HoneyKung/metorobot/migrations/README

Single-database configuration for Flask.
