HoneyKung/metorobot/HANDOFF-ทำ-METO-ต่อ-2026-11-01.md

# Handoff — แชตช่วยทำ METO ต่อ (ขึ้นโมเดล + แก้โค้ด)

เขียนเมื่อ 1 พ.ย. 2569 จากแชตที่ดูแล METO/RoboBlock (แชตเดิมทำเอกสาร IRB และตรวจข้อความพอร์ตให้)

## คำสั่งเจ้าของ (คำต่อคำ)
> อยากให้เปิดแชต ที่จะช่วยฉันทำ meto ต่อหน่อย ทั้งช่วยขึ้นโฒเดล หรือช่วยแก้โค้ด เขียน handoff ใฟ้ที อย่าลืมให้อ่านเอกสรหลักการทำงาน

## ขั้นแรก: อ่านก่อนตอบเจ้าของครั้งแรก
1. **เอกสารหลักการทำงาน:** `L:\ModSTD\หลักการทำงานทีม-และการเรียกใช้Codex.md` (486 บรรทัด, md5 `be96b19f…` วันที่ 1 พ.ย.)
   - อ่านอย่างน้อยหมวด **ลำดับขั้นทำงาน (โดยเฉพาะขั้น 0)**, **คุยกับเจ้าของ**, **งานที่เสียเงิน**, **งานออกแบบ**
   - สรุปสั้น:
     - ขั้น 0: แตกข้อความเจ้าของเป็นข้อ ๆ หาหลักฐานเองก่อนถาม งานออกแบบ/ตีความได้หลายทางให้สรุปความเข้าใจกลับก่อนลงมือ
     - ใบสั่งงานคัดคำเจ้าของคำต่อคำไว้ต้นใบ
     - งานเสียเงินต้องรอเจ้าของพิมพ์ "ยิง"
     - งานออกแบบเจ้าของตัดสิน: เสนอ 2–3 ทางพร้อมทางที่แนะนำ
     - ตอบคำถามเจ้าของก่อนเสมอ แล้วค่อยให้เหตุผลหรือรายละเอียด
   - ไฟล์นั้นเขียนมาจากโปรเจกต์ ModSTD ส่วนที่พูดถึงเกม/ZIP/NPC ให้อ่านเทียบเคียง ("ลงงาน" ที่นี่ = แฟลชบอร์ดหรือพิมพ์ 3D)
   - เรื่องใครเป็นผู้เขียนโค้ด (Claude เขียนเอง หรือส่ง Codex/Gemini) **ถามเจ้าของก่อน** ว่าโปรเจกต์ METO ใช้แบบไหน อย่าเดา
2. ความจำของโปรเจกต์ (โหลดอัตโนมัติถ้าเปิดแชตในโฟลเดอร์นี้): `C:\Users\Acer\.claude\projects\G--My-Drive-METTO-Code-RoboBlock\memory\MEMORY.md` โดยเฉพาะ
   - `meto-hardware-two-units.md` — **หุ่นมี 2 ตัว ห้ามเล่ารวมกัน**
   - `meto-esp32-pin-budget.md` — ผัง GPIO ที่ตกลงแล้ว และวิธีคอมไพล์ด้วย arduino-cli
3. ฝั่งเว็บ: `claude-RoboWeb.md` ในโฟลเดอร์นี้ ต้องอ่านก่อนแตะโค้ดเว็บ และ `THEME.md`

## วิธีคุยกับเจ้าของ
- เรียกเจ้าของว่า **"คุณ"** (ห้ามเรียก "ฟาม") Claude ใช้ **ผม/ครับ**
- ตอบภาษาไทยเท่านั้น
- ห้ามส่งไฟล์เข้าแชตถ้าไม่ได้ขอ ให้บอกที่อยู่หรือลิงก์แทน
- ตอบทุกคำถามที่เจ้าของถาม และตอบคำถามก่อน อย่าเสนอเปลี่ยนสิ่งที่เจ้าของไม่ได้ขอ
- **ไฟล์ล่าสุดอยู่ใน Google Drive (`G:\My Drive\METTO\`) เท่านั้น** ไฟล์สำเนาในเครื่องที่อื่นอาจเก่า ห้ามใช้เป็นต้นฉบับ
- ห้ามแตะเอกสาร IRB (แชตอื่นดูแลอยู่ และกำลังรออาจารย์)

## หุ่น 2 ตัว (สำคัญที่สุด)
| ตัว | สถานะ |
|---|---|
| โปรโตไทป์ 1 | ทำงานครบ จ่ายไฟผ่าน USB · กล้องจับหน้า (ESP-DL) + หันหัวตาม · จอแสดงอารมณ์ · แขน 2 มือ 2 ล้อ 2 · เซนเซอร์กันตก · สั่งจากเว็บได้ มีคลิปสาธิต |
| ตัวสำเร็จ | กำลังประกอบ · เพิ่มแบตในตัว (18650×2, BMS 2S, ชาร์จ CM620 USB-C), PCA9685, คอก้มเงย, วัดระยะของที่ยก · โครงใน PETG พิมพ์แล้ว · **โครงนอกยังไม่เริ่ม** · 31 ต.ค. เจ้าของบอกว่าต่อฟิวส์และกราวด์ร่วม (ราง WAGO) แล้ว · **ยังไม่รู้ว่าวิ่งด้วยแบตได้ครบระบบหรือยัง** ถามเจ้าของ ห้ามเขียนว่า "ยังเสีย" |

## ที่อยู่ไฟล์ (ใต้ `G:\My Drive\METTO\Code\RoboBlock\`)
**เฟิร์มแวร์**
- `Robo/Robo.ino` — หุ่น: หน้า 9 อารมณ์ (H S A O Z C V B N บรรทัด ~300), รับค่าจากกล้องทาง Serial2 (ตำแหน่ง L/C/R + อารมณ์ H/S/N บรรทัด ~1107)
- `RoboPCA9685/RoboPCA9685.ino` — รุ่นใช้ PCA9685 (ตัวสำเร็จ)
- `FullCam/FullCam.ino` — กล้อง XIAO ESP32S3: แยก ยิ้ม/เศร้า/ปกติ จากจุดบนใบหน้า แล้วส่งตำแหน่งหน้า L/C/R
- โฟลเดอร์ทดสอบ: `CamTest`, `FaceTest307`, `MotorTest_TB6612`, `EncoderMotorTest_TT`, `eye`
- **ยังไม่มีโค้ด VL53L0X**

**เอกสารฮาร์ดแวร์** — `Robo/Part Robot/`
- `ผังจัดชั้นตัวเต็ม_RoboMDT.md` — ผัง 5 ชั้น (ชั้น 4 มี PCA9685 + VL53L0X ระดับแขน)
- `ปัญหาฮาร์ดแวร์_RoboMDT.md` — ข้อ 6.4: ย้าย VL53L0X จากใต้ท้องขึ้นชั้น 4
- `คู่มือต่อสาย_ล้อ_จอ_กล้อง_WAGO221_XT30_RoboMDT.md` (7 ก.ย.) — BMS→ฟิวส์→XT30→สวิตช์→WAGO
- `ตารางการเชื่อมต่อและบัดกรี_RoboMDT.md` ข้อ 0 หัวข้อ 16 = ผังขาที่ตกลงแล้ว ("สเปกวันศุกร์")
- `รายชื่ออุปกรณ์หุ่นยนต์_RoboMDT.md`, `สถานะการสั่งซื้ออุปกรณ์_RoboMDT.md`, `แผนปรับโครงจาก_STL_จริง_RoboMDT.md`

**โมเดล 3D**
- `stl3dprint/` — STL ชุดที่พิมพ์ (ชั้น 1–5, ชั้นคอ, ก้านยึดเซอร์โว, ล้อ, สายพาน, แขนโปรโตไทป์) + `ภาพสำหรับสไลด์/`
- `stl redesigned/` — `RoboMDT_layer_lock_v1.zip`, `v1_long_lock`, `analysis`
- เจ้าของขึ้นโมเดลใน **Tinkercad** (กำลังเรียน SolidWorks) · หลักการแบบ: เล็กที่สุด ไม่ใช้ heat-set insert, ตัว 5 ชั้นซ้อนแบบปิ่นโต, ตัวทรงคางหมูให้แขนหุบหนีบได้, แขนเว้ารีพร้อมปุ่มทรงเพชรกันลื่น
- แผนล้อ: ตีนตะขาบเลี้ยวไม่ดี → รุ่นต่อไปเป็น **ล้อ 2 ข้าง + ลูกล้ออิสระ (ยังไม่ขึ้น CAD)**

**เว็บ METO Robot** — `server.py`, `dashboard.py`, `skills.py`, `models.py`, `static/` (เปิดเดโมด้วย `devserver.py` แล้วเข้า `static/index.html?demo=1`) · เว็บบน Render สั่งหุ่นไม่ได้ ต้องรันเซิร์ฟเวอร์ในเครื่องบนฮอตสปอตเดียวกับหุ่น

## งานค้างที่รู้ตอนนี้ (ยังไม่มีใครสั่ง ให้ถามเจ้าของว่าจะเริ่มอะไร)
- ทดสอบตัวสำเร็จด้วยแบตครบระบบ
- โค้ดอ่าน VL53L0X (เช็กว่าจับของได้จริง) ที่ชั้น 4
- ขึ้น CAD ล้อ 2 ข้าง + ลูกล้อ
- ออกแบบโครงนอก (รอระบบไฟนิ่ง)
- วัดแบตบนจอ: ADC ของ ESP32 ไม่เหลือขา ถ้าจะทำต้องใช้ ADS1115 บน I2C

## สิ่งที่ห้ามทำ
- ห้ามแก้ไฟล์ในโฟลเดอร์สมัครงาน/พอร์ต (`C:\Users\Acer\Downloads\ประวัติผลงาน-สมัครงาน-ฝึกงานญี่ปุ่น-2026-10-19\`) — มีแชตอื่นดูแล
- ห้ามเปลี่ยนผังขาย้อนกลับไปแบบเก่า (เจ้าของตัดสินแล้วว่าโค้ดต้องตามเอกสาร)
- ก่อนแก้เฟิร์มแวร์หรือไฟล์สำคัญ ให้สำรองไฟล์เดิมไว้ข้าง ๆ ก่อน (เช่น `.bak-YYYYMMDD`)
