HoneyKung/metorobot/ข้อมูลส่งแชทเอกสาร_บท4_2026-11-06.md

# ข้อมูลสำหรับแชทเอกสาร — เติมบทที่ 4 (ร่างดีไซน์ 8-8)

> **ถึงแชทเอกสาร:** ไฟล์บทที่ 4 คือ `G:\My Drive\METTO\Research Documents\รายงานวิจัย\ร่างบทที่ 4-5 ดีไซน์ 8-8 (รอเติมผลจริง).docx`
> ข้อมูลข้างล่างมาจากไฟล์งานหุ่นจริง ณ 6 พ.ย. 2569 · ใช้ได้เฉพาะหัวข้อ 4.2 (ผลการพัฒนาหุ่นยนต์ต้นแบบ)
> หัวข้อ 4.3–4.10 ยังไม่มีข้อมูล เพราะยังไม่ได้เก็บข้อมูลกับผู้เข้าร่วม **ห้ามเติมตัวเลขเอง**
> ช่องที่เขียน **[รอของจริง]** ให้คงวงเล็บไว้ · **ห้ามแตะเอกสาร IRB**

---

## 1. สิ่งที่ในร่างเดิมไม่ตรงกับของจริงแล้ว ต้องแก้

| ร่างเดิมเขียน | ของจริงตอนนี้ |
|---|---|
| โครงสร้างแบบโมดูลาร์ **5 ชั้น** · ชั้น 4 = คอและแขน · ชั้น 5 = หัว | **ตัว 4 ชั้น + แผ่นคอ + หัว** · แขนยึดที่ชั้น 4 · คอเป็นแผ่นแยกที่รับหัว · หัวเป็นชุดแยก (หันซ้ายขวา + พยักหน้า) |
| "แต่ละชั้นยึดกันด้วย [วิธียึดชั้นแบบสุดท้าย]" | ชั้นยึดกันด้วย **คลิปล็อกแบบหัวเข็มขัดกระเป๋า** เป็นชิ้นแยก ถอดเปลี่ยนได้ ร่วมกับเสาแท่งเกลียวด้านนอกตัว |
| ล้อ "พร้อม Encoder" | ถูกต้อง · เพิ่ม: **ล้อออกแบบใหม่ ยึดเพลาด้วยสกรูกันหลุดตอนเลี้ยว ยาง TPU** |
| ไม่มีระบบกันชนกลไก | **เพิ่ม:** ระบบล็อกท่าทาง (interlock) สร้างจากผลจำลอง 3 มิติ ฝังในโปรแกรมหุ่น ไม่ให้แขนชนหัว |
| บล็อก 9 หมวด | ยังเป็น 9 หมวดเท่าเดิม (Motion, Arm, Hand, Head, Face, Gripper, Control, Operator, Variables) · **เพิ่มบล็อกใหม่ 20 ตัว** (บล็อกคำสั่งใหม่ 15 + บล็อกพื้นฐานที่ขาด 5) รวมบล็อกเซนเซอร์ |
| หุ่นยนต์จำลองบนหน้าจอ | มี 2 แบบ: ซิม 2 มิติในหน้าเว็บบล็อก และ **Digital Twin 3 มิติ** สร้างจากไฟล์ชิ้นส่วนจริง |

ขนาดกรอบนอก ความสูง น้ำหนัก → **[รอของจริง]** (ชั่ง/วัดหลังประกอบเสร็จ)

---

## 2. ข้อมูลเติมหัวข้อ 4.2.1 โครงสร้างและฮาร์ดแวร์

**กระบวนการออกแบบ (เขียนเป็นย่อหน้าได้)**
- ออกแบบชิ้นส่วนทั้งหมดด้วย OpenSCAD แบบพารามิเตอร์ แล้วพิมพ์ด้วยเครื่องพิมพ์ 3 มิติ วัสดุ PETG (ยางล้อ TPU)
- ก่อนพิมพ์ ตรวจแบบด้วยการจำลอง 3 มิติที่ใช้เมชของชิ้นจริง ตรวจ 3 เรื่อง
  1. ประกอบได้: ชิ้นใส่เข้าตามลำดับประกอบได้จริง
  2. ขยับได้: ทุกข้อต่อขยับครบช่วงโดยไม่ชนชิ้นอื่น
  3. แขนกับหัว: ตรวจไขว้ทุกคู่ท่า (หัน 91 × พยัก 11 × ยก 47 × หนีบ 30 ท่า ≈ 1.41 ล้านท่าต่อข้าง)
- จุดที่ชนได้ ถูกแปลงเป็น **ตาราง interlock** ฝังในเฟิร์มแวร์ หุ่นจะไม่ขยับเข้าท่าที่ชน
- การจำลองพบจุดที่ประกอบไม่ได้ในแบบก่อนพิมพ์ (เช่น ช่องเซอร์โว MG996R, การสอดแขนเข้าตัว U, สกรูชนหัวพินจอ) และแก้จนผ่านก่อนพิมพ์จริง ลดการพิมพ์ทิ้ง

**แผนผังอุปกรณ์ (ใช้แทนตารางเดิม — ตำแหน่งชั้นของบอร์ดไฟให้เช็กกับของจริงอีกรอบ)**
| ส่วน | อุปกรณ์หลัก | หน้าที่ |
|---|---|---|
| ชั้น 1 ฐานขับเคลื่อน | TT Motor + Encoder × 2 พร้อมล้อยาง, ลูกล้อ × 1, รางถ่าน 18650 × 2, เซนเซอร์กันตก TCRT × 2 (ซ้าย/ขวา), ฝาแบตแบบคลิก | เคลื่อนที่ จ่ายพลังงาน กันตก |
| ชั้น 2 ไฟและขับมอเตอร์ | BMS 2S, ฟิวส์, ขั้ว XT30, สวิตช์, WAGO, TB6612FNG, CM620 (ชาร์จ), LM2596, UBEC | ป้องกันแบต ตัดไฟ ขับมอเตอร์ ชาร์จ แปลงแรงดัน |
| ชั้น 3 สมอง | ESP32 DevKit 38 Pin, PCA9685 | ประมวลผล Wi-Fi สั่งเซอร์โวผ่าน I2C |
| ชั้น 4 ไหล่ | MG996R × 2 (ยกแขน) | ยกแขน |
| แขน | MG90S × 2 (หนีบ) + VL53L0X 1 ตัว (ตรวจว่าหยิบของได้ ตำแหน่งดูหมายเหตุ) | หนีบ |
| คอ + หัว | SG90 × 2 (หันซ้ายขวา / พยักหน้า), จอ TFT 2.8" (MSP2806), XIAO ESP32S3 Sense + OV2640 | แสดงอารมณ์ ตรวจจับใบหน้า |

> ตำแหน่ง VL53L0X: [รอของจริง — ยืนยันกับเจ้าของ] · หมายเหตุ MPR121 ยังไม่มีในโค้ด (ตามร่างเดิม)

**ระบบไฟ:** 18650 × 2 อนุกรม (2S) → BMS 2S → ฟิวส์ → สวิตช์ → แยก 3 ราง: LM2596 5V (วงจร), UBEC (เซอร์โว), TB6612 VM (มอเตอร์) · ตรงกับร่างเดิม ยกเว้นพิกัด UBEC ให้ยืนยันกับของจริง **[รอของจริง]**

---

## 3. ข้อมูลเติมหัวข้อ 4.2.2 เว็บแอปพลิเคชัน

- บล็อกใหม่ 20 ตัว เช่น เดิน/เลี้ยวตามเวลา (ms), หยุด, ยกแขนตามองศา, หันหัว/พยักหน้าตามองศา, หนีบแบบตรวจว่าจับได้, บล็อกเซนเซอร์ (เจอขอบ, ระยะ VL53, ถือของอยู่ไหม)
- บล็อกเซนเซอร์ใช้ในเงื่อนไข if ได้จริง: เบราว์เซอร์ส่งคำสั่งที่ค้างให้หุ่นทำเสร็จก่อน แล้วอ่านค่าเซนเซอร์จาก `/state` มาตัดสิน
- ปุ่มหยุดหยุดหุ่นจริงได้ทันที แม้หุ่นกำลังทำคำสั่งชุดยาว
- **Digital Twin 3 มิติ:** หุ่น 42 ชิ้นจากไฟล์ออกแบบจริง ขยับตามข้อต่อจริงและใช้ตารางกันชนเดียวกับเฟิร์มแวร์ ควบคุมด้วยคีย์บอร์ด หรือให้ขยับตามหุ่นจริงได้ (อ่าน `/state`)
- ผลทดสอบ: ผ่านในโหมดเดโมและหุ่นจำลอง · **ทดสอบกับหุ่นจริง [รอของจริง]**

---

## 4. ข้อมูลเติมหัวข้อ 4.2.3 ระบบแสดงอารมณ์

- อารมณ์ 9 แบบตรงกับร่างเดิม · ดวงตาวาดบนจอพื้นขาว ตาดำ (ตกใจมีวงแดง เศร้ามีน้ำตา รักเป็นหัวใจเต้น เขินมีแก้มชมพู)
- กล้องส่งสัญญาณมาที่ ESP32 ทาง UART · โปรโตคอลมีตำแหน่งหน้า (ซ้าย/กลาง/ขวา) และรหัสอารมณ์ · หัวหันตามหน้าผ่านระบบขยับนุ่ม · กล้องหลุดเกิน 5 วินาทีหุ่นรู้และรายงาน
- **ความแม่นการจำแนกอารมณ์ [รอของจริง]** (ร่างเดิมแนะนำทดสอบ 20 ครั้งต่ออารมณ์)
- ⚠️ **โหมดไม่แสดงอารมณ์ (กลุ่มควบคุม) ยังไม่มีในโค้ด** ทั้งเฟิร์มแวร์และเว็บ — ต้องทำก่อนเริ่มเก็บข้อมูล ช่อง [วิธีปิด] ในร่างยังเติมไม่ได้

---

## 5. ตารางผลทดสอบระบบ (ตารางที่ [ ] 13 รายการ) — สถานะตอนนี้

| ที่ | รายการ | สถานะความพร้อม | ผล |
|---|---|---|---|
| 1 | Wi-Fi + เปิดเว็บ | มีระบบแล้ว | [รอของจริง] |
| 2 | Motion | มีบล็อก + เฟิร์มแวร์ | [รอของจริง] |
| 3 | Arm | มีบล็อก + เฟิร์มแวร์ | [รอของจริง] |
| 4 | Hand / Gripper | มีบล็อก + เฟิร์มแวร์ (แขนกำลังปรับรอบ 2) | [รอของจริง] |
| 5 | Head | มีบล็อก + เฟิร์มแวร์ หัน + พยัก | [รอของจริง] |
| 6 | Face 9 อารมณ์ | มีบล็อก + ตาครบ 9 | [รอของจริง] |
| 7 | Control | มีบล็อก | [รอของจริง] |
| 8 | Operator / Variables | มีบล็อก แก้บั๊กตัวแปรแล้ว | [รอของจริง] |
| 9 | กล้อง → อารมณ์ | มีโปรโตคอล | [รอของจริง] |
| 10 | สลับโหมดอารมณ์ | **ยังไม่มี** | — |
| 11 | กันตก / วัดระยะ | มีในเฟิร์มแวร์ | [รอของจริง] |
| 12 | AI ไม่เฉลย | มีระบบเดิม | [รอของจริง] |
| 13 | แบตใช้งานต่อเนื่อง | ยังไม่ได้วัด | [รอของจริง] |

> ตอนนี้ยังเขียนว่า "ผ่าน [ ] จาก 13 รายการ" ไม่ได้ เพราะยังไม่ได้ทดสอบกับหุ่นตัวสำเร็จ

---

## 6. ภาพที่ใช้ได้ในบท 4
- ภาพทวิน 3D: `G:\My Drive\METTO\Code\RoboBlock\Robo\Part Robot\งานโค้ด_2026-11\ภาพ_ทวิน3D\` (01 ท่าปกติ, 04 มองข้างใน, 05 ซ่อนเปลือกมุมบน)
- ภาพบล็อกใหม่: `...\งานโค้ด_2026-11\ภาพ_เว็บบล็อก\`
- ภาพหุ่นจริงประกอบเสร็จ: [รอของจริง]
