HoneyKung/metorobot/สถานะงาน_METO_ตัวสำเร็จ.md

# สถานะงาน METO ตัวสำเร็จ (แชตทำ METO ต่อ)

ต่อท้ายเท่านั้น 1 บรรทัดต่อเหตุการณ์ · โจทย์รวม: `Robo/Part Robot/โจทย์ออกแบบโครงใน_v2_2026-11-02.md` · ใบสั่งงาน: `ใบสั่งงาน/`

ตอนนี้พิมพ์อะไรอยู่: ชิ้นทดสอบชุดเบา `stl redesigned/กรอบทดสอบ_ชุดเบา_2026-11-02/` (ข้าม vl53l0x_holder) — ยังไม่มีผลลองใส่

- 2026-11-01 — อ่าน handoff + หลักการ (บางหมวด) · เจ้าของตัดสิน: Luna งานง่าย Gemini งานยาก; ชั้นตาม STL เดิม; ล้อ 2 ข้าง + ลูกล้ออิสระ; ล้อ Ø41 พิมพ์เอง
- 2026-11-01 — ใบ 01 Luna ค้นขนาดอุปกรณ์/ลูกล้อ → `Robo/Part Robot/ผลค้นขนาดอุปกรณ์และลูกล้อ_Luna_2026-11-01.md` (หัวงานตรวจ: ล้อ Olimex Ø43 ไม่ยืนยันเพลา TT)
- 2026-11-02 — ใบ 02/04/05 ชิ้นทดสอบชุด v1–v3 ส่งเจ้าของ → **เจ้าของทักทั้งชุด: มีชิ้นลอย ป้ายตัวเลข ผนังหนา เปลืองเวลา** → เลิกใช้ v1–v3
- 2026-11-02 — ใบ 06/07 Gemini ทำรางกดสาย + ชุดเบา, หัวงานตรวจด้วย `tools/check_printable.py` → ส่ง `กรอบทดสอบ_ชุดเบา_2026-11-02` (ยังไม่ได้พิมพ์)
- 2026-11-02 — ทำ `tools/meto-api-writer` ตามคำเจ้าของ ("อันนี้คุณเขียนเองก่อนได้เลย") · hook self-test PASS · ยังไม่เคยเรียก API (รอบ "ยิง" ครั้งแรกไม่เรียกจริงเพราะ key ไม่อยู่ใน env ของ process — ไม่เสียเครดิต)
- 2026-11-02 — เจ้าของตัดสินชั้น 1: ล้อขับหลัง; ลูกล้อ 2 ลูกหน้าซ้าย-ขวา; VL53L0X ชั้น 1 ตั้งแนบผนังหน้ามองผ่านรูกลาง; ชั้น 1 มี รางถ่าน BMS ฟิวส์+สายหนา XT30 VL53 TT×2 IR×2 (ห้ามย้ายชั้น); LM2596 ไม่อยู่ชั้น 1; สวิตช์ WAGO TB6612 CM620 ชั้น 2
- 2026-11-02 — หัวงานผิดหลักการ: บันทึกคำแนะนำเป็นคำตัดสิน (ล้อขับหน้า), เติมข้อห้ามจากคำถามเจ้าของ (BMS ทับถ่าน), ย้าย BMS ไปมา → แก้ไฟล์โจทย์แล้ว (สำรอง `.bak-20261102`) และทำเครื่องหมายใบ Opus-01 ว่าห้ามใช้
- 2026-11-02 — อ่านหลักการทำงานครบ 486 บรรทัด (md5 be96b19f…) ตามคำเจ้าของผ่านแชตไฟล์และอัปเดตอื่น ๆ
