HoneyKung/metorobot/ใบสั่งงาน/brief_opus02_exterior_arms.md

# ใบ Opus-02 — ภายนอก + คำนวณแขน + ความสูงแต่ละชั้น (ยังไม่ทำภายใน)

คำเจ้าของ (คำต่อคำ, #151 ใน `ref/บันทึกการคุย_METO.md`): "ก่อนออกแบบภายใน ควรออกแบบภายนอกก่อน เพราะคางหมูทำเผื่อแน ให้ทำคิดคำนวนแขนให้เรียบร้อยก่อนเริ่มดีเลภายใน ก่อนทำดีเทลภายใน กำหนดความสูงแต่ละชั้นก่อน"

**อ่าน `ref/บันทึกการคุย_METO.md` ทั้งไฟล์ก่อน** โดยเฉพาะตาราง "คำตัดสินที่ล็อกแล้ว" และข้อ 17, 26, 30, 33, 35, 38, 52, 106, 124, 130–151 · ห้ามขัดคำตัดสินที่ล็อก · ข้อที่ต้องเดาให้เขียนเป็น "สมมติฐาน" ในรายงาน

## อ้างอิงใน `ref/`
- `layer4.stl` — ชั้นเซอร์โวเดิม: MG996R วางนอน แกนออกข้าง อยู่หน้าสุด ทะลุผนัง (ช่องซ้ายภายใน X −44..−4, Y 14.6..55, พื้น Z −78; รูแกนตัว U ที่ผนังข้าง ศูนย์ Y≈44.3 Z≈−68) · ช่องนี้ใส่ได้พอดี ห้ามเปลี่ยน
- `layer2.stl`, `layer3.stl`, `neck.stl` — รูปทรง/ความสูงเดิม (ชั้น 2 ตัวจบที่ผนังหลัง ~113 ส่วนเลยไปคือฝา/กระเป๋า #146)
- `arm_prototype.stl` — แขนจากโปรโตไทป์ (ยังไม่ใช่โครงจริง) ใช้ดูแนวคิดรูปทรง
- `tt_motor.stl` — มอเตอร์ TT ของจริง (ตัว 22.5 × ~75 × 25, ขาตัว L ข้างหนึ่ง, เพลาฝั่งตรงข้าม ศูนย์สูง ~12)
- `tinkercad_1..6.png` — ภาพแบบ Tinkercad ของเจ้าของ (หัว 107 ตัว 101, แขนยาวยื่นหยิบของหน้า)

## ข้อกำหนด (จากคำตัดสิน)
- ชั้น 1 = ฐานสี่เหลี่ยม ยาวกว่าตัวได้ (ล้อคือฐาน) · ชั้น 2–4 = ตัวทรงคางหมูหน้าแคบ **ห้ามยืด** · หน้าทุกชั้นเสมอกัน · หัวกว้างเท่าตัว
- แขนชิ้นเดียว ยาว หยิบของตรงหน้าได้ · หนีบเข้าหาตัวมุมมากที่สุดโดย **ไม่ชนตัว ไม่ชนหัว (รวมตอนยกแขนขึ้น) คิดรวมความหนาเปลือกนอก** · ไม่ต้องหนีบจนแขนประกบกัน · ต้องสวย
- เสาหลัง 2 ต้น อยู่หลังผนังหลังในความกว้างตัว (ชั้น 2 ขึ้นไป) · หน้าใช้คลิปซ่อน · เปลือกผ่าหน้า/หลัง ปิด 5 ด้าน
- คอหัน 180° · ก้มเงยคำนวณเผื่อ · ไม่ชนตัว/แขน
- ลิมิตเฟิร์มแวร์ปัจจุบัน: แขน CH0 67–121°, CH2 60–118° (แก้ได้)

## ต้องทำ (ภายนอกเท่านั้น)
1. **ตารางความสูงแต่ละชั้น** (ชั้น 1–4, คอ, หัว) พร้อมเหตุผล (ของสูงสุดในชั้น/ข้อจำกัด) — ใช้ข้อมูลที่มี ถ้าขาดให้ระบุ
2. **ทรงภายนอก**: ความกว้างหน้า/หลังของคางหมู มุมเฉียง ความยาวตัว ความหนาเปลือก (เสนอ) · มุมมองบน/ข้าง/หน้า เป็นตัวเลข
3. **คำนวณแขน**: ความยาวแขน รูปทรง (โค้ง/หักมุม) ตำแหน่งแกน MG996R · มุมหนีบเข้าสูงสุดที่ไม่ชน (แขนลง, แขนยกสุด) · ระยะหยิบของตรงหน้า · ช่วงมุมที่ปลอดภัยสำหรับใส่ในเฟิร์มแวร์
4. **เขตห้ามชนต่อชั้น** (ตัวเลข: ผนังข้างห้ามยื่นเกินเส้นไหนในช่วงไหน)
5. **โมเดลประกอบภายนอกแบบกล่อง** `out/exterior_mockup.scad` (กล่องง่ายแทนแต่ละชั้น หัว แขนที่หลายมุม) export `out/exterior_mockup.stl` และ `out/arms_sweep.stl` ให้ดูชนด้วยตา · ไม่ต้องมีรายละเอียดภายใน · ไม่มีตัวอักษร
6. **`out/รายงาน.md`** ภาษาไทย สั้น อ่านง่าย: ตารางความสูง, ขนาดภายนอก, ผลคำนวณแขน, เขตห้ามชน, สมมติฐาน, สิ่งที่ต้องให้เจ้าของตัดสิน (เป็นข้อเลือกพร้อมคำแนะนำ)

ห้ามเขียนนอก `out/` · ห้ามแต่งตัวเลขไม่มีที่มา

## เพิ่มจากเจ้าของ (#153, ก่อนยิง)
> "รูปทรง เฉพาะรูปช่วงต้นแขนที่โดนตัว ช่างครึ่งล่างลงไปที่ฉันออกแบบเว้าไว้แล้วตรงนั้นไม่ได้โดนตัว อย่าลืม รวมชั้นหัว ห้ามชน คือต้องได้สเปกความกว้างหัว อาจจะเท่าตัวก็จะได้ง่าย"
- ออกแบบ/ปรับรูปทรงแขน **เฉพาะช่วงต้นแขนที่ชนตัว** · ครึ่งล่างของแขน (ส่วนเว้าที่เจ้าของออกแบบไว้ใน `arm_prototype.stl`) **ไม่ต้องแก้** ไม่ชนตัวอยู่แล้ว
- **รวมชั้นหัวในการคำนวณห้ามชน** และให้ผลเป็น **สเปกความกว้างหัว** (แนวทาง: กว้างเท่าตัว)
