HoneyKung/metorobot/ใบสั่งงาน/ใบ01_ค้นขนาดอุปกรณ์และลูกล้อ_Luna.md

# ใบ 01 — ค้นขนาดจริงของอุปกรณ์ + เลือกลูกล้ออิสระให้ใต้ท้องต่ำสุด (ผู้เขียน Luna / หัวงาน Claude ตรวจ / 1 พ.ย. 2569)

## คำสั่งเจ้าของ (คำต่อคำ)
> ตามแบบ STL เดิม
> ไปตามหาไฟล์เอกสารของฮาร์ดแวแล้วเอาตัวเลขจริง เขียนโ๕้ด stl ฉํนจะปริ้นมาทดสอบว่าใส่ได้จริง
> เปลี่ยนเป็นล้อ 2 ข้างกับลูกล้ออิสระตามแผน
> อยากรุ้ด้วยว่าต้องใช้ลูกแหล็กขนาดเท่าไร ว่าจะให้ ใต้ท้องต่ำที่สุดเท่าที่ทำได้เพราะ การออกแบบเราเน้นหุ่นยนขนาดเล็ก
> ส่ง luna ไปค้นคว้าตามเนตเลย

ใบนี้คือส่วน "ค้นคว้าตามเน็ต" เท่านั้น ยังไม่ต้องเขียนโค้ด STL (จะเป็นใบถัดไปหลังได้ตัวเลข)

---

คุณคือ Luna ลงมือทำงานโดยตรง ห้ามเรียก codex exec ซ้อน
ไฟล์ที่เขียนได้: `C:\Users\Acer\AppData\Local\Temp\claude\G--My-Drive-METTO-Code-RoboBlock\904dfa07-0ccb-402b-ab7a-728620bc60de\scratchpad\ผลค้นขนาดอุปกรณ์และลูกล้อ_Luna_2026-11-01.md` (ไฟล์ใหม่ไฟล์เดียว · sandbox เขียนลง G:\My Drive ไม่ได้ หัวงานจะคัดลอกเข้า `Robo\Part Robot\` เอง · ห้ามใช้ Google Drive connector)
ห้ามแตะ: ไฟล์อื่นทุกไฟล์ (อ่านได้ แก้ไม่ได้) · โฟลเดอร์ IRB · ไฟล์ STL/โค้ด
อ่านก่อน (บังคับ):
- `G:\My Drive\METTO\Code\RoboBlock\Robo\Part Robot\ขนาดอุปกรณ์รายชั้น_สำหรับกรอบทดสอบ_2026-11-01.md` — ตารางที่หัวงานรวบรวมไว้ บอกว่าตัวไหนยังไม่มีตัวเลข
- `G:\My Drive\METTO\Code\RoboBlock\Robo\Part Robot\รายชื่ออุปกรณ์หุ่นยนต์_RoboMDT.md` และ `สเปกอุปกรณ์จริงและงบกระแสสำหรับรายงาน_RoboMDT.md` — ชื่อรุ่นที่ซื้อจริงและลิงก์ร้าน
- `G:\My Drive\METTO\Code\RoboBlock\Robo\Part Robot\คู่มือต่อสาย_ล้อ_จอ_กล้อง_WAGO221_XT30_RoboMDT.md` — ภาคไฟปัจจุบัน (ฟิวส์ XT30 สวิตช์ WAGO UBEC)
กฎ: เขียนไทย UTF-8 · ทุกตัวเลขต้องมี URL ที่มา · แยกให้ชัดว่าเป็น datasheet ผู้ผลิต / หน้าร้าน / ค่าเฉลี่ยหลายร้าน · ถ้าหาไม่เจอให้เขียน "ไม่พบ" ห้ามเดาเลข · grep ไฟล์ผลต้องไม่พบเครื่องหมายคำถามสี่ตัวติดกัน

## เหตุและหลักฐาน
- ตัวเลขในเอกสารเดิมบางตัวเป็น "ประมาณ" และ 6 ชิ้นไม่มีเลขเลย — ดูหัวข้อ "ของที่ต้องวัดจริง" ในไฟล์ตารางของหัวงาน
- หุ่นตัวสำเร็จจะเปลี่ยนจากตีนตะขาบเป็น **ล้อ 2 ข้าง + ลูกล้ออิสระ (ball caster)** · มอเตอร์ยังเป็น TT Motor Encoder 1:90 (ตัวมอเตอร์ 70 × 22 × 18 mm ตามเอกสาร)
- ปรัชญาแบบ: หุ่นตัวเล็กที่สุด · ไม่ใช้ heat-set insert · ตัว 5 ชั้นซ้อนแบบปิ่นโต (ฐานเดิมกว้าง 96 mm)
- แบตอยู่ชั้น 1 (รางถ่าน BH-18650x2-M 76 × 41 × 20) และมีเซนเซอร์ IR กันตก 2 ตัวหันลงพื้นด้านหน้า

## ต้องทำ
1. **ขนาดอุปกรณ์** — หา L × W × H (mm), ตำแหน่ง/ขนาดรูยึด (ถ้ามี), ตำแหน่งพอร์ตหรือขั้วสาย ของ:
   - XT30 (AMASS XT30U หรือ XT30PW) ตัวผู้+ตัวเมียตอนเสียบกัน
   - ฐานฟิวส์ที่นิยมใช้กับสาย 18AWG: แบบ inline mini blade (ATM) และแบบ 5×20 mm (เลือกมาอย่างละ 1)
   - UBEC 5V 5A รับ 2S ทั่วไป (เช่น Hobbywing UBEC 5A หรือรุ่นที่ขายในไทย)
   - บอร์ดขยาย ESP32 38 ขา แบบสำเร็จรูป (ESP32 expansion board / terminal adapter 38-pin) รวมความสูงตอนเสียบ ESP32
   - WAGO 221-415, 221-413 (จาก datasheet WAGO)
   - CM620 ชาร์จ 2S USB-C (ถ้าเจอรุ่นนี้), BMS 2S 16A, LM2596 module, TB6612FNG module, ADS1115 module, VL53L0X module (GY-530 หรือแบบที่พบบ่อย), HW-201 IR, ESP32 DevKit V1 38 ขา, PCA9685 module, จอ TFT 2.8" ST7789 SPI (ขนาด PCB และขนาดพื้นที่แสดงผล), XIAO ESP32S3 Sense (รวมบอร์ดกล้อง)
   - TT Motor แบบมี encoder: ขนาดตัว + **ระยะจากแกนเพลาถึงผิวล่างและผิวบนของตัวมอเตอร์** + ความยาวเพลา (ต้องใช้คำนวณใต้ท้อง)
2. **ล้อ** — ล้อที่ใส่เพลา TT ได้ตรง ๆ มีขนาดเส้นผ่านศูนย์กลางเท่าไรบ้าง (เช่น 43, 48, 65 mm) พร้อมความกว้างล้อ
3. **ลูกล้ออิสระ** — รวบรวมขนาด ball caster ที่หาซื้อได้ (เช่น Pololu 3/8", 1/2", 3/4", 1" และแบบโลหะทั่วไปในไทย) ระบุ: ขนาดลูกบอล, **ความสูงรวมจากพื้นถึงหน้ายึด**, ขนาดฐาน/รูยึด, ชนิดวัสดุ, และมีแบบพิมพ์ 3D เองใส่ลูกปืน/ลูกแก้วได้ไหม
4. **คำนวณใต้ท้อง** — สำหรับแต่ละขนาดล้อในข้อ 2:
   - ระยะใต้ท้อง (ground clearance) ถ้าติดมอเตอร์ TT ใต้แผ่นฐาน และถ้าติดมอเตอร์ข้างแผ่นฐาน (ฐานยกขึ้นระดับแกน)
   - ลูกล้ออิสระต้องสูงเท่าไรให้ฐานขนาน และรุ่นไหนในข้อ 3 ใกล้ที่สุด (หรือต้องรองแผ่นกี่ mm)
   - เขียนสูตรและตัวเลขทุกขั้นให้หัวงานตรวจได้
   - ข้อจำกัดที่ต้องเช็ก: ใต้ท้องต่ำไปแล้วติดพื้นต่างระดับ/สะดุดสายไฟ, ระยะที่ IR TCRT5000/HW-201 อ่านพื้นได้ดี (จาก datasheet), ลูกล้ออิสระเล็กไปแล้วติดพรม
5. **คำแนะนำ** — เสนอ 2–3 ชุด (ขนาดล้อ + รุ่นลูกล้อ + วิธียึดมอเตอร์) พร้อมทางที่แนะนำ 1 ทาง เน้นใต้ท้องต่ำและตัวเล็กที่สุด แต่ยังวิ่งบนพื้นห้องเรียน/โต๊ะได้

## ห้ามทำ
- ห้ามแก้ไฟล์อื่นนอกจากไฟล์ผลไฟล์เดียว
- ห้ามแต่งตัวเลขที่ไม่มีที่มา
- ห้ามเสนอเปลี่ยนชิ้นส่วนอื่นที่เจ้าของไม่ได้ถาม (เช่น เปลี่ยนมอเตอร์ เปลี่ยนแบต)
- ห้ามทำให้ภาษา/encoding เสีย

## ส่งมอบ
- ไฟล์ผล 1 ไฟล์ตามชื่อข้างบน: ตารางขนาด (มีคอลัมน์ ที่มา URL และ ระดับความเชื่อถือ), ตารางล้อ, ตารางลูกล้อ, การคำนวณใต้ท้อง, คำแนะนำ
- ท้ายไฟล์: รายการตัวที่ "ไม่พบ" และต้องวัดของจริง
- คำตอบสุดท้ายสรุป 5–10 บรรทัด ระบุว่าค้นจากเว็บจริงกี่แหล่ง และตัวไหนยังไม่แน่ใจ
