HoneyKung/metorobot/ใบสั่งงาน/ใบ02_กรอบทดสอบ_PCA9685_VL53L0X_MG996R_Luna.md

# ใบ 02 — โค้ด STL กรอบทดสอบใส่ชิ้นส่วน: PCA9685, VL53L0X, MG996R + ชิ้นทดลองตัวล็อก (ผู้เขียน Luna / หัวงาน Claude ตรวจ / 1 พ.ย. 2569)

## คำสั่งเจ้าของ (คำต่อคำ)
> ไปตามหาไฟล์เอกสารของฮาร์ดแวแล้วเอาตัวเลขจริง เขียนโ๕้ด stl ฉํนจะปริ้นมาทดสอบว่าใส่ได้จริง

> ถ้าไม่ต้องรอ ทำทดสอบชิ้นอื่นก่อนก็ได้นะ ฉํนเน้นวางฮาดแวเข้าไป ไม่แน่นไขฮารดแวติดกับของ
> ประเมินคือถ้ามันพอดีมันใส่ได้พอดี แต่ก้ถ้ามีตัวยึดด้วย ก็ดีระดับนึง ตัวยึกแบบไม่ใช้ สกรูหรือนอต … อย่างถ้าชั้นบนก่อนหัว ชั้นเซอโวมอเตอร์ คือฉํนทำความสูงชั้น พอดีกับขนาดเซอโว 996 เลยนะ ซึ่งมันใส่ได้ลงลอคพอดี แน่นพอดีเลย มันจะทำตัวลอคได้ไหมโดยไม่เพิ่มความสูงของชั้น

> ESP32 วางบนเบรดบอร์ด ที่ฉํนผ่าครึ่ง … ข้าตัวนี้ไปก่อนได้ เอาตัวที่แม่นๆ เเช่น ตัววัดระย กับ pdc
> … ตอนแรกออกแบบช่องใส่พอดีเลย แต่พอตัว tb มีการบัดกรี และใส่ตัวเก็บประจุ ผมคือ ใส่ช่องไม่พอ … tb ก็ๆม่มีรูให้ขันนอตด้วน่ะสิ แต่ vlc ยังมี

> อ่ะ 996 คือให้ตัวแกนหมุนยื่นออกมานอกัวนะเพราะัมนคือจุดขันนอตติดแขน ใช้แบบ แขนจะเสียบเข้าแกนหมุนซี่ของมอเตอร์ได้ แล้วขันนอต ประมารนี้น่ะ ที่ต้องให้ยื่นออกมาคือเพื่อเพิ่มระยะ ก็คือมันวางนอนนะ แกนออกข้าง ตำแหน่งแกนอยู่หน้าสุด ยื่นทะลุกำแพง และตัวหนังฝั่งแกน จะนาบกำแพงพอดีเป๊ะ งานเก่าฉํนทำแบบนี้ใส่ได้พอดีเป๊ะ

**สรุปการวาง MG996R (บังคับ):** วางนอน แกนหมุนชี้ออกด้านข้าง ตำแหน่งแกนอยู่หน้าสุด ยื่นทะลุผนังออกนอกตัว (แขนเสียบเฟืองซี่ของแกนแล้วขันน็อตที่แกน — น็อตที่แกนเป็นของเซอร์โวเอง ไม่ขัดกฎไม่ใช้สกรูยึดอุปกรณ์) · หน้าตัวเซอร์โวฝั่งแกนนาบผนังด้านในพอดี · ชั้น 4 เดิมทำแบบนี้และใส่ได้พอดี → ต้องคัดลอกรูแกนทะลุผนัง ตำแหน่ง และระยะนาบผนังจาก `layer4_original.stl` มาให้ตรง · ขอเกี่ยว/ครีบห้ามทำให้หน้าเซอร์โวฝั่งแกนห่างจากผนัง (ห้ามมีครีบบนผนังฝั่งแกน)

หัวงานตีความ: "ตัววัดระย" = VL53L0X, "pdc" = PCA9685, "vlc" = VL53L0X · ใบนี้ **ไม่ทำ** ESP32 (เจ้าของบอกข้าม), TB6612 (รอวัดชุดที่บัดกรีแล้ว), ชั้น 1 (รอวัดมอเตอร์)

---

คุณคือ Luna ลงมือทำงานโดยตรง ห้ามเรียก codex exec ซ้อน
โฟลเดอร์งาน: โฟลเดอร์ที่ใบนี้อยู่ (`ใบ02`) · sandbox เขียนลง G:\ ไม่ได้ ห้ามใช้ Google Drive connector
ไฟล์ที่เขียนได้: เฉพาะใต้ `ใบ02\ผล\`
ห้ามแตะ: ไฟล์ใน `ใบ02\อ่านก่อน\` (อ่านอย่างเดียว)
อ่านก่อน (บังคับ) ใน `ใบ02\อ่านก่อน\`:
- `ขนาดอุปกรณ์รายชั้น_สำหรับกรอบทดสอบ_2026-11-01.md` — ตารางขนาดและไอเดียการยึดของเจ้าของ
- `ผลค้นขนาดอุปกรณ์และลูกล้อ_Luna_2026-11-01.md` — งานค้นของคุณเองรอบก่อน (หัวข้อหัวงานตรวจท้ายไฟล์)
- `สเปกอุปกรณ์จริงและงบกระแสสำหรับรายงาน_RoboMDT.md` — รุ่นเซอร์โวที่ซื้อจริง
- `layer3_original.stl` (= ชั้น3.stl ที่พิมพ์ใช้จริง, md5 840214ed11694de49a250efc12390e2a) และ `layer4_original.stl` (= ชั้น4.stl, md5 43593659931582625c6215148da61f17) — **ช่อง MG996R ในชั้น 4 เจ้าของยืนยันว่าใส่แล้วแน่นพอดี** ใช้เป็นหลักฐานขนาดช่องที่ถูก
เครื่องมือ: OpenSCAD 2021.01 ที่ `C:\Program Files\OpenSCAD\openscad.com` (export: `openscad.com -o out.stl in.scad`) · Python 3.14 มี numpy, trimesh
กฎ: ไฟล์ .md เขียนไทย UTF-8 · ตัวเลขทุกตัวต้องบอกที่มา (STL เดิม / datasheet+URL / ค่าเผื่อที่ตั้งเอง) · ห้ามแต่งเลข · grep ไฟล์ผลไม่พบเครื่องหมายคำถามสี่ตัวติดกัน · ชื่อไฟล์ .scad/.stl ใช้ภาษาอังกฤษ

## หลักการแบบ (จากเจ้าของและเอกสาร)
- ตัวเล็กที่สุด · ไม่ใช้สกรู/น็อต/heat-set insert กับอุปกรณ์ · วางลงจากด้านบน
- วัสดุ PETG หัว 0.4 ชั้น 0.2 mm (โปรไฟล์ ProRoBo ผนัง 2 เส้น — ขาขอเกี่ยวให้ออกแบบโดยคิดว่าเจ้าของจะตั้งผนัง 4 เส้นตอนพิมพ์ชุดนี้)
- **ครีบบีบกันหลวม (crush rib)** ใส่ทุกช่อง: สันนูนแนวตั้งบนผนังด้านใน ปลายบนลบมุมนำเข้า
- **ขอเกี่ยว snap-fit** ใส่เฉพาะช่อง MG996R: ขาวางแนวนอนในผนัง (งอในระนาบ XY ตามแนวเส้นพิมพ์ ห้ามเป็นขาตั้งแนวดิ่งที่งอออกจนชั้นพิมพ์ฉีก) ปากงุ้ม 0.5–1.0 mm มีมุมนำเข้า โคนขามีมุมโค้ง · **ห้ามเพิ่มความสูงเกินช่องเดิมในชั้น 4**
- กรอบทดสอบให้ประหยัดเส้น: เป็นวงแหวนผนังเตี้ย + พื้นบางหรือพื้นเปิดกลาง สูงพอให้ทดสอบความพอดีและตัวล็อก ไม่ต้องสูงเต็มชั้น ยกเว้นช่อง MG996R ที่ต้องทดสอบตัวล็อกที่ระดับเดิม

## ต้องทำ
1. **วัดช่อง MG996R จาก `layer4_original.stl`** (ตัดหน้าตัดด้วย trimesh หลายระดับ Z) รายงานขนาดช่อง ความลึก ตำแหน่งที่หูยึดเซอร์โววาง และค่าเผื่อที่ช่องเดิมใช้เทียบกับสเปก 40.7 × 19.7 × 42.9 · ทำเช่นเดียวกันกับช่อง PCA9685 ใน `layer3_original.stl` ถ้าหาเจอ (ถ้าไม่เจอให้บอก)
2. **หาข้อมูล PCA9685 และ VL53L0X จากเว็บ** (Adafruit PCA9685 drawing / GY-530): ขนาด PCB, ตำแหน่งและขนาดรูยึด, ตำแหน่ง header ปลายบอร์ดและขั้วสกรู V+, ตำแหน่งชิปเซนเซอร์/หน้าต่างมองของ VL53L0X
3. **เขียน OpenSCAD แบบพารามิเตอร์** ไฟล์เดียว `ผล/meto_fit_tests.scad` (ตัวแปรขนาดอยู่บนสุด อธิบายที่มาเป็น comment) แล้ว export STL แยกชิ้น:
   - `pca9685_rib_020.stl`, `pca9685_rib_035.stl`, `pca9685_rib_050.stl` — กรอบ PCA9685 เหมือนกัน ต่างกันที่ความสูงครีบ 0.20/0.35/0.50 mm · เว้นช่องให้หัวพิน/สาย Dupont ปลายบอร์ดและขั้วสกรูเข้าถึงได้ · พิมพ์ตัวเลขค่าครีบนูนบนชิ้น
   - `vl53l0x_holder.stl` — แผ่นยึด VL53L0X แบบไม่ใช้สกรู: หมุดพิมพ์มีร่องผ่าและปากล็อกเสียบรูยึดของบอร์ด ทำหมุด 2 ขนาด (รู − 0.2 และรู − 0.4 mm) บนชิ้นเดียวหรือ 2 ชิ้นแยกตามที่เหมาะ · มีหน้าต่างเปิดหน้าเซนเซอร์ไม่บัง
   - `mg996r_snap_pocket.stl` — ช่อง MG996R ขนาดตามช่องเดิมในชั้น 4 + ครีบ 0.35 + ขอเกี่ยว 2 ตัว (หนา 1.6) จับขอบบนตัวเซอร์โวหรือหูยึด ตามที่เรขาคณิตช่องเดิมเอื้อ โดยไม่สูงเกินช่องเดิม · ฐานทำเป็นถาดสั้นเฉพาะรอบช่อง ไม่ใช่ทั้งชั้น
   - `snap_hook_coupon.stl` — ชิ้นทดลองขอเกี่ยว 3 ขา หนา 1.2/1.6/2.0 mm พร้อมชิ้นคู่ที่ให้เกี่ยว พิมพ์ตัวเลขความหนาบนชิ้น
   - `rear_rod_hole_test.stl` — บล็อกทดลองรูนำแท่งเกลียวด้านหลัง (สำรอง ไม่ใช่ตัวล็อกหลัก) รู M3 = 3.4/3.6 และ M4 = 4.5/4.7 mm พร้อมพิมพ์ค่า · อ้างแนวคิด M4 long lock เดิม (เสา Ø12 รู 4.70)
4. **ตรวจ STL เอง** ด้วย trimesh: watertight, bounding box, ปริมาตร · รายงานในไฟล์ผล
5. **ไฟล์ผล `ผล/รายงานใบ02.md`**: ตารางพารามิเตอร์ทุกตัวพร้อมที่มา, ผลวัดช่องจาก STL เดิม, ขนาดและ watertight ของ STL ทุกชิ้น, ทิศการวางพิมพ์ที่แนะนำของแต่ละชิ้น (ให้ขาขอเกี่ยวอยู่ระนาบ XY), สิ่งที่เจ้าของต้องสังเกตตอนลองใส่ (แน่นไป/หลวมไป/ขอเกี่ยวหัก แก้ตัวแปรไหน)

## ห้ามทำ
- ห้ามเขียนนอก `ผล\`
- ห้ามสร้างชิ้น ESP32, TB6612, ชั้น 1, ล้อ, หัว
- ห้ามเพิ่มความสูงช่อง MG996R เกินช่องเดิม
- ห้ามใส่สกรูหรือน็อตยึดอุปกรณ์ (รูแท่งเกลียวมีเฉพาะบล็อกทดลองแยก)
- ห้ามแต่งตัวเลขที่ไม่มีที่มา ถ้าหาไม่ได้ให้ตั้งเป็นตัวแปรเด่นชัด ใส่ค่าเผื่อที่ปลอดภัย และระบุใน "ต้องวัด"
- ห้ามทำให้ภาษา/encoding เสีย

## ส่งมอบ
- `ผล/meto_fit_tests.scad`, STL 7 ไฟล์ตามรายการ, `ผล/รายงานใบ02.md`
- คำตอบสุดท้าย 5–10 บรรทัด: export สำเร็จกี่ไฟล์, watertight ครบไหม, ตัวเลขไหนยังไม่แน่ใจ · ระบุชัดว่า "ยังไม่ได้พิมพ์ทดสอบจริง"
