HoneyKung/metorobot/ใบสั่งงาน/ใบ02_รอบแก้3_เติมขอเกี่ยว.md

# ใบ 02 รอบ 3 — เติมขอเกี่ยว t = 1.2 ในช่อง MG996R (หัวงานคำนวณและตัดสินแล้ว)

ชิ้น `mg996r_snap_pocket.stl` รอบแก้ 2 (ตัดจากชั้น 4 เดิมตรง ๆ) ผ่าน · รอบนี้เติมขอเกี่ยวเท่านั้น

## ค่าที่หัวงานเลือก (สูตรคานยื่น Covestro, PETG E 1109.6 MPa, ε ยอมให้ 2.48%, μ 0.5)
| t | L | b | y | ε | ค่าปลอดภัย | แรงดึงถอด 2 ขา |
|---|---|---|---|---|---|---|
| **1.2** | **10** | **4.4** | **0.7** | 1.26% | **1.97** | ~0.90 kg (เซอร์โวหนัก ~55 g) |
ผนังจริง 2.0 mm = ขา 1.2 + ร่องหลบ 0.6 + ผิวนอก 0.2 → ถ้าผิวนอก 0.2 พิมพ์ไม่ได้ (เล็กกว่าเส้น 0.4) ให้ **ตัดผิวนอกออก ปล่อยร่องหลบเปิดออกด้านนอก** (ด้านนอกของผนังนี้คือช่องกลางระหว่างเซอร์โวสองตัว ไม่มีอะไรมาชน)

## ต้องทำ
1. ใน part "mg996r" ใส่ขอเกี่ยว 2 ตัวบนผนังฝั่งตรงข้ามแกน (ผนัง X ด้านใน) ด้วย `difference()` ตัดผนังเดิมตรงตำแหน่งขา แล้ว `union()` ขา · ใช้ตำแหน่ง Y สองสถานีแบบรอบแก้ 1 ถ้าไม่ชนบ่า/ผนังขวาง
2. ขา t=1.2, L=10, สูง 4.4, ร่องหลบ 0.6, ช่องปลาย 0.6, ปากยื่น 0.7 มุมนำเข้าด้านบน 45°, ใต้ปาก = พื้นช่อง + 19.8, ยอดปากไม่เกินขอบบนเดิม, ผิวในขาเสมอผนังเดิม
3. ตัวแปรใหม่ `mg_hook_*` อยู่บนสุดของ `meto_fit_tests.scad` พร้อม comment ค่าที่มา (ตารางข้างบน)
4. export ทับ `ผล/mg996r_snap_pocket.stl` · ตรวจ watertight · เทียบหน้าตัดกับชั้นเดิม 3 ระดับ: ต่างได้เฉพาะบริเวณขอเกี่ยว
5. ต่อท้ายรายงาน หัวข้อ "รอบ 3" สั้น ๆ

ห้ามแตะชิ้นอื่น · คำตอบสุดท้าย 4 บรรทัด · "ยังไม่ได้พิมพ์ทดสอบ"
