HoneyKung/metorobot/ใบสั่งงาน/ใบ04_ชิ้นทดสอบชุด2_Luna.md

# ใบ 04 — ชิ้นทดสอบชุด 2 (ไม่ต้องรอวัดของจริง) (ผู้เขียน Luna / หัวงาน Claude ตรวจ / 2 พ.ย. 2569)

## คำสั่งเจ้าของ (คำต่อคำ)
> วันนี้ต้องได้พิมชิ้นทดสอบครบทกแบบที่เราคิดทั้งตัวยึด ตัวยึดชั้น กรอบของฮาดแว สายไฟ ล้อ ตัวรวมสาย ฟิวส์ แต่ฟิสสายหนามาก กินที่มาก

ใบนี้ทำเฉพาะชิ้นที่ใช้ตัวเลขจาก datasheet/ไฟล์เดิมได้เลย · ชิ้นที่ต้องรอเจ้าของวัด (ฟิวส์, TB6612, ESP32, LM2596, BMS, CM620, XT30, แม่เหล็ก) จะเป็นใบถัดไป

คุณคือ Luna ลงมือทำงานโดยตรง ห้ามเรียก codex exec ซ้อน · เขียนได้เฉพาะ `ผล\` · อ่านก่อน: `อ่านก่อน\โจทย์ออกแบบโครงใน_v2_2026-11-02.md` (โจทย์รวม ข้อ R11, R14, R14b, R23, R24, R5) และ `อ่านก่อน\meto_fit_tests.scad` (สไตล์โค้ดชุด 1 ใช้ต่อ) และ `อ่านก่อน\รายงานใบ03.md` (สูตร snap-fit + ค่า PETG)
เครื่องมือ: OpenSCAD `C:\Program Files\OpenSCAD\openscad.com`, Python + numpy/trimesh · ไฟล์ใหม่ `ผล\meto_fit_tests_set2.scad` (ตัวแปรบนสุด มี comment ที่มา) export STL แยกชิ้น ชื่ออังกฤษ · ทุกชิ้นพิมพ์ PETG 0.4/0.2 **ห้ามต้องใช้ซัพพอร์ต** (มุมยื่น ≤45°) · พิมพ์ค่าทดสอบนูนบนชิ้น · ประหยัดเส้น (ชิ้นเล็กที่สุดที่ยังทดสอบได้)

## ชิ้นที่ต้องทำ
1. **`layer_buckle_test`** — ล็อกชั้นแบบหัวเข็มขัดกระเป๋า เป็นชิ้นแยกเปลี่ยนได้: ท่อนผนังชั้นล่างสั้น (หนา 2.4 กว้าง ~30 สูง ~15) มีตัวเมียติดผนังด้านนอก · ท่อนผนังชั้นบนซ้อนได้ (มีบ่าซ้อนกันแบบปิ่นโต) · **ตัวผู้เป็นชิ้นแยก** สวมกับชั้นบนด้วยร่องหางเหยี่ยวเลื่อนลง แล้วขาสองข้างหนีบเข้าตัวเมีย บีบข้างเพื่อปลด · คำนวณขาตัวผู้ด้วยสูตรใบ 03 ให้ค่าปลอดภัย ≥1.5 (PETG E 1109.6, ε ยอมให้ 2.478%) ใส่ผลคำนวณในรายงาน · ทำขาตัวผู้ 2 ความหนา (ชิ้นตัวผู้ 2 ชิ้น)
2. **`wire_channel_floor`** — รางกดสายลงล็อกบนพื้น ยาว 60 ปากหันขึ้น 2 ราง: สัญญาณ (กว้างใน 6) และไฟ (กว้างใน 8) · ปากรางเป็นลิ้นสลับซ้าย-ขวา (หรือซี่หวี) ให้กดสาย Ø1.3–3.0 ลงแล้วไม่เด้งออก · ขีดบอกระยะทุก 10 mm พร้อมเลข
3. **`wire_channel_wall`** — รางเดียวกันแต่ติดผนังตั้ง พิมพ์ตั้งขึ้นโดยผนังแนบเตียง… ไม่ได้: **ให้วางแบบที่จะพิมพ์จริงในชั้น** คือผนังตั้งฉากเตียง รางวิ่งแนวนอนตามผนัง ปากหันเข้าตัว · ลิ้นปากรางทำมุม 45° ให้พิมพ์ได้ไม่ใช้ซัพพอร์ต
4. **`wago_holder`** — แท่นรับ WAGO 221-415 (29.9 × 18.6 × 8.3) และ 221-413 (18.8 × 18.8 × 8.4) อย่างละช่อง ตามค่าในโจทย์/ผลค้น (ลิงก์ WAGO ในรายงานเดิม) · ยึดด้วยครีบบีบ 0.35 + ปากเกี่ยวเล็ก · **คันโยกต้องเปิดได้สุด** ไม่ชนอะไร (ตั้งตัวแปรระยะเปิดคันโยก ใส่ค่าที่หาได้จากแบบ WAGO หรือเผื่อ ≥15 mm เหนือตัว ระบุว่าเป็นค่าเผื่อ) · ช่องสายเข้าด้านหน้าทุกรู
5. **`wheel41_hub` + `wheel41_tire`** — ล้อ Ø41 รวมยาง กว้าง 12 · ดุม PETG: **คัดลอกรูเพลา TT (รูป D) จาก `wheel_tt_hub_original.stl`** (วัดจาก mesh ให้ตรง md5 b11af894…) · ยาง TPU แยกชิ้น หนา 2.0 สวมรัดดุม มีร่องกันยางเลื่อนบนดุม · ทำดุม 2 แบบค่ารูเพลา (เท่าเดิม และ +0.1)
6. **`ball_caster_test`** — ลูกล้ออิสระพิมพ์เอง: ลูก PETG Ø12 (ชิ้นแยก พิมพ์ได้) + เบ้าที่มีปากล็อกลูกไม่ให้หลุด หมุนได้คล่อง · ระยะหลวม 2 ค่า (0.3 / 0.5) · ความสูงจากพื้นถึงหน้ายึดเป็นตัวแปร (ค่าเริ่ม 10 mm — จะปรับหลังได้ค่า a ของมอเตอร์)
7. **`rod_hole_test_m6m8`** — เสานอกตัว 2 ต้น Ø13 (M6) และ Ø15 (M8) รู M6 = 6.4/6.6 และ M8 = 8.4/8.6 (2 ช่วงสูงในต้นเดียวหรือแยกต้น) + หูยื่นทดลองร้อยเสา (สำหรับเปลือก/บานพับภายหลัง)

## ห้ามทำ
- ห้ามเขียนนอก `ผล\` · ห้ามใช้สกรูยึดอุปกรณ์ · ห้ามแต่งตัวเลขไม่มีที่มา (ค่าเลือกเองให้เขียนว่า "ค่าเลือก") · ห้ามแตะไฟล์ชุด 1

## ส่งมอบ
- `ผล/meto_fit_tests_set2.scad`, STL ทุกชิ้น, `ผล/รายงานใบ04.md` (ตารางชิ้น: ขนาด, watertight, วิธีวาง, สังเกตอะไรตอนลอง, แก้ตัวแปรไหน; ผลคำนวณขาหัวเข็มขัด; ขนาดรูเพลา D ที่วัดได้)
- คำตอบสุดท้าย 6 บรรทัด · "ยังไม่ได้พิมพ์ทดสอบ"
