HoneyKung/metorobot/ใบสั่งงาน/ใบ05_กรอบฮาร์ดแวร์ชุด3_Luna.md

# ใบ 05 — กรอบทดสอบฮาร์ดแวร์ชุด 3 (ใช้ค่าเอกสาร ไม่รอวัด) (ผู้เขียน Luna / หัวงาน Claude ตรวจ / 2 พ.ย. 2569)

## คำสั่งเจ้าของ (คำต่อคำ)
> วันนี้ต้องได้พิมชิ้นทดสอบครบทกแบบที่เราคิดทั้งตัวยึด ตัวยึดชั้น กรอบของฮาดแว สายไฟ ล้อ ตัวรวมสาย ฟิวส์ แต่ฟิสสายหนามาก กินที่มาก
> อ่ะ แล้วตัวทดสอบไม่ทำก่อนหรอ คือมันแก้ค่าได้ง่ายอยุแล้ว

หัวงานตีความ: ไม่ต้องรอเจ้าของวัด — ทำกรอบทดสอบจากค่าในเอกสาร/datasheet ไปก่อน เจ้าของพิมพ์แล้วลองใส่ของจริง แล้วแก้ตัวแปร · ดังนั้น **ทุกขนาดต้องเป็นตัวแปรบนสุดของไฟล์** แก้ค่าเดียวแล้ว export ใหม่ได้

คุณคือ Luna ลงมือทำงานโดยตรง ห้ามเรียก codex exec ซ้อน · เขียนได้เฉพาะ `ผล\` · ไฟล์ใหม่ `ผล\meto_fit_tests_set3.scad` + STL แยกชิ้น ชื่ออังกฤษ + `ผล\รายงานใบ05.md`
อ่านก่อน (`อ่านก่อน\`): `โจทย์ออกแบบโครงใน_v2_2026-11-02.md` (R8 R9 R11 R20 R22 R27), `ขนาดอุปกรณ์รายชั้น_สำหรับกรอบทดสอบ_2026-11-01.md`, `ผลค้นขนาดอุปกรณ์และลูกล้อ_Luna_2026-11-01.md`, `meto_fit_tests.scad` (สไตล์และค่าครีบชุด 1), `layer1_original.stl` (md5 81ae8f80…), `layer2_original.stl` (md5 a4d1561c…)
เครื่องมือ: OpenSCAD `C:\Program Files\OpenSCAD\openscad.com`, Python numpy/trimesh
กฎร่วม: PETG · **ไม่ใช้ซัพพอร์ต** (หลังคาช่องโค้ง/45°) · ยึดด้วยครีบบีบ 0.35 (ตัวแปร) ไม่มีสกรู · กรอบเป็นถาดเตี้ยประหยัดเส้น · พิมพ์ชื่อชิ้น+ค่าหลักนูนบนชิ้น · เผื่อขอบ 2–3 mm ด้านที่มีขั้ว/หัวสาย (เอกสารข้อ 10)

## ชิ้นที่ต้องทำ
1. **`tt_motor_cradle`** — **ตัดจากช่องมอเตอร์ TT ใน `layer1_original.stl` ตรง ๆ** (ช่องเดิมใส่ได้แล้ว) ช่องเดียว + ฐานบาง ให้เจ้าของลองวางมอเตอร์จริงและใช้ชิ้นนี้หาค่า D (แกนเพลาถึงผิวล่าง) ด้วย: ทำขีดสเกลแนวตั้งทุก 1 mm ข้างรูเพลาบนผนัง · รายงานค่าที่อ่านได้จาก mesh: ตำแหน่งรูเพลาเทียบพื้นช่อง (นี่คือค่า D ที่แบบเดิมใช้)
2. **`battery_holder_frame`** — รางถ่าน BH-18650x2-M 76 × 41 × 20 (ใส่ถ่านแล้ว) · ถอดแบตได้โดยไม่ต้องรื้อ (ช่องนิ้วดึง) · ทางสาย B+/B−
3. **`lm2596_frame`** — 43 × 21 × 14 · ช่องสายเข้า-ออกสองปลาย · ไม่ต้องช่องไขควง
4. **`tb6612_frame`** — โมดูล 20 × 20 **+ เผื่อตัวเก็บประจุ 470µF (Ø8 × 12 ถึง Ø10 × 20, ตัวแปร) วางข้างบอร์ด** + หัวพิน/สายบัดกรีที่ยื่น · ช่องสูงพอหัว Dupont · ทำ 2 ขนาดเผื่อ (ปกติ / +3 mm ทุกด้าน)
5. **`bms_cm620_frame`** — BMS 2S ~47 × 23 × 3 และ CM620 ~30 × 17 × 5 ในถาดเดียว · CM620 ชิดผนัง พอร์ต USB-C โผล่ทะลุผนัง (ช่องพอร์ตเป็นตัวแปรตำแหน่ง) · มีแผ่นกั้นฉนวนใต้ BMS
6. **`fuse_xt30_frame`** — ฐานฟิวส์ inline (ค่าเริ่ม 5×20 mm ตัวฐาน ~39 × 8 × 8 + สาย 18AWG ทั้งสองปลาย) + XT30 คู่เสียบ (AMASS XT30U ตามผลค้น) · **รางสายใหญ่** ให้สายฟิวส์ที่หนาวางแนบ ไม่ขดกินที่ · ทำช่องฟิวส์ 2 ขนาด (ฐาน 5×20 / ฐาน mini blade ~35 × 15 × 15 ตามเอกสาร) เลือกใช้
7. **`ir_cliff_mount`** — ที่ยึดเซนเซอร์กันตก HW-201 (PCB ~32 × 14 × 7 ตามเอกสาร) หันลงพื้น · ระยะเซนเซอร์-พื้นปรับได้ 3 ระดับ (ร่อง 2/4/6 mm) · **รูไขควงเข้าถึงตัวปรับความไวจากด้านบน/ข้าง** · ล้ำหน้าแนวล้อ ≥25 mm (R20) — ชิ้นทดสอบทำแค่ตัวยึด ไม่ต้องทั้งฐาน
8. **`pca9685_dupont_strain`** — ต่อจากกรอบ PCA9685 ชุด 1: ราวรับหัว Dupont หลายหัว + จุดรัดเคเบิลไทร์ก่อนถึงหัว (กันแรงดึงลงขาพิน) และที่วางตัวเก็บประจุ 1000µF (Ø10–13 × 20–25) ใกล้ขั้ว V+

## ห้ามทำ
ห้ามเขียนนอก `ผล\` · ห้ามแต่งตัวเลข: ใช้ค่าจากเอกสาร/ผลค้นและบอกที่มา ค่าเผื่อที่ตั้งเองเขียน "ค่าเลือก" · ห้ามแตะไฟล์ชุด 1–2

## ส่งมอบ
STL ทุกชิ้น watertight · `รายงานใบ05.md`: ตารางชิ้น (ขนาดชิ้น, เวลา/ปริมาณโดยประมาณถ้าทำได้, วิธีวาง, ลองแล้วดูอะไร, แก้ตัวแปรไหน) + ค่า D ที่อ่านจากชั้น 1 เดิม · คำตอบสุดท้าย 6 บรรทัด · "ยังไม่ได้พิมพ์ทดสอบ"
