HoneyKung/metorobot/ใบสั่งงาน/ใบ05_หมายเหตุสำหรับ_Gemini.md

# หมายเหตุสำหรับ Gemini (ใช้แทน Luna ในใบ 05) — 2 พ.ย. 2569

เจ้าของสั่ง: "ให้เจมิไนทำเลย" (Luna โควตาหมดถึง 04:10)

- อ่าน `ใบ05_กรอบฮาร์ดแวร์ชุด3_Luna.md` แล้วทำตามทุกข้อ โดยถือว่าคุณ (Gemini) คือผู้เขียนแทน Luna
- **อ่าน/เขียนไฟล์ด้วย file tool เท่านั้น ห้ามใช้ shell** (โหมดนี้ shell จะถูกปฏิเสธ)
- ดังนั้น **ไม่ต้อง export STL และไม่ต้องวัด mesh ด้วย Python** — เขียนแค่ `ผล/meto_fit_tests_set3.scad` ให้ครบทุกชิ้น โดยมีตัวแปร `part = "..."` บนสุดเลือกชิ้นที่จะ render (ชื่อชิ้นตามใบ) และ `ผล/รายงานใบ05.md`
- ชิ้น `tt_motor_cradle`: ใช้ `import("../อ่านก่อน/layer1_original.stl")` + `intersection()` กล่องครอบช่องมอเตอร์ TT ช่องหนึ่ง (เลือกพิกัดกล่องจากรูปทรงชั้น 1: ฐาน 130 × 148 × 29, ช่องมอเตอร์อยู่ซ้าย/ขวาของรางถ่านกลาง) ใส่พิกัดกล่องเป็นตัวแปรให้หัวงานปรับได้ · หัวงานจะวัดค่า D และตรวจกล่องตัดเอง
- หัวงาน (Claude) จะ export STL, ตรวจ watertight และขนาดเองหลังคุณเขียนเสร็จ
- โค้ดต้องเป็น OpenSCAD 2021.01 ได้ (ห้ามใช้ฟีเจอร์รุ่นใหม่กว่า เช่น `object()`/function literal ซับซ้อน)
