HoneyKung/metorobot/ใบสั่งงาน/ใบ06_รางกดสาย_Gemini.md

# ใบ 06 — รางกดสายลงล็อก (ทำใหม่) · ผู้เขียน Gemini · หัวงาน Claude ตรวจ · 2 พ.ย. 2569

คำเจ้าของ (คำต่อคำ): "ทางเดินสายถ้ามีอะไรลอกสายก็ดี เพระาจะได้กะตัดความยาวสายถูกด้วย สามารถทำสายเดินสายแบบกดสายลงไปได้ไหมนะ ไม่จำกัดขนาดสาย + มันต้องปริ้นแยกไหมนะเพราะถ้าติดผนังคือต้องมีซัพพอตรึเปบ่า"

รอบก่อน (Luna) ไม่ผ่าน: (1) mesh ไม่ปิด (ชิ้นแตะกันแค่ผิว/ขอบ) (2) ปากรางเป็นคานยื่นแนวนอนจากผนัง ต้องใช้ซัพพอร์ต (3) ซี่ติดผนังตลอดความยาว งอไม่ได้

อ่าน/เขียนด้วย file tool เท่านั้น ห้ามใช้ shell · เขียนไฟล์เดียว `out/wire_channels.scad` (OpenSCAD 2021.01) ตัวแปรบนสุด + `part = "floor"` หรือ `"wall"` · หัวงานจะ export/ตรวจเอง

## ข้อกำหนด
- PETG หัว 0.4 ชั้น 0.2 · **ห้ามมีส่วนยื่นที่ต้องใช้ซัพพอร์ต**: ทุกผิวที่หันลงต้องเอียง ≥45° จากแนวนอน (หรือเป็นสะพานสั้น ≤5 mm)
- **ทุกส่วนต้องซ้อนทับกันอย่างน้อย 0.05 mm** (ใช้ eps) ห้ามแตะแค่ผิวหรือขอบ → ผลต้องเป็นของแข็งปิดสนิทชิ้นเดียว
- รับสาย Ø1.3–3.0 mm ในรางเดียว กดลงแล้วไม่เด้งออก
- ยาว 60 mm · ขีดบอกระยะทุก 10 mm + ตัวเลข (นูน 0.4) บนสันราง
- 2 ราง: สัญญาณ กว้างใน 6 · ไฟใหญ่ กว้างใน 8 · ฐานราง 1.2

### part "floor" (รางบนพื้น ปากหันขึ้น)
- ผนังรางหนา 1.2 สูง 6 · **ผ่าผนังเป็นท่อน ๆ ด้วยร่องตั้งกว้าง 0.6 ทุก 10 mm** ให้แต่ละท่อนงอออกได้
- ปากล็อก: ที่ยอดผนังแต่ละท่อนมีลิ้นยื่นเข้า 1.0 mm **หน้าตัดสามเหลี่ยม**: ด้านบนเอียง 45° (นำสายลง) ด้านล่างเอียง 45° (พิมพ์ได้ไม่ต้องซัพพอร์ต) · ลิ้นซ้าย-ขวาสลับท่อนกัน (ท่อนคู่ลิ้นซ้าย ท่อนคี่ลิ้นขวา) เพื่อให้ช่องเปิดกว้างพอกดสายใหญ่ได้

### part "wall" (รางติดผนังตั้ง รางวิ่งแนวนอน ปากหันเข้าตัว)
- ชิ้นทดสอบ: แผ่นผนังตั้ง 60 × 30 หนา 2 บนฐานกว้าง 15 หนา 1.2 (ให้ตั้งบนเตียงได้)
- รางยื่นออกจากผนัง: หน้าตัด (ในระนาบ YZ) = หิ้งล่างที่ผิวล่างเอียง 45° + หิ้งบนที่ผิวล่างเอียง 45° ช่องระหว่างหิ้ง = ความกว้างใน · ปากล็อกเป็นลิ้นสามเหลี่ยมแบบเดียวกับ floor ที่ปลายหิ้ง (ผิวล่างลิ้นต้อง ≥45°)
- ผ่าหิ้งเป็นท่อนทุก 10 mm ด้วยร่อง 0.6 ให้งอได้

ส่งมอบ: `out/wire_channels.scad` + `out/รายงาน.md` สั้น ๆ (ตัวแปร, วิธีวางพิมพ์, จุดที่ต้องดูตอนลอง)
