HoneyKung/metorobot/ใบสั่งงาน/ใบสั่ง_Gemini_9พย_4งาน.md

# ใบสั่งงาน Gemini (agy) 9 พ.ย. — 4 งาน

วิธีสั่ง: เปิด Terminal ที่ `G:\My Drive\METTO\Code\RoboBlock` แล้วพิมพ์ `agy` จากนั้นคัดลอกข้อความในกรอบของแต่ละงานไปวาง (ทีละงาน หรือเปิด 4 หน้าต่าง)

กติการ่วมทุกงาน: ตอบภาษาไทย · ห้ามอีโมจิในโค้ด/เว็บ · ห้ามแตะ keyAPI.env และเอกสาร IRB · สำรองไฟล์ก่อนแก้ (ต่อท้าย .bak-20261109) · ห้ามแฟลชบอร์ด

---

## งาน A — ทวิน: เลือกใส่ของสวมหัว

```
โฟลเดอร์ static/twin3d (index.html, twin3d.js, models/) เสิร์ฟด้วย devserver.py พอร์ต 8899
เพิ่มตัวเลือก "ของสวมหัว": ไม่ใส่ / หูแมว / หูหมี / หนวดมด / หมวกฟาง ใส่ได้ทีละแบบ ติดไปกับหัว (หันและพยักตามหัว)
STL: "stl redesigned/00_พิมพ์_ชุดล่าสุด_ใช้โฟลเดอร์นี้/_รอเจ้าของตรวจ_ห้ามพิมพ์/ของสวมหัว_8พย/" 1_หูแมว.stl 2_หูหมี.stl 4_หมวกฟาง.stl และ "9_ของสวมหัว/หนวดมด.stl"
พิกัดใน สเปก.md ของโฟลเดอร์นั้น: จุดกำเนิด = กลางผิวบนหัว, +Y = หน้า, Z ขึ้น · วางให้ตรงผิวบนเปลือกหัว (h_shell) ตามที่ twin3d.js โหลดโมเดลหัว
ตรวจ: เปิด http://localhost:8899/static/twin3d/index.html ต้องไม่มี error ใน console · รายงานไฟล์ที่แก้
```

## งาน B — เฟิร์มแวร์: สวิตช์ไอเดิลออนไลน์ + ทิศแขน + ตรวจครบ

```
ไฟล์ RoboPCA9685/RoboPCA9685.ino (+ meto_emotes.h) แฟลช ~98% เหลือ ~25 KB เพิ่มโค้ดให้น้อยที่สุด
คอมไพล์: "%LOCALAPPDATA%/Programs/Arduino IDE/resources/app/lib/backend/resources/arduino-cli.exe" compile --config-file "%USERPROFILE%/.arduinoIDE/arduino-cli.yaml" -b esp32:esp32:esp32 <สำเนาในโฟลเดอร์ชื่อ RoboPCA9685 ใน %TEMP%>
1) เพิ่มสวิตช์ปิด/เปิดท่าไอเดิล (idleTick) สั่งได้ทั้ง Serial และเว็บ: ใช้ช่องทางคำสั่งเว็บที่มีอยู่ (HTTP endpoint ของ WebServer / คำสั่งบรรทัด "!...") เพิ่ม "!idle 0" / "!idle 1" และให้ /state รายงาน idleOn · ค่าเริ่ม = เปิด · ถ้ามีหน้าเว็บควบคุมหุ่น (server.py / templates / static) เพิ่มปุ่มเปิด/ปิดไอเดิล
2) ตรวจทิศแขน MG996R: cfg.armDir ซ้าย −1 ขวา +1 (~บรรทัด 653) เทียบการติดตั้งจริง (MG996R ซ้ายอยู่ −X ขวาอยู่ +X หุ่นหันหน้า +Y เฟืองชี้ออกข้าง) ให้ "ยก + = ขึ้น" ถ้าถูกแล้วไม่ต้องแก้ ถ้าตัดสินไม่ได้ บอกวิธีเช็กด้วยปุ่ม r/t ใน Serial
3) ตรวจครบ: มือขวาย้ายเป็น CH6 แล้ว (SERVO_HAND_RIGHT_CH=6) ห้ามมีที่อ้างช่อง 3 ตรง ๆ · กล้อง Serial2 RX23 (F/P/O) · กันตก · เบรกนุ่ม · ไอเดิล · ท่าอารมณ์ · คอมไพล์ผ่าน
รายงาน: แก้อะไร คอมไพล์กี่ % คำสั่งที่เว็บต้องส่ง
```

## งาน C — เว็บ: ยืนยันเชื่อมกล้อง + เตรียมขึ้น GitHub

```
เว็บ Flask: server.py, dashboard.py, templates/, static/, Procfile, render.yaml (ยังไม่ใช่ git repo)
1) ตรวจว่าเว็บเชื่อมกล้องได้ไหม: กล้อง XIAO อยู่ที่ http://metocam.local (หรือ IP) มี /capture /status /mode และภาพสด :81/stream · หาในโค้ดว่าหน้าไหนดึงภาพ/สถานะกล้อง และเชื่อมหุ่น ESP32 (/state และคำสั่ง) อย่างไร ระบุไฟล์/บรรทัด · อธิบายเรื่อง https (Render/GitHub Pages) เรียก http ไปหุ่น/กล้องไม่ได้ (mixed content) ต้องรันเซิร์ฟเวอร์ในเครื่องบนฮอตสปอตเดียวกัน
2) เตรียม GitHub: .gitignore กัน keyAPI.env, *.env, instance/, *.db, __pycache__/, tmp/, *.bak*, desktop.ini, โฟลเดอร์ stl*, editthesis, เอกสาร IRB, mockups · git init + commit · เช็ก git status ว่าไม่มีไฟล์ลับ · ห้าม push จนเจ้าของสั่ง เขียนคำสั่ง push (gh repo create ... --private --source . --push) และผล gh auth status ไว้ในรายงาน
```

## งาน D — อัปเดตความคืบหน้า + ภาพโครงใส่เล่ม

```
อ่าน: บันทึกการคุย_METO.md, สถานะงาน_METO_ตัวสำเร็จ.md, สรุปสถานการณ์ทั้งหมด_ไว้ปรึกษา_2026-11-05.md, อัปเดตวันศุกร์_6พย_ให้อาจารย์.md, editthesis/, "stl redesigned/00_พิมพ์_ชุดล่าสุด_ใช้โฟลเดอร์นี้/อ่านก่อน.md", สถานะ IRB (อ่านอย่างเดียว)
1) เขียน อัปเดตความคืบหน้า_METO_9พย.md: หัวข้อ + บุลเล็ต + คำอธิบายสั้น ตั้งแต่ แก้เล่ม → IRB → ส่งงาน → ทำเว็บ → ทำหุ่น (3D/เฟิร์มแวร์/กล้อง/ผังสาย) บอก ทำแล้ว/กำลังทำ/ค้าง ใส่ภาพจาก PNG ที่มีจริง แล้วทำเป็น .html ไฟล์เดียวฝังภาพ อ่านบนมือถือได้
2) ภาพโครงหุ่นทุกชั้น (layer1–4, คอ, หัว, แขน) จาก STL ล่าสุดในโฟลเดอร์ 00_พิมพ์... เรนเดอร์ด้วย OpenSCAD เท่านั้น (openscad.com -o x.png --imgsize=1200,900 --viewall --autocenter --colorscheme=Tomorrow ไฟล์.scad ที่ color() import()) ป้ายไทย PIL Tahoma Bold · เก็บที่ ภาพโครงหุ่น_9พย/ · แล้วทำ **สำเนา** เล่มรายงาน docx ฉบับล่าสุด แทรกภาพพร้อมคำบรรยายในบทออกแบบหุ่น (ห้ามเขียนทับต้นฉบับ)
```
