HoneyKung/metorobot/Robo/Part Robot/ขนาดอุปกรณ์รายชั้น_สำหรับกรอบทดสอบ_2026-11-01.md

# ขนาดอุปกรณ์รายชั้น — สำหรับพิมพ์กรอบทดสอบโครงภายในใหม่ (ตัวสำเร็จ)

รวบรวม 1 พ.ย. 2569 · คำสั่งเจ้าของ:
> ตอนนี้อยากทำโ๕รงภายในใหม่ก่อน อย่างแรกให้รวบรวบ ขนาดของสิ่งที่จะใส่ในแต่ละชั้นจะให้ทำกรอบทดสอบใส่ก่อนน่ะ

สถานะตอนรวบรวม (เจ้าของบอก 1 พ.ย.): วิ่งด้วยแบตไร้สายได้แล้ว · ยังไม่ต่อเซอร์โว · ยังไม่ต่อตัวชาร์จ
เป้าหมาย: ขึ้นตัวใหม่ + ต่อตัวชาร์จ + แสดงสถานะแบตบนจอหน้า

**ที่มาของตัวเลข**
- [ด] = ตารางขนาดใน `แผนผังชั้นอุปกรณ์_RoboMDT.md` / `ผังจัดชั้นตัวเต็ม_RoboMDT.md` (เอกสารบอกว่าเป็นข้อมูลจริง แต่บางตัวเขียน "ประมาณ")
- [ส] = สเปกทั่วไปของรุ่นนั้น ยังไม่ได้วัดของจริง
- **[วัด]** = ไม่มีตัวเลขในเอกสาร ต้องวัดด้วยเวอร์เนียก่อนขึ้นกรอบ

ขนาดเขียนเป็น ยาว × กว้าง × สูง (mm) ของตัวบอร์ดเปล่า ตอนขึ้นกรอบให้เผื่อขอบอย่างน้อย 2–3 mm และเผื่อด้านที่มีขั้วสกรู/หัว Dupont/สายมากกว่านั้น (ข้อ 10 ของ `ผังจัดชั้นตัวเต็ม`)

---

## ขนาดชั้นเดิมจาก STL ที่พิมพ์แล้ว (`stl3dprint/` วัด bounding box 1 พ.ย.)

| ไฟล์ | ขนาดรวม |
|---|---|
| ชั้น1.stl | 130 × 148 × 29 (รวมฐานสายพาน) |
| ชั้น2.stl | 96 × 134.8 × 24 |
| ชั้น3.stl | 96 × 112 × 35 |
| ชั้น4.stl | 96 × 112 × 29.7 (เอกสาร 27 ส.ค. เขียน 39.23 — ไฟล์ 28 ส.ค. ถูกแก้แล้ว) |
| ชั้นคอ.stl | 96 × 91.9 × 15.7 |
| ชั้น5ก้านยึดเซอโว3และยึดจอ.stl | 81.2 × 14.1 × 51.1 |

---

## ชั้น 1 — ฐาน แบต ขับเคลื่อน

| อุปกรณ์ | จำนวน | ขนาด | ที่มา |
|---|:-:|---|:-:|
| รางถ่าน BH-18650x2-M (ใส่ถ่านแล้ว) | 1 | 76 × 41 × 20 | ด |
| TT Motor Encoder 1:90 | 2 | 70 × 22 × 18 + encoder ท้าย ~10 | ด |
| LM2596 | 1 | 43 × 21 × 14 | ด |
| IR HW-201 / TCRT5000 (หันลงพื้น) | 2 | 32 × 14 × 7 | ด |
| BMS 2S 16A (ถ้าย้ายลงมาตามข้อ 6.3 ของ `ปัญหาฮาร์ดแวร์`) | 1 | ~47 × 23 × 3 | ด |
| คาปาซิเตอร์ราง Motor 470µF | 1 | Ø8 × 12 | ด |

## ชั้น 2 — ไฟ ชาร์จ จุดรวมสาย

| อุปกรณ์ | จำนวน | ขนาด | ที่มา |
|---|:-:|---|:-:|
| BMS 2S 16A (ตำแหน่งตาม STL เดิม) | 1 | ~47 × 23 × 3 | ด |
| TB6612FNG | 1 | 20 × 20 × 3 (+ขา header) | ด |
| CM620 ชาร์จ 2S USB-C (พอร์ตต้องโผล่นอกตัว) | 1 | ~30 × 17 × 5 | ด |
| WAGO 221-415 (5 ช่อง) | 4 | ~30 × 20 × 9 ต่อก้อน | ส |
| ฟิวส์ + ฐานฟิวส์ | 1 | เอกสารเผื่อ 35 × 15 × 15 | ด |
| XT30 คู่ (ตัวผู้+ตัวเมียเสียบกัน) | 1 | — | **วัด** |
| สวิตช์ KCD-105 (ฝังผนัง) | 1 | Ø23 × 25 | ด |
| UBEC 5V สำหรับเซอร์โว (มีหรือยัง?) | 1 | — | **วัด** |
| XH-M401 (ตัวชั่วคราว ถ้ายังใช้) | 1 | ~61 × 41 × 27 + เว้นรอบฮีตซิงก์ 8–10 | ด |
| **ADS1115 (ใหม่ — สำหรับวัดแบตขึ้นจอ ยังไม่ได้ซื้อ)** | 1 | ~28 × 17 × 3 | ส |

## ชั้น 3 — สมอง

| อุปกรณ์ | จำนวน | ขนาด | ที่มา |
|---|:-:|---|:-:|
| ESP32 DevKit V1 38 ขา | 1 | 55 × 28 × 12 (ไม่รวมขาพิน) | ด |
| บอร์ดขยาย ESP32 38 ขา (ใต้ ESP32) | 1 | — | **วัด** |
| PCA9685 (ตาม STL เดิม / หรือขึ้นชั้น 4) | 1 | 62.5 × 25.4 × 15 (รวม header) | ด |
| คาปาซิเตอร์ราง Logic 100–470µF | 1 | Ø6–8 × 10–15 | ด |
| ความสูงรวมหัว Dupont + รัศมีดัดสาย | — | เอกสารเผื่อ 28–35 | ด |

## ชั้น 4 — แขน คอ

| อุปกรณ์ | จำนวน | ขนาด | ที่มา |
|---|:-:|---|:-:|
| MG996R ต้นแขน | 2 | 40.7 × 19.7 × 42.9 (ตัวสูงสุด) | ด |
| MG90S ข้อแขน | 2 | 22.8 × 12.2 × 28.5 | ด |
| SG90 หันหน้า | 1 | 22.5 × 12 × 22.7 | ด |
| VL53L0X (หันหน้า ระดับแขน ของต้องห่าง ≥50) | 1 | 13 × 18 × 2 | ด |
| คาปาซิเตอร์ราง Servo 1000–2200µF | 1 | Ø10–13 × 20–25 | ด |
| ระยะกวาดแขน | — | — | **วัดจากกลไกจริง** |

## ชั้น 5 — หัว

| อุปกรณ์ | จำนวน | ขนาด | ที่มา |
|---|:-:|---|:-:|
| จอ TFT 2.8" ST7789 | 1 | 50 × 69 × 3 (PCB) | ด |
| XIAO ESP32S3 Sense + กล้อง | 1 | ~21 × 18 × 15 | ส |
| SG90 ก้มเงย (ฐานหัว) | 1 | 22.5 × 12 × 22.7 | ด |
| MPR121 + แผ่นทองแดง (ถ้ายังทำ) | 1 | 28 × 20 × 3 | ด |

---

## เอกสารเดิมขัดกันเอง

**เจ้าของตัดสิน 1 พ.ย.: "ตามแบบ STL เดิม"** (PCA9685 ชั้น 3, BMS ชั้น 2) · และ "เปลี่ยนเป็นล้อ 2 ข้างกับลูกล้ออิสระตามแผน" — ขนาดชั้น 1 จะเปลี่ยนจาก 130 × 148 (ฐานสายพาน) รอผลค้นลูกล้อจากใบ 01

| เรื่อง | ตามแบบ STL เดิม (`ปัญหาฮาร์ดแวร์` 6.1, `แผนปรับโครง`) | ตาม `ผังจัดชั้นตัวเต็ม` / handoff |
|---|---|---|
| PCA9685 | ชั้น 3 คู่ ESP32 | ชั้น 4 ใกล้เซอร์โว |
| BMS | ชั้น 2 | ชั้น 1 ข้างรางถ่าน (ข้อ 6.3 แนะนำย้าย) |
| ภาคไฟ (WAGO, XT30, ฟิวส์, UBEC) | ไม่มีใน STL เดิม — เพิ่มหลัง 6 ก.ย. | ชั้น 2 |

## ไอเดียการยึดของเจ้าของ (1 พ.ย.)

- ยึดอุปกรณ์ในชั้น: "ฉํนเน้นวางฮาดแวเข้าไป ไม่แน่นไขฮารดแวติดกับของ … ตัวยึกแบบไม่ใช้ สกรูหรือนอต" · ชั้นเซอร์โว "ทำความสูงชั้น พอดีกับขนาดเซอโว 996 … มันจะทำตัวลอคได้ไหมโดยไม่เพิ่มความสูงของชั้น"
  - หัวงานเสนอ: ครีบบีบกันหลวม + ขอเกี่ยว snap-fit ข้างผนัง (ขาวางแนวนอน หนา 1.2–1.6 mm, PETG ผนัง 4 เส้น) — **รอเจ้าของเลือก**
- ล็อกระหว่างชั้นปิ่นโต: "ใช้ชิ้นแบบสายลอคกระเป๋า แยกออกจากชั้นชัดเจนเพื่อเปลี่ยนได้" (แบบหัวเข็มขัดกระเป๋า side-release buckle เป็นชิ้นแยก พังแล้วพิมพ์เปลี่ยนเฉพาะชิ้น) — **ยังไม่ได้ออกแบบ**

## ของที่ต้องวัดจริงก่อนขึ้นกรอบ
1. XT30 คู่ที่เสียบกันแล้ว
2. ฐานฟิวส์ที่ใช้จริง
3. UBEC (ถ้ามี) หรือ XH-M401 ที่ใช้อยู่
4. บอร์ดขยาย ESP32 38 ขา (กว้าง ยาว สูงรวมหัวพิน)
5. WAGO 221-415 ของจริง 1 ก้อน
6. ตำแหน่งพอร์ต USB-C ของ CM620 และ USB ของ ESP32
