HoneyKung/metorobot/Robo/Part Robot/ตารางการเชื่อมต่อและบัดกรี_RoboMDT.md

> **ประกาศฉบับใช้งานวันศุกร์:** เนื้อหาด้านล่างเก็บไว้เป็นประวัติและห้ามใช้ต่อวงจรจริงในรอบนี้
>
> ให้ใช้ [แพลนบัดกรี_Phase1_Motor.md](./แพลนบัดกรี_Phase1_Motor.md) ซึ่งเป็นผัง **แบตเตอรี่ 2S + BMS + เบรดบอร์ดเป็นจุดเสียบถอดสาย** หากมีข้อความขัดกัน ให้ยึดไฟล์ดังกล่าว

# ตารางการเชื่อมต่อและบัดกรี RoboMDT

เอกสารนี้ใช้ประกอบสายภายในหุ่น โดยแยกจุดที่ต้องบัดกรี จุดที่ใช้ขั้วสกรู และจุดที่เสียบสาย Dupont ได้ ระบบสัมผัส เซนเซอร์ระยะ และ Encoder สามารถเว้นไว้แล้วเติมภายหลังได้

> **สถานะสำหรับอัปเดตวันศุกร์ที่ 28 สิงหาคม 2569:** ใช้ XH-M401 แทน UBEC เป็นการชั่วคราวและจ่ายไฟให้ราง Servo เท่านั้น ฟิวส์และ บั๊ก 5A ที่รับอินพุต 6.0–8.4V เป็นงานเพิ่มหลังวันศุกร์ ต้นแบบระยะนี้ต้องทดสอบภายใต้การดูแลและยังไม่ให้เด็กใช้งานเอง

> **ก่อนต่อจริง:** GPIO ในเอกสารนี้เป็นผังจัดขาที่เสนอสำหรับ ESP32 DevKit V1 แบบ 38 ขา ต้องตรวจให้ตรงกับโค้ดจอและโค้ดหุ่นก่อนจ่ายไฟ ขั้ว BMS และ CM620 ต้องยึดตัวอักษรบนบอร์ดจริง ห้ามเดาจากตำแหน่ง

## 1. ผังไฟหลัก

```text
แบตเตอรี่ 18650 สองก้อนแบบ 2S
        │
        ▼
      BMS 2S
        │ P+ / P-
        ▼
   KCD-105 สวิตช์หลัก
        │
        ▼
   จุดกระจายไฟหลังสวิตช์ BUS+/BUS-
        ├── TB6612 ขา VM/GND → มอเตอร์ล้อ (รับไฟ BUS 6.0–8.4V)
        ├── XH-M401 ตั้ง 5.0V
        │      └── PCA9685 ขา V+/GND → เซอร์โวเท่านั้น
        └── LM2596 ตั้ง 5.0V
               ├── ESP32 ขา VIN/5V
               ├── XIAO ESP32S3 Sense ขา 5V
               └── TFT ขา VIN เฉพาะรุ่นที่รองรับ 5V
```

- GND ของทุกบอร์ดต้องเชื่อมร่วมกัน
- ห้ามเชื่อมบวกจาก XH-M401 เข้ากับบวก 5V จาก LM2596
- ห้ามนำไฟมอเตอร์ผ่าน XH-M401 ในต้นแบบวันศุกร์
- ห้ามใช้ Dupont เป็นสายแบตเตอรี่ มอเตอร์ หรือไฟกำลังเซอร์โว

## 2. แบตเตอรี่ 2S และ BMS

ใช้สาย 18–20 AWG และหุ้มท่อหดทุกจุด

| จาก | ไป | วิธีเชื่อม |
|---|---|---|
| ลบก้อนที่ 1 | `B-` ของ BMS | บัดกรี |
| บวกก้อนที่ 1 | ลบก้อนที่ 2 | บัดกรีเป็นจุดอนุกรม |
| จุดอนุกรมกลาง | `B1/BM` ตามชื่อบน BMS | บัดกรี |
| บวกก้อนที่ 2 | `B+` ของ BMS | บัดกรี |
| `P+` ของ BMS | ขาเข้าของ KCD-105 | บัดกรี |
| `P-` ของ BMS | จุดกระจาย GND | บัดกรี |

ลำดับตรวจ:

1. ตรวจชื่อขาบน BMS จริง
2. ต่อ `B-` ต่อขากลาง และต่อ `B+` เป็นลำดับสุดท้าย
3. วัด `B-` ถึง `B+` ควรได้ประมาณ 6–8.4V
4. วัด `P-` ถึง `P+` ก่อนต่อบอร์ดอื่น
5. ห้ามใช้หัวแร้งจี้เซลล์เปล่าโดยตรง ให้ใช้รางแบตเตอรี่หรือเซลล์ที่มีแท็บ

## 3. KCD-105 และจุดกระจายไฟ

### สวิตช์สองขา

| ขา | ต่อไปยัง | วิธีเชื่อม |
|---|---|---|
| ขาเข้า | `P+` จาก BMS | บัดกรี |
| ขาออก | จุดกระจายไฟบวก | บัดกรี |

ถ้าเป็นสวิตช์สามขามีไฟ ให้ตรวจผังบนตัวจริงและใช้ `COM` กับ `NO` ก่อน ไม่เดาขาจากตำแหน่ง

ไฟบวกหลังสวิตช์แยกไป `VM` ของ TB6612, `IN+` ของ XH-M401 และ `IN+` ของ LM2596 ส่วน `P-` แยกไป GND/IN- ของทั้งสามกิ่ง ใช้เทอร์มินัลบล็อกหรือสายตัว Y ที่บัดกรีและหุ้มท่อหด

### งบกระแสรวมที่จุดกระจายไฟ

ตัวเลขชุดนี้เป็นตัวกำหนดขนาดสาย พิกัดสวิตช์ และค่าฟิวส์ อ้างอิงจากรูปแบบสั่งงานจริง คือ **กลุ่ม A (MG996R ×2 + MG90S ×2) ขยับพร้อมกัน ขณะมอเตอร์ล้อสองตัววิ่ง**

| กิ่ง | โหลด | กระแสที่ดึงจาก BUS |
|---|---|---:|
| ราง Servo ผ่าน XH-M401 | MG996R ×2 (1.2–2.0A) + MG90S ×2 (0.3–0.5A) + SG90 ×2 ค้างตำแหน่ง (0.2A) ที่ 5V ≈ 2.5A → แปลงกลับที่ 7.4V ประสิทธิภาพ ~85% | ~2.0A |
| มอเตอร์ล้อผ่าน TB6612 `VM` | มอเตอร์ 2 ตัวมีโหลด | ~1.0–2.0A |
| ราง Logic ผ่าน LM2596 | ESP32 + TFT + XIAO + ราง 3.3V | ~0.4A |
| **รวมต่อเนื่อง** | | **~3.4–4.4A** |

ช่วงกระชากตอนกลุ่ม A ออกตัวพร้อมกันจะสูงกว่านี้อีกชั่วครู่ ซึ่งเป็นหน้าที่ของคาปาซิเตอร์ ไม่ใช่ของบั๊ก

ผลที่ตามมา:

| รายการ | ข้อกำหนด |
|---|---|
| สายแกนหลัก `BMS P+ → สวิตช์ → จุดกระจายไฟ` | ใช้ **18AWG** ไม่ใช่ 20AWG เพราะ 20AWG อยู่ที่ราว 5A พอดีเกินไปสำหรับสายแกนหลัก |
| สายกิ่งแต่ละเส้น | 20AWG พอ เพราะแต่ละกิ่งไม่เกิน ~2A |
| แรงดันยุบใต้โหลด | 18650 มีความต้านทานภายในรวม 2S ราว 0.1–0.2Ω ที่ 4.4A จะยุบ **0.44–0.88V** — แบตเต็ม 8.4V จะเหลือ ~7.5–8.0V ที่ BUS ต้องเผื่อตัวเลขนี้ทุกครั้งที่คิดเรื่องบั๊ก |
| BMS 2S 16A | เหลือเฟือ ไม่ใช่คอขวด |
| KCD-105 | พิกัดบนตัวเป็นเรต AC การสวิตช์ DC ~4.4A ที่ 8.4V ยังอยู่ในวิสัยของสวิตช์โยกขนาดนี้ แต่บวกกับคาปาซิเตอร์รวมเกิน 3000µF จะมีกระแสกระชากตอนเปิด หน้าสัมผัสสึกเร็วกว่าปกติ ถ้าเริ่มเปิดติดๆ ดับๆ ให้เปลี่ยนสวิตช์ |

### สถานะฟิวส์ของต้นแบบวันศุกร์

- ระยะวันศุกร์ยังไม่ติดฟิวส์เพราะเป็นการอัปเดตความคืบหน้า ไม่ใช่ระบบพร้อมส่งให้เด็กใช้งาน
- ใช้งานเฉพาะภายใต้การดูแล ห้ามชาร์จขณะเปิดหุ่น และต้องเข้าถึงสวิตช์/แบตได้ทันที
- หลังวันศุกร์ให้เพิ่มฟิวส์ใกล้ BMS ที่สาย `BMS P+ → ฟิวส์ → สวิตช์`
- **ค่าที่ควรใช้: 7.5A หรือ 10A แบบ slow-blow** มาจากงบกระแสด้านบน (ต่อเนื่อง ~4.4A) คูณหัวเผื่อราว 1.5–2 เท่า ต้องเป็น slow-blow เพราะกระแสกระชากตอนเปิดสวิตช์และตอนกลุ่ม A ออกตัวจะทำให้ฟิวส์ fast-blow ขาดโดยไม่มีอะไรเสีย
- ยังต้องวัดกระแสจริงยืนยันก่อนติดตั้งอยู่ดี ตัวเลขนี้เป็นจุดตั้งต้นไม่ใช่ข้อสรุป

## 4. XH-M401: ราง Servo ชั่วคราว 5.0V

XH-M401 ใช้แทน UBEC ชั่วคราวสำหรับการอัปเดตวันศุกร์เท่านั้น ก่อนต่อโหลดให้ใช้มัลติมิเตอร์ปรับเอาต์พุตเป็น `5.0V`

> ⚠️ **XH-M401 บนแบต 2S อยู่นอกสเปกของชิป ถือเป็นของทดลอง**
>
> ชิป **XL4016** ระบุช่วงอินพุตในดาต้าชีตว่า **8V ถึง 40V** แต่แพ็ก 2S ของเราอยู่ที่ 6.0–8.4V แปลว่าเกือบทั้งช่วงการใช้งานอยู่ต่ำกว่าขั้นต่ำของชิป มีแค่ตอนชาร์จเต็มใหม่ๆ เท่านั้นที่ถึง 8V
>
> ผลจริงคือมักจะทำงานได้ แต่ไม่มีการรับประกันว่าจะรักษา 5V ไว้ได้ โดยเฉพาะจังหวะที่เซอร์โวกินกระแสกระชาก
>
> | BUS | สถานะ |
> |---|---|
> | 8.4V ชาร์จเต็ม | อยู่ในสเปก ใช้ได้ |
> | 8.0V | ขอบล่างของสเปกพอดี |
> | 7.4V | **นอกสเปกแล้ว** มักยังทำงานได้แต่ไม่รับประกัน |
> | ต่ำกว่า 7.0V | หยุดใช้งาน ชาร์จทันที |
>
> **เงื่อนไขใช้งานวันศุกร์:** ชาร์จเต็มใกล้ 8.4V ก่อนสาธิตทุกครั้ง, วัดเอาต์พุต**ขณะเซอร์โวเคลื่อนจริง**ไม่ใช่ตอนอยู่เฉยๆ, เลี่ยงการยกของหนัก (กลุ่ม A ขยับพร้อมกันได้ตามออกแบบ), หยุดทันทีถ้ารางต่ำกว่า 4.8V หรือ ESP32 รีบูต
>
> **นี่คือเหตุผลที่ บั๊ก 5A ที่รับอินพุต 6.0–8.4V เป็นของที่ต้องหามาเปลี่ยนจริง ไม่ใช่แค่ของอัปเกรด** ไม่จำเป็นต้องเป็น UBEC — บั๊กตัวไหนก็ได้ที่รับอินพุตต่ำถึง ~5V และจ่ายได้ ≥3A เช่น XL4005 5A ราคา ~60–90฿ ดูตารางตัวเลือกใน [แพลนบัดกรี_Phase1_Motor.md](./แพลนบัดกรี_Phase1_Motor.md) หัวข้อ 12

| XH-M401 | ปลายทาง | สาย/วิธีเชื่อม |
|---|---|---|
| `IN+` | ไฟบวกหลังสวิตช์ | 18–20 AWG ขันสกรู/บัดกรี |
| `IN-` | GND จาก BMS | 18–20 AWG ขันสกรู/บัดกรี |

| `OUT+` | `V+` ที่ขั้วสกรู PCA9685 | 20 AWG |
| `OUT-` | `GND` ที่ขั้วสกรู PCA9685 | 20 AWG |

ห้ามต่อ TB6612 หรือมอเตอร์กับเอาต์พุต XH-M401 รางนี้สงวนให้ Servo เท่านั้น

คาปาซิเตอร์:

- ใกล้ PCA9685 ใช้ `1000–2200µF 16V`: บวกไป `V+`, ลบไป `GND`
- ใกล้ TB6612 ใช้ `470–1000µF 16V`: บวกไป `VM` จาก BUS, ลบไป `GND`
- ใกล้ ESP32 ที่ราง Logic ใช้ `100–470µF 16V`: บวกไป `5V`, ลบไป `GND`
- ห้ามต่อคาปาซิเตอร์กลับขั้ว

หมายเหตุ: คาปาซิเตอร์หลายตัวอาจทำให้มีกระแสกระชากช่วงสั้นตอนเปิดสวิตช์ แต่ไม่ควรฟันธงว่าต้องเกิดประกายหรือถือว่าประกายไฟเป็นอาการปกติ หากเห็นประกายซ้ำ มีความร้อน กลิ่นไหม้ หรือหน้าสัมผัสผิดปกติ ให้หยุดใช้งานทันที โดยเฉพาะต้นแบบระยะนี้ที่ยังไม่มีฟิวส์

## 5. LM2596: รางควบคุม 5V

ก่อนต่อบอร์ด ให้ปรับเอาต์พุตเป็น `5.00V`

| LM2596 | ปลายทาง | วิธีเชื่อม |
|---|---|---|
| `IN+` | ไฟบวกหลังสวิตช์ | ขันสกรู/บัดกรี |
| `IN-` | GND จาก BMS | ขันสกรู/บัดกรี |
| `OUT+` | ESP32 `VIN/5V` | ฝั่ง LM บัดกรี/ขันสกรู; ฝั่ง ESP32 เสียบพินได้ |
| `OUT-` | ESP32 `GND` | เช่นเดียวกัน |
| `OUT+` | XIAO `5V` | เสียบหัวพินที่ยึดแน่น |
| `OUT-` | XIAO `GND` | เสียบหัวพิน |
| `OUT+` | TFT `VIN/5V` เฉพาะรุ่นที่รองรับ | เสียบหัวพิน |
| `OUT-` | TFT `GND` | เสียบหัวพิน |

ห้ามต่อ 5V เข้าขา `3V3` และห้ามใช้ LM2596 จ่ายไฟมอเตอร์หรือ MG996R

## 6. TB6612 และมอเตอร์ล้อ

### ขากำลัง

| TB6612 | ต่อกับ | วิธีเชื่อม |
|---|---|---|
| `VM` | BUS+ หลังสวิตช์ 6.0–8.4V | 20 AWG บัดกรี/ขั้วสกรู |
| `VCC` | ESP32 `3V3` | Dupont |
| `GND` | GND ร่วม | กำลังใช้ 20 AWG; สัญญาณใช้ Dupont |
| `AO1/AO2` | มอเตอร์ล้อซ้าย | 20–22 AWG บัดกรี |
| `BO1/BO2` | มอเตอร์ล้อขวา | 20–22 AWG บัดกรี |

ใส่คาปาซิเตอร์เซรามิก `0.1µF` คร่อมขั้วมอเตอร์แต่ละตัวได้ หากล้อกลับทิศให้สลับสายมอเตอร์คู่นั้น

### ขาควบคุมที่เสนอ

| TB6612 | ESP32 | วิธีเชื่อม |
|---|---:|---|
| `PWMA` | GPIO25 | Dupont |
| `AIN1` | GPIO26 | Dupont |
| `AIN2` | GPIO27 | Dupont |
| `PWMB` | GPIO32 | Dupont |
| `BIN1` | GPIO33 | Dupont |
| `BIN2` | GPIO14 | Dupont |
| `STBY` | ESP32 `3V3` | ผูก HIGH ถาวร ไม่ใช้ GPIO — ถูกต้องแล้ว |

ต้องตรวจหรือแก้ค่าขาในโค้ดให้ตรงก่อนเปิดมอเตอร์ เริ่ม PWM ต่ำและจำกัดไม่เกินประมาณ 180/255 ตอนแบตเต็มจนกว่าจะทดสอบมอเตอร์จริง

### สถานะมอเตอร์ตอนบูต — ปลอดภัยอยู่แล้ว

TB6612FNG มี **ตัวต้านทาน pull-down ภายในตัวชิป 200kΩ** อยู่แล้วที่ขา `AIN1`, `AIN2`, `BIN1`, `BIN2`, `PWMA`, `PWMB` และ `STBY` ตาม datasheet ของ Toshiba

ดังนั้นช่วงที่ ESP32 กำลังบูตและขา GPIO ยังลอยเป็น input อยู่ ขาอินพุตของ TB6612 จะถูกดึงลง LOW เอง ตาม truth table เมื่อ `IN1 = L` และ `IN2 = L` มอเตอร์หยุด และเมื่อ `PWM = L` ก็หยุดเช่นกัน ตอนบูตทั้งสามเงื่อนไขเป็น LOW พร้อมกัน มอเตอร์จึงนิ่ง

แม้ `GPIO14` จะมีสัญญาณกระตุกตอนรีเซ็ตเพราะเป็นขากลุ่ม JTAG/SD ก็ยังไม่ทำให้มอเตอร์หมุน เพราะ `BIN2` กระตุกขึ้นเดี่ยวๆ ขณะที่ `BIN1` และ `PWMB` ยังเป็น LOW

### ตัวต้านทาน 10kΩ 4 ตัว — ของเสริม ไม่บังคับ

จะใส่ `10kΩ` ลง GND ที่ `AIN1/AIN2/BIN1/BIN2` ก็ได้ ประโยชน์คือแรงดึงลงแรงกว่าเดิม 20 เท่า ทนสัญญาณรบกวนจากมอเตอร์ดีขึ้น แต่ไม่ใช่เงื่อนไขที่ขาดไม่ได้ และถ้า ESP32 ขับขาแบบ push-pull ออกมาจริง 10kΩ ก็หยุดไม่ได้อยู่ดี

**วิธีเช็คว่าต้องใส่ไหม:** ยกล้อพ้นพื้น เปิดสวิตช์ ดูล้อ นิ่งสนิท = ไม่ต้องใส่ กระตุกหรือหมุน = ใส่แล้วทดสอบซ้ำ

## 7. Encoder มอเตอร์ — เติมภายหลังได้

| Encoder | ESP32 |
|---|---:|
| VCC ซ้าย/ขวา | 3V3 |
| GND ซ้าย/ขวา | GND |
| ซ้าย A | GPIO34 |
| ซ้าย B | GPIO35 |
| ขวา A | GPIO36/VP |
| ขวา B | GPIO39/VN |

ทั้งหมดเสียบ Dupont ได้ GPIO34–39 ไม่มี pull-up ภายใน หากโมดูลไม่มี pull-up ให้เพิ่ม `4.7–10kΩ` จากสัญญาณไป 3.3V

## 8. PCA9685 และเซอร์โว

| PCA9685 | ปลายทาง | วิธีเชื่อม |
|---|---|---|
| `VCC` | ESP32 `3V3` | Dupont |
| `GND` ลอจิก | ESP32 GND | Dupont |
| `SDA` | GPIO21 | Dupont |
| `SCL` | GPIO22 | Dupont |
| `V+` ขั้วสกรู | 5.0V จาก XH-M401 ชั่วคราว | 20 AWG |
| `GND` ขั้วสกรู | GND จาก XH-M401 | 20 AWG |
| `OE` | **ต่อลง GND ห้ามปล่อยลอย** | Dupont |

`VCC` คือไฟลอจิก ส่วน `V+` คือไฟเซอร์โว ห้ามสลับกัน

`OE` เป็นขา active-low ถ้าปล่อยลอยแล้วมันลอยขึ้นสูง เอาต์พุตทั้ง 16 ช่องจะถูกปิด = เซอร์โวไม่ขยับเลยทั้งตัว แล้วจะไล่หาสาเหตุยากมากตอนหน้างาน ต่อลง GND ไปเลยชัดเจนกว่า

ตอนเปิดเครื่อง PCA9685 ยังอยู่ในโหมด sleep และเอาต์พุตทุกช่องเป็น LOW อยู่แล้ว จึงไม่มีพัลส์ออกไปหาเซอร์โว **ช่วยลดโอกาสที่เซอร์โวจะกระตุก แต่ไม่ได้การันตี** เพราะตัวเซอร์โวเองก็อาจขยับตอนได้รับไฟครั้งแรกจากวงจรภายในของมันเอง ให้ถือว่าเซอร์โวอาจกระตุกตอนเปิดเสมอ

| ช่อง PCA9685 | เซอร์โว |
|---:|---|
| CH0 | MG996R แขนซ้ายข้อโคน |
| CH1 | MG90S แขนซ้ายข้อไหล่ |
| CH2 | MG996R แขนขวาข้อโคน |
| CH3 | MG90S แขนขวาข้อไหล่ |
| CH4 | SG90 คอหันซ้าย–ขวา |
| CH5 | SG90 ฐานหัวก้ม–เงย |
| CH6–CH15 | สำรอง |

> ⚠️ **ช่องชุดนี้ถูกสลับใหม่ทั้ง 6 ช่อง** จากที่เคยเขียนไว้ในไฟล์เก่า ค่ามุมที่คาลิเบรตไว้ใน `รายชื่ออุปกรณ์หุ่นยนต์_RoboMDT.md` ผูกกับเลขช่องชุดเก่า
>
> **ห้ามคัดลอกค่ามุมตามเลขช่อง** ค่ามุมต้องเดินตามตัวเซอร์โว ไม่งั้นจะกลายเป็นเอาลิมิตของ MG90S ไปใส่ MG996R แล้วแขนจะดันจนกลไกเสียหาย ดูตารางแปลงในไฟล์นั้น

สายเซอร์โวทั่วไป: น้ำตาล/ดำ = GND, แดง = V+, ส้ม/เหลือง/ขาว = Signal แต่ให้ตรวจ `GND/V+/SIG` บน PCA9685 ก่อนเสียบ หากต่อสาย MG996R เพิ่ม ต้องบัดกรีและหุ้มท่อหด ไม่ใช้ Dupont เส้นเล็ก

## 9. TFT 2.8 นิ้วแบบ SPI

| TFT | ESP32 | วิธีเชื่อม |
|---|---:|---|
| `VCC/VIN` | ดูตารางตัดสินข้างล่าง | Dupont |
| `GND` | GND | Dupont |
| `SCK/CLK` | GPIO18 | Dupont |
| `MOSI/SDI` | GPIO23 | Dupont |
| `MISO/SDO` | **ไม่ต่อ** ตั้ง `MISO = -1` ใน TFT_eSPI | — |
| `CS` | GPIO5 | Dupont |
| `DC/RS` | GPIO2 | Dupont |
| `RST` | GPIO4 | Dupont |
| `LED/BL` | 3.3V ถ้าบอร์ดมี R จำกัดกระแสมาแล้ว ถ้าไม่มีให้ใส่ `100Ω` อนุกรม | Dupont |

### ไม่ต้องต่อ SDO/MISO

จอที่ใช้จริงตั้งเป็น **ST7789 240×320** ใน TFT_eSPI และโค้ดใช้ `setRotation(1)` เป็นแนวนอน 320×240 บอร์ดมีขาเรียงว่า `VCC GND CS RESET DC SDI SCK LED SDO | T_CLK T_CS T_DIN T_DO T_IRQ`

ระบบรอบนี้ใช้เฉพาะการแสดงผลแบบเขียนออกและยังไม่ใช้ touch จึงไม่ต้องอ่านข้อมูลกลับทาง `SDO/MISO` ให้ตั้ง `MISO = -1` และไม่ต่อสายนี้ เอกสารไม่อ้างแรงดันหรือพฤติกรรม high-Z ของ SDO จนกว่าจะวัดบอร์ดจริง

ตั้ง `MISO = -1` ใน TFT_eSPI แล้วไม่ต้องเสียบสายเส้นนี้ ได้ GPIO19 คืนเป็นขาสำรองด้วย

### ขา VCC ต้องตัดสินจากบอร์ดจริงก่อนจ่ายไฟ

บอร์ดแดงรุ่นนี้ไม่มี level shifter ขาสัญญาณจึงเป็น 3.3V ตรงกับ ESP32 พอดีอยู่แล้ว เหลือแค่ตัดสินขา `VCC`

**วิธีที่ไม่ต้องเดา:**

1. จ่าย **3.3V** ก่อนเสมอ ถ้าภาพขึ้นปกติ จบ ใช้ 3.3V ไปเลย ความเสี่ยงเป็นศูนย์
2. ถ้าไม่ติดหรือภาพซีด ค่อยมองหาเรกูเลเตอร์ตัวเล็ก 3 ขาแบบ SOT-23 ใกล้ขา VCC มักพิมพ์ว่า `662K` ถ้าเจอแปลว่าบอร์ดรับ 5V ได้ ค่อยเปลี่ยนเป็น 5V

ห้ามเริ่มที่ 5V เพราะถ้าบอร์ดไม่มีเรกูเลเตอร์คือพังทันที

### ขา LED/BL

ถ้าไม่ต่อขานี้ จอจะมืดสนิทจนดูเหมือนจอเสีย ทั้งที่ SPI ทำงานปกติ เป็นอาการที่หลงกันบ่อยมากตอนหน้างาน

### ถ้าแฟลชผ่าน USB ไม่เข้า

`GPIO2` ที่ต่อกับ `DC` เป็นขา strapping ที่ต้องเป็น LOW ตอนเข้าโหมดดาวน์โหลด ถ้าบอร์ดจอมี pull-up บนขา DC จะดันให้ GPIO2 สูงจนแฟลชไม่ได้ ให้ถอดสาย DC ออกก่อนแล้วแฟลชใหม่

### Touch XPT2046

ถ้ามี: `T_CLK=18`, `T_DIN=23`, `T_DO=19`, `T_CS=15`; เว้น `T_IRQ` ไว้ก่อน ช่อง SD ยังไม่ต้องต่อ

หมายเหตุ: `T_DO` คือ MISO ของตัว touch ซึ่งเป็นคนละเส้นกับ MISO ของจอ ตัว XPT2046 ทำงานที่ 3.3V จึงต่อ GPIO19 ได้ปลอดภัย แต่ถ้าจะใช้ touch ต้องไม่ใช้ GPIO19 เป็นขาสำรองที่ได้คืนมาจากการตัด MISO ของจอ และ `T_CS=15` จะทำให้ GPIO15 ไม่ว่างอีกต่อไป วันศุกร์ยังไม่ใช้ touch

## 10. VL53L0X — เติมภายหลังได้

| VL53L0X | ESP32 |
|---|---:|
| `VIN` | 3V3 |
| `GND` | GND |
| `SDA` | GPIO21 |
| `SCL` | GPIO22 |
| `XSHUT/GPIO1` | เว้นไว้ก่อน |

ทั้งหมดเสียบ Dupont ได้ การต่อไฟอย่างเดียวยังไม่ยืนยันการตรวจยก–วาง ต้องทดสอบตำแหน่งและระยะภายหลัง

## 11. MPR121 Touch — เติมภายหลังได้

| MPR121 | ESP32 |
|---|---:|
| `VIN/VCC` | 3V3 |
| `GND` | GND |
| `SDA` | GPIO21 |
| `SCL` | GPIO22 |
| `IRQ` | เว้นไว้ก่อน |
| `ADDR` | ไม่ต่อ เพื่อใช้ `0x5A` |

E0–E11 ต่อไปแผ่นสัมผัส ถ้าตรวจการลูบให้เรียง E0–E3 ตามแนวลูบ จุดต่อแผ่นทองแดงควรบัดกรีหรือใช้เทปทองแดงกาวนำไฟฟ้า

## 12. TCRT5000 สองตัว — เติมภายหลังได้

| TCRT5000 | ESP32 |
|---|---:|
| VCC ทั้งสองตัว | 3V3 |
| GND ทั้งสองตัว | GND |
| DO ซ้าย | GPIO13 |
| DO ขวา | GPIO17 |
| AO | เว้นไว้ |

GPIO13 ว่างหลังผูก TB6612 `STBY` กับ 3.3V และ GPIO17 ว่างหลังลด UART กล้องเหลือการส่งข้อมูลทางเดียว

VCC ต้องเป็น 3.3V ไม่ใช่ 5V เพราะขา DO ส่งระดับแรงดันเท่ากับ VCC ถ้าเลี้ยง 5V ขา DO จะเป็น 5V แล้วเกินพิกัดของ GPIO

> ⚠️ **GPIO17 คือขา TX2 ค่าเริ่มต้นของ ESP32** ถ้าเฟิร์มแวร์เรียก `Serial2.begin(9600)` แบบไม่ระบุขา ESP32 จะยึด GPIO16 กับ GPIO17 เป็น RX2/TX2 ทันที แล้ว GPIO17 จะกลายเป็นขา output ของ UART ไปดันกับขา DO ของ LM393 บนบอร์ด TCRT5000
>
> **ต้องเขียนแบบนี้:** `Serial2.begin(9600, SERIAL_8N1, 16, -1);`
>
> **ทำไม `-1` ถึงได้ผล:** ในไลบรารี arduino-esp32 การเติมขาเริ่มต้นเกิดขึ้นเฉพาะเมื่อ **ทั้ง rxPin และ txPin ติดลบพร้อมกัน** เท่านั้น (`if (rxPin < 0 && txPin < 0)`) พอใส่ `16` ให้ RX เงื่อนไขเป็นเท็จ ไลบรารีไม่เติมค่า TX2 ให้ แล้วส่ง `-1` ต่อไปที่ไดรเวอร์ซึ่งแปลว่า "ไม่ต้องแตะขานี้" สัญญาณ TX ของ UART2 จึงไม่เคยถูกโยงเข้า GPIO17
>
> ⚠️ **เงื่อนไขเดียวที่ยังพลาดได้:** ห้ามมี `Serial2.begin(...)` แบบไม่ระบุขาอยู่ที่ไหนในสเกตช์เลย เพราะถ้าเคยเรียกแบบนั้นมาก่อน GPIO17 จะถูกจองไปแล้ว และการเรียกครั้งหลังด้วย `-1` แปลว่า "ไม่ต้องแตะ" ก็คือปล่อยให้ติดค้างอยู่อย่างนั้น ค้นทั้งโปรเจกต์ว่ามี `Serial2.begin` กี่ที่ ต้องระบุขาทุกที่

## 13. XIAO ESP32S3 Sense

| XIAO | ปลายทาง | วิธีเชื่อม |
|---|---|---|
| `5V` | 5V จาก LM2596 | หัวพินที่ยึดแน่น |
| `GND` | GND ร่วม | Dupont |
| `3V3` | ห้ามต่อกับ 5V | — |

UART สำหรับระบบจริงใช้ทางเดียวตามหน้าที่ของกล้อง:

| จาก | ไป |
|---|---|
| XIAO `TX` = ขา `D6` / `GPIO43` | ESP32 GPIO16 `RX2` |
| XIAO `GND` | ESP32 GND |

ไม่ต้องต่อ ESP32 TX กลับไป XIAO ในระยะนี้ และต้องตั้ง Serial2 ในเฟิร์มแวร์ใหม่เป็น `Serial2.begin(9600, SERIAL_8N1, 16, -1)` โดย `-1` คือการสั่งไม่ให้ใช้ขา TX เพื่อไม่ให้ไปชนกับ TCRT5000 ที่ GPIO17

ฝั่งเฟิร์มแวร์ของ XIAO ต้องพิมพ์ข้อมูลลง `Serial1` ไม่ใช่ `Serial` เพราะ `Serial` ของ XIAO ESP32S3 คือ USB CDC ซึ่งออกทางพอร์ต USB ไม่ได้ออกทางขา D6 ถ้าเขียนผิดตัวนี้ สายต่อถูกทุกเส้นแต่จะไม่มีข้อมูลออกมาเลย

## 14. CM620 และช่องชาร์จ

- ถ้า BMS ใช้พอร์ตเดียว ให้ชาร์จผ่าน `P+` และ `P-`
- ถ้า BMS แยกพอร์ต ให้ใช้ `C-` ตามผังบนบอร์ด
- ห้ามต่อเครื่องชาร์จข้าม BMS ไปหาเซลล์โดยตรง
- เครื่องชาร์จ 2S ต้องมีแรงดันปลายทาง 8.4V
- ห้ามชาร์จผ่านเอาต์พุต LM2596 หรือ XH-M401
- ต้องดูภาพด้านหน้าและด้านหลังของ CM620/BMS ที่เห็นชื่อขาก่อนระบุจุดบัดกรีจริง

## 15. สรุปว่าจุดใดต้องบัดกรี

ต้องบัดกรีหรือใช้ขั้วสกรูที่แน่น:

- แบตเตอรี่, BMS, KCD-105 และจุดกระจายไฟ
- สายเข้า–ออก XH-M401 และ LM2596
- `VM/GND` ของ TB6612 และสายมอเตอร์
- `V+/GND` กำลังของ PCA9685
- คาปาซิเตอร์และช่องชาร์จ
- สายต่อเพิ่มของ MG996R

เสียบ Dupont ได้:

- สายควบคุม ESP32 ↔ TB6612
- `VCC/GND/SDA/SCL` ของ PCA9685
- TFT, VL53L0X, MPR121, TCRT5000 และ Encoder
- UART ระหว่าง ESP32 กับ XIAO
- หัวเซอร์โวเสียบ PCA9685 โดยตรง

## 16. ลำดับเปิดระบบครั้งแรก

### ⛔ ข้อ 0 — ห้ามจ่ายไฟด้วยเฟิร์มแวร์เก่าเด็ดขาด

สายชุดนี้เป็น pin map ใหม่ ถ้าเปิดเครื่องด้วยโค้ดเดิมจาก `Robo/Robo.ino`:

| ขา | โค้ดเก่าใช้เป็น | สายใหม่ต่ออะไร | ผลที่เกิด |
|---|---|---|---|
| GPIO25/26/27/32/33 | สัญญาณ Servo | ขาสั่ง TB6612 | **มอเตอร์วิ่งมั่วทันทีที่เปิด** |
| GPIO13 | `BIN1` เป็น output | ขา DO ของ TCRT5000 | ขา output สองตัวดันกัน |
| GPIO21/22 | `AIN1` และ `PWMA` | I2C ไป PCA9685 | I2C ใช้ไม่ได้ |

ชุดที่ต้องแก้ในเฟิร์มแวร์ก่อนเสียบไฟครั้งแรก:

```
Motor    PWMA=25  AIN1=26  AIN2=27  PWMB=32  BIN1=33  BIN2=14
I2C      Wire.begin(21, 22)              PCA9685 @ 0x40  ใช้ CH0-CH5
TFT      SCLK=18  MOSI=23  MISO=-1  CS=5  DC=2  RST=4
UART     Serial2.begin(9600, SERIAL_8N1, 16, -1)
TCRT     pinMode(13, INPUT);  pinMode(17, INPUT)
Encoder  34 / 35 / 36 / 39 เป็น INPUT   (ไม่มี pull-up ภายใน)
```

### ลำดับปกติ

1. ถอดบอร์ด โหลด มอเตอร์ และเซอร์โวออกก่อน
2. ตรวจ BMS และวัด `P+/P-`
3. ตั้ง LM2596 เป็น 5.00V และ XH-M401 เป็น 5.0V ถ้าบอร์ด XH-M401 มีสองโวลุ่ม ให้อ่านตัวอักษรบนบอร์ดก่อนว่าตัวไหน CV ตัวไหน CC ห้ามเดาและห้ามหมุนสุด เพราะเท่ากับปิดการป้องกันกระแสเกินทิ้ง
4. ปิดไฟ แล้วต่อ ESP32 อย่างเดียว
5. ต่อและทดสอบ TFT
6. ต่อ TB6612 โดยยังไม่ต่อมอเตอร์ ตรวจ `VM = แรงดัน BUS 6.0–8.4V`, `VCC ≈ 3.3V`
7. ต่อมอเตอร์ทีละตัวโดยยกล้อให้ลอยจากพื้น
8. ต่อ PCA9685 โดยยังไม่เสียบเซอร์โว ตรวจ `VCC ≈ 3.3V`, `V+ = 5.0V`
9. สั่งเซอร์โวไปกึ่งกลางก่อนติดกลไก
10. ต่อ SG90/MG90S ทีละตัว
11. ต่อ MG996R ทีละตัว ตรวจทิศและขอบเขตมุมก่อนประกอบแขน
12. **ทดสอบกลุ่ม A พร้อมกัน** — ดูหัวข้อถัดไป ข้อนี้ห้ามข้าม
13. เพิ่ม XIAO และเซนเซอร์หลังระบบหลักผ่านการทดสอบ

ปิดสวิตช์ทุกครั้งก่อนเสียบหรือถอดมอเตอร์และเซอร์โว

### ข้อ 12 — ทดสอบกลุ่ม A ซึ่งเป็นโหลดจริงสูงสุด

ขั้นตอน 1–11 ทดสอบทีละตัวเพื่อยืนยันทิศทางและมุม แต่ **ไม่เคยสร้างโหลดจริง** รูปแบบใช้งานคือหลายตัวพร้อมกัน ถ้าไม่ทดสอบข้อนี้จะไปเจอปัญหาเอาหน้างาน

| กลุ่ม | เซอร์โว | สั่งพร้อมกัน |
|---|---|---|
| **A** | MG996R ×2 (CH0, CH2) + MG90S ×2 (CH1, CH3) | ✅ พร้อมกันได้ และวิ่งพร้อมมอเตอร์ล้อได้ |
| **B** | SG90 คอ/หัว (CH4, CH5) | แยกจังหวะจากกลุ่ม A |

**วิธีทดสอบ:** ยกล้อพ้นพื้น สั่งกลุ่ม A ขยับสุดช่วงกลับไปกลับมา พร้อมสั่งมอเตอร์ล้อหมุนไปด้วย ระหว่างนั้นวัดสองจุดพร้อมกัน

| จุดวัด | เกณฑ์ผ่าน |
|---|---|
| ราง Servo (`V+` ที่ PCA9685) | ไม่ต่ำกว่า **4.8V** |
| `BUS` ที่จุดกระจายไฟ | ไม่ต่ำกว่า **7.0V** |
| ESP32 | ไม่รีบูต (Serial ไม่ขึ้น boot log ใหม่) |

การวัดสองจุดพร้อมกันสำคัญ เพราะบอกได้ว่าตัวไหนเป็นคอขวด ถ้า `BUS` ยังสูงแต่ราง Servo ตก แปลว่าบั๊กเอาไม่อยู่ ถ้า `BUS` ตกตามไปด้วย แปลว่าแบตหรือสายเป็นคอขวด

หยุดทันทีเมื่อ Servo สั่น ครางค้าง สายหรือบอร์ดร้อนผิดปกติ หรือมีกลิ่นไหม้

## 17. ขอบเขตการอัปเดตวันศุกร์

| ส่วน | ต่อในวันศุกร์ | สถานะ |
|---|---|---|
| แบต 2S + BMS + สวิตช์ | ต่อ | ระบบไฟต้นแบบ ยังไม่มีฟิวส์ |
| LM2596 → ESP32/TFT/XIAO | ต่อ | ราง Logic 5V |
| XH-M401 → PCA9685/Servo | ต่อ | ตัวแทน UBEC ชั่วคราว 5.0V |
| BUS → TB6612 → Motor | ต่อ | ทดสอบ PWM ต่ำและยกล้อพ้นพื้นก่อน |
| PCA9685 → Servo 6 ช่อง | ต่อทีละตัวก่อน แล้วทดสอบกลุ่ม A พร้อมกัน | โหลดเบา ไม่ยกขวดเต็ม — กลุ่ม A คือโหลดจริงสูงสุด ต้องวัดแรงดันตอนนั้น |
| TFT | ต่อ | ต้องใช้ pin map/ค่าไลบรารีชุดใหม่ให้ตรงกัน |
| XIAO → ESP32 | ต่อทางเดียว | XIAO TX → ESP32 GPIO16 RX2 |
| TCRT5000 | ต่อได้ | GPIO13 และ GPIO17 |
| Encoder | เติมได้ถ้ามีเวลา | GPIO34/35/36/39 และตรวจ pull-up จากบอร์ดจริง |
| VL53L0X/MPR121 | ยังไม่จำเป็น | เติมภายหลังบน I2C GPIO21/22 |
| ฟิวส์ + บั๊ก 5A ที่รับอินพุต 6.0–8.4V | ยังไม่ติด | งานปรับปรุงหลังอัปเดตวันศุกร์ |

## ผังขาจริง ESP32 DevKit 38-pin ที่ยืนยันแล้ว

> มองด้านอุปกรณ์ของบอร์ดและวางพอร์ต USB ไว้ด้านบน อ่านแต่ละฝั่งจากบนลงล่าง

```text
ฝั่งซ้าย                                  ฝั่งขวา
CLK     ห้ามใช้ — Flash                  V5      รับ Logic 5V จาก LM2596
SD0     ห้ามใช้ — Flash                  CMD     ห้ามใช้ — Flash
SD1     ห้ามใช้ — Flash                  SD3     ห้ามใช้ — Flash
G15     สำรอง/Strapping                  SD2     ห้ามใช้ — Flash
G2      TFT DC                           G13     TCRT5000 ซ้าย
G0      ห้ามใช้ — BOOT                   GND     GND ร่วม
G4      TFT RST                          G12     สำรอง/Strapping
G16     RX2 รับข้อมูลจาก XIAO TX         G14     TB6612 BIN2
G17     TCRT5000 ขวา                     G27     TB6612 AIN2
G5      TFT CS                           G26     TB6612 AIN1
G18     TFT SCK                          G25     TB6612 PWMA
G19     ว่าง (เดิม TFT MISO)             G33     TB6612 BIN1
GND     GND ร่วม                         G32     TB6612 PWMB
G21     I2C SDA                          G35     Encoder ซ้าย B
RXD     สำรอง Serial0/USB                G34     Encoder ซ้าย A
TXD     สำรอง Serial0/USB                SN/VN   GPIO39 Encoder ขวา B
G22     I2C SCL                          SP/VP   GPIO36 Encoder ขวา A
G23     TFT MOSI                         EN      Reset/Enable ไม่ใช่ GPIO
GND     GND ร่วม                         3V3     Logic 3.3V + TB6612 STBY
```

จุดที่ต้องจำ:

- `SP/VP` คือ GPIO36 และ `SN/VN` คือ GPIO39 ทั้งคู่เป็นขารับสัญญาณอย่างเดียว
- `CLK/SD0/SD1/CMD/SD2/SD3` ต่อกับ Flash ภายใน ห้ามนำไปใช้
- `EN` เป็นขา Enable/Reset ไม่ใช่ GPIO
- `RXD/TXD` คือ Serial0 ที่ใช้กับ USB/ข้อความ Debug จึงยังไม่ใช้กับกล้อง
- XIAO ส่งข้อมูลเข้าขา `G16` ไม่ใช่ขาที่พิมพ์ว่า `RXD`
- ขา `G2/G5/G12/G15` เกี่ยวข้องกับการบูต ห้ามให้โมดูลภายนอกบังคับระดับผิดขณะเปิดเครื่อง
- ถ้าแฟลชผ่าน USB ไม่เข้า ให้ถอดสาย TFT `DC` ที่ `G2` ก่อนแล้วแฟลชใหม่
- ขาที่ยังว่างจริงมีแค่ `G12` กับ `G15` และ `G19` ที่ได้คืนมาจากการไม่ต่อ MISO ของจอ

---

## บันทึกการแก้ไข — 27 สิงหาคม 2569

ตรวจผังขาทั้งหมดจากบอร์ดจริงโดยไม่ยึดโค้ดเก่า pin map ไม่มีขาชนกัน แก้ 8 จุด

| # | แก้อะไร | ทำไม |
|:-:|---|---|
| 1 | เพิ่มข้อ 0 ในหัวข้อ 16 ห้ามจ่ายไฟด้วยเฟิร์มแวร์เก่า | โค้ดเดิมใช้ GPIO25/26/27/32/33 เป็นสัญญาณ Servo ซึ่งตอนนี้คือขาสั่ง TB6612 เปิดเครื่องแล้วมอเตอร์จะวิ่งมั่วทันที |
| 2 | หัวข้อ 9 TFT `MISO` เปลี่ยนเป็นไม่ต่อ | บอร์ดจริงใช้ SDO ระดับ 3.3V แต่ไม่ต้องใช้สำหรับแสดงผล และอาจกวน XPT2046 เมื่อใช้ SPI ร่วมกัน จึงเว้นสายนี้ในต้นแบบวันศุกร์ |
| 3 | หัวข้อ 9 แจกแจงวิธีตัดสินขา `VCC` และเพิ่มค่า R ของ `LED/BL` | เดิมเขียนแค่ว่าตามบอร์ดจริงกับตามสเปกโมดูล ซึ่งตัดสินหน้างานไม่ได้ และถ้าเดา VCC ผิดคือจอพังถาวร |
| 4 | หัวข้อ 6 ตรวจ R `10kΩ` ที่ `AIN1/AIN2/BIN1/BIN2` | TB6612FNG มี pull-down ภายใน 200kΩ อยู่แล้ว จึงไม่บังคับเพิ่ม R สี่ตัว ให้ใส่เฉพาะเมื่อทดสอบยกล้อแล้วพบการกระตุกหรือสัญญาณรบกวน |
| 5 | หัวข้อ 8 `OE` เปลี่ยนจากเว้นไว้ได้ เป็นต้องต่อลง GND | `OE` เป็น active-low ถ้าปล่อยลอยแล้วลอยขึ้นสูง เอาต์พุตทั้ง 16 ช่องถูกปิด เซอร์โวไม่ขยับทั้งตัวและไล่หาสาเหตุยาก |
| 6 | หัวข้อ 12 และ 13 เพิ่มคำเตือน `Serial2.begin(9600, SERIAL_8N1, 16, -1)` | GPIO17 เป็นขา TX2 ค่าเริ่มต้น ถ้าไม่สั่งปิดด้วย `-1` UART จะยึดขาไปเป็น output แล้วดันกับ DO ของ TCRT5000 ตำแหน่งขวาใช้ไม่ได้เลย เอกสารเดิมบอกแค่ให้แก้ขา RX |
| 7 | หัวข้อ 13 ระบุขา TX ของ XIAO เป็น `D6/GPIO43` และต้องใช้ `Serial1` | เดิมเขียนแค่ว่า XIAO `TX` ถ้าเฟิร์มแวร์ฝั่ง XIAO พิมพ์ลง `Serial` ข้อมูลจะออกทาง USB ไม่ออกขา D6 สายต่อถูกแต่ไม่มีข้อมูลมา |
| 8 | หัวข้อ 4 เพิ่มคาปาซิเตอร์ `100–470µF` ที่ราง Logic และเปลี่ยนราง Servo เป็น 5.0V | ราง Logic ต้องมีตัวเก็บประจุกันแรงดันตกตอนมอเตอร์ออกตัว และ buck ต้องการ headroom 1.5–2V ที่กระแสสูง ตั้ง 5.0V ซื้อ headroom เพิ่ม |
| 9 | หัวข้อ 8 เพิ่มคำเตือนว่าช่อง PCA9685 ถูกสลับใหม่ทั้ง 6 ช่อง | ตอนไล่ตรวจเจอว่าในโฟลเดอร์มีผังช่องเซอร์โว 4 ชุดที่ไม่ตรงกัน ยึดตาม `สรุปการเชื่อมต่อสำหรับอัปเดตวันศุกร์` เป็นหลัก แต่ `รายชื่ออุปกรณ์หุ่นยนต์` มีค่ามุมคาลิเบรตผูกกับเลขช่องชุดเก่า ต้องให้ค่ามุมเดินตามตัวเซอร์โวไม่ใช่ตามเลขช่อง |

---

## บันทึกการแก้ไขรอบสอง — 27 สิงหาคม 2569 (หลังตรวจทานซ้ำ)

รอบนี้ตรวจข้อโต้แย้งจากการรีวิวอีกชุดโดยเปิดดาต้าชีตและซอร์สโค้ดจริง ผลคือแก้ 4 จุด และยืนยันไม่แก้ 1 จุด

| # | เรื่อง | ผลตรวจ | แก้เป็นอะไร |
|:-:|---|---|---|
| 1 | **Baud rate ของกล้อง** | ผิดจริง | `FullCam.ino` บรรทัด 127 ใช้ `Serial1.begin(9600, ...)` ไม่ใช่ 115200 แก้เป็น **9600** ทุกไฟล์แล้ว ถ้าตั้งผิดข้างเดียวจะได้ตัวอักษรขยะ |
| 2 | **TB6612 ต้องใส่ R pull-down 4 ตัวไหม** | ผมเขียนเกินจริง | datasheet ของ Toshiba ระบุว่าชิปมี **pull-down ภายใน 200kΩ** ที่ขาอินพุตทุกขารวมถึง STBY อยู่แล้ว สถานะตอนบูตจึงนิ่งเองโดยไม่ต้องเพิ่มอะไร ลดสถานะ R 4 ตัวจาก "ต้องใส่" เป็น **ของเสริม** และยืนยันว่า `STBY → 3.3V` ที่บัดกรีไว้แล้วถูกต้อง ไม่ต้องแกะ |
| 3 | **XH-M401 บนแบต 2S** | ผมประเมินหลวมไป | ดาต้าชีต XLSEMI ระบุ XL4016 รับอินพุต **8V–40V** แต่แพ็ก 2S คือ 6.0–8.4V = อยู่นอกสเปกเกือบทั้งช่วง ไม่ใช่แค่ "คาบเส้นที่ 7.0V" อย่างที่เขียนไว้รอบแรก เปลี่ยนเป็นระบุชัดว่าเป็น**ของทดลอง ไม่รับประกัน** ต้องชาร์จเต็มก่อนสาธิตและวัดใต้โหลดจริง |
| 4 | **current limit ของ XH-M401** | คำแนะนำเดิมอันตราย | ตัดคำว่า "หมุนขึ้นสุด" ออก เพราะเท่ากับปิดการป้องกันกระแสเกินทิ้ง และห้ามเดาว่าปุ่มที่สองคือ CC เปลี่ยนเป็นให้อ่านตัวอักษรบนบอร์ดแล้วตั้งจากค่ากระแสที่วัดได้จริง |
| 5 | **`Serial2.begin(9600, SERIAL_8N1, 16, -1)` ใช้ได้ไหม** | **ยืนยันว่าถูกแล้ว ไม่แก้** | มีข้อโต้แย้งว่า `-1` แปลว่า "คงขาเดิม" จึงยังเสี่ยงยึด GPIO17 ตรวจซอร์สของ arduino-esp32 แล้วพบว่าการเติมขาเริ่มต้นเกิดเฉพาะเมื่อ **rxPin และ txPin ติดลบพร้อมกัน** (`if (rxPin < 0 && txPin < 0)`) พอใส่ `16` ให้ RX เงื่อนไขเป็นเท็จ ไลบรารีไม่เติม TX2 ให้ สัญญาณ TX จึงไม่เคยถูกโยงเข้า GPIO17 — แต่เพิ่มคำเตือนไว้แล้วว่าห้ามมี `Serial2.begin` แบบไม่ระบุขาอยู่ที่ไหนในสเกตช์เลย |

ข้อเสนอที่ **ไม่รับ**: การย้าย UART TX ไป `GPIO19` หรือย้าย `STBY` ไป `GPIO19` เพราะ GPIO19 เป็นขาสำรองที่ได้คืนมาจากการไม่ต่อ SDO และยังเป็นขา `T_DO` ของ XPT2046 ถ้าวันหลังต่อ touch จะกลายเป็น output ชนกัน อีกทั้งสองข้อเสนอนี้แย่ง GPIO19 กันเอง

**เรื่องจอ:** ยืนยันจาก TFT_eSPI ที่คอมไพล์ใช้งานจริงว่าเป็น ST7789 240×320 และโค้ดหมุนเป็น 320×240 ข้อสรุปยังเหมือนเดิมคือไม่ต่อ `SDO/MISO` เพราะระบบแสดงผลอย่างเดียวไม่ต้องอ่านกลับและ touch ยังไม่ใช้งาน ส่วนคำอธิบายเดิมที่อ้าง ILI9341, แรงดัน SDO หรือ high-Z ถูกยกเลิกเพราะไม่ตรงกับ driver ปัจจุบัน
