HoneyKung/metorobot/Robo/Part Robot/ตารางการเชื่อมต่อและบัดกรี_RoboMDT_ก่อนใช้เบรดบอร์ด.md

> ⛔ **สแนปช็อตเก่า เก็บเป็นประวัติเท่านั้น ห้ามใช้ต่อวงจร**
>
> ไฟล์นี้หยุดไว้ก่อนเปลี่ยนมาใช้เบรดบอร์ด เนื้อหาข้างในยังมีข้อมูลที่ถูกแก้ไปแล้ว เช่น สเปก "UBEC 2S 10A" ที่ยกเลิกไปแล้ว
>
> ให้ใช้ [แพลนบัดกรี_Phase1_Motor.md](./แพลนบัดกรี_Phase1_Motor.md) เป็นฉบับจริง

# ตารางการเชื่อมต่อและบัดกรี RoboMDT

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

> **สถานะสำหรับอัปเดตวันศุกร์ที่ 28 สิงหาคม 2569:** ใช้ XH-M401 แทน UBEC เป็นการชั่วคราวและจ่ายไฟให้ราง Servo เท่านั้น ฟิวส์และ UBEC 2S 10A เป็นงานเพิ่มหลังวันศุกร์ ต้นแบบระยะนี้ต้องทดสอบภายใต้การดูแลและยังไม่ให้เด็กใช้งานเอง

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

## 1. ผังไฟหลัก

```text
แบตเตอรี่ 18650 สองก้อนแบบ 2S
        │
        ▼
      BMS 2S
        │ P+ / P-
        ▼
   KCD-105 สวิตช์หลัก
        │
        ▼
   จุดกระจายไฟหลังสวิตช์ BUS+/BUS-
        ├── TB6612 ขา VM/GND → มอเตอร์ล้อ (รับไฟ BUS 6.0–8.4V)
        ├── XH-M401 ตั้ง 5.0V
        │      └── PCA9685 ขา V+/GND → เซอร์โวเท่านั้น
        └── LM2596 ตั้ง 5.0V
               ├── ESP32 ขา VIN/5V
               ├── XIAO ESP32S3 Sense ขา 5V
               └── TFT ขา VIN เฉพาะรุ่นที่รองรับ 5V
```

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

## 2. แบตเตอรี่ 2S และ BMS

ใช้สาย 18–20 AWG และหุ้มท่อหดทุกจุด

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

ลำดับตรวจ:

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

## 3. KCD-105 และจุดกระจายไฟ

### สวิตช์สองขา

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

### สถานะฟิวส์ของต้นแบบวันศุกร์

- ระยะวันศุกร์ยังไม่ติดฟิวส์เพราะเป็นการอัปเดตความคืบหน้า ไม่ใช่ระบบพร้อมส่งให้เด็กใช้งาน
- ใช้งานเฉพาะภายใต้การดูแล ห้ามชาร์จขณะเปิดหุ่น และต้องเข้าถึงสวิตช์/แบตได้ทันที
- หลังวันศุกร์ให้เพิ่มฟิวส์ใกล้ BMS ที่สาย `BMS P+ → ฟิวส์ → สวิตช์` โดยเลือกค่าหลังวัดกระแสใช้งานจริง

## 4. XH-M401: ราง Servo ชั่วคราว 5.0V

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

> ⚠️ **XH-M401 บนแบต 2S อยู่นอกสเปกของชิป ถือเป็นของทดลอง**
>
> ชิป **XL4016** ระบุช่วงอินพุตในดาต้าชีตว่า **8V ถึง 40V** แต่แพ็ก 2S ของเราอยู่ที่ 6.0–8.4V แปลว่าเกือบทั้งช่วงการใช้งานอยู่ต่ำกว่าขั้นต่ำของชิป มีแค่ตอนชาร์จเต็มใหม่ๆ เท่านั้นที่ถึง 8V
>
> ผลจริงคือมักจะทำงานได้ แต่ไม่มีการรับประกันว่าจะรักษา 5V ไว้ได้ โดยเฉพาะจังหวะที่เซอร์โวกินกระแสกระชาก
>
> | BUS | สถานะ |
> |---|---|
> | 8.4V ชาร์จเต็ม | อยู่ในสเปก ใช้ได้ |
> | 8.0V | ขอบล่างของสเปกพอดี |
> | 7.4V | **นอกสเปกแล้ว** มักยังทำงานได้แต่ไม่รับประกัน |
> | ต่ำกว่า 7.0V | หยุดใช้งาน ชาร์จทันที |
>
> **เงื่อนไขใช้งานวันศุกร์:** ชาร์จเต็มใกล้ 8.4V ก่อนสาธิตทุกครั้ง, วัดเอาต์พุต**ขณะเซอร์โวเคลื่อนจริง**ไม่ใช่ตอนอยู่เฉยๆ, เลี่ยงการยกของหนักและขยับเซอร์โวหลายตัวพร้อมกัน, หยุดทันทีถ้ารางต่ำกว่า 4.8V หรือ ESP32 รีบูต
>
> **นี่คือเหตุผลที่ UBEC 2S 10A เป็นของที่ต้องหามาเปลี่ยนจริง ไม่ใช่แค่ของอัปเกรด** UBEC ออกแบบมาสำหรับ 2S โดยตรงจึงอยู่ในสเปกตลอดช่วงแบต

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

| `OUT+` | `V+` ที่ขั้วสกรู PCA9685 | 20 AWG |
| `OUT-` | `GND` ที่ขั้วสกรู PCA9685 | 20 AWG |

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

คาปาซิเตอร์:

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

## 5. LM2596: รางควบคุม 5V

ก่อนต่อบอร์ด ให้ปรับเอาต์พุตเป็น `5.00V`

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

ห้ามต่อ 5V เข้าขา `3V3` และห้ามใช้ LM2596 จ่ายไฟมอเตอร์หรือ MG996R

## 6. TB6612 และมอเตอร์ล้อ

### ขากำลัง

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

### ขาควบคุมที่เสนอ

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

### สถานะมอเตอร์ตอนบูต — ปลอดภัยอยู่แล้ว

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

### ตัวต้านทาน 10kΩ 4 ตัว — ของเสริม ไม่บังคับ

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

## 7. Encoder มอเตอร์ — เติมภายหลังได้

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

## 8. PCA9685 และเซอร์โว

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

`VCC` คือไฟลอจิก ส่วน `V+` คือไฟเซอร์โว ห้ามสลับกัน

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

## 9. TFT 2.8 นิ้วแบบ SPI

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

### ไม่ต้องต่อ SDO/MISO

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

### ขา VCC ต้องตัดสินจากบอร์ดจริงก่อนจ่ายไฟ

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

**วิธีที่ไม่ต้องเดา:**

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

ห้ามเริ่มที่ 5V เพราะถ้าบอร์ดไม่มีเรกูเลเตอร์คือพังทันที

### ขา LED/BL

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

### ถ้าแฟลชผ่าน USB ไม่เข้า

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

### Touch XPT2046

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

## 10. VL53L0X — เติมภายหลังได้

| VL53L0X | ESP32 |
|---|---:|
| `VIN` | 3V3 |
| `GND` | GND |
| `SDA` | GPIO21 |
| `SCL` | GPIO22 |
| `XSHUT/GPIO1` | เว้นไว้ก่อน |

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

## 11. MPR121 Touch — เติมภายหลังได้

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

## 12. TCRT5000 สองตัว — เติมภายหลังได้

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

## 13. XIAO ESP32S3 Sense

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

UART สำหรับระบบจริงใช้ทางเดียวตามหน้าที่ของกล้อง:

| จาก | ไป |
|---|---|
| XIAO `TX` = ขา `D6` / `GPIO43` | ESP32 GPIO16 `RX2` |
| XIAO `GND` | ESP32 GND |

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

## 14. CM620 และช่องชาร์จ

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

## 15. สรุปว่าจุดใดต้องบัดกรี

ต้องบัดกรีหรือใช้ขั้วสกรูที่แน่น:

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

เสียบ Dupont ได้:

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

## 16. ลำดับเปิดระบบครั้งแรก

### ⛔ ข้อ 0 — ห้ามจ่ายไฟด้วยเฟิร์มแวร์เก่าเด็ดขาด

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

ชุดที่ต้องแก้ในเฟิร์มแวร์ก่อนเสียบไฟครั้งแรก:

```
Motor    PWMA=25  AIN1=26  AIN2=27  PWMB=32  BIN1=33  BIN2=14
I2C      Wire.begin(21, 22)              PCA9685 @ 0x40  ใช้ CH0-CH5
TFT      SCLK=18  MOSI=23  MISO=-1  CS=5  DC=2  RST=4
UART     Serial2.begin(9600, SERIAL_8N1, 16, -1)
TCRT     pinMode(13, INPUT);  pinMode(17, INPUT)
Encoder  34 / 35 / 36 / 39 เป็น INPUT   (ไม่มี pull-up ภายใน)
```

### ลำดับปกติ

1. ถอดบอร์ด โหลด มอเตอร์ และเซอร์โวออกก่อน
2. ตรวจ BMS และวัด `P+/P-`
3. ตั้ง LM2596 เป็น 5.00V และ XH-M401 เป็น 5.0V ถ้าบอร์ด XH-M401 มีสองโวลุ่ม ให้อ่านตัวอักษรบนบอร์ดก่อนว่าตัวไหน CV ตัวไหน CC ห้ามเดาและห้ามหมุนสุด เพราะเท่ากับปิดการป้องกันกระแสเกินทิ้ง
4. ปิดไฟ แล้วต่อ ESP32 อย่างเดียว
5. ต่อและทดสอบ TFT
6. ต่อ TB6612 โดยยังไม่ต่อมอเตอร์ ตรวจ `VM = แรงดัน BUS 6.0–8.4V`, `VCC ≈ 3.3V`
7. ต่อมอเตอร์ทีละตัวโดยยกล้อให้ลอยจากพื้น
8. ต่อ PCA9685 โดยยังไม่เสียบเซอร์โว ตรวจ `VCC ≈ 3.3V`, `V+ = 5.0V`
9. สั่งเซอร์โวไปกึ่งกลางก่อนติดกลไก
10. ต่อ SG90/MG90S ทีละตัว
11. ต่อ MG996R ทีละตัว ตรวจทิศและขอบเขตมุมก่อนประกอบแขน
12. เพิ่ม XIAO และเซนเซอร์หลังระบบหลักผ่านการทดสอบ

ปิดสวิตช์ทุกครั้งก่อนเสียบหรือถอดมอเตอร์และเซอร์โว

## 17. ขอบเขตการอัปเดตวันศุกร์

| ส่วน | ต่อในวันศุกร์ | สถานะ |
|---|---|---|
| แบต 2S + BMS + สวิตช์ | ต่อ | ระบบไฟต้นแบบ ยังไม่มีฟิวส์ |
| LM2596 → ESP32/TFT/XIAO | ต่อ | ราง Logic 5V |
| XH-M401 → PCA9685/Servo | ต่อ | ตัวแทน UBEC ชั่วคราว 5.0V |
| BUS → TB6612 → Motor | ต่อ | ทดสอบ PWM ต่ำและยกล้อพ้นพื้นก่อน |
| PCA9685 → Servo 6 ช่อง | ต่อทีละตัว | ทดสอบโหลดเบา ไม่ยกขวดเต็ม |
| TFT | ต่อ | ต้องใช้ pin map/ค่าไลบรารีชุดใหม่ให้ตรงกัน |
| XIAO → ESP32 | ต่อทางเดียว | XIAO TX → ESP32 GPIO16 RX2 |
| TCRT5000 | ต่อได้ | GPIO13 และ GPIO17 |
| Encoder | เติมได้ถ้ามีเวลา | GPIO34/35/36/39 และตรวจ pull-up จากบอร์ดจริง |
| VL53L0X/MPR121 | ยังไม่จำเป็น | เติมภายหลังบน I2C GPIO21/22 |
| ฟิวส์ + UBEC 2S 10A | ยังไม่ติด | งานปรับปรุงหลังอัปเดตวันศุกร์ |

## ผังขาจริง ESP32 DevKit 38-pin ที่ยืนยันแล้ว

> มองด้านอุปกรณ์ของบอร์ดและวางพอร์ต USB ไว้ด้านบน อ่านแต่ละฝั่งจากบนลงล่าง

```text
ฝั่งซ้าย                                  ฝั่งขวา
CLK     ห้ามใช้ — Flash                  V5      รับ Logic 5V จาก LM2596
SD0     ห้ามใช้ — Flash                  CMD     ห้ามใช้ — Flash
SD1     ห้ามใช้ — Flash                  SD3     ห้ามใช้ — Flash
G15     สำรอง/Strapping                  SD2     ห้ามใช้ — Flash
G2      TFT DC                           G13     TCRT5000 ซ้าย
G0      ห้ามใช้ — BOOT                   GND     GND ร่วม
G4      TFT RST                          G12     สำรอง/Strapping
G16     RX2 รับข้อมูลจาก XIAO TX         G14     TB6612 BIN2
G17     TCRT5000 ขวา                     G27     TB6612 AIN2
G5      TFT CS                           G26     TB6612 AIN1
G18     TFT SCK                          G25     TB6612 PWMA
G19     ว่าง (เดิม TFT MISO)             G33     TB6612 BIN1
GND     GND ร่วม                         G32     TB6612 PWMB
G21     I2C SDA                          G35     Encoder ซ้าย B
RXD     สำรอง Serial0/USB                G34     Encoder ซ้าย A
TXD     สำรอง Serial0/USB                SN/VN   GPIO39 Encoder ขวา B
G22     I2C SCL                          SP/VP   GPIO36 Encoder ขวา A
G23     TFT MOSI                         EN      Reset/Enable ไม่ใช่ GPIO
GND     GND ร่วม                         3V3     Logic 3.3V + TB6612 STBY
```

จุดที่ต้องจำ:

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

---

## บันทึกการแก้ไข — 27 สิงหาคม 2569

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

---

## บันทึกการแก้ไขรอบสอง — 27 สิงหาคม 2569 (หลังตรวจทานซ้ำ)

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
