HoneyKung/metorobot/Robo/Part Robot/ผลค้นขนาดอุปกรณ์และลูกล้อ_Luna_2026-11-01.md

# ผลค้นขนาดอุปกรณ์และลูกล้อ — Luna — 2026-11-01

## ขอบเขตและวิธีอ่าน

ตรวจรายการเทียบกับสำเนาไฟล์ใน `อ่านก่อน` เท่านั้น ค้นจากหน้า datasheet/ผู้ผลิต/ผู้ขายจริงตาม URL ที่แนบในแถว ไม่มีการอนุมานตัวเลขที่ค้นไม่พบ ตัวเลขซึ่งเอกสารในโฟลเดอร์เดิมระบุไว้แต่ยังหาแหล่งยืนยันอิสระไม่ได้จะทำเครื่องหมายเป็นข้อมูลเดิม/ต้องวัด ไม่ถือเป็น datasheet

ความเชื่อถือ: **สูง** = เอกสารผู้ผลิตหรือแบบวิศวกรรมผู้ผลิต; **กลาง** = หน้าผู้ผลิตที่ระบุสินค้า/หน้าร้านซึ่งให้ขนาด; **ต่ำ** = ขนาดมาตรฐาน/ร้านค้าแบบทั่วไปที่อาจต่างกันตามผู้ผลิต; **ยังไม่ยืนยัน** = ระบุในเอกสารโครงการแต่ไม่พบเอกสารตรงรุ่นหรือรูปแบบสินค้าจริง

## 1. ตารางขนาดอุปกรณ์

ขนาดเรียง ยาว × กว้าง × สูง (mm) เว้นแต่ระบุแกนอื่น ขนาดโมดูลจีน/ร้านทั่วไปมีหลาย revision; ก่อนออกแบบช่องสวมต้องวัดของจริงและเผื่อสาย/ขั้ว

| อุปกรณ์/รุ่นที่ค้น | ขนาดหรือข้อมูลเชิงกลที่พบ | รู/พอร์ต/ข้อควรเผื่อ | ที่มาและชนิดแหล่ง | เชื่อถือ |
|---|---|---|---|---|
| AMASS XT30U-F ตัวเมีย | 12.4 × 5.6 × 10.2 (กรอบตัวเรือนตามภาพแบบ) | สายบัดกรีออกด้านหลัง; แบบ U แนวตรง | [แบบ XT30U ผู้ผลิต AMASS ที่ Akizuki](https://akizukidenshi.com/goodsaffix/XT30U.pdf) — datasheet/แบบผู้ผลิต | สูง |
| AMASS XT30U-M ตัวผู้ | ยาวกรอบ 13.7; หน้าตัด 5.6 × 10.2 | สายบัดกรีออกด้านหลัง; ต้องเว้นพื้นที่โค้งสายและท่อหดเพิ่ม | [แบบ XT30U ผู้ผลิต AMASS ที่ Akizuki](https://akizukidenshi.com/goodsaffix/XT30U.pdf) — datasheet/แบบผู้ผลิต | สูง |
| XT30U คู่เสียบกัน | **ไม่พบ** มิติรวมเมื่อเสียบกันในแบบที่ค้น; ตัวเลขข้างต้นเป็นแยกชิ้น ห้ามบวกความยาวตรง ๆ เพราะส่วนเสียบซ้อนกัน | แนวเสียบและเส้นทางสายขึ้นกับการติดตั้ง ให้ทดลองเสียบวัดจริง | [AMASS XT30U drawing](https://akizukidenshi.com/goodsaffix/XT30U.pdf) | สูงสำหรับแต่ละชิ้น; ต้องวัดคู่ |
| ฐานฟิวส์ inline mini blade ATM, สาย 18AWG | **ไม่พบ** ขนาดตัวฐานที่ยืนยันได้ของรุ่นตรงกับที่มีในโครงการ | ความยาวสายและฝาปิดต่างกันตามร้าน; ตัวอย่าง Littelfuse FHM สาย 18AWG มี datasheet แต่ไม่พบมิติที่ช่วยกำหนดช่องยึด | [Littelfuse MINI FHM datasheet](https://www.littelfuse.com/assetdocs/littelfuse-fuse-holder-mini-fhm-datasheet.pdf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) — ผู้ผลิต | สูงว่าระบุ 18AWG; มิติต้องวัด |
| ฐานฟิวส์ inline 5×20 mm, OptiFuse LPC-08B-18R | ตัวฐานประมาณ 39.1 × 7.9 × 7.9 (แปลงจาก 1.54 × 0.31 × 0.31 in); สาย 18AWG | ฝาเกลียวต้องเผื่อระยะเปิด/ถอด; มิตินี้จากหน้าร้าน RS | [RS OptiFuse LPC-08B-18R](https://us.rs-online.com/product/optifuse/lpc-08b-18r/74255568/) — หน้าร้าน/แค็ตตาล็อก | กลาง |
| UBEC Hobbywing UBEC 5A | 50 × 17 × 10 | สายอินพุต/เอาต์พุตและสวิตช์เลือกแรงดันยื่นออก; รองรับ LiPo 2–8S ซึ่งรวม 2S | [Hobbywing UBEC 5A](https://www.hobbywing.com/en/products/ubec-5a93.html) — ผู้ผลิต | สูง |
| ESP32 expansion board / terminal adapter 38-pin | **ไม่พบ** ขนาดเดียวที่ครอบคลุมสินค้าทั่วไป; มีหลาย PCB layout | ต้องวัดบอร์ดจริง รวม ESP32 ที่เสียบ, terminal, USB และหัวสาย; รูยึดขึ้นกับรุ่น | [ตัวอย่างรายการสินค้า/ชนิดบอร์ด 38-pin](https://www.amazon.com/s?k=ESP32+38+pin+expansion+board) — ร้าน/รุ่นหลากหลาย | ต่ำ/ต้องวัด |
| WAGO 221-413, 3 ช่อง | 18.8 × 18.8 × 8.4 | สายเข้าทั้งสามด้าน; ความยาว strip 11 mm; ไม่มีรูยึดในตัว | [WAGO 221-413 data sheet](https://www.netxl.com/wago/docs/221-413-data-sheet.pdf) — datasheet | สูง |
| WAGO 221-415, 5 ช่อง | 29.9 × 18.6 × 8.3 | สายเข้าทั้งห้าด้าน; ความยาว strip 11 mm; ไม่มีรูยึดในตัว | [WAGO 221 series datasheet](https://www.wiska.co.uk/downloads/WISKA-WAGO--221-Series.pdf) และ [หน้าผลิตภัณฑ์ 221-415](https://www.wago.com/global/installation-terminal-blocks-and-connectors/splicing-connector-with-levers/p/221-415) — datasheet/ผู้ผลิต | สูง |
| CM620 2S USB-C charger | **ไม่พบ** datasheet หรือหน้ารุ่น CM620 ที่ยืนยันขนาดและตำแหน่ง USB-C ได้ | เอกสารโครงการบันทึกประมาณ 30 × 17 × 5 mm แต่ยังไม่มีแหล่งภายนอกยืนยัน; วัดตำแหน่งพอร์ตกับระยะยื่นจริง | ค้นชื่อ CM620 2S USB-C; [รายการค้นเว็บ](https://www.google.com/search?q=CM620+2S+USB-C+charger+module+dimensions) | ยังไม่ยืนยัน |
| BMS 2S 16A ที่มีในโครงการ | **ไม่พบ** รุ่น/ผู้ผลิตตรงกันเพื่อยืนยันขนาด | บอร์ด BMS หน้าตาคล้ายกันอาจสลับตำแหน่งสาย B-/BM/B+/P; อย่าทำกรอบจากขนาดทั่วไป | [ค้น 2S 16A BMS](https://www.google.com/search?q=2S+16A+BMS+board+dimensions) | ยังไม่ยืนยัน |
| LM2596 module แบบโครงการ | ขนาดบอร์ดที่ผู้ขาย KAmod ระบุ 43 × 21 mm; สูงประมาณ 14 mm | มีขั้วสกรู/โพเทนชิออมิเตอร์และฮีตซิงก์ยื่น ต้องตรวจโมดูลจริงว่าเป็นบอร์ดเดียวกัน | [KAmod LM2596](https://wiki.kamamilabs.com/index.php?title=KAmod_LM2596) — ผู้ผลิต/ผู้ขาย | กลาง |
| TB6612FNG module แบบ breakout | แบบโมดูล DFRobot 20 × 19.5 mm; ส่วนสูงจริงขึ้นกับ header | พอร์ต VM/GND/motor และหัวสัญญาณอยู่รอบขอบ; เว้นพื้นที่บัดกรี/ขั้วสาย; บอร์ดโคลนต่างกัน | [DFRobot DRI0044](https://wiki.dfrobot.com/dri0044/) — ผู้ผลิตโมดูล | กลาง-สูง |
| ADS1115 module | **ไม่พบ** รุ่นเฉพาะที่จะยืนยันขนาด | ต้องระบุ PCB/หัว pin ที่ซื้อก่อนทำช่อง | [ค้น ADS1115 module dimensions](https://www.google.com/search?q=ADS1115+module+PCB+dimensions) | ยังไม่ยืนยัน |
| VL53L0X GY-530 module | ร้านค้าที่ระบุ GY-530 ให้ PCB ประมาณ 13.3 × 10.5 mm; ความสูงรวมไม่ได้ระบุ | รูยึด Ø3 mm ตามรายการนั้น; ตำแหน่งหน้าต่างเซนเซอร์ต้องเปิดโล่ง | [GY-530 product listing](https://skule.sormo.no/index.php/component/eshop/download-pdf?product_id=303) — หน้าร้าน | กลาง-ต่ำ |
| HW-201 / TCRT5000 bare sensor | ตัวชิป TCRT5000 10.2 × 5.8 × 7 | ระยะ peak 2.5 mm; ช่วงเอาต์พุตที่ระบุ >20% คือ 0.2–15 mm โดยขึ้นกับผิว/วงจร; โมดูล HW-201 มี PCB และโพเทนชิออมิเตอร์เพิ่ม ไม่ใช่มิติเดียวกับชิป | [Vishay TCRT5000 datasheet](https://www.vishay.com/docs/83760/tcrt5000.pdf) — datasheet ผู้ผลิต | สูงสำหรับชิป; โมดูลต้องวัด |
| ESP32 DevKit V1 38-pin | โดยทั่วไปมีแผงราว 55 × 28 mm; ตัวอย่างโมเดล 38-pin ระบุรวมชิ้นส่วนสูง 13.3 mm | ไม่พบ datasheet ทางการที่ยืนยันโคลนที่ใช้อยู่; ไม่มีรูยึดมาตรฐานในหลาย clone; USB และปุ่ม BOOT/EN อยู่ปลายบอร์ด | [ตัวอย่างโมเดล 38-pin](https://www.innerscene.com/tools/library/3d-parts/esp32-dev-board-38-pins-f5d579c0) — แบบจำลอง/ไม่ใช่ datasheet รุ่นจริง | กลาง-ต่ำ |
| PCA9685 breakout | ไม่พบผู้ผลิต/PCB revision ที่ตรงรุ่นเพื่อยืนยันขนาดรวม header | ขั้วสกรู V+/GND ยื่นขอบ; วัดชิ้นจริงก่อนทำกรอบ | [ค้นบอร์ด PCA9685](https://www.google.com/search?q=PCA9685+module+62.5+25.4+dimensions) | ยังไม่ยืนยัน |
| TFT 2.8 inch ST7789 SPI | แบบโมดูลตัวอย่าง 50 × 69.2 × 2.32 mm; พื้นที่ active 43.2 × 57.6 mm | มีหลายรุ่น/จำนวน pin/PCB backing; พอร์ต/รูยึดต่างกัน ต้องตรวจว่าเป็นรุ่นเดียวกับของจริง | [Haptos 2.8-inch TFT ST7789](https://haptosdisplay.com/2.8-inch-tft/) — ผู้ผลิตจอ | กลาง-สูง |
| Seeed XIAO ESP32S3 Sense รวมกล้อง | บอร์ด XIAO ประมาณ 21 × 17.8 mm ในสเปกโครงการ; ไม่พบความสูงรวมกล้องที่เป็นตัวเลขรับรองรุ่นประกอบ | กล้องติดบนชุด Sense; เว้นแนวเลนส์และสายแพ; บอร์ดกล้องมี revision | [Seeed XIAO ESP32S3 Sense](https://wiki.seeedstudio.com/xiao_esp32s3_getting_started/) — ผู้ผลิต | สูงสำหรับบอร์ด; สูงรวมชุดต้องวัด |
| TT Encoder Motor 1:90 ที่โครงการใช้ | **ไม่พบ datasheet ตรงรุ่น 1:90** ที่ยืนยันขนาด, ระยะเพลาถึงผิวบน/ล่าง หรือ encoder tail | ภาพ/แบบ TT ทั่วไปบอกได้เพียงตัวอย่าง gearbox 37 × 22.5 × 18.5, เพลา Ø5.5 แบบ D; ไม่ใช่หลักฐานของ encoder รุ่นนี้. ระยะเพลาโผล่, ความสูงแกนจากผิวล่าง/บน และรูยึดรุ่นจริง **ต้องวัด** | [ขนาด TT motor ทั่วไป](https://xemstudio.com/objects/tt-gearmotor/) — แบบรวมจากผู้ขาย, ไม่ใช่รุ่น encoder ที่ซื้อ | ต่ำสำหรับตัวอย่าง; ยังไม่ยืนยันรุ่นจริง |

## 2. ล้อที่ใส่เพลา TT โดยตรง

| ล้อ/ขนาด | เส้นผ่านศูนย์กลาง × กว้าง | รูเพลา/ความเข้ากันได้ | ที่มา | เชื่อถือ |
|---|---|---|---|---|
| Olimex MG-WHEEL-43MM | Ø43 × 19 mm | ผู้ขายระบุ press-fit กับเพลา geared motor ตระกูล MG; ต้องเช็กหน้าตัดเพลา TT จริงก่อนสั่ง | [Olimex 43 mm wheel](https://www.olimex.com/Products/Robot-CNC-Parts/Wheels/MG-WHEEL-43MM/) — ผู้ขาย | กลาง |
| ล้อ TT ยางเหลืองทั่วไป | Ø65 × 26.6 mm | สินค้าระบุใช้กับ TT motor; ตรวจรูปทรงรู D และ hub ของคู่จริง | [Addicore TT wheel](https://www.addicore.com/collections/new-products/products/wheel-for-tt-motor) — ผู้ขาย | กลาง |
| ล้อ TT 48 mm | **ไม่พบ** แหล่งเชื่อถือที่ระบุทั้งเส้นผ่านศูนย์กลางและความกว้างพร้อมยืนยันรูเพลา TT ในการค้นรอบนี้ | วัดรายการที่จะซื้อก่อนออกแบบ | [ค้น 48 mm TT wheel](https://www.google.com/search?q=48mm+TT+motor+wheel+width+shaft) | ยังไม่ยืนยัน |

## 3. ลูกล้ออิสระ (ball caster)

ความสูงของ Pololu คือพื้นถึงหน้ารองยึดเมื่อประกอบตามชุด/สเปเซอร์ที่กำหนด ไม่ใช่ขนาดลูกบอล ความสูงแปลงจากนิ้วที่หน้าเปรียบเทียบผู้ผลิตระบุ ค่า hole spacing เป็นระยะศูนย์กลางโดยประมาณตามตารางผู้ผลิต

| รุ่น/ขนาดลูก | ลูกบอล | ความสูงจากพื้นถึงหน้ายึด (mm) | ระยะรูยึด/ฐาน | วัสดุ | หมายเหตุ/ที่มา | เชื่อถือ |
|---|---:|---:|---|---|---|---|
| Pololu 3/8 plastic #950 | 9.525 mm | 10.16 mm no spacer; assembled range 10.16–15.24 | hole spacing 13.46 mm; drawing has screw holes for #2/M2 | ลูกพลาสติก, housing polymer | [Pololu comparison and item](https://www.pololu.com/category/45/pololu-ball-casters) และ [drawing 3/8 metal/plastic family](https://www.pololu.com/product/950) | สูง |
| Pololu 3/8 metal #951 | 9.525 mm | 10.16 mm; range 10.16–15.24 | 13.46 mm | ลูกโลหะ | [Pololu #951](https://www.pololu.com/product/951) | สูง |
| Pololu 1/2 plastic #952 | 12.7 mm | 13.46 mm; range 12.7–20.32 | 14.73 mm | ลูกพลาสติก | [Pololu comparison](https://www.pololu.com/category/45/pololu-ball-casters), [drawing](https://www.pololu.com/file/0J1638/pololu-ball-caster-with-0-500in-ball.pdf) | สูง |
| Pololu 1/2 metal #953 | 12.7 mm | 13.46 mm; range 12.7–20.32 | 14.73 mm | ลูกโลหะ | [Pololu #953](https://www.pololu.com/product/953) | สูง |
| Pololu 3/4 plastic #954 | 19.05 mm | 22.35 mm | 6.10 mm (ตาราง comparison) | ลูกพลาสติก | [Pololu comparison](https://www.pololu.com/category/45/pololu-ball-casters) | สูง |
| Pololu 3/4 metal #955 | 19.05 mm | 20.83 mm | 15.49 mm | ลูกโลหะ | [Pololu comparison](https://www.pololu.com/category/45/pololu-ball-casters) | สูง |
| Pololu 1 inch plastic #957 | 25.4 mm | 27.94 mm | 12.19 mm | ลูกพลาสติก; ball bearings หรือ rollers ตามรุ่นย่อย | [Pololu comparison](https://www.pololu.com/category/45/pololu-ball-casters) | สูง |
| Ball caster โลหะร้านทั่วไปในไทย | **ไม่พบ** รุ่นร้านไทยที่ลงลูกบอล, ความสูงถึงหน้ายึด, ระยะรู และวัสดุครบในแหล่งที่เปิดตรวจได้ | อย่าซื้อโดยอิงเพียงชื่อ “ลูกล้อเหล็ก/ลูกแก้ว”; ขอแบบหรือวัดของจริง | [ค้นลูกล้ออิสระโลหะ](https://www.google.com/search?q=ball+caster+ลูกล้ออิสระ+โลหะ+ขนาด+รูยึด) | ยังไม่ยืนยัน |
| พิมพ์ 3D ใส่ลูกปืน/ลูกแก้ว | ทำได้ในเชิงโครงสร้าง: พิมพ์ housing/retainer และทำเบ้ารับลูกทรงกลม; ตัวเลขขนาดขึ้นกับลูกที่หาได้และวัสดุพิมพ์ จึงไม่กำหนดเลขแทนชิ้นจริง | ต้องออกแบบช่องเปิด/ปากล็อกให้ลูกไม่หลุด, มีระยะหลวมให้กลิ้ง, และทดลองแรงเสียดทาน/การสึก; ยังไม่มีแบบทดสอบที่ตรงกับหุ่นนี้ | [ตัวอย่างแนวคิด 3D printed ball caster](https://www.printables.com/search/models?q=3d%20printed%20ball%20caster) — คลังแบบผู้ใช้ | กลางว่ามีแบบพิมพ์; ต้องทดสอบแบบเฉพาะ |

## 4. คำนวณใต้ท้อง

### นิยามและข้อจำกัด

ให้ `D` = เส้นผ่านศูนย์กลางล้อ, `R = D/2`; `a` = ระยะจากแกนเพลาถึงผิวล่างของตัวมอเตอร์เมื่อติดตามแนวจริง; `h_c` = ความสูง ball caster จากพื้นถึงหน้ารองยึด; `t` = ความหนาแผ่นฐานที่ต่ำกว่าระดับผิวรองยึด (ถ้าแผ่นรองบน/ใต้ caster ระดับไม่เท่ากันต้องรวม offset ด้วย)

- **ติดมอเตอร์ข้างแผ่นฐาน โดยวางแผ่นฐานระดับเดียวกับแกนเพลา:** ใต้ฐานโดยเรขาคณิต `G_side = R` (ไม่หักความหนาแผ่น หากผิวล่างแผ่นตรงระดับแกน); clearance ต่ำสุดจากผิวมอเตอร์ด้านล่าง `G_motor = R - a`.
- **ติดมอเตอร์ใต้แผ่นฐาน:** clearance ใต้ตัวมอเตอร์ `G_under = R - a`; หากแผ่นฐานยังอยู่เหนือผิวบนมอเตอร์ ความสูงฐานจากพื้นคือ `R + (ระยะผิวบนมอเตอร์ถึงแผ่นฐาน)` และตัวถังไม่ขนานพื้นด้วยตัวเลขชุดเดียว. มิติ `a` และระยะยึดจริงของมอเตอร์ encoder โครงการ **ไม่พบ** จึงยังคำนวณ clearance ใต้ตัวมอเตอร์เป็นตัวเลขยืนยันไม่ได้.
- ให้ฐานขนาน พื้นถึงผิวรองยึดลูกล้อควรเท่ากับระยะจากพื้นถึงผิวรองยึดล้อ/แกนที่ออกแบบ. ถ้าฐานอ้างระดับแกน, ความสูงเป้าหมาย caster `h_target = R`. Shim `s = h_target - h_c`; บวก = ต้องรองสูงขึ้น, ลบ = caster สูงเกินและต้องปรับตำแหน่ง/ฝังสูงขึ้น.

| ล้อ | R (ฐานระดับแกน) | G_side ใต้แผ่นฐาน* | caster เป้าหมาย h_target | caster ที่ใกล้สุดจากกลุ่มที่สำรวจ | shim ให้ขนาน (ค่าบวกคือรอง) | G_motor หากมอเตอร์ข้าง | G_under หากมอเตอร์ใต้ |
|---|---:|---:|---|---|---:|---|---|
| Ø43 × 19 | 21.5 mm | 21.5 mm | 21.5 mm | Pololu 3/4 metal, h=20.83 | +0.67 mm | 21.5 − a mm | 21.5 − a mm |
| Ø48 × ไม่พบ | 24 mm | 24 mm | 24 mm | Pololu 1 inch, h=27.94 | −3.94 mm (ฝัง caster 3.94 mm หรือเลือกความสูงชุดปรับได้ 20.32 mm แล้ว shim +3.68 mm) | 24 − a mm | 24 − a mm |
| Ø65 × 26.6 | 32.5 mm | 32.5 mm | 32.5 mm | Pololu 1 inch, h=27.94 | +4.56 mm | 32.5 − a mm | 32.5 − a mm |

`*` G_side เป็น clearance เชิงอุดมคติของแผ่นฐานที่ผิวล่างตรงระดับแกน; ไม่รวมส่วนประกอบ/สกรู/สายที่ยื่นต่ำกว่าแผ่น. สำหรับทุกขนาดล้อ หากยึดมอเตอร์ใต้ฐานหรือวางฐานสูงกว่าระดับแกน ตัวเลขจริงขึ้นกับ offset ของขายึดและระยะ `a`; ยังไม่มีข้อมูลที่ยืนยันค่าดังกล่าว จึงไม่ควรแปลงเป็นตัวเลขประดิษฐ์. ต้องวัดตัว encoder จริงก่อน CAD.

### ความเสี่ยงการใช้งาน

- TCRT5000 ชิปเปล่ามี peak response ที่ 2.5 mm และช่วงที่ datasheet ระบุ relative output มากกว่า 20% กว้าง 0.2–15 mm; ตัวเลขนี้ไม่ยืนยันระยะของบอร์ด HW-201 ซึ่งมีวงจรปรับและตำแหน่งชิปต่างกัน. ถ้าติดลงพื้นสูงกว่าช่วง 15 mm จะอยู่นอกช่วง datasheet ของชิป; ควรตั้งชิปใกล้ 2.5 mm แล้วทดสอบกับพื้น/เทปจริง.
- ระยะใต้ท้อง 21.5–32.5 mm ไม่ได้รับรองว่าจะผ่านสายไฟหรือรอยต่อพื้นทุกชนิด; ทดลองบนพื้นห้องเรียนและโต๊ะ พร้อมตรวจสาย/ขอบพรม. ลูก 3/8 นิ้วเล็กและอาจติดพรม/ร่องมากกว่าลูกใหญ่; ไม่มีข้อมูลแรงต้านพรมที่เทียบตรงรุ่นในแหล่งที่ตรวจ.
- ลูกล้อเล็กกว่าไม่ได้แปลว่าฐานเตี้ยอัตโนมัติ: ความสูง caster วัดจากลูกถึงหน้ายึดและต้องตรงระดับล้อ ไม่ใช่ติดให้ลูกบอล “เกือบชนฐาน”.

## 5. ชุดที่แนะนำ

1. **ชุดกะทัดรัดที่แนะนำให้ทำต้นแบบ:** ล้อ TT Ø43 × 19 mm, ติดมอเตอร์ด้านข้างฐานให้แกนอยู่ระดับผิวฐาน, Pololu 3/4 นิ้ว metal ball caster. ระดับฐานตามแกนให้ ground clearance เชิงอุดมคติ 21.5 mm; caster สูง 20.83 mm ต้องชิมประมาณ 0.67 mm. ได้ลูกโลหะที่ใหญ่กว่า 1/2 นิ้วและฐานค่อนข้างต่ำ แต่ Ø43 ที่อ้างอิงมาจากล้อ MG ซึ่งต้องยืนยันรูเพลาว่าเข้ากับเพลา TT ที่ซื้อจริงก่อน.
2. **ชุดสมดุล/ลดความเสี่ยงจากพรม:** ล้อ TT Ø65 × 26.6 mm กับ Pololu 1 นิ้ว plastic ball #957, มอเตอร์ติดข้างฐานระดับแกน. clearance เชิงอุดมคติ 32.5 mm; caster ต้องรองราว 4.56 mm. ลูกใหญ่ข้ามสิ่งสะดุดได้มากกว่า แต่เพิ่มเส้นผ่านศูนย์กลางล้อและความสูงหุ่น.
3. **ชุดล้อต่ำกว่าแต่ใช้ลูก caster ปรับระดับ:** ล้อ Ø43 × 19 mm กับ Pololu 1/2 นิ้ว plastic #952 ปรับ spacer ให้สูงได้ 12.7–20.32 mm; เลือกช่วง 20.32 mm แล้วเสริมประมาณ 1.18 mm (หรือใช้ความสูงจริงจาก assembled unit) ให้ใกล้แกน 21.5 mm. ต้องทดสอบพรม; ชุดนี้หลีกเลี่ยงฐาน caster สูงตายตัวแต่ยังมีลูกเล็ก.

**ทางเลือกที่แนะนำ:** เริ่มชุดที่ 1 หากยืนยันล้อ Ø43 เสียบเพลาได้ และพิมพ์ขายึดมอเตอร์ข้างฐานเพื่อให้แกนอยู่ระดับผิวฐาน. ก่อนสร้าง STL ให้เวอร์เนียวัด: ระยะเพลาถึงผิวล่าง/บนของ TT encoder, ความยาวและหน้าตัดเพลา, ระยะรูมอเตอร์, ความสูงหน้ายึด caster ของ Pololu เมื่อประกอบจริง, ระยะยื่นเซนเซอร์ HW-201. ค่า clearance ใต้ตัวมอเตอร์จริงจะเท่ากับ `21.5 − a`; นี่เป็นค่าต่ำสุดที่ยังต้องแทนด้วย `a` จากชิ้นจริง.

## 6. รายการไม่พบและต้องวัดของจริง

- มิติรวม XT30U ตัวผู้/เมียเมื่อเสียบกัน; วัดพร้อมสายและท่อหด.
- รุ่นและขนาดฐานฟิวส์ ATM mini blade ที่จะใช้จริง; วัดตัวฐาน/ฝา/สาย.
- รุ่น UBEC ที่ผู้ใช้มี; Hobbywing 5A เป็นตัวอย่างที่มีขนาดเผยแพร่ แต่ห้ามสมมุติว่าเป็นตัวที่มี.
- ขนาดและความสูงรวมของบอร์ดขยาย ESP32 38-pin ที่จะใช้.
- CM620 รุ่นจริงและตำแหน่ง USB-C; BMS 2S 16A รุ่นจริง.
- PCB revision ของ ADS1115, PCA9685 และ HW-201.
- TT encoder 1:90: offset แกนถึงผิวบน/ล่าง, เพลาโผล่, รูยึด และ encoder tail ในชิ้นจริง.
- ขนาดล้อ TT 48 mm ที่ยืนยันความกว้างและรูเพลา; ต้องลองสวมล้อ 43 mm กับเพลาของจริง.
- ball caster โลหะที่ซื้อได้ในไทยซึ่งมีแบบ/มิติครบ; การพิมพ์ caster เองต้องลอง clearance และความฝืดจริง.
- ความสูงหน้ายึดและรูปแบบรูของ caster ที่สั่งจริง, clearance ใต้สิ่งที่ยื่นต่ำกว่าแผ่น, และระยะอ่าน HW-201 ทั้งชุด.

## สรุปสำหรับหัวงาน

ค้นจากเว็บจริง **30 URL ไม่ซ้ำ** ทั้ง datasheet ผู้ผลิต, หน้าเว็บผู้ผลิตและหน้าร้าน/แบบสินค้า; URL ที่ใช้แสดงในไฟล์ผล. ตัวเลขที่เชื่อถือได้ที่สุดคือ WAGO, Hobbywing UBEC, Vishay TCRT5000, Pololu ball caster และจอ ST7789 ตัวอย่าง. จุดที่ยังไม่แน่ใจมากคือมิติของชิ้นจริงที่ไม่มีแบรนด์/PCB revision ระบุ, XT30 เมื่อประกบ, ตัว encoder motor และรูเพลาล้อ 43 mm. สำหรับการทำโครง ควรติด TT motor ข้างฐานโดยให้แกนอยู่ระดับฐาน; คำนวณ ground clearance เชิงทฤษฎีเป็นครึ่งเส้นผ่านศูนย์กลางล้อ. ค่าใต้ตัวมอเตอร์ยังต้องวัด offset `a` แล้วคำนวณ `R − a`. ชุดทดลองขนาดเล็กสุดที่สำรวจได้คือ Ø43 mm กับ Pololu 3/4 นิ้ว metal caster และ shim ประมาณ 0.67 mm. อย่าออกแบบกรอบล็อกชิ้นที่ทำเครื่องหมาย “ไม่พบ” ก่อนวัดตัวจริง.

## หัวงาน (Claude) ตรวจ — 1 พ.ย. 2569

- ✅ ตารางลูกล้อ Pololu ตรงกับหน้าเปรียบเทียบของผู้ผลิต (3/8" 10.2 · 1/2" 13.5 · 3/4" โลหะ 20.8 · 3/4" พลาสติก 22.4 · 1" 27.9 mm)
- ⚠️ ลูกล้อ 1 นิ้วปัจจุบันคือ #2691/#2692 (#956 เป็นรุ่นเก่า) ไม่ใช่ #957 ตามที่ Luna เขียน ส่วนความสูงเท่าเดิม
- ⚠️ ล้อ Olimex Ø43 × 19 ที่ใช้เป็นชุดแนะนำ ผู้ขายระบุว่าใช้กับมอเตอร์ M-6V/MG-12V ของ Olimex เอง ไม่ได้ระบุรูเพลาและไม่ได้บอกว่าใส่กับ TT ได้ → **ชุดที่ 1 ยังใช้ไม่ได้จนกว่าจะหาล้อเล็กที่สวมเพลา TT ได้จริง** · ตอนนี้ล้อที่ยืนยันว่าใช้กับ TT ได้มีแค่ Ø65
- สูตรใต้ท้อง R − a ถูกต้อง แต่ยังต้องใช้ค่า a (ระยะจากแกนเพลาถึงผิวล่างของมอเตอร์) ที่วัดจากของจริง
