HoneyKung/metorobot/Robo/Part Robot/รายชื่ออุปกรณ์หุ่นยนต์_RoboMDT.md

# 📋 รายชื่ออุปกรณ์ทั้งหมดของหุ่นยนต์ RoboMDT

> **อัปเดตล่าสุด:** 9 เมษายน 2569  
> **อ้างอิงจาก:** Robo.ino v3, FullCam.ino v7, server.py, script.js, ข้อมูลจากผู้พัฒนา

---

## 1. 🧠 บอร์ดไมโครคอนโทรลเลอร์ (Microcontroller Boards)

| ลำดับ | อุปกรณ์ | จำนวน | หน้าที่ | หมายเหตุ |
|:---:|---|:---:|---|---|
| 1 | **ESP32 DevKit 38 Pin** (บอร์ดหลัก) | 1 | ประมวลผลกลาง, เชื่อมต่อ Wi-Fi (STA Mode), สั่งเซอร์โว/มอเตอร์, แสดงตาบนจอ TFT, รับคำสั่ง Blockly ผ่าน HTTP, รับข้อมูลอารมณ์จากกล้อง | เชื่อมต่อ WiFi Router ผ่าน mDNS (MDTrobot.local) |
| 2 | **XIAO ESP32S3 Sense** (โมดูลกล้อง) | 1 | จับภาพใบหน้า, รัน ESP-DL (Face Detection + Landmarks), จำแนกอารมณ์, ส่งข้อมูลตำแหน่ง (L/C/R) + อารมณ์ (H/S/N/X) ผ่าน Serial | ใช้ OPI PSRAM, ส่งข้อมูลผ่าน Serial1 (9600 baud) |

---

## 2. 📷 โมดูลกล้อง (Camera Module)

| ลำดับ | อุปกรณ์ | จำนวน | หน้าที่ | หมายเหตุ |
|:---:|---|:---:|---|---|
| 3 | **กล้อง OV2640** (มาพร้อม XIAO ESP32S3 Sense) | 1 | ถ่ายภาพใบหน้าเรียลไทม์ ความละเอียด 240×240 px, RGB565 | อัตราเฟรม ~5-10 FPS |

---

## 3. 🖥️ จอแสดงผล (Display)

| ลำดับ | อุปกรณ์ | จำนวน | หน้าที่ | หมายเหตุ |
|:---:|---|:---:|---|---|
| 4 | **จอ TFT LCD ST7789 ขนาด 2.8 นิ้ว (SPI)** | 1 | แสดงดวงตาและอารมณ์ 11 แบบ (Normal, Happy, Sad, Angry, Shocked, Sleepy, Confused, Love, Shy, LookLeft, LookRight) + Idle Behaviors (กระพริบ, เหลือบมอง) | Native 240×320 px, ใช้ `setRotation(1)` เป็น 320×240 px; ยืนยัน driver จาก TFT_eSPI |

---

## 4. ⚙️ เซอร์โวมอเตอร์ (Servo Motors)

### โครงสร้างแขนและการทำงาน

หุ่นยนต์มี **แขน 2 ข้าง** แต่ละข้างมี **ข้อมือ (Hand)** ที่เป็นตัวหนีบ  
**การจับของ** ทำโดยการหมุนมือ (Hand) ทั้ง 2 ข้างเข้าหากันตรงกลาง (**ไม่ใช่ที่หนีบแยก**)

- **แขน (Arm)** = ยกขึ้น / ลง → ใช้ **MG996R** (แรงบิดสูง, เฟืองทอง)
- **มือหนีบ (Hand)** = หุบเข้า / กางออก → ใช้ **MG90S** (เฟืองโลหะ)
- **หัวหันซ้าย-ขวา (Head)** = หันหัวซ้าย-ขวา → ใช้ **SG90**
- **คอขึ้น-ลง (Neck Tilt)** = ก้ม-เงยหัว → ใช้ **SG90** ⚠️ *ยังไม่ได้ติดตั้ง (วางแผนจะเพิ่ม)*

> ⚠️ **ช่อง PCA9685 ในตารางนี้ถูกสลับใหม่ทั้ง 6 ช่อง เมื่อ 27 สิงหาคม 2569** เพื่อให้ตรงกับ `สรุปการเชื่อมต่อสำหรับอัปเดตวันศุกร์_RoboMDT.md` ซึ่งเป็นผังที่ใช้ต่อสายจริง
>
> **ค่ามุมเดินตามตัวเซอร์โว ไม่ได้เดินตามเลขช่อง** ถ้าเฟิร์มแวร์เดิมเก็บค่ามุมไว้เป็นตาราง index ตามเลขช่อง ต้องย้ายค่าตามตารางแปลงข้างล่างนี้ ห้ามคัดลอกตามเลขช่องเฉยๆ เพราะจะกลายเป็นเอาลิมิตของ MG90S ไปใส่ MG996R แล้วแขนจะดันจนกลไกเสียหาย

| เซอร์โว | ช่องเดิม | **ช่องใหม่** | ช่วงมุมที่ต้องย้ายตามไปด้วย |
|---|:---:|:---:|---|
| MG996R แขนซ้าย | CH2 | **CH0** | 67°-121° (center=91°) |
| MG90S ซ้าย | CH4 | **CH1** | 100°-160° (center=130°) |
| MG996R แขนขวา | CH3 | **CH2** | 60°-118° (center=90°) |
| MG90S ขวา | CH5 | **CH3** | 20°-80° (center=50°) |
| SG90 หัวหันซ้าย-ขวา | CH0 | **CH4** | 50°-130° (center=90°) |
| SG90 คอก้ม-เงย | CH1 | **CH5** | ⚠️ ยังไม่กำหนด |

| ลำดับ | อุปกรณ์ | จำนวน | หน้าที่ | PCA9685 CH | ช่วงมุม |
|:---:|---|:---:|---|:---:|---|
| 5 | **MG90S Servo — ซ้าย (ข้อไหล่ / Hand 1)** 180° เฟืองโลหะ | 1 | หมุนแขนซ้ายเข้าหากันเพื่อหนีบ — หุบเข้า/กลาง/กางออก | **CH1** | 100°-160° (center=130°) |
| 6 | **MG90S Servo — ขวา (ข้อไหล่ / Hand 2)** 180° เฟืองโลหะ | 1 | หมุนแขนขวาเข้าหากันเพื่อหนีบ (กลับทิศ) | **CH3** | 20°-80° (center=50°) |
| 7 | **MG996R Servo — แขนซ้าย (Arm 1)** 180° เฟืองทอง | 1 | ควบคุมแขนซ้าย — ยกขึ้น/กลาง/ลง | **CH0** | 67°-121° (center=91°) |
| 8 | **MG996R Servo — แขนขวา (Arm 2)** 180° เฟืองทอง | 1 | ควบคุมแขนขวา — ยกขึ้น/กลาง/ลง | **CH2** | 60°-118° (center=90°) |
| 9 | **SG90 Servo — หัวหันซ้าย-ขวา (Head)** 180° | 1 | หันหัวซ้าย-ขวา (Servo Lerp ราบรื่น) | **CH4** | 50°-130° (center=90°) |
| 10 | **SG90 Servo — คอขึ้น-ลง (Neck Tilt)** 180° | 1 | ก้ม-เงยหัว | **CH5** | ⚠️ ยังไม่กำหนด |

> **รวมเซอร์โว: 6 ตัว** — ทั้งหมดย้ายไปใช้ **PCA9685** (ไม่ใช้ GPIO ตรงอีกต่อไป)  
> เหลือ **CH6–CH15 ว่าง 10 ช่อง** สำหรับอนาคต

---

## 5. 🏎️ มอเตอร์ขับเคลื่อน (DC Motors & Driver)

| ลำดับ | อุปกรณ์ | จำนวน | หน้าที่ | พิน GPIO | หมายเหตุ |
|:---:|---|:---:|---|:---:|---|
| 11 | **TT Motor + Encoder** (13PPR, อัตราทด 1:90, 6V@175rpm) | 2 | ขับเคลื่อนหุ่นยนต์ เดินหน้า/ถอยหลัง/เลี้ยวซ้าย/เลี้ยวขวา | — | ความเร็ว PWM = 200 |
| 12 | **TB6612FNG Motor Driver** | 1 | ควบคุมทิศทาง + ความเร็วมอเตอร์ DC 2 ตัว | IN1=21, IN2=14, IN3=13, IN4=12, PWMA=22, PWMB=23 | เปลี่ยนจาก L298N มาใช้ TB6612FNG (ประสิทธิภาพสูงกว่า, ขนาดเล็กกว่า) |

---

## 6. 📡 เซนเซอร์ (Sensors)

| ลำดับ | อุปกรณ์ | จำนวน | หน้าที่ | พิน GPIO | หมายเหตุ |
|:---:|---|:---:|---|:---:|---|
| 13 | **HW-201 IR Sensor Module — ซ้าย** | 1 | ตรวจจับเส้น (Line Following) | GPIO 15 | — |
| 14 | **HW-201 IR Sensor Module — ขวา** | 1 | ตรวจจับเส้น (Line Following) | GPIO 34 | — |

---

## 7. 🔋 ระบบจ่ายไฟ (Power System)

| ลำดับ | อุปกรณ์ | จำนวน | หน้าที่ | หมายเหตุ |
|:---:|---|:---:|---|---|
| 15 | **MURATA SONY VTC6A 18650 3000mAh 30A** | 2 | แบตเตอรี่หลักจ่ายไฟทั้งระบบ | High-drain cell, รองรับกระแสสูงจากเซอร์โว/มอเตอร์ |
| 16 | **BH-18650x2-M** (กระบะถ่าน 18650 × 2) | 1 | ใส่แบตเตอรี่ 18650 2 ก้อน | — |
| 17 | **Li-ion 18650 BMS 2S 16A** | 1 | วงจรป้องกันแบตเตอรี่ (Over-charge, Over-discharge, Over-current, Short-circuit) | 2S = 7.4V nominal, 8.4V full |
| 18 | **CM620 2S 2A** | 1 | ชาร์จเจอร์แบตเตอรี่ Li-ion 2S | ชาร์จ Balance 2S |
| 19 | **LM2596 DC-DC Buck Converter Step Down Module** | 1 | แปลงแรงดันจาก 7.4V ลงเป็น 5V สำหรับ ESP32 และเซอร์โว | ปรับแรงดันได้ |
| 20 | **สวิตช์ KCD-105** | 1 | สวิตช์เปิด/ปิดไฟหลัก | — |
| 21 | **สายไฟ 20AWG** | 1 ชุด | สายจ่ายไฟหลัก | รองรับกระแสสูง |

---

## 8. 🔌 ชิ้นส่วนอิเล็กทรอนิกส์อื่นๆ (Electronics & Connectivity)

| ลำดับ | อุปกรณ์ | จำนวน | หน้าที่ | หมายเหตุ |
|:---:|---|:---:|---|---|
| 22 | **PCA9685** (16-Ch PWM Driver, I2C) | 1 | ควบคุม Servo/PWM ทั้งหมด — ปลดปล่อย 5 GPIO จาก ESP32 | I2C Addr: 0x40, ใช้ CH0-CH5 |
| 23 | **สาย Serial (XIAO → ESP32)** | 1 ชุด | เชื่อมต่อกล้องกับบอร์ดหลัก | XIAO D6(TX) → ESP32 D35(RX), GND, 9600 baud |
| 24 | **JST-XH 2.54mm Connector** | 23 ชุด | ขั้วต่อ Plug-and-Play ทุกจุด | Pre-Crimped, Color-Coded 9 สี |
| 25 | **ตัวเก็บประจุ 1000µF 16V** | 1 | กรอง inrush Servo ที่ PCA9685 C2 | บัดกรีล่วงหน้า |
| 26 | **ตัวเก็บประจุ 470µF 16V** | 2 | กรอง back-EMF Motor + LM2596 output | TB6612 VM-GND + LM2596 out |
| 27 | **ตัวเก็บประจุ 100µF 16V** | 2 | กรองไฟ ESP32 VIN + PCA9685 V+ | คร่อม VIN-GND |
| 28 | **ตัวเก็บประจุ 10µF Ceramic** | 1 | กรอง noise logic ESP32 3V3 | คร่อม 3V3-GND |

---

## 9. 🏗️ โครงสร้างทางกล (Mechanical Structure)

| ลำดับ | อุปกรณ์ | จำนวน | หน้าที่ | หมายเหตุ |
|:---:|---|:---:|---|---|
| 26 | **โครงสร้างตัวถัง** (3D Print) | 1 ชุด | ตัวถังหลัก รองรับมอเตอร์ + แบตเตอรี่ + บอร์ด | — |
| 27 | **โครงสร้างแขน** (3D Print) | 1 ชุด | แขนทั้ง 2 ข้าง + ข้อมือ (Hand) | มือออกแบบเป็นแขนโค้งเว้า ทั้ง 2 ข้างหมุนเข้าหากันเพื่อจับของ |
| 28 | **โครงสร้างหัว** (3D Print) | 1 ชุด | หัวหุ่นยนต์ + ยึดจอ TFT | — |

---

## 10. 🔮 อุปกรณ์ที่จะเพิ่มในอนาคต

| ลำดับ | อุปกรณ์ | จำนวน | หน้าที่ | สถานะ |
|:---:|---|:---:|---|---|
| — | **VL53L0X** (Laser ToF, I2C 0x29) | 1 | วัดระยะห่างวัตถุ — ตรวจสอบว่ายกสำเร็จหรือไม่ | ⚠️ วางแผนเพิ่ม |
| — | **MPR121** (Touch 12 ช่อง, I2C 0x5A) | 1 | รับสัมผัส "ลูบหัว" — ตอบสนองด้วยอารมณ์ | ⚠️ วางแผนเพิ่ม |
| — | **แผ่นทองแดง** | 1+ | Touch Pad บริเวณหัวหุ่นยนต์ ใช้กับ MPR121 | ⚠️ วางแผนเพิ่ม |

---

## 11. 💻 ซอฟต์แวร์ที่ใช้ (Software & Libraries)

| ลำดับ | ซอฟต์แวร์ / ไลบรารี | เวอร์ชัน | หน้าที่ |
|:---:|---|---|---|
| 1 | **Arduino IDE** | 2.x | พัฒนาเฟิร์มแวร์ ESP32 และ XIAO ESP32S3 |
| 2 | **ESP-DL Library** (Espressif) | ล่าสุด (2023) | โมเดล Face Detection (MSR01) + Landmarks (MNP01) |
| 3 | **TFT_eSPI Library** | 2.5.43 | ควบคุมจอ TFT ST7789 ผ่าน SPI |
| 4 | **ESP32Servo Library** | — | ควบคุมเซอร์โวมอเตอร์ |
| 5 | **Google Blockly** | 10.x | เฟรมเวิร์กสร้างระบบ Block Coding บนเว็บ |
| 6 | **HTML / CSS / JavaScript** | — | พัฒนาเว็บแอปพลิเคชัน |
| 7 | **Flask + Python** | — | Cloud Server สำหรับ AI ผู้ช่วยสอน |
| 8 | **Gemini API (Google)** | gemini-2.5-pro | LLM สำหรับวิเคราะห์โค้ด + ให้คำแนะนำแบบ Scaffolding |
| 9 | **esp32 Board Package** | v3.0.7 | Board package สำหรับ XIAO ESP32S3 Sense |

---

## 📊 สรุปจำนวนอุปกรณ์ฮาร์ดแวร์

| หมวด | จำนวนรายการ | จำนวนชิ้น |
|---|:---:|:---:|
| บอร์ดไมโครคอนโทรลเลอร์ | 2 | 2 |
| โมดูลกล้อง | 1 | 1 |
| จอแสดงผล | 1 | 1 |
| เซอร์โวมอเตอร์ (รวมคอที่ยังไม่ติด) | 6 | 6 |
| มอเตอร์ DC + Driver | 2 | 3 |
| เซนเซอร์ IR | 2 | 2 |
| ระบบจ่ายไฟ | 7 | ~8 ชิ้น |
| อิเล็กทรอนิกส์อื่นๆ | 4 | 4+ ชิ้น |
| โครงสร้างทางกล | 3 | 3 ชุด |
| **รวม (ปัจจุบัน)** | **28 รายการ** | — |
| อุปกรณ์ที่จะเพิ่ม | 5 | 5+ ชิ้น |

---

## 🔗 การเชื่อมต่อพิน ESP32 38-Pin — ⛔ ผังเก่า ยกเลิกแล้ว

> **ห้ามใช้ผังในบล็อกนี้ต่อสายจริง** ผังที่ใช้ต่อสายวันศุกร์อยู่ใน `สรุปการเชื่อมต่อสำหรับอัปเดตวันศุกร์_RoboMDT.md` และ `ตารางการเชื่อมต่อและบัดกรี_RoboMDT.md`
>
> ผังนี้ขัดกับผังจริงเกือบทุกบรรทัด เช่น I2C ที่นี่เขียน GPIO25/26 แต่ผังจริงคือ GPIO21/22, TFT ที่นี่เขียน CS=GPIO4 แต่ผังจริงคือ CS=GPIO5 และ GPIO4 คือ RST, กล้องที่นี่เขียน RX=GPIO35 แต่ผังจริงคือ GPIO16 ส่วน GPIO35 เป็น Encoder ซ้าย B
>
> เก็บไว้เพื่ออ้างอิงตอนแก้เฟิร์มแวร์ว่าโค้ดเดิมเคยใช้ขาอะไรเท่านั้น

```
ESP32 DevKit 38-Pin — GPIO Pin Assignment (ผังเก่า ยกเลิกแล้ว)
├── I2C Bus (Software I2C) 🆕
│   ├── GPIO 25 → I2C_SDA (PCA9685 → VL53L0X → MPR121)
│   └── GPIO 26 → I2C_SCL
├── Encoder 🆕
│   ├── GPIO 33 → ENC_A_L (Encoder ซ้าย Ch.A)
│   ├── GPIO 32 → ENC_B_L (Encoder ซ้าย Ch.B) — Full Quadrature
│   └── GPIO 27 → ENC_R   (Encoder ขวา Ch.A) — Single Channel
├── มอเตอร์ (TB6612FNG) — ไม่เปลี่ยน
│   ├── GPIO 21 → IN1, GPIO 14 → IN2
│   ├── GPIO 13 → IN3, GPIO 12 → IN4
│   ├── GPIO 22 → PWMA, GPIO 23 → PWMB
├── เซนเซอร์ IR (HW-201) — ไม่เปลี่ยน
│   ├── GPIO 15 → IR ซ้าย
│   └── GPIO 34 → IR ขวา
├── กล้อง Serial (XIAO ESP32S3) — ไม่เปลี่ยน
│   ├── GPIO 35 → RX, GPIO 2 → TX
├── จอ TFT ST7789 (SPI) — ไม่เปลี่ยน
│   ├── GPIO 4 → CS, GPIO 16 → RST, GPIO 17 → DC
│   ├── GPIO 5 → MOSI, GPIO 18 → SCLK, GPIO 19 → BL
├── เซอร์โว → PCA9685 (ไม่ใช้ GPIO ตรงอีก) 🆕
│   ├── CH0 → Head, CH1 → Neck, CH2 → Arm-L      ⛔ ช่องชุดเก่า
│   ├── CH3 → Arm-R, CH4 → Hand-L, CH5 → Hand-R  ⛔ ดูตารางแปลงด้านบน
└── ว่าง (สำรอง): D36, D39, RX, TX
```

### ผังที่ใช้จริง — สรุปย่อ

| กลุ่ม | ขา |
|---|---|
| TB6612 | PWMA=25, AIN1=26, AIN2=27, PWMB=32, BIN1=33, BIN2=14, STBY=3V3 |
| I2C | SDA=21, SCL=22 |
| TFT | SCLK=18, MOSI=23, CS=5, DC=2, RST=4, **MISO ไม่ต่อ** |
| กล้อง XIAO | XIAO D6/GPIO43 → ESP32 GPIO16 (RX2) |
| TCRT5000 | ซ้าย=13, ขวา=17 |
| Encoder | ซ้าย A=34, ซ้าย B=35, ขวา A=36, ขวา B=39 |
| ว่าง | 12, 15 และ 19 ที่ได้คืนจากการไม่ต่อ MISO |

> 📝 **ผังต่อสายฉบับใช้งาน:** `สรุปการเชื่อมต่อสำหรับอัปเดตวันศุกร์_RoboMDT.md`
>
> ⛔ `แผนเสียบสายไฟ_RoboMDT.md` **ยกเลิกแล้วทั้งไฟล์** ทั้งเรื่อง JST-XH (เปลี่ยนเป็นขาพิน + Dupont) และเลขช่อง PCA9685 ที่เป็นชุดเก่า
