HoneyKung/metorobot/Robo/Part Robot/สถานะการสั่งซื้ออุปกรณ์_RoboMDT.md

# 🛒 สถานะการจัดซื้ออุปกรณ์หุ่นยนต์ RoboMDT

> **อัปเดตสถานะล่าสุด:** 30 สิงหาคม 2569  
> **ยืนยันจากผู้ใช้:** PCA9685 มีอยู่แล้วอย่างน้อย 3 เดือน ไม่ต้องซื้อเพิ่ม  
> **ยืนยันจากผู้ใช้เพิ่มเติม:** HW-201 ×2, VL53L0X, MPR121 และแผ่น/เทปทองแดงมีแล้วทั้งหมด  
> **อ้างอิงรายชื่อฉบับเต็ม:** [รายชื่ออุปกรณ์หุ่นยนต์_RoboMDT.md](./รายชื่ออุปกรณ์หุ่นยนต์_RoboMDT.md)

---

## 🛒 รายการที่ **"ต้องสั่งซื้อ"**

ไม่มีรายการอุปกรณ์หลักที่ยืนยันว่าต้องสั่งซื้อเพิ่มในขณะนี้

## รายการที่แก้สถานะแล้ว

| ลำดับเดิม | อุปกรณ์ | สถานะที่ถูกต้อง |
|:---:|---|---|
| 13 | **บอร์ด PCA9685** | มีแล้วอย่างน้อย 3 เดือน ย้ายไปหมวดมีแล้ว |
| 20 | **ขั้วต่อ JST-XH 2.54mm** | ยกเลิกแผนซื้อ รอบปัจจุบันใช้หัว Servo/ขาพินและสายเสียบ |

---

## ✅ รายการที่ **"มีเตรียมไว้เรียบร้อยแล้ว"** (ไม่ต้องซื้อเพิ่ม)

### 🧠 ชุดสมอง หน้าจอ และกล้อง
- [x] **[#1]** ESP32 DevKit V1 (38 Pin)
- [x] **[#2]** XIAO ESP32S3 Sense
- [x] **[#3]** จอ TFT LCD ขนาด 2.8 นิ้ว
- [x] **[#4]** เซนเซอร์ IR HW-201 (×2)
- [x] **[#5]** เซนเซอร์ Laser ToF VL53L0X
- [x] **[#6]** โมดูล Touch Sensor MPR121
- [x] **[#7]** แผ่น/เทปทองแดงสำหรับเซนเซอร์สัมผัส

### 🏎️ ชุดขับเคลื่อนและเซอร์โว
- [x] **[#8]** TT Motor พร้อม Encoder (×2)
- [x] **[#9]** TB6612FNG Motor Driver
- [x] **[#10]** MG996R Servo (×2)
- [x] **[#11]** MG90S Servo (×2)
- [x] **[#12]** SG90 Servo (×2)
- [x] **[#13]** PCA9685 16-Channel PWM Driver (มีแล้วอย่างน้อย 3 เดือน)

### 🔋 ชุดแบตเตอรี่และระบบไฟ
- [x] **[#14]** ถ่าน 18650 VTC6A 3000mAh (×2 ก้อน)
- [x] **[#15]** รังถ่าน 18650 แบบ 2 ก้อน
- [x] **[#16]** บอร์ด BMS 2S 16A
- [x] **[#17]** บอร์ดชาร์จ Li-ion 2S (CM620 2S 2A)
- [x] **[#18]** บอร์ด LM2596 DC-DC Buck Converter
- [x] **[#19]** สวิตช์เปิด-ปิด KCD-105
- [x] **XH-M401** สำหรับทดลองจ่ายไฟ Servo ชั่วคราว (มีแล้ว แต่ไม่เหมาะเป็นตัวถาวรกับแบต 2S)

### 🧰 ชุดสายไฟอเนกประสงค์และอิเล็กทรอนิกส์อื่นๆ (Capacitor)
- [x] **[#21]** สายไฟทนกระแสสูง 20AWG (แดง-ดำ)
- [x] **[#22]** สายแพร/สายไฟเล็กทั่วไป
- [x] **[#23]** ตัวเก็บประจุ 1000µF 16V
- [x] **[#24]** ตัวเก็บประจุ 470µF 16V
- [x] **[#25]** ตัวเก็บประจุ 100µF 16V
- [x] **[#26]** ตัวเก็บประจุ 10µF (แบบเซรามิก)

---

## รายการที่ยังไม่ซื้อ แต่ไม่จำเป็นสำหรับการทดสอบแบบไม่ใช้แบต

| อุปกรณ์ | สถานะ |
|---|---|
| Generic UBEC/BEC 5V 5A ที่รองรับแบต 2S | ยังไม่ซื้อ พิจารณาเมื่อกลับไปใช้แบต ไม่จำเป็นต้องเป็นรุ่น 10A ราคาแพง |
| ฟิวส์และที่ยึดฟิวส์ | ยังไม่ซื้อ ต้องเพิ่มก่อนใช้ระบบแบตเป็นงานถาวร |

---

## 🏗️ โครงสร้างทางกล (สั่งพิมพ์ 3D)
*(ไม่ต้องสั่งซื้ออุปกรณ์สำเร็จ แต่เตรียมไฟล์ไปปริ้นได้เลย)*
- [ ] **[#27]** โครงสร้างตัวถังหุ่นยนต์
- [ ] **[#28]** โครงสร้างแขนและมือจับ
- [ ] **[#29]** โครงหัวหุ่นยนต์ยึดหน้าจอ
