HoneyKung/metorobot/Robo/Part Robot/สถานะการสั่งซื้ออุปกรณ์_RoboMDT_ก่อนแก้PCA.md

# 🛒 สถานะการจัดซื้ออุปกรณ์หุ่นยนต์ RoboMDT

> **อัปเดตสถานะล่าสุด:** ตรวจเช็คตามข้อมูลล่าสุด  
> **อ้างอิงรายชื่อฉบับเต็ม:** [รายชื่ออุปกรณ์หุ่นยนต์_RoboMDT.md](./รายชื่ออุปกรณ์หุ่นยนต์_RoboMDT.md)

---

## 🛒 รายการที่ **"ต้องสั่งซื้อ"** (จัดเตรียมงบกดใส่ตะกร้าได้เลย)

| ลำดับเดิมจากลิสต์เต็ม | อุปกรณ์ | จำนวน | หมายเหตุ | สถานะการซื้อ |
|:---:|---|:---:|---|:---:|
| 4 | **เซนเซอร์ IR HW-201** | 2 ตัว | แจ้งว่ามีแล้วแต่ต้องการซื้อใหม่ | [ ] รอสั่งซื้อ |
| 5 | **เซนเซอร์ Laser ToF VL53L0X** | 1 ตัว | เซนเซอร์ใช้วัดระยะ | [ ] รอสั่งซื้อ |
| 6 | **โมดูล Touch Sensor MPR121** | 1 ตัว | โมดูลเตรียมไว้ทำเซนเซอร์รับสัมผัส | [ ] รอสั่งซื้อ |
| 7 | **แผ่นทองแดง** | 1 แผ่น | เทปทองแดงสำหรับใช้ทำแถบสัมผัสลูบหัว | [ ] รอสั่งซื้อ |
| 13 | **บอร์ด PCA9685** | 1 ตัว | บอร์ดขับ Servo ช่วยประหยัดพิน ESP32 | [ ] รอสั่งซื้อ |
| 20 | **ขั้วต่อสายไฟ JST-XH 2.54mm** | 23 ชุด | แบบย้ำสายมาแล้ว (Pre-Crimped) | [ ] รอสั่งซื้อ |

---

## ✅ รายการที่ **"มีเตรียมไว้เรียบร้อยแล้ว"** (ไม่ต้องซื้อเพิ่ม)

### 🧠 ชุดสมอง หน้าจอ และกล้อง
- [x] **[#1]** ESP32 DevKit V1 (38 Pin)
- [x] **[#2]** XIAO ESP32S3 Sense
- [x] **[#3]** จอ TFT LCD ขนาด 2.8 นิ้ว

### 🏎️ ชุดขับเคลื่อนและเซอร์โว
- [x] **[#8]** TT Motor พร้อม Encoder (×2)
- [x] **[#9]** TB6612FNG Motor Driver
- [x] **[#10]** MG996R Servo (×2)
- [x] **[#11]** MG90S Servo (×2)
- [x] **[#12]** SG90 Servo (×2)

### 🔋 ชุดแบตเตอรี่และระบบไฟ
- [x] **[#14]** ถ่าน 18650 VTC6A 3000mAh (×2 ก้อน)
- [x] **[#15]** รังถ่าน 18650 แบบ 2 ก้อน
- [x] **[#16]** บอร์ด BMS 2S 16A
- [x] **[#17]** บอร์ดชาร์จ Li-ion 2S (CM620 2S 2A)
- [x] **[#18]** บอร์ด LM2596 DC-DC Buck Converter
- [x] **[#19]** สวิตช์เปิด-ปิด KCD-105

### 🧰 ชุดสายไฟอเนกประสงค์และอิเล็กทรอนิกส์อื่นๆ (Capacitor)
- [x] **[#21]** สายไฟทนกระแสสูง 20AWG (แดง-ดำ)
- [x] **[#22]** สายแพร/สายไฟเล็กทั่วไป
- [x] **[#23]** ตัวเก็บประจุ 1000µF 16V
- [x] **[#24]** ตัวเก็บประจุ 470µF 16V
- [x] **[#25]** ตัวเก็บประจุ 100µF 16V
- [x] **[#26]** ตัวเก็บประจุ 10µF (แบบเซรามิก)

---

## 🏗️ โครงสร้างทางกล (สั่งพิมพ์ 3D)
*(ไม่ต้องสั่งซื้ออุปกรณ์สำเร็จ แต่เตรียมไฟล์ไปปริ้นได้เลย)*
- [ ] **[#27]** โครงสร้างตัวถังหุ่นยนต์
- [ ] **[#28]** โครงสร้างแขนและมือจับ
- [ ] **[#29]** โครงหัวหุ่นยนต์ยึดหน้าจอ
