HoneyKung/metorobot/Robo/Part Robot/สเปกจอ_MSP2806_จากแบบโรงงาน.md

# จอ 2.8" SPI ILI9341 + SD — ขนาดจากแบบโรงงาน (LCDWiki MSP2806/MSP2807 LCM OUTLINE V1.0 2024-04-11)

ไฟล์ต้นฉบับ: `แบบโรงงาน/MSP2806_Size.pdf` (ไม่มีทัช) · `แบบโรงงาน/MSP2807_Size.pdf` (มีทัช) · ค่าคลาดเคลื่อน ±0.2

| รายการ | ค่า (mm) |
|---|---|
| PCB | 50.00 × 86.00 · หนา 1.60 |
| กรอบจอ (LCD BL) | 50.00 × 69.20 (±0.2) |
| พื้นที่ภาพ (AA) | 43.20 × 57.60 |
| AA ห่างขอบ PCB ด้านยาว | 3.40 (ข้างหนึ่ง) |
| ขอบบน (ฝั่ง J4 4 ขา SD): PCB→รู 3.00 · →กรอบจอ 9.30 · →AA 6.40+9.30 | ดูภาพแบบ |
| รูยึด 4 รู | Ø3.20 (แผ่นทองแดง Ø4.70) · ระยะศูนย์ 44.00 × 76.08 · รูห่างขอบ PCB 3.00 |
| หัวพินหลัก | 14 ขา 2.54 (13×2.54 = 33.02) ขอบล่างด้านสั้น · ขาแรกห่างขอบ PCB 8.49 · ห่างขอบล่าง 2.00 |
| หัวพิน J4 (SD) | 4 ขา (3×2.54 = 7.62) ขอบบน ห่างขอบขวา 21.19 |
| ความหนารวมไม่รวมหัวพิน | 4.40 ±0.2 (จอ 2.30 + เทป 0.50 + PCB 1.60) · ชิ้นส่วน SMD หลังบอร์ด ≤ 2.20 |
| หัวพิน (ชี้ไปด้านหลัง) | สูง 11.17 · **รวมทั้งหมด 12.78** (เจ้าของบัดกรีหัวพินแล้ว #194) · + หัว Dupont เผื่อเพิ่ม |
| ช่อง SD | ด้านหลัง ห่างขอบบน 39.33 |

## แก้ 5 พ.ย. (#355 #357) — ตรวจหลังบอร์ดใหม่จากเวกเตอร์ใน MSP2806_Size.pdf (สเกล 6.482 pt/mm)
ภาพ Back (มองจากหลัง ตั้งแนวตั้ง ขอบบน = ฝั่ง J4 · ขอบล่าง = หัวพิน 14 ขา) · bx = ระยะจากขอบซ้ายของภาพหลัง · by = ระยะจากขอบบน
| ชิ้น | bx | by | หมายเหตุ |
|---|---|---|---|
| **ช่อง SD (ซ็อกเก็ต)** | 30.1–49.2 (กว้าง 19.1 · ห่างขอบขวา 0.8) | 24.6–54.0 (ยาว 29.4 · ศูนย์ 39.33 ตรงกับเลขในแบบ) | ปากช่องอยู่ขอบยาวฝั่งขวาของภาพหลัง · ความสูงซ็อกเก็ตแบบไม่บอก |
| IC (U) | 11.6–16.6 | 61.0–64.9 | |
| ชิ้นเล็ก R/C/Q | 8.8–30.3 | 37–78 กระจาย | ≤ 2.20 (SMD max) |
| แพด J4 | 20.5–27.0 | 2.2–3.8 | |
| ฐานพลาสติกหัวพิน 14 ขา | — | 82.7–85.3 (แถวพิน 84.0) | อยู่หลังบอร์ด |
**ผิดเดิม:** ร่างก่อนวาง SD ไว้ชิดขอบ J4 (ด้านสั้น) — จริงอยู่ชิดขอบยาว ช่วงกลางบอร์ด
**ในพิกัดหัว (แนวนอน PCB x −44.5..41.5 · z −6.5..43.5 · หัวพินอยู่ +x):** SD x −19.9..9.5 · z −5.7..13.4 · ปากช่องหันลง (z −6.5)
**ข้อกำหนดตัวจับจอ:** หลังบอร์ดแตะชิ้นพิมพ์ได้แค่ผิวบอส 4 จุด · ที่เหลือเว้น ≥ 3.5 จากหลัง PCB (ซ็อกเก็ต SD สูงไม่ระบุ เผื่อแบบ SD เต็ม ~3.0) · บอสฝั่งหัวพิน (x 34.58) ต้องไม่ล้ำ x 37.9 (ฐานหัวพิน/หัว Dupont เริ่ม x 38.23 เผื่อ 0.3)

## ค้นสเปกจอจริง (5 พ.ย. #389)
- หาแบบขนาดของบอร์ดแดง "2.8" TFT 240xRGBx320 V1.1" ตรงรุ่นไม่เจอ · LCDwiki MSP2807 (รุ่นมีทัช) ระบุแค่ PCB 50×86 ไม่มีตำแหน่งรูในหน้าเว็บ · แบบ PDF MSP2807 (V1.2) รูห่าง 76.08×44 ห่างขอบ 3.00 / 6.92 เหมือน MSP2806
- **ตำแหน่ง SD ในแบบ MSP2807 ตรงกับภาพจริง** (ขอบยาว ห่างขอบหัวพิน ~32–61 · ภาพประมาณ 29–64)
- **แต่ระยะรูฝั่งหัวพินไม่ตรง:** แบบโรงงาน 6.92 จากขอบ · ภาพจริงประมาณ 3.5 (รูอยู่ติดแถวหัวพิน) = ที่เจ้าของบอก "รูยอตไม่ตรงกับดาต้าชีท"
- โค้ดใช้ไดรเวอร์ ST7789 และจอติด แต่แบบ MSP2807 เป็น ILI9341 → บอร์ดจริงน่าจะเป็นอีกรุ่นที่หน้าตาคล้ายกัน
- ตัวจับจอรุ่นปากเกี่ยว: ฝั่งหัวพินไม่ใช้รู ฝั่ง J4 ใช้รูห่างขอบ 3.0 (ตรงกันทั้งแบบโรงงานและแผ่นเดิมของเจ้าของ) · ระยะ z ทำเป็นรูรี 43.8–44 → ไม่ต้องใช้ค่าที่ยังไม่แน่
