HoneyKung/metorobot/Robo/Part Robot/สเปกชั้น1_v2_2026-11-02.md

# สเปกชั้น 1 v2 (ฐาน) — 2 พ.ย. 2569 04:13

คำเจ้าของ: "กำหนด สเปค ชั้น 1 มา" · ที่มา: `บันทึกการคุย_METO.md` (ตารางคำตัดสินที่ล็อก), คู่มือต่อสาย 6 ก.ย. (`คู่มือต่อสาย_ล้อ_จอ_กล้อง_WAGO221_XT30_RoboMDT.md`), แบบปัจจุบัน `stl3dprint/ชั้น1.stl`
ป้าย: **[ล็อก]** = เจ้าของตัดสินแล้ว (เลขข้อความในบันทึก) · **[เอกสาร]** = จากคู่มือ/ไฟล์ · **[ข้อเสนอของผม]** = ยังไม่ได้รับ · **[ต้องวัด]**

## 1. ของในชั้น 1 [ล็อก #77 #78 #99]
| ชิ้น | ขนาด (mm) | ที่มาขนาด | ตำแหน่ง |
|---|---|---|---|
| รางถ่าน BH-18650x2-M (ใส่ถ่าน) | 76 × 41 × 20 | [เอกสาร] แผนผังชั้นอุปกรณ์ | กลาง ตามช่องเดิมในชั้น1.stl [ล็อก #2] |
| มอเตอร์ TT encoder 1:90 × 2 | ~70 (+encoder ~10) × 22 × 18 | [เอกสาร] · ค่า D **[ต้องวัด]** | ขนาบรางถ่าน ตามช่องเดิม · เพลาอยู่ด้านหลัง [ล็อก #77 ล้อขับหลัง] |
| BMS 2S 16A | ~47 × 23 × 3 (+สาย) | [เอกสาร] · หนารวมสาย **[ต้องวัด]** | **ยังไม่กำหนด** — ดูข้อ 4 |
| กระบอกฟิวส์ + สายฟิวส์ 18AWG | ฐาน 5×20: ~39 × Ø8 + สายสองปลาย | [เอกสาร] ผลค้น (OptiFuse LPC) · ของจริง **[ต้องวัด]** | **ยังไม่กำหนด** — ใกล้ BMS (สาย P01 สั้น) [เอกสาร คู่มือข้อ 2] |
| XT30 (ฝั่งแบต + ฝั่งหุ่น) | ตัวละ ~13 × 5.6 × 10.2 · คู่เสียบ **[ต้องวัด]** | [เอกสาร] AMASS | **ยังไม่กำหนด** — ต่อจากฟิวส์ ถอดชุดแบตได้ [เอกสาร คู่มือข้อ 2] |
| VL53L0X (GY-530) | ~13.3 × 10.5 + หัวพิน | [เอกสาร] ผลค้น | บอร์ด **ตั้งแนบผนังหน้า** มองผ่าน **รูกลางหน้าสุด** (มีในแบบ METO) [ล็อก #78 #80] · ของต้องห่าง ≥50 [เอกสาร ปัญหาฮาร์ดแวร์ 6.4] |
| IR กันตก HW-201 × 2 | ~32 × 14 × 7 | [เอกสาร] | **บอร์ดนอนราบ หันเซนเซอร์ลงพื้น (ลำแสงแนวตั้ง) ด้านยาวไปตามความยาวตัว** ด้านหน้าซ้าย/ขวา [ล็อก #89 #111 #113 — เดิมหัวงานเขียนผิดว่าตั้งบอร์ด] · รูไขควงปรับความไว [ล็อก #37] · ล้ำหน้าลูกล้อ ≥25 [ข้อเสนอของผม จากคำนวณเบรก] |
| ลูกล้ออิสระ × 2 | ลูก Ø12 พิมพ์เอง (ชิ้นทดสอบ caster_lite) | [ข้อเสนอของผม] | **ข้างตัว ด้านหน้า ซ้าย/ขวา ไม่อยู่ใต้ท้อง** [ล็อก #77 #79 #88] |
| ล้อขับ × 2 | Ø41 × 12 PETG | [ล็อก #7 #64] | **หลัง** นอกตัว [ล็อก #77] |

ไม่อยู่ชั้น 1: LM2596 [ล็อก #89] · สวิตช์ WAGO TB6612 CM620 (ชั้น 2) [ล็อก #94]

## 2. ขนาดและรูปทรง
- กว้างตัว ~96 (มอเตอร์-ถ่าน-มอเตอร์ ชิดกัน) [เอกสาร #35] · ล้ออยู่นอก
- ยาว: เดิม 148 เพราะตีนตะขาบ · ใหม่ใกล้ชั้นบน (~112) **[ข้อเสนอของผม]** · ห้ามให้ฐานยาวกว่าชั้นบนจนกระเป๋าหลังโล่ง [#35]
- สูง: เดิม 29 (พื้นช่องถ่าน 3) · **ห้ามสูงขึ้นถ้าไม่จำเป็น** — ถ้า BMS วางบนถ่าน เหลือระยะ ~0 [คำตอบข้อ #89]
- ใต้ท้อง 5–10 mm [ล็อก #4 #8] · ลูกล้อตั้งสูงกว่าล้อขับ ~0.5 [ข้อเสนอของผม]
- หน้าทรงรับคางหมูชั้นบน [ล็อก #30] · ส่วนยื่นหน้าที่ปิดเซนเซอร์กันตกต้องเช็กระยะเบรก [#35]

## 3. สาย (คู่มือ 6 ก.ย.) [เอกสาร]
| สาย | ปลายอีกด้าน | ทาง |
|---|---|---|
| ถ่าน→BMS, P01 BMS P+→ฟิวส์, P02 ฟิวส์→XT30+, P03 BMS P-→XT30- (18AWG) | ในชั้น 1 | ชุดแบตถอดได้ |
| P04 XT30+ ฝั่งหุ่น→สวิตช์, P06 XT30- →W2 (18AWG) + สายชาร์จ CM620 | ชั้น 2 | **รูสายไฟใหญ่** |
| M09–M12 TB6612→มอเตอร์ (20AWG 4 เส้น) | ชั้น 2 | **รูสายมอเตอร์** |
| encoder 2×(VCC GND A B), IR 2×(VCC GND OUT), VL53 (VCC GND SDA SCL) | ESP32 ชั้น 3 | **รูสายสัญญาณ** แยกฝั่งจากสายมอเตอร์ |
- รางกดสาย (wire_floor/wire_wall ในชุดเบา) · จุดรัด/เก็บสาย · เผื่อตัวเก็บประจุและหัว Dupont [ล็อก #28]
- ตารางความยาวสายจากแบบ 3D [ล็อก #37]

## 4. จุดวาง BMS / ฟิวส์ / XT30 — งานหัวงาน ยังไม่ได้ข้อสรุป
- ข้อจำกัด: อยู่ชั้น 1 [ล็อก #99] · ฟิวส์ใกล้ BMS [เอกสาร] · ไม่ย้ายช่องถ่าน/มอเตอร์เดิม
- ทางที่เป็นไปได้ **[ข้อเสนอของผม — รอเจ้าของเลือก]**: ก) BMS บนรางถ่าน (สูงไม่เพิ่ม ระยะ ~0 ต้องวัด BMS) + ฟิวส์/XT30 โซนหน้ารางถ่าน · ข) BMS ตั้งแนวตั้งในโซนหน้ารางถ่าน + ฟิวส์/XT30 ข้าง ๆ

## 5. โครงสร้าง
- ฐานแบน พิมพ์ไม่ใช้ซัพพอร์ต 1–3 ชม. [ล็อก #56] · ไม่มีตัวอักษร [ล็อก #71]
- ยึดของไม่ใช้สกรู [ล็อก #10] · ครีบบีบ/ขอเกี่ยว [ข้อเสนอของผม]
- ขอบบนรับซ้อนชั้น 2 แบบปิ่นโต + จุดรับหัวเข็มขัดชิ้นแยก [ล็อก #13]
- เสาแท่งเกลียว M6/M8 นอกตัว หลัง 2 หน้า 1–2 [ล็อก #30 #32 #41] · ต้นหน้าเช็กแนวกวาดแขน
- ร่องรับขอบล่างเปลือก (ผ่าหน้า/หลัง) [ล็อก #44 #45]
- ถอดชุดแบตได้โดยไม่รื้อชั้นบน [เอกสาร]

## 6. ต้องวัด
TT ค่า D (+ H รูยึด, G เพลา) · BMS หนารวมสาย · กระบอกฟิวส์จริงรวมสาย · XT30 คู่เสียบ · IR HW-201 จริง
