HoneyKung/metorobot/Robo/Part Robot/สเปกเซอร์โว_Luna_2026-11-02.md

# สเปกเชิงมิติ MG996R / MG90S / SG90

> ขอบเขต: ยึดรุ่น TowerPro เป็นฐานเมื่อมีเอกสารจากผู้ผลิตหรือดาต้าชีตที่ระบุรุ่นชัดเจน ตัวเลขบนเซอร์โวชื่อเดียวกันอาจต่างตามผู้ผลิต/ล็อต โดยเฉพาะรุ่นจีนทั่วไป จึงไม่ถือว่าเลขจาก CAD ชุมชนเป็น tolerance หรือ drawing รับรองการผลิต ทุกค่าที่ไม่มีแหล่งยืนยันระบุว่า “ไม่พบ”

## ตารางเทียบ

หน่วยมิติเป็นมิลลิเมตร (mm) เว้นแต่ระบุเป็นอย่างอื่น; ในช่องตัวเลขแนบ URL ของแหล่งที่ให้ตัวเลขโดยตรง

| รายการ | MG996R | MG90S | SG90 |
|---|---|---|---|
| ขนาดตัว ไม่รวมหู (ยาว × กว้าง × สูง) | ประมาณ 40.7 × 19.7 × 42.9; ดาต้าชีตไม่ได้แยกนิยามขอบเขตตัว/หูในข้อความ [TowerPro MG996R datasheet](https://www.electronicoscaldas.com/datasheet/MG996R_Tower-Pro.pdf) | 22.8 × 12.2 × 28.5 [TowerPro ผู้ผลิต](https://towerpro.com.tw/product/mg90s-3/) | 22.2 × 11.8 × 31 (ประมาณ; เป็นขนาดรวมตามเอกสาร SG90) [SG90 datasheet สำเนาบน mbed](https://os.mbed.com/media/uploads/dfraj/sg90servo.pdf) |
| ระยะหูถึงหู / ความยาวรวมส่วนหู | 48.0 (ค่า lh ในชุดมิติที่เผยแพร่พร้อมอ้าง datasheet; คำอธิบายตัวแปรไม่ชัด) [AranaCorp ตารางมิติ](https://www.aranacorp.com/en/servomotors-list/) | 32.1 (ค่า E ในตารางผู้ผลิต; โดยทั่วไปเป็นมิติรวมตามภาพประกอบ แต่หน้าเว็บไม่ให้ legend อธิบาย) [TowerPro ผู้ผลิต](https://towerpro.com.tw/product/mg90s-3/) | 32.2 (ภาพวาดใน datasheet; ปรากฏเป็นมิติยาวรวม) [SG90 datasheet สำเนาบน mbed](https://os.mbed.com/media/uploads/dfraj/sg90servo.pdf) |
| ความหนาหู | ไม่พบ | ไม่พบ | ไม่พบ |
| ระดับผิวหูจากก้นตัว | ไม่พบ | 18.5 (ค่า F ในตารางมิติผู้ผลิต; legend ของตัวแปรไม่อยู่ในข้อความหน้าเว็บ) [TowerPro ผู้ผลิต](https://towerpro.com.tw/product/mg90s-3/) | 16 (ภาพวาด datasheet แสดงระยะจากก้นถึงแนวใต้หู) [SG90 datasheet สำเนาบน mbed](https://os.mbed.com/media/uploads/dfraj/sg90servo.pdf) |
| ตำแหน่ง/ระยะศูนย์รูหู | 10.15 (ค่า a; แหล่งรองที่ถอดแบบจากภาพ datasheet) [AranaCorp ตารางมิติ](https://www.aranacorp.com/en/servomotors-list/) | ไม่พบ | ไม่พบ |
| ขนาดรูยึดหู | ไม่พบ | ไม่พบ | ไม่พบ |
| ความสูง spline เหนือผิวบนตัว | ไม่พบใน drawing ผู้ผลิตที่ค้นได้ | ไม่พบใน drawing ผู้ผลิตที่ค้นได้ | ไม่พบใน drawing ผู้ผลิตที่ค้นได้ |
| ระยะศูนย์แกนจากขอบตัว | 10.0 (ค่า dh ในชุดมิติที่อ้างอิง datasheet) [AranaCorp ตารางมิติ](https://www.aranacorp.com/en/servomotors-list/) | 0.0 (ค่า dh ในชุดมิติที่อ้างอิงหน้า TowerPro) [AranaCorp ตารางมิติ](https://www.aranacorp.com/en/servomotors-list/) | ไม่พบ |
| จำนวนฟัน spline / ขนาด spline | 25T; เส้นผ่านศูนย์กลาง/รูปฟัน spline ไม่พบใน datasheet [HobbyKing รายการ TowerPro MG996R](https://api.hobbyking.com/en_us/towerpro-mg996r-10kg-servo-10kg-0-20sec-55g.html) | 20T ตามฐานข้อมูลผู้ใช้หนึ่งแห่ง; TowerPro ไม่ระบุจำนวนฟันหรือขนาดในหน้าผู้ผลิต จึงควรนับ/ทดลองกับฮอร์นจริงก่อนทำชิ้นส่วน [ServoDatabase MG90S](https://servodatabase.com/servo/towerpro/mg90s) | 21T สำหรับ SG90 แบบ M5Stack-customized; datasheet TowerPro ที่พบไม่ระบุ จึงไม่รับรองว่า SG90 ทุกรุ่นใช้เหมือนกัน [M5Stack SG90 datasheet](https://m5stack.oss-cn-shenzhen.aliyuncs.com/resource/docs/static/pdf/static/en/accessory/sg90_servo.pdf) |
| ฮอร์นมาตรฐาน / สกรูยึดแกน | มีฮอร์นและอุปกรณ์ในชุด; รูปแบบฮอร์นมาตรฐานและสกรูยึดแกนไม่ระบุใน datasheet ที่พบ แม้มีหลักฐาน 25T ของ spline [MG996R datasheet](https://www.electronicoscaldas.com/datasheet/MG996R_Tower-Pro.pdf) | ผู้ผลิตระบุแถมแขนฮอร์นและสกรู; ขนาด/ชนิดสกรูยึดแกนและแบบฮอร์นมาตรฐานไม่พบ [TowerPro ผู้ผลิต](https://towerpro.com.tw/product/mg90s-3/) | แถมฮอร์น 3 แบบและ hardware; ขนาด/ชนิดสกรูยึดแกนและแบบฮอร์นมาตรฐานไม่พบ [SG90 datasheet](https://os.mbed.com/media/uploads/dfraj/sg90servo.pdf) |
| สายออกทางไหน | ไม่พบคำอธิบายตำแหน่งทางออกในข้อความ datasheet | ไม่พบคำอธิบายตำแหน่งทางออกในหน้า datasheet ผู้ผลิต | ภาพประกอบแสดงสายออกด้านท้ายของตัว แต่ไม่มีมิติ/ข้อความระบุตำแหน่ง [SG90 datasheet](https://os.mbed.com/media/uploads/dfraj/sg90servo.pdf) |
| แบบ CAD / ไฟล์ที่แชร์ | Printables มีโมเดล “Lafvin MG996R” ที่ผู้สร้างระบุว่าเป็น Lafvin จึงเป็นแบบของรุ่นจีน/Lafvin ไม่ใช่ TowerPro และหน้า listing ที่ค้นได้ไม่ยืนยันมิติเทียบชิ้นงาน [Printables](https://www.printables.com/model/840054-lafvin-mg996r) | GrabCAD มี “MG90S micro servo” format STEP; ผู้สร้างกล่าวว่าอิง TowerPro และกล่าวถึงสำเนาจีนที่มิติอาจต่าง [GrabCAD ผ่านดัชนีโมเดล](https://polyzon.org/en/model/grabcad/gc-mg90s-micro-servo-2?r=V3r2HUQDOJ4qBX19) | GrabCAD มี “SG90 - Micro Servo 9g - Tower Pro” ระบุไฟล์ STEP และโมเดลพร้อมฮอร์น [GrabCAD ผ่านดัชนีโมเดล](https://www.stlfinder.com/model/sg90-micro-servo-9g-tower-pro-oshfgK3Y/7938225); มี STL แบบประมาณการใน GitHub [cadmodel-sg90](https://github.com/ledalert/cadmodel-sg90) |
| จีนทั่วไปต่างจาก TowerPro แค่ไหน | ไม่พบการวัดเทียบแบบควบคุมรุ่นต่อล็อต แหล่งผู้ผลิตเตือนว่ามีสินค้าปลอม/คุณภาพต่ำ แต่ไม่ได้ให้ค่าความต่างเชิงมิติ [TowerPro MG90S page กล่าวถึง counterfeit; ไม่มีตัวเลข MG996R](https://towerpro.com.tw/product/mg90s-3/) | ผู้ผลิต TowerPro เตือนว่ามีของปลอมจากผู้ขายจีน; ผู้ใช้รายงานว่าโคลน MG90S บางตัวมีส่วนยื่นทรงกระบอกประมาณ 4 แทน 6 และช่องว่างด้านบนต่างจากตัวอย่างที่วัด—เป็นรายงานชิ้นตัวอย่าง ไม่ใช่ค่าความต่างสากล [TowerPro](https://towerpro.com.tw/product/mg90s-3/) · [รายงานชุมชน Reddit](https://www.reddit.com/r/robotics/comments/8ufl2x/tower_pro_mg90s_micro_servo_dimension_diagram/) | ไม่พบการวัดเทียบจีนทั่วไปกับ TowerPro แบบยืนยันรุ่นและล็อต; ขนาด 22.2 × 11.8 × 31 ในสำเนา datasheet เป็นค่า TowerPro อ้างอิง ไม่ใช่สเปกของ SG90 ทุกยี่ห้อ [SG90 datasheet](https://os.mbed.com/media/uploads/dfraj/sg90servo.pdf) |

## หมายเหตุการใช้ตัวเลข

- สำหรับ MG90S หน้า TowerPro แสดงมิติ A–F แต่ข้อความหน้าเว็บไม่อธิบาย legend ของแต่ละตัวอักษรครบ; ค่าระยะหู/ระดับหูข้างต้นจึงคง label ที่ผู้ผลิตเผยแพร่ และไม่ตีความเป็น drawing manufacturing ที่มี tolerance
- มิติ MG996R 40.7 × 19.7 × 42.9 เป็นขนาดโดยประมาณจาก datasheet; ค่าเสริมจาก AranaCorp เป็นการถอดมิติรองและไม่ควรแทนแบบผู้ผลิต
- รายการ spline ของไมโครเซอร์โวขัดแย้งกันตามผู้ขาย/ผู้ทำฐานข้อมูล: MG90S พบทั้ง 20T และ 21T ตามแหล่งที่ค้น; SG90 แบบ M5Stack ระบุ 21T แต่ไม่เท่ากับการรับรอง TowerPro ทุก revision ให้ตรวจนับฟันของแกนและทดสอบฮอร์นจริงก่อนออกแบบ fit
- ไม่พบแหล่งที่ระบุความสูง spline เหนือฝาบนอย่างชัดเจนสำหรับทั้งสามรุ่น ไม่อนุมานจากความสูงรวมของเซอร์โวหรือไฟล์ CAD ชุมชน
- ตรวจแบบ STEP/STL จากชุมชนกับชิ้นงานจริงก่อนใช้ทำเบ้าฟิตแน่น เพราะผู้สร้างระบุว่าเป็นแบบจำลอง/สำเนาหรือ approximate และไม่ใช่ไฟล์ CAD ควบคุมจากผู้ผลิต
