HoneyKung/metorobot/Robo/Part Robot/แผนจัดซื้อและประเมินกำลังไฟ_RoboMDT.md

# แผนจัดซื้อและประเมินกำลังไฟ RoboMDT

อัปเดต: 30 สิงหาคม 2026  
สถานะ: ใช้เป็นแผนจัดซื้อสำหรับระบบจริงหลังการทดสอบวันศุกร์  
เอกสารฐานหลัก: `ตารางการเชื่อมต่อและบัดกรี_RoboMDT.md` ฉบับล่าสุด ไม่ใช้ไฟล์ต่อแบบเร่งด่วนวันศุกร์เป็นฐานคำนวณ

## 1. ข้อสรุปสั้นที่สุด

อุปกรณ์หลักของหุ่นมีครบแล้ว รวมถึง PCA9685, HW-201 จำนวน 2 ตัว, VL53L0X, MPR121 และแผ่น/เทปทองแดง จึงไม่ควรซื้อซ้ำ

สิ่งที่ควรซื้อสำหรับทำระบบแบตเตอรี่ให้เป็นงานถาวรมีเพียง 2 กลุ่มหลัก:

1. ตัวแปลงไฟ 2S เป็น 5.0V ที่รับอินพุตได้ตลอดช่วงประมาณ 6.0–8.4V และจ่าย 5A ต่อเนื่องได้จริง จำนวน 1 ตัว
2. ชุดฟิวส์รถยนต์แบบใบมีด 7.5A พร้อมฐานฟิวส์ จำนวน 1 ชุด และฟิวส์สำรอง 1–2 ตัว

ถ้าต้องการถอดชั้นแยกโดยไม่ตัดสาย ให้เพิ่มขั้วต่อกำลัง 2 ขา เช่น XT30 จำนวน 2–3 คู่ แต่เป็นรายการเพื่อความสะดวก ไม่ใช่เงื่อนไขที่ทำให้วงจรทำงานได้

งบขั้นต่ำที่สมเหตุผลอยู่ประมาณ **250–550 บาท** ไม่จำเป็นต้องซื้อ UBEC ราคา 750–1,000 บาท และไม่จำเป็นต้องซื้ออุปกรณ์หลักอื่นซ้ำ

## 2. สถานะของที่มีแล้วและไม่ต้องซื้อ

อ้างอิงสถานะจาก `สถานะการสั่งซื้ออุปกรณ์_RoboMDT.md` ฉบับปัจจุบัน

| รายการ | สถานะ | ข้อสรุปจัดซื้อ |
|---|---|---|
| ESP32 และ XIAO ESP32-S3 | มีแล้ว | ไม่ซื้อซ้ำ |
| PCA9685 | มีแล้วนานประมาณ 3 เดือน | ไม่ซื้อซ้ำ |
| MG996R 2 ตัว, MG90S 2 ตัว, SG90 2 ตัว | มีแล้ว | ไม่ซื้อเพิ่มก่อนทดสอบโหลดจริง |
| TB6612FNG | มีแล้ว | ใช้ก่อน แต่ต้องวัดกระแสมอเตอร์จริง |
| มอเตอร์ล้อ 2 ตัว | มีแล้ว | ไม่ซื้อเพิ่ม |
| TFT, กล้อง และเซนเซอร์ | มีแล้ว | ไม่ซื้อเพิ่ม |
| HW-201 จำนวน 2 ตัว | มีแล้ว | ไม่ซื้อใหม่ |
| VL53L0X | มีแล้ว | ไม่ซื้อ |
| MPR121 | มีแล้ว | ไม่ซื้อ |
| แผ่น/เทปทองแดง | มีแล้ว | ไม่ซื้อ |
| VTC6/VTC6A 18650 จำนวน 2 ก้อน, รางถ่าน, BMS 2S 16A | มีแล้ว | ไม่ซื้อเพิ่มจนกว่าจะทดสอบแบตและแรงดันตก |
| CM620, LM2596, XH-M401 และสวิตช์ 2 ขา | มีแล้ว | เก็บไว้ใช้ตามหน้าที่ แต่ไม่ใช่แหล่งจ่าย 5V หลักของเซอร์โวในระบบถาวร |
| สายไฟและคาปาซิเตอร์ | มีแล้ว | ใช้ของเดิมก่อน |

## 3. รูปแบบโหลดที่ใช้คำนวณ

โหลดสูงสุดที่ตั้งใจให้เกิดระหว่างการใช้งานปกติคือ:

- MG996R จำนวน 2 ตัวเคลื่อนพร้อมกัน
- MG90S และ SG90 ไม่จำเป็นต้องเคลื่อนพร้อม MG996R; ให้ขยับทีละกลุ่มตามโค้ด ส่วนตัวที่ไม่ได้ขยับยังคงกินกระแสค้างตำแหน่ง
- มอเตอร์ล้อ 2 ตัวทำงานพร้อมกัน
- ESP32 หลัก, บอร์ดกล้อง, PCA9685, จอ และวงจรลอจิกเปิดอยู่

นี่คือ “โหลดใช้งานสูงตามแผน” ไม่ใช่ “กรณีทุกมอเตอร์ติดขัดพร้อมกัน” เพราะกรณีติดขัดเป็นความผิดปกติและไม่ควรแก้ด้วยการซื้อแหล่งจ่ายที่ใหญ่จนจ่ายกระแสสตอลล์ได้ไม่จำกัด

## 4. ค่ากระแสเซอร์โว

### 4.1 ค่าที่มีข้อมูลรองรับ

ตัวเลือกที่ซื้อจริงระบุเพียง **MG996R 0–180° เฟืองโลหะ จำนวน 2 ตัว** แต่ไม่ได้ยืนยันว่าเป็น TowerPro ของแท้ จึงใช้สเปก TowerPro เป็นค่าอ้างอิง ไม่ใช่ใบรับรองของสินค้าที่ได้รับจริง ผู้ผลิต TowerPro ระบุช่วง 4.8–6.6V, กระแสไม่มีโหลด 170mA และกระแสสตอลล์ 1.4A ต่อหนึ่งตัว ดังนั้นค่าพีกตามสเปกอ้างอิงของสองตัวคือ 2.8A แต่สินค้าทั่วไปที่ใช้ชื่อ MG996R อาจต่างจากนี้ ต้องวัดกับตัวจริงก่อนใส่ค่าผลทดลองในรายงาน

ตัวเลือกที่ซื้อจริงของ MG90S คือ **AEI.th MG90S เฟืองโลหะ** ไม่ใช่สินค้าที่มีหลักฐานว่าเป็น TowerPro จึงเก็บสเปก TowerPro เฉพาะเป็นค่าเทียบ: 4.8V, แรงบิดสตอลล์ 1.8kg·cm, ความเร็ว 0.10s/60° และมิติ 22.8×12.2×28.5mm ห้ามนำค่ากระแสของ TowerPro หรือร้านอื่นมาเขียนเป็นค่ารับรองของ AEI.th

SG90 ที่เลือกเป็นแบบกำหนดตำแหน่ง **180°** ไม่ใช่ continuous rotation 360° แต่หน้าร้านไม่ได้ให้สเปกกระแสที่ตรวจสอบย้อนกลับถึงผู้ผลิตได้ จึงต้องวัดกระแสจริงเช่นเดียวกัน

### 4.2 ประมาณการสำหรับ RoboMDT

| สถานการณ์ | MG996R x2 | MG90S/SG90 ที่ไม่ได้ขยับ | MG90S หรือ SG90 ที่ขยับทีละกลุ่ม | รวมรางเซอร์โว 5V |
|---|---:|---:|---:|---:|
| เปิดค้าง/ขยับเบา | 0.34–0.8A | 0.1–0.4A | 0A | ประมาณ 0.5–1.2A |
| ยกแขนสองข้างพร้อมล้อทำงาน | 1.2–2.0A | 0.1–0.4A | 0A | ประมาณ 1.3–2.4A |
| ยกแขนและขยับไมโครเซอร์โวหนึ่งกลุ่ม | 1.2–2.0A | 0.1–0.3A | เผื่อ 0.3–1.0A จนกว่าจะวัด | ประมาณ 1.6–3.3A |
| กระชากสั้น/ใกล้สตอลล์ | 2.8A ตามสเปกอ้างอิง; ของ generic อาจสูงกว่า | ยังไม่ทราบ | ยังไม่ทราบ | ออกแบบให้แหล่งจ่ายรับช่วงสั้นได้อย่างน้อย 5A |

ดังนั้นใช้ **2.5A ที่ 5V เป็นงบกระแสใช้งานสูงตามแผน** และ **5A เป็นขนาดแหล่งจ่ายต่อเนื่องที่มีเผื่อกระชาก** ได้โดยไม่อ้างว่าตัวเซอร์โวกิน 5A ตลอดเวลา ค่าที่จะลงเป็นผลทดลองต้องมาจากการวัดของจริง

ข้อกำหนดที่เหมาะสมจึงเป็นตัวแปลง **5V 5A ต่อเนื่อง** ไม่ใช่ 3A และไม่จำเป็นต้องขยับไปถึง 8–10A ถ้าโค้ดไม่สั่งเซอร์โวทั้งหกตัวพร้อมกันและกลไกไม่ติดขัด

## 5. กระแสมอเตอร์ล้อและข้อจำกัดของ TB6612FNG

ยืนยันมอเตอร์จริงแล้วว่าเป็น TT Motor Encoder 13PPR รุ่น 1:90, 6V 175RPM จำนวน 2 ตัว ร้านระบุกระแสไม่มีโหลดไม่เกิน 0.2A และกระแสสตอลล์ประมาณ 1.2A ต่อมอเตอร์ ดังนั้นสองตัวมีค่ารวมไม่เกิน 0.4A เมื่อไม่มีโหลด และประมาณ 2.4A เมื่อสตอลล์พร้อมกัน

TB6612FNG ตามข้อมูล Toshiba รองรับกระแสเฉลี่ย 1.2A ต่อช่อง และกระแสพีก 3.2A ต่อช่องในเงื่อนไขช่วงสั้นตามเอกสาร ไม่ได้หมายความว่าสามารถจ่าย 3.2A ต่อเนื่องได้

ผลต่อแผนจัดซื้อ:

- ไม่ต้องซื้อไดรเวอร์มอเตอร์ใหม่ เพราะ TB6612 ตรงกับมอเตอร์ชุดนี้
- ต้องวัดกระแสของมอเตอร์แต่ละตัวเมื่อยกล้อลอย, เมื่อลงพื้น และช่วงเริ่มหมุน เพื่อยืนยันว่ากลไกไม่ฝืด
- ห้ามจับเพลาหรือล็อกล้อค้างนานเพื่อวัดสตอลล์ เพราะมอเตอร์และ TB6612 อาจร้อนหรือเสียหาย
- ถ้ากระแสต่อเนื่องของมอเตอร์ตัวใดเข้าใกล้ 1.2A แสดงว่ามอเตอร์เกือบสตอลล์ ต้องแก้กลไก น้ำหนัก หรือล้อก่อนพิจารณาเปลี่ยนไดรเวอร์

## 6. คำนวณกระแสที่ดึงจากแบตเตอรี่ 2S

ใช้สมมติฐาน:

- แบตเตอรี่ 2S: 8.4V เมื่อเต็ม, ประมาณ 7.2–7.4V ระหว่างใช้งาน, ประมาณ 6.0V ช่วงใกล้หมด
- ตัวแปลง 5V มีประสิทธิภาพประมาณ 85%
- โหลดเซอร์โวปกติสูง 2.5A ที่ 5V
- มอเตอร์ล้อรวมประมาณ 0.6–1.6A จาก BUS ขณะรับน้ำหนัก และประมาณ 2.4A เมื่อสตอลล์พร้อมกัน
- ลอจิกทั้งหมดรวม ESP32 หลัก, บอร์ดกล้อง, TFT, PCA9685 และเซนเซอร์ ใช้งบออกแบบประมาณ 1.0A ที่ 5V; ช่วงคาดการณ์ 0.6–1.2A

สูตรตัวแปลง:

`I_in = (V_out × I_out) / (V_in × efficiency)`

### 6.1 เซอร์โว

ที่ 5V 2.5A กำลังไฟเอาต์พุตเท่ากับ 12.5W

ที่แบต 7.4V และประสิทธิภาพ 85%:

`I_in = 12.5 / (7.4 × 0.85) = 1.99A`

จึงใช้ค่าประมาณ **2.0A จาก BUS** สำหรับรางเซอร์โวในสถานการณ์ใช้งานสูงตามแผนได้

ถ้าเซอร์โวดึงเต็ม 5A ที่ 5V ชั่วคราว:

`I_in = 25 / (7.4 × 0.85) = 3.97A`

### 6.2 ลอจิกและจอ

ที่ 5V 1.0A เท่ากับ 5W เมื่อรวมการสูญเสียจะดึงจาก BUS ที่ 7.4V ประมาณ:

`I_in = 5 / (7.4 × 0.85) = 0.80A`

จึงใช้ **0.8A จาก BUS** เป็นงบลอจิกรวม และใช้ช่วงประมาณ 0.5–1.0A ตามการทำงานของ Wi-Fi, กล้องและความสว่างจอ

### 6.3 มอเตอร์ล้อ

ใช้ค่าประมาณ 0.6–1.6A จาก BUS ระหว่างวิ่งรับน้ำหนัก โดยมีขอบผิดปกติ 2.4A เมื่อมอเตอร์ทั้งสองสตอลล์พร้อมกัน

### 6.4 ผลรวม

| โหลดจาก BUS 2S | ค่าประมาณปกติสูง |
|---|---:|
| เซอร์โวผ่านตัวแปลง 5V | 2.0A |
| มอเตอร์ล้อ 2 ตัว | 0.6–1.6A |
| ลอจิก/กล้อง/จอ | 0.5–1.0A |
| รวม | **3.1–4.6A** |

ค่ารวม 3.4–4.4A ที่ใส่ไว้ในไฟล์หลักจึงอยู่ในช่วงเดียวกับค่าที่แก้ใหม่ **3.1–4.6A** หลังนับกล้องและจอครบ ไม่ถือว่าเกินจริง แต่ทั้งสองช่วงยังไม่ครอบคลุมกรณีล้อติดขัดหรือเซอร์โวสตอลล์หลายตัว

กรณีผิดปกติ กระแสรวมอาจเกิน 7.5A ได้ชั่วคราว และอาจสูงกว่านั้นหากมอเตอร์ทั้งสองติดขัดพร้อมกัน ค่านี้ต้องจัดการด้วยฟิวส์, การหยุดคำสั่งเมื่อกลไกไม่ขยับ และการทดสอบจริง ไม่ใช่คาดเดาจากป้าย BMS เพียงอย่างเดียว

## 7. ประมาณเวลาทำงานของแบตเตอรี่

แบต VTC6 แบบ 2S1P มีความจุประมาณ 3.0Ah ที่แรงดันนอมินัล 7.2V หรือพลังงานประมาณ:

`7.2V × 3.0Ah = 21.6Wh`

ถ้าใช้โหลดสูงต่อเนื่องประมาณ 22–29W เวลาทฤษฎีคือ:

- `21.6 / 29 = 0.74 ชั่วโมง` หรือประมาณ 45 นาที
- `21.6 / 22 = 0.98 ชั่วโมง` หรือประมาณ 59 นาที

เมื่อเผื่อแรงดันตก, การสูญเสียของตัวแปลง, BMS และไม่ใช้ความจุจนหมดจริง เวลาที่ปลอดภัยกว่าสำหรับโหลดสูงต่อเนื่องคือประมาณ **35–50 นาที**

งานสาธิตจริงที่ไม่ได้ยกแขนและเร่งมอเตอร์ตลอดเวลาอาจใช้งานได้นานกว่านี้ แต่ยังไม่ควรรับประกันตัวเลขจนกว่าจะจับเวลาจากแบตเต็มหนึ่งรอบ

## 8. ตรวจค้านข้อสรุปเดิม

### 8.1 “กระแสกระชากเป็นหน้าที่ของคาปาซิเตอร์ ไม่ใช่ตัวแปลง” — ถูกเพียงบางส่วน

คาปาซิเตอร์ช่วยลดสัญญาณรบกวนและพยุงแรงดันช่วงสั้นมาก แต่ไม่สามารถชดเชยตัวแปลงที่เล็กเกินไปได้

สูตรคือ:

`ΔV = I × Δt / C`

ถ้าใช้ 2,200µF และต้องช่วยเพิ่ม 2A เป็นเวลา 1ms:

`ΔV = 2 × 0.001 / 0.0022 = 0.91V`

ถ้านาน 10ms แรงดันที่คำนวณได้จะตกถึง 9.1V ซึ่งเป็นไปไม่ได้ในระบบ 5V แปลว่าคาปาซิเตอร์หมดพลังงานช่วยไปก่อนแล้ว ดังนั้น 1,000–2,200µF เหมาะกับการกดสไปก์และลดการรีเซ็ตช่วงสั้นมาก แต่ตัวแปลงยังต้องรองรับโหลดจริงอย่างน้อย 5A ต่อเนื่อง

### 8.2 “BMS 16A เหลือมาก” — ยังยืนยันไม่ได้ทั้งหมด

เซลล์ VTC6 ของแท้รองรับการคายกระแสสูงกว่างานนี้มาก แต่ข้อจำกัดจริงอาจอยู่ที่:

- รางถ่านและหน้าสัมผัส
- BMS ทั่วไปที่ตัวเลขบนป้ายอาจเป็นค่าสูงสุด ไม่ใช่ค่าต่อเนื่องพร้อมระบายความร้อนจริง
- สายไฟ, จุดบัดกรี, สวิตช์ และขั้วต่อ
- กระแสสตอลล์ของมอเตอร์ล้อที่ยังไม่ทราบ

จึงสรุปได้เพียงว่า BMS 16A “มีแนวโน้มพอสำหรับโหลดใช้งานปกติ” แต่ต้องทดสอบแรงดันตกและอุณหภูมิก่อนรับรอง

### 8.3 ความต้านทานภายใน 0.1–0.2Ω — ใช้ได้ถ้าหมายถึงทั้งระบบ

ไม่ควรเขียนว่าเป็นความต้านทานของเซลล์ VTC6 สองก้อนอย่างเดียว เพราะรางถ่าน, BMS, สาย, สวิตช์ และจุดต่อเพิ่มความต้านทานจำนวนมาก ค่านี้ควรเรียกว่า “สมมติฐานความต้านทานรวมของเส้นทางแบตเตอรี่” จนกว่าจะวัดจริง

### 8.4 XH-M401/XL4016 — ไม่เหมาะกับ 2S

ข้อมูล XL4016 ระบุแรงดันอินพุตใช้งานขั้นต่ำ 8V แต่แบต 2S อยู่ที่ 6.0–8.4V จึงทำงานได้เฉพาะช่วงที่แบตเกือบเต็มและหลุดการควบคุมเมื่อแรงดันลด ไม่ควรใช้เป็นตัวแปลง 5V หลัก แม้หน้าจอบนโมดูลจะติดในบางช่วง

### 8.5 LM2596 — ใช้กับลอจิกได้ แต่ไม่ใช้เลี้ยงเซอร์โวทั้งหมด

โมดูล LM2596 ราคาทั่วไปมักระบายความร้อนไม่พอสำหรับ 5A และตัวไอซีเองก็ไม่ใช่แหล่งจ่าย 5A จึงเก็บไว้เลี้ยงลอจิก/จอหรือใช้ทดสอบโหลดเบา ไม่ควรต่อขนานสองตัวเพื่อหวังรวมกระแส

## 9. รายการจัดซื้อที่แนะนำ

### ระดับ A: ต้องซื้อก่อนทำระบบแบตเตอรี่ถาวร

| ลำดับ | รายการและสเปกขั้นต่ำ | จำนวน | งบประมาณ | เหตุผล |
|---|---|---:|---:|---|
| A1 | BEC/buck 5.0V, อินพุตครอบคลุมอย่างน้อย 6.0–8.4V หรือระบุ 2S, เอาต์พุต 5A ต่อเนื่อง | 1 | 150–250 บาทสำหรับรุ่นทั่วไป | เลี้ยง MG996R x2 + MG90S x2 และ SG90 ที่ค้างตำแหน่ง โดยมีเผื่อกระชาก |
| A2 | ฐานฟิวส์รถยนต์แบบใบมีด รองรับอย่างน้อย 10A พร้อมฟิวส์ 7.5A | 1 ชุด | 50–150 บาท | ป้องกันสาย/สวิตช์/วงจรเมื่อชอร์ต ติดตั้งใกล้ P+ ของ BMS |
| A3 | ฟิวส์ 7.5A สำรอง | 1–2 ตัว | 10–40 บาท | ใช้เปลี่ยนหลังทดสอบหรือเหตุผิดพลาด |

เกณฑ์รับ BEC/buck ก่อนจ่ายเงิน:

- เขียนชัดว่าใช้กับ 2S หรืออินพุตต่ำสุดไม่เกิน 6V
- เอาต์พุตเลือก/ตั้งเป็น 5.0V ได้
- ระบุ 5A “continuous” ไม่ใช่เขียนเพียง peak/max
- มีการป้องกันความร้อน, กระแสเกิน และชอร์ตจะดีกว่า
- สายอินพุตและเอาต์พุตมีขนาดเหมาะกับ 5A

### ระดับ B: ซื้อเพื่อให้ถอดชั้นได้ ถ้ายังไม่มีขั้วต่อที่เหมาะสม

| รายการ | จำนวน | งบประมาณ | เหตุผล |
|---|---:|---:|---|
| XT30 ตัวผู้-เมียพร้อมสาย หรือขั้วต่อ 2 ขาที่รองรับอย่างน้อย 10A | 2–3 คู่ | 50–120 บาท | แยกชั้นแบต, รางเซอร์โว และมอเตอร์โดยไม่ตัดสาย |
| ท่อหดหลายขนาด | 1 ชุดเล็ก | 20–60 บาท | กันขั้วชนและลดสายหักตรงรอยบัดกรี |
| เคเบิลไท/ตัวยึดสาย | 1 ชุดเล็ก | 20–50 บาท | ทำ strain relief ไม่ให้แรงดึงลงที่บอร์ด |

ไม่แนะนำ Dupont 1 ขา, เบรดบอร์ด หรือ JST-XH ขนาดเล็กเป็นทางผ่านกระแสรวม 5–8A ข้ามชั้น ขั้วเหล่านี้ยังใช้กับสัญญาณและโหลดเบาได้

### ระดับ C: ซื้อเมื่อผลทดสอบบอกว่าจำเป็นเท่านั้น

| รายการ | เงื่อนไขที่ค่อยซื้อ | งบประมาณโดยประมาณ |
|---|---|---:|
| สวิตช์ DC 10A ที่ 12V หรือสูงกว่า | สวิตช์เดิมไม่มีพิกัด DC, ร้อน, แรงดันตกมาก หรือหน้าสัมผัสไม่แน่น | 50–150 บาท |
| ไดรเวอร์มอเตอร์กระแสสูงกว่า TB6612 | วัดแล้วมอเตอร์ตัวใดกินต่อเนื่องเกิน 1.2A หรือ TB6612 ตัด/ร้อนขณะรับน้ำหนัก | 100–400 บาทตามรุ่น |
| บอร์ดขยายขา ESP32 38-pin | ต้องการถอดสายสัญญาณสะดวกและบอร์ดตรงกับ ESP32 ที่มีจริง | 80–200 บาท |
| ตัวต้านทาน 10kΩ สำหรับ encoder | ตรวจแล้วโมดูล encoder ไม่มี pull-up และสัญญาณที่ GPIO34/35/36/39 ลอย | ต่ำกว่า 20 บาท |
| แผ่นยาง/ซิลิโคนติดกริปเปอร์ | ขวดลื่นและ MG90S ต้องออกแรงคีบมาก | 20–80 บาท |

## 10. เปรียบเทียบทางเลือกตัวแปลง 5V

| ทางเลือก | ราคาโดยประมาณ | ใช้กับ 2S | กระแส | ข้อสรุป |
|---|---:|---|---|---|
| BEC 5V 5A รุ่นทั่วไปที่ระบุ 2S ชัดเจน | 150–250 บาท | ได้ | ต้องทดสอบว่า 5A ต่อเนื่องจริง | แนะนำตามงบ |
| Hobbywing UBEC 5A | ประมาณ 550 บาท | ได้, ผู้ผลิตระบุ 2–8S | 5A ต่อเนื่อง, 15A ชั่วคราว | เชื่อถือได้กว่า แต่ไม่จำเป็นสำหรับงบ 3,000 บาท |
| Hobbywing UBEC 8A | ประมาณ 750 บาท | ได้ | 8A ต่อเนื่อง | เกินความต้องการปัจจุบัน ไม่แนะนำให้ซื้อก่อนวัด |
| XH-M401/XL4016 ที่มีอยู่ | ซื้อแล้ว | ไม่ครอบคลุมช่วง 2S เพราะ Vin ต่ำสุด 8V | ป้ายกระแสสูงแต่ใช้ช่วงแรงดันผิด | ไม่ใช้เป็น 5V หลัก |
| LM2596 ที่มีอยู่ | ซื้อแล้ว | รับแรงดัน 2S ได้ในหลายโมดูล | ไม่พอสำหรับเซอร์โวทั้งหมด | ใช้ลอจิก/โหลดเบา |
| MP1584 3A | 35–100 บาท | บางรุ่นใช้ได้ | 3A สูงสุดและต้องระบายความร้อน | ไม่แนะนำเป็นรางเซอร์โวหลัก |

หมายเหตุ: ราคาเป็นช่วงจากหน้าร้านออนไลน์ที่พบ ณ วันที่จัดทำ ค่าขนส่งและคุณภาพของรุ่นทั่วไปต่างกันมาก จึงต้องเลือกจากสเปกอินพุตและคำว่า continuous ไม่เลือกจากคำว่า 5A ในชื่อสินค้าอย่างเดียว

## 11. งบจัดซื้อสามระดับ

### แผนประหยัดที่แนะนำ

| รายการ | งบ |
|---|---:|
| BEC 5V 5A รุ่นทั่วไปที่รับ 2S | 150–250 บาท |
| ฐานฟิวส์ + ฟิวส์ 7.5A และสำรอง | 60–150 บาท |
| ขั้วต่อ/ท่อหดเท่าที่ขาด | 40–150 บาท |
| รวม | **250–550 บาท** |

### แผนเน้นยี่ห้อ

| รายการ | งบ |
|---|---:|
| Hobbywing UBEC 5A | ประมาณ 550 บาท |
| ฐานฟิวส์ + ฟิวส์ + ขั้วต่อ | 100–250 บาท |
| รวม | **650–800 บาท** |

### แผนที่ไม่แนะนำตอนนี้

UBEC 8–10A ราคา 750–1,200 บาทบวกอุปกรณ์ประกอบ เพราะยังไม่มีผลวัดที่แสดงว่า 5A ต่อเนื่องไม่พอ และการจ่ายกระแสสตอลล์ได้มากขึ้นไม่ได้แก้ปัญหากลไกติดขัด

## 12. วิธีตัดสินขนาดฟิวส์จากการวัดจริง

เริ่มด้วยฟิวส์ 7.5A เพราะโหลดใช้งานสูงหลังนับ XIAO และจอครบคาดประมาณ 3.1–4.6A โดยค่ากลางสำหรับวางแผนอยู่ราว 3.4–4.4A และยังต้องเผื่อการเริ่มมอเตอร์/กระชากเซอร์โว

ลำดับทดสอบ:

1. ยกล้อลอย ทดสอบลอจิกและมอเตอร์ทีละส่วน
2. ทดสอบ MG996R x2 และ MG90S x2 พร้อมกันโดยไม่มีของหนัก
3. ทดสอบกลุ่มเซอร์โวเดิมพร้อมมอเตอร์ล้อที่ยกลอย
4. วัดแรงดันที่ P+/P−, BUS และราง 5V ขณะโหลดสูง
5. วางล้อลงพื้นและเพิ่มน้ำหนักทีละขั้น
6. จับเวลา 5–10 นาทีและตรวจอุณหภูมิ BEC, BMS, สวิตช์, TB6612, รางถ่าน และขั้วต่อ

เกณฑ์ผ่านเบื้องต้น:

- ราง 5V ไม่ควรลดต่ำกว่า 4.8V ขณะคำสั่งกลุ่ม A
- ESP32 ไม่รีเซ็ตและจอไม่ดับ
- ขั้วต่อ/สาย/สวิตช์ไม่ร้อนขึ้นต่อเนื่อง
- BEC ไม่ตัดและไม่ร้อนจนผิดปกติ
- ฟิวส์ 7.5A ไม่ขาดในการใช้งานปกติ

ถ้าฟิวส์ 7.5A ขาด ให้หาสาเหตุก่อน ไม่ควรเปลี่ยนเป็น 10A ทันที ใช้ 10A ได้เมื่อวัดยืนยันว่ากระแสใช้งานปกติมีพีกเกิน 7.5A, สายและขั้วต่อรองรับอย่างน้อย 10A และไม่มีมอเตอร์/เซอร์โวติดขัด

## 13. จุดที่ต้องบันทึกเพิ่มหลังทดสอบ

ข้อมูลที่ยังขาดและมีผลต่อการซื้อจริง:

- รหัส/สเปกมอเตอร์ล้อและกระแสต่อหนึ่งตัวตอนลงพื้น
- กระแสรวมจาก P+ เมื่อกลุ่ม A ทำงานพร้อมมอเตอร์
- แรงดันตกจาก P+/P− ถึง BUS และจากเอาต์พุต BEC ถึง V+ ของ PCA9685
- อุณหภูมิ BEC, BMS, TB6612 และสวิตช์หลัง 10 นาที
- เวลาทำงานจริงจากแบตเต็มถึง BMS ตัดหรือถึงแรงดันที่กำหนดให้หยุด
- พิกัดที่พิมพ์บนสวิตช์ KCD-105 โดยเฉพาะพิกัด DC

เมื่อมีค่าห้ากลุ่มนี้จึงค่อยตัดสินว่าไดรเวอร์มอเตอร์, สวิตช์ หรือ BEC 8A จำเป็นหรือไม่

## 14. แหล่งข้อมูลอ้างอิง

- [TowerPro MG996R: 4.8–6.6V, no-load 170mA, stall 1.4A](https://towerpro.com.tw/product/mg996R/)
- [ข้อมูล MG90S: stall current 750mA ที่ 4.8V และ 860mA ที่ 6V](https://www.tinytronics.nl/product_files/000263_Data_Sheet_of_MG90S_Analog_Servo_Motor.pdf)
- [Toshiba TB6612FNG: 1.2A average และ 3.2A peak ต่อช่อง](https://toshiba.semicon-storage.com/info/TB6612FNG_datasheet_en_20141001.pdf?did=10660&prodName=TB6612FNG)
- [XLSEMI XL4016: input operating voltage 8–36V](https://www.xlsemi.com/datasheet/XL4016-EN.pdf)
- [Murata US18650VTC6: 3,000mAh minimum, 3.6V nominal และกราฟคายประจุหลายระดับกระแส](https://www.murata.com/-/media/webrenewal/products/batteries/cylindrical/datasheet/us18650vtc6-product-datasheet.ashx)
- [Hobbywing UBEC 5A: 2–8S, 5A continuous และ 15A instantaneous](https://www.hobbywingdirect.com/products/ubec-5a-air)
- [ตัวอย่างฟิวส์รถยนต์แบบ mini blade 7.5A 32VDC](https://www.digikey.co.th/en/products/filter/fuses/139?s=N4IgjCBcoLQdIDGUBmBDANgZwKYBoQB7KAbXAA4QBdAXzqA)

## 15. คำตัดสินสุดท้าย

การประเมินกระแสในไฟล์หลักของ Claude ไม่ได้ผิดทั้งชุด: ค่าเซอร์โว 2.5A ใช้วางแผนได้ และโหลดรวมจาก BUS 3.4–4.4A สอดคล้องกับการคำนวณใหม่หลังนับ XIAO, กล้องและจอครบ ซึ่งได้ช่วงประมาณ 3.1–4.6A ทั้งหมดเป็นงบออกแบบ ไม่ใช่ค่ารับประกันหรือผลวัดจริง

แผนที่คุ้มงบที่สุดคือซื้อ BEC/buck 5V 5A ที่รับ 2S จริงหนึ่งตัวและฟิวส์ 7.5A พร้อมฐาน จากนั้นทดสอบวัดค่าจริงก่อนซื้อสวิตช์, ไดรเวอร์มอเตอร์ หรือ UBEC ราคาแพงกว่า ห้ามซื้อเซนเซอร์, PCA9685 หรืออุปกรณ์ที่ยืนยันแล้วว่ามีอยู่ซ้ำ

## 16. ข้อสรุปตัวแปลงไฟหลังตรวจผังไฟจริง

### ตัวแปลงไฟ

- **เก็บ LM2596 ไว้** ตั้ง 5.0V และใช้เลี้ยงราง Logic เท่านั้น ได้แก่ ESP32 หลัก, บอร์ดกล้อง, TFT, PCA9685 และเซนเซอร์ โดยใช้งบออกแบบ 1.0A และเผื่อช่วงประมาณ 0.6–1.2A
- **ถอด XH-M401 ออกจากราง Servo** เพราะ XL4016 ต้องการอินพุตอย่างน้อย 8V จึงไม่ครอบคลุมแบต 2S
- ใส่ **BEC/buck 5V 5A รุ่นทั่วไปที่รับแบต 2S ได้จริง** ตั้งเอาต์พุต 5.0V แทน XH-M401 แล้วต่อเอาต์พุตไปที่ V+ และ GND ฝั่งกำลังของ PCA9685 เกณฑ์สำคัญคืออินพุตต้องครอบคลุมประมาณ 6.0–8.4V และจ่าย 5A ต่อเนื่องได้ ไม่จำเป็นต้องเป็น Hobbywing
- ห้ามต่อบวก 5V จาก LM2596 รวมกับบวก 5V จาก UBEC แต่ GND ของทั้งสองรางต้องร่วมกัน

งบสำหรับ BEC/buck รุ่นทั่วไปอยู่ประมาณ 150–250 บาท ให้เลือกรุ่นที่ระบุช่วงอินพุตและกระแสต่อเนื่องชัดเจน แล้วทดสอบแรงดันตกและอุณหภูมิกับโหลดจริงก่อนติดตั้งถาวร Hobbywing UBEC 5A ราคาโดยประมาณ 550 บาทเก็บไว้เป็นเพียงตัวเลือกเทียบด้านสเปก ไม่ใช่ของที่ต้องซื้อ และรุ่น 8–10A ยังไม่จำเป็น

### ไดรเวอร์มอเตอร์ — ยืนยันจากมอเตอร์จริงแล้ว

มอเตอร์ที่ซื้อจริงคือ **TT Motor Encoder 13PPR รุ่น 1:90, 6V 175RPM จำนวน 2 ตัว** ร้านระบุแรงดันแนะนำ 6V, กระแสไม่มีโหลดไม่เกิน 0.2A และกระแสสตอลล์ประมาณ 1.2A ต่อมอเตอร์

ดังนั้น **ใช้ TB6612FNG ตัวเดิมต่อได้และไม่ต้องซื้อ MDD3A ตอนนี้** เพราะ TB6612 รองรับ 1.2A เฉลี่ยและ 3.2A พีกต่อช่อง ขณะที่ 1.2A ของมอเตอร์เป็นกระแสตอนเพลาหยุด ไม่ใช่กระแสที่ควรเกิดต่อเนื่อง การเลือก MDD3A ล่วงหน้าจึงเกินจำเป็นเมื่อรู้รุ่นมอเตอร์แล้ว

งบกระแสมอเตอร์ที่แก้ใหม่:

| สถานการณ์ | ต่อมอเตอร์ | สองมอเตอร์รวม |
|---|---:|---:|
| ไม่มีโหลด | ≤0.2A | ≤0.4A |
| วิ่งรับน้ำหนักโดยประมาณ | 0.3–0.8A | 0.6–1.6A |
| ล็อกเพลา/สตอลล์ | ~1.2A | ~2.4A |

ห้ามปล่อยให้ล้อติดขัดค้าง แม้กระแสจะไม่เกินตัวเลขพีกของ TB6612 เพราะทั้งมอเตอร์และไดรเวอร์จะสะสมความร้อน การจำกัด PWM สูงสุดประมาณ 75–80% เมื่อแบตเต็มช่วยไม่ให้มอเตอร์ 6V รับค่าเฉลี่ยใกล้ 8.4V ตรงๆ จากแพ็ก 2S แล้วค่อยปรับจากการทดสอบความเร็วและแรงบิดจริง

MDD3A ให้เก็บเป็นตัวเลือกเฉพาะกรณีเปลี่ยนมอเตอร์ในอนาคต หรือทดสอบแล้วพบว่า TB6612 ร้อน/ตัดผิดปกติ:

- มอเตอร์ DC สองช่อง
- อินพุตมอเตอร์ 4–16V ครอบคลุมแบต 2S
- 3A ต่อเนื่องและ 5A พีกต่อช่อง
- รับลอจิก 3.3V จาก ESP32
- ราคา Cytron Thailand ที่ตรวจพบประมาณ 280 บาท

เอาต์พุต 5V บน MDD3A จ่ายได้เพียง 200mA จึงห้ามนำไปเลี้ยง ESP32, จอ หรือ Servo ให้ใช้เฉพาะภาคขับมอเตอร์

ถ้า TB6612 ตัดหรือร้อนทั้งที่ล้อหมุนอิสระและกระแสต่ำกว่า 1.2A ต่อช่อง ให้ตรวจสาย, การบัดกรี, PWM และการระบายความร้อนก่อนซื้อใหม่ ถ้ากระแสต่อเนื่องเกิน 1.2A จริงจึงค่อยเปลี่ยนเป็น MDD3A ไม่ควรเปลี่ยนไป L298N, L9110S หรือ Maker Drive 1A เพราะไม่ได้เพิ่มกำลังอย่างมีนัยสำคัญ

การเปลี่ยนเป็น MDD3A ต้องแก้โค้ดจาก IN1 + IN2 + PWM ต่อมอเตอร์ เป็น PWM + PWM ต่อมอเตอร์ ตัวอย่างขาที่ลดการรื้อสาย:

| MDD3A | ESP32 |
|---|---|
| M1A | GPIO25 |
| M1B | GPIO26 |
| M2A | GPIO32 |
| M2B | GPIO33 |

GPIO27 และ GPIO14 เดิมจะว่าง ต้องแก้ฟังก์ชันเดินหน้า/ถอยหลังในโค้ดก่อนเปิดมอเตอร์ ตารางนี้เป็นข้อมูลเผื่ออัปเกรดเท่านั้น ไม่ใช่ผังที่ต้องแก้ตอนนี้

Encoder ของมอเตอร์รับไฟ 3.3–5V ให้เลี้ยงจาก 3.3V เพื่อให้สัญญาณ A/B ปลอดภัยกับ ESP32 ส่วน GPIO34/35/36/39 ไม่มี internal pull-up หากสัญญาณลอยหรืออ่านไม่นิ่งจึงค่อยใส่ตัวต้านทาน 10kΩ ดึงขึ้น 3.3V หลังตรวจชนิดเอาต์พุตของ encoder จริง

## 17. ตรวจอุปกรณ์ที่ซื้อจริง: CM620, BMS, สวิตช์ และ TB6612

### CM620 2S 2A

รุ่นที่ซื้อถูกชนิดสำหรับแพ็ก Li-ion 2S ตัวบอร์ดรับ 5V จาก USB-C หรือขา VIN/GND แล้วสร้างแรงดันชาร์จ 8.4V ที่ BAT/GND ตัวเลข 2A ในชื่อมักเป็นกระแสอินพุต รุ่นนี้จ่ายเข้าฝั่งแบตจริงประมาณ 1.1A จึงไม่ควรถือว่าเป็นเครื่องชาร์จแบต 2A เต็ม

การต่อเข้าระบบ:

| CM620 | BMS |
|---|---|
| BAT | P+ |
| GND ฝั่ง BAT | P- |
| USB-C หรือ VIN/GND | แหล่งจ่าย 5V อย่างน้อย 2A |

ห้ามต่อ BAT/GND ของ CM620 ข้าม BMS ไปที่ B+/B- โดยตรง และห้ามชาร์จขณะเปิดใช้งานหุ่น

### BMS รุ่นยาว 2S 16A

รุ่น HX-2S-A10 ที่ตรงกับขนาดและลักษณะของรุ่นยาวมีค่าที่ใช้วางแผนจริงประมาณ 8A ต่อเนื่องและ 16A ชั่วขณะ ไม่ใช่ 16A ต่อเนื่อง และไม่มีวงจร Balance

อาการ B- ถึง B+ ประมาณ 7.4V แต่ P- ถึง P+ เป็น 0V มักเกิดจาก BMS อยู่ใน protection/sleep หลังประกอบหรือหลังตรวจพบชอร์ต จึงยังไม่สรุปว่าบอร์ดเสีย

วิธีปลุกที่ปลอดภัย:

1. ถอดโหลดทั้งหมดออกจาก P+/P- และปิดสวิตช์
2. ยืนยัน B- ถึง BM ประมาณ 3.6–3.7V, BM ถึง B+ ประมาณ 3.6–3.7V และ B- ถึง B+ ประมาณ 7.2–7.4V
3. ต่อ CM620 BAT ไป P+ และ CM620 GND ไป P-
4. เสียบ USB-C 5V อย่างน้อย 2A เป็นเวลา 5–10 วินาที
5. ถอด USB-C แล้ววัด P- ถึง P+ ใหม่ ถ้าขึ้นใกล้แรงดันแพ็ก แปลว่า BMS ถูกปลุกแล้ว
6. ถ้ายัง 0V ให้ถอดเซลล์ออกจากราง รอ 30 วินาที ใส่เซลล์ฝั่ง B-/BM ก่อน แล้วจึงใส่เซลล์ฝั่ง BM/B+ จากนั้นปลุกด้วย CM620 ซ้ำ

ห้ามลัด B- เข้ากับ P-, ห้ามข้าม BMS ไปจ่ายโหลดจาก B+/B- และห้ามใช้โหมดวัดกระแสของมัลติมิเตอร์แตะเพื่อปลุก

ถ้าทำครบแล้วยัง 0V ให้เปลี่ยน BMS เป็น **BMS 2S 8A พร้อม Balance รุ่น HX-2S-JH10 หรือ HX-2S-D01** ซึ่งเพียงพอกับโหลดใช้งานสูงประมาณ 3.1–4.6A ของระบบ ราคาที่ตรวจพบในไทยประมาณ 45–55 บาท

ระหว่างใช้ BMS ตัวเดิมที่ไม่มี Balance ต้องวัดแรงดันทีละเซลล์เป็นระยะ ถ้าต่างกันเกิน 0.10V หรือเซลล์ใดเกิน 4.25V ระหว่างชาร์จให้หยุดทันที

### สวิตช์ KCD1-105 สีดำ 2 ขา

สวิตช์ที่ซื้อเป็น SPST ON/OFF ถูกชนิดและสองขาไม่มีขั้ว จะเลือกขาใดเป็นไฟเข้า/ไฟออกก็ได้ ใช้ตัดสายบวกระหว่างฟิวส์กับ BUS+ ได้

อย่างไรก็ตาม KCD1-105 ทั่วไปมักพิมพ์พิกัด AC เช่น 6A 250VAC หรือ 10A 125VAC และไม่มีพิกัด DC ที่ยืนยันสำหรับสินค้าทุกโรงงาน จึงให้ใช้ของเดิมได้ในต้นแบบที่โหลดใช้งานสูงประมาณ 3.1–4.6A แต่ต้องมีฟิวส์ 7.5A อยู่ก่อนสวิตช์และตรวจความร้อน/แรงดันตก

ถ้าสวิตช์อุ่น, เปิดติดๆ ดับๆ หรือแรงดันคร่อมสวิตช์เกิน 0.1V ขณะโหลด ให้เปลี่ยนเป็นสวิตช์ที่ระบุบนตัวชัดเจนว่าอย่างน้อย 10A 12VDC

### TB6612FNG รุ่น FNGTB6612 Driver

ตัวเลือกที่ซื้อเป็น TB6612FNG ถูกชนิดและใช้กับมอเตอร์ 1:90 สองตัวได้ แต่บอร์ดจิ๋วรุ่นนี้เป็นรูพิน 2.54mm ไม่ใช่รูสำหรับขัน terminal block โดยตรง

- ถ้าพินเฮดเดอร์ถูกบัดกรีมากับบอร์ดแล้ว ใช้สาย Dupont ตัวเมียกับขาสัญญาณได้
- ขา VM, GND, AO1/AO2 และ BO1/BO2 เป็นสายกำลัง ไม่ควรอาศัย Dupont หลวมๆ ในงานถาวร
- terminal block ระยะ 5.08mm ทั่วไปเสียบลงบอร์ดนี้โดยตรงไม่ได้
- การเพิ่มหัวขันนอตยังต้องบัดกรีพินหรือบัดกรีบอร์ดลงแผ่น adapter อย่างน้อยหนึ่งครั้ง ไม่มีวิธีเสียบกดเฉยๆ ที่เชื่อถือได้

ทางเลือกที่ประหยัดที่สุดคือให้ร้านอิเล็กทรอนิกส์บัดกรีพินและทำ adapter terminal ให้ครั้งเดียว แล้วหลังจากนั้นถอดชั้นด้วยการขันนอต/ถอดปลั๊กได้ หากยืนยันว่าจะไม่บัดกรีเลยจึงค่อยใช้ Cytron MDD3A ซึ่งมีขั้วสกรูกำลังสำเร็จรูป แต่เป็นการจ่ายเงินเพื่อความสะดวก ไม่ใช่เพราะ TB6612 จ่ายกระแสไม่พอ

แหล่งอ้างอิงเพิ่มเติม:

- [CM620/โมดูล Type-C 2S: VIN/GND เป็นอินพุตและ BAT/GND เป็นฝั่งแบต](https://envistiamall.com/es/blogs/learn/type-c-2s-3s-4s-boost-li-ion-battery-charger-module-wiring-setup-user-guide)
- [BMS รุ่นยาว HX-2S-A10: 8A ต่อเนื่อง, 16A ชั่วขณะ และวิธีปลุกด้วยเครื่องชาร์จ](https://www.mechatronicstore.cl/bms-2s-16a-para-baterias-18650/)
- [BMS 2S 8A พร้อม Balance ราคาไทย](https://www.igetsolarcell.com/product/121/bms-2s-8a-7-4v-balance-18650-li-ion-lithium-battery-bms-charger-protection-%E0%B8%A7%E0%B8%87%E0%B8%88%E0%B8%A3%E0%B8%9B%E0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)
- [KCD1-105 datasheet: พิกัดมาตรฐาน 6(4)A 250VAC / 10A 125VAC และไม่มี DC rating ระบุ](https://datasheet.lcsc.com/lcsc/2305061707_SHOU-HAN-KCD1-105_C5884406.pdf)

## 18. ลิงก์สินค้าที่ผู้ใช้ส่งมา

ใช้ลิงก์ต่อไปนี้เป็นหลักฐานหน้าร้าน รุ่นที่เลือก และแหล่งจัดซื้อ ไม่ใช้แทน datasheet ของผู้ผลิต เนื่องจากข้อมูลหน้าร้านอาจถูกแก้ภายหลัง เข้าถึงล่าสุดวันที่ 30 สิงหาคม 2026

| อุปกรณ์ | ตัวเลือก/รายการที่ยืนยัน | ลิงก์สินค้าและ Item ID |
|---|---|---|
| มอเตอร์ล้อ TT Encoder | 1:90, 6V, 175RPM จำนวน 2 ตัว | [Shopee Item 12299508759](https://shopee.co.th/product/5641091/12299508759) |
| โมดูลชาร์จ CM620 | CM620 2S 2A จำนวน 1 ตัว | [Shopee Item 23890193345](https://shopee.co.th/product/944231623/23890193345) |
| BMS ที่ซื้อ | รุ่นยาว BMS 2S 16A จำนวน 1 ตัว | [Shopee Item 15945683097](https://shopee.co.th/product/117988183/15945683097) |
| สวิตช์ | KCD1-105 สีดำ 2 ขา | [Shopee Item 15416126651](https://shopee.co.th/product/117988183/15416126651) |
| ไดรเวอร์มอเตอร์ | FNGTB6612 / TB6612FNG | [Shopee Item 24513725792](https://shopee.co.th/product/117988183/24513725792) |

ลิงก์ MG996R, MG90S, SG90, TFT 2.8 นิ้ว และ XIAO ESP32-S3 Sense เก็บไว้ใน `สเปกอุปกรณ์จริงและงบกระแสสำหรับรายงาน_RoboMDT.md` เพื่อไม่ให้ตารางสเปกสำหรับเล่มรายงานปนกับตารางระบบแบตเตอรี่
