HoneyKung/metorobot/Robo/Part Robot/แผนต่อระบบแบตเตอรี่แบบโมดูลาร์_RoboMDT.md

# แผนต่อระบบแบตเตอรี่แบบโมดูลาร์ — RoboMDT

> เป้าหมาย: ใช้ของที่มีอยู่ให้หุ่นเดิน เลี้ยว หันหน้า แสดงสีหน้า และทดลองยกของได้ก่อน
> โดยเตรียมจุดต่อไว้ให้เพิ่ม UBEC, ฟิวส์, PCA9685, VL53L0X และ MPR121 ภายหลังได้โดยไม่ต้องรื้อระบบแบตเตอรี่

## 1. ขอบเขตของวงจรฉบับนี้

- ใช้แบตเตอรี่ 18650 จำนวน 2 ก้อนแบบอนุกรม (2S)
- ใช้ BMS 2S 16A, CM620, KCD-105, LM2596 และ TB6612FNG ที่มีอยู่
- ต้นแบบวันศุกร์ใช้ LM2596 เลี้ยง ESP32/จอ/กล้อง และใช้ XH-M401 เลี้ยง Servo แยกกัน
- ระบบสัมผัส MPR121 และ VL53L0X ยังไม่ต้องติดตั้ง
- สายสัญญาณใช้ขาพินและสาย Dupont
- สายกำลังใช้สาย 20AWG บัดกรีหรือขันเข้าขั้วสกรู ห้ามใช้ Dupont
- ทุกวงจรใช้ GND ร่วมกัน

## 2. แผนระบบไฟแบบเพิ่มของภายหลังได้

```text
18650 ก้อนที่ 1 + ก้อนที่ 2 (2S)
             │ B+ / BM / B-
             ▼
         BMS 2S 16A
          P+      P-
           │      │
           ├── CM620 Charger (ตามขั้วของโมดูลจริง)
           │
           └── สวิตช์ KCD-105
                    │
                    ▼
          จุดแยกไฟหลังสวิตช์ BUS+ / BUS-
             ├── TB6612 VM/GND → มอเตอร์
             ├── LM2596 IN+/IN-
             │       └── 5.0V → ESP32 + TFT + XIAO
             ├── XH-M401 IN+/IN-
             │       └── 5.0V → Servo rail ชั่วคราว
             └── สายสำรอง UBEC+/UBEC- (หุ้มปลายไว้ก่อน)
                         └── เพิ่ม บั๊ก 5A ที่รับอินพุต 6.0–8.4V ภายหลัง
                                  └── เปลี่ยนแทน XH-M401
```

จุดสำคัญคือเตรียมสายสำรอง `UBEC+` และ `UBEC-` จาก BUS ไว้ตั้งแต่ตอนบัดกรี เมื่อเพิ่ม UBEC ภายหลังจะไม่ต้องแกะ BMS สวิตช์ หรือสายแบต เพียงย้ายไฟเซอร์โวออกจาก XH-M401 ไปที่ UBEC

## 3. ชื่อจุดต่อมาตรฐาน

| ชื่อ | ความหมาย | แรงดันโดยประมาณ |
|---|---|---:|
| `BAT+` | ขั้วบวกสุดของแบตเตอรี่ 2S | 6.0–8.4V |
| `BAT-MID` | จุดกลางระหว่างเซลล์ก้อนที่ 1 และ 2 | 3.0–4.2V |
| `BAT-` | ขั้วลบสุดของแบตเตอรี่ | 0V |
| `BUS+` | ไฟบวกหลัง BMS และสวิตช์ | 6.0–8.4V |
| `BUS-` | ไฟลบหลัง BMS / GND หลัก | 0V |
| `LOGIC-5V` | เอาต์พุต LM2596 ที่ปรับไว้ 5.0V | 5.0V |
| `SERVO-V+` | ไฟเซอร์โววันศุกร์มาจาก XH-M401; ภายหลังเปลี่ยนเป็น UBEC | 5.0–6.0V |
| `3V3` | ไฟ logic จาก ESP32 | 3.3V |

## 4. ตารางการบัดกรีระบบแบตเตอรี่

> ต้องถอดแบตเตอรี่ออกจากรางระหว่างบัดกรี ห้ามบัดกรีลงบนตัวเซลล์ 18650 โดยตรง

| ลำดับ | จาก | ไป | สาย | วิธีต่อ | ตรวจสอบก่อนขั้นถัดไป |
|:--:|---|---|---|---|---|
| 1 | ขั้วลบก้อนที่ 1 | ขั้วบวกก้อนที่ 2 | 20AWG | บัดกรีที่แท็บรางถ่านให้เป็นอนุกรม | ไม่มีตะกั่วลัดไปแท็บอื่น |
| 2 | ขั้วบวกสุดของราง `BAT+` | BMS `B+` | 20AWG แดง | บัดกรี | ตรวจขั้วจากสกรีนบน BMS |
| 3 | จุดกลางราง `BAT-MID` | BMS `BM/B1` | 20AWG สีขาว | บัดกรี | ห้ามสลับกับ B+ หรือ B- |
| 4 | ขั้วลบสุดของราง `BAT-` | BMS `B-` | 20AWG ดำ | บัดกรี | ตรวจขั้วจากสกรีนบน BMS |
| 5 | BMS `P+` | ขาเข้าของสวิตช์ KCD-105 | 20AWG แดง | บัดกรี | สวิตช์ต้องอยู่สถานะ OFF |
| 6 | ขาออกสวิตช์ | จุดแยก `BUS+` | 20AWG แดง | บัดกรี/ขั้วสกรู | หุ้มจุดโลหะเปลือย |
| 7 | BMS `P-` | จุดแยก `BUS-` | 20AWG ดำ | บัดกรี/ขั้วสกรู | BUS- คือ GND ร่วมทั้งหมด |
| 8 | `BUS+` | LM2596 `IN+` | 20AWG แดง | ขั้วสกรูหรือบัดกรี | ยังไม่ต่อเอาต์พุตเข้าบอร์ดอื่น |
| 9 | `BUS-` | LM2596 `IN-` | 20AWG ดำ | ขั้วสกรูหรือบัดกรี | ตรวจว่าไม่สลับกับ IN+ |
| 10 | `BUS+` | XH-M401 `IN+` | 20AWG แดง | ขั้วสกรู | ใช้เลี้ยง Servo ชั่วคราวเท่านั้น |
| 11 | `BUS-` | XH-M401 `IN-` | 20AWG ดำ | ขั้วสกรู | GND ร่วม |
| 12 | `BUS+` | TB6612 `VM` | 20AWG แดง | บัดกรี/ขั้วสกรู | เป็นไฟมอเตอร์ 6.0–8.4V |
| 13 | `BUS-` | TB6612 `PGND/GND` | 20AWG ดำ | บัดกรี/ขั้วสกรู | ต้องร่วมกับ ESP32 GND |
| 14 | `BUS+` | สายสำรอง `UBEC+` | 20AWG แดง | บัดกรีจากจุดแยก | หุ้มปลายสายแยก ไม่ให้แตะอะไร |
| 15 | `BUS-` | สายสำรอง `UBEC-` | 20AWG ดำ | บัดกรีจากจุดแยก | หุ้มปลายสายแยก ไม่ให้แตะอะไร |

### การต่อ CM620

BMS แต่ละรุ่นอาจใช้ขาร่วม `P-` หรือมีขาชาร์จแยก `C-` จึงต้องยึดตามสกรีนบนบอร์ดจริง:

| CM620 | ต่อไปยัง |
|---|---|
| ขั้วบวกเอาต์พุตชาร์จ | BMS `P+` หรือขาชาร์จบวกตามสกรีน |
| ขั้วลบเอาต์พุตชาร์จ | BMS `P-` หรือ `C-` ถ้าบอร์ดมีขาชาร์จแยก |

ห้ามเดาขาจากตำแหน่งบนบอร์ด และห้ามต่อ CM620 ตรงเข้ากับ B+/B- โดยข้าม BMS

## 5. ตั้ง LM2596 และ XH-M401 ก่อนต่อโหลด

1. ถอด ESP32, TFT, XIAO, PCA9685 และเซอร์โวออกทั้งหมด
2. ใส่แบต เปิดสวิตช์
3. ใช้มัลติมิเตอร์วัด `OUT+` กับ `OUT-` ของ LM2596
4. หมุนตัวปรับ LM2596 จนได้ `5.0V`
5. วัด XH-M401 แยกต่างหากและตั้งเป็น `5.0V`
6. ปิดสวิตช์ แล้วจึงต่อโหลด

ห้ามตั้งแรงดันโดยใช้จอบนโมดูลอย่างเดียวถ้ายังไม่ได้ยืนยันด้วยมัลติมิเตอร์

## 6. ตารางจ่ายไฟช่วงแรก — ใช้ของที่มี

| จาก | ไป | ขา | สาย/วิธีต่อ | หมายเหตุ |
|---|---|---|---|---|
| LM2596 `OUT+` | ESP32 | `VIN/5V` | สายกำลัง/ขั้วพินที่แน่น | 5.0V เท่านั้น |
| LM2596 `OUT-` | ESP32 | `GND` | สายดำ | GND ร่วม |
| LM2596 `OUT+` | TFT | `VCC` | Dupont ได้ | ตรวจว่าจอโมดูลรับ 5V ตามของจริง |
| LM2596 `OUT-` | TFT | `GND` | Dupont | |
| LM2596 `OUT+` | XIAO ESP32S3 | `5V` | Dupont | ห้ามเข้าขา 3V3 |
| LM2596 `OUT-` | XIAO ESP32S3 | `GND` | Dupont | |
| XH-M401 `OUT+` | PCA9685 | `V+` | **20AWG/ขั้วสกรู** | ไฟเซอร์โวชั่วคราว 5.0V |
| XH-M401 `OUT-` | PCA9685 | `GND` ฝั่งไฟเซอร์โว | **20AWG/ขั้วสกรู** | GND ร่วม |
| ESP32 | PCA9685 | `3V3 → VCC` | Dupont | เป็นไฟ logic ไม่ใช่ไฟ servo |
| ESP32 | PCA9685 | `GND → GND` | Dupont | ต้องร่วมกับไฟ servo |

ข้อจำกัดช่วงแรก:

- ขยับตามกลุ่มที่ออกแบบไว้: กลุ่ม A = MG996R×2 + MG90S×2 พร้อมกันได้ (พร้อมมอเตอร์ล้อด้วย) ส่วน SG90 คอ/หัว แยกจังหวะ
- เริ่มจากขวดเปล่า
- ถ้า ESP32 รีบูต จอกะพริบ เซอร์โวสั่น หรือ LM2596 ร้อนจัด ให้หยุด
- อย่าให้ MG996R หรือ MG90S ชนปลายระยะและครางค้าง

## 7. ตารางสัญญาณตามโค้ดเดิม — ยกเลิกแล้ว เก็บเป็นประวัติ

> ⛔ **ห้ามใช้ตารางในหัวข้อนี้ต่อระบบฉบับวันศุกร์** ตารางนี้ยึดพินจาก `Robo/Robo.ino` เดิม ซึ่ง**ขัดกับสายชุดใหม่แบบอันตราย** ไม่ใช่แค่ไม่ตรง
>
> | ขา | ตารางนี้ใช้เป็น | สายชุดใหม่ต่ออะไร | ถ้าเปิดด้วยโค้ดเก่า |
> |---|---|---|---|
> | GPIO25/26/27/32/33 | สัญญาณ Servo | ขาสั่ง TB6612 | **มอเตอร์วิ่งมั่วทันทีที่เปิด** |
> | GPIO13 | `BIN1` เป็น output | ขา DO ของ TCRT5000 | ขา output สองตัวดันกัน |
> | GPIO21/22 | `AIN1` และ `PWMA` | I2C ไป PCA9685 | I2C ใช้ไม่ได้ |
> | GPIO23 | `PWMB` | TFT MOSI | จอไม่ขึ้นภาพ |
> | GPIO35 | RX รับจากกล้อง | Encoder ซ้าย B | กล้องไม่เข้า และเป็นขา input-only |
>
> **ผังที่ต้องใช้จริงอยู่ใน `สรุปการเชื่อมต่อสำหรับอัปเดตวันศุกร์_RoboMDT.md` และ `ตารางการเชื่อมต่อและบัดกรี_RoboMDT.md`** เฟิร์มแวร์ต้องแก้ให้ตรงผังใหม่ก่อนจ่ายไฟครั้งแรก ดูข้อ 0 ในหัวข้อ 7 ของไฟล์สรุปวันศุกร์
>
> เก็บตารางนี้ไว้เพื่ออ้างอิงว่าโค้ดเดิมเคยใช้ขาอะไร ตอนแก้เฟิร์มแวร์จะได้รู้ว่าต้องเปลี่ยนตรงไหนบ้าง

### เซอร์โวแบบเดิม

| อุปกรณ์ | Signal ไป ESP32 | ไฟเลี้ยง | GND |
|---|---:|---|---|
| MG90S มือซ้าย | GPIO32 | PCA9685/servo rail 5V ชั่วคราว | GND ร่วม |
| MG90S มือขวา | GPIO33 | servo rail 5V | GND ร่วม |
| MG996R แขนซ้าย | GPIO25 | servo rail 5V | GND ร่วม |
| MG996R แขนขวา | GPIO26 | servo rail 5V | GND ร่วม |
| SG90 หันหน้า | GPIO27 | servo rail 5V | GND ร่วม |
| SG90 ก้มเงย | ยังไม่ต่อในเดโมแรก | servo rail 5V | GND ร่วม |

หมายเหตุ: ในช่วงใช้โค้ดเดิม สัญญาณเซอร์โวยังออกจาก ESP32 โดยตรง ส่วน PCA9685 อาจใช้เป็นจุดกระจายไฟ servo ได้เฉพาะเมื่อจัดแถวขาให้ถูก แต่ยังไม่ใช้ PWM จาก PCA9685 จนกว่าจะเปลี่ยนเฟิร์มแวร์

### TB6612 ตามโค้ดเดิม

| TB6612 | ESP32/แหล่งจ่าย | หมายเหตุ |
|---|---|---|
| `AIN1/IN1` | GPIO21 | ทิศมอเตอร์ A |
| `AIN2/IN2` | GPIO14 | ทิศมอเตอร์ A |
| `BIN1/IN3` | GPIO13 | ทิศมอเตอร์ B |
| `BIN2/IN4` | GPIO12 | ทิศมอเตอร์ B |
| `PWMA` | GPIO22 | PWM มอเตอร์ A |
| `PWMB` | GPIO23 | PWM มอเตอร์ B |
| `STBY` | 3.3V ชั่วคราว | ผูก HIGH สำหรับใช้กับโค้ดเดิม |
| `VCC` | ESP32 3.3V | ไฟ logic |
| `GND` | GND ร่วม | |
| `VM` | BUS+ 6.0–8.4V | ไฟมอเตอร์ |
| `A01/A02` | มอเตอร์ซ้าย | สลับสองเส้นถ้าทิศกลับ |
| `B01/B02` | มอเตอร์ขวา | สลับสองเส้นถ้าทิศกลับ |

เริ่มทดสอบ PWM ที่ 100–120 และไม่เกินประมาณ 180 ตอนแบตเต็ม 8.4V เพราะมอเตอร์เป็นรุ่น 6V

### กล้อง XIAO

| XIAO | ESP32 | หมายเหตุ |
|---|---|---|
| TX GPIO43 / D6 | GPIO35 RX | ส่งข้อมูลทางเดียวตาม `FullCam.ino` |
| GND | GND | ต้องร่วมกัน |
| 5V | LOGIC-5V | ไฟเลี้ยงที่เคยขาดจากแผนเดิม |

### จอ TFT

ให้ใช้พินและไฟล์ตั้งค่า TFT_eSPI ชุดเดิมที่เคยทำงาน ห้ามเปลี่ยนไดรเวอร์หรือพินก่อนส่งงาน แต่ต้องตรวจว่ามี `VCC` และ `GND` ครบ ไม่ใช่เฉพาะสาย SPI

## 8. การเพิ่ม UBEC ภายหลังโดยไม่รื้อระบบหลัก

เมื่อมี บั๊ก 5A ที่รับอินพุต 6.0–8.4V:

1. ปิดสวิตช์และถอดแบต
2. นำสายสำรอง `UBEC+` ต่อเข้า `UBEC IN+`
3. นำสายสำรอง `UBEC-` ต่อเข้า `UBEC IN-`
4. วัดเอาต์พุต UBEC ให้ได้ 5–6V ตามพิกัดเซอร์โว
5. ถอดสาย `XH-M401 OUT+ → PCA9685 V+`
6. ต่อ `UBEC OUT+ → PCA9685 V+`
7. ต่อ `UBEC OUT- → PCA9685 GND` ฝั่ง servo
8. คง `ESP32 3V3 → PCA9685 VCC` ไว้เหมือนเดิม
9. คง GND ทุกระบบร่วมกัน

```text
ก่อนเพิ่ม UBEC:
LM2596  ───── ESP32/TFT/XIAO
XH-M401 ───── Servo V+ ชั่วคราว

หลังเพิ่ม UBEC:
LM2596 ───── ESP32/TFT/XIAO
UBEC   ───── Servo V+
```

ห้ามต่อเอาต์พุต LM2596 และ UBEC เข้าหากันหรือขนานกัน

## 9. การเพิ่มฟิวส์ภายหลัง

เตรียมสายช่วง `BMS P+ → สวิตช์` ให้มีหัวต่อถอดได้หรือมีระยะสายเผื่อ เมื่อได้ฟิวส์ให้แทรกดังนี้:

```text
เดิม:     BMS P+ ─────────────→ สวิตช์
เพิ่มแล้ว: BMS P+ → ฟิวส์ค่าที่เลือกหลังวัดกระแส → สวิตช์
```

ฟิวส์ควรอยู่ใกล้ BMS/แบตมากที่สุด ไม่ต้องเปลี่ยนสายส่วนอื่น

## 10. การเพิ่ม PCA9685 เป็นตัวขับสัญญาณภายหลัง

PCA9685 เป็นตัวเพิ่มช่อง PWM สำหรับเซอร์โว แต่ไม่ได้เพิ่ม GPIO ทั่วไปทั้งหมด เมื่อเปลี่ยนเฟิร์มแวร์แล้ว:

| PCA9685 | การใช้งาน |
|---|---|
| CH0 | MG996R แขนซ้ายข้อโคน |
| CH1 | MG90S แขนซ้ายข้อไหล่ |
| CH2 | MG996R แขนขวาข้อโคน |
| CH3 | MG90S แขนขวาข้อไหล่ |
| CH4 | SG90 คอหันซ้าย–ขวา |
| CH5 | SG90 ฐานหัวก้ม–เงย |

> ⚠️ **ช่องชุดนี้ถูกสลับใหม่ทั้ง 6 ช่อง** จากที่เคยเขียนไว้ในไฟล์นี้และในไฟล์เก่า ค่ามุมที่คาลิเบรตไว้ใน `รายชื่ออุปกรณ์หุ่นยนต์_RoboMDT.md` ผูกกับ **เลขช่องชุดเก่า** ห้ามคัดลอกค่ามุมตามเลขช่องเด็ดขาด ต้องให้ค่ามุมเดินตามตัวเซอร์โว ดูตารางแปลงในไฟล์รายชื่ออุปกรณ์
| SDA | ESP32 GPIO21 ใน pin map ใหม่ |
| SCL | ESP32 GPIO22 ใน pin map ใหม่ |
| VCC | ESP32 3.3V |
| V+ | UBEC 5–6V |
| GND | GND ร่วม |

การย้ายนี้ต้องทำพร้อมกับเปลี่ยน pin map มอเตอร์ในเฟิร์มแวร์ เพราะโค้ดเดิมใช้ GPIO21/22 สำหรับมอเตอร์อยู่ ห้ามย้ายเฉพาะสาย I2C โดยไม่แก้โค้ด

## 11. การเพิ่ม VL53L0X และ MPR121 ภายหลัง

ทั้งสองตัวเพิ่มบน I2C เดียวกับ PCA9685 หลังจากเฟิร์มแวร์ใหม่พร้อมแล้ว:

| อุปกรณ์ | Address | ต่อ SDA | ต่อ SCL | ไฟ logic |
|---|---:|---|---|---|
| PCA9685 | 0x40 | GPIO21 | GPIO22 | 3.3V |
| VL53L0X | 0x29 | GPIO21 | GPIO22 | ตรวจจากโมดูลจริงว่าใช้ 3.3V หรือ VIN |
| MPR121 | 0x5A | GPIO21 | GPIO22 | ตรวจจากโมดูลจริงว่าใช้ 3.3V หรือ VIN |

MPR121 ไม่ได้ทับซ้อนจนต้องตัดออก: ESP32 มี touch ในตัว แต่ pin touch ถูกใช้กับมอเตอร์/TFT เกือบหมด และการตรวจท่าลูบหลายตำแหน่งเหมาะกับ MPR121 มากกว่า

## 12. ลำดับเปิดระบบครั้งแรก

> ⛔ **ข้อ 0 ก่อนทุกข้อ: แฟลชเฟิร์มแวร์ที่ตรง pin map ชุดใหม่ก่อน** อย่าใช้ผังในหัวข้อ 7 ซึ่งยกเลิกแล้ว ดูชุดค่าที่ต้องแก้ในข้อ 0 หัวข้อ 7 ของ `สรุปการเชื่อมต่อสำหรับอัปเดตวันศุกร์_RoboMDT.md`

1. ถอด ESP32, จอ, XIAO, servo และมอเตอร์ออก
2. ตรวจรอยบัดกรีทุกจุด ไม่มีทองแดงเปลือยแตะกัน
3. ใส่แบตและเปิดสวิตช์ช่วงสั้น
4. วัด BMS output ตั้ง LM2596 เป็น 5.0V และตั้ง XH-M401 เป็น 5.0V ถ้าบอร์ด XH-M401 มีสองโวลุ่ม ให้อ่านตัวอักษรบนบอร์ดก่อนว่าตัวไหน CV ตัวไหน CC ห้ามเดาและห้ามหมุนสุด ถ้ามี CC ให้ตั้งจากค่ากระแสที่วัดได้จริงตอนเซอร์โวทำงานแล้วเผื่อขึ้นไปพอประมาณ
5. ปิดสวิตช์
6. ต่อ ESP32 อย่างเดียว แล้วเปิดทดสอบ
7. ต่อ TFT และ XIAO ทีละตัว
8. ต่อ servo ทีละตัว โดยยังไม่ใส่ horn/แขนกล
9. ยกล้อพ้นพื้น แล้วต่อ TB6612 และมอเตอร์
10. ทดสอบ PWM ต่ำก่อน
11. ติด horn และแขนในตำแหน่งกึ่งกลางหลังตรวจมุม servo แล้ว
12. ทดลองยกขวดเปล่าก่อนเพิ่มน้ำหนัก

## 13. อาการผิดปกติที่ต้องหยุดทันที

- สายหรือสวิตช์ร้อน
- BMS, LM2596 หรือแบตเตอรี่ร้อนเร็วผิดปกติ
- มีกลิ่นไหม้ ควัน หรือเสียงแตกจาก capacitor
- ESP32 รีบูตเมื่อ servo ขยับ
- จอกะพริบหรือ XIAO หลุดการเชื่อมต่อ
- MG996R ครางค้างแต่แขนไม่ขยับ
- มอเตอร์หมุนเองทันทีตอนเปิดระบบ

ถ้าเกิดอาการเหล่านี้ให้ปิดสวิตช์ ถอดแบต และตรวจวงจรแยกเป็นส่วน ห้ามเปิดซ้ำต่อเนื่อง

## 14. ของที่ยังไม่จำเป็นต่อการเปิดระบบครั้งแรก

- MPR121 และแผ่นสัมผัส
- VL53L0X
- Encoder และ PID
- SG90 ก้มเงยตัวที่สอง
- การย้าย servo signal ไป PCA9685
- ฟิวส์และ UBECไม่ทำให้วงจร “เปิดไม่ติด” แต่ควรเพิ่มก่อนใช้งานจริงต่อเนื่องหรือให้เด็กใช้งาน

## 15. จุดที่ต้องยืนยันจากของจริง

- ขา BMS ว่าเป็น `P+/P-` ร่วม หรือมี `C-` แยก
- ขาเข้า/ออกของ CM620
- จอ TFT รับ VCC 3.3V หรือ 5V ตามโมดูลจริง ดูว่ามีเรกูเลเตอร์ 3 ขาบนบอร์ดไหม ถ้าไม่มีคือ 3.3V เท่านั้น จ่าย 5V แล้วพังถาวร
- โมดูล VL53L0X/MPR121 รับไฟที่ขาใด
- ขั้วบวก/ลบของ capacitor electrolytic ทุกตัว
- สวิตช์ KCD-105 ไม่ร้อนเมื่อระบบทำงาน
- บอร์ด XH-M401 มีโวลุ่มกี่ตัว และตัวอักษรบนบอร์ดเขียนว่าตัวไหน CV ตัวไหน CC ห้ามเดาจากตำแหน่ง

## 16. ช่วงแรงดันใช้งานจริงของแพ็ก 2S

### ⚠️ XH-M401 บนแบต 2S อยู่นอกสเปกของชิป

ชิป **XL4016** ที่อยู่ใน XH-M401 ระบุช่วงอินพุตในดาต้าชีตว่า **8V ถึง 40V** แต่แพ็ก 2S ของเราอยู่ที่ 6.0–8.4V แปลว่า**เกือบทั้งช่วงการใช้งานอยู่ต่ำกว่าขั้นต่ำของชิป** มีแค่ตอนชาร์จเต็มใหม่ๆ เท่านั้นที่ถึง 8V

ผลจริงคือมันมักจะทำงานได้ แต่ไม่มีการรับประกันว่าจะรักษา 5V ไว้ได้ โดยเฉพาะจังหวะที่เซอร์โวกินกระแสกระชาก

| BUS | สถานะ |
|---|---|
| 8.4V ชาร์จเต็ม | อยู่ในสเปก ใช้ได้ |
| 8.0V | ขอบล่างของสเปกพอดี |
| 7.4V | **นอกสเปกแล้ว** มักยังทำงานได้แต่ไม่รับประกัน |
| ต่ำกว่า 7.0V | หยุดใช้งาน ชาร์จทันที |

อย่ารอให้ BMS ตัด เพราะ BMS ตัดที่ประมาณ 5.0–5.6V ซึ่งราง 5V พังไปนานแล้ว เลข `6.0V` ที่เป็นขอบล่างของ `BUS+` เป็นขอบเชิงไฟฟ้าของแพ็ก ไม่ใช่ขอบที่ระบบยังทำงานได้

**นี่คือเหตุผลที่ บั๊ก 5A ที่รับอินพุต 6.0–8.4V เป็นของที่ต้องหามาเปลี่ยนจริงๆ ไม่ใช่แค่ของอัปเกรด** ดูตัวเลือกและราคาในหัวข้อ "บั๊กที่ใช้เปลี่ยน XH-M401" ท้ายไฟล์ ส่วน XH-M401 เป็นการยืมของที่มีอยู่มาใช้ชั่วคราวให้ทันวันศุกร์เท่านั้น หัวข้อ 8 มีขั้นตอนเปลี่ยนไว้แล้ว

ส่วน LM2596 ที่เลี้ยงราง Logic ไม่มีปัญหานี้ เพราะรุ่นนั้นรับอินพุตได้ตั้งแต่ 4.5V ขอแค่มี headroom เหนือ 5V ประมาณ 1.5V ก็พอ

**ยังไม่มีขาสำหรับให้เฟิร์มแวร์วัดแรงดันแบตเอง** เพราะ ADC1 ทั้ง 6 ขา (32, 33, 34, 35, 36, 39) ถูกใช้กับมอเตอร์และ Encoder หมดแล้ว ส่วน ADC2 ใช้พร้อม WiFi ไม่ได้ วันศุกร์ให้ใช้มัลติมิเตอร์วัดเอา แต่ควรตัดสินใจตั้งแต่ตอนนี้เพราะแก้ยากหลังบัดกรี ทางที่สะอาดที่สุดคือ **ADS1115 บน I2C เส้นเดิม** ซึ่งไม่กิน GPIO เพิ่มเลย

---

## บันทึกการแก้ไข — 27 สิงหาคม 2569

| # | แก้อะไร | ทำไม |
|:-:|---|---|
| 1 | หัวข้อ 7 เปลี่ยนสถานะจาก "ตารางสำหรับเดโมตามโค้ดเดิม" เป็น **ยกเลิกแล้ว เก็บเป็นประวัติ** พร้อมตารางเทียบว่าขาไหนขัดกันบ้าง | เดิมมีหมายเหตุกำกับแค่ว่า "ยังไม่ใช่ pin map ใหม่" ซึ่งอ่านแล้วเหมือนเป็นทางเลือกที่ใช้ได้ แต่จริงๆ ถ้าหยิบไปใช้คู่กับสายชุดใหม่ GPIO25/26/27/32/33 จะสั่งมอเตอร์แทนที่จะสั่ง Servo = มอเตอร์วิ่งมั่วทันทีที่เปิด |
| 2 | หัวข้อ 12 เพิ่มข้อ 0 ต้องแฟลชเฟิร์มแวร์ที่ตรง pin map ก่อน | ลำดับเดิมเริ่มที่ต่อไฟเลย |
| 3 | หัวข้อ 12 ข้อ 4 เพิ่มเรื่อง current limit ของ XH-M401 | บอร์ด XL4016 บางรุ่นมีสองโวลุ่ม ถ้าตัวที่สองถูกหมุนลงไว้ รางจะพับตัวตอนเซอร์โวกินกระแส แล้วจะหลงคิดว่าบอร์ดเสีย เอกสารเดิมพูดถึงแต่การตั้งแรงดัน |
| 4 | เพิ่มหัวข้อ 16 ช่วงแรงดันใช้งานจริง และเส้นหยุดที่ 7.0V | ตาราง `BUS+` เขียน `6.0–8.4V` ซึ่งเป็นขอบเชิงไฟฟ้าของแพ็ก แต่ buck ต้องการ headroom 1.5–2V ระบบจะเริ่มพังตั้งแต่ 7.0V ก่อน BMS ตัดที่ 5.0–5.6V มาก |
| 5 | เพิ่มบันทึกว่ายังไม่มีขาวัดแรงดันแบต | ADC1 ถูกใช้หมด 6 ขา ADC2 ใช้กับ WiFi ไม่ได้ เป็นเรื่อง pin map ที่ต้องตัดสินก่อนบัดกรีเสร็จ เสนอ ADS1115 บน I2C เส้นเดิม |
| 6 | หัวข้อ 15 ขยายข้อจอ TFT ให้ตัดสินได้จริง | เดิมเขียนแค่ "ตามโมดูลจริง" ซึ่งตัดสินหน้างานไม่ได้ และถ้าเดาผิดคือจอพังถาวร |
| 7 | เปลี่ยนราง Servo จาก 5.0-5.2V เป็น 5.0V ทั้งไฟล์ | ซื้อ headroom ให้ buck เพิ่ม 0.2V ที่ปลายแบตต่ำ |

## บันทึกการแก้ไขรอบสอง — 27 สิงหาคม 2569

| # | แก้อะไร | ทำไม |
|:-:|---|---|
| 1 | หัวข้อ 16 เขียนใหม่: XH-M401 อยู่**นอกสเปก**ของชิป ไม่ใช่แค่คาบเส้นที่ 7.0V | ดาต้าชีต XLSEMI ระบุ XL4016 รับอินพุต **8V–40V** แต่แพ็ก 2S คือ 6.0–8.4V แปลว่ามีแค่ตอนชาร์จเต็มใหม่ๆ ที่อยู่ในสเปก รอบแรกผมประเมินหลวมไปโดยคิดแค่เรื่อง headroom ของ buck ทั่วไป |
| 2 | หัวข้อ 12 ข้อ 4 และหัวข้อ 15 ตัดคำว่า current limit "หมุนขึ้นสุด" ออก | การหมุน CC ขึ้นสุดเท่ากับปิดการป้องกันกระแสเกินทิ้ง และห้ามเดาว่าปุ่มที่สองคือ CC เปลี่ยนเป็นให้อ่านตัวอักษรบนบอร์ดก่อน |
| 3 | เปลี่ยน baud ของ Serial2 เป็น 9600 | `FullCam.ino` บรรทัด 127 ใช้ `Serial1.begin(9600, ...)` ไม่ใช่ 115200 |
| 4 | เพิ่มเหตุผลว่าทำไม UBEC ถึงเป็นของจำเป็น ไม่ใช่ของอัปเกรด | UBEC ออกแบบมาสำหรับ 2S โดยตรงจึงอยู่ในสเปกตลอดช่วงแบต ต่างจาก XL4016 ที่เป็นการยืมของมาใช้ให้ทันวันศุกร์ ขั้นตอนเปลี่ยนอยู่ในหัวข้อ 8 แล้ว |

## บั๊กที่ใช้เปลี่ยน XH-M401 — ไม่ต้องเป็น UBEC

ปัญหาของ XH-M401 มีข้อเดียวคือชิป **XL4016 มีพื้นอินพุตขั้นต่ำ 8V** ซึ่งสูงกว่าแบต 2S ของเรา บั๊กราคาถูกเกือบทุกตัวไม่มีปัญหานี้ จึงไม่จำเป็นต้องเป็น UBEC

| โมดูล | ช่วงอินพุต | ครอบคลุม 2S (6.0–8.4V)? |
|---|---|---|
| XL4016 (XH-M401) | **8–40V** | ❌ ตัวปัญหา |
| LM2596 | 4.5–40V | ✅ |
| XL4005 | 5–32V | ✅ |
| MP1584 | 4.5–28V | ✅ |

**สเปกที่ต้องการจริง:** อินพุตครอบคลุม 6.0–8.4V · เอาต์พุตปรับได้ถึง 5.0V · จ่ายได้ **≥3A ต่อเนื่อง**

ที่มาของ 3A คือกลุ่ม A ขยับพร้อมกัน (MG996R ×2 ≈ 1.2–2.0A + MG90S ×2 ≈ 0.3–0.5A + SG90 ×2 ค้างตำแหน่ง ≈ 0.2A = **~1.7–2.7A**)

| ตัวเลือก | กระแส | ราคาโดยประมาณ | ความเห็น |
|---|---:|---:|---|
| **XL4005 5A** | 5A | ~60–90฿ | **แนะนำ** หัวเหลือจริงสำหรับกลุ่ม A + มอเตอร์ |
| LM2596 ตัวที่สอง | ~2A จริง | ~30–45฿ | ถูกสุด แต่ตึงสำหรับกลุ่ม A ระวังความร้อน |
| UBEC 3A | 3A | ~150–250฿ | ทนโหลดกระชากดีกว่า ถ้าอยากได้ความชัวร์ |
| ~~UBEC 10A~~ | 10A | ~1,000฿+ | **ไม่ต้องซื้อ เกินความจำเป็นเท่าตัว** |

ไม่ว่าเลือกตัวไหน คาปาซิเตอร์ `1000–2200µF` ที่ `V+` ของ PCA9685 ยังต้องใส่ เพราะตัวรับกระแสกระชากจริงคือคาปาซิเตอร์ ไม่ใช่บั๊ก

### รูปแบบการสั่งงานจริง

| กลุ่ม | เซอร์โว | สั่งพร้อมกัน |
|---|---|---|
| **A** | MG996R ×2 (CH0, CH2) + MG90S ×2 (CH1, CH3) | ✅ พร้อมกันได้ และวิ่งพร้อมมอเตอร์ล้อได้ |
| **B** | SG90 คอ/หัว (CH4, CH5) | แยกจังหวะจากกลุ่ม A |

ตอนวัดแรงดันใต้โหลด ต้องวัดขณะ **กลุ่ม A ขยับพร้อมล้อหมุน** ไม่ใช่ตอนอยู่เฉยๆ

## บันทึกการแก้ไขรอบสาม — 28 สิงหาคม 2569

| # | แก้อะไร | ทำไม |
|:-:|---|---|
| 1 | ตัดสเปก "UBEC 2S 10A" ออกทุกไฟล์ เปลี่ยนเป็น "บั๊ก 5A ที่รับอินพุต 6.0–8.4V" | 10A เป็นตัวเลขที่ผมใส่โดยไม่ได้คำนวณโหลดจริง ทำให้ดูเหมือนต้องซื้อของหลักพัน ทั้งที่ความต้องการจริงคือ ~3A และ XL4005 ราคา ~60–90฿ ก็พอ |
| 2 | ระบุว่าประเด็นคือ "อินพุตต้องครอบคลุม 6.0–8.4V" ไม่ใช่ "ต้องเป็น UBEC" | UBEC แค่บังเอิญเข้าเกณฑ์เพราะออกแบบมาสำหรับ 2S–6S บั๊กถูกๆ ที่รับอินพุตต่ำก็ใช้ได้เหมือนกัน |
| 3 | เปลี่ยนข้อจำกัดจาก "ไม่ขยับหลายตัวพร้อมกัน" เป็นกลุ่ม A / กลุ่ม B | รูปแบบใช้งานจริงคือ MG996R ×2 และ MG90S ×2 สั่งพร้อมกัน ร่วมกับมอเตอร์ล้อ ข้อจำกัดเดิมขัดกับการออกแบบ |
| 4 | **ห้ามให้ไฟกำลังผ่านหน้าสัมผัสเบรดบอร์ด** — ย้าย `VM`, `XH-M401 IN+`, `LM2596 IN+` ไปรับจากจุดพักไฟโดยตรง | เจอตอนคำนวณกลุ่ม A + มอเตอร์: กระแสรวมผ่าน `RAW+` คือ ~3.4–4.4A แต่หน้าสัมผัสเบรดบอร์ดรับได้ ~1–2A จะร้อน แรงดันตก และหลุดเป็นจังหวะจน ESP32 รีบูตกลางเดโม |
| 5 | ย้ำว่าคาปาซิเตอร์เป็นของบังคับ ไม่ใช่ของเสริม | เมื่อกลุ่ม A ขยับพร้อมมอเตอร์ ตัวที่รับกระแสกระชากคือคาปาซิเตอร์ ไม่ใช่บั๊ก |
