HoneyKung/metorobot/Robo/Part Robot/แผนปรับโครงจาก_STL_จริง_RoboMDT.md

# แผนปรับโครงจาก STL จริง — RoboMDT

> สถานะ: เอกสารอ้างอิงหลักสำหรับการแก้โครงก่อนพิมพ์
>
> หลักการ: **ไม่รื้อชั้น 1–4 ที่ออกแบบช่องอุปกรณ์และตรวจความสูงไว้แล้ว** เพิ่มเฉพาะภาคจ่ายไฟเซอร์โวในกระเป๋าหลัง พร้อมทางเดินสายและช่องระบายอากาศ
>
> **ข้อกำหนดล่าสุดสำหรับวันศุกร์:** ใช้ STL ชั้น 1–4 เดิม ห้ามเพิ่มเสายึดด้านหน้าหรือส่วนยึดใด ๆ ในแนวกวาดแขน เพราะชนแขน เวอร์ชันที่มีเสาเพิ่มยังไม่ใช้จนกว่าจะตรวจ clearance จากการประกอบจริง

---

## 1. สรุปก่อน: แบบเดิมพังหรือไม่

**ไม่พังทั้งแบบ** โครงสร้างหลัก กลไกแขน ฐานสายพาน ช่องอุปกรณ์ และการแบ่ง 5 ชั้นยังใช้ต่อได้

สิ่งที่ขาดจากการออกแบบวงจรเดิมคือการเผื่อกำลังไฟสำหรับ MG996R ×2 และเซอร์โวตัวอื่นขณะรับโหลดพร้อมกัน เดิมใช้ LM2596 ตัวเดียวเลี้ยงทั้ง logic และ servo ซึ่งเปิดติดและใช้โหลดเบาได้ แต่มีโอกาสแรงดันตกและทำให้ ESP32 รีบูตเมื่อแขนยกของจริง

การแก้ไขจึงไม่ใช่การรื้อโครงทั้งหมด แต่เป็น:

1. เพิ่ม XH-M401 สำหรับไฟ servo โดยเฉพาะ
2. เก็บ LM2596 เดิมไว้เลี้ยง ESP32, TFT และ XIAO
3. ใช้กระเป๋าหลังเป็นช่องภาคจ่ายไฟ XH-M401
4. เพิ่มช่องลม ช่องสาย และจุดยึดในกระเป๋า
5. คงช่องอุปกรณ์ภายในชั้น 1–4 เดิมไว้

---

## 2. ขนาดจาก STL จริง

| ไฟล์ | ขนาดรวม X × Y × Z | สถานะ mesh |
|---|---:|---|
| `ชั้น1.stl` | **130 × 148 × 29 mm** | ปิดสนิท |
| `ชั้น2.stl` | **96 × 134.8 × 24 mm** | มีผิว/ขอบไม่ปิดบางตำแหน่ง ควรตรวจใน slicer |
| `ชั้น3.stl` | **96 × 112 × 35 mm** | ปิดสนิท |
| `ชั้น4.stl` | **96 × 112 × 39.23 mm** | ปิดสนิท |
| `ล้อ1.stl` | 24.93 × 40.94 × 40.93 mm | มีผิว/ขอบไม่ปิดบางตำแหน่ง |
| `ล้อ2.stl` | 29 × 40.94 × 40.93 mm | ปิดสนิท |
| `สายพาน1ชิ้น.stl` | 21.04 × 22.79 × 7 mm | ปิดสนิท; วัสดุ TPU |

ข้อสรุปจาก STL:

- เป็นโครงแบ่งชั้นจริง ไม่ใช่กล่องโล่ง
- ช่องและระดับความสูงถูกทำไว้ใน geometry แล้ว
- ห้ามแก้ความสูงชั้นโดยอ้างจากตาราง Markdown เก่าเพียงอย่างเดียว
- ชั้น 5/หัว ยังไม่ได้ส่งเป็น STL และยังอยู่ระหว่างออกแบบ

---

## 3. ผังอุปกรณ์ฉบับแก้ไข — กระทบน้อยที่สุด

```text
ชั้น 5 — หัว (ยังออกแบบไม่เสร็จ)
  TFT 2.8"
  XIAO ESP32S3 Sense + OV2640
  MPR121 + แผ่นทองแดง
  SG90 ก้มเงยที่ฐานหัว

ชั้น 4 — แขนและคอ (คงโครงเดิม)
  MG996R ×2 ต้นแขน
  MG90S ×2 ที่ข้อต่อแขนตามแบบจริง
  SG90 หันหน้า ยึดกับตัวใกล้ฐานหัว
  อุปกรณ์/ช่องที่ออกแบบไว้เดิม

ชั้น 3 — สมอง (คงช่องเดิม)
  ESP32 DevKit V1 38-pin
  PCA9685 ตามช่องเดิม
  ขาพินและสาย Dupont สำหรับสัญญาณ

ชั้น 2 — อิเล็กทรอนิกส์ (คงช่องเดิม)
  BMS / TB6612 / CM620 ตามช่องที่ทำไว้ใน STL
  ไม่บังคับย้ายอุปกรณ์หากช่องเดิมพอดีแล้ว

ชั้น 1 — ฐาน (คงช่องเดิม)
  แบตเตอรี่ 18650 ×2
  LM2596 ตามช่องเดิม
  TT Motor Encoder ×2
  TCRT5000 ×2
  สายพาน TPU / ล้อ / เฟือง

กระเป๋าหลัง — เพิ่มภาคจ่ายไฟ servo
  XH-M401 / XL4016
  ช่องลม
  ช่องเข้าถึงตัวปรับแรงดัน
  สายกำลังเข้า–ออก
  CM620/ช่องชาร์จยังคงตำแหน่งตามแบบเดิม
```

**ห้ามย้าย BMS, TB6612, PCA9685 หรือ LM2596 เพียงเพราะเอกสารเก่าเสนอให้ย้าย** หากช่องใน STL ทำไว้พอดีและสายต่อได้จริง ให้คงตำแหน่งเดิมเพื่อลดความเสี่ยงก่อนส่งงาน

---

## 4. การแก้กระเป๋าหลังสำหรับ XH-M401

### 4.1 ขนาดอ้างอิง

XH-M401 ที่ใช้ชิป XL4016 มีขนาดโดยประมาณ:

```text
61 × 41 × 27 mm
```

ขนาดจริงของบอร์ดจากร้านอาจต่างกัน ต้องวัดบอร์ดจริงก่อนล็อกแบบสุดท้าย

### 4.2 พื้นที่ภายในขั้นต่ำ

| รายการ | ระยะขั้นต่ำแนะนำ |
|---|---:|
| ความกว้างภายใน | 66–70 mm |
| ความสูงภายใน | 46–50 mm |
| ความลึกภายใน | 32–35 mm |
| ช่องว่างรอบฮีตซิงก์ | อย่างน้อย 5 mm; ด้านช่องลมควรมากกว่า |

ค่าเหล่านี้รวมพื้นที่เสารองและสายบางส่วนแล้ว แต่ยังต้องเทียบกับตำแหน่งขั้วสกรูของบอร์ดจริง

### 4.3 ทิศทางวาง

```text
มองจากด้านหลัง

┌────────────────────────────┐
│   XH-M401                  │
│   61 mm แนวนอน             │
│   41 mm แนวตั้ง             │
│   ฮีตซิงก์หันหาฝาหลัง        │
└────────────────────────────┘
```

- ให้ PCB แนบผนังด้านในด้วยเสารอง 3–5mm
- ให้ฮีตซิงก์หันออกฝาหลัง ไม่หันเข้าหาบอร์ด logic
- หากลึกไม่พอ ให้ทำนูนเฉพาะบริเวณฮีตซิงก์ ไม่ต้องขยายลำตัวทั้งชิ้น
- ฝาหลังต้องถอดได้ด้วยน็อตหรือสลัก

### 4.4 ช่องที่ต้องเพิ่ม

- ช่องลมเข้าด้านล่างของกระเป๋า
- ช่องลมออกตรง/เหนือฮีตซิงก์
- ช่องไขควงเข้าถึงตัวปรับแรงดัน
- รูยึดบอร์ดหรือรางเลื่อนบอร์ด
- ร่องเคเบิลไทร์สำหรับ strain relief
- ช่องสาย `BUS+ / BUS-` เข้ากระเป๋า
- ช่องสาย `SERVO-V+ / SERVO-GND` ออกจากกระเป๋าไป PCA9685
- คงช่องเสียบชาร์จ CM620 ให้เข้าถึงได้

---

## 5. ผังไฟหลังเพิ่ม XH-M401

```text
18650 2S
   ↓
BMS 2S
   ↓
สวิตช์
   ├── TB6612 → Motor
   ├── LM2596 5.0V → ESP32 + TFT + XIAO
   └── XH-M401 5.0V → PCA9685 V+ → Servo ทั้งหมด

GND ของ BMS / LM2596 / XH-M401 / TB6612 / ESP32 / PCA9685
ต้องต่อร่วมกันทั้งหมด
```

### สายผ่านกระเป๋า

| สาย | ขนาด | จาก → ไป | หมายเหตุ |
|---|---|---|---|
| `XH-IN+` | 18–20AWG | ไฟหลังสวิตช์ → XH-M401 IN+ | สายกำลัง |
| `XH-IN-` | 18–20AWG | BUS-/GND → XH-M401 IN- | เดินคู่กับ IN+ |
| `SERVO-V+` | 18–20AWG | XH-M401 OUT+ → PCA9685 V+ | ห้ามใช้ Dupont |
| `SERVO-GND` | 18–20AWG | XH-M401 OUT- → PCA9685 GND | เดินคู่กับ V+ |

ห้ามต่อเอาต์พุตบวกของ XH-M401 เข้ากับเอาต์พุตบวกของ LM2596 แต่ GND ต้องร่วมกันที่จุดเดียวคือ `BMS P-` แบบ star ground

### สายที่ต้องเผื่อช่องผ่านกระเป๋าเพิ่ม

| สาย | ขนาด | จาก → ไป | ทำไมต้องเผื่อตั้งแต่ตอนนี้ |
|---|---|---|---|
| `UBEC+` | 20AWG | BUS+ → หุ้มปลายเก็บไว้ | สายสำรองสำหรับเปลี่ยนเป็น UBEC 2S 10A ภายหลัง ถ้าไม่เผื่อช่องไว้ ตอนเปลี่ยนต้องรื้อกระเป๋าใหม่ |
| `UBEC-` | 20AWG | BUS- → หุ้มปลายเก็บไว้ | เดินคู่กับ `UBEC+` |

กระเป๋าต้องมีที่ว่างพอเก็บปลายสายสองเส้นนี้แบบหุ้มฉนวนไว้ ไม่ให้แตะอะไร

### คาปาซิเตอร์ที่ต้องเผื่อพื้นที่

ตัวเก็บประจุบัลก์ต้องอยู่ใกล้บอร์ดที่มันเลี้ยงมากที่สุด ถ้าไม่เผื่อพื้นที่ไว้ตั้งแต่ตอนออกแบบจะหาที่วางไม่ได้ตอนประกอบจริง

| ตัว | ค่า | ต้องอยู่ใกล้ | ขนาดโดยประมาณ |
|---|---|---|---|
| ราง Servo | `1000–2200µF 16V` | PCA9685 | Ø10–13mm สูง 20–25mm |
| ราง Motor | `470–1000µF 16V` | TB6612 | Ø8–10mm สูง 15–20mm |
| ราง Logic | `100–470µF 16V` | ESP32 | Ø6–8mm สูง 12–15mm |

ถ้าไม่ใส่ ESP32 จะรีบูตทันทีที่เซอร์โวหลายตัวขยับพร้อมกัน

---

## 6. สิ่งที่ไม่ต้องแก้ใน STL ตอนนี้

- ขนาดรวมชั้น 1–4
- ช่อง MG996R และ MG90S
- กลไกแขนที่ยื่นออกด้านหน้า
- ตำแหน่ง SG90 หันหน้าที่ติดกับตัวและอยู่ใกล้ฐานหัว
- ช่องแบตเตอรี่เดิม
- ฐานสายพานและล้อ
- สายพาน TPU
- ช่องบอร์ดที่ทำพอดีกับอุปกรณ์เดิม

หากไม่มีการชนจากสายหรือหัวปลั๊กจริง ไม่ควรขยายชั้นเหล่านี้ก่อนพิมพ์

---

## 7. สิ่งที่ต้องตรวจเพิ่มก่อนสั่งพิมพ์

### ต้องตรวจจากบอร์ด XH-M401 จริง

- ขนาด PCB จริง
- ความสูงฮีตซิงก์จริง
- ตำแหน่งขั้ว `IN+/IN-/OUT+/OUT-`
- ทิศทางไขควงปรับแรงดัน
- ตำแหน่งรูยึด
- รัศมีดัดสาย 18–20AWG

### ต้องตรวจใน slicer

- `ชั้น2.stl`: ตรวจผนัง/รูที่ slicer ซ่อม เนื่องจาก mesh ไม่ปิดสนิทบางตำแหน่ง
- `ล้อ1.stl`: ตรวจซี่ล้อและรูเพลา เนื่องจาก mesh ไม่ปิดสนิทบางตำแหน่ง
- ตรวจ Preview ทุกเลเยอร์ก่อนเริ่มพิมพ์ยาว

---

## 8. ถ้า XH-M401 มาไม่ทันก่อนพิมพ์

สร้างกล่องทดสอบใน Tinkercad ขนาด `61 × 41 × 27 mm` แล้วเพิ่มเผื่อรอบด้านตามหัวข้อ 4 หรือพิมพ์กระเป๋าแยกจากลำตัวเพื่อแก้/พิมพ์ใหม่เฉพาะกระเป๋าได้

แนวทางปลอดภัยต่อเวลา:

1. พิมพ์ชั้น 1–4 ตาม STL เดิม
2. แยกกระเป๋าและฝากระเป๋าเป็นชิ้นพิมพ์ต่างหาก
3. รอวัด XH-M401 จริงก่อนพิมพ์กระเป๋าฉบับสุดท้าย
4. หากต้องส่งก่อน ให้ใช้ฝากระเป๋าชั่วคราวหรือแสดงระบบด้วย LM2596/USB แยก

---

## 9. สถานะการออกแบบ

| ส่วน | สถานะ |
|---|---|
| ชั้น 1 | ใช้แบบเดิม ตรวจ slicer แล้วพิมพ์ได้ |
| ชั้น 2 | ใช้แบบเดิม แต่ตรวจ mesh ใน slicer |
| ชั้น 3 | ใช้แบบเดิม |
| ชั้น 4 | ใช้แบบเดิม |
| ชั้น 5/หัว | ยังต้องออกแบบ/ส่ง STL |
| กระเป๋าหลัง | แก้เฉพาะพื้นที่ XH-M401 ช่องลมและทางเดินสาย |
| ระบบไฟ servo | เพิ่ม XH-M401 |
| ระบบ logic | คง LM2596 เดิม |

**ข้อสรุป:** แบบเดิมไม่ได้พัง ต้องแก้เฉพาะกระเป๋าหลังและเส้นทางไฟ servo ไม่ต้องออกแบบชั้น 1–4 ใหม่ทั้งหมด

---

## บันทึกการแก้ไข — 27 สิงหาคม 2569

| # | แก้อะไร | ทำไม |
|:-:|---|---|
| 1 | หัวข้อ 5 เพิ่มสายสำรอง `UBEC+/UBEC-` เข้าตารางสายที่ผ่านกระเป๋า | เป็นหัวใจของแผนโมดูลาร์ที่เขียนไว้ในไฟล์แผนแบตเตอรี่ แต่ตกหล่นจากไฟล์นี้ ถ้าไม่เผื่อช่องผ่านกระเป๋าไว้ตั้งแต่ตอนออกแบบ ตอนเปลี่ยนเป็น UBEC ต้องรื้อกระเป๋าพิมพ์ใหม่ |
| 2 | หัวข้อ 5 เพิ่มตารางขนาดคาปาซิเตอร์ 3 ตัว | ตัวเก็บประจุบัลก์ต้องอยู่ใกล้บอร์ดที่มันเลี้ยง เป็นข้อจำกัดเชิงพื้นที่ที่ต้องรู้ก่อนพิมพ์ ไม่ใช่เรื่องที่หาที่วางเอาตอนประกอบได้ ตัวใหญ่สุดสูงถึง 25mm |
| 3 | หัวข้อ 5 ระบุจุด star ground ที่ `BMS P-` | เดิมเขียนแค่ว่า GND ต้องต่อร่วมกัน ซึ่งตีความได้หลายแบบ ถ้าปล่อยให้กระแส Servo หลายแอมป์ไหลย้อนผ่านสาย Dupont ของ ESP32 สายจะร้อนและ ESP32 จะรีบูต |
| 4 | เปลี่ยนราง Servo จาก 5.0-5.2V เป็น 5.0V | buck ต้องการ headroom 1.5–2V ที่กระแสสูง ตั้ง 5.0V ซื้อ headroom เพิ่มที่ปลายแบตต่ำ |
