HoneyKung/metorobot/Robo/Part Robot/แผนผังชั้นอุปกรณ์_RoboMDT.md

# 🏗️ แผนผังการจัดวางชั้นอุปกรณ์หุ่นยนต์ RoboMDT (ฉบับใหม่)

> **อัปเดตล่าสุด:** 26 เมษายน 2569  
> **เป้าหมาย:** ตัวเล็กที่สุด + ฟังก์ชันสูงสุด + การจัดการสายไฟเรียบร้อย

---

## 📐 ข้อจำกัดกรอบนอก

| พารามิเตอร์ | ค่า |
|---|-----|
| **กรอบนอก** | 10 × 10 cm (100 × 100 mm) |
| **พื้นที่ใส่ของจริง** | 9 × 9 cm (90 × 90 mm) |
| **ความยาวสายพาน (ล้อรถถัง)** | 13 cm (130 mm) — ยาวกว่าลำตัว |
| **เป้าหมายความสูงรวม** | ≤ 20 cm (ลดจากเดิม 25 cm) |

---

## 📏 ขนาดอุปกรณ์ทั้งหมด (ข้อมูลจริง)

| อุปกรณ์ | ขนาด (L × W × H mm) | หมายเหตุ |
|---|:---:|---|
| TT Motor Encoder (1:90) | 70 × 22 × 18 (ตัว motor) | +encoder ด้านหลัง ~10mm |
| MG996R Servo | 40.7 × 19.7 × 42.9 | **ตัวใหญ่สุด** — กำหนดความสูงชั้นแขน |
| MG90S Servo | 22.8 × 12.2 × 28.5 | ติดปลายแขน (ข้อมือ) |
| SG90 Servo | 22.5 × 12 × 22.7 | หัว + คอ |
| ESP32 38-Pin | 55 × 28 × 12 | ไม่รวมขาพิน |
| TB6612FNG Module | 20 × 20 × 3 | **เล็กมาก** |
| PCA9685 Module | 62.5 × 25.4 × 15 | รวม header |
| LM2596 Buck Conv. | 43 × 21 × 14 | |
| BMS 2S 16A | ~47 × 23 × 3 | บางมาก |
| CM620 Charger 2S | ~30 × 17 × 5 | (ประมาณ) |
| 18650 Cell × 2 (BH-18650x2-M) | 76 × 41 × 20 | กระบะถ่าน |
| จอ TFT 2.8" ST7789 | 50 × 69 × 3 | PCB module |
| HW-201 IR Sensor | 32 × 14 × 7 | × 2 ตัว |
| VL53L0X | 13 × 18 × 2 | Laser ToF |
| MPR121 | 28 × 20 × 3 | (จะเพิ่ม) |
| สวิตช์ KCD-105 | Ø23 × 25 | ฝังข้างตัว |
| 470µF Cap | Ø8 × 12 | |
| 100µF Cap | Ø6 × 10 | |

---

## 🔵 แผนผังชั้นอุปกรณ์ (ใหม่ — 5 ชั้น)

### ภาพรวม (มุมข้าง)

```
                ┌─────┐
                │  😊 │ ← จอ TFT 2.8" + กล้อง + MPR121
                │ HEAD │    ชั้น 5: หัว
                └──┬──┘
                   │        SG90 × 2 (หัน + ก้มเงย)
                ┌──┴──┐
           ╔═══╡     ╞═══╗    ชั้น 4: คอ + แขน
      ┌────╢   │  ●  │   ╟────┐
      │ARM1╚═══╡     ╞═══╝ARM2│  MG996R × 2 (ยกแขน)
      │    │   └─────┘   │    │  + MG90S × 2 (มือหนีบ)
      └────┘             └────┘
             ┌─────────┐
             │ ESP32   │    ชั้น 3: สมอง
             │ PCA9685 │    ESP32 + PCA9685 + Perfboard
             │[USB▼]   │    USB เจาะรูผนังล่าง
             └─────────┘
             ┌─────────┐
             │ BMS     │    ชั้น 2: อิเล็กทรอนิกส์
             │ TB6612  │    BMS + TB6612 + CM620
             │ CM620   │
             └─────────┘
     ┌───────────────────────┐
     │ ╔═══╗  ═══  ╔═══╗    │  ชั้น 1: ฐาน + พลังงาน + ขับเคลื่อน
     │ ║MOT║ IR×2  ║MOT║    │  Motor×2 + IR + VL53L0X
     │ ╚═══╝VL53L0X╚═══╝    │  + LM2596 + รางถ่าน 18650×2
     │  🔋🔋   LM2596       │  สายพานรถถัง 13cm
     └───────────────────────┘
         █████████████████       ← สายพาน (ยาว 13cm)
```

---

## 🔷 ชั้นที่ 1 — ฐาน + พลังงาน + ขับเคลื่อน (Ground Floor)

### ความสูงชั้น: ~40 mm

```
ภาพบน (Top View) — 96 × 135 mm (พื้นที่ใช้ได้)
สายพานยื่นออกด้านข้างซ้าย-ขวา

                  ◄── 96 mm ──►
   ┌─────────────────────────────────────┐
   │  [IR-L]     [VL53L0X]     [IR-R]   │ ← ด้านหน้า
   │  (HW-201)   (Laser)     (HW-201)  │
ล  │         ┌──────────────┐           │  ล
อ  │         │   LM2596     │           │  อ
ส  │         │   43×21 mm   │           │  ส
า  │         └──────────────┘           │  า
ย  │                                     │  ย
พ  │     (นอต)            (นอต)         │  พ
า  │                                     │  า
น  │  ╔══════╗  ┌──────────┐  ╔══════╗  │  น
   │  ║MOTOR ║  │ รางถ่าน  │  ║MOTOR ║  │
   │  ║  L   ║  │ 18650×2  │  ║  R   ║  │ 135
   │  ║ 22mm ║  │ 76×41mm  │  ║ 22mm ║  │ mm
   │  ╚══════╝  └──────────┘  ╚══════╝  │
   │                                     │
   │     (นอต)            (นอต)         │
   └─────────────────────────────────────┘
```

| ตำแหน่ง | อุปกรณ์ | ขนาด | วิธีติดตั้ง |
|---|---|---|---|
| ซ้าย-ขวา | TT Motor Encoder × 2 | 70×22×18 mm | ติดผนังด้านใน 2 ข้าง, เพลาทะลุออกสู่ล้อสายพาน |
| กลาง-หน้า | VL53L0X | 13×18×2 mm | ติดหันหน้าไปข้างหน้า สำหรับวัดระยะ |
| หน้า-ซ้าย/ขวา | HW-201 IR × 2 | 32×14×7 mm | ติดมุมหน้า 2 ข้าง |
| กลาง-หน้า (ใต้ Laser) | LM2596 Buck Converter | 43×21×14 mm | ย้ายมาจากชั้น 2 เดิม |
| กลาง-ล่าง | BH-18650x2-M (รางถ่าน) | 76×41×20 mm | วางตรงกลาง ระหว่าง Motor 2 ตัว |

#### 📌 จุดสำคัญ:
- **รางถ่าน + มอเตอร์** อยู่ชั้นเดียวกัน → จุดศูนย์ถ่วงต่ำสุด ✅
- **LM2596** ย้ายมาชั้น 1 วางหน้ารางถ่าน ใกล้แหล่งจ่ายไฟ
- IR sensor ติดมุมหน้า 2 ข้าง (ตามภาพจริง)
- นอตยึด 4 จุด สำหรับแผ่นกั้นชั้น
- สายพานยาว 130mm ยื่นออกด้านข้างซ้าย-ขวา

---

## 🟢 ชั้นที่ 2 — อิเล็กทรอนิกส์ (Electronics Floor)

### ความสูงชั้น: ~24 mm

```
ภาพบน (Top View) — 96 × 112 mm

┌──────────────────────────────────────┐
│     (นอต)    ช่องลอดสายไฟ   (นอต)   │ ← ด้านหน้า
│              ┌──┬──┬──┬──┐          │
ส              └──┴──┴──┴──┘          ส
า│                                    │า
ย│  ┌────────────────┐  ┌──────┐      │ย
ไ│  │                │  │TB6612│      │ไ
ฟ│  │     BMS        │  │20×20 │      │ฟ
 │  │    47×23 mm    │  └──────┘      │
 │  │                │                │
 │  └────────────────┘  ┌──────┐      │
 │                      │CM620 │      │
 │  (นอต)               │30×17 │(นอต) │
 │                      └──┬───┘      │
 │                         │USB       │
 │  ═══════════════════════╪══════    │
 │                    [เจาะรูชาร์จ]   │
 │                                    │
 │       ═══ ห้ามวางอะไร ═══         │ ← ด้านล่าง
 └────────────────────────────────────┘
```

| ตำแหน่ง | อุปกรณ์ | ขนาด | วิธีติดตั้ง |
|---|---|---|---|
| ซ้าย-กลาง | BMS 2S 16A | 47×23×3 mm | วางแนวนอน (ย้ายมาจากใต้แบตเดิม) |
| ขวา-บน | TB6612FNG Motor Driver | 20×20×3 mm | ย้ายมาจากชั้น 3 เดิม |
| ขวา-ล่าง | CM620 Charger 2S | 30×17×5 mm | USB หันลง เจาะรูผนังด้านล่าง |
| หน้า-กลาง | ช่องลอดสายไฟ | — | รูเจาะในแผ่นกั้น สำหรับสายจากชั้น 1↔2 |
| ซ้าย-ขวา | ช่องเดินสายไฟ | — | สายไฟเดินตามผนังด้านข้าง |
| ด้านล่าง | ห้ามวางอะไร | — | เว้นที่สำหรับหลบสายพาน/โครงสร้าง |

#### 📌 จุดสำคัญ:
- **TB6612 ย้ายมาจากชั้น 3** → ชั้น 3 เหลือแค่ ESP32 + PCA9685
- **CM620 USB เจาะรูผนังด้านล่าง** → ชาร์จแบตได้โดยไม่ต้องถอด
- **ช่องลอดสายไฟ** ด้านหน้า สำหรับสายจากชั้น 1 (มอเตอร์/เซนเซอร์)
- BMS บาง 3mm → ประหยัดความสูง
- **ห้ามวางอะไรด้านล่าง** ตามภาพจริง

---

## 🔵 ชั้นที่ 3 — สมอง (Brain Floor)

### ความสูงชั้น: ~25 mm

> ⚠️ ชั้นนี้เหลือแค่ **2 ฮาร์ดแวร์หลัก** (ESP32 + PCA9685) หลังจากย้าย TB6612 ไปชั้น 2

```
ภาพบน (Top View) — 90 × 90 mm

                       ช่องเดินสายขึ้นชั้น 4
                       ┌──┬──┬──┬──┐
┌──────────────────────┴──┴──┴──┴──┴───────────┐
│                                              │ ← ด้านหน้า
│  ┌────────────────────────────────┐          │
│  │   PCA9685 (62.5 × 25.4 mm)    │          │
│  │   ↑↑↑ ขาชี้ขึ้น (male header) │          │
│  │   สาย Servo เสียบตรง CH0-CH5  │          │
│  │   (ใช้สาย Servo/Dupont ไม่ใช่ JST) │     │
│  │   [1000µF + 100µF Cap]        │          │
│  └────────────────────────────────┘          │
│                                              │
สายไฟ ┌────── Perfboard ──────────────┐  สายไฟ
ผนัง  │  ┌─────────────────────────┐  │  ผนัง
ซ้าย  │  │    ESP32 38-Pin         │  │  ขวา
 │    │  │    28 × 55 mm (กว้าง×ยาว)│  │   │
 │    │  │  ↓↓↓ ขาชี้ลง            │  │   │
 │    │  │  (เสียบ Female Header   │  │   │
 │    │  │   บน Perfboard)         │  │   │
 │    │  └─────────────────────────┘  │
 │    │                               │
 │    │  [100µF] [10µF]  JST Headers  │   │
 │    └──────────────┬────────────────┘   │
│                    │USB                  │
│  ══════════════════╪═══════════════════  │
│               [เจาะรู USB]              │ ← ผนังด้านล่าง
└──────────────────────────────────────────┘

ภาพข้าง (Side View) — แสดงความสูง 25mm:

     ┌─ แผ่นกั้นชั้น 3↔4 ─────────────────────┐
     │                                          │
  5mm│  PCA9685 ขาชี้ขึ้น                        │
     │  + สาย Servo/Dupont เสียบตรง CH0-CH5     │
     │                                          │
     ├── ─ ─ ─ ─ ─ ─ ─ ─ ─ ─ ─ ─ ─ ─ ─ ─ ─ ─┤
     │                                          │
 12mm│  ESP32 ขาชี้ลง (เสียบ Female Header)      │
     │  + Perfboard (บอร์ดไข่ปลา)               │
     │  + Capacitor บัดกรีบน Perfboard          │
     │                                          │
     ├── ─ ─ ─ ─ ─ ─ ─ ─ ─ ─ ─ ─ ─ ─ ─ ─ ─ ─┤
     │                                          │
  8mm│  ช่องเดินสายลงชั้น 2 + ขึ้นชั้น 4        │
     │  + JST Header บน Perfboard               │
     │                                          │
     └─ แผ่นกั้นชั้น 2↔3 ─[USB เจาะรู]────────┘
```

### 🔧 วิธีติดตั้ง ESP32 + PCA9685 บน Perfboard

```
ESP32 (ขาตัวผู้บัดกรีมาแล้ว ชี้ลง):

    ESP32 Board
    │ │ │ │ │ │ │ │ │ │ │   ← ขาตัวผู้ (male) ชี้ลง
    ▼ ▼ ▼ ▼ ▼ ▼ ▼ ▼ ▼ ▼ ▼
   ╔═══════════════════════╗
   ║  Female Header 1×19   ║   ← บัดกรีลง Perfboard
   ╠═══════════════════════╣      ESP32 เสียบลงมา → ถอดได้
   ║     Perfboard         ║
   ║  (บอร์ดไข่ปลา)        ║   ← เดินลายบัดกรีเชื่อมไปยัง
   ║                       ║      JST Header แต่ละกลุ่ม
   ║  [JST🔵] [JST🟢] ... ║   ← JST-XH Header บัดกรีบน Perfboard
   ╚═══════════════════════╝

PCA9685 (ขาตัวผู้บัดกรีมาแล้ว ชี้ขึ้น):

   ↑ ↑ ↑ ↑ ↑ ↑ ↑ ↑ ↑ ↑ ↑   ← ขาตัวผู้ (male) ชี้ขึ้น
   ╔═══════════════════════╗
   ║  PCA9685 Board        ║
   ║  Servo Header 3-pin   ║   → สาย Servo มาตรฐาน (Dupont 3-pin)
   ╚═══════════════════════╝      เสียบตรง CH0-CH5 ได้เลย
     ยึดด้วยสกรู/กาว บน Perfboard หรือแผ่นกั้นชั้น

   ⚠️ JST-XH housing หนาเกินไป เสียบ servo header ชนกัน!
      → ใช้สาย Servo/Dupont มาตรฐานเสียบตรงแทน
      → I2C input ใช้สาย Dupont 4-pin หรือบัดกรีตรง
```

| ตำแหน่ง | อุปกรณ์ | ขนาด | วิธีติดตั้ง |
|---|---|---|---|
| ด้านล่าง (USB หันลง) | ESP32 38-Pin | 28×55×12 mm (กว้าง×ยาว) | เสียบ Female Header บน Perfboard, USB เจาะรูผนังล่าง |
| ด้านบน | PCA9685 | 62.5×25.4×15 mm | ขาชี้ขึ้น, สาย Servo/Dupont เสียบตรง (ไม่ใช่ JST เพราะ housing หนาชนกัน) |
| บน Perfboard | Female Header 1×19 × 2 | 2.54mm pitch | บัดกรีลง Perfboard สำหรับเสียบ ESP32 |
| บน Perfboard | JST-XH Header หลายตัว | 2.54mm pitch | บัดกรีลง Perfboard แยกกลุ่มตามสี |
| บน Perfboard/ESP32 | Cap 100µF + 10µF | — | 100µF คร่อม VIN-GND / 10µF คร่อม 3V3-GND |
| บน PCA9685 | Cap 1000µF + 100µF | — | 1000µF ที่ C2 / 100µF ข้าง V+-GND |

#### 📌 จุดสำคัญ:
- **เหลือ 2 ฮาร์ดแวร์** (ESP32 + PCA9685) + Perfboard เป็นฐาน
- **ESP32 USB หันลง** → เจาะรูผนังด้านล่าง (เหมือน CM620 ที่ชั้น 2)
- **PCA9685 ขาชี้ขึ้น** → สาย Servo/Dupont เสียบตรง CH0-CH5 (ไม่ใช้ JST เพราะ housing หนาชนกัน)
- **Perfboard** เป็นตัวกลาง: รับ Female Header ของ ESP32 + บัดกรี JST Header ทุกกลุ่ม
- ใช้ **JST-XH 2.54mm** ทุกจุดเชื่อมต่อ → ถอดใส่ง่าย ป้องกันเสียบผิด
- PCA9685 รับ Servo ทั้ง 6 ตัว → **ลด GPIO จาก ESP32 ลง 5 pin**
- **ดูรายละเอียดการเสียบสายทั้งหมดที่:** แผนเสียบสายไฟ_RoboMDT.md

---

## 🟠 ชั้นที่ 4 — คอ + แขน (Neck + Arms Floor)

### ความสูงชั้น: ~45 mm (กำหนดโดย MG996R สูง 42.9mm)

```
ภาพหน้า (Front View) — ชั้นนี้กว้างที่สุด

          MG90S         MG90S
          (มือL)        (มือR)
           ┌─┐           ┌─┐
           │▧│           │▧│
      ┌────┤ ├───┐  ┌───┤ ├────┐
      │    └─┘   │  │   └─┘    │
      │  MG996R  │  │  MG996R  │
      │  (แขนL)  │  │  (แขนR)  │
      │  40.7×   │  │  40.7×   │
      │  19.7×   ├──┤  19.7×   │
      │  42.9mm  │  │  42.9mm  │
      └──────────┘  └──────────┘
            ▲              ▲
            │   ┌──────┐   │
            └───┤ ตัว  ├───┘
                │ ถัง  │
                └──────┘

ภาพบน (Top View) — 90 × 90 mm ตัวถัง

┌──────────────────────────────────────┐
│            ┌──────────┐              │
│            │ข้อต่อคอ  │              │
│            │ (SG90×2) │              │
│            └──────────┘              │
│                                      │
│  ╔═══════╗              ╔═══════╗    │
│  ║MG996R ║   ช่องเดิน  ║MG996R ║    │
│  ║ ARM-L ║    สาย      ║ ARM-R ║    │
│  ║40.7×  ║   กลาง     ║40.7×  ║    │
│  ║19.7   ║              ║19.7   ║    │
│  ╚═══════╝              ╚═══════╝    │
│      │                      │        │
│   [MG90S]                [MG90S]     │
│   มือ-L                  มือ-R      │
│                                      │
└──────────────────────────────────────┘
```

| ตำแหน่ง | อุปกรณ์ | ขนาด | วิธีติดตั้ง |
|---|---|---|---|
| ซ้าย-ข้าง | MG996R (แขนซ้าย) | 40.7×19.7×42.9 mm | ติดผนังด้านใน, เพลาชี้ออกด้านข้าง → ยกแขนขึ้น/ลง |
| ขวา-ข้าง | MG996R (แขนขวา) | 40.7×19.7×42.9 mm | กลับทิศกับข้างซ้าย |
| ปลายแขนซ้าย | MG90S (มือซ้าย) | 22.8×12.2×28.5 mm | ติดปลายแขน → หุบ/ออก |
| ปลายแขนขวา | MG90S (มือขวา) | 22.8×12.2×28.5 mm | ติดปลายแขน → หุบ/ออก |
| กลาง-บน | SG90 × 2 (หันหัว + ก้มเงย) | 22.5×12×22.7 mm | ข้อต่อคอ → ยึดชั้นหัว |

#### 📌 การจับของ:
```
ท่าเปิด (Normal):          ท่าจับ (Grip):
                            
   ╱──╲          ╱──╲         ╱──╲  ╱──╲
  │มือ│        │มือ│        │มือ││มือ│
  │ L │        │ R │        │ L ││ R │
   ╲──╱          ╲──╱         ╲──╱  ╲──╱
  ← ออก →      ← ออก →      → หุบเข้า ←
  
  MG90S ทั้ง 2 ตัวหมุนเข้าหากันตรงกลาง
```

#### 📌 จุดสำคัญ:
- MG996R กว้าง 19.7mm × 2 = 39.4mm → ใส่ 2 ข้างพอดีใน 90mm (เหลือ 50.6mm ตรงกลาง)
- MG90S ติดปลายแขน **นอกลำตัว** → ไม่กินพื้นที่ภายใน
- คอใช้ SG90 × 2 ซ้อนกัน: ตัวล่างหันซ้าย-ขวา, ตัวบนก้ม-เงย
- ช่องเดินสายเซอร์โว: สาย 4 เส้น (MG996R×2 + SG90×2) ลงไปชั้น 3 → PCA9685

---

## 🔴 ชั้นที่ 5 — หัว (Head)

### ความสูงชั้น: ~75 mm (จอ 69mm + ขอบ)

```
ภาพหน้า (Front View)

         ┌─────────────┐
         │  ┌───────┐  │
         │  │       │  │
         │  │  จอ   │  │
         │  │ TFT   │  │
         │  │ 2.8"  │  │
         │  │ 😊    │  │
         │  │       │  │
         │  └───────┘  │
         │  ○ กล้อง    │ ← XIAO ESP32S3 + OV2640
         │             │
         │ [MPR121+Cu] │ ← Touch Pad ด้านบนหัว
         └─────────────┘

ภาพบน (Top View)

┌───────────────────┐
│  ████████████████  │ ← แผ่นทองแดง + MPR121 (ลูบหัว)
│  ┌──────────────┐  │
│  │   XIAO       │  │ ← กล้องด้านหน้า
│  │   ESP32S3    │  │
│  │   Sense      │  │
│  └──────────────┘  │
│                    │
│  ┌──────────────┐  │
│  │  TFT 2.8"   │  │ ← จอแสดงตา
│  │  50 × 69 mm  │  │
│  └──────────────┘  │
└───────────────────┘
```

| ตำแหน่ง | อุปกรณ์ | ขนาด | วิธีติดตั้ง |
|---|---|---|---|
| หน้า | TFT 2.8" ST7789 | 50×69×3 mm | ติดหน้าหัว; native 240×320 px |
| หน้า-บน | XIAO ESP32S3 Sense + OV2640 | 21×17.5×15 mm | ติดเหนือจอ กล้องหันหน้า |
| บน-ศีรษะ | MPR121 + แผ่นทองแดง | 28×20 + แผ่นทองแดง | ติดด้านบนหัว → Touch Pad ลูบหัว |

---

## 📊 สรุปความสูงรวม

| ชั้น | เนื้อหา | ความสูง | ความสูงสะสม |
|:---:|---|:---:|:---:|
| 1 | ฐาน + Motor×2 + รางถ่าน 18650 + LM2596 + IR + VL53L0X (96×135mm) | **40 mm** | **40 mm** |
| — | แผ่นกั้นชั้น 1↔2 (MDF/3D Print 2mm) | 2 mm | 42 mm |
| 2 | BMS + TB6612 + CM620 (96×112mm) | **24 mm** | **66 mm** |
| — | แผ่นกั้นชั้น 2↔3 | 2 mm | 68 mm |
| 3 | ESP32 + PCA9685 + Perfboard + Cap | **25 mm** | **93 mm** |
| — | แผ่นกั้นชั้น 3↔4 | 2 mm | 95 mm |
| 4 | คอ (SG90×2) + MG996R จุดยึดแขน | 45 mm | 140 mm |
| — | คอ (ข้อต่อ) | 5 mm | 145 mm |
| 5 | หัว (จอ + กล้อง + MPR121) | 75 mm | 220 mm |
| **รวม** | | | **~22 cm** |

> 🎯 ชั้น 1 สูงขึ้นเป็น 40mm (รองรับมอเตอร์+รางถ่าน+LM2596) / ชั้น 2 สูง 24mm

---

## 🔌 แผนการจัดการสายไฟ (Cable Management)

### หลักการ: **แยกสาย 3 กลุ่ม + เดินตามผนัง**

```
ภาพตัด (Cross Section) — แสดงช่องเดินสาย

┌──────────────────────────────┐
│                              │
│  ▓▓ อุปกรณ์    ║ สายไฟ ║    │
│                ║  POWER║    │ ← ผนังด้านซ้าย: สาย Power (20AWG)
│                ║       ║    │
│  ▓▓ อุปกรณ์   ║       ║    │
│                ╚═══════╝    │
│                              │
│  ╔═══════╗                   │
│  ║ SIGNAL║    ▓▓ อุปกรณ์    │ ← ผนังด้านขวา: สาย Signal (Servo/I2C)
│  ║  DATA ║                   │
│  ╚═══════╝                   │
│                              │
└──────────────────────────────┘
         ↑
  ผนังด้านหลัง: สาย Serial กล้อง
```

### กลุ่มสายไฟ 3 กลุ่ม

#### 🔴 กลุ่ม 1: สายจ่ายไฟ (Power — 20AWG แดง/ดำ)
| จุดเริ่ม | จุดจบ | เส้นทาง |
|---|---|---|
| แบต 18650 | BMS 2S | ชั้น 2 → ภายในชั้น |
| BMS | LM2596 | ชั้น 2 → ภายในชั้น |
| LM2596 (5V out) | ESP32 VIN | ชั้น 2 → **ผนังซ้าย** → ชั้น 3 |
| LM2596 (5V out) | PCA9685 V+ | ชั้น 2 → **ผนังซ้าย** → ชั้น 3 |
| แบต (7.4V direct) | TB6612 VM | ชั้น 2 → **ผนังซ้าย** → ชั้น 3 |

> **เทคนิค:** ใช้ **Bus Bar** หรือ **Terminal Block** ขนาดเล็กที่ชั้น 2 เป็นจุดกระจายไฟ → ลดสายไฟจากชั้น 2 ออกเหลือ 3 คู่เท่านั้น

#### 🔵 กลุ่ม 2: สาย Signal (Servo/Motor/Sensor)
| สาย | จุดเริ่ม | จุดจบ | เส้นทาง |
|-----|---|---|---|
| Servo × 6 | PCA9685 (ชั้น 3) | เซอร์โว (ชั้น 4+5) | **ผนังขวา** ขึ้นชั้น 4 |
| Motor × 2 | TB6612 (ชั้น 3) | TT Motor (ชั้น 1) | **ผนังขวา** ลงชั้น 1 |
| IR × 2 | ESP32 (ชั้น 3) | HW-201 (ชั้น 1) | **ผนังขวา** ลงชั้น 1 |
| I2C (SDA/SCL) | ESP32 (ชั้น 3) | VL53L0X (ชั้น 1) | **ผนังขวา** ลงชั้น 1 |
| I2C (SDA/SCL) | ESP32 (ชั้น 3) | MPR121 (ชั้น 5) | ต่อ daisy-chain |

> **เทคนิค I2C:** PCA9685, VL53L0X, MPR121 ใช้ I2C Bus เดียวกัน → **Daisy-chain ได้** → สาย SDA/SCL แค่ 2 เส้น + GND จาก ESP32 → ต่อไปเรื่อยๆ

#### 🟢 กลุ่ม 3: สาย Data (Serial/SPI)
| สาย | จุดเริ่ม | จุดจบ | เส้นทาง |
|-----|---|---|---|
| Serial (TX/RX) | XIAO ESP32S3 (ชั้น 5) | ESP32 GPIO35/2 (ชั้น 3) | **ผนังหลัง** |
| SPI (TFT) | ESP32 (ชั้น 3) | TFT Display (ชั้น 5) | **ผนังหลัง** |

---

### 🛠️ เทคนิคเก็บสายไฟให้เรียบร้อย

| เทคนิค | วิธีทำ | ข้อดี |
|---|---|---|
| **1. ช่องเดินสายในผนัง** | เซาะร่องด้านในผนัง 3D Print กว้าง 5mm | สายไม่โผล่นอก, เรียบร้อย |
| **2. Cable Clip แบบ snap-in** | พิมพ์ 3D เป็นตัวล็อกสาย ติดทุก 2cm | ยึดสายไม่ให้หลุด |
| **3. Flat Ribbon Cable** | ใช้สาย ribbon cable แทน jumper wire หลายเส้น | ลดความรก ประหยัดที่ |
| **4. แผ่นกั้นชั้นเจาะรู** | เจาะรู Ø5mm มุมหลัง+ขวา สำหรับสายผ่าน | สายผ่านชั้นได้แต่ไม่รก |
| **5. ขั้ว JST/Dupont** | ใช้ขั้วต่อ JST 2.54mm ทุกจุด | ถอดประกอบง่าย, ซ่อมสะดวก |
| **6. สายความยาวพอดี** | วัดตัดสายให้พอดี (เผื่อ +2cm) | ไม่มีสายเกิน |
| **7. Terminal Block ชั้น 2** | ขั้วกระจายไฟ 1 จุด | ลดการบัดกรีซ้ำซ้อน |

---

### 🔍 รูเดินสายบนแผ่นกั้นชั้น

```
แผ่นกั้นชั้น (กั้นระหว่าง 2 ชั้น) — มุมมองบน

┌──────────────────────────────┐
│                              │
│                         ○    │ ← รูมุมขวาบน (Signal สาย servo/sensor)
│                              │
│     พื้นที่วางของ            │
│                              │
│                              │
│ ○                       ○    │ ← รูมุมซ้ายล่าง (Power) + ขวาล่าง (Motor)
│                              │
└──────────────────────────────┘
      ↑
  แต่ละรู Ø 5-8mm พอให้สายผ่าน
  ขอบรูเรียบ (ไม่บาดสาย)
```

---

## 🆚 เปรียบเทียบเก่า vs ใหม่

| | เดิม | ใหม่ |
|--|:---:|:---:|
| **ความสูง** | ~25 cm | **~21 cm** ⬇️ |
| **จำนวนชั้น** | ~6 ชั้น (ไม่ชัดเจน) | **5 ชั้น** (ชัดเจน) |
| **การจัดการสาย** | ไม่มีแผน | **JST-XH Color-Coded 9 สี + ช่องเดินสาย** |
| **ระบบไฟ** | Power Bank ก้อนเดียว | **18650 2S custom** (เล็กกว่า) |
| **Servo PWM** | ต่อ GPIO ตรง (ใช้ 5 pin) | **PCA9685** (ใช้ I2C แค่ 2 pin) |
| **Sensor Bus** | แยกต่อ | **I2C Daisy-chain** |
| **Encoder** | ไม่มี | **D33/D32 (ซ้าย Quad) + D27 (ขวา Single)** |
| **ขั้วต่อ** | Jumper wire | **JST-XH 2.54mm ทุกจุด (ถอดใส่ง่าย)** |
| **Capacitor** | ไม่มี | **6 ตัวครบทุกจุดสำคัญ** |
| **ถอดประกอบ** | ยาก | **ง่าย** (แผ่นชั้น + JST) |

---

## ⚠️ ข้อควรระวัง

1. **MG996R กินกระแสสูง** (stall ~2.5A ต่อตัว) → LM2596 ต้องรับได้ 3A+ → ตรวจสอบ output current
2. **ความร้อน LM2596** → เว้นช่องระบายอากาศที่ผนังชั้น 2
3. **สายพาน 130mm ยาวกว่าตัว** → ต้องออกแบบจุดยึดสายพานที่แข็งแรง
4. **น้ำหนัก** → ชั้นล่าง (แบต + มอเตอร์) หนัก = จุดศูนย์ถ่วงต่ำ ✅ ดี
5. **จอ TFT 69mm สูง** → หัวจะค่อนข้างใหญ่ พิจารณาจอเล็กกว่า (1.8") ถ้าต้องการลดขนาดอีก
6. **คอ SG90 × 2** → รับน้ำหนักหัว (จอ+กล้อง+MPR121) ได้ แต่ไม่ควรเกิน 100g

---

> 📝 **สรุป:** โครงสร้างใหม่ 5 ชั้นช่วยลดความสูงจาก 25cm → ~20cm โดยยัดอุปกรณ์ทุกอย่างอย่างเต็มที่ การแยกสายไฟ 3 กลุ่ม + ช่องเดินสายในผนัง + I2C Daisy-chain ช่วยลดความรกของสายได้มาก PCA9685 เป็น key component ที่ช่วยลด GPIO ที่ต้องใช้จาก ESP32
