HoneyKung/metorobot/Robo/Part Robot/แผนเสียบสายไฟ_RoboMDT.md

# 🔌 คู่มือต่อวงจร & เสียบสายไฟ — หุ่นยนต์ RoboMDT

> # ⛔ ไฟล์นี้ยกเลิกแล้วทั้งไฟล์ ห้ามใช้ต่อสายจริง
>
> ยกเลิกตามข้อตกลงข้อ 2 ใน `ปัญหาฮาร์ดแวร์_RoboMDT.md` เก็บไว้เป็นประวัติเท่านั้น
>
> **สิ่งที่ผิดถ้าเอามาใช้:**
>
> | เรื่อง | ไฟล์นี้เขียนว่า | ที่ถูกคือ |
> |---|---|---|
> | หัวต่อ | JST-XH ทั้งระบบ | ยกเลิก เปลี่ยนเป็นขาพิน + สาย Dupont |
> | ผัง ASCII ของ ESP32 | วาดเป็นบอร์ด 30-pin ซ้าย/ขวาสลับกับของจริง | ใช้ผัง 38-pin ใน `สรุปการเชื่อมต่อสำหรับอัปเดตวันศุกร์` |
> | ช่อง PCA9685 | CH0=Head, CH2=Arm-L, CH4=Hand-L | CH0=MG996R ซ้าย, CH1=MG90S ซ้าย, CH2=MG996R ขวา, CH3=MG90S ขวา, CH4=SG90 คอ, CH5=SG90 ก้มเงย |
> | pin map มอเตอร์/จอ/กล้อง | ชุดเก่า | ดูผังจริงในสองไฟล์ข้างล่าง |
>
> **ไฟล์ที่ใช้จริง:** `สรุปการเชื่อมต่อสำหรับอัปเดตวันศุกร์_RoboMDT.md` และ `ตารางการเชื่อมต่อและบัดกรี_RoboMDT.md`

> **อัปเดตล่าสุด:** 9 เมษายน 2569  
> **ออกแบบสำหรับ:** เด็ก ม.ต้น เสียบได้เหมือนต่อเลโก้  
> **หลักการ:** ป้องกันเสียบผิด + ถอดใส่ง่าย + Capacitor ครบทุกจุด

---

## 📐 ภาพรวมระบบ

```
                          ┌──────────────────────────────┐
                          │         ชั้น 5 — หัว         │
                          │  ┌──────┐  ┌──────┐  ┌────┐ │
                          │  │ TFT  │  │ XIAO │  │MPR │ │
                          │  │ 2.8" │  │ESP32 │  │121 │ │
                          │  └──┬───┘  └──┬───┘  └─┬──┘ │
                          │     │🟡       │⚪      │🔵  │
                          └─────┼─────────┼────────┼────┘
                                │         │        │
                          ┌─────┼─────────┼────────┼────┐
                          │     │ ชั้น 4 — แขน+คอ   │    │
                          │  SG90×2 (คอ+หัว)        │    │
                          │  MG996R×2 (แขน)         │    │
                          │  MG90S×2 (มือ)          │    │
                          │     │                   │    │
                          │  Servo 6 ตัว            │    │
                          │  เสียบตรง PCA9685       │    │
                          └─────┼───────────────────┼────┘
                                │                   │
                          ┌─────┼───────────────────┼────┐
                          │     │   ชั้น 3 — สมอง        │
                          │     ▼                   ▼    │
                          │ ┌────────────────────────┐   │
                          │ │      ESP32 38-Pin      │   │
                          │ │  🔵I2C  🟡TFT  ⚪CAM  │   │
                          │ │  🟢Motor  🟤IR  🟣Enc │   │
                          │ │  [100µF + 10µF Cap]    │   │
                          │ └──┬──┬─────────┬────────┘   │
                          │    │  │         │            │
                          │ ┌──▼──▼──────┐ ┌▼──────┐    │
                          │ │  PCA9685   │ │TB6612 │    │
                          │ │🔵I2C  CH0-5│ │🟢Ctrl │    │
                          │ │[1000µF]    │ │🟠Pwr  │    │
                          │ └────────────┘ │[470µF]│    │
                          │                └──┬────┘    │
                          └───────────────────┼─────────┘
                                              │⚫+🟣
                          ┌───────────────────┼─────────┐
                          │   ชั้น 2 — พลังงาน          │
                          │  🔋18650×2 + BMS + LM2596   │
                          │  🔴5V out  🟠7.4V out       │
                          │  [470µF Cap]                │
                          └───────────────────┼─────────┘
                                              │
                          ┌───────────────────┼─────────┐
                          │   ชั้น 1 — ฐาน              │
                          │  [VL53L0X] 🔵               │
                          │  [IR×2] 🟤                  │
                          │  ┌──────┐  ┌───────┐        │
                          │  │MOT L │  │MOT R  │        │
                          │  │⚫6สาย│  │⚫5สาย │        │
                          │  └──────┘  └───────┘        │
                          └─────────────────────────────┘
```

---

## 🧠 แผนผัง ESP32 Pin Assignment

### สถานะปัจจุบัน (เก่า — ก่อน PCA9685)

```
╔════════════════════════════════════════════════════════════════╗
║  ESP32 DevKit V1 — 38 Pin — ก่อนเปลี่ยน                       ║
║                                                                ║
║   [■] = ใช้แล้ว (20 ขา)    [ ] = ว่าง                         ║
║   ⚠️ = Strapping pin        🔒 = Input Only                    ║
║                                                                ║
║   ┌────────────────────────────────────────────────────────┐   ║
║   │                                                        │   ║
║   │   3V3  [ ]                                  [ ] VIN    │   ║
║   │   GND  [ ]                                  [ ] GND    │   ║
║   │   D15  [■] SENSOR_LEFT (IR)     MOT_IN3 [■] D13       │   ║
║   │    D2  [■] CAM_TX              MOT_IN4 [■] D12  ⚠️    │   ║
║   │    D4  [■] TFT_CS              MOT_IN2 [■] D14        │   ║
║   │   D16  [■] TFT_RST             SV_HEAD [■] D27        │   ║
║   │   D17  [■] TFT_DC              SV_ARM2 [■] D26        │   ║
║   │    D5  [■] TFT_MOSI            SV_ARM1 [■] D25        │   ║
║   │   D18  [■] TFT_SCLK           SV_HAND2 [■] D33        │   ║
║   │   D19  [■] TFT_BL             SV_HAND1 [■] D32        │   ║
║   │   D21  [■] MOT_IN1             CAM_RX  [■] D35        │   ║
║   │    RX  [ ] (Serial0)        SENSOR_RT   [■] D34        │   ║
║   │    TX  [ ] (Serial0)                    [ ] D39  🔒    │   ║
║   │   D22  [■] MOT_ENA                      [ ] D36  🔒    │   ║
║   │   D23  [■] MOT_EMB              EN      [ ] EN        │   ║
║   │   GND  [ ]                               [ ] GND       │   ║
║   │   VIN  [ ]                               [ ] 3V3       │   ║
║   │                  ┌────[USB]────┐                       │   ║
║   └──────────────────┴─────────────┴───────────────────────┘   ║
║                                                                ║
║   ❌ Servo กิน 5 pin    ❌ ไม่มี I2C    ❌ ไม่มี Encoder       ║
╚════════════════════════════════════════════════════════════════╝
```

### เวอร์ชันใหม่ (หลังย้าย Servo → PCA9685)

```
╔════════════════════════════════════════════════════════════════╗
║  ESP32 DevKit V1 — 38 Pin — เวอร์ชัน v3 (Motor+Enc ฝั่งขวา)   ║
║                                                                ║
║   [■] = ใช้ (21 ขา)     🆕 = เปลี่ยนจาก v2                    ║
║   [ ] = ว่าง (สำรอง)    🔒 = Input Only                        ║
║                                                                ║
║   ┌────────────────────────────────────────────────────────┐   ║
║   │                                                        │   ║
║   │   3V3  [ ] ← จ่าย Encoder VCC              [ ] VIN    │   ║
║   │   GND  [ ]                                  [ ] GND    │   ║
║   │   D15  [■] SENSOR_LEFT (IR)     MOT_IN1 [■] D13       │   ║
║   │    D2  [■] CAM_TX              MOT_IN2 [■] D12  ⚠️    │   ║
║   │    D4  [■] TFT_CS              MOT_IN3 [■] D14        │   ║
║   │   D16  [■] TFT_RST            MOT_IN4 [■] D27        │   ║
║   │   D17  [■] TFT_DC           🆕 ENC_B_L [■] D26       │   ║
║   │    D5  [■] TFT_MOSI        🆕 ENC_A_L [■] D25        │   ║
║   │   D18  [■] TFT_SCLK          MOT_PWMA [■] D33        │   ║
║   │   D19  [■] TFT_BL            MOT_PWMB [■] D32        │   ║
║   │   D21  [■] 🆕 I2C_SDA          CAM_RX [■] D35  🔒    │   ║
║   │    RX  [ ] (Serial0)        SENSOR_RT  [■] D34  🔒    │   ║
║   │    TX  [ ] (Serial0)       🆕 ENC_R   [■] D39  🔒    │   ║
║   │   D22  [■] 🆕 I2C_SCL                  [ ] D36  🔒    │   ║
║   │   D23  [ ] (ว่าง — สำรอง)        EN    [ ] EN         │   ║
║   │   GND  [ ]                              [ ] GND        │   ║
║   │   VIN  [ ]                              [ ] 3V3        │   ║
║   │                  ┌────[USB]────┐                       │   ║
║   └──────────────────┴─────────────┴───────────────────────┘   ║
║                                                                ║
║   ✅ Motor 6 pin + Encoder 3 pin = ฝั่งขวาทั้งหมด              ║
║   ✅ I2C ย้ายมาฝั่งซ้าย D21/D22                                ║
║   ✅ ว่าง: D23, D36, RX, TX (สำรองอนาคต)                       ║
╚════════════════════════════════════════════════════════════════╝
```

### ตารางเปลี่ยน Pin (v3 — จัดกลุ่มใหม่)

| GPIO | v1 (เดิม) | v2 (PCA9685) | **v3 (ปัจจุบัน)** | เปลี่ยน? |
|:---:|:---:|:---:|:---:|:---:|
| D21 | MOT_IN1 | MOT_IN1 | **I2C_SDA** | 🆕 |
| D22 | MOT_ENA | MOT_ENA | **I2C_SCL** | 🆕 |
| D23 | MOT_EMB | MOT_EMB | **(ว่าง)** | 🆕 |
| D25 | SV_ARM1 | I2C_SDA | **ENC_A_L** | 🆕 |
| D26 | SV_ARM2 | I2C_SCL | **ENC_B_L** | 🆕 |
| D27 | SV_HEAD | ENC_R | **MOT_IN4** | 🆕 |
| D32 | SV_HAND1 | ENC_B_L | **MOT_PWMB** | 🆕 |
| D33 | SV_HAND2 | ENC_A_L | **MOT_PWMA** | 🆕 |
| D13 | MOT_IN3 | MOT_IN3 | **MOT_IN1** | 🆕 |
| D14 | MOT_IN2 | MOT_IN2 | **MOT_IN3** | 🆕 |
| D39 | (ว่าง) | (ว่าง) | **ENC_R** | 🆕 |
| D12 | MOT_IN4 | MOT_IN4 | **MOT_IN2** | เดิม |

> **หลักการ v3:** Motor+Encoder ฝั่งขวา / I2C ฝั่งซ้าย / สายไม่ข้ามฝั่ง

---

## 🔧 ระบบขั้วต่อ JST-XH 2.54mm

### ทำไมเลือก JST-XH?

| คุณสมบัติ | ข้อดี |
|---|---|
| Pitch 2.54mm | ตรงกับ Pin Header ของ ESP32/PCA9685 |
| มี Key (ร่อง) | **กลับด้านไม่ได้** → เสียบผิดไม่พัง |
| มี Latch (ล็อก) | ไม่หลุดเองเวลาหุ่นเคลื่อนที่ |
| ราคาถูก | หาง่ายในไทย < 5 บาท/เส้น |
| Pre-Crimped | ซื้อสำเร็จรูป ไม่ต้องย้ำเอง |

### ระบบ Color-Code

| สี | ความหมาย | จำนวน Pin | ใช้ตรงไหน |
|:---:|---|:---:|---|
| 🔴 **แดง** | ไฟ 5V (Power) | 2-pin | LM2596 → ESP32, LM2596 → PCA9685 |
| 🟠 **ส้ม** | ไฟ 7.4V (Battery) | 2-pin | BMS → TB6612 VM |
| 🔵 **น้ำเงิน** | I2C Bus (Data) | 4-pin | ESP32 ↔ PCA9685 ↔ VL53L0X ↔ MPR121 |
| 🟢 **เขียว** | Motor Control | 3+4 pin | ESP32 → TB6612 |
| 🟡 **เหลือง** | TFT Display (SPI) | 7-pin | ESP32 → TFT 2.8" |
| ⚪ **ขาว** | Camera Serial | 3-pin | XIAO → ESP32 |
| 🟤 **น้ำตาล** | IR Sensor | 3-pin ×2 | ESP32 ← IR-L, IR-R |
| ⚫ **ดำ** | Motor + Encoder | 6+5 pin | TB6612 → TT Motor |
| 🟣 **ม่วง** | Encoder Signal | 4+3 pin | Motor Encoder → ESP32 |

> **กฎสำหรับเด็ก:** สีเดียวกัน = เสียบด้วยกัน / ขนาด JST ต่างกัน = เสียบผิดตำแหน่งไม่ได้

---

## 🔌 การต่อวงจรแต่ละบอร์ด

### 1. ESP32 DevKit V1 — 38 Pin

#### ฝั่งซ้าย (v3: ย้าย I2C มา + ลบ Motor ออก)

```
    ┌─── 🟤 IR-L [JST 3-pin] ──────────────────────────────────┐
    │ D15: Signal (IR ซ้าย)                                     │
    │ 3V3: VCC                                                  │
    │ GND: GND                                                  │
    └───────────────────────────────────────────────────────────┘

    ┌─── ⚪ CAM [JST 3-pin] ────────────────────────────────────┐
    │ D2:  TX (ESP32 → กล้อง XIAO)                              │
    │ D35: RX (กล้อง XIAO → ESP32)  ← Input Only               │
    │ GND: GND                                                  │
    └───────────────────────────────────────────────────────────┘

    ┌─── 🟡 TFT [JST 7-pin] ──────────────────────────────────┐
    │ D4:  CS   — Chip Select                                  │
    │ D16: RST  — Reset                                        │
    │ D17: DC   — Data/Command                                 │
    │ D5:  MOSI — SPI Data (VSPI)                              │
    │ D18: SCLK — SPI Clock (VSPI)                             │
    │ D19: BL   — Backlight                                    │
    │ GND: GND                                                 │
    └──────────────────────────────────────────────────────────┘

    ┌─── 🔵 I2C [JST 4-pin] ─────────────── 🆕 v3 ────────────┐
    │ D21: SDA   — I2C Data                                    │
    │ D22: SCL   — I2C Clock                                   │
    │ 3V3: VCC   — 3.3V Logic                                  │
    │ GND: GND                                                  │
    │                                                           │
    │ ↳ ต่อไป: PCA9685 (0x40) → VL53L0X (0x29) → MPR121 (0x5A)│
    └───────────────────────────────────────────────────────────┘

    ┌─── 🔴 PWR [Screw Terminal 2-pin] ────────────────────────┐
    │ VIN: 5V (จาก LM2596)                                     │
    │ GND: GND                                                  │
    │ ★ [100µF 16V] บัดกรีคร่อม VIN–GND                         │
    │ ★ [10µF Ceramic] บัดกรีคร่อม 3V3–GND                      │
    └───────────────────────────────────────────────────────────┘
```

#### ฝั่งขวา (v3: Motor+Encoder ทั้งหมดอยู่ฝั่งนี้)

```
    ┌─── 🟢 MOT-CTRL [JST 6-pin] ──── 🆕 v3 ─────────────────┐
    │ D13: IN1  — Motor A Direction 1                          │
    │ D12: IN2  — Motor A Direction 2  ⚠️ Strapping            │
    │ D14: IN3  — Motor B Direction 1                          │
    │ D27: IN4  — Motor B Direction 2                          │
    │ D33: PWMA — Motor A Speed (PWM)                          │
    │ D32: PWMB — Motor B Speed (PWM)                          │
    └──────────────────────────────────────────────────────────┘

    ┌─── 🟣 ENC-L [JST 4-pin] ──────── 🆕 v3 ────────────────┐
    │ D25: ENC_A_L — Encoder ซ้าย Channel A                    │
    │ D26: ENC_B_L — Encoder ซ้าย Channel B                    │
    │ 3V3: VCC     — จ่ายไฟให้ Encoder                          │
    │ GND: GND                                                  │
    └───────────────────────────────────────────────────────────┘

    ┌─── 🟣 ENC-R [JST 3-pin] ──────── 🆕 v3 ────────────────┐
    │ D39: ENC_R — Encoder ขวา (Single Ch.) 🔒 Input Only OK  │
    │ 3V3: VCC   — จ่ายไฟให้ Encoder                            │
    │ GND: GND                                                  │
    └───────────────────────────────────────────────────────────┘

    ┌─── 🟤 IR-R [JST 3-pin] ─────────────────────────────────┐
    │ D34: Signal (IR ขวา)  ← Input Only                       │
    │ 3V3: VCC                                                  │
    │ GND: GND                                                  │
    └───────────────────────────────────────────────────────────┘
```

---

### 2. PCA9685 — 16-Channel PWM Servo Driver

```
╔════════════════════════════════════════════════════════════════╗
║  PCA9685 — ตัวขยายขา Servo (I2C Address: 0x40)                ║
╠════════════════════════════════════════════════════════════════╣
║                                                                ║
║  ── I2C Input (จาก ESP32) ──────────────────────────────────  ║
║  🔵 JST 4-pin "I2C"                                           ║
║  │ SDA ← D21 (ESP32 ฝั่งซ้าย)  🆕 v3                          ║
║  │ SCL ← D22 (ESP32 ฝั่งซ้าย)  🆕 v3                          ║
║  │ VCC ← 3.3V                                                 ║
║  │ GND ← GND                                                  ║
║                                                                ║
║  ── Servo Power (แยกจาก Logic!) ────────────────────────────  ║
║  🔴 Screw Terminal "SRV-PWR"                                   ║
║  │ V+  ← 5V จาก LM2596                                        ║
║  │ GND ← Common GND                                           ║
║                                                                ║
║  ── Capacitor (บัดกรีล่วงหน้า) ─────────────────────────────  ║
║  │ [1000µF 16V] ← ตำแหน่ง C2 (มีรูเจาะบนบอร์ด)               ║
║  │ [100µF 16V]  ← ข้าง Screw Terminal                         ║
║                                                                ║
║  ── Servo Output (เสียบสายเซอร์โวตรงๆ) ─────────────────────  ║
║                                                                ║
║  CH0  ──→  SG90     หัวซ้าย-ขวา     "SV-HEAD"                 ║
║  CH1  ──→  SG90     คอขึ้น-ลง       "SV-NECK"                 ║
║  CH2  ──→  MG996R   แขนซ้าย         "SV-ARM-L"                ║
║  CH3  ──→  MG996R   แขนขวา          "SV-ARM-R"                ║
║  CH4  ──→  MG90S    มือซ้าย         "SV-HAND-L"               ║
║  CH5  ──→  MG90S    มือขวา          "SV-HAND-R"               ║
║  CH6  ──→  [ว่าง]                                              ║
║  ...                                                           ║
║  CH15 ──→  [ว่าง]                   ═══ เหลือ 10 ช่อง! ═══    ║
║                                                                ║
║  ── วิธีเสียบเซอร์โว ───────────────────────────────────────  ║
║                                                                ║
║     PCA9685 Header:        สาย Servo มาตรฐาน:                 ║
║     ┌───┬───┬───┐          ┌──────────────────┐                ║
║     │GND│VCC│SIG│   ←──→   │ ดำ │ แดง │ ส้ม  │                ║
║     └───┴───┴───┘          └──────────────────┘                ║
║           ↑                                                    ║
║     เสียบตรง! ไม่ต้องตัดสาย ไม่ต้องบัดกรี                     ║
║                                                                ║
╚════════════════════════════════════════════════════════════════╝
```

---

### 3. TB6612FNG Motor Driver

```
╔════════════════════════════════════════════════════════════════╗
║  TB6612FNG Motor Driver                                        ║
╠════════════════════════════════════════════════════════════════╣
║                                                                ║
║  ── Signal Input (จาก ESP32 ฝั่งขวาทั้งหมด) ── 🆕 v3 ───────  ║
║                                                                ║
║  🟢 JST 6-pin "MOT-CTRL" (ฝั่งขวา ESP32 ทั้งหมด)              ║
║  │ IN1  ← D13                                                 ║
║  │ IN2  ← D12  ⚠️ Strapping                                   ║
║  │ IN3  ← D14                                                 ║
║  │ IN4  ← D27                                                 ║
║  │ PWMA ← D33                                                 ║
║  │ PWMB ← D32                                                 ║
║                                                                ║
║  ── Power Input ────────────────────────────────────────────  ║
║                                                                ║
║  🟠 JST 2-pin "MOT-VCC"                                       ║
║  │ VM  ← 7.4V (จาก BMS โดยตรง — ไม่ผ่าน Buck!)               ║
║  │ GND ← GND                                                  ║
║                                                                ║
║  🔴 JST 2-pin "LOGIC-3V3"                                     ║
║  │ VCC ← 3.3V (จาก ESP32 3V3)                                 ║
║  │ GND ← GND                                                  ║
║                                                                ║
║  STBY → **ต่อเข้า VCC ตรงๆ** (Always ON)                      ║
║                                                                ║
║  ── Capacitor ──────────────────────────────────────────────  ║
║  │ [470µF 16V] คร่อม VM–GND (กรอง back-EMF จากมอเตอร์)        ║
║                                                                ║
║  ── Motor Output (ไปมอเตอร์ ชั้น 3→1) ──────────────────────  ║
║                                                                ║
║  ⚫ JST 6-pin "MOT-L" (มอเตอร์ซ้าย)                           ║
║  │ A01    → Motor L (+)               ← สาย TB6612            ║
║  │ A02    → Motor L (−)               ← สาย TB6612            ║
║  │ Enc A  → D25 (ESP32 ENC_A_L) 🆕v3  ← สาย Encoder           ║
║  │ Enc B  → D26 (ESP32 ENC_B_L) 🆕v3  ← สาย Encoder           ║
║  │ Enc VCC → 3V3                       ← จ่ายไฟ Encoder        ║
║  │ Enc GND → GND                       ← จ่ายไฟ Encoder        ║
║                                                                ║
║  ⚫ JST 5-pin "MOT-R" (มอเตอร์ขวา — single ch. encoder)      ║
║  │ B01    → Motor R (+)               ← สาย TB6612            ║
║  │ B02    → Motor R (−)               ← สาย TB6612            ║
║  │ Enc A  → D39 (ESP32 ENC_R) 🆕v3    ← สาย Encoder           ║
║  │ Enc VCC → 3V3                       ← จ่ายไฟ Encoder        ║
║  │ Enc GND → GND                       ← จ่ายไฟ Encoder        ║
║                                                                ║
╚════════════════════════════════════════════════════════════════╝
```

### หมายเหตุ: TT Motor + Encoder (6 สายต่อตัว!)

```
TT Motor + Hall Effect Encoder (13PPR, 1:90)
═════════════════════════════════════════════

   Motor Body           Encoder Board
  ┌────────┐          ┌──────────────┐
  │        ├──────────┤ Hall Sensor  │
  │   DC   │          │  A     B     │
  │  Motor │          │ VCC   GND    │
  └──┬──┬──┘          └──┬──┬──┬──┬──┘
     │  │                │  │  │  │
     ▼  ▼                ▼  ▼  ▼  ▼
   M+  M−            Enc_A Enc_B VCC GND
     │  │                │    │    │   │
     │  │                │    │    │   │
  ───┼──┼────────────────┼────┼────┼───┼───
  TB6612 (A01/A02)    ESP32 GPIO   3V3  GND
```

**Encoder ซ้าย = Full Quadrature** (2 ช่อง A+B) → D25 + D26 (ฝั่งขวา 🆕v3)  
**Encoder ขวา = Single Channel** (1 ช่อง A) → D39 (ฝั่งขวา, input-only OK 🆕v3)  

> ทำไม single channel พอ?
> - ทิศทางรู้จาก motor command (IN3/IN4) อยู่แล้ว
> - 13PPR × 90 gear = 1,170 pulse/รอบ — ละเอียดเกินพอ
> - PID speed control ใช้ 1 ช่องก็โอเค
> - ประหยัด pin = ไม่ต้องใช้ D39 (Input Only, ไม่มี pull-up)

---

### 4. ระบบจ่ายไฟ (ชั้น 2)

```
╔════════════════════════════════════════════════════════════════╗
║  ระบบจ่ายไฟ — จุดกระจายจากชั้น 2                               ║
╠════════════════════════════════════════════════════════════════╣
║                                                                ║
║   18650 × 2 (VTC6A 3000mAh)                                   ║
║       │                                                        ║
║       ▼                                                        ║
║   ┌───────────┐                                                ║
║   │  BMS 2S   │  7.4V nominal / 8.4V full                     ║
║   │   16A     │                                                ║
║   └───┬───┬───┘                                                ║
║       │   │                                                    ║
║       │   └──→ 🟠 [7.4V ตรง] ──→ TB6612 VM (มอเตอร์)         ║
║       │                                                        ║
║       ▼                                                        ║
║   ┌───────────┐                                                ║
║   │  LM2596   │  7.4V → 5V                                    ║
║   │  Buck     │                                                ║
║   └───┬───────┘                                                ║
║       │ [470µF 16V] ← Output Cap                               ║
║       │                                                        ║
║       ├──→ 🔴 [5V] ──→ ESP32 VIN                               ║
║       │                                                        ║
║       └──→ 🔴 [5V] ──→ PCA9685 V+ (ไฟเซอร์โว)                ║
║                                                                ║
║   สวิตช์ KCD-105 ← อยู่ระหว่าง BMS กับวงจรทั้งหมด             ║
║                                                                ║
╚════════════════════════════════════════════════════════════════╝
```

---

### 5. I2C Daisy-Chain

```
╔════════════════════════════════════════════════════════════════╗
║  I2C Bus — Daisy-Chain (สาย SDA/SCL 2 เส้น ต่อไปเรื่อยๆ)      ║
╠════════════════════════════════════════════════════════════════╣
║                                                                ║
║  ESP32                PCA9685              VL53L0X    MPR121   ║
║  (Master)            (Servo PWM)          (ระยะ)     (สัมผัส) ║
║     │                    │                   │          │      ║
║   D25(SDA)──🔵──→ SDA ──🔵──→ SDA ──🔵──→ SDA ──🔵──→ SDA   ║
║   D26(SCL)──🔵──→ SCL ──🔵──→ SCL ──🔵──→ SCL ──🔵──→ SCL   ║
║   3V3 ──────🔵──→ VCC ──🔵──→ VCC ──🔵──→ VCC ──🔵──→ VCC   ║
║   GND ──────🔵──→ GND ──🔵──→ GND ──🔵──→ GND ──🔵──→ GND   ║
║     │                    │                   │          │      ║
║  ชั้น 3              ชั้น 3              ชั้น 1      ชั้น 5   ║
║                                                                ║
║  I2C Address:                                                  ║
║  ├── PCA9685:  0x40  (Default)                                 ║
║  ├── VL53L0X:  0x29  (Default)                                 ║
║  └── MPR121:   0x5A  (Default)                                 ║
║  → ไม่ชนกัน! ✅                                                ║
║                                                                ║
║  สาย 🔵 JST 4-pin "I2C" ทุกเส้น:                               ║
║  ├── I2C-BUS:  ESP32 → PCA9685      (6cm,  ชั้น 3)            ║
║  ├── I2C-EXT1: PCA9685 → VL53L0X    (15cm, ชั้น 3→1)          ║
║  └── I2C-EXT2: VL53L0X → MPR121     (25cm, ชั้น 1→5)          ║
║                                                                ║
╚════════════════════════════════════════════════════════════════╝
```

---

### 6. กล้อง XIAO ESP32S3 Sense (Serial)

```
╔════════════════════════════════════════════════════════════════╗
║  Camera Serial — XIAO ESP32S3 Sense ↔ ESP32 Main              ║
╠════════════════════════════════════════════════════════════════╣
║                                                                ║
║  XIAO ESP32S3           ⚪ JST 3-pin "CAM"          ESP32     ║
║  ┌──────────┐          ┌──────────────────┐       ┌────────┐  ║
║  │ D6(TX)   ├─── ⚪ ──→│ Wire 1 (Signal)  │──→ ──┤ D35(RX)│  ║
║  │          │          │ Wire 2 (unused)  │     ──┤ D2(TX) │  ║
║  │ GND      ├─── ⚪ ──→│ Wire 3 (GND)     │──→ ──┤ GND    │  ║
║  └──────────┘          └──────────────────┘       └────────┘  ║
║                                                                ║
║  Baud Rate: 9600                                               ║
║  ข้อมูลที่ส่ง: L/C/R (ตำแหน่งใบหน้า) + H/S/N/X (อารมณ์)       ║
║                                                                ║
╚════════════════════════════════════════════════════════════════╝
```

---

## ⚡ ตำแหน่ง Capacitor ทั้งหมด

| # | ตำแหน่ง | ค่า | เหตุผล | วิธีติด |
|:---:|---|:---:|---|---|
| 1 | **ESP32 VIN–GND** | 100µF 16V | กัน Brown-out จาก WiFi burst + Motor noise | บัดกรีคร่อม VIN/GND |
| 2 | **ESP32 3V3–GND** | 10µF Ceramic | กรอง noise ที่ logic level | บัดกรีใกล้ 3V3 |
| 3 | **PCA9685 C2** | 1000µF 16V | กรอง inrush current จาก Servo 6 ตัว | บัดกรีที่ C2 (มีรูบนบอร์ด) |
| 4 | **PCA9685 V+–GND** | 100µF 16V | เสริม C2 ใกล้ Screw Terminal | บัดกรีคร่อม V+/GND |
| 5 | **TB6612 VM–GND** | 470µF 16V | กรอง back-EMF จาก TT Motor × 2 | บัดกรีคร่อม VM/GND |
| 6 | **LM2596 Output** | 470µF 16V | กรอง output ripple + stabilize load | บัดกรีที่ Output pad |

> ⚠️ **Capacitor ทั้งหมดบัดกรีล่วงหน้าโดยครู** — เด็กทำแค่เสียบ JST!

---

## 📐 รายการ Wire Harness ทั้งหมด (23 สาย)

| # | ชื่อ | ขั้ว | ยาว | สี | จุดเริ่ม → จุดจบ |
|:---:|---|:---:|:---:|:---:|---|
| 1 | `PWR-ESP` | Screw 2-pin | 8cm | 🔴 | LM2596 out → ESP32 VIN |
| 2 | `PWR-PCA` | Screw 2-pin | 5cm | 🔴 | LM2596 out → PCA9685 V+ |
| 3 | `PWR-MOT` | JST 2-pin | 10cm | 🟠 | BMS 7.4V → TB6612 VM |
| 4 | `LOGIC-3V3` | JST 2-pin | 4cm | 🔴 | ESP32 3V3 → TB6612 VCC |
| 5 | `I2C-BUS` | JST 4-pin | 6cm | 🔵 | ESP32 (D25/D26) → PCA9685 |
| 6 | `I2C-EXT1` | JST 4-pin | 15cm | 🔵 | PCA9685 → VL53L0X (ชั้น3→1) |
| 7 | `I2C-EXT2` | JST 4-pin | 25cm | 🔵 | VL53L0X → MPR121 (ชั้น1→5) |
| 8 | `MOT-PWM` | JST 3-pin | 5cm | 🟢 | ESP32 (D21/D22/D23) → TB6612 |
| 9 | `MOT-DIR` | JST 4-pin | 5cm | 🟢 | ESP32 (D14/D13/D12/GND) → TB6612 |
| 10 | `MOT-L` | JST 6-pin | 15cm | ⚫ | TB6612 A + Encoder L (ชั้น3→1) |
| 11 | `MOT-R` | JST 5-pin | 15cm | ⚫ | TB6612 B + Encoder R (ชั้น3→1) |
| 12 | `ENC-L` | JST 4-pin | 15cm | 🟣 | Encoder L A+B → ESP32 (D33/D32/3V3/GND) |
| 13 | `ENC-R` | JST 3-pin | 15cm | 🟣 | Encoder R A → ESP32 (D27/3V3/GND) |
| 14 | `TFT` | JST 7-pin | 18cm | 🟡 | ESP32 → TFT (CS/RST/DC/MOSI/SCLK/BL/GND) |
| 15 | `CAM-SER` | JST 3-pin | 20cm | ⚪ | XIAO TX → ESP32 D35/GND |
| 16 | `IR-L` | JST 3-pin | 12cm | 🟤 | ESP32 D15 → IR Left (SIG/VCC/GND) |
| 17 | `IR-R` | JST 3-pin | 12cm | 🟤 | ESP32 D34 → IR Right (SIG/VCC/GND) |
| 18 | `SV-HEAD` | Servo 3-pin | เดิม | — | SG90 → PCA9685 CH0 |
| 19 | `SV-NECK` | Servo 3-pin | เดิม | — | SG90 → PCA9685 CH1 |
| 20 | `SV-ARM-L` | Servo 3-pin | เดิม | — | MG996R → PCA9685 CH2 |
| 21 | `SV-ARM-R` | Servo 3-pin | เดิม | — | MG996R → PCA9685 CH3 |
| 22 | `SV-HAND-L` | Servo 3-pin | เดิม | — | MG90S → PCA9685 CH4 |
| 23 | `SV-HAND-R` | Servo 3-pin | เดิม | — | MG90S → PCA9685 CH5 |

---

## 📖 คู่มือเสียบสาย Step-by-Step (สำหรับเด็ก)

### เรียงจากชั้นล่างขึ้นบน — 6 ขั้นตอน

```
════════════════════════════════════════════════════════════════
  ขั้นที่ 1: ⚡ ต่อไฟ (ชั้น 2 → ชั้น 3)
════════════════════════════════════════════════════════════════

  ❶ 🔴 PWR-ESP:     LM2596 → ESP32 VIN         (Screw Terminal)
  ❷ 🔴 PWR-PCA:     LM2596 → PCA9685 V+        (Screw Terminal)
  ❸ 🟠 PWR-MOT:     BMS 7.4V → TB6612 VM       (JST 2-pin)
  ❹ 🔴 LOGIC-3V3:   ESP32 3V3 → TB6612 VCC     (JST 2-pin)

════════════════════════════════════════════════════════════════
  ขั้นที่ 2: 🧠 ต่อ Data Bus (ชั้น 3 — ภายในชั้นเดียวกัน)
════════════════════════════════════════════════════════════════

  ❺ 🔵 I2C-BUS:     ESP32 (D25/D26) → PCA9685  (JST 4-pin)
  ❻ 🟢 MOT-PWM:     ESP32 (D21/D22/D23) → TB6612 (JST 3-pin)
  ❼ 🟢 MOT-DIR:     ESP32 (D14/D13/D12) → TB6612 (JST 4-pin)

════════════════════════════════════════════════════════════════
  ขั้นที่ 3: 🏎️ ต่อมอเตอร์+Encoder (ชั้น 3 → ชั้น 1)
════════════════════════════════════════════════════════════════

  ❽ ⚫ MOT-L:       TB6612 A → Motor L          (JST 6-pin / 6สาย)
  ❾ ⚫ MOT-R:       TB6612 B → Motor R          (JST 5-pin / 5สาย)
  ❿ 🟣 ENC-L:       Encoder L → ESP32 D33/D32   (JST 4-pin)
  ⓫ 🟣 ENC-R:       Encoder R → ESP32 D27       (JST 3-pin)

════════════════════════════════════════════════════════════════
  ขั้นที่ 4: 📡 ต่อเซนเซอร์ (ชั้น 3 → ชั้น 1)
════════════════════════════════════════════════════════════════

  ⓬ 🟤 IR-L:        ESP32 D15 → IR Left         (JST 3-pin)
  ⓭ 🟤 IR-R:        ESP32 D34 → IR Right        (JST 3-pin)
  ⓮ 🔵 I2C-EXT1:    PCA9685 → VL53L0X           (JST 4-pin)

════════════════════════════════════════════════════════════════
  ขั้นที่ 5: 🦾 ต่อเซอร์โว (ชั้น 4 → PCA9685 ชั้น 3)
════════════════════════════════════════════════════════════════

  ⓯ SV-HEAD      → PCA9685 CH0    (สาย Servo 3-pin)
  ⓰ SV-NECK      → PCA9685 CH1    (สาย Servo 3-pin)
  ⓱ SV-ARM-L     → PCA9685 CH2    (สาย Servo 3-pin)
  ⓲ SV-ARM-R     → PCA9685 CH3    (สาย Servo 3-pin)
  ⓳ SV-HAND-L    → PCA9685 CH4    (สาย Servo 3-pin)
  ⓴ SV-HAND-R    → PCA9685 CH5    (สาย Servo 3-pin)

════════════════════════════════════════════════════════════════
  ขั้นที่ 6: 🖥️ ต่อจอ + กล้อง + Touch (ชั้น 3 → ชั้น 5)
════════════════════════════════════════════════════════════════

  ㉑ 🟡 TFT:        ESP32 → TFT Display         (JST 7-pin)
  ㉒ ⚪ CAM-SER:     XIAO TX → ESP32 D35/GND     (JST 3-pin)
  ㉓ 🔵 I2C-EXT2:    VL53L0X → MPR121            (JST 4-pin)

  ════════════════════════════════════════════════════
  ✅ เสร็จ! เปิดสวิตช์ KCD-105 ได้เลย!
  ════════════════════════════════════════════════════
```

---

## ⚠️ ข้อควรระวัง

1. **อย่าเสียบสายตอนเปิดสวิตช์** — ปิดสวิตช์ก่อนเสียบ/ถอดทุกครั้ง
2. **JST มีทิศทาง** — ถ้าเสียบไม่เข้า **อย่าดัน** แสดงว่ากลับด้าน
3. **Servo กินไฟมาก** — MG996R stall ~2.5A → ต้องมี Cap 1000µF ที่ PCA9685
4. **LM2596 ร้อน** — เว้นช่องระบายอากาศที่ผนังชั้น 2
5. **Encoder VCC ใช้ 3.3V** — ห้ามต่อ 5V เข้า Encoder (จะเผา Hall sensor)
6. **D12 เป็น Strapping Pin** — ใช้ได้ แต่ตอน boot ห้ามมีแรงดัน pull-up/down ที่ pin นี้

---

## 🆚 เปรียบเทียบระบบเก่า vs ใหม่

| | เก่า | ใหม่ |
|---|:---:|:---:|
| **Servo ต่อ** | GPIO ตรง (กิน 5 pin) | **PCA9685** (กิน 2 pin I2C) ⬇️ |
| **I2C** | ไม่มี | **D25/D26** ✅ |
| **Encoder** | ไม่มี | **D33/D32 (ซ้าย) + D27 (ขวา)** ✅ |
| **Pin ใช้** | 20 pin | **21 pin** (เพิ่ม 1 แต่ได้มากกว่า) |
| **Pin ว่าง** | 6 pin (รวม D39/D36 ห่วย) | **4 pin (D36/D39/RX/TX สำรอง)** |
| **สาย Servo** | ต่อ GPIO ตรง (ยุ่ง) | **เสียบ PCA9685 Header ตรง** ✅ |
| **ขั้วต่อ** | Jumper wire ทั่วไป | **JST-XH Color-Coded** ✅ |
| **Cap กันไฟกระชาก** | ไม่มี | **6 ตัวทุกจุดสำคัญ** ✅ |
| **เด็กประกอบเอง** | ยาก | **ง่ายเหมือนเลโก้** ✅ |

---

> 📝 **สรุป:** ระบบใหม่ใช้ JST-XH 2.54mm ทั้งหมด 23 สาย แยกสี 9 สี กลุ่ม pin ที่เปลี่ยนอยู่ฝั่งขวาติดกัน 5 ตัว (D25-D27, D32-D33) ไม่ใช้ D39/D36 เลย Servo เสียบ PCA9685 ตรง Capacitor 6 ตัวบัดกรีล่วงหน้าโดยครู เด็กทำแค่เสียบ JST ตามสี
