HoneyKung/metorobot/Robo/Part Robot/โจทย์ออกแบบโครงใน_v2_2026-11-02.md

# โจทย์ออกแบบโครงใน v2 (ตัวสำเร็จ) — รวบรวม 2 พ.ย. 2569

ไฟล์นี้รวมคำของเจ้าของแบบคำต่อคำ แล้วแตกเป็นข้อกำหนดที่ตรวจได้ ใช้แนบทุกใบสั่งงานออกแบบโครงใน/แขน/หัว

## คำของเจ้าของ (คำต่อคำ ตามลำดับเวลา)
1. > ตอนนี้อยากทำโ๕รงภายในใหม่ก่อน อย่างแรกให้รวบรวบ ขนาดของสิ่งที่จะใส่ในแต่ละชั้นจะให้ทำกรอบทดสอบใส่ก่อนน่ะ
2. > ตามแบบ STL เดิม · เปลี่ยนเป็นล้อ 2 ข้างกับลูกล้ออิสระตามแผน · อยากรุ้ด้วยว่าต้องใช้ลูกแหล็กขนาดเท่าไร ว่าจะให้ ใต้ท้องต่ำที่สุดเท่าที่ทำได้เพราะ การออกแบบเราเน้นหุ่นยนขนาดเล็ก · คือปัจจุบันใต้ท้องมันแค่ 5-10 มม เองนะ (ปัจจับนที่ใต้ตรนตะขาบ) · พิมพ์ล้อเอง Ø41
3. > ฉํนเน้นวางฮาดแวเข้าไป ไม่แน่นไขฮารดแวติดกับของ … ตัวยึกแบบไม่ใช้ สกรูหรือนอต … ชั้นเซอโวมอเตอร์ คือฉํนทำความสูงชั้น พอดีกับขนาดเซอโว 996 เลยนะ … มันจะทำตัวลอคได้ไหมโดยไม่เพิ่มความสูงของชั้น
4. > 996 คือให้ตัวแกนหมุนยื่นออกมานอกัวนะเพราะัมนคือจุดขันนอตติดแขน … มันวางนอนนะ แกนออกข้าง ตำแหน่งแกนอยู่หน้าสุด ยื่นทะลุกำแพง และตัวหนังฝั่งแกน จะนาบกำแพงพอดีเป๊ะ
5. > ออชั้นปิ่นโตยังมีไอเดียใหม่คือใช้ชิ้นแบบสายลอคกระเป๋า แยกออกจากชั้นชัดเจนเพื่อเปลี่ยนได้ · แต่ชั้นปิ้นโ๖ควรมี ช่องใส่สกรูเผื่อใช่ไหม
6. > ESP32 วางบนเบรดบอร์ด ที่ฉํนผ่าครึ่ง … ตอนแรกออกแบบช่องใส่พอดีเลย แต่พอตัว tb มีการบัดกรี และใส่ตัวเก็บประจุ ผมคือ ใส่ช่องไม่พอ … tb ก็ๆม่มีรูให้ขันนอตด้วน่ะสิ แต่ vlc ยังมี
7. > วันศุกต้องได้ เดิน ยกของ ขยับแขน หันหน้า 2 จ้อย ยกของได้รู้ว่ายกหรือปล่อยยัง กันตก ยังไม่ต้องมีโ๕รงนอกส่วนส่วนงามก้ได้ถ้าไม่ทัน ยเว้นหัวและแขนที่แขนคือชิ้นเดียวต้องทั้งสวยและใส่ได้ หัวต้องปิดไม่งั้นจะกลายเป็นหัวโครงเปล่าๆ แต่ต้องมีโ๕รงในพร้อมสำหรับของพวกนี้
8. > ตัวลูบหัวยังไม่ใส่ใยธีลิสชะ จะได้เว้นไว้ก่อนติดตั้งแต่จะออกแบบพร้อมติดตั้งไว้อยุ
9. > แต่ตอนนี้ฉันแค่อยากให้มันดีขึ้น มีจุดเดินสาย มีจุดเก็บสาย สายไม่มั่ว รองรับทัง้ตอนเสริมตัวเก็บประชุ การใช้จุดรวมสาย การใช้พินที่มีหัวดำๆเสียบ
10. > ไม่ๆ มันก็เหมือนออกแบบใหม่ด้วยเพระาฉันไม่รู้เรื่องจัดวางความแน่น ใส่ได้พอดีไหม + อากทำปิ่นโตแบบลอคที่ว่า เสริมสกรู
11. > ที่ให้ดูตัวออกแบบเก่าคือให้ดูรูปทรงด้วยว่าเป็นแบบไง ฉันต้องทำแบบ คางหมุด้านหน้า เพราะแขนจะหนีบเข้าตัว ฉํนต้องออกแบบตัวและแขนให้แขนสามารถหนีบเข้าตัวด้วยองศาสูงสุดที่คาดว่าทำได้โดยไม่ยนตัว ยกของได้จริง ไม่หนีบจนแขนประกบกันด็ได้เพราะมันจะทำให้แขนและตัวแปลก ต้องความสวยงามด้วย
12. > ด้านหลังตัวมันจะมี 2 รูคือ รูส่งข้อมูลให้ esp32 กับรูชาจแบต อยากจัดวางให้มันตรงกัน เพราะของเดิมรู32จะอยุ่ตรงกลางชั้นของมันแต่รูชาจแบตดันอยู่ริมสุดของชั้นของมัน
13. > รูกรูยึกทั้งชั้นไม่รวมหัว ฉันคิดไว้ในว่าจะไว้หลังสุด 2 ต้น กับหน้าสุด 2 หรือ 1 ต้น เพราะหลังสุดจะมีทำกระเป๋าปิดส่องเสียบสายเสมือนว่าเราเปิดกระเป๋าเพื่อเปิดช่องเสียบสายไรงี้

14. > เสามันเล้กๆ แค่สำหรับนอต m 6 หรือ 8 นี่แหละ  → เจ้าของยืนยัน: "เกลรรยวโต" = **เกลียว M6 หรือ M8** · หัวงานแนะนำ M6 (เสา ~Ø13 เทียบ M8 ~Ø15, เบากว่า) · บล็อกทดลองรูเดิมมีแค่ M3/M4 ต้องเพิ่ม M6/M8
15. > เราต้องออกแบบทรงว่าจะเฉียงเข้าไปอีก หรือคางหมู่สูงแค่ไนห หรือแขนจะต้องออกแบบยังไงให้ไม่นตัว หัว คำนวนเพื่อตอนใส่โ๕รงตัวด้วยนะ ส่วนหัวคือเวลายกแขนแล้วแขนต้องหนีบเข้า ห้ามชนหัวด้วย น่ะ และเราเน้นออกแบบหัวตัวใกล้ๆกันไม่เอาหัวเล็กกว่าตัว จะตามภาพในรายงานจะมีภาพ meto อยู่

16. (ส่งภาพ Tinkercad 6 ภาพ: หัวกว้าง 107 ตัว 101) > แต่ภาพมันจะหัวใหย่กว่าจะมาก ถ้าจะให่จอสวยต้องลดขนาดตัวชะ ตอนนี้ที่ฉันทำก็คิดว่าตัวเล็กพอสมควรเลยนะ ฉันเลยว่าด้านลดความอ้วนได้อีกก็คงดีแต่ว่าฐานล่างสุด มันมีมอเตอกับถ่ายวางแบบ มอเตอ ถ่าน มอเตอร ชิดแน่นพอดีแบบขิงฉํน ตัวยังกว้างเท่านี้เลย ถ้ายึดไปด้านหลังก็จะดูยาวเกินไป ของมันใหญ่จริงไม่รู้จะทำให้ตัวเล้กกว่านี้แต่ยังประกอบง่าย ได้อีกไหม · เนื่องจากตัวไม่สูง แขนทำยาวได้เลยจะได้หยิบของตรงหน้าได้ เพระาเราไม่ได้ทำแขนแนบตัวแบบ 90 อยุแล้ว ถ้าฮษร์โแวจำกัดจริง เราแก้โค้ดได้ · ที่เห็นคือจะมีโซนกระเป๋าหลังที่ใหญ่มากเพระาฐานล่างยาวหว่าฐานบน แถมกระเป๋าหลังให่แต่โล่งไม่มีอะไร · ด้านหน้ามีส่วนที่ยื่นปิดออกมาเพราะมีเซนเซอกันตก ตัวนี้ต้องเช็คอีกเพราะน้ำหลักตัวอาจเบรกไม่ทันก่อนเซนเซอรก็ได้ ระยะของตัวนี้ที่ห่างจากล้อต้องเช็คอีกที

## ข้อกำหนด (แตกจากคำข้างบน)
### รูปทรงและแขน
- R1 ตัวทรง **คางหมู แคบด้านหน้า** ตามแบบเดิม (ดู `stl3dprint/` และ `ภาพสำหรับสไลด์/`) เพื่อให้แขนหนีบเข้าหาตัวได้
- R2 ทีมต้อง**คำนวณมุมหนีบเข้าสูงสุด**ที่แขนไม่ชนตัว และยังยกของได้จริง · แขนไม่ต้องหนีบจนประกบกัน (ดูแปลก)
- R2b ทีมคำนวณ: เฉียงเข้ามากขึ้นได้แค่ไหน, คางหมูสูงแค่ไหน, รูปแขน — **รวมความหนาโครงนอก**ในการคำนวณระยะชน · ตอนยกแขนขึ้นแล้วหนีบเข้า **ห้ามชนหัว**
- R2c **หัวกว้างเท่าตัว** (ตัดสิน 2 พ.ย.: "อยากได้หัวใหญ่กว่านะ แต่ตอนนี้จอก็แบบเล้กเกินแล้ว เลว่าหัวเท่าตัวก้ได้") · อ้างอิง Tinkercad เดิม หัว 107 ตัว 101
- R3 แขนเป็นชิ้นเดียว สวย ใส่ได้ · เสียบเฟืองซี่ของ MG996R แล้วขันน็อตที่แกน · MG996R วางนอน แกนออกข้าง อยู่หน้าสุด ทะลุผนัง หน้าเซอร์โวนาบผนังพอดี
- R4 ชั้นเซอร์โวสูงพอดี MG996R ห้ามเพิ่มความสูง

### ระบบล้อ
- R5 ล้อ 2 ข้าง Ø41 พิมพ์เอง (ดุม PETG + ยาง TPU) + ลูกล้ออิสระ · ใต้ท้องเป้าหมาย 5–10 mm (เท่าเดิม) · ต้องวัดค่า a ของมอเตอร์ TT

### การวางของและสาย
- R6 ทีมจัดวางและคำนวณความพอดีเอง (เจ้าของไม่ถนัดเรื่องนี้)
- R7 ทางเดินสายระหว่างชั้น แยกสายไฟใหญ่/สายสัญญาณ · จุดรัด/เก็บสาย · สายไม่มั่ว
- R8 เผื่อที่ตัวเก็บประจุ (1000µF ใกล้ PCA9685, 470µF ใกล้ TB6612/LM2596, 100µF ใกล้ ESP32) · ที่ยึด WAGO 221 · ที่ว่างหัว Dupont + กันแรงดึงลงขาพิน
- R9 ช่อง TB6612 ต้องวัดจากชุดที่บัดกรี+ใส่ตัวเก็บประจุแล้ว (ไม่มีรูน็อต) · VL53L0X มีรู ใช้หมุดเสียบ
- R10 ESP32 วางบนเบรดบอร์ดครึ่งท่อน (ต้องวัด)
- R11 ยึดของไม่ใช้สกรู (คำเจ้าของ) · ครีบบีบ + ขอเกี่ยวเฉพาะจุด = **ข้อเสนอหัวงาน ยังไม่ใช่คำตัดสิน**

### ด้านหลังและการล็อกชั้น
- R12 ด้านหลังมี 2 ช่อง: USB ข้อมูล ESP32 และช่องชาร์จแบต (CM620 USB-C) **จัดให้อยู่แนวเดียวกัน** (ของเดิม ESP32 อยู่กลางชั้น แต่ช่องชาร์จอยู่ริมชั้น)
- R13 ด้านหลังมี **กระเป๋า/ฝาปิด** เปิดแล้วเจอช่องเสียบสาย
- R14b เสาแท่งเกลียว **อยู่นอกตัว** (เจ้าของ: "เสาว่าจะใช้นอกตัวอ่ะ เผื่อเสาได้จะเป็นส่วนเสียบชิ้นกระเป๋าติดกับตัวด้วยเลย") → เสาหลังใช้เป็นที่ยึดกระเป๋าหลังด้วย · **เจ้าของเลือกแบบที่ 1: กระเป๋าเปิดแบบประตู** (เสาหลังต้นหนึ่งเป็นบานพับ อีกต้นเป็นที่ล็อกปิด หมุนเปิดแล้วเจอช่อง USB ESP32 + ช่องชาร์จ) · **กระเป๋าไม่ต้องทันวันศุกร์** (เจ้าของ: "แต่กระเป๋ายังไม่จำเป็นต้องทำให้ทันวันศุกได้") แต่เสาหลังต้องเผื่อจุดยึดบานพับไว้ · เสาหน้าต้องเช็กแนวกวาดแขนและส่วนยื่นเซนเซอร์กันตก
- R14 ล็อกชั้นปิ่นโต: หัวเข็มขัดแบบชิ้นแยกเปลี่ยนได้ (หลัก) + แท่งเกลียวทะลุทุกชั้นยกเว้นหัว (สำรอง): **หลังสุด 2 ต้น + หน้าสุด 1–2 ต้น** · ต้นหน้าต้องไม่อยู่ในแนวกวาดแขน (ทีมเช็ก) · ไม่ใช้ heat-set insert

### โครงนอก (เปลือกตัว)
> อ่ะ อย่าลืมเผื่อว่าเราจะติด โครงปิดโครงวิศวะ ยังไง คือตอนคิคิกว่าปิดแค่5 ด้านไม่ปิดด้านล่าง ตแ่ก็ต้องยึกไว้ักบตัวหุ่นอย่างไร ด้วยโครงชั้นคอชั้นบนสุดรึเปล่า มันจะมีพื้นที่รอบไคอ อาจะแยกปริ้น ผ่าครึ่งแล้วประกอบเข้าด้วยกัน แต่เข้าด้วยกันยังไง ด้านบนนึกออกว่าใช้นอคหรือแสนปยึดได้แน่น แต่ตอนเอาความผ่ามาให้จรงกันคือยังไง
- R25 เปลือกตัวปิด 5 ด้าน (ไม่ปิดล่าง) · โครงในต้องเผื่อจุดยึดเปลือกตั้งแต่รอบนี้ แม้เปลือกจะไม่ทันวันศุกร์
- R26 **เจ้าของยืนยัน: "หน้าหลังนี่แหละ ซ้านขวามันใส่ยาก"** ผ่าเปลือกเป็น **หน้า/หลัง** แนวผ่าผ่านกลางรูแกนแขน → ใส่/ถอดเปลือกได้โดยไม่ต้องถอดแขน · จัดแนวรอยผ่าด้วย **ลิ้น-ร่อง** ตลอดขอบ + หมุดพิมพ์ 2 จุด · ยึด 3 จุด: ขอบบนวางบนบ่าชั้นคอ, ขอบล่างลงร่องรอบชั้น 1, และ **หูเปลือกร้อยแท่งเกลียวเสานอกตัว** (น็อตเสาหนีบทุกอย่าง ไม่ต้องสกรูเพิ่ม)

### หัว
- R15b ของสวมหัวด้วยแม่เหล็ก (เจ้าของ 2 พ.ย.: "ตอนนั้นมีแนวคิดว่าจะทำพาท หู หมวด ติดบนหัวได้ด้วยแม่เหล็ก แล้วอยากให้มันรับรุ้ว่ามีอะไรสวมหัว เช่น หูอาจมีตำแหน่งวางได้ตรงกลางชิดซ้ายขวา ส่วนหมวกจับทั้งตรงกลางชิ้ดซ้ายขวาและหน้าหลัง") · **เจ้าของตัดสิน: "ไม่ต้องฮอลหรอก ถ้ารับรู้ไม่ได้ไม่เป็นไร แค่ใส่ได้ก็พอแล้ว"** (หูฝังแม่เหล็ก) → ฝั่งหัวใช้ **แม่เหล็ก** (เจ้าของ: "แผ่นเหล็ก มันไม่ค่อยแน่นน่ะสิ หาซื้อยาก แม่เหล็กมันดูดดีกว่า") · ต้องกำหนดขั้วทุกจุดให้ตรงกัน (หน้าบนหันขั้วเดียวกันทุกหลุม + ทำเครื่องหมายบนชิ้น) · เผื่อหลุมแม่เหล็กใต้ผิวบนหัว 5 จุด (กลาง ซ้าย ขวา หน้า หลัง) ให้หูและหมวกดูดติด · ไม่มีเซนเซอร์ตรวจจับ · วางไม่ทับแผ่นทองแดง MPR121
- R15c กล้อง (เจ้าของ 2 พ.ย.: "กล้องขอให้ใหล้จอมากที่สุด กล้องสายแพรสั้นกล่องเลยขนาดอยู่ในตัวบอร์ดพอดีเลย เพราะอยากได้หัวเตี้ยที่สัุดเท่าที่ทำได้") → กล้องติดชิดจอที่สุด · หัวเตี้ยที่สุด · จอวางแนวนอน (เฟิร์มแวร์ใช้ 320×240) สูง ~50 กว้าง ~69 · ทางเลือกรอเจ้าของ: ก) กล้องข้างจอ (หัวเตี้ยสุด กล้องเยื้องกลาง ชดเชยในโค้ด) ข) กล้องกลางเหนือจอ (หัวสูงขึ้น ~20 mm) · ต้องวัดความหนา XIAO+กล้องที่ประกอบแล้ว · **ไม่ต้องติดกล้องเอียงเงย** (เจ้าของ: "เอากล้องไม่ต้องเสยก็ได้เพระาหุ่นเงยคอได้อยุแล้ว เผื่อใช้มองวัตถุตรงหน้าด้วย") · วิธียึด: ช่องรับทั้งชุดบอร์ด (ไม่มีรูน็อต) แนวบอร์ดขนานหน้า + ครีบบีบขอบ + ฝาหลังหัวกดทับ + รูเลนส์มีบ่าบังคับศูนย์ · เข้าถึง USB-C ของ XIAO ได้เมื่อเปิดฝาหลังหัว
- R15d คอ (เจ้าของ: "อย่าลืมออกแบบคอหันแค่ 180 ส่วนเงยต้องคำนวนเผื่อด้วย") → หันซ้าย-ขวาได้ 180° (ช่วง SG90) โดยหัว/สายไม่ชนหรือตึง · ทีมคำนวณมุมก้ม-เงยสูงสุดที่หัวไม่ชนตัว/เปลือก/แขน รวมสายวนที่คอ แล้วอัปเดตลิมิตในเฟิร์มแวร์ (ตอนนี้ `RoboPCA9685.ino` ตั้ง HEAD_Y 50–130, HEAD_T 60–120)
- R15 หัวต้องปิด สวย · โครงในรับจอ TFT 2.8", XIAO+กล้อง, SG90 ก้มเงย · เผื่อที่ MPR121 + แผ่นทองแดง (ยังไม่ติดตั้ง)

### กำหนดส่ง
- R16 วันศุกร์ 6 พ.ย. 2569: เดิน ยกของ ขยับแขน หันหน้า 2 แกน รู้ว่ายก/ปล่อย กันตก · โครงนอกส่วนอื่นข้ามได้ ยกเว้นแขนและหัว

### เพิ่มจากข้อ 16 (หัวงานวิเคราะห์ 2 พ.ย.)
- R17 ความกว้างตัว ~96 ถูกล็อกด้วย 2 จุด: ชั้น 1 (มอเตอร์ 22.5 + รางถ่าน 41 + มอเตอร์ 22.5) และชั้นเซอร์โว (MG996R 40 ×2 + ช่องกลาง) → ลดความกว้างได้น้อย ลดได้ที่ความหนาโครงนอก/ความเฉียงชั้นบน
- R18 (ข้อเสนอหัวงาน ยังไม่ใช่คำตัดสิน) ความยาว: ฐานเดิมยาว 148 เพราะตีนตะขาบ 3 ล้อ → เปลี่ยนเป็นล้อ 2 + ลูกล้อ ทำให้ฐานสั้นลงใกล้ชั้นบน (~112) ได้ → กระเป๋าหลังที่ใหญ่และโล่งหายไป เหลือกระเป๋าหลังขนาดพอดีช่อง USB ESP32 + ช่องชาร์จ (R12–R13)
- R19 แขนยาวได้ เพื่อหยิบของตรงหน้า (ไม่ต้องแนบตัว 90°) · มุมเกินจำกัดในโค้ดได้ (เฟิร์มแวร์มี min/max ต่อเซอร์โวอยู่แล้ว)
- R20 ~~ล้อขับหน้า~~ **ยกเลิกส่วนตำแหน่งล้อ** (หัวงานเคยบันทึกคำแนะนำของตัวเองเป็นคำตัดสิน ผิดหลักการ — เจ้าของเลือกล้อขับหลัง ดู R28) · ส่วนตัวเลขระยะเบรกยังใช้ได้ · กันตก: ระยะเซนเซอร์ล้ำหน้าจุดที่จะตกก่อน (ล้อหน้า/ขอบฐาน) ประมาณการ ≥ 25 mm — ความเร็ว ~0.26 m/s (TT 1:90 ~120 rpm, ล้อ Ø41), ระยะเบรก v²/(2μg) ≈ 7 mm (μ 0.5) + หน่วงลูป ~20 ms ≈ 5 mm + เผื่อ ×2 · ต้องยืนยันความเร็วจริงด้วย encoder · วางล้อขับไว้หน้า ลูกล้อไว้หลัง (น้ำหนักของที่ยกอยู่หน้า)

### ลำดับความสำคัญ (เจ้าของ 2 พ.ย.)
> อ่ะแต่ลดต้องคำนึกตนแระกอบด้วยนะว่าประกอบยากไหม เพราะแค่อันนี้ ตอนเดินสายไฟก็ยากพอสมควรเลย ย่ิงเล็กยิ่งประกอบยากแหละ แต่ก็เน้นแบบ ให้เรียบร้อยดีกว่า
- R21 **เรียบร้อย + ประกอบง่าย สำคัญกว่าตัวเล็กที่สุด** · ห้ามลดขนาดจนเดินสาย/เสียบสาย/ถอดซ่อมยาก · ต้องเผื่อนิ้วมือ ระยะโค้งสาย และหัวเสียบในทุกจุด

### การเดินสาย (เจ้าของ 2 พ.ย.)
> ไขควงปรับ LM2596 กับตัว ir ได้ · ทางเดินสายถ้ามีอะไรลอกสายก็ดี เพระาจะได้กะตัดความยาวสายถูกด้วย สามารถทำสายเดินสายแบบกดสายลงไปได้ไหมนะ ไม่จำกัดขนาดสาย + มันต้องปริ้นแยกไหมนะเพราะถ้าติดผนังคือต้องมีซัพพอตรึเปบ่า หรือต้องปริ้นแยกมาติดด้วยดาวร้อน จุกกดสายอ่า
- R22 ช่องไขควงเข้าถึงตัวปรับความไวเซนเซอร์ IR โดยไม่ต้องรื้อ · **LM2596 ไม่ต้องมีช่องไขควง** (เจ้าของแก้: "LM2596 ไม่ต้องๆ ลืม ตอนทำวงจรไฟมันควรโดนปรับมาอยุแล้ว")
- R23 รางสายแบบ**กดสายลงล็อก** (ปากรางแคบกว่าสาย/ซี่หวีงอได้) รองรับสายหลายขนาด (สัญญาณ ~1.3 mm ถึงสายไฟ 18AWG ~2.3–3 mm) · พิมพ์ติดกับชั้น **ไม่ต้องใช้ซัพพอร์ต** (ปากรางมุม ≤45°) · ชิ้นแยกใช้เฉพาะจุดที่จำเป็น ให้เสียบล็อกกับหมุด/ร่อง (ข้อเสนอหัวงาน — เจ้าของถามเรื่องกาวร้อน ไม่ได้สั่งห้าม)
- R24 ~~ขีดบอกระยะตามราง~~ (ยกเลิก: เจ้าของบอกหัว 0.4 พิมพ์ตัวอักษร/ขีดเล็กไม่ติด) · **ตารางความยาวสายแต่ละเส้น** จากแบบ 3D ให้ตัดสายได้ถูกความยาว

### แก้คำตัดสินชั้น 1 (เจ้าของ 2 พ.ย. ช่วงดึก)
- R28 **ล้อขับอยู่ด้านหลัง** (แก้ R20 ที่หัวงานตั้งเอง): "ไม่ ที่ไว้หลังเพราะด้านหน้ามีข้อจำกัดไม่ใช่หรือ เพราะด้านหลังหนังที่ฐาน 2 ก้อนด้วย มันไม่คว่ำเพราตัวมันก้หนังโลสองโล" → เซนเซอร์กันตกต้องล้ำหน้าลูกล้อหน้า ≥25 mm
- R29 **(ล็อกแล้ว ห้ามเปลี่ยน) ชั้น 1 มี: รางถ่าน, BMS, กระบอกฟิวส์ + สายฟิวส์เส้นหนา, XT30, VL53L0X, มอเตอร์ TT 2 ตัว, IR 2 ตัว** · เจ้าของ: "กูเคยบอกแล้วไม่ใช่หรอว่าฟิส อยู่ไหน … ชั้น1 ฟิว bms … มึงเปลีั่ยนไปเปลี่ยนมาไม่จดแม่งห่าอะไรที่กูบอกเลย" · งานหัวงาน = **หาจุดวางในชั้น 1** ให้ทุกชิ้น ห้ามย้ายไปชั้นอื่น · "bms จะวางบนถ่าน งั้นชั้นก็ต้องสูงขึ้นน่ะสิ" เป็น **คำถาม ไม่ใช่ข้อห้าม** (เจ้าของ: "กูถาม กูไม่ได้บอกให้มึย้าย") — คำตอบหัวงาน: พื้นช่องถ่านชั้น 1 เดิมหนา 3 → ที่ว่างถึงขอบบน 26 · รางถ่าน 20 → เหลือ 6 · BMS 3 + ชิ้นส่วน/รอยบัดกรี/สาย ~3 → พอดีแบบไม่เหลือระยะ ต้องวัด BMS จริงรวมสาย · (หัวงานเคยตีความผิดว่าให้ BMS อยู่ชั้น 2 — ผิด) · คำถามเดิมของเจ้าของ: "ได้คิดถึงจุดวาง ฟิว์จัวใส่ไฟล์ สายไฟฟิวเส้นหนา bms vlc tt2ตัว รางถ่ายรึยัง"
- R30 **VL53L0X อยู่ชั้น 1** (แก้ข้อ 6.4 เดิม): "ต้องอยู่ชั้น 1 เพราะ มันต้องเห้นของตอนหายไปเพราะโดนยก" → **บอร์ดตั้งแนบผนังหน้าในระนาบเดียวกับผนัง** (ชิปอยู่บนบอร์ด) มองผ่าน **รูกลางหน้าสุด** ที่แบบ METO เดิมเจาะไว้ (เห็นในภาพ Tinkercad) · ลูกล้ออยู่ที่พื้น ไม่บัง VL (เจ้าของทัก: "ชิ้นนี้ต้องวางตั้งระนาบเดียวกับกำแพงเพระา มันเซนเซอร์อยู่บนบอร์ด ลูกล้ออยุ่ที่พื้นไม่ได้ชน vl เลย … ในแบบ meto ก็มีรูที่เจาะตรงกลางหน้าสุดเพื่อให้ vl มองผ่าน") · หันหน้าระดับต่ำ มองของที่วางบนพื้นตรงหน้า ยกแล้วระยะเปลี่ยน = รู้ว่ายก · ของต้องห่างเซนเซอร์ ≥50 mm (อ่านต่ำกว่า ~40 ไม่แม่น) · ต้องไม่ถูกลูกล้อหน้า/เซนเซอร์กันตก/โครงบัง
- R31 ลูกล้ออิสระ: "ลูกล้อไม่ได้ตั้งใจไว้ใต้ตัว แต่คิดไว้ว่าไว้ข้างตัวมากกว่า" + "หมายถึงลูกล้ออิสระ" → **เจ้าของเลือก 2 ลูก หน้าซ้าย-ขวา** ("เรื่องล้อเอา 2") อยู่มุมหน้าในแนวกว้างล้อขับ ตั้งสูงกว่าล้อขับ ~0.5 mm · เซนเซอร์กันตกหน้าลูกล้อแต่ละข้าง ≥25 mm · ชิ้นทดสอบ vl53l0x_holder **ข้าม** (ทำไว้แบบวางนอน ใช้ไม่ได้กับการติดจริง)

- R32 (เจ้าของทักผังชั้น 1 ร่างแรก): "LM2596 ไม่ได้อยู่ชั้นนี้อยู่แล้ว" → **LM2596 ไม่อยู่ชั้น 1** (เอกสาร `ปัญหาฮาร์ดแวร์` 6.1 / `แผนปรับโครง` ที่เขียนว่าอยู่ชั้น 1 เป็นของเก่า) · "ir ทำไมวางเอียง เรากันตกไม่ใช่ต้องวางแน้วตั้งหรอ" → **IR กันตกติดแนวตั้ง** · "bms จะวางบนถ่าน งั้นชั้นก็ต้องสูงขึ้นน่ะสิ" · "ไหนตำแหน่งวางฟิวส์อีก กระบอกฟิวส์" → ฟิวส์เป็นแบบกระบอก ต้องมีตำแหน่งในผัง

- R33 เจ้าของยืนยัน: สวิตช์ + WAGO + TB6612 อยู่ชั้น 2 · CM620 "มันก็อยู่ชั้นของมัน" (ชั้น 2 ตาม STL) · เจ้าของไม่พอใจที่ถามเรื่องที่มีในเอกสารแล้ว → อ่านไฟล์นี้ + คู่มือต่อสาย 6 ก.ย. ก่อนถามเสมอ
- แผนสายชั้น 1 (จากคู่มือ 6 ก.ย.): ในชุดแบต ถ่าน→BMS→P01 ฟิวส์→P02 XT30+, P03 BMS P-→XT30- (18AWG) · ขึ้นชั้น 2: P04 XT30+→สวิตช์, P06 XT30-→W2 (18AWG) + สายชาร์จ CM620 · M09–M12 TB6612→มอเตอร์ 4 เส้น 20AWG · สัญญาณขึ้นชั้น 3: encoder 8, IR 6, VL53 4 (I2C 21/22) · สายมอเตอร์กับสัญญาณเดินคนละช่อง

### การพิมพ์ (เจ้าของ 2 พ.ย.)
> วันจันนี้จริงๆเริ่มพิมชั้นว่างได้ลยนะ มีเครื่องพิม 1 เครื่อง ปกติพิมช้ามากเพระา ซัพพอตเยอะเพราะใช้สแนปฟิตแลลในกำแงที่ ชิ้นส่วนไม่ใช่ฐานแบนมีส่วนนูนออกมาตามขอบเลยพมช้าเพราะต้องพมซักพอตทั้งแผง แต่อันนี้เรามีแค่ชิ้นแล้วเพราะเราหันมาใช้ตัวลอคแบบสองด้านแบบสายกระเป๋าแทน น่าจะใช้เวลา 1-3 ต่อช้น เฉ,ี่ยน 2 คาดว่า แต่ก่อน 4 ตรงซัพพอต
- R27 **ทุกชั้นต้องฐานเรียบแบน พิมพ์ได้โดยไม่ใช้ซัพพอร์ต** · ไม่มีส่วนนูนรอบขอบใต้ชั้น (ตัวล็อกชั้นเป็นชิ้นแยก) · เป้า 1–3 ชม./ชั้น · เครื่องพิมพ์ 1 เครื่อง (Creality Hi, PETG)
  - ผล slice ชั้นเดิมที่เจ้าของส่ง: 3 ชม. 49 นาที (ซัพพอร์ต 63 นาที 27%, ironing 35 นาที, travel 38 นาที, พื้นตัน 27 นาที) และ 2 ชม. 38 นาที (ซัพพอร์ต 45 นาที 28%, ironing 25 นาที)
  - กฎแบบ: รู/ช่องบนผนังตั้งห้ามหลังคาแบนกว้าง → ทำหลังคาโค้ง/หยดน้ำ/มุม 45° · พื้นชั้นบางพอ (~1.6–2.0) ลดพื้นตัน · ลดเกาะชิ้นเล็กกระจาย (ลด travel)
  - แนะนำปิด ironing สำหรับโครงใน (ผิวบนไม่ต้องเนียน)
- แผนพิมพ์: จันทร์ ชิ้นทดสอบ + ชั้นล่างสุด (ถ้าออกแบบทัน) → อังคาร ตัวทั้งหมด → พุธ แขน หัว กลไกคอ

## ยังขาด (ต้องวัดของจริง)
ESP32 บนเบรดบอร์ดครึ่งท่อน · TB6612 ชุดบัดกรีแล้ว · ค่า a มอเตอร์ TT · LM2596, BMS, CM620, XT30 คู่ · UBEC/XH-M401, ฐานฟิวส์ · ระยะรู VL53L0X
