HoneyKung/metorobot/Robo/Part Robot/งานโค้ด_2026-11/ผลสำรวจโค้ด_2026-11-05.md

# ผลสำรวจโค้ด METO (5 พ.ย. 2569 · อ่านอย่างเดียว)
ทุก path อยู่ใต้ `G:\My Drive\METTO\Code\RoboBlock\`

## เฟิร์มแวร์
- **ตัวล่าสุดของตัวสำเร็จ:** `RoboPCA9685/RoboPCA9685.ino` (2349 บรรทัด, แก้ 7 ก.ย.) บอร์ด ESP32 DevKit 38 ขา core 3.0.7 · ไลบรารี Adafruit PWM Servo Driver + TFT_eSPI (`User_Setup.h` จริงอยู่ที่ `Documents\Arduino\libraries\TFT_eSPI\`)
- **โปรโตไทป์ 1:** `Robo/Robo.ino` (ESP32Servo, L298N) **ห้ามแฟลชลงตัวสำเร็จ**
- **ของเก่าที่ควรดึงมาใช้:**
  - `OldRoboCodeBeforlerp.ino`: ตาแบบพารามิเตอร์ (EyeParams, lerpEyeParams, drawParametricEyes, updateEmotionFSM, updateNoise) ใช้แทนการ `fillScreen` ทั้งจอ ซึ่งสงสัยว่าเป็นต้นเหตุจอขาว
  - `Robo.ino`: มือ (moveHand1/2, gripSync, gripRelease, smartGrip, safeGrip, gripAndVerify) และ detach หัวหลังหยุด 2 วิ
- **ผังขาในโค้ด (ของจริง):** TB6612 PWMA26 AIN1 27 AIN2 14 / PWMB25 BIN1 32 BIN2 33 · TFT ST7789 SCLK18 MOSI5 CS4 DC17 RST16 · CAM Serial2 RX=23 9600 · I2C 21/22 PCA 0x40 · Encoder 34/35/36/39 · TCRT สำรอง 13 + 2 (GPIO2 เป็นขา strapping)
- **เอกสารชุด "สเปกวันศุกร์" ยังเป็นผังเก่า** (MOSI23 RX16 …) · ไทม์ไลน์ .bak: ย้ายขาจอวันที่ 7 ก.ย. 14:44 แล้ว CAM ย้ายไป 23
- **ช่อง PCA:** CH0 ARM_L MG996R · CH2 ARM_R · CH4 HEAD_YAW · CH5 HEAD_TILT · เอกสาร: CH1/CH3 = MG90S L/R (ในโค้ดยังเป็น SPARE และ `USE_HAND 0`)
- **ลิมิตปิดอยู่:** `CALIB_FREE_RANGE 1` (:84) สั่งได้ 0–180 ทุกตัว
- **ไม่มีโค้ด VL53L0X / TCRT เลย** และในเครื่องไม่มีไลบรารี VL53L0X
- **หัว:** `moveHead` กระโดดตรง + delay 300 · lerp แบบเอกซ์โปเนนเชียลยังสะบัด · คำสั่ง 7/8/9 จากเว็บไม่อัปเดต target ทำให้หัวดีดกลับ · ก้มเงยไม่มี lerp · gesture บล็อก
- **โปรโตคอล:** HTTP `GET /run?cmd=a;b;` (บล็อกจนจบ, 409 BUSY) + `GET /state` JSON · mDNS `MDTrobot.local` · SSID ฝังในโค้ด · Serial 115200 = เมนู
- **คำสั่ง:** w s a d x z · 1-3 hand2 · 4-6 hand1 · 7-9 head · r f v arm1 · t g b arm2 · T1-T3 tilt · หน้า y u i o h j k n c l e · G P Q grip:N
- ใบงานค้าง: `Robo/Part Robot/คำสั่งสำหรับ_Codex_รวมโค้ด_ล้อ_จอ_กล้อง_แบต.md` (มอเตอร์ไม่บล็อก, รู้ว่ากล้องหลุด, /state เพิ่ม cam mot)

## เว็บบล็อก
- Flask `server.py` + `static/` · Blockly 13.1.1 ในเครื่อง · บล็อก `static/script.js:2-363` · ตัวแปลง `:366-571` · toolbox `static/index.html:250-342`
- เบราว์เซอร์ยิง `http://MDTrobot.local/run` เอง (ไม่ผ่านเซิร์ฟเวอร์) · repeat/if/while คลี่ในเบราว์เซอร์ จึงทำเงื่อนไขจากเซนเซอร์ระหว่างรันไม่ได้ ต้องออกแบบโปรโตคอลใหม่
- digital twin `static/robot-sim.js` poll `/state` 300 ms
- **ยังไม่มีบล็อก:** ก้มเงย, หยุด, เซนเซอร์ (VL53, IR, กล้อง/อารมณ์)
- ชื่อบล็อก Hand (Down/Center/Up) ไม่ตรงกับมือหนีบ
- **เพิ่มบล็อกต้องแก้พร้อมกัน:** script.js (นิยาม+ตัวแปลง+BLOCK_LABELS), index.html, robot-sim.js, skills.py COMMAND_BLOCKS, dashboard.py GOAL_BLOCK_CHOICES, demo.js, server.py SYSTEM_PROMPT, mockup_ส่งอาจารย์/, สีหมวดตาม claude-RoboWeb.md §3.2
- Render (https) ยิงหุ่นไม่ได้ (mixed content) → รันในเครื่อง `python server.py` พอร์ต 5000 บนฮอตสปอตเดียวกัน

## กล้อง
- **ตัวล่าสุด:** `FullCam/FullCam.ino` v7 บน XIAO ESP32S3 · ESP-DL MSR01+MNP01 (5 จุด) · RGB565 240×240 · ~16 FPS
- อารมณ์: อัตราส่วนจาก 5 จุด → ได้แค่ H/S/N **ไม่มีโกรธ** (ไม่มีจุดคิ้ว)
- ส่ง UART 9600 ตัวอักษร L C R H S N X (Serial1 TX=43 → ESP32 RX23) · ESP32 แปลงเป็น 3 มุม 130/90/50 ไม่หันตามสัดส่วน ไม่ก้มเงยตาม
- สตรีมภาพมีแค่ใน `CamTest/CamTest.ino` (softAP + /stream MJPEG) ยังไม่รวมกับ FullCam
- **ในเครื่องมีโมเดลจำหน้าของ ESP-DL แล้ว** (face_recognition_112_v1_s8/s16, face_recognizer, color_detector) แต่ยังไม่มีโค้ดใช้ · ไม่มีโมเดลตรวจวัตถุทั่วไป

## คำถามที่ต้องถามเจ้าของ
1. ผังขาบนบอร์ดตัวสำเร็จตอนนี้ = ชุดในโค้ด ใช่ไหม
2. TCRT ตัวขวาใช้ GPIO2 จริงไหม
3. MG90S อยู่ CH1/CH3 และบล็อก Hand = มือหนีบ ใช่ไหม
(ลิมิตมุม: ทีมคำนวณเองจากผลจำลอง)
