HoneyKung/metorobot/Robo/Part Robot/งานโค้ด_2026-11/สเปกเฟิร์มแวร์_วันศุกร์_ล็อก.md

# สเปกเฟิร์มแวร์ตัวสำเร็จ — รอบวันศุกร์ 6 พ.ย. (ล็อก 5 พ.ย. 2569)

## คำเจ้าของ (คำต่อคำ)
- 2 พ.ย.: "วันศุกต้องได้ เดิน ยกของ ขยับแขน หันหน้า 2 จ้อย ยกของได้รู้ว่ายกหรือปล่อยยัง กันตก …" · "วันศุกเอากล้องด้วย ลืมบอก"
- หัว: "ขอแบบไม่ต้องเร็วสบัดหน้า … 0 ไป 180 มันเร้วจนสะบัด"
- 5 พ.ย. #378: "-เริ่มแก้โ๕้ดเขียนโ๕้ดเลยนะ … -โค้ดหุ่น อัปเดตใหม่ และเอของเก่ามารวมกับของใหม่"
- #385: "1. ใช้ตามโค้ดใหม่ที่เดินได้อ่า ที่ต่อเอนโคเดอร์แล้ว … 2. ย้ายขาได้ แต่อยากให้ ขามันเรียงกัน … 3. … ลองจัดชุดต่อใหม่แบบ ดีก็ได้นะ"

## ฐานโค้ด
- แก้ต่อจาก `RoboPCA9685/RoboPCA9685.ino` (ตัวที่เดินได้และต่อเอนโคเดอร์แล้ว) · สำรองไฟล์เป็น `.bak-20261105-ก่อนรอบศุกร์` ก่อนแก้
- ผังขา = ตามโค้ดเดิม **ห้ามเปลี่ยน** ได้แก่ TB6612 26/27/14 · 25/32/33 · TFT 18/5/17/16/4 · CAM RX23 · I2C 21/22 · Encoder 34/35/36/39
- ห้ามแฟลช เจ้าของแฟลชเอง · ต้องคอมไพล์ผ่านด้วย arduino-cli ที่มากับ Arduino IDE (`esp32:esp32:esp32`, core 3.0.7)

## ข้อกำหนด
| # | เรื่อง | ข้อกำหนด |
|---|---|---|
| 1 | ช่อง PCA | CH0 แขนซ้าย MG996R · CH1 มือซ้าย MG90S · CH2 แขนขวา MG996R · CH3 มือขวา MG90S · CH4 หัวหัน SG90 · CH5 หัวก้มเงย SG90 |
| 2 | มือหนีบ | เปิด `USE_HAND` · ดึงฟังก์ชันมือจาก `Robo/Robo.ino` (moveHand, gripSync, gripRelease, smartGrip, safeGrip, gripAndVerify) มาใช้กับ CH1/CH3 · ช่วงหมุน ≥ 55° (กาง 30 + หนีบ 28) · ค่า เปิด/กลาง/หนีบ และทิศกลับด้านของแต่ละข้าง ปรับได้ผ่านเมนู Serial และบันทึกลง NVS |
| 3 | ลิมิตมุม | ปิด `CALIB_FREE_RANGE` · ใช้ตารางลิมิตกลางตารางเดียว · แขนยก −43…+48 จากแนวนอน (ต้องมีค่ามุมเซอร์โวที่ตรงกับแนวนอนให้สอบเทียบได้) · หัวหัน ±90 · ก้มเงย ±10 · มีฟังก์ชัน interlock แขน/หัว ที่ใส่ตารางทีหลังได้ (ผลจำลองยังไม่เสร็จ) ใส่ค่าที่รู้แล้วไปก่อน: หัวหัน 0 ก้มได้ ≤ 5° · หัน ±45 เงยได้ ≤ 6° · หนีบ +28 พร้อมยก ≥ 42° ห้าม · ลิมิตต้องไม่แคบกว่าโค้ดเดิม (#248 ข้อ 6) ยกเว้นจุดที่ชนจริง |
| 4 | หัวนุ่ม | หันและก้มเงยแบบไม่บล็อก ใช้ ease-in/out ความเร็วสูงสุดราว 90°/วิ ปรับค่าได้ · คำสั่ง 7/8/9/T1–T3 จากเว็บและกล้องต้องตั้งเป้าเดียวกัน (แก้บั๊กหัวดีดกลับ) · หยุดนิ่งแล้ว 2 วิ ปลดแรงหัวได้ (ตั้งค่าได้) |
| 5 | VL53L0X | อยู่ชั้น 1 มองของบนพื้นตรงหน้า บัส I2C 21/22 ร่วมกับ PCA (0x29) · ติดตั้งไลบรารี Pololu VL53L0X · ตรรกะ: เจอของ → ยก → ระยะกระโดดไกล/หาย = ยกแล้ว · วางลงแล้วเจอของอีก = ปล่อยแล้ว · ถ้าเซนเซอร์ไม่ต่อ บูตต่อได้ไม่ค้าง (ตอนนี้เซนเซอร์หาย กำลังซื้อใหม่) |
| 6 | กันตก TCRT | ซ้าย **GPIO13** ขวา **GPIO19** (สองขาอยู่ติด GND · ไม่ใช้ GPIO2) · ระดับสัญญาณที่แปลว่าเจอขอบ ตั้งค่าได้ · ตอนเดินหน้าเจอขอบ → หยุดทันทีแล้วถอยเล็กน้อย · มอเตอร์ต้องเลิกบล็อก (`motorRunFor` ห้าม delay 1 วิ) ตามใบงานค้าง `คำสั่งสำหรับ_Codex_รวมโค้ด_ล้อ_จอ_กล้อง_แบต.md` |
| 7 | กล้อง | โปรโตคอลเดิม (UART 9600 RX23, ตัวอักษร L C R H S N X) · หันหัวตามด้วยระบบหัวนุ่มข้อ 4 · รู้ว่ากล้องหลุดเกิน 5 วิ |
| 8 | /state | เพิ่ม `hand1 hand2 tilt vl_mm holding cliffL cliffR cam mot` และเก็บฟิลด์เดิมไว้ครบ |
| 9 | คำสั่งเว็บ | คำสั่งเดิมต้องทำงานเหมือนเดิมทุกตัว · เพิ่ม `x` หยุด และ `T1–T3` ให้ทำงานจริง · เพิ่มคำสั่งใหม่ได้แต่ต้องเขียนตารางคำสั่งไว้ในรายงาน เพื่อใช้ทำบล็อกเว็บต่อ |
| 10 | ของเก่า (รอบหลัง) | ตาแบบพารามิเตอร์ + FSM อารมณ์จาก `OldRoboCodeBeforlerp` **ไม่อยู่ในรอบนี้** ยกเว้นถ้าจำเป็นต้องแก้จอขาว |

## ที่ผมสมมติเอง (ยังไม่ได้ถามเจ้าของ)
- ขา TCRT 13/19 · ช่อง MG90S CH1/CH3 (เจ้าของบอก "จัดชุดต่อใหม่แบบดีก็ได้")
- ความเร็วหัว 90°/วิ · เวลาปลดแรงหัว 2 วิ
- ลิมิตแขน −43…+48 อ้างจาก สเปกแขน_ล็อก.md แต่มุมเซอร์โวที่ตรงกับแนวนอนต้องสอบเทียบกับตัวจริง

## เกณฑ์ผ่าน
- คอมไพล์ผ่าน (แปะผล arduino-cli) · ไม่มี `delay()` ยาวกว่า 50 ms ใน loop หลัก ยกเว้นตอนบูต
- ตารางคำสั่งเก่ากับใหม่ทำงานครบ (ไล่เช็กในโค้ดทีละคำสั่ง)
- รายงานบอกวิธีทดสอบบนตัวจริงทีละข้อ (เมนู Serial)
