HoneyKung/metorobot/THEME.md

# THEME.md — ธีมและแนวทางการออกแบบเว็บ METO

> ไฟล์นี้คือ **"แหล่งความจริง" เรื่องหน้าตา** · บันทึกการแก้อยู่ที่ `CHANGELOG.md`

## ⚠️ อ่านก่อน — เว็บนี้มี 2 ธีม ไม่ใช่ธีมเดียว

เดิมไฟล์นี้บังคับให้ทั้งเว็บใช้ธีมเดียวกันหมดโดยยึดหน้า Workspace เป็นต้นแบบ
**เลิกใช้กติกานั้นแล้วตั้งแต่ 6 สิงหาคม 2026** เพราะพบว่ามันเป็นต้นเหตุที่ทำให้หน้านักเรียน
ออกมาเหมือนแอดมินแพเนล — Workspace คือ **เครื่องมือ (IDE)** เอากฎของ IDE ไปสร้างหน้าเด็ก
ผลลัพธ์จะเป็น IDE เสมอ ไม่ว่าจัดวางใหม่กี่รอบ

| | **ธีม A — เครื่องมือ** | **ธีม B — เกม** |
|---|---|---|
| ใช้ที่ไหน | แดชบอร์ดครู · หน้าเลือกแดชบอร์ด (ทุกหน้าที่มีคลาส `on-dashboard` และไม่ใช่ `mode-player`) | **หน้านักเรียน** (`body.mode-player`) · **เปลือกของหน้า Workspace** (`body:not(.on-dashboard)`) |
| ต้นแบบ | หน้า Workspace | เกม 2D พิกเซล (อ้างอิง Stardew Valley) |
| พื้น | สว่าง `#f8f9fc` การ์ดขาว | **เข้ม** ฉากมีความลึก |
| ผู้ใช้ | ครู · กรรมการ · คนที่ต้องพิมพ์ลงเล่ม | **เด็กมัธยม ที่ต้องรู้สึกว่ากำลังเล่นเกม** |
| อ่านที่ | **ส่วนที่ 1** (ข้อ 1-7) | **ส่วนที่ 2** (ข้อ 8-14) |

**สิ่งเดียวที่สองธีมใช้ร่วมกันคือแบรนด์** — `#3A53A4` · `#BED73B` · สีหมวดบล็อก 8 สี · ฟอนต์ไทย
ที่เหลือแยกกันโดยสิ้นเชิงและ **ตั้งใจให้ต่างกัน**

**ห้ามให้ธีม B ไปเปลี่ยนเนื้อหาของแดชบอร์ดครู** — ฝั่งครูต้องอ่านง่ายและพิมพ์ลงกระดาษได้

### ⚠️ กฎ "ของใช้ร่วม" — ชิ้นที่โผล่ทุกหน้าต้องหน้าตาเดียวกันเสมอ

ของบางชิ้นเป็น **chrome ที่ใช้ร่วมทั้งเว็บ** ไม่ได้เป็นของธีมใดธีมหนึ่ง
**ห้ามสโคปมันด้วย `body.mode-player` หรือ `body:not(.on-dashboard)` เด็ดขาด**
ถ้าทำให้มันเปลี่ยนหน้าตาตอนสลับหน้า จะรู้สึกแปลกกว่าเลือกสไตล์ใดสไตล์หนึ่งไปเลย

| ของใช้ร่วม | สไตล์ที่ใช้ |
|---|---|
| `#header-container` + ปุ่มบน header ทุกตัว | ธีม B (เงาแข็ง มุมบาก) — ทุกหน้า |
| `.loading-spinner` · `.dashboard-loading` | สไตล์เดียว ทุกหน้า |
| `.meto-snackbar` | สไตล์เดียว ทุกหน้า |
| modal (`.modal-content`) | สไตล์เดียว ทุกหน้า |

ที่**ต่างกันได้** คือ *เนื้อหาในหน้า* เท่านั้น — แดชบอร์ดครูเป็นการ์ดขาวธีม A · หน้านักเรียนเป็นฉากเกมธีม B

**ปุ่มบน header ต้องสูงเท่ากันและเงาลึกเท่ากันทุกตัว** (36px · `0 3px 0`)
ไม่งั้นขอบล่างที่ตาเห็นจะไม่ตรงแนว — เคยพลาดมาแล้วตอนให้ Run สูง 38px เงา 4px

---
---

# ส่วนที่ 1 — ธีม A: เครื่องมือ (Workspace + ฝั่งครู)

> ต้นแบบคือหน้า Workspace · จะเพิ่ม/แก้ UI ฝั่งเครื่องมือให้ย้อนมาดูว่า Workspace ทำแบบไหน
> พาเลตสีอ้างจาก `claude-RoboWeb.md` ข้อ 3

## 1. Design DNA — 5 ข้อที่ถอดมาจากหน้า Workspace

หน้า Workspace มีบุคลิกชัดเจน 5 อย่าง **ทุกหน้าต้องมีบุคลิกเดียวกันนี้**

| # | หลัก | ของจริงในหน้า Workspace |
|---|---|---|
| 1 | **แถบน้ำเงินเข้ม + ตัวหนังสือเขียวมะนาว = แบรนด์** ใช้เฉพาะแถบหลักบนสุด | `#header-container` พื้น `#3A53A4` สูง 60px, โลโก้ "METO Robot" สี `#BED73B` 24px |
| 2 | **การ์ดขาวลอยบนพื้นทำงาน** มุมโค้ง เงานุ่ม — **ห้ามมีแถบหัวสีเข้มบนการ์ด** (แถบเข้มเป็นของ header เท่านั้น) | เวทีจำลอง = การ์ดขาว ขอบเขียว 4px มุม 10px · แถบเครื่องมือ = การ์ดขาวมุม 20px |
| 3 | **สีสดใช้เป็น "จุดเน้นเล็กๆ" ไม่ใช่พื้นทั้งใบ** — วงกลมสี / เส้นขอบ / ขีดซ้าย | toolbox: วงกลมสีหมวด 30px + ชื่อสีเทาเข้มบนพื้นขาว-เทา ไม่ใช่การ์ดสีทั้งใบ |
| 4 | **ปุ่มทรงแคปซูล** (มุมโค้งเยอะ) เป็นมิตรกับเด็ก | ปุ่ม Run มุม 20px · แถบพิมพ์แชทมุม 25px · FAB วงกลม |
| 5 | **ตัวหนังสือเข้มบนพื้นขาว** ไม่มีตัวหนังสือสีจัดบนพื้นสีจัด | `#333` หลัก, `#666` รอง, `#999` จาง |

**สิ่งที่ผิดธีมทันทีถ้าเห็น** (เจอที่ไหนให้แก้):
- ไล่เฉดสีนอกพาเลต (ม่วง `#667eea`/`#764ba2`, ชมพู `#f093fb`, ฟ้านีออน `#00f2fe`, มินต์ `#38f9d7`)
- การ์ดพื้นสีสดทั้งใบพร้อมตัวหนังสือขาว (แย่งความสนใจจากเนื้อหา)
- แถบหัวสีเข้มครอบการ์ดลอย (ทำให้ดูเหมือนมี header 2 ชั้น)
- เงาหนา/ฟุ้งเกิน เช่น `0 8px 32px`, `0 12px 36px`
- อีโมจิใช้เป็นไอคอน UI (ต้องเป็น inline SVG ใน `MetoIcons`)
- ฟอนต์ที่ไม่ใช่ `Prompt` กับข้อความไทย

---

## 2. Color tokens

### 2.1 สีแบรนด์
| Token | ค่า | ใช้กับ |
|---|---|---|
| `primary` | `#3A53A4` | header, ปุ่มหลัก, ลิงก์, หัวข้อ, ขีดซ้ายหัวข้อ, focus ring |
| `primary-strong` | `#4a6ad4` | ปลายไล่เฉดของ primary เท่านั้น (ไล่ได้แค่คู่นี้คู่เดียว) |
| `accent` | `#BED73B` | โลโก้, ขอบจอจำลอง, ไฮไลต์ "ของฉัน/เจ้าของ", จุดเน้นบนพื้นน้ำเงิน |
| `accent-dark` | `#a8c22e` | hover ของ accent |
| `accent-text` | `#7d9414` | ตัวเลข/ตัวหนังสือสี accent บนพื้นขาว (สีเขียวมะนาวสดอ่านไม่ออก) |

### 2.2 สีบอกสถานะ
| Token | ค่า | ใช้กับ |
|---|---|---|
| `success` | `#4CAF50` · อ่อน `#80C781` | ปุ่ม Run, สำเร็จ, ผ่าน |
| `success-bg / text` | `#e8f5e9` / `#2e7d32` | ป้ายสำเร็จ, ป้าย "ต่อหุ่นจริง" |
| `warn-bg / text` | `#fff8e1` / `#f57f17` | กล่องคำใบ้ AI, คำเตือนแบบไม่ดุ |
| `danger` | `#d32f2f` (พื้น `#fdecea`) | ใช้เท่าที่จำเป็น — **ห้ามใช้ลงโทษความผิดพลาดของเด็ก** |
| `online / offline` | `#00ff00` / `#ff4444` | จุดสถานะการเชื่อมต่อหุ่นบน header |

### 2.3 สีหมวดบล็อก (ใช้เป็น "สีจุดเน้น" ได้ทั้งเว็บ)
`Motion #4C97FF` · `Arm #9966FF` · `Hand #CF63CF` · `Head #FFBF00` · `Face #FF6680` · `Gripper #00B4AB` · `Operator #59C059` · `Variables #FF8C1A`
→ ใช้กับวงกลมไอคอน/ป้ายที่สื่อถึงหมวดนั้น (เช่น เหรียญ achievement, ทักษะ) **ห้ามเปลี่ยนค่า** เพราะผูกกับตารางในรายงาน 3.3.4

### 2.4 พื้นและตัวหนังสือ
| Token | ค่า | ใช้กับ |
|---|---|---|
| `bg-page` | `#f8f9fc` | พื้นหลังหน้า (dashboard) |
| `bg-tint` | `#f0f4ff` | พื้นอ่อน primary: แถบป้ายชื่อ, แถวที่ hover, กล่องย่อย |
| `bg-soft` | `#f9f9f9` / `#f5f5f5` | พื้น toolbox, พื้นปุ่มโปร่ง |
| `border` | `#e8ecf4` (บนพื้นน้ำเงินอ่อน `#dde3f0`) | เส้นขอบการ์ด/ตาราง |
| `text` | `#333` / `#666` / `#999` | หลัก / รอง / จาง |

---

## 3. Shape tokens

### 3.1 มุมโค้ง (radius)
| Token | ค่า | ใช้กับ |
|---|---|---|
| `r-pill` | **20px** | ปุ่มทุกชนิด, ป้าย/ชิป, แถบเครื่องมือลอย |
| `r-card` | **12px** | การ์ด, section, modal, กล่องฟอร์ม |
| `r-screen` | **10px** | จอจำลองทั้งสองจอ (ให้ดูเป็นอุปกรณ์) |
| `r-input` | **8px** | ช่องกรอก, select, ป้ายเล็ก |
| วงกลม | `50%` | avatar, FAB, วงกลมไอคอน, จุดสถานะ |

### 3.2 เงา (shadow) — นุ่ม ตื้น ไม่ฟุ้ง
| Token | ค่า | ใช้กับ |
|---|---|---|
| `sh-bar` | `0 2px 5px rgba(0,0,0,0.2)` | header, ปุ่มบน header |
| `sh-card` | `0 2px 8px rgba(58,83,164,0.07)` | การ์ด/section ปกติ |
| `sh-float` | `0 4px 10px rgba(0,0,0,0.1)` | ของที่ลอยบนพื้นทำงาน (จอจำลอง, แถบเครื่องมือ) |
| `sh-hover` | `0 4px 14px rgba(58,83,164,0.12)` | ตอน hover การ์ด (ยกขึ้นได้ไม่เกิน 2px) |
| `sh-modal` | `0 10px 40px rgba(0,0,0,0.2)` | modal เท่านั้น |

**เพดาน:** เงาปกติห้ามเกิน blur 14px ยกเว้น modal · ห้ามใช้เงาสีจัด (เช่น เงาเหลือง/ชมพู)

### 3.3 ระยะและขนาด
- ช่องไฟการ์ด: `padding: 20–24px` · ระยะระหว่างการ์ด `gap: 16–20px`
- ความกว้างเนื้อหาสูงสุด: dashboard `1400px` (ดู `claude-RoboWeb.md`)
- header สูง 60px คงที่ → พื้นที่หน้า = `calc(100vh - 60px)`

---

## 4. Typography

- ฟอนต์: **`'Prompt', 'Segoe UI', 'Roboto', sans-serif`** (ฝังในเครื่องที่ `vendor/prompt.css`)
- น้ำหนัก: 300 (จาง) · 400 (ปกติ) · 500 (เน้น/ปุ่ม/ป้าย) · 600–700 (หัวข้อ/ตัวเลขใหญ่)
- ขนาด: โลโก้ 24 · h1 dashboard 26–28 · หัวข้อ section 18 · เนื้อหา 14–15 · ป้าย/คำอธิบาย 11–13
- ตัวเลขสถิติใหญ่ 30–32px หนา 700
- **ข้อความ UI เป็นภาษาไทยเป็นกันเอง** (ยกเว้นศัพท์เทคนิค/ชื่อบล็อก: Run, Dashboard, Workspace)

---

## 5. Component patterns (คัดลอกไปใช้ได้เลย)

### 5.1 การ์ดลอยบนพื้นทำงาน (จอจำลอง, แถบเครื่องมือ)
```css
background: #fff;
border: 4px solid #BED73B;       /* จอจำลองใช้ขอบ accent */
border-radius: 10px;             /* r-screen */
box-shadow: 0 4px 10px rgba(0,0,0,0.1);
```
**ห้ามใส่แถบหัว/ป้ายชื่อครอบการ์ด** (ทั้งแบบสีเข้มและแบบพื้นอ่อน) — พื้นทำงานต้องโปร่ง
อยากบอกข้อมูลเพิ่ม ใช้ 2 ทางนี้:
1. **วาดตัวหนังสือเล็กในมุม canvas เอง** (เช่น "หันขึ้น ↑" สีเทา `#8a93ad` 10px) — เป็นวิธีเดิมของเวที
2. **ชิปเล็กลอยมุมจอ** (`position:absolute; top:5px; right:5px`) สำหรับสถานะที่ต้องอัปเดต

### 5.1.1 มีหลายจอ → **จอเดียว + จอเล็กซ้อนมุม (PiP) ห้ามวางการ์ดเรียงกันหลายใบ**
พื้นทำงานมีที่จำกัด การ์ดลอยหลายใบเรียงกัน = รก
```css
.twin-view.twin-big { top:0; left:0; width:100%; height:100%; }        /* จอหลัก */
.twin-view.twin-pip { right:8px; bottom:8px; width:104px; height:78px; /* จอซ้อน */
    border:2px solid #3A53A4; border-radius:6px;
    box-shadow:0 2px 6px rgba(0,0,0,0.18); cursor:pointer; }
```
คลิกจอเล็กเพื่อสลับกับจอใหญ่ (ทั้งสองจอเป็น 4:3 สลับแล้วไม่บิด) · คลิกจอใหญ่ไม่ทำอะไร (กันกดพลาด)

### 5.2 การ์ดเนื้อหา (section ใน dashboard)
```css
background: #fff;
border-radius: 12px;
box-shadow: 0 2px 8px rgba(58,83,164,0.07);
padding: 22px 24px;
```
หัวข้อ: `border-left: 4px solid #3A53A4; padding-left: 14px; font-size:18px; font-weight:600;`

### 5.3 การ์ดตัวเลขสถิติ — **ลาย "วงกลมสี" จาก toolbox**
การ์ด**ขาว** + วงกลมสี 42px (ไอคอน SVG ขาวข้างใน) + ตัวเลขสีเดียวกับวงกลม + ป้ายชื่อเทา
สีวงกลม 4 ใบใช้: `#3A53A4` → `#BED73B` → `#4CAF50` → `#FFBF00`
(ตัวเลขบนพื้นขาวใช้เวอร์ชันเข้ม: `#3A53A4` / `#7d9414` / `#3d8b40` / `#b8860b`)

### 5.4 ปุ่ม
```css
/* หลัก */   background:#3A53A4; color:#fff; border-radius:20px; padding:8px 20px; font-weight:500;
/* สำเร็จ */ background:#4CAF50;  (ปุ่ม Run ใช้ #80C781)
/* รอง */    background:#f0f4ff; color:#3A53A4; border:1px solid #dde3f0;
/* อันตราย */background:#fff; color:#d32f2f; border:1px solid #f0c4c4;
```
hover = `filter: brightness(0.95)` หรือยกขึ้น `translateY(-1px)` **ห้ามเปลี่ยนสีข้ามพาเลต** · **ห้ามใช้ไล่เฉด**

### 5.5 ป้าย/ชิป (badge)
```css
border-radius: 20px; padding: 2px 10px; font-size: 11–12px; font-weight: 500;
```
สำเร็จ `#e8f5e9/#2e7d32` · กำลังทำ `#fff8e1/#f57f17` · เฉยๆ `#f0f0f0/#888` · ข้อมูล `#f0f4ff/#3A53A4`
มีจุดสถานะได้: `::before` วงกลม 6px สีเดียวกับตัวหนังสือ (ลายเดียวกับ `#status-dot` บน header)

### 5.6 ช่องกรอก
```css
border: 1px solid #dde3f0; border-radius: 8px; padding: 8px 12px; font-family: inherit;
:focus { border-color:#3A53A4; box-shadow: 0 0 0 3px rgba(58,83,164,0.1); outline:none; }
```

### 5.7 แถบข้อมูล/กราฟ
แท่งกราฟ/หลอดความคืบหน้า: ไล่เฉดได้แค่ในตระกูลเดียว — `#3A53A4 → #4a6ad4` (ข้อมูลทั่วไป) หรือ `#4CAF50 → #80C781` (ความคืบหน้า/ทักษะ)

### 5.8 แจ้งผล
ใช้ `.meto-snackbar` ลอยกลางบนเท่านั้น (มองเห็นได้ทุกหน้า) — **ห้าม** ใช้ chat bubble แจ้งผลนอกหน้า Workspace

---

### 5.9 ความคืบหน้าทักษะฝั่งครู `.mastery-meter`
ครู**ไม่เห็นดาว** (ดาวเป็นของธีม B) — เห็นแถบ + `2/3` เพราะต้องอ่านค่าไปกรอกเล่มและตัดสินใจสอนซ่อม
ทักษะที่ระบบตรวจเองไม่ได้ขึ้นป้าย "ครูประเมินเอง" แทนตัวนับที่ไม่มีความหมาย

**กติกาข้ามธีม (สำคัญที่สุดในไฟล์นี้):**
ดาวฝั่งเด็กกับ `2/3` ฝั่งครูต้องมาจาก `clean_run_count` / `mastery_threshold` ชุดเดียวกันเสมอ
ถ้าวันหนึ่งสองฝั่งไม่ตรงกัน แปลว่ามีฝั่งใดฝั่งหนึ่งคิดเลขเอง = ผิด **ห้ามให้ธีมทำให้ข้อมูลเพี้ยน**

### 5.10 หน้าเลือกแดชบอร์ด `.hub-card`
การ์ดขาว + **ขีดซ้าย 4px บอกบทบาท** — `#3A53A4` โปรไฟล์ · `#FFBF00` ห้องที่สอน · `#4CAF50` ห้องที่เรียน
ป้ายบทบาทใช้โทนสถานะจากข้อ 2.2 (`warn` = ครู · `success` = นักเรียน) ไม่ใช่สีใหม่
วางเป็นกริด `repeat(auto-fill, minmax(320px, 1fr))` — **ช่องเรียงกัน ไม่ใช่กล่องลอย**

### 5.11 ⚠️ กับดักที่กินเวลาไปแล้วครั้งหนึ่ง: กฎ global `button`
`style.css` มีกฎตั้งแต่ต้นไฟล์ (บรรทัด ~59) ที่เป็นของปุ่มลอยหน้า Workspace
```css
button { position: absolute; top: 20px; right: 20px; z-index: 100; }
```
**`<button>` ทุกตัวในเว็บโดนกฎนี้** ถ้าไม่ override จะถูกดันไปกองซ้อนกันที่มุมขวาบนทับ header
ทำให้ดูเหมือนกล่องแจ้งเตือนเด้งขึ้นมา แทนที่จะอยู่ในตำแหน่งที่ควรอยู่

**ทำ UI ใหม่ที่ใช้ `<button>` เมื่อไหร่ ต้องใส่ `position: static` เสมอ** — ใช้กับทั้งสองธีม
(`.project-btn` · `.btn-add` · `.hub-card` · `.hub-back` ทำแบบนี้กันหมด) · ดู `CHANGELOG.md` [2.5]

---

## 6. หลัก UX ที่ผูกกับหน้าตา (ย่อจาก `claude-RoboWeb.md` ข้อ 4)

1. เห็นผลทันที — ทุก action ต้องมี feedback ที่มองเห็น
2. ไม่ลงโทษความผิดพลาด — ใช้โทนเหลือง warning + คำแนะนำเชิงบวก ไม่ใช้แดงดุ
3. ภาษาเด็กเข้าใจ ไม่มีศัพท์เทคนิคดิบ
4. มุมโค้งเยอะ เงานุ่ม เป็นมิตร
5. รองรับแท็บเล็ตขึ้นไป (≥1024px) — จอแคบให้ยุบเป็นคอลัมน์เดียว ไม่ต้องรีด mobile

---

## 7. Checklist ธีม A (ฝั่งเครื่องมือ/ครู)

- [ ] เทียบกับหน้า Workspace แล้ว — หน้าตาอยู่ตระกูลเดียวกัน
- [ ] สีทุกสีอยู่ในข้อ 2 (ไม่มีไล่เฉดนอกพาเลต)
- [ ] มุมโค้งใช้ token ข้อ 3.1 (20 / 12 / 10 / 8)
- [ ] เงาใช้ token ข้อ 3.2 (blur ไม่เกิน 14px ยกเว้น modal)
- [ ] ข้อความไทยใช้ฟอนต์ Prompt และเป็นภาษาเป็นกันเอง
- [ ] ไอคอนเป็น inline SVG ใน `MetoIcons` (ไม่ใช่อีโมจิ)
- [ ] `<button>` ใหม่ทุกตัวใส่ `position: static` (ข้อ 5.11)
- [ ] **ไม่มีสไตล์ของธีม B รั่วเข้ามา** — ฝั่งครูต้องพิมพ์ลงกระดาษได้
- [ ] ทดสอบครบ 4 สถานะบทบาท: นักเรียนล้วน / ครู / เป็นทั้งสองอย่าง / ยังไม่มีห้องเลย

---
---

# ส่วนที่ 2 — ธีม B: เกม (`body.mode-player`)

> **ที่มา:** อาจารย์คอมเมนต์ว่าอยากให้ฝั่งนักเรียนเป็น UI เกมที่ดึงดูดและน่าเล่น
> รอบแรกทำโดยยึดธีม A แล้วแปะดาวเพิ่ม ผลคือ **"ดูเหมือนเกม 2/10 · น่าเบื่อ 8/10"**
> จึงตัดสินใจ **แยกเป็นธีมของตัวเองเต็มตัว** ไม่ใช่ข้อยกเว้นของธีม A
>
> **อ้างอิงหลัก: Stardew Valley** — สิ่งที่ลอกคือ *กลไกทางสายตา* ไม่ใช่ธีมฟาร์ม
> พื้นเข้มให้ของสว่างเปล่งได้ · ทุกกรอบเป็น 9-slice หนา · UI ทำจากวัสดุในโลกของเกม · ฟอนต์พิกเซล

## 8. Design DNA ของธีมเกม — 6 ข้อ

> ⚠️ **แก้ 6 ส.ค. 2026 (รอบสอง):** ข้อ 1 เคยเขียนว่า "พื้นต้องเข้ม" ซึ่ง**ผิด**
> Stardew ไม่ได้มืด มันสว่างและอบอุ่น (หญ้าเขียว ฟ้าสด แดดอุ่น) — ที่มืดคือ Hollow Knight / Balatro
> การเอาสูตร "เกม = พื้นเข้ม" มาใช้ทั้งที่เรฟเป็น Stardew คือการอ่านเรฟผิด

| # | หลัก | ทำไม |
|---|---|---|
| 1 | **พื้นสว่างอบอุ่น มีฟ้ามีพื้นดิน** | ต้องเป็น *ฉากกลางแจ้ง* ไม่ใช่ *หน้ากระดาษ* — ความต่างอยู่ที่มี "พื้นดิน" กับ "เส้นขอบฟ้า" ไม่ใช่ที่ความมืด · ธีม A ล้มเหลวเพราะเป็นขาวสามเฉดที่แบนราบ ไม่ใช่เพราะมันสว่าง |
| 2 | **ไม่มีมุมโค้ง** | พิกเซลอาร์ตมุมเหลี่ยม · `border-radius` คือลายเซ็นของเว็บ ไม่ใช่เกม · ความนุ่มมาจาก 9-slice ไม่ใช่จาก radius |
| 3 | **เงาแข็ง ไม่ฟุ้ง** | `box-shadow: 0 4px 0` = เกม · `0 2px 8px rgba()` = Material Design **ต่างกันแค่ property เดียวแต่พลิกการอ่านทั้งหน้า** |
| 4 | **ต้องมีของขยับตอนอยู่เฉย** | นี่คือคำตอบของ "ทำไมไม่มีชีวิต" · อนิเมชันขาเข้ากับตอนได้รางวัลไม่พอ พอหน้านิ่งแล้วมันคือภาพนิ่ง |
| 5 | **ทุกอย่างเป็นวัตถุในโลก ไม่ใช่การ์ดในกริด** | กริดสม่ำเสมอ = สเปรดชีต · เกมใช้ความไม่สมมาตรและตำแหน่งที่มีความหมาย |
| 6 | **ตัวหนังสือน้อยที่สุด** | ตาอ่านรูปทรงก่อนอ่านคำ · สถานะต้องอ่านออกจากสี/รูปทรง/แสง ไม่ใช่จากป้ายกำกับ |

**สิ่งที่ผิดธีม B ทันที** (เจอที่ไหนให้แก้)
- `border-radius` มากกว่า 0 (ยกเว้นวงกลมเต็มใบ `50%`)
- เงาฟุ้ง `blur > 0` ที่ไม่ใช่ glow
- การ์ดพื้นขาว
- `grid-template-columns: repeat(auto-fill, ...)` สำหรับเนื้อหาหลัก
- ของที่นิ่งสนิทตอนไม่มีใครแตะ
- ไอคอนเส้นบาง (stroke) — ธีม B ใช้**ซิลูเอตทึบ**

## 9. Color tokens ธีมเกม

**ทิศทาง: Stardew ผสม METO** — โลกสว่างอบอุ่นแบบ Stardew แต่กรอบและจุดเน้นใช้สีแบรนด์

```css
body.mode-player {
    --g-sky:      #bfe4f7;   /* ฟ้า */
    --g-sky-far:  #e6f3fb;   /* ขอบฟ้า / พื้นหน้า */
    --g-grass:    #8ec95a;   /* หญ้า — ญาติของ accent */
    --g-grass-d:  #6ba33e;   /* หญ้าเงา */

    --g-panel:    #f7ecd2;   /* ไม้ครีม — แผงหลัก */
    --g-panel-hi: #fdf8ea;   /* ครีมสว่าง — ยกนูน/hover */
    --g-panel-d:  #e0cca4;   /* ครีมเงา — ช่องจม */

    --g-frame:    #3A53A4;   /* กรอบ = น้ำเงินแบรนด์ */
    --g-frame-d:  #26356b;   /* เงาแข็งของกรอบ */

    --g-text:     #3d3226;   /* น้ำตาลเข้ม อ่านชัดบนครีม */
    --g-text-dim: #7d6b52;

    --g-accent:   #BED73B;   /* แบรนด์ — ความคืบหน้า */
    --g-accent-d: #7d9414;
    --g-gold:     #FFBF00;   /* ดาว */
    --g-gold-d:   #b8860b;
}
```

**3 จุดที่ "ผสม METO" เข้าไปในโลก Stardew** (ตอบได้ว่าทำไมยังเป็นเว็บเดียวกัน)
1. **กรอบแผงเป็นน้ำเงิน `#3A53A4`** แทนขอบไม้น้ำตาลแบบ Stardew — เป็นตัวผูกแบรนด์ที่ชัดที่สุด
2. **ดาวใช้ `#FFBF00`** ซึ่งอยู่ในพาเลตหมวดบล็อก (Head) อยู่แล้ว — ได้ทองอุ่นโดยไม่ออกนอกแบรนด์
3. **หญ้า `#8ec95a` เป็นญาติของ `#BED73B`** — โลกกับ accent อยู่ตระกูลสีเดียวกัน

**ฉากต้องมีเส้นขอบฟ้าแบบ hard stop** (ฟ้า → หญ้า ตัดกันคมๆ ไม่ไล่เฉด)
ไล่เฉดนุ่มๆ อ่านว่า gradient ของเว็บ · ตัดคมอ่านว่าพื้นดิน

**สีหมวดบล็อก 8 สี (ข้อ 2.3) ใช้ต่อโดยไม่เปลี่ยนค่า** — ผูกกับตารางรายงาน 3.3.4
เปลี่ยนแค่ว่าเอาไปทาตรงไหน: ธีม A ใช้เป็นวงกลมเล็ก · ธีม B ใช้เป็นสีเต็มโหนดและเป็น glow

**ห้ามใช้สีแดงลงโทษความผิดพลาดของเด็ก** — กฎนี้ข้ามมาจากธีม A และเป็นกฎการสอน ไม่ใช่กฎสไตล์

## 10. Shape & material

### 10.1 ตะแกรงพิกเซล
ทุกขนาด/ระยะเป็น **ผลคูณของ 4px** · พิกัดใน SVG เป็นจำนวนเต็มเสมอ
`image-rendering: pixelated` กับทุกภาพ raster · `shape-rendering: crispEdges` กับ SVG ที่ต้องการขอบคม

### 10.2 กรอบ 9-slice (แทนการ์ด)
```css
.g-panel {
    border-style: solid;
    border-width: 16px;                       /* = ขนาด slice */
    border-image: url('/static/game-assets/kenney-pixel-ui/9-Slice/Ancient/brown.png') 16 fill repeat;
    image-rendering: pixelated;
    border-radius: 0;
}
```
**ต้องมีคีย์เวิร์ด `fill`** ไม่งั้นตรงกลางโปร่ง — เป็นบั๊กคลาสสิกของ `border-image`
ไฟล์ต้นทาง 48×48 → slice = 16 (48÷3) · ชุด `Ancient` (น้ำตาล/เทา/แทน) ให้ฟีล Stardew ที่สุด

### 10.3 เงาแข็ง = ภาษาของปุ่มเกม
```css
box-shadow: 0 4px 0 var(--g-drop),            /* เงาแข็ง ไม่ฟุ้ง */
            inset 0 2px 0 rgba(255,255,255,.18);  /* ขอบบนสว่าง = นูน */
```
กดแล้ว `transform: translateY(4px)` + ลบเงา = ยุบลงจริง **ต้องรู้สึกว่ากดติด**

### 10.4 Glow = "อันนี้เล่นได้ตอนนี้"
```css
filter: drop-shadow(0 0 6px var(--g-accent)) drop-shadow(0 0 14px rgba(190,215,59,.45));
```
**เรืองได้ทีละ 1-2 ชิ้นบนจอเท่านั้น** — เรืองหมดทุกชิ้น = ไม่เรืองเลย

### 10.5 พื้นผิว (ห้ามให้ผิวเรียบเปล่า)
```css
background-image: repeating-linear-gradient(45deg,
    rgba(255,255,255,.03) 0 2px, transparent 2px 4px);   /* ลายขีด ไม่ใช้ไฟล์ */
```
หรือ noise ด้วย SVG `feTurbulence` เป็น data-URI ที่ opacity 4%
**พื้นผิวคือตัวแยก "เกม" กับ "เว็บ" ที่ถูกที่สุด** ผิวเรียบ = ค่าสีใน CSS · มีผิว = วัสดุ

## 11. Typography ธีมเกม

```css
font-family: 'Silver', 'Prompt', sans-serif;
```

| ฟอนต์ | ใช้กับ | license |
|---|---|---|
| **Silver** (Poppy Works) | ทุกอย่างในธีม B — **มีอักษรไทยครบ** อัปเดตไทยเมษา 2023 | CC BY 4.0 ต้องใส่เครดิต · ฟรีถ้างบ < $100,000 |
| **Prompt** | fallback ตอน Silver ยังไม่ถูกวาง / ข้อความยาวที่ต้องอ่านง่าย | OFL |

- ขนาดตัวอักษรเป็นผลคูณของ 4 และ **ห้ามต่ำกว่า 16px** (ฟอนต์พิกเซลเล็กกว่านี้อ่านไม่ออก)
- `-webkit-font-smoothing: none` เพื่อไม่ให้ anti-alias ทำลายความคม
- **ห้ามพิมพ์ชื่อฟิลด์ในฐานข้อมูลลงจอ** — เช่น `Sequencing` ตัวเล็กใต้ชื่อไทย นั่นคือหน้าตา CRUD admin ไม่ใช่เกม

## 12. Motion — หัวใจของธีม B

### 12.1 Idle loop (บังคับ)
ทุกชิ้นที่ควร "มีชีวิต" ต้องมีลูปช้า 2-4 วินาที ขยับ 2-4px
**และต้องใส่ `animation-delay` ต่างกันทุกชิ้น** — ขยับพร้อมกัน = เครื่องจักร · เหลื่อมกัน = สิ่งมีชีวิต

### 12.2 Juice ตอนได้รางวัล
`scale(1.06)` สุภาพเกินไป ของจริงคือ **overshoot 1.25 → ยุบ 0.95 → นิ่ง** ด้วย back-ease
พร้อมอนุภาค 6-10 ชิ้นกระเด็นสุ่มทิศ 500ms + จอสั่น 2px 120ms
**จุดที่ควรถลุงงบ motion คือจังหวะรางวัล** ไม่ใช่ตอนโหลดหน้า

### 12.3 บังคับ
ทุกอนิเมชันต้องเคารพ `@media (prefers-reduced-motion: reduce)` — ปิด idle loop และ shake ให้หมด

## 13. เสียง

**ห้ามใช้ไฟล์เสียง** — สังเคราะห์สดด้วย Web Audio API (`sfx.js`)
เหตุผล: ไม่มีปัญหา license · ไม่ต้องโหลด · ปรับได้จากโค้ด · ได้ฟีล 8-bit ตรงธีมพอดี

- ต้องมี **ปุ่มปิดเสียง** และจำค่าไว้ใน `localStorage`
- เสียงแรกต้องรอ user gesture (นโยบาย autoplay ของเบราว์เซอร์) — ห้ามพยายามเล่นตอนโหลดหน้า
- เสียงสั้น < 300ms ทุกตัว ยกเว้นเสียงเลเวลอัพ

## 14. Asset inventory + license (ต้องอ้างในเล่มวิจัย)

### ⛔ ห้ามเอาสไปรต์หุ่นใน `static/sprites/` มาใช้ในหน้านักเรียน
ชุดนั้นเป็น **digital twin ของหุ่นจริง** มีไว้ให้เวทีจำลองแสดงสถานะหุ่นตามที่เด็กสั่ง
เอามาเป็นมาสคอต/อวตาร/ของประดับ = **ใช้ผิดวัตถุประสงค์**
เคยพลาดทำไปแล้วใน [2.6] และถอดออกใน [2.7] — **อย่าเอากลับมา**
ถ้าจะมีตัวละครในหน้านี้ ต้องเป็นอาร์ตที่วาดขึ้นมาเพื่อการนี้โดยเฉพาะ
ระหว่างที่ยังไม่มี ใช้หมุดธง SVG (`Dashboard._marker`) แทน

| ของ | ที่มา | License | เงื่อนไข |
|---|---|---|---|
| กรอบ 9-slice, ปุ่ม, บาร์, ลูกศร | [Kenney Pixel UI Pack](https://kenney.nl/assets/pixel-ui-pack) | **CC0** | ไม่ต้องเครดิต ใช้เชิงพาณิชย์ได้ · เก็บที่ `static/game-assets/kenney-pixel-ui/` |
| ฟอนต์ Silver | [Poppy Works](https://poppyworks.itch.io/silver) | **CC BY 4.0** | **ต้องใส่เครดิตในเว็บและในเล่ม** |
| ไอคอนซิลูเอต | [game-icons.net](https://game-icons.net) | CC BY 3.0 | ต้องใส่เครดิต (ถ้าใช้) |
| หุ่น METO | วาดเองในโปรเจกต์ `static/sprites/front/` | ของโปรเจกต์ | 62 PNG — 10 สีหน้าอยู่ที่ `front/Face/` |

**ห้ามใช้ asset ที่ generate ด้วย AI** — ที่มาและสิทธิ์ยังถกเถียงได้ และในงานวิชาการโดนถามได้ง่าย
**ตั้งใจไว้ว่าจะวาดทับเองภายหลัง** — โครงทั้งหมดจึงต้องสลับไฟล์ได้โดยไม่แก้โค้ด

## 15. Checklist ธีม B

- [ ] ไม่มี `border-radius` (ยกเว้นวงกลมเต็มใบ)
- [ ] ไม่มีเงาฟุ้งที่ไม่ใช่ glow · เงาปุ่มเป็น `0 4px 0` และกดแล้วยุบจริง
- [ ] พื้นเข้ม และมีชั้นพื้นผิวอย่างน้อย 1 ชั้น
- [ ] **มีของขยับอย่างน้อย 1 ชิ้นตอนหน้านิ่ง** และ delay เหลื่อมกัน
- [ ] ขนาด/ระยะเป็นผลคูณของ 4 · ตัวหนังสือ ≥ 16px
- [ ] ไอคอนเป็นซิลูเอตทึบ ไม่ใช่เส้นบาง
- [ ] ไม่มีชื่อฟิลด์ฐานข้อมูลโผล่บนจอ
- [ ] มีปุ่มปิดเสียง และเสียงไม่เล่นก่อน user gesture
- [ ] `prefers-reduced-motion` ปิด idle + shake ได้จริง
- [ ] **ตัวเลขดาวตรงกับ `2/3` ฝั่งครู** (ข้อ 5.9)
- [ ] เครดิต Silver + asset ปรากฏในเว็บ
- [ ] ไม่มีสไตล์ธีม B รั่วออกนอก `body.mode-player`

---

*อัปเดตล่าสุด: 6 สิงหาคม 2026 — แยกเป็น 2 ธีม · แก้ธีมเมื่อไหร่ ต้องอัปเดตไฟล์นี้ + จดใน `CHANGELOG.md`*
