HoneyKung/metorobot/ฐานข้อมูลของเรา_เก็บอะไรเก็บยังไง.md

# ฐานข้อมูลของเรา — เก็บอะไร และเก็บเป็นอะไร

> ทุกตัวอย่างในเอกสารนี้คือ **ข้อมูลจริง** ที่ดึงออกมาจากไฟล์ `instance/robomdt.db` ไม่ใช่ตัวอย่างสมมติ

---

## ตอบคำถามแรกก่อน — ฐานข้อมูลเราเป็นแบบไหน

**ไม่ใช่ JSON และไม่ใช่ HTML**

ฐานข้อมูลของเราเป็นแบบที่เรียกว่า **relational database** ซึ่งเก็บข้อมูลเป็น **ตาราง** เหมือน Excel เป๊ะๆ คือมีหัวคอลัมน์ แล้วมีข้อมูลเรียงลงมาเป็นแถว

ชื่อระบบที่ใช้:

| ตอนไหน | ใช้อะไร | หน้าตา |
|---|---|---|
| ตอนพัฒนาในเครื่อง | **SQLite** | ไฟล์เดียวชื่อ `robomdt.db` ขนาด 90 KB |
| ตอนขึ้นออนไลน์ | **PostgreSQL** | เซิร์ฟเวอร์แยกที่ Render จัดการให้ |

ทั้งสองตัวเก็บข้อมูลเป็นตารางเหมือนกัน ต่างกันแค่ตัวจัดการ

**เปรียบเทียบให้เห็นภาพ**

```
ฐานข้อมูลแบบตาราง (ของเรา)          ฐานข้อมูลแบบ JSON (ไม่ใช่ของเรา)
┌────┬──────────┬─────────┐          {
│ id │ username │ role    │            "id": 1,
├────┼──────────┼─────────┤            "username": "testuser",
│ 1  │ testuser │ USER    │            "role": "USER"
│ 2  │ student1 │ USER    │          }
└────┴──────────┴─────────┘
```

ของเราคือฝั่งซ้าย ต้องกำหนดคอลัมน์ไว้ล่วงหน้าว่ามีช่องอะไรบ้าง ใส่ข้อมูลนอกช่องที่กำหนดไม่ได้

---

## แล้ว HTML กับ JSON อยู่ตรงไหน

นี่คือจุดที่คนสับสนมากที่สุด คำตอบคือ **มันอยู่คนละชั้นกัน** ไม่ได้อยู่ในฐานข้อมูล

```
   ชั้นที่ 1  หน้าจอที่เด็กเห็น          →  HTML + CSS + JavaScript
                    ↕  ส่งข้อมูลไปมาด้วย  →  JSON
   ชั้นที่ 2  หลังบ้าน (Python)          →  โค้ดประมวลผล
                    ↕  อ่าน/เขียนด้วย     →  ภาษา SQL
   ชั้นที่ 3  ฐานข้อมูล                  →  ตาราง 13 ตาราง
```

**อธิบายทีละอัน**

| รูปแบบ | อยู่ที่ไหน | ทำหน้าที่อะไร | อยู่ในฐานข้อมูลไหม |
|---|---|---|---|
| **HTML** | ไฟล์ `index.html` | โครงหน้าเว็บที่เด็กเห็น | **ไม่อยู่เลย** |
| **CSS** | ไฟล์ `style.css` | ความสวยงาม สี ขนาด | **ไม่อยู่เลย** |
| **JavaScript** | ไฟล์ `script.js` และอื่นๆ | ทำให้หน้าเว็บกดได้ ลากบล็อกได้ | **ไม่อยู่เลย** |
| **JSON** | วิ่งไปมาระหว่างชั้น 1 กับ 2 | รูปแบบการส่งข้อมูล เหมือนซองจดหมาย | **ผ่านเข้าออก** เก็บจริงแค่ช่องเดียว |
| **XML** | ในฐานข้อมูล | เก็บบล็อกที่เด็กต่อ | **อยู่จริง** 1 ช่อง |

**เปรียบเทียบ** — HTML คือจานอาหารที่เสิร์ฟบนโต๊ะ JSON คือถาดที่บ๋อยใช้ยกจากครัวมาโต๊ะ ส่วนฐานข้อมูลคือตู้เย็นในครัว วัตถุดิบอยู่ในตู้เย็น ไม่ได้อยู่บนจาน

---

## ในตารางเก็บข้อมูลชนิดอะไรบ้าง

แต่ละช่องในตารางต้องประกาศไว้ก่อนว่าจะเก็บอะไร ระบบเราใช้อยู่ 6 ชนิด

| ชนิด | เก็บอะไร | ตัวอย่างจริงจากไฟล์ |
|---|---|---|
| `INTEGER` | จำนวนเต็ม | `id = 1`, `user_id = 6` |
| `VARCHAR(n)` | ข้อความสั้น จำกัดความยาว | `username = 'testuser'` (จำกัด 80 ตัว) |
| `TEXT` | ข้อความยาว ไม่จำกัด | ช่องเก็บบล็อกของเด็ก |
| `FLOAT` | ตัวเลขทศนิยม | `score`, `max_score` |
| `BOOLEAN` | จริงหรือเท็จ | `is_completed = 0` (0 คือเท็จ 1 คือจริง) |
| `DATETIME` | วันเวลา | `created_at = '2026-07-16 13:00:45.162636'` |

**ตัวอย่างจริง — ตาราง `projects` ประกาศไว้แบบนี้**

```
id                 INTEGER        ห้ามว่าง
user_id            INTEGER        ห้ามว่าง
title              VARCHAR(200)   ห้ามว่าง
blockly_xml        TEXT           ว่างได้
generated_code     TEXT           ว่างได้
created_at         DATETIME       ว่างได้
updated_at         DATETIME       ว่างได้
```

---

## 4 รูปแบบพิเศษที่ซ่อนอยู่ในช่องข้อความ

ตรงนี้คือหัวใจของคำถาม บางช่องประกาศว่าเป็น "ข้อความ" แต่ข้างในจริงๆ เป็นข้อมูลที่มีโครงสร้าง

### 1. XML — บล็อกที่เด็กต่อ

อยู่ในช่อง `projects.blockly_xml` นี่คือ **ข้อมูลจริงทั้งช่อง** ของโปรเจกต์แรกในระบบ

```xml
<xml xmlns="https://developers.google.com/blockly/xml"><block type="move_backward" id="BK%z_KJjI`XtLH0@g6[~" x="388" y="213"></block></xml>
```

อ่านว่า มีบล็อก 1 ชิ้น ชนิด `move_backward` (ถอยหลัง) วางอยู่ที่พิกัด x 388 y 213 บนกระดาน

**ทำไมถึงเป็น XML** — เพราะเครื่องมือ Blockly ที่เราใช้ทำระบบลากบล็อก มีคำสั่งแปลงบล็อกทั้งกระดานออกมาเป็นข้อความ XML ได้ในตัว และแปลงกลับได้ด้วย เราเลยไม่ต้องคิดวิธีเก็บเอง

**เก็บ ↔ อ่านกลับ**

```
เด็กลากบล็อก  →  Blockly แปลงเป็น XML  →  เก็บลงช่อง blockly_xml
เปิดงานเก่า   →  อ่าน XML จากช่อง      →  Blockly แปลงกลับเป็นบล็อกบนจอ
```

### 2. JSON — รายละเอียดของบันทึกการใช้งาน

อยู่ในช่อง `activity_logs.metadata_json` **ข้อมูลจริงจากไฟล์**

```json
{"command_length":32,"block_count":9}
{"count":9}
{"command_length":4,"block_count":4}
```

อ่านว่า ครั้งนั้นเด็กใช้บล็อก 9 ชิ้น และคำสั่งที่ได้ยาว 32 ตัวอักษร

**ทำไมถึงใช้ JSON ตรงนี้** — เพราะแต่ละกิจกรรมมีรายละเอียดไม่เหมือนกัน กดรันมี 2 ค่า นับบล็อกมี 1 ค่า ถ้าทำเป็นคอลัมน์แยกจะต้องเพิ่มคอลัมน์เรื่อยๆ เลยยัดรวมไว้ในช่องเดียวแบบ JSON

⚠️ **ข้อควรรู้** — ช่องนี้ประกาศเป็น `TEXT` ไม่ใช่ชนิด JSON แท้ ฐานข้อมูลจึงมองว่าเป็นข้อความก้อนเดียว ค้นหาหรือบวกค่าข้างในโดยตรงไม่ได้ ต้องดึงออกมาให้ Python แกะเอง

### 3. Hash — รหัสผ่าน

อยู่ในช่อง `users.password_hash` **ข้อมูลจริง**

```
scrypt:32768:8:1$p3DMust3yXj...
```

**นี่ไม่ใช่รหัสผ่าน** แต่เป็นผลลัพธ์ที่ผ่านการเข้ารหัสทางเดียวแล้ว แปลงกลับเป็นรหัสเดิมไม่ได้ ตอนล็อกอินระบบจะเอาสิ่งที่เด็กพิมพ์มาเข้ารหัสด้วยวิธีเดียวกัน แล้วเทียบว่าตรงกันไหม

ส่วนประกอบ: `scrypt` คือชื่อวิธีเข้ารหัส · `32768:8:1` คือค่าความยากที่ตั้งไว้ · หลัง `$` คือค่าที่ได้

### 4. รหัสคำ — ค่าที่ต้องเป็นคำใดคำหนึ่งเท่านั้น

บางช่องเก็บข้อความ แต่รับได้แค่ไม่กี่ค่า

| ช่อง | ค่าที่รับได้ | ข้อมูลจริง |
|---|---|---|
| `student_objective_progress.status` | `NOT_STARTED` `IN_PROGRESS` `COMPLETED` | `'IN_PROGRESS'` |
| `assignments.level` | `Sequential` `If/Else` `Loop` | `'Sequential'` |
| `activity_logs.action_type` | `REGISTER` `LOGIN` `RUN_CODE` `BLOCK_COUNT` `SKILL:ชื่อทักษะ` | `'RUN_CODE'` |
| `learning_objectives.category` | `FUNDAMENTALS` `PROBLEM_SOLVING` `ROBOTICS` | `'FUNDAMENTALS'` |

⚠️ ฐานข้อมูลไม่ได้บังคับว่าต้องเป็นค่าเหล่านี้ ใส่คำอื่นก็ได้ การควบคุมอยู่ที่โค้ดอย่างเดียว

---

## 13 ตารางเก็บอะไรบ้าง — พร้อมข้อมูลจริง

### กลุ่ม 1 · คนและห้องเรียน

#### `users` — บัญชีผู้ใช้ (8 แถว)

```
id            = 2
username      = 'student1'
password_hash = 'scrypt:32768:8:1$rTWWE5CtZtR...'
display_name  = 'Somchai'
role          = 'USER'
avatar_url    = None                              ← ยังไม่มีรูป
created_at    = '2026-07-16 13:08:40.527226'
last_login_at = None                              ← ยังไม่เคยล็อกอิน
```

`None` แปลว่าช่องนั้นว่าง ไม่ใช่เลข 0 และไม่ใช่ข้อความว่าง

#### `classrooms` — ห้องเรียน (2 แถว)

```
id          = 1
name        = 'CS101 Programming'
teacher_id  = 3                    ← ผู้ใช้เบอร์ 3 คือครูของห้องนี้
invite_code = 'RJP63U'             ← รหัส 6 หลักที่แจกให้เด็กเข้าห้อง
created_at  = '2026-07-16 13:08:59.319810'
```

#### `class_memberships` — ใครอยู่ห้องไหน (1 แถว)

```
id           = 1
classroom_id = 2      ← ห้องเบอร์ 2
student_id   = 7      ← ผู้ใช้เบอร์ 7
joined_at    = '2026-07-16 20:07:49.415844'
```

ตารางนี้ไม่มีเนื้อหาของตัวเองเลย มีแต่ตัวเลขชี้ไปตารางอื่น หน้าที่เดียวคือ **จับคู่**

---

### กลุ่ม 2 · ผลงานและโจทย์

#### `projects` — ผลงานของเด็ก (2 แถว)

```
id             = 1
user_id        = 6                        ← ผลงานของผู้ใช้เบอร์ 6
title          = 'โปรเจกต์ของฉัน'
blockly_xml    = '<xml xmlns="..."><block type="move_backward" .../></xml>'
generated_code = ''                       ← ว่างเปล่า ดูหมายเหตุ
created_at     = '2026-07-16 19:29:29.968535'
updated_at     = '2026-07-16 19:29:29.968544'
```

⚠️ **หมายเหตุ** — ช่อง `generated_code` ที่ควรเก็บคำสั่งที่แปลงจากบล็อกแล้ว **ว่างเปล่าทั้ง 2 แถว** เพราะหน้าเว็บส่งค่าว่างมาเสมอ

#### `assignments` — โจทย์ที่ครูสั่ง (1 แถว)

```
id           = 1
classroom_id = 2
task_key     = 'seq_l_walk'
title        = '1.1 เดินเป็นตัว L'
description  = 'ให้หุ่นยนต์เดินเป็นรูปตัว L (แนวทาง: forward → forward → right → forward)'
level        = 'Sequential'
created_at   = '2026-07-16 20:09:03.478274'
```

#### `assignment_submissions` — งานที่เด็กส่ง (1 แถว)

```
id            = 1
assignment_id = 1      ← ตอบโจทย์ข้อ 1
student_id    = 7      ← ผู้ใช้เบอร์ 7 เป็นคนส่ง
project_id    = 2      ← ส่งผลงานชิ้นที่ 2
submitted_at  = '2026-07-16 20:44:18.616956'
```

ตารางกลางอีกตัว แต่ชี้ไป 3 ที่พร้อมกัน

---

### กลุ่ม 3 · ความก้าวหน้า

#### `activity_logs` — บันทึกทุกการกระทำ (98 แถว มากที่สุดในระบบ)

```
id            = 1
user_id       = 1
action_type   = 'REGISTER'
metadata_json = None                          ← กิจกรรมนี้ไม่มีรายละเอียด
created_at    = '2026-07-16 13:00:45.171762'
```

อีกแถวหนึ่งที่มีรายละเอียด

```
action_type   = 'RUN_CODE'
metadata_json = '{"command_length":32,"block_count":9}'
```

**กิจกรรมที่มีในระบบตอนนี้**

| ชื่อกิจกรรม | จำนวนแถว | มีรายละเอียดไหม |
|---|---|---|
| `RUN_CODE` | 26 | มี |
| `BLOCK_COUNT` | 26 | มี |
| `SKILL:*` รวม 6 ชนิด | 32 | ไม่มี |
| `REGISTER` | 8 | ไม่มี |
| `LOGIN` | 6 | ไม่มี |

รวม 46 จาก 98 แถว (47%) ไม่มีรายละเอียดเลย

#### `tutorial_progress` — ความคืบหน้า tutorial (8 แถว)

```
id             = 1
user_id        = 1
is_completed   = 0      ← 0 คือยังไม่จบ
skipped        = 0      ← 0 คือยังไม่กดข้าม
last_step_seen = 0
completed_at   = None
```

⚠️ ช่อง `last_step_seen` เป็น 0 ทุกแถว เพราะโค้ดไม่เคยบันทึกรายขั้น

#### `learning_objectives` — รายการทักษะ 10 ด้าน (10 แถว)

```
id          = 1
name        = 'Sequencing'
description = 'Understand that programs execute instructions in order'
category    = 'FUNDAMENTALS'
```

ตารางนี้ **ไม่ใช่ข้อมูลผู้ใช้** แต่เป็นรายการตัวเลือกที่ระบบเติมให้เองตอนเปิดเซิร์ฟเวอร์ เหมือนหน้าเมนูในร้านอาหาร

#### `student_objective_progress` — ทักษะของเด็กแต่ละคน (10 แถว)

```
id                    = 2
student_id            = 7               ← ผู้ใช้เบอร์ 7
objective_id          = 1               ← ทักษะ Sequencing
status                = 'IN_PROGRESS'   ← กำลังเรียนรู้
evidence_project_id   = None
updated_by_teacher_id = None            ← ระบบตั้งให้เอง ครูไม่ได้แก้
```

อีกแถวที่ครูแก้เอง

```
student_id            = 7
objective_id          = 10
status                = 'NOT_STARTED'
updated_by_teacher_id = 6               ← ครูเบอร์ 6 เป็นคนตั้งค่านี้
```

⚠️ ตารางนี้ **ไม่มีช่องเวลาเลย** เลยบอกไม่ได้ว่าเด็กผ่านทักษะเมื่อไหร่

---

### กลุ่ม 4 · รางวัลและคะแนน

#### `achievement_definitions` — รายการเหรียญ 8 อัน (8 แถว)

```
id              = 2
name            = 'Hello Robot'
description     = 'Run your first program'
icon            = '🤖'
condition_type  = 'PROGRAMS_RUN'
condition_value = 1                    ← กดรัน 1 ครั้งก็ได้เหรียญนี้
```

ตารางแม่แบบอีกตัว ระบบเติมให้เองเหมือน `learning_objectives`

**เงื่อนไขเหรียญทั้ง 8 อัน**

| ชื่อ | เงื่อนไข | ต้องกี่ครั้ง |
|---|---|---|
| First Steps | จบ tutorial | 1 |
| Hello Robot | กดรัน | 1 |
| Block Builder | สร้างโปรเจกต์ | 5 |
| Loop Master | ใช้บล็อก loop | 3 |
| Bug Squasher | แก้ error | 10 |
| Persistent Coder | ล็อกอินติดกัน | 7 วัน |
| AI Whisperer | ถาม AI | 20 |
| Perfect Score | ได้คะแนนเต็ม | 1 |

#### `user_achievements` — ใครได้เหรียญอะไร (8 แถว)

```
id             = 2
user_id        = 6      ← ผู้ใช้เบอร์ 6
achievement_id = 1      ← ได้เหรียญ First Steps
unlocked_at    = '2026-07-16 19:29:18.630910'
```

ตารางกลางอีกตัว

#### `grades` — คะแนนที่ครูให้ (0 แถว)

ยังไม่มีข้อมูล เพราะยังไม่มีครูให้คะแนนใครในระบบทดสอบ ช่องที่มี: `teacher_id`, `student_id`, `project_id`, `score`, `max_score`, `comment`, `created_at`

---

## สรุป — อยากรู้ว่าอะไรเก็บที่ไหน

| อยากรู้เรื่อง | ดูที่ตาราง | ช่องสำคัญ |
|---|---|---|
| เด็กคนนี้ชื่ออะไร | `users` | `display_name` |
| เด็กต่อบล็อกอะไรไว้ | `projects` | `blockly_xml` (เป็น XML) |
| เด็กกดรันไปกี่ครั้ง | `activity_logs` | นับแถวที่ `action_type='RUN_CODE'` |
| เด็กใช้บล็อกกี่ชิ้น | `activity_logs` | ต้องแกะ `metadata_json` |
| เด็กอยู่ห้องไหน | `class_memberships` | `classroom_id` |
| ใครเป็นครูของห้องนี้ | `classrooms` | `teacher_id` |
| เด็กเก่งทักษะไหนแล้ว | `student_objective_progress` | `status` |
| เด็กได้เหรียญอะไรบ้าง | `user_achievements` | `achievement_id` |
| ครูสั่งโจทย์อะไร | `assignments` | `title`, `level` |
| เด็กส่งงานหรือยัง | `assignment_submissions` | มีแถวคือส่งแล้ว |
| ครูให้คะแนนเท่าไหร่ | `grades` | `score` / `max_score` |
| รหัสผ่านของเด็ก | **ดูไม่ได้** | เก็บเป็น hash แปลงกลับไม่ได้ |
| เด็กคุยอะไรกับ AI | **ไม่ได้เก็บ** | อยู่ในหน่วยความจำ หายเมื่อรีสตาร์ต |

---

## 3 ช่องที่มีอยู่แต่ไม่เคยมีข้อมูล

ถ้าเปิดฐานข้อมูลดูแล้วเห็นช่องพวกนี้ว่างเปล่า ไม่ใช่ความผิดพลาดในการอ่าน มันว่างจริง

| ช่อง | สภาพ | สาเหตุ |
|---|---|---|
| `projects.generated_code` | ว่างทั้ง 2 แถว | หน้าเว็บส่งค่าว่างมาเสมอ |
| `tutorial_progress.last_step_seen` | เป็น 0 ทุกแถว | โค้ดไม่บันทึกรายขั้น |
| `student_objective_progress.evidence_project_id` | `None` ทุกแถว | ไม่มีโค้ดตรงไหนเขียนค่านี้เลย |
