HoneyKung/metorobot/บทพูดคุยอาจารย์_ฐานข้อมูล.md

# บทพูดอัปเดตอาจารย์ — เรื่องฐานข้อมูล

> สำหรับพูดปากเปล่า ไม่ใช่เอกสารนำเสนอ
> อาจารย์มาจากสายเว็บ ดังนั้นไม่ต้องอธิบายพื้นฐาน แต่ต้องตอบให้ตรงและไม่โม้

---

## ท่าทีที่ควรใช้

อาจารย์ให้ไปดูว่าฐานข้อมูลที่ได้จากการ vibe code มันเป็นยังไง — **คุณไปดูมาจริงแล้ว** นั่นคือคำตอบที่ดีที่สุด

ไม่ต้องปกป้อง ไม่ต้องแก้ตัวว่า AI เขียนให้ พูดตรงๆ ว่าตรวจมาแล้วเจออะไรบ้าง คนสายเว็บจะให้เครดิตคนที่รู้จุดอ่อนของงานตัวเองมากกว่าคนที่บอกว่าเสร็จแล้วเรียบร้อยดี

**ประโยคเปิดที่ใช้ได้**

> "ผมไปไล่ดูฐานข้อมูลมาแล้วครับ ทั้งโครงสร้างและข้อมูลจริงในไฟล์ สรุปสั้นๆ คือ **โครงสร้างความสัมพันธ์ออกแบบมาใช้ได้ แต่ชั้นที่ฐานข้อมูลควรบังคับความถูกต้องเองแทบไม่มีเลย** เลยไปฝากไว้กับโค้ดฝั่งแอปหมด"

ประโยคนี้เดียวจะทำให้อาจารย์รู้ทันทีว่าคุณเข้าใจสิ่งที่กำลังพูด

---

## สาระที่ต้องพูด เรียงตามลำดับ

### 1. ของที่ใช้

- Flask + SQLAlchemy เป็น ORM
- ตอน dev เป็น SQLite ไฟล์เดียว `instance/robomdt.db`
- ตอน deploy บน Render เปลี่ยนเป็น PostgreSQL สลับด้วย environment variable ตัวเดียว โค้ดไม่ต้องแก้
- Auth ใช้ JWT อายุ 7 วัน รหัสผ่าน hash ด้วย scrypt

### 2. ขนาดและขอบเขต

- 13 ตาราง
- ข้อมูลจริงตอนนี้ยังน้อยมาก ผู้ใช้ 8 บัญชี บันทึกกิจกรรม 98 แถว
- แบ่งเป็น 4 กลุ่ม: คนกับห้องเรียน / ผลงานกับโจทย์ / ความก้าวหน้า / รางวัลกับคะแนน
- ทุกตารางชี้กลับมาที่ `users`

### 3. จุดที่ออกแบบมาดี — พูดก่อน ไม่ใช่เพราะจะอวด แต่เพราะมันจริง

| เรื่อง | พูดว่า |
|---|---|
| Universal user | บทบาทครู/นักเรียนไม่ได้เก็บเป็น field แต่เกิดจากความสัมพันธ์ — อยู่ที่ `classrooms.teacher_id` คือครู อยู่ที่ `class_memberships` คือนักเรียน คนเดียวเป็นทั้งสองอย่างในคนละห้องได้ |
| การตรวจสิทธิ์ | เช็คจาก ownership จริงทุก endpoint ที่ข้ามผู้ใช้ ไม่ได้เช็คจาก field role — ไล่ดูแล้วไม่เจอ IDOR |
| Junction table | ความสัมพันธ์ many-to-many แตกออกมาครบ ไม่มีที่ไหนยัดหลายค่าลงคอลัมน์เดียว |
| กันครูถูกทับ | มี `updated_by_teacher_id` ล็อกไม่ให้ระบบ auto ทับสิ่งที่ครูตัดสินเอง |

### 4. จุดที่อ่อน — พูดเอง อย่ารอให้แกจับได้

เรียงตามที่อาจารย์สายเว็บจะสังเกตเห็นก่อน

**ไม่มี migration เลย** — ใช้ `db.create_all()` เฉยๆ ไม่มี Alembic ผลคือแก้ model แล้วตารางเดิมไม่เปลี่ยนตาม เจอหลักฐานจริงคือคอลัมน์ `icon` ในโค้ดเป็น `String(30)` แต่ในไฟล์ยังเป็น `VARCHAR(10)` และค่า `role` เก่ายังค้าง 5 แถวทั้งที่โค้ดตรึงเป็น `USER` ไปแล้ว

**ไม่มี constraint ระดับ DB เลย** — ไม่มี unique บน junction table สักตัว ไม่มี check สำหรับ enum ที่เก็บเป็น string ผลคือมีข้อมูลซ้ำเกิดขึ้นจริงแล้ว เจอเหรียญซ้ำ 2 คู่ ห่างกัน 2 มิลลิวินาที เกิดจาก race condition เพราะ frontend ยิง log สองตัวพร้อมกันแล้วแต่ละตัวไป read-then-insert

**ไม่มี index บน FK เลยสักตัว** — ทั้ง DB มี index 4 ตัว เป็น autoindex จาก unique 3 ตัว รัน `EXPLAIN QUERY PLAN` แล้ว 7 จาก 7 query เป็น full scan และมี N+1 ในหน้ารายชื่อนักเรียน ประมาณ 6 query ต่อคน

**FK ไม่ถูกบังคับ** — `PRAGMA foreign_keys = 0` และไม่มี `ON DELETE` สักเส้น ตอนนี้ยังไม่มี orphan เพราะยังไม่มีใครลบโปรเจกต์ แต่พอขึ้น Postgres จริงแล้วลบ จะ 500 ทันทีเพราะ `grades.project_id` เป็น `nullable=False`

**ปัญหาความปลอดภัย 2 ข้อที่เป็นเรื่องใหญ่**
- `static_folder='.'` ทำให้ Flask สร้าง route `/<path:filename>` ชี้เข้า root ทั้งโปรเจกต์ ผลคือ `/instance/robomdt.db` กับ `/keyAPI.env` โหลดได้จากเน็ต
- `JWT_SECRET_KEY` ไม่ได้ประกาศใน `render.yaml` เลยตกไปใช้ default ที่เขียนไว้ในโค้ด

> ⚠️ ถ้าเว็บยังออนไลน์อยู่ตอนคุย ต้องบอกอาจารย์ตรงๆ ว่ารู้แล้วและกำลังปิดอยู่ อย่าปล่อยผ่าน

### 5. สิ่งที่ทำอยู่ตอนนี้

บอกว่ากำลังแก้อยู่ 4 เรื่อง แล้วบอกว่าที่เหลือมีแผนจัดลำดับไว้แล้ว 22 ข้อ แบ่ง 4 ช่วง

**เรียงลำดับยังไง** — ช่วงแรกคือความปลอดภัยเพราะไม่ต้องแตะ DB ทำได้เลย ช่วงสองคือโครงสร้าง DB โดยต้องใส่ Alembic ก่อนเป็นอันดับแรกเพราะไม่งั้นเพิ่ม constraint หรือ index ไปก็ไม่มีผลกับตารางเดิม

---

## ถ้าอาจารย์ถามลึก

อาจารย์สายเว็บมีโอกาสถามพวกนี้สูง

**"ทำไมถึงเชื่อว่าไม่มี IDOR"**
ไล่ดูทุก endpoint ที่เข้าถึงข้อมูลข้ามผู้ใช้แล้ว มีฟังก์ชัน `_user_teaches_student` กับ `_owned_classroom_ids` เรียกครบทุกจุด แต่ยอมรับว่าถ้า JWT secret เป็น default ก็ไม่มีความหมาย เพราะปลอม token ได้ตั้งแต่ต้น

**"metadata_json ทำไมเป็น Text"**
เป็น `db.Text` ไม่ใช่ JSON type เลย query เข้าไปข้างในไม่ได้ ผลข้างเคียงคือช่อง "จำนวนบล็อก" บนหน้า dashboard ไปนับจำนวนแถว log แทนที่จะ SUM ค่าจริง ตรวจแล้วผู้ใช้คนหนึ่งหน้าเว็บโชว์ 17 แต่ค่าจริงคือ 68

**"เกณฑ์วัดทักษะคืออะไร"**
รันไม่มี error ครบ 3 ครั้ง — ยอมรับตรงๆ ว่าตัวเลข 3 hardcode อยู่ในโค้ด ไม่มีที่มาจากทฤษฎี และ "ไม่มี error" ไม่เท่ากับ "ทำโจทย์สำเร็จ" กำลังจะย้ายเป็นค่าที่ config ได้

**"ข้อมูลพอทำวิจัยไหม"**
ยังไม่พอ ไม่มีตาราง pre-test/post-test ไม่มีตัวแปรควบคุม และบทสนทนากับ AI ไม่ได้ลง DB เลย อยู่ใน dict ใน RAM หายทุกครั้งที่ restart — ข้อนี้กระทบตัวชี้วัดเรื่อง scaffolding ที่เขียนไว้ในบทที่ 3 โดยตรง

**"ข้อมูลที่มีอยู่เชื่อถือได้ไหม"**
ตรวจแล้ว `PRAGMA foreign_key_check` ว่าง ไม่มีข้อมูลขัดแย้งกันเอง ไม่มีเวลาผิดลำดับ metadata parse ผ่านหมด — **ข้อมูลสะอาดกว่าโครงสร้าง** เลยไม่ต้องล้างฐานเริ่มใหม่ แก้เฉพาะจุดได้

**"vibe code แล้วมันใช้ได้จริงเหรอ"**
คำตอบซื่อสัตย์: happy path ใช้ได้หมด แต่พังตรง edge case ที่เกิดจากไม่มี constraint — เช่น ให้คะแนนแล้วเด็กส่งงานใหม่ คะแนนจะหายจากหน้าจอ เพราะ `Grade` ผูกกับ `project_id` ไม่ได้ผูกกับ submission

---

## คำที่ต้องใช้ให้ถูก

เพื่อไม่ให้พูดผิดต่อหน้าคนที่รู้จริง

| อย่าพูดว่า | พูดว่า |
|---|---|
| "ไม่มี index" เฉยๆ | "ไม่มี index บน foreign key — มีแค่ autoindex จาก unique constraint" |
| "ข้อมูลพัง" | "มี duplicate row จาก race condition" |
| "ฐานข้อมูลไม่ปลอดภัย" | "static folder ชี้เข้า project root ทำให้ไฟล์ DB โหลดได้ผ่าน HTTP" |
| "AI เขียนให้" | "ได้มาจากการ generate แล้วผมมาไล่ตรวจเอง" |
| "จะแก้ทีหลัง" | "จัดลำดับไว้แล้ว ช่วงแรกทำได้เลยเพราะไม่แตะ schema" |

---

## สิ่งที่ไม่ควรพูด

- อย่าบอกว่าระบบพร้อมใช้งานจริง — ยังไม่พร้อม ยังไม่มี backup plan และ Render free plan ใช้ ephemeral disk
- อย่าบอกตัวเลขที่ยังไม่ได้ตรวจเอง ถ้าไม่แน่ใจให้บอกว่ายังไม่ได้ดูจุดนั้น
- อย่ารับปากว่าจะแก้ทั้งหมดภายในสัปดาห์นี้

---

## ถ้าอาจารย์ขอดูของ

มีเอกสาร 2 ไฟล์ให้ส่งต่อได้

- `แผนแก้ไขฐานข้อมูล.md` — 22 ข้อ แบ่ง 4 ช่วง ทุกข้อมี file:line กับผลตรวจจริง
- ไฟล์นี้ — บทพูด ไม่ต้องส่ง

ถ้าแกอยากเห็น ERD หรือ Data Dictionary บอกได้ ทำเพิ่มได้
