HoneyKung/metorobot/บทพูดนำเสนอ_METO_20นาที.md

# บทพูดนำเสนอความก้าวหน้าโครงงาน METO

กำหนดเวลา: นำเสนอ 20 นาที + ถาม–ตอบ 20 นาที  
ฉบับนี้วางบทหลักไว้ประมาณ **19 นาที 30 วินาที** และเหลือกันชนประมาณ 30 วินาที  
เลขหน้าด้านล่างอ้างอิง **ลำดับหน้าใน Canva ปัจจุบัน** ไม่ใช่เลขในป้ายสีม่วงบนสไลด์

## วิธีซ้อม

- อย่าอ่านทุกข้อความบนสไลด์ ให้ใช้ภาพเป็นหลักและพูดตามบทนี้
- จุดที่เขียนว่า **ถ้าเวลาเริ่มช้าให้ข้าม** สามารถตัดได้โดยเรื่องยังต่อกัน
- ควรซ้อมพร้อมกดเปลี่ยนหน้าจริงอย่างน้อย 2 รอบ เป้าหมายรอบซ้อมคือจบระหว่าง 19:00–19:30 นาที
- หน้าที่ 24–40 เป็นสไลด์สำรอง ไม่อยู่ในเวลา 20 นาที

## สรุปเวลา

| ช่วง | หน้า | เวลา |
|---|---:|---:|
| ที่มาและภาพรวมโครงงาน | 1–5 | 4:00 |
| เว็บแอปและ AI | 6–13 | 6:10 |
| หุ่นยนต์และฮาร์ดแวร์ | 14–17 | 3:50 |
| ปัญหา แผน และงานที่เหลือ | 18–20 | 3:20 |
| ทีม จริยธรรม และสรุป | 21–23 | 2:10 |
| **รวม** | **1–23** | **19:30** |

---

# บทพูดหน้าหลัก

## หน้า 1 — ปก METO

**เวลา: 0:00–0:35 (35 วินาที)**

สวัสดีครับ วันนี้กลุ่มของพวกเราจะมารายงานความก้าวหน้าโครงงาน METO หรือแพลตฟอร์มหุ่นยนต์เพื่อการศึกษาสำหรับการเขียนโค้ดแบบบล็อกครับ โครงงานนี้พัฒนาโดยฐิตารีย์ ณัฏฐณิชา และภาณุมาส ภายใต้การดูแลของอาจารย์ที่ปรึกษา ผศ. ดร. เก็จแก้ว ธเนศวร สิ่งที่เราพัฒนามีสามส่วนที่ทำงานร่วมกัน คือเว็บแอป ระบบ AI ผู้ช่วยสอน และหุ่นยนต์จริงครับ

**เชื่อมหน้า:** ก่อนดูสิ่งที่ทำเสร็จแล้ว ขอเริ่มจากวัตถุประสงค์ของโครงงานก่อนครับ

## หน้า 2 — วัตถุประสงค์ของงานวิจัย

**เวลา: 0:35–1:25 (50 วินาที)**

โครงงานมีวัตถุประสงค์หลักสี่ข้อครับ ข้อแรกคือพัฒนาหุ่นยนต์แบบโมดูลาร์ที่ควบคุมผ่าน Block Coding เพื่อให้ผู้เรียนเริ่มเขียนโปรแกรมได้โดยไม่ติดปัญหาเรื่อง syntax ข้อที่สองคือประเมิน AI ผู้ช่วยสอนที่ให้คำใบ้โดยไม่เฉลย ข้อที่สามคือศึกษาทักษะการแก้ปัญหาจากบล็อกที่ผู้เรียนต่อจริง และข้อสุดท้ายคือลดต้นทุนด้วยอุปกรณ์ทั่วไปและโครงสร้างที่พิมพ์ 3D เอง วัตถุประสงค์ทั้งสี่ข้อจึงถูกแปลงเป็นฟีเจอร์และชิ้นงานที่ตรวจสอบได้ ไม่ได้หยุดอยู่เพียงแนวคิดครับ

**เชื่อมหน้า:** เหตุผลที่เราเลือกแก้ปัญหานี้ มาจากทั้งข้อมูลระดับประเทศและปัญหาที่พบจากผู้เรียนครับ

## หน้า 3 — ปัญหาที่ต้องการแก้ไข

**เวลา: 1:25–2:25 (60 วินาที)**

ข้อมูลที่ใช้ตั้งต้นสะท้อนว่าทักษะดิจิทัลของผู้เรียนไทยยังเป็นช่องว่างสำคัญครับ แต่ในระดับการใช้งานจริง เราพบอุปสรรคสามชั้นจากการสัมภาษณ์ผู้เรียน 15 คน ได้แก่ ติด syntax แล้วไม่รู้จะแก้อย่างไร เปิดระบบมาแล้วไม่รู้จะเริ่มตรงไหน และเรียนอยู่บนจอเพียงอย่างเดียวจนขาดแรงจูงใจ ขณะเดียวกัน หุ่นยนต์เพื่อการศึกษาที่มีอยู่จำนวนมากยังมีราคาสูง เป็นกล่องปิด และมักไม่มี AI คอยช่วยเมื่อผู้เรียนติด ดังนั้นโจทย์ของ METO จึงไม่ใช่แค่สร้างหุ่น แต่คือทำให้การเริ่มเขียนโปรแกรมง่ายขึ้น มีสิ่งที่จับต้องได้ และมีผู้ช่วยที่ตอบได้ทันทีครับ

**ถ้าเวลาเริ่มช้าให้ข้าม:** ไม่ต้องอ่านตัวเลขทั้งสามค่า ให้ชี้ภาพรวมเพียงครั้งเดียว

## หน้า 4 — ผลที่คาดว่าจะได้รับ

**เวลา: 2:25–3:10 (45 วินาที)**

ผลลัพธ์ของโครงงานแบ่งเป็นสามส่วนครับ ส่วนแรกคือเว็บ Block Coding ที่มีบล็อกเฉพาะของหุ่น ระบบห้องเรียน ภารกิจ และการติดตามทักษะ ส่วนที่สองคือ AI ผู้ช่วยสอนที่อ่านงานปัจจุบันของผู้เรียน ให้คำใบ้ และเก็บบทสนทนาเพื่อใช้วิเคราะห์ ส่วนที่สามคือหุ่นยนต์โมดูลาร์ห้าชั้นที่ขับเคลื่อน ขยับแขนและหัว และแสดงอารมณ์ได้ ภาพที่เราอยากให้เกิดคือ ผู้เรียนลากบล็อกครั้งเดียว แล้วเห็นผลทั้งบนหุ่นจำลองและหุ่นจริง พร้อมถาม AI ได้จากหน้าจอเดียวครับ

## หน้า 5 — ภาพรวมของระบบ

**เวลา: 3:10–4:00 (50 วินาที)**

ระบบทำงานร่วมกันสามฝั่งครับ ฝั่งแรกคือเบราว์เซอร์ของผู้เรียน ใช้ต่อบล็อก ดูหุ่นจำลอง และถาม AI ฝั่งที่สองคือเซิร์ฟเวอร์ ทำหน้าที่จัดการบัญชี ห้องเรียน ภารกิจ ตรวจทักษะ และเก็บข้อมูลทั้งหมด ฝั่งสุดท้ายคือหุ่นยนต์ที่รับคำสั่งผ่านเครือข่าย Wi-Fi โดยใช้ ESP32 เป็นสมองกลาง กล่าวสั้น ๆ คือ ผู้เรียนสร้างคำสั่งบนเว็บ เซิร์ฟเวอร์จัดการและบันทึกข้อมูล แล้วส่งคำสั่งไปยังหุ่นจริง โดยไม่ต้องติดตั้งโปรแกรมเพิ่มครับ

**เชื่อมหน้า:** ต่อไปจะเป็นสิ่งที่พัฒนาเสร็จแล้วในฝั่งเว็บ โดยเริ่มจากแผนที่รวมของฟีเจอร์ทั้งหมดครับ

## หน้า 6 — Feature Map

**เวลา: 4:00–4:40 (40 วินาที)**

หน้านี้เป็นภาพรวมของฟีเจอร์เว็บที่ใช้งานได้แล้วครับ ครอบคลุมการเขียนโปรแกรม หุ่นจำลอง AI ผู้ช่วยสอน ทัวร์เริ่มต้น บัญชี ห้องเรียน ภารกิจ ทักษะ และแดชบอร์ด จุดสำคัญคือฟีเจอร์เหล่านี้ไม่ได้แยกกันทำงาน เช่น เมื่อผู้เรียนรันบล็อก ระบบจะสั่งหุ่น ตรวจทักษะ เก็บความคืบหน้า และส่งบริบทให้ AI ได้จากข้อมูลชุดเดียวกัน รายละเอียดถัดไปจะเลือกเฉพาะฟีเจอร์หลักมาแสดง เพื่อไม่เล่าซ้ำทุกหัวข้อครับ

**ถ้าเวลาเริ่มช้าให้ข้าม:** ไม่ต้องไล่อ่านชื่อทุกการ์ด

## หน้า 7 — หน้าทำงานหลัก

**เวลา: 4:40–5:25 (45 วินาที)**

นี่คือหน้าที่ผู้เรียนใช้มากที่สุดครับ ด้านซ้ายเป็นบล็อกเก้าหมวด ตรงกลางเป็นพื้นที่ต่อโปรแกรม มุมขวาบนเป็นหุ่นจำลอง และแถบบนใช้บันทึก เชื่อมต่อ และรันงาน ส่วนปุ่มมุมขวาล่างใช้เปิด AI ผู้ช่วยสอน การรวมทุกอย่างไว้ในหน้าเดียวช่วยให้ผู้เรียนไม่ต้องสลับหลายหน้าระหว่างเขียน ทดสอบ และขอความช่วยเหลือ ภาพตัวอย่างนี้ใช้คำสั่งจากหกหมวดพร้อมกัน แสดงว่าหน้าจอรองรับงานที่ซับซ้อนขึ้นได้จริงครับ

## หน้า 8 — ชุดบล็อกคำสั่ง

**เวลา: 5:25–6:10 (45 วินาที)**

ระบบมีบล็อกเฉพาะของหุ่น 37 บล็อกใน 9 หมวดครับ เช่น การเคลื่อนที่ แขน มือ หัว สีหน้า และการหนีบของ รวมกับบล็อกมาตรฐานอย่างลูป เงื่อนไข และตัวแปร ทุกบล็อกเฉพาะมีคำสั่งในหุ่นรองรับจริง จึงไม่มีกรณีที่ลากบล็อกแล้วไม่เกิดผล เหตุผลที่เลือก Block Coding คือช่วยตัดอุปสรรคเรื่องไวยากรณ์ เพราะบล็อกที่รูปแบบไม่เข้ากันจะต่อกันไม่ได้ตั้งแต่แรก ผู้เรียนจึงใช้สมาธิกับลำดับความคิดมากกว่าการแก้ syntax ครับ

## หน้า 9 — AI ผู้ช่วยสอน

**เวลา: 6:10–7:10 (60 วินาที)**

เมื่อผู้เรียนถาม AI ระบบไม่ได้ส่งเฉพาะข้อความคำถามครับ แต่จะอ่านผังบล็อกที่อยู่บนกระดาน แยกกลุ่มบล็อก ตรวจโครงสร้างที่ซ้อนกัน รวมภารกิจที่กำลังฝึก และดึงประวัติสนทนาล่าสุด แล้วจึงส่งบริบททั้งหมดไปยัง Gemini 2.5 Pro คำตอบที่ได้จะแสดงเป็นคำใบ้และถูกบันทึกกลับฐานข้อมูลพร้อมสภาพของบล็อกตอนที่ถาม จุดนี้สำคัญกับงานวิจัย เพราะเราสามารถย้อนดูได้ว่า ผู้เรียนติดตรงไหน ถามอะไร และหลังได้รับคำใบ้แล้วแก้งานอย่างไร ไม่ได้มีเพียงข้อความแชตที่ขาดบริบทครับ

**เชื่อมหน้า:** นอกจากช่วยตอนเขียนโปรแกรมแล้ว ระบบยังเปลี่ยนข้อมูลความคืบหน้าให้เป็นประสบการณ์แบบเกมครับ

## หน้า 10 — Player Mode

**เวลา: 7:10–7:50 (40 วินาที)**

ฝั่งผู้เรียนแสดงความคืบหน้าเป็นแผนที่เก้าด่านแทนตารางครับ ด่านที่เปิดคือทักษะที่ห้องกำลังฝึก และดาวแสดงความก้าวหน้าของผู้เรียน ในหน้าเดียวกันยังมีภารกิจ กำหนดส่ง และคะแนนที่ได้รับ เราเคยออกแบบเป็นตารางการ์ด แต่พบว่าให้ความรู้สึกเหมือนสเปรดชีตมากกว่าเกม จึงเปลี่ยนเป็นแผนที่ โดยข้อมูลเบื้องหลังยังเป็นชุดเดียวกับที่ผู้ดูแลเห็น ไม่กระทบข้อมูลที่ใช้วิจัยครับ

## หน้า 11 — มุมมองผู้ดูแลห้อง

**เวลา: 7:50–8:35 (45 วินาที)**

สำหรับผู้ดูแลห้อง หน้านี้รวมรหัสเชิญ สถิติ ภารกิจ และรายชื่อสมาชิกไว้ด้วยกันครับ ผู้ดูแลกำหนดวันหมดอายุของรหัสเชิญ ปิดรับสมาชิก ดูความคืบหน้ารายคน และจัดห้องตามเทอมกับปีการศึกษาได้ การเก็บห้องเดิมไว้ถาวรทำให้ข้อมูลแต่ละรุ่นไม่ปะปนกัน และสมาชิกที่ออกจากห้องก็ไม่ถูกลบจนทำให้งานเก่าสูญหายครับ

## หน้า 12 — ภารกิจ การส่งงาน และการตรวจ

**เวลา: 8:35–9:20 (45 วินาที)**

ระบบภารกิจครอบคลุมทั้งสองฝั่งครับ ผู้ดูแลสร้างโจทย์ กำหนดส่ง ตั้งเป้าบล็อก ให้คะแนน และกำหนดทักษะที่ต้องการให้ AI ช่วยเน้นได้ ส่วนผู้เรียนเห็นงานค้างและส่งโปรเจกต์ปัจจุบันได้ทันที ระบบเก็บทุกครั้งที่ส่งและทุกเวอร์ชันที่บันทึก จึงดูพัฒนาการย้อนหลังหรือกู้เวอร์ชันเดิมได้ จุดนี้ทำให้ฟีเจอร์ภารกิจไม่ได้เป็นเพียงรายการงาน แต่เป็นหลักฐานการเรียนรู้ที่นำไปวิเคราะห์ต่อได้ครับ

## หน้า 13 — ทักษะ ดาว และโปรไฟล์

**เวลา: 9:20–10:10 (50 วินาที)**

ระบบติดตามทักษะทั้งหมดสิบด้านครับ ตั้งแต่การเรียงคำสั่ง ลูป เงื่อนไข ตัวแปร การควบคุมหุ่น ไปจนถึงการแก้บั๊ก เก้าด้านแรกตรวจจากผังบล็อกจริงที่เซิร์ฟเวอร์ ส่วนการย่อยงานใหญ่เป็นงานเล็กให้ผู้ดูแลประเมิน เพราะยังไม่มีบล็อกที่ใช้เป็นหลักฐานโดยตรง การตรวจฝั่งเซิร์ฟเวอร์ช่วยลดการแจ้งผลเท็จจากหน้าเว็บ และทำให้ข้อมูลน่าเชื่อถือขึ้น ดาว เหรียญ และหน้าหุ่นที่ปลดล็อกได้จึงทำหน้าที่ทั้งสร้างแรงจูงใจและบันทึกความก้าวหน้าครับ

**เชื่อมหน้า:** จากฝั่งเว็บ ต่อไปเป็นความก้าวหน้าของตัวหุ่นยนต์จริงครับ

## หน้า 14 — ตัวต้นแบบที่ 1 และโปรแกรมในตัวหุ่น

**เวลา: 10:10–11:20 (70 วินาที)**

ตัวต้นแบบที่หนึ่งสร้างเสร็จและใช้พิสูจน์เส้นทางจากเว็บไปยังหุ่นจริงแล้วครับ สามารถเดินหน้า ถอยหลัง เลี้ยว ขยับแขนและมือ หันคอ แสดงสีหน้า รับภาพจากกล้อง และใช้เซนเซอร์หยุดก่อนตกโต๊ะได้ โปรแกรมในตัวหุ่นมี 74 ฟังก์ชัน และรับคำสั่งตรงจากบล็อกบนเว็บ ส่วนที่ยังเหลือคือเซนเซอร์สัมผัสหัว คอก้ม–เงย และเซนเซอร์เลเซอร์วัดระยะ

อย่างไรก็ตาม ตัวนี้ยังไม่ตอบวัตถุประสงค์เรื่องโมดูลาร์ เพราะถอดเป็นชั้นไม่ได้ สายไฟยังเดินลอย ไม่มีแบตในตัว และยังเป็นล้อธรรมดา เราจึงใช้ต้นแบบนี้ยืนยันว่าระบบควบคุมทำงานได้ แล้วนำข้อจำกัดไปออกแบบหุ่นตัวสมบูรณ์ครับ

## หน้า 15 — ดีไซน์หน้าหุ่น 11 แบบ

**เวลา: 11:20–12:00 (40 วินาที)**

หน้าหุ่นทั้งหมด 11 แบบออกแบบเสร็จแล้วครับ ครอบคลุมสีหน้าปกติ ยิ้ม เศร้า โมโห ตกใจ ง่วง งง รัก เขิน และการเหลือบมองสองทิศ จุดสำคัญคือไม่ได้ใช้ภาพสำเร็จรูป แต่ใช้โค้ดวาดรูปทรงบนจอ ทำให้หุ่นจำลองบนเว็บและจอบนหุ่นจริงแสดงผลจากแบบเดียวกัน เมื่อผู้เรียนเลือกบล็อกสีหน้า สิ่งที่เห็นบนเว็บจึงตรงกับสิ่งที่หุ่นจริงแสดงครับ

## หน้า 16 — การออกแบบชิ้นส่วน 3D

**เวลา: 12:00–12:40 (40 วินาที)**

หุ่นตัวสมบูรณ์ออกแบบใน Tinkercad ครบ 14 ชิ้นแล้วครับ โครงสร้างแบ่งเป็นห้าชั้นเพื่อให้เห็นอุปกรณ์ภายใน ถอดซ่อมและประกอบได้ และจัดของหนักไว้ด้านล่าง ภาพนี้แสดงทั้งโครงที่ประกอบรวม มุมมองแยกชั้น และชิ้นงานที่พิมพ์จริง ขณะนี้อยู่ระหว่างทยอยพิมพ์และประกอบ โดยจะทดสอบขนาดและระบบไฟทีละชั้นก่อนปิดโครงครับ

## หน้า 17 — แผนภาพการเชื่อมต่อและโครง 5 ชั้น

**เวลา: 12:40–14:00 (80 วินาที)**

ระบบไฟเริ่มจากแบตเตอรี่ 18650 สองก้อนต่อแบบ 2S ผ่าน BMS สวิตช์ และฟิวส์ ก่อนเข้ารางไฟหลักครับ จากรางหลักแยกเป็นสามทาง ทางแรกเข้าบอร์ดขับมอเตอร์ TB6612 ทางที่สองผ่าน LM2596 เพื่อจ่ายไฟให้วงจรควบคุม และทางที่สามผ่าน UBEC 2S 10 แอมป์เข้าบอร์ด PCA9685 เพื่อเลี้ยงเซอร์โวหกตัว เราแยกไฟเซอร์โวออกจากบอร์ดหลักเพราะเซอร์โวดึงกระแสสูง และรวมกราวด์ที่ขั้ว P ลบของ BMS เพียงจุดเดียวเพื่อลดปัญหาสัญญาณรบกวน

ด้านขวาคือการแบ่งอุปกรณ์ตามโครงห้าชั้น ชั้นล่างเป็นแบต มอเตอร์ และ BMS ชั้นสองเป็นระบบแปลงไฟ ชั้นสามเป็น ESP32 และจุดรวมสาย ชั้นสี่เป็นแขน คอ และบอร์ดคุมเซอร์โว ส่วนชั้นบนสุดเป็นจอ กล้อง และเซนเซอร์สัมผัสหัวครับ

## หน้า 18 — ปัญหาที่พบและวิธีรับมือ

**เวลา: 14:00–15:00 (60 วินาที)**

ปัญหาที่พบแบ่งเป็นระบบไฟ การต่อสาย และการพิมพ์ 3D ครับ จากทั้งหมดเก้าประเด็น แก้จบแล้วสามข้อ รู้แนวทางแก้แล้วสองข้อ กำลังลงมือสามข้อ และเฝ้าระวังหนึ่งข้อ ปัญหาหลักที่ยังบล็อกงานคือไฟจากแบตยังไม่เข้าบอร์ด และกระแสไม่พอเมื่อยกแขน แนวทางที่กำลังทำคือแยกไฟสองราง ใช้ UBEC ที่จ่ายได้ 10 แอมป์ เพิ่มฟิวส์ และเปลี่ยนจุดต่อสายกำลังเป็นขั้วแบบขันน็อต เมื่อระบบไฟผ่าน การประกอบและทดสอบส่วนอื่นจะเดินต่อได้ทันทีครับ

**ถ้าเวลาเริ่มช้าให้ข้าม:** ไม่ต้องอ่านปัญหาย่อยครบทุกข้อ ให้พูดเฉพาะตัวบล็อกงานและแนวทางแก้

## หน้า 19 — แผนการดำเนินงานและความคืบหน้า

**เวลา: 15:00–16:10 (70 วินาที)**

ตามแผน งานออกแบบฮาร์ดแวร์ เว็บแอป AI และระบบห้องเรียนเสร็จแล้วครับ งานที่กำลังทำคือโปรแกรมส่วนเซนเซอร์ การพิมพ์โครง และการประกอบหุ่น ส่วนการทดลองกับผู้ใช้และการวิเคราะห์บทที่ 4–5 จะเริ่มหลังหุ่นตัวจริงพร้อม

ณ วันที่ในรายงาน ฝั่งเว็บรวม AI อยู่ประมาณ 95 เปอร์เซ็นต์ ฝั่งหุ่นประมาณ 60 เปอร์เซ็นต์ และภาพรวมทั้งโครงงานประมาณ 80 เปอร์เซ็นต์ จึงผ่านหมุด 60 เปอร์เซ็นต์ที่วางไว้แล้ว เหตุผลที่ประเมินว่ายังเสร็จทันคือ งานค้างหลักกระจุกอยู่ที่ระบบไฟ ไม่ใช่การออกแบบระบบใหม่ อุปกรณ์มีครบ และเส้นทางเว็บถึงหุ่นผ่านการทดสอบกับต้นแบบแล้วครับ

## หน้า 20 — งานที่กำลังทำและงานที่เหลือ

**เวลา: 16:10–17:20 (70 วินาที)**

ลำดับงานต่อจากนี้เริ่มจากแก้ระบบไฟ เพราะเป็นตัวปลดล็อกทุกขั้นครับ จากนั้นพิมพ์ชิ้นส่วนที่เหลือ ประกอบโครงทีละชั้น ต่อเซนเซอร์และคอก้ม–เงย ประกอบสายพาน แล้วทดสอบเว็บกับหุ่นจริงแบบครบวงจร เมื่อระบบนิ่งจึงจะเริ่มทดลองกับผู้ใช้จริง 15 คน และนำข้อมูลไปวิเคราะห์บทที่ 4–5

ความเสี่ยงหลักมีทั้งการหาตัวแปลงไฟไม่ทัน ชิ้นพิมพ์คลาดเคลื่อน และสายพานหลุด ซึ่งเตรียมทางสำรองไว้แล้ว เช่น ใช้แหล่งจ่ายไฟภายนอกชั่วคราว ทดสอบค่าเผื่อจากชิ้นเล็ก และพิมพ์ข้อสายพานสำรอง สิ่งที่ทำให้มั่นใจคืออุปกรณ์ครบ โปรแกรมเกือบครบ และงานก้อนใหญ่ฝั่งเว็บเสร็จแล้วครับ

## หน้า 21 — การบริหารจัดการทีม

**เวลา: 17:20–18:10 (50 วินาที)**

ทีมแบ่งงานตามความถนัดครับ ณัฏฐณิชาดูแลเว็บ โปรแกรมในหุ่น และวงจร ฐิตารีย์ดูแลโครงสร้าง 3D เอกสารวิจัย และสนับสนุนระบบกล้อง อารมณ์ และ AI ส่วนภาณุมาสดูแลเครื่องมือวิจัย การทดสอบ วิเคราะห์ผล และรายงาน ทีมใช้ไฟล์กลาง ผังวงจรฉบับเดียว และบันทึกการเปลี่ยนแปลง เพื่อป้องกันแต่ละคนทำงานจากข้อมูลคนละเวอร์ชัน พร้อมนัดรวมสถานะทุกสัปดาห์เพื่อตรวจจุดเชื่อมระหว่างงานครับ

**ถ้าเวลาเริ่มช้าให้ข้าม:** รายชื่อเครื่องมือทั้งหมดบนสไลด์

## หน้า 22 — จริยธรรมการวิจัยในมนุษย์

**เวลา: 18:10–19:10 (60 วินาที)**

ก่อนเริ่มเก็บข้อมูลจริง ผู้จัดทำทั้งสามคนผ่านการอบรมจริยธรรมการวิจัยในมนุษย์ของ มจธ. แล้วครับ ส่วนแบบยื่นโครงการอยู่ระหว่างจัดทำและจะต้องได้รับการดำเนินการให้เรียบร้อยก่อนทดลองกับผู้ใช้จริง

แผนการทดลองตามบทที่ 4 หัวข้อ 4.6 แบ่งเป็นสองกลุ่ม กลุ่มควบคุมใช้หุ่นจริงที่ไม่แสดงอารมณ์ และกลุ่มทดลองใช้หุ่นจริงที่แสดงอารมณ์ ทั้งสองกลุ่มใช้เว็บ Block Coding และ AI ชุดเดียวกัน ต่างกันเฉพาะการแสดงอารมณ์ ข้อมูลที่จะเปรียบเทียบมีสามส่วน คือข้อมูลทั่วไป คะแนนความเข้าใจก่อนและหลังเรียน และผลด้านทัศนคติ ความมั่นใจ และการรับรู้ปฏิสัมพันธ์กับหุ่นยนต์ ปัจจุบันยังไม่ได้เก็บข้อมูลกับผู้ใช้จริง การทดสอบที่ผ่านมาเป็นการทดสอบโดยผู้จัดทำเท่านั้นครับ

## หน้า 23 — สรุปและ Q&A

**เวลา: 19:10–19:30 (20 วินาที)**

สรุปความก้าวหน้าปัจจุบัน เว็บแอปรวม AI อยู่ประมาณ 95 เปอร์เซ็นต์ หุ่นยนต์ประมาณ 60 เปอร์เซ็นต์ และภาพรวมประมาณ 80 เปอร์เซ็นต์ครับ งานหลักที่กำลังเร่งคือระบบไฟและการประกอบหุ่นตัวสมบูรณ์ ขอบคุณครับ ต่อไปยินดีรับคำถามครับ

---

# หน้าสำรองสำหรับช่วงถาม–ตอบ

หน้าต่อไปนี้ **ไม่ต้องพูดต่อจากหน้าจบ** ให้เปิดเฉพาะเมื่อคำถามตรงกับหัวข้อนั้น

## หน้า 24 — Backup Index

**ใช้เมื่อ:** ต้องการเลือกสไลด์ตอบคำถาม

บทพูด: หน้านี้เป็นสารบัญสไลด์สำรองครับ หากต้องการรายละเอียดด้านเว็บ AI โครงสร้าง หรือฮาร์ดแวร์ ผมจะเปิดหน้าที่เกี่ยวข้องโดยตรง

## หน้า 25 — หน้าเลือกแดชบอร์ด 3 มุมมอง

**คำตอบสั้น:** ระบบไม่มีปุ่มสลับบทบาทแบบรวมทั้งเว็บครับ หน้าที่เห็นขึ้นกับความสัมพันธ์กับห้อง หากเป็นสมาชิกจะเห็นโหมดผู้เรียน หากเป็นเจ้าของจะเห็นมุมมองผู้ดูแล และทุกคนมีหน้าโปรไฟล์ของตัวเองเสมอ

## หน้า 26 — โครงสร้างห้าชั้น

**คำตอบสั้น:** หลักการแบ่งชั้นคือของหนักอยู่ล่าง ระบบไฟแยกจากวงจรควบคุม และส่วนที่ต้องปรับบ่อยต้องเปิดซ่อมได้ครับ จึงวางแบตกับมอเตอร์ชั้นล่าง ระบบแปลงไฟชั้นสอง สมองชั้นสาม แขนและคอชั้นสี่ และจอ กล้อง กับเซนเซอร์ไว้ชั้นบนสุด

## หน้า 27 — งานที่ทำเสร็จแล้ว

**คำตอบสั้น:** งานที่ใช้งานได้จริงแล้วครอบคลุมเว็บ Block Coding ระบบห้องเรียนและทักษะ AI ผู้ช่วยสอน ต้นแบบหุ่น โปรแกรม 74 ฟังก์ชัน และแบบโครง 3D ครบครับ ส่วนที่ยังไม่เสร็จคือการประกอบหุ่นตัวสมบูรณ์และการทดลองกับผู้ใช้จริง

## หน้า 28 — โปรแกรมในตัวหุ่น

**คำตอบสั้น:** โปรแกรมรองรับการเคลื่อนที่ เซอร์โวหกช่อง การหนีบ สัญลักษณ์สีหน้า 11 แบบ การเคลื่อนไหวแบบนุ่มนวล รับคำสั่งจากเว็บ และเครื่องมือตรวจวงจรครับ เหลือเซนเซอร์สัมผัสหัว คอก้ม–เงย และเซนเซอร์เลเซอร์ ซึ่งรอระบบไฟพร้อมเพื่อปรับค่ากับของจริง

## หน้า 29 — ชิ้นส่วน 14 ชิ้น

**คำตอบสั้น:** ชิ้นส่วนภายในออกแบบครบ 14 ชิ้นใน Tinkercad และมีไฟล์พร้อมพิมพ์ครับ ตอนนี้ทยอยพิมพ์และประกอบตามลำดับชั้น โดยชิ้นแขนในภาพหนึ่งชิ้นยังเป็นแบบจากต้นแบบและจะปรับให้เข้ากับโครงตัวสมบูรณ์

## หน้า 30 — หุ่นจำลองสองจอ

**คำตอบสั้น:** จอแรกแสดงตำแหน่ง ทิศทาง และรอยทางเดินจากมุมบน ส่วนจอที่สองจำลองหน้าจอของหุ่นจริงครับ เมื่อพบหุ่นในเครือข่าย ระบบจะเชื่อมต่อหุ่นจริง แต่ถ้าไม่พบก็จำลองต่อได้โดยผู้เรียนไม่ต้องตั้งค่าใหม่

## หน้า 31 — ทัวร์สอนใช้งานครั้งแรก

**คำตอบสั้น:** ทัวร์มีห้าขั้น โดยสองขั้นบังคับให้ผู้เรียนกดและลากบล็อกจริงครับ เพราะแบบเดิมที่ให้อ่านอย่างเดียวทำให้ผู้เรียนกดผ่านโดยยังใช้งานไม่เป็น ระบบจึงตรวจการลงมือทำก่อนเปิดปุ่มถัดไป

## หน้า 32 — ขอบเขตงานสี่ส่วน

**คำตอบสั้น:** ขอบเขตมีหน้าจอผู้เรียน หลังบ้าน AI และตัวหุ่นครับ สามส่วนแรกเสร็จแล้ว ส่วนหุ่นอยู่ระหว่างแก้ระบบไฟ พิมพ์ และประกอบ จึงเป็นเหตุผลที่ความก้าวหน้าฝั่งเว็บสูงกว่าฝั่งฮาร์ดแวร์

## หน้า 33 — กฎการตอบของ AI

**คำตอบสั้น:** AI ถูกกำหนดให้ตอบสั้น ให้คำใบ้ ไม่เฉลย เรียกชื่อบล็อกตามหน้าเว็บ และตรวจข้อผิดพลาดแปดแบบก่อนตอบครับ ถ้ายังมีบล็อกลอยหรือโครงสร้างไม่ครบ ระบบจะชี้จุดนั้นก่อน ไม่ชมทั้งที่โปรแกรมยังทำงานไม่ได้

## หน้า 34 — Account Model

**คำตอบสั้น:** ทุกคนใช้บัญชีประเภทเดียวกันครับ บทบาทเกิดจากความสัมพันธ์กับแต่ละห้อง คนเดียวจึงเป็นเจ้าของห้องหนึ่งและเป็นสมาชิกอีกห้องได้พร้อมกัน แบบนี้ยืดหยุ่นกว่าการล็อกบัญชีเป็นครูหรือนักเรียนตั้งแต่สมัคร

## หน้า 35 — หลังบ้านเก็บข้อมูลอะไร

**คำตอบสั้น:** หลังบ้านเก็บบัญชี ห้องเรียน โปรเจกต์และเวอร์ชัน ภารกิจ ดาวและเหรียญ บทสนทนากับ AI พร้อมผังบล็อก และร่องรอยการใช้งานครับ ทำให้กลับมาทำงานต่อได้ ผู้ดูแลเห็นความคืบหน้า และทีมส่งออกข้อมูลไปวิเคราะห์ได้

## หน้า 36 — ชั้น 1–2

**คำตอบสั้น:** ชั้นหนึ่งรับน้ำหนักและรวมแบต มอเตอร์ กับชุดขับเคลื่อน ส่วนชั้นสองเป็นระบบแปลงไฟ สวิตช์ และฟิวส์ครับ การวางของหนักไว้ต่ำช่วยให้หุ่นไม่ล้ม และการแยกตัวแปลงไฟช่วยจัดการความร้อนและซ่อมได้ง่าย

## หน้า 37 — ชั้น 3–4

**คำตอบสั้น:** ชั้นสามเป็น ESP32 บอร์ดขยาย และทางเดินสายสัญญาณ ส่วนชั้นสี่เป็นเซอร์โวแขน คอ และบอร์ด PCA9685 ครับ เราแยกสายมอเตอร์ออกจากสายจอและสัญญาณ และวางบอร์ดคุมเซอร์โวใกล้เซอร์โวเพื่อลดความยาวสาย

## หน้า 38 — ชั้น 5

**คำตอบสั้น:** ชั้นบนสุดมีจอ กล้อง เซนเซอร์สัมผัส และเซอร์โวก้ม–เงยครับ ชั้นนี้ต้องเบาและคอสั้นเพื่อลดภาระเซอร์โว พร้อมเผื่อสายให้หัวหมุนได้โดยไม่ถูกดึงหรือหนีบ

## หน้า 39 — ระบบขับเคลื่อน

**คำตอบสั้น:** ระบบใช้ล้อขับที่ต่อกับมอเตอร์ ล้อตามที่ช่วยรับน้ำหนัก และข้อสายพานที่พิมพ์ต่อกันครับ มีจุดปรับความตึง เพราะสายพานที่ตึงเกินไปจะฝืด ส่วนที่หย่อนเกินไปจะหลุด

## หน้า 40 — ภาพฟีเจอร์เว็บอื่น ๆ

**คำตอบสั้น:** หน้านี้รวมหลักฐานของฟีเจอร์ที่ไม่ได้ใส่ในเส้นทางหลัก เช่น ตัวสร้างภารกิจ การสร้างห้อง รายชื่อสมาชิก ตารางทักษะ การเลือกภารกิจ และหน้าโปรไฟล์ครับ ฟีเจอร์เหล่านี้มีในระบบจริง แต่ย้ายออกจากบทหลักเพื่อควบคุมเวลา 20 นาที

---

# จุดตรวจเวลาก่อนขึ้นจริง

- เปลี่ยนไปหน้า 6 ควรอยู่ที่ประมาณ **4:00 นาที**
- เปลี่ยนไปหน้า 14 ควรอยู่ที่ประมาณ **10:10 นาที**
- เปลี่ยนไปหน้า 18 ควรอยู่ที่ประมาณ **14:00 นาที**
- เปลี่ยนไปหน้า 21 ควรอยู่ที่ประมาณ **17:20 นาที**
- ถึงหน้า Q&A ควรอยู่ที่ประมาณ **19:30 นาที**

ถ้าช้ากว่าเป้าหมายเกิน 45 วินาที ให้ย่อหน้า 18 เหลือเฉพาะปัญหาระบบไฟ ย่อหน้า 20 เหลือเฉพาะลำดับ 1–3 และไม่อ่านรายชื่อเครื่องมือในหน้า 21
