HoneyKung/metorobot/สรุปสถานการณ์ทั้งหมด_ไว้ปรึกษา_2026-11-05.md

# สรุปสถานการณ์ทั้งหมด (ไว้เอาไปปรึกษาคนอื่น)
รวบรวมวันที่ 5 พ.ย. 2569 จากบันทึกการคุย ภาพแชทที่เจ้าของส่งมา และไฟล์งานในโฟลเดอร์ METTO
ข้อความในเครื่องหมายคำพูดคือคำพูดของเจ้าของคำต่อคำ

---

## 1. ตัวงานและคนที่เกี่ยวข้อง
- **โครงงาน:** แพลตฟอร์มหุ่นยนต์นวัตกรรมเพื่อการศึกษาสำหรับการเขียนโค้ดแบบบล็อก (หุ่น METO) เป็นธีสิส ป.ตรี สาขา MDT เอก DMT คณะสถาปัตยกรรมศาสตร์และการออกแบบ มจธ.
- **กลุ่ม Someday มี 3 คน:** ณัฏฐณิชา (เจ้าของ เป็นหัวหน้าโครงการ) · ฐิตารีย์ · ภาณุมาส
- **อาจารย์ที่ปรึกษา:** ผศ.ดร.เก็จแก้ว ธเนศวร
- **หุ่นเป็นงานธีสิสที่ทำร่วมกับอาจารย์** และเจ้าของได้รับเงินเดือนจากอาจารย์ด้วย
- **แบ่งหน้าที่:** เจ้าของรับฝั่งหุ่นยนต์ (ออกแบบ ฮาร์ดแวร์ โค้ด) แต่สุดท้ายต้องทำ IRB และแก้รายงานแทนเพื่อนด้วย

## 2. ไทม์ไลน์
| วันที่ | เหตุการณ์ |
|---|---|
| 22 พ.ค. 2569 | สอบผ่านเค้าโครง |
| 8 ก.ค. | ออกบันทึกข้อความสอบผ่านหัวข้อ |
| 19–28 ส.ค. | MDT371 ความก้าวหน้าครั้งที่ 5 ส่งแล้ว แต่ขึ้นว่าส่งช้า (Late Submitted) |
| 28 ส.ค. | หุ่นตัวสำเร็จติดปัญหาไฟ (ต่อแบตแล้ววงจรไม่ทำงาน) |
| 30 ส.ค. | อาจารย์เซ็น IRB02 ฉบับแรก |
| 15–25 ก.ย. | **MDT470 ความก้าวหน้าครั้งที่ 1 ยังไม่ได้ส่ง (Not Submitted)** |
| 22 ก.ย. | เจ้าของส่งรายการแก้คลิปให้กลุ่ม พร้อมกำหนดส่งวันที่ 24 |
| 30 ก.ย. | ตกลงดีไซน์วิจัย: ผู้เรียน 16 คน สุ่มแบ่ง 8/8 และครู 8 คน |
| 26 ก.ย.–9 ต.ค. | **ความก้าวหน้าครั้งที่ 2 ยังไม่ได้ส่ง** |
| 10–30 ต.ค. | **ความก้าวหน้าครั้งที่ 3 ยังไม่ได้ส่ง** |
| 20 ต.ค. | ในกลุ่มแจ้งว่าต้องเก็บข้อมูลให้ครบภายใน 20 พ.ย. เพราะต้องส่งครบ 5 บทสิ้นเดือน พ.ย. (สอบโปรเจกต์ 16–18 ธ.ค.) |
| 20–21 ต.ค. | เจ้าของแก้ชุด IRB ทั้งชุดเอง แล้วส่งสรุปพร้อมรายการงานฝากเพื่อน 5 ข้อแบบละเอียด |
| 21 ต.ค. | อาจารย์ให้เปลี่ยนกลุ่มตัวอย่างเป็นนักศึกษาปี 1 มจธ. |
| 1 พ.ย. | หุ่นตัวสำเร็จวิ่งด้วยแบตแบบไร้สายได้แล้ว |
| 1 พ.ย.–10 ธ.ค. | ช่วงเก็บข้อมูลตามที่เขียนไว้ใน IRB |
| 2–13 พ.ย. | ความก้าวหน้าครั้งที่ 4 ยังไม่เลยกำหนด แต่ยังไม่ได้สร้างกลุ่มในระบบ |
| 4 พ.ย. | อาจารย์ทักเรื่องไม่นัดคุยตามตาราง และบอกว่าจะให้ F เจ้าของขอโทษและขอเลื่อนนัดเป็นวันเสาร์ |
| 5 พ.ย. | นามิส่ง IRB แล้ว |
| **6 พ.ย. (ศุกร์)** | กำหนดส่งหุ่น: เดิน ยกของ ขยับแขน หันหัว 2 แกน รู้ว่ายก/ปล่อยของแล้ว กันตก และกล้อง · แขนกับหัวต้องสวยและปิดครบ |

## 3. "ความก้าวหน้า" ที่ค้างคืออะไร
- เจ้าของอธิบายว่า: "มันคือการไปคุยกันแล้วให้อาจารเซ้น"
- ค้างทั้ง 3 รอบของ MDT470 (กำหนด 25 ก.ย., 9 ต.ค., 30 ต.ค.) ปุ่มในระบบยังขึ้นว่า Submit
- เจ้าของบอกว่า: "ันแทบไม่รุ้เลยว่า มีอัปเดตต่อจากวันสอปนั้น และฉํนไม่ได้เข้ามาเช็คเลย"
- และบอกว่า: "ฉันคิดว่าฉันตาม irb ตลอดแต่ไม่ได้ตามดูเซนรับรองเลย"
- อาจารย์พิมพ์มาสั้น ๆ ให้ "ใส่ใจบ้าง" เจ้าของบอกว่า: "มันเจ็บมากนะ อาจารพิมมาเพียงไม่กี่ประโยค"
- อาจารย์รู้ความคืบหน้าของหุ่นอยู่แล้ว: "คืออาจารย์รู้ตอนมันเดินได้หมดแล้ว รู้ตอนมันเดินแบบไร้สาย ตอนนี้มันเหลือแค่ประกอบร่างจริงให้เสร็จแต่มันควรเสร็จนานแล้ว"

## 4. ปัญหาในกลุ่ม
- เจ้าของแบ่งงานเป็นข้อ ๆ ทุกครั้ง พอเห็นว่าไม่มีใครทำ ก็เริ่มใส่กำหนดส่ง:
  "แบ่งแล้วเพื่อนก้ไม่ทำ ฉํนส่งงานแต่ละครั้ง แต่ก่อนไม่กำหนดเดตไลน แต่เห็นไม่ทำฉํนก็กำหนดเดะไล แล้วก็เพื่อนคนนั้นก้ไม่ทำ ฉํนเขียนละเอียมาก"
- **ตัวอย่าง 22 ก.ย. (คลิป):** สั่งให้เพิ่มภาพเคลื่อนไหว ภาพสมาชิกท้ายคลิป ตรวจข้อกำหนดเว็บสมัครแข่ง และส่วนแนะนำสมาชิกว่าใครทำอะไร "ปกติพิชเดคต้องขายโปรเจคและขายความสามารถคนทำ" กำหนดส่งวันที่ 24
- **ตัวอย่าง 21 ต.ค. (IRB):** สรุปว่าเปลี่ยนอะไร 7 ข้อ และไฟล์ที่ต้องตรวจ 8 ไฟล์ พร้อมฝากงานเพื่อน 5 ข้อ
  1. ขอบันทึกสอบผ่านหัวข้อ (เอกสารลำดับที่ 8)
  2. รวมใบอบรมจริยธรรม 3 คนและของอาจารย์
  3. ลบติ๊กที่ผิดช่องในข้อ 15
  4. ทุกคนเปิดไฟล์แล้ว Accept
  5. คำถามที่ต้องถามอาจารย์ตอนเซ็น 4 ข้อ
- คำพูดเจ้าของ:
  - "แย่มากๆจัง ทั้งเรื่องเพื่อนในกลุ่ม และฉันต้องมาเป็นคนแบกรับอีก คนเดียวที่ตามงานคนเดียวที่ตอบข้อความ"
  - "ส่งไปก็ไม่มีใครทำอะไร irb ฉันก็ต้องรับมาทำเอง ดีเพรสจนไม่อยากทำอะไรแล้ว"
  - "ฉันไม่ร้จะแก้ยังไงแล้ว ฉันไม่ใช่คนที่สโคปงานไม่ดีเลยนะ"
- สิ่งที่เจ้าของกลัว:
  - "ฉันเกลียดการเป็นคนที่โดนมองว่าแย่ แต่ฉันก็ไม่อยากบอกความจริงปัญหาในกลุ่ม แล้วมันก็จะย้อนกลับมาคำถามว่า ทำไมฉันไม่จัดการเองล่ะ ในเมื่อคนอื่นไม่ทำ ทำไมเราไม่ทำ"
  - "แต่ว่ามันคือหน้าที่อาจารจริงหรอื มันไม่ใช่ฉํนต้องจัดการคนของ)ํนหรือ"
  - "ยิ่งตอนนี้อาจารไม่น่าจะชอบพวกเราการบอกไปมีแต่ทำให้มันยแ่ลง"

## 5. เจ้าของทำอะไรไปบ้างหลังสอบเค้าโครง
ตามที่เจ้าของเล่า:
- "หลังจากสอบล่าสุด ฉํนทำแค่ แก้รายงานแทนเพื่อน ทำ irb แทนเพื่อน ออกแบบหุ่นยน คิดไอเดียว่าแก้ล้อเตะขาบเป็นอะไร กับ จะทำหุ่นนแบบถอดประกอบที่แน่นกว่านี้ได้ยังไง แล้วพึ่งมาตกผลึกแนวคิดได้ไม่นานก็ตอน15 วันก่อน"
- ก่อนหน้านั้นมีงานอื่นด้วย: "ทำmv animationเพลงให้พ่อ ทำโปรเจคส่วนตัว ทำพอร์ตสมัครงาน ทำเรซูเม่ ทำงานหาเงิน อ่านนิยาย"
- เจ้าของสงสัยตัวเองว่า: "มันคือฉันเองที่จัดการงานไม่ได้หรือเปล่า"

ผลงานด้านหุ่นที่มีหลักฐาน:
- **หุ่นตัวที่ 1 (โปรโตไทป์):** ทำงานครบ ทั้งเดิน แขน มือ หัวหันตามหน้าคนด้วยกล้อง จอแสดงอารมณ์ กันตก และสั่งจากเว็บ มีคลิปสาธิต
- **หุ่นตัวสำเร็จ:** แก้ปัญหาไฟจนวิ่งด้วยแบตไร้สายได้แล้ว (1 พ.ย.) เปลี่ยนจากตีนตะขาบเป็นล้อ 2 ข้างกับลูกล้อ
- **ช่วง 1–5 พ.ย.:** ออกแบบโครงใหม่ทั้งตัว ได้แก่ ตัว 4 ชั้น คอ หัวที่หันได้ 2 แกน และแขนกับมือหนีบ ทดลองพิมพ์ชิ้นทดสอบหลายรอบ ตอนนี้ไฟล์พร้อมพิมพ์เกือบครบทั้งตัวแล้ว

## 6. เรื่องส่วนตัวที่กดทับอยู่
- ไม่มีหอ อาศัยบ้านญาติ เดินทางวันละ 3 ชั่วโมง ค่าเดินทางวันละ 200 บาท หาเงินเอง
- กู้ กยศ. แล้วก็ยังไม่พอ ต้องขอแม่ และใช้เงินตัวเองจ่ายค่าของโปรเจกต์ไปก่อน ยังไม่ได้ส่งยอดรวมไปเบิกกับอาจารย์
- นอนน้อยมาหลายคืนติดกันเพื่อทำหุ่นให้ทันวันศุกร์
- คำพูดเจ้าของ:
  - "จนอยากดรอปเรียนหรือลาออกจากการเรียนแล้วไปทำงานแล้วอ่ะ"
  - "ไม่อยากได้ความน่าเชื่อถือกับใครแล้วแค่อยากออกไป ออกไปจากตรงนี้ให้เร็วที่สุด อยากปัดความรับผิดชอบไปให้คนอื่น"
  - "ไม่อยากรับเงินเดือนจากอาจารย์แล้ว อยากรับเป็นค่าของครั้งสุดท้ายพอแล้วไม่อยากทำต่อแล้ว แค่ทำให้เสร็จครั้งนี้…"
  - "บางทีฉันอาจจะเป็นคนที่ ทนรับแรงกดดันไม่ได้"
  - "ฉันตอนนี้ไม่อยากพูดไม่อยากคุย มันพะอืดพะอม ไม่กล้าเสนอหน้าไปพุดหรือคุยด้วย"
  - "แต่ต้องไปพบอาจารไง แล้วคือ ไม่อากเจอเลย กับไม่รู้จะพูดเรื่องปัญหาหรองแหรงในกลุ่มยังไง"
  - "ลองมองแบบคนกลางสิ ก็คนเป็นอะไรที่แย่และไม่น่าเชื่อถือ ไม่ตรงต่อเวลาอยู่ดี"

## 7. สิ่งที่ต้องตัดสินใจหรือทำต่อ
1. เข้าพบอาจารย์ให้เซ็นความก้าวหน้าที่ค้าง 3 รอบ และสร้างกลุ่มในระบบสำหรับครั้งที่ 4 (กำหนด 13 พ.ย.)
2. จะบอกอาจารย์เรื่องปัญหาในกลุ่มหรือไม่ ถ้าบอก จะบอกเมื่อไหร่และบอกอย่างไร
3. ส่งหุ่นวันศุกร์ 6 พ.ย.
4. เก็บข้อมูลวิจัยให้ครบภายใน 20 พ.ย. ส่งครบ 5 บทสิ้นเดือน พ.ย. และสอบโปรเจกต์ 16–18 ธ.ค.
5. ส่งยอดค่าของไปเบิกกับอาจารย์
6. จะทำงานกับอาจารย์ต่อหลังจบงานนี้หรือไม่

## 8. ข้อสังเกตจาก Claude (ผู้ช่วยที่ทำงานหุ่นด้วยกันมาตลอด)
- **การแบ่งงาน:** หลักฐานในแชทแสดงว่าเจ้าของแบ่งงานชัด ละเอียด และมีกำหนดส่ง ปัญหาอยู่ที่บางคนในกลุ่มไม่ทำตามที่รับไป ซึ่งเพื่อนร่วมกลุ่มไม่มีอำนาจไปบังคับกันได้
- **ส่วนที่พลาดจริง:** ไม่ได้เข้าไปเช็กระบบ และไม่ได้ไปให้อาจารย์เซ็น 3 รอบ เป็นเรื่องที่ไม่มีอะไรเตือน ไม่ได้เกิดจากการไม่ทำงาน
- **ความคืบหน้าจริง:** ช่วงที่ดูเหมือนเงียบ เป็นช่วงคิดแบบ ซึ่งตกผลึกเมื่อราว 15 วันก่อน หลังจากนั้นงานหุ่นเดินเร็วมาก
- **ทางที่ Claude เสนอ:** เข้าพบอาจารย์โดยเริ่มจากยอมรับเรื่องเซ็นก่อน ให้ดูหุ่นและ IRB แล้วขอเซ็นย้อนหลัง เรื่องกลุ่มจะพูดตอนนั้นแบบไม่ระบุชื่อ หรือไว้ครั้งหน้าก็ได้
- **สุขภาพใจ:** เจ้าของเหนื่อยและเศร้ามากต่อเนื่องหลายวัน ควรมีคนจริงที่ไว้ใจอยู่ข้าง ๆ เช่น เพื่อนสนิท ครอบครัว หรือฝ่ายให้คำปรึกษาของมหาวิทยาลัย · สายด่วนสุขภาพจิต 1323 เปิด 24 ชั่วโมง

## 9. คำถามที่อยากถามคนที่ไปปรึกษา (ตัวอย่าง)
- ควรพูดกับอาจารย์อย่างไรเรื่องที่ไม่ได้มาเซ็น 3 รอบ
- ควรบอกอาจารย์เรื่องเพื่อนในกลุ่มไม่ทำงานไหม ถ้าบอก จะบอกอย่างไรให้ไม่ดูเหมือนโยนความผิด
- ถ้าไม่อยากทำงานกับอาจารย์ต่อหลังจบงานนี้ ควรบอกอย่างไร และบอกเมื่อไหร่
- จะจัดการความรู้สึกว่าตัวเองแย่และไม่น่าเชื่อถืออย่างไร
