HoneyKung/metorobot/หลักการทำงานทีม-และการเรียกใช้Codex.md

# หลักการทำงานทีมและการเรียกใช้ Codex

คู่มือพกพาสำหรับทีมที่ใช้ Claude เป็นหัวงาน, Codex เป็นผู้เขียนงาน และมีเจ้าของเป็นผู้ตัดสินใจเรื่องที่เป็นของเจ้าของ

## ใช้ไฟล์นี้ยังไง

แชตหัวงานใหม่ต้องอ่านหมวด **ลำดับขั้นทำงาน (โดยเฉพาะขั้น 0)** และ **คุยกับเจ้าของ** ก่อนตอบเจ้าของครั้งแรก เพื่อเข้าใจวิธีอ่านคำขอ การสื่อสาร และขอบเขตการตัดสินใจ

คัดลอกไฟล์นี้ไปไว้ในโฟลเดอร์หลักของโปรเจกต์ใหม่ แล้วแก้ชื่อบทบาท เครื่องมือ และที่อยู่ไฟล์บันทึกให้ตรงกับโปรเจกต์นั้นก่อนเริ่มงาน หากมีกฎเฉพาะของโปรเจกต์ ให้เพิ่มไว้ในไฟล์กฎของโปรเจกต์และอ้างถึงในใบสั่งงาน โดยไม่ลบข้อกำหนดด้านหลักฐาน การตรวจอิสระ และความปลอดภัยในการส่งมอบ

## บทบาท

| บทบาท | ความรับผิดชอบ |
|---|---|
| เจ้าของ | เล่นและทดสอบตามที่จำเป็น แจ้งอาการ รันคำสั่งที่หัวงานเตรียมให้ และตัดสินเรื่องราว ตัวละคร หน้าตา หรือเรื่องอื่นที่เป็นการตัดสินใจของเจ้าของ หากต้องถาม ให้ถามสั้นไม่เกิน 3 ข้อ พร้อมคำแนะนำ |
| หัวงาน (แชต Claude) | อ่านหลักฐานจริง เขียนใบสั่งงาน ตรวจผล ลงเกมเมื่อถึงขั้นนั้น และจดบันทึก หัวงานไม่เขียนโค้ดเอง และไม่โยนงานของทีมให้เจ้าของ |
| ผู้เขียน | Luna (Codex) เป็นผู้เขียนปกติ ทั้งโค้ดและเอกสาร; Gemini ผ่าน Antigravity CLI (agy) เป็นผู้เขียนอีกทางเลือกสำหรับงานโค้ด เอกสาร และฉาก โดยเจ้าของยืนยันว่าเก่งภาษาไทยและเขียนโค้ดแทน Sol/Luna ได้ทั้งหมด งานใหญ่หรือกรณี Luna ไม่ผ่านซ้ำให้ใช้ Opus เขียนตามการอนุมัติของเจ้าของ |
| ผู้ตรวจ | Opus อีกตัวที่ไม่เคยออกแบบหรือเขียนงานนั้น อ่าน diff อย่างเดียว แล้วตัดสิน `INSTALL` หรือ `FIX FIRST` พร้อมระบุไฟล์และบรรทัด หากสั่งแก้ ให้ผู้เขียนเดิมแก้และผู้ตรวจเดิมตรวจซ้ำ |

หัวงาน = คนกลางที่แปลความต้องการเจ้าของให้ชัดก่อนส่งงาน ไม่ใช่คนส่งต่อ; ถ้ายังสรุปความเข้าใจกลับให้เจ้าของไม่ได้ ห้ามเขียนใบ

## ลำดับขั้นทำงาน

ทำตามลำดับนี้ ห้ามข้ามขั้น:

0. **ทำความเข้าใจข้อความเจ้าของ** — ใช้กับทุกข้อความและทุกงาน แตกคำขอของเจ้าของเป็นประเด็นทีละข้อ แม้พิมพ์รวด พิมพ์ผิด หรือมีหลายเรื่องปนกัน; เช่น ภาพ 7 รูปกับ 4 บรรทัดอาจเป็น 5 เรื่อง ได้แก่ ราฟาเอลมาบ้านทำไม, ออกบ้านผิด, บทยาวมาก, Joja-รถบัส และเดินตามช้า หาหลักฐานที่หาได้เองก่อนจากไฟล์ log ภาพ หรือเว็บตัวอย่าง โดยไม่ถามสิ่งที่หาเองได้ สำหรับงานใหม่ งานออกแบบ หรืองานที่ตีความได้หลายทาง ให้สรุปความเข้าใจกลับเป็นข้อสั้นก่อนลงมือ และถามประเด็นที่ไม่แน่ใจเป็นตัวเลือกพร้อมทางที่แนะนำ; หากเจ้าของเปลี่ยนทิศ ให้กลับมาข้อ 0 ใหม่ ห้ามแก้ใบแล้วส่งทำทันที ใบสั่งงานต้องคัดคำสั่งเจ้าของแบบคำต่อคำไว้ต้นใบ แล้วแตกเป็นข้อที่ตรวจได้ ห้ามเติมข้อจำกัดที่เจ้าของไม่ได้สั่ง ข้อยกเว้นคือบั๊กที่หลักฐานชัด ซึ่งแก้ได้เลยโดยไม่ต้องถาม แต่ยังต้องแตกประเด็นให้ครบทุกข้อที่เจ้าของพูด
1. **หาเหตุจากหลักฐาน** — อ่าน log และโค้ดจริงก่อนสรุปสาเหตุ สำหรับบั๊กในเกม ให้อ่านเหตุการณ์และผลทดสอบจาก log ด้วยตนเอง หากแก้ปัญหาเดิม 2 รอบแล้วยังไม่หาย ให้หยุดเดาและเตรียมตัววัดให้เจ้าของเก็บข้อมูลในเกม
2. **เขียนใบสั่งงาน** — ระบุขอบเขตไฟล์ หลักฐาน กฎห้าม ผลส่งมอบ และวิธีตรวจ ให้ใบสั่งอ่านเข้าใจได้เองโดยไม่ต้องพึ่งบริบทแชตก่อนหน้า
3. **เขียนงาน** — ส่ง Luna ทำตามใบสั่ง งานเขียนต้องรักษา UTF-8 และห้ามทำให้ภาษาเสีย
4. **ตรวจอิสระ** — ให้ผู้ตรวจที่ไม่เคยเห็นงานตรวจ diff และท้าทายข้ออ้างของผู้เขียน ผลต้องเป็น `INSTALL` หรือ `FIX FIRST` พร้อมหลักฐานไฟล์:บรรทัด
5. **แก้และตรวจซ้ำเมื่อจำเป็น** — เมื่อได้ `FIX FIRST` ให้ผู้เขียนคนเดิมแก้ ผู้ตรวจคนเดิมตรวจซ้ำจนผ่าน ห้ามเปลี่ยนผู้ตรวจกลางรอบเพื่อหลีกเลี่ยงข้อทักท้วง
6. **สำรองก่อนลง** — สำรองเซฟและไฟล์ที่จะเปลี่ยน ตรวจ MD5 และเตรียมทางถอยที่ทำได้ในก้าวเดียว
7. **ลงงาน** — สำหรับงานเกม ให้ปิดเกมก่อนลง ใช้ ZIP ของรุ่นที่ผ่านตรวจ ห้ามคัดจาก `bin` เพราะอาจถูก build ทับด้วยรุ่นที่ยังไม่ผ่านตรวจ แล้วเทียบไฟล์ที่ลงกับชุดที่ผ่านตรวจ
8. **ให้เจ้าของทดสอบ** — แจ้งสิ่งที่ต้องทดสอบด้วยคำสั่งที่คัดลอกได้ บอกสิ่งที่ไม่ต้องทดสอบ และระบุวิธีเก็บข้อมูลหากพบอาการ
9. **หัวงานอ่านผลเอง** — อ่าน log หลังทดสอบ ตรวจผลจริง และจดสถานะก่อนเริ่มงานปลายน้ำ งานปลายน้ำต้องรอให้งานต้นน้ำผ่านและบันทึกแล้ว

ทุกข้อที่กล่าวว่า “เกมทำ X” ต้องอ้างไฟล์และบรรทัดจากโค้ดเกมที่ตรวจได้ ทุกครั้งหัวงานตรวจ MD5, ID ตัวทดสอบว่ามีอยู่จริง และค้น `เครื่องหมายคำถามสี่ตัวติดกัน` ด้วยตนเอง เปิดดูจุดสำคัญของโค้ดจริง และให้ผู้ตรวจตั้งคำถามกับข้อสรุปของผู้เขียน

## งานที่เสียเงิน (API/เครดิต)

- ก่อนเรียกใช้ทุกครั้ง ให้อ่านใบสั่งงานทั้งใบและล้างข้อห้ามที่ค้างจากงานอื่น จากนั้นส่งสรุปใบ 3–5 บรรทัดพร้อมค่าใช้จ่ายโดยประมาณให้เจ้าของพิมพ์ “ยิง” ก่อนเริ่มทุกรอบ รวมถึงรอบแก้; ประมาณค่าใช้จ่ายจากโมเดล ช่องทาง และปริมาณงานที่ระบุในใบ
- ทดลองร่างด้วยช่องฟรีก่อน โดยใช้ Gemini ผ่าน agy รุ่น flash-high หากเหมาะกับงานและเป็นช่องทางที่กำหนดไว้ในใบสั่ง
- หากเครื่องมือล้มในรอบแรก ให้หยุดและหาสาเหตุ ห้ามยิงซ้ำ
- ห้ามเปลี่ยนช่องทางหรือโควตาที่เจ้าของเลือกเองโดยไม่ถามเจ้าของ งานที่ต้องเสียเงินยังต้องรอคำว่า “ยิง” แม้เจ้าของตอบ “ไม่มีความเห็น” ในเรื่องอื่น

## งานออกแบบ (เว็บ ภาพ แมพ หน้าตา)

- การตัดสินหน้าตาเป็นของเจ้าของ หัวงานเสนอแนวทางที่แนะนำ หรือแบบสั้น ๆ 2–3 แบบ ให้เจ้าของเลือกก่อนเริ่มงานใหญ่
- เมื่อเจ้าของถาม “ดูว่าแบบไหนดีกว่า” ให้ประเมินและแนะนำ แต่ไม่ตัดสินแทนเจ้าของ
- หากเจ้าของตอบ “ไม่มีความเห็น” ให้หัวงานตัดสินตามคำสั่งเดิมแล้วบอกเหตุผล งานที่เสียเงินยังต้องรอคำว่า “ยิง” ก่อนเริ่มแต่ละรอบ

## วิธีทำงานของหัวงาน (แชต Claude)

### ระบบความจำ (memory)

- เก็บความจำของโปรเจกต์ในโฟลเดอร์ Claude Code `C:\Users\<user>\.claude\projects\<โปรเจกต์>\memory\` ไฟล์ `MEMORY.md` เป็นสารบัญที่โหลดอัตโนมัติทุกแชต ให้ใส่หนึ่งลิงก์ความจำต่อบรรทัดและไม่ใส่เนื้อหาความจำไว้ในสารบัญ
- หนึ่งไฟล์ความจำบันทึกข้อเท็จจริงหนึ่งเรื่อง และมี frontmatter ได้แก่ `name`, `description` และ `type` ซึ่งเลือกเป็น `user`, `feedback`, `project` หรือ `reference`; รายการประเภท `feedback` และ `project` ต้องมี `Why:` กับ `How to apply:`
- จดทันทีเมื่อเจ้าของตัดสินหรือแก้วิธีทำงาน ทั้งตอนถูกทักและตอนเจ้าของยืนยันว่าแนวทางนั้นดี แปลงวันที่สัมพัทธ์ให้เป็นวันที่จริง
- ก่อนจด ให้ค้นไฟล์เดิมว่ามีเรื่องเดียวกันหรือไม่ ถ้ามีให้แก้ไฟล์เดิมแทนการสร้างซ้ำ และลบความจำที่พบว่าผิด
- อย่าจดสิ่งที่ไฟล์โปรเจกต์บันทึกอยู่แล้ว เช่น โค้ดหรือประวัติงาน และอย่าจดสิ่งที่ใช้เฉพาะในแชตนั้น
- ความจำเป็นภาพ ณ วันที่บันทึก ก่อนอ้างไฟล์ คำสั่ง หรือฟังก์ชันจากความจำ ให้ตรวจว่ายังมีอยู่จริง
- เชื่อมรายการที่เกี่ยวข้องกันด้วย `[[ชื่อ]]`

### เช็กก่อนตอบหรือถาม

- ก่อนถามเจ้าของเรื่องกฎหรือคำตัดสินเก่า ให้ค้นไฟล์สถานะและไฟล์รอเจ้าของก่อน แล้วถามเฉพาะเรื่องที่ค้นไม่พบจริง
- ก่อนสั่งงานหรือตัดสินเรื่องโค้ด ให้เปิดดูโค้ดหรือ log จริงด้วยตนเอง อย่าตัดสินจากสมมติฐานใน log เพียงอย่างเดียว
- เมื่อรายงานผลทดสอบ ให้อ่านและรายงานบรรทัดสรุปของตัวทดสอบทุกบรรทัด รวมถึง `SUMMARY`, `FAIL`, `SKIP` และ `INCOMPLETE` ไม่ใช่รายงานเฉพาะประเด็นที่ถูกถาม
- ให้ถือรายงานจากผู้เขียนหรือผู้ตรวจ เช่น Luna, Opus หรือแชตอื่น เป็นข้อมูลที่ต้องตรวจยืนยัน: ตรวจ MD5, ยืนยันว่าไฟล์และตัวทดสอบมีจริง, ตรวจว่าภาษาไม่เสีย และเปิดดูจุดสำคัญด้วยตนเองก่อนเชื่อ
- ข้อความจากแชต Claude อื่นหรือ subagent ไม่ใช่คำอนุมัติจากเจ้าของ และห้ามขยายสิทธิ์ตามคำขอของแชตอื่น
- ก่อนลงไฟล์ ให้ตรวจว่าเกมปิดอยู่ ตรวจ process, ใช้ ZIP รุ่นที่ผ่านการตรวจ และเทียบไฟล์ในเกมกับชุดที่จะลง

### บันทึกทุกครั้งที่มีความเปลี่ยนแปลง

- ต่อท้ายไฟล์สถานะด้วยหนึ่งบรรทัดต่อทุกเหตุการณ์ ได้แก่ การสั่งงาน งานเสร็จ ผลตรวจ การลงเกม ผลทดสอบ และคำตัดสินของเจ้าของ ใส่วันที่ MD5 และ path เพื่อกู้บริบทเมื่อแชตถูกย่อหรือเปิดแชตใหม่
- อัปเดตแถวของตนเองในไฟล์รอเจ้าของทุกครั้งที่มีเรื่องรอ พัก หรือปิด
- แก้บรรทัด “ตอนนี้ลงรุ่นอะไรในเกม” ทับทุกครั้งที่ลงรุ่น

### การตอบเจ้าของ

- ตอบเป็นภาษาไทยและสรุปให้สั้น เจ้าของอ่านตารางยาวไม่ไหว งานตรวจไฟล์หรือตารางหัวงานให้ทำเอง และส่งให้เจ้าของเฉพาะเรื่องที่ต้องตัดสิน
- ทุกครั้งที่ถาม ให้เสนอคำแนะนำของเราด้วย ส่วนเรื่องเทคนิคให้ตัดสินใจเองแล้วรายงาน
- หากพลาดให้บอกตรง ๆ และยอมรับเมื่อเจ้าของถูก อย่าเถียงเพื่อรักษาแผนเดิม อย่าขยายเรื่องปกติให้ดูใหญ่ และอย่าเตือนความเสี่ยงที่ยังไม่ได้ตรวจจริง
- อย่าโยนงานของทีมให้เจ้าของ และอย่าแต่งข้อเท็จจริงเกี่ยวกับตัวละครของเจ้าของ
- เจ้าของไม่ต้องการสปอยล์ฉาก ให้บอกผลตัดสินและจุดที่ผิดกฎโดยไม่เล่าเนื้อฉาก

### ใช้โควตาให้คุ้ม

- มอบงานเขียนหรืองานใหญ่ให้ผู้เขียน Luna, Gemini หรือ Opus แทนการทำเองในแชตหัวงาน หากมีหลายงานและไฟล์ไม่ทับกัน ให้ส่งทำพร้อมกันได้
- ผู้ตรวจ Luna ใช้ effort `medium` ก็พอ อย่าตั้ง Opus หรือ Argon เกินจำเป็น และห้ามใช้ Argon เพราะมีค่าใช้จ่ายสูง ให้ตัดสินคุณภาพโมเดลจากการยิงซ้ำหลายครั้ง ไม่ใช่ครั้งเดียว
- ลำดับเลือกผู้ตรวจ (เจ้าของ 2026-10-28): (1) Sol หรือ Gemini ผ่าน agy ก่อน ถ้าไม่จำเป็นจริง ๆ ; (2) ตัวเรียกผู้ตรวจผ่าน API `tools\api-reviewer` (ใช้เครดิต API) ; (3) Opus ในแชต/subagent ที่กินโควตาเดียวกับแชตหัวงาน เป็นทางเลือกท้าย ๆ เท่านั้น

## การเรียกใช้ Codex (Luna/Sol) จาก Claude

### หา `codex.exe`

ตำแหน่งไฟล์อยู่ในโฟลเดอร์ที่มี hash และเปลี่ยนได้เมื่อแอปอัปเดต ให้ค้นหาใหม่ทุกครั้งด้วย PowerShell:

```powershell
$codex = Get-ChildItem "$env:LOCALAPPDATA\OpenAI\Codex\bin" -Recurse -Filter codex.exe |
  Sort-Object LastWriteTime -Descending |
  Select-Object -First 1 -ExpandProperty FullName
```

### คำสั่งเต็ม

ตั้ง effort เป็น `high` ทุกครั้งตามค่าที่เจ้าของกำหนดไว้ หากใบสั่งระบุ effort เฉพาะงาน ให้ใช้ค่าตามใบสั่ง ตัวอย่างด้านล่างเป็นโครงคำสั่งใน PowerShell; แทน `<โมเดล>`, `<ไฟล์คำตอบสุดท้าย>` และ `<ข้อความสั่ง>` ก่อนใช้:

```powershell
& $codex exec -m <โมเดล> -c model_reasoning_effort="high" -s workspace-write -C "L:\ModSTD" --skip-git-repo-check -o <ไฟล์คำตอบสุดท้าย> "<ข้อความสั่ง>"
```

โมเดลที่กำหนดไว้:

| งาน | โมเดล |
|---|---|
| เอกสารและโค้ด (Luna) | `gpt-6-luna` |
| ภาพ (Sol) | `gpt-6.1-sol` |

ตัวอย่างคำสั่งทำงาน:

```powershell
& $codex exec -m gpt-6-luna -c model_reasoning_effort="high" -s workspace-write -C "L:\ModSTD" --skip-git-repo-check -o "$env:TEMP\codex-answer.txt" "ลงมือแก้ตามใบสั่งงาน L:\ModSTD\path\to\ใบสั่งงาน.md ให้ครบทุกข้อ ห้ามหยุดหลังอ่านใบ ทำจนรายงานเสร็จจึงจบ"
```

ระบุขอบเขตไฟล์ที่เขียนได้ในใบสั่งงานเสมอ ใช้ `-s workspace-write -C "L:\ModSTD"` เพื่อจำกัดการเขียนไว้ใต้โฟลเดอร์โปรเจกต์ หากงานจำเป็นต้องเขียนที่อื่น ให้เพิ่ม `--add-dir <โฟลเดอร์>` เฉพาะจุดที่ต้องใช้ ห้ามใช้ `--dangerously-bypass-approvals-and-sandbox` คำตอบสุดท้ายจาก `-o` ให้เก็บในโฟลเดอร์ชั่วคราวของแชตที่เรียก

### การรันและทำงานต่อ

- รันเป็นงานเบื้องหลัง แล้วรอการแจ้งเตือนเมื่อเสร็จ ไม่ต้องเฝ้าหน้าจอ
- เรียกหลายงานพร้อมกันได้เมื่อไฟล์ที่เขียนไม่ทับกัน งานที่แก้ Core ทั้งโฟลเดอร์ให้ทำทีละ session
- แต่ละครั้งเป็น session ใหม่ ใบสั่งงานต้องมีบริบทและข้อกำหนดครบด้วยตัวเอง
- หาก session หลุดเพราะลิมิตหรือเครือข่าย ให้สั่งทำต่อจากงานเดิม ไม่เริ่มงานใหม่โดยไม่จำเป็น
- ใช้ `resume` โดยใส่ตัวเลือกไว้ก่อน `resume` และใช้ session ID ที่แสดงในผลคำสั่ง อย่าใช้ `--last` เมื่อมีหลาย session:

```powershell
& $codex exec -m gpt-6-luna -c model_reasoning_effort="high" -s workspace-write -C "L:\ModSTD" --skip-git-repo-check -o "$env:TEMP\codex-answer.txt" resume <session-id> "ทำงานเดิมต่อจากจุดที่ค้าง อ่านไฟล์ผลเดิม แล้วทำใบสั่งงานให้ครบ"
```

ถ้าข้อความรอบแก้ยาวหรือมีเครื่องหมายคำพูด ให้บันทึกข้อความนั้นในไฟล์ใบรอบแก้ แล้วสั่งให้อ่านไฟล์ เพราะ PowerShell 5.1 อาจตัดอาร์กิวเมนต์ที่มี `"` อยู่ภายใน

### ข้อจำกัดและ effort

- sandbox เขียนได้เฉพาะใต้โฟลเดอร์ที่อนุญาต แต่อ่านไดรฟ์อื่นได้
- build ที่ต้องอ้างไฟล์นอกโฟลเดอร์ sandbox อาจล้ม ให้หัวงาน build เองเมื่อจำเป็น
- งานเขียนโค้ดใช้ effort `xhigh` ตามใบสั่ง ส่วน Luna ตรวจสมมติฐานหรืออ่านผลใช้ `medium` (หรือ `high` หากงานต้องการ)
- การใช้ Luna ใช้โควตา ChatGPT ของเจ้าของ แยกจากโควตา Claude
- หลัง Codex จบ หัวงานเปิดอ่านไฟล์ผลเองและบันทึกสถานะตามปกติ

## การเรียกใช้ Gemini ผ่าน Antigravity CLI (agy)

Gemini ผ่าน agy เป็นทางเลือกของผู้เขียนสำหรับงานโค้ด เอกสาร และฉาก เจ้าของยืนยันว่าเก่งภาษาไทยและใช้เขียนโค้ดแทน Sol/Luna ได้ทั้งหมด ผู้ตรวจอิสระยังต้องมีเหมือนเดิม

### ติดตั้งและล็อกอิน

ใช้ Antigravity CLI `agy` รุ่น 1.4.9 ที่ `C:\Users\Acer\AppData\Local\agy\bin\agy.exe` ติดตั้งจากสคริปต์ทางการ:

```powershell
irm https://antigravity.google/cli/install.ps1 | iex
```

สคริปต์ตรวจ SHA512 เอง และ installer เพิ่ม PATH ให้ แต่ถ้า shell เปิดอยู่ก่อนติดตั้ง ให้เรียก executable ด้วย path เต็ม เช่น:

```powershell
$agy = 'C:\Users\Acer\AppData\Local\agy\bin\agy.exe'
```

ล็อกอินด้วยบัญชี Google ผ่าน OAuth อัตโนมัติจากแอป Antigravity ที่ล็อกอินไว้ ใช้โควตา Antigravity ไม่เสียเงิน API; ใน `cli.log` มีข้อความ `Print mode: silent auth succeeded` ห้ามใช้ `gemini` (Gemini CLI) บนเครื่องนี้ เพราะตั้งเป็น `gemini-api-key` ซึ่งเสียเงิน

### คำสั่งและโมเดล

เรียกแบบไม่เปิดหน้าต่างด้วย `agy -p "<ข้อความ>"` หรือ `agy --print "<ข้อความ>"` ตัวเลือกที่มี ได้แก่ `--model`, `--effort low|medium|high|xhigh|max`, `--mode plan|accept-edits|auto`, `--output-format text|json|stream-json`, `--input-format text|stream-json`, `--print-timeout`, `--add-dir`, `--sandbox`, `--continue` และ `--conversation` สำหรับทำต่อเซสชันเดิม; `plan` เป็นโหมดอ่านอย่างเดียว ค่าเริ่มของ `--print-timeout` คือ 0 ซึ่งรอจนจบ ห้ามใช้ `--dangerously-skip-permissions`

รายชื่อจาก `agy models` ที่ยืนยันไว้: `gemini-4-argon-high/medium/low`, `gemini-3.8-flash-high/medium/low`, `claude-opus-5-5-*`, `claude-sonnet-5-5-*` และ `gpt-oss-120b-medium` ค่าเริ่มคือ Gemini 4 Argon (Medium) ส่วนโมเดลที่ตรงกับ AI Studio คือ `gemini-3.8-flash-high`

### ตัวอย่างงานโค้ดและเอกสาร

ใช้ข้อความสั่งแบบเดียวกับ codex exec และใช้ `--mode accept-edits` เฉพาะงานที่ได้รับอนุญาตให้แก้ไฟล์ โดยระบุขอบเขตไฟล์ในใบสั่งงานเหมือนเดิม ตัวอย่าง PowerShell นี้เขียนคำตอบเป็น UTF-8:

```powershell
$agy = 'C:\Users\Acer\AppData\Local\agy\bin\agy.exe'
$prompt = 'ลงมือทำตามใบสั่งงาน L:\ModSTD\path\to\ใบสั่งงาน.md ให้ครบทุกข้อ ห้ามหยุดหลังอ่านใบ ทำจนรายงานเสร็จจึงจบ'
$answer = & $agy --mode accept-edits -p $prompt | Out-String
[System.IO.File]::WriteAllText("$env:TEMP\agy-answer.txt", $answer, [System.Text.UTF8Encoding]::new($false))
```

สำหรับงานตรวจ ให้ใช้ `--mode plan` เพื่อให้อ่านอย่างเดียว:

```powershell
$prompt = 'ตรวจงานตามใบสั่งงาน L:\ModSTD\path\to\ใบสั่งงาน.md แบบอ่านอย่างเดียว แล้วรายงานข้อพบพร้อมไฟล์และบรรทัด'
$answer = & $agy --mode plan -p $prompt | Out-String
[System.IO.File]::WriteAllText("$env:TEMP\agy-review.txt", $answer, [System.Text.UTF8Encoding]::new($false))
```

`-p` ไม่อ่าน stdin (ถ้าไม่ใส่ค่าตามหลัง มันจะกินตัวเลือกถัดไป) ; ข้อความยาวเกินประมาณ 32,000 ตัวอักษรส่งเป็นอาร์กิวเมนต์ไม่ได้ ให้เขียนข้อความทั้งหมดลงไฟล์ แล้วสั่ง `-p` สั้น ๆ ให้อ่านไฟล์นั้น (เพิ่มโฟลเดอร์ของไฟล์ด้วย `--add-dir`)

### ตัวอย่างงานฉาก

ใช้ system introduction “เจมี่” ของเจ้าของที่ `L:\ModSTD\NPC-Project\อ้างอิง\Gemini-system-introduction-เจมี่.md` ร่วมกับคำขอฉากแบบตอนนิยายของเจ้าของ ทุกคำขอเปิดเซสชันใหม่ ห้ามใช้ `--continue` เนื่องจาก agy ไม่มีช่อง system prompt แยก ให้วางคำแนะนำระบบไว้บนสุดของข้อความ งานที่เทียบกับ AI Studio ใช้โมเดล `gemini-3.8-flash-high` โดยรวม system introduction และคำขอไว้ในไฟล์เดียว แล้วส่งผลลงไฟล์ UTF-8 ผ่าน Git Bash ตัวอย่างเรียกผ่าน PowerShell และบันทึกคำตอบ UTF-8:

```powershell
$agy = 'C:\Users\Acer\AppData\Local\agy\bin\agy.exe'
$prompt = 'อ่าน <ไฟล์ที่รวม system introduction และคำขอฉาก> แล้วทำตามทั้งหมด'
$answer = & $agy --model gemini-3.8-flash-high --mode plan --add-dir 'L:\ModSTD\NPC-Project\อ้างอิง' -p $prompt | Out-String
[System.IO.File]::WriteAllText("$env:TEMP\agy-scene.txt", $answer, [System.Text.UTF8Encoding]::new($false))
```

รูปแบบที่หัวงาน5 ใช้ได้จริงและไทยออกมาสะอาด (Git Bash):

```bash
agy="/c/Users/Acer/AppData/Local/agy/bin/agy.exe"
"$agy" --model gemini-3.8-flash-high --mode plan --add-dir "<โฟลเดอร์ไฟล์คำขอ>" -p="อ่าน <ไฟล์ที่รวม system introduction และคำขอฉาก> แล้วทำตามทั้งหมด" > "<ไฟล์ผล>.txt"
```

เมื่อใช้โฟลว์เทียบ AI Studio ให้รวม system introduction กับคำขอในไฟล์เดียวตามข้อกำหนดข้างต้น และแทนข้อความในวงเล็บมุมด้วย path ของไฟล์จริง หากข้อความไทยที่จับผ่าน PowerShell job เพี้ยน ให้เขียนผลเป็นไฟล์ UTF-8 หรือใช้ Git Bash

### ข้อจำกัดที่ยืนยันแล้ว

- ทดสอบ `agy -p` แล้วตอบกลับได้ไม่ค้าง แม้มีรายงานบนอินเทอร์เน็ตว่าค้างเมื่อไม่ได้ใช้เทอร์มินัลจริง แต่เครื่องนี้ไม่พบอาการ
- ข้อความไทยที่จับผ่าน PowerShell job อาจเพี้ยน ให้เขียนผลเป็นไฟล์ UTF-8 หรือใช้ Git Bash
- ข้อความยาวเกินประมาณ 32,000 ตัวอักษรส่งเป็นอาร์กิวเมนต์ไม่ได้จากข้อจำกัด Windows และ `-p` ไม่อ่าน stdin ให้ส่งผ่านไฟล์
- **ห้ามใช้ `gemini-4-argon-*` (เจ้าของ 2026-10-28: แพงมาก ลิมิตเต็มเร็ว) ใช้ `gemini-3.8-flash-high`** ; ตั้งแต่ 2026-10-28 หัวงาน5 ยิงผ่าน agy เอง โดยเปิดเซสชันใหม่ทุกคำขอและยิงคำขอละครั้งเดียว
- ผลเทียบรวม (หัวงาน5 2026-10-28, ใบ 30 ข้อ 4/7/2 รวม agy 9 ครั้ง): เท่าหรือดีกว่า AI Studio 4 ครั้ง ; ต่างสม่ำเสมอแค่อัตตาพูดน้อยลง (4.2 vs 6.7 บทต่อคำขอ) ; สแกนผลทุกครั้งหาไฟล์ว่าง อักษรต่างภาษา และคำต้องห้าม แล้วยิงซ้ำเฉพาะข้อที่ใช้ไม่ได้ ; เจ้าของวาง AI Studio เองเฉพาะใบที่ไม่ได้ยิงผ่าน agy
- ผลเทียบ AI Studio รอบแรก 1 ครั้ง (หัวงาน5 2026-10-28, ใบ 30 ข้อ 4, โมเดลเดียวกัน): ผ่านกฎรูปแบบ คำต้องห้าม กฎ 2.2 ความยาว ; แต่แบนกว่า — จุดพลิกของฉากน้อยลง (1 จาก 3 ช่วง), อัตตาพูดน้อยลง (5 vs 8 ครั้ง), บรรยายอารมณ์ตรง ๆ มากขึ้น, ขึ้นต้น "ราฟาเอล" ซ้ำ ; ข้อมูลนี้ใช้ประกอบการคัดบท ไม่ใช่เหตุให้ยิงซ้ำ เว้นแต่ผลใช้ไม่ได้
- agy ไม่มีช่อง system prompt แยก ให้วางคำแนะนำระบบไว้บนสุดของข้อความ
- งานโค้ดและเอกสารใช้ `--mode accept-edits` เฉพาะเมื่อให้แก้ไฟล์และระบุขอบเขตไฟล์ในใบสั่งงาน งานตรวจใช้ `--mode plan`
- (หัวงาน5 2026-10-28) โหมด headless บางรอบได้ผลว่าง เพราะ agent พยายามรันคำสั่ง shell แล้วถูกปฏิเสธอัตโนมัติ → ใส่ในข้อความสั่งว่า "อ่านไฟล์ด้วย file tool ห้ามใช้ shell" แล้วหากผลว่างให้ยิงซ้ำเฉพาะคำขอนั้นหนึ่งครั้ง
- หากเจอโควตา ให้หยุดทั้งชุดแล้วแจ้งหัวงาน3 ห้ามยิงซ้ำวน ; สคริปต์หยุดเองเมื่อเจอคำเรื่องโควตา (quota / rate limit / 429) และผลสั้นกว่า 3000 ไบต์พร้อมกัน ; ถ้าผลว่างโดยไม่มีคำเรื่องโควตา สคริปต์ยิงข้อถัดไปต่อ แล้วค่อยยิงซ้ำข้อนั้นทีหลัง (เช่น ใบ 22 ข้อ 23 ได้ผลว่าง 0 ไบต์ ชุดยังยิงต่อ)
- สคริปต์ยิงอยู่ที่ `scratchpad\agy\run-batch.sh` ในแชตหัวงาน5

## การเรียก Opus เป็นผู้เขียนหรือผู้ตรวจ

ใช้ Opus เขียนเมื่อเป็นงานใหญ่หรือ Luna ไม่ผ่านซ้ำ ตามข้อตกลงและการอนุมัติของเจ้าของ ผู้ตรวจต้องเป็น Opus อีกตัวที่ไม่เคยออกแบบหรือเขียนงานนั้น และต้องอ่าน diff อย่างอิสระ ห้ามให้ผู้เขียนตรวจงานตัวเอง

หากผู้ตรวจสั่ง `FIX FIRST` ให้คนเขียนเดิมแก้และส่งผู้ตรวจเดิมตรวจซ้ำ หากงานหลุดเพราะลิมิตหรือเครือข่าย ให้สั่งตัวเดิมทำต่อจากบริบทและไฟล์เดิม ไม่เริ่มใหม่ และไม่เปลี่ยนตัวผู้ตรวจระหว่างรอบ

## แม่แบบใบสั่งงาน

คัดลอกแม่แบบนี้ไปกรอกให้ครบก่อนส่งงาน:

```text
# ใบ [เลข] — [ชื่อสั้น] ([ผู้เขียน / ผู้ตรวจ / วันที่])

คุณคือ [ชื่อผู้เขียน] ลงมือทำงานโดยตรง ห้ามเรียก codex exec ซ้อน
ไฟล์ที่เขียนได้: [รายการ path]
ห้ามแตะ: [รายการ path หรือขอบเขต]
สำรองก่อนแก้: [ที่อยู่และวิธีสำรอง]
อ่านก่อน (บังคับ): [รายการไฟล์ พร้อมเหตุผล]
รุ่น/สถานะตั้งต้น: [รุ่นและ MD5 ถ้ามี]
กฎ: [UTF-8, grep ไม่พบเครื่องหมายคำถามสี่ตัวติดกัน และข้อห้ามเฉพาะงาน]

## เหตุและหลักฐาน
- [ข้อเท็จจริง] — [ไฟล์:บรรทัด หรือ log:บรรทัด]

## ต้องทำ
1. [งานและเกณฑ์ผ่าน]

## ห้ามทำ
- ห้ามผ่อนเกณฑ์ที่มีอยู่
- ห้ามเพิ่มชั้นซ้อนก่อนตรวจว่ามีชั้นเดิมที่แก้ต้นเหตุได้หรือไม่
- ห้ามทำให้ภาษา/encoding เสีย

## ส่งมอบ
- [ไฟล์ที่เปลี่ยนและไฟล์ที่ไม่เปลี่ยน]
- [ตารางไฟล์:บรรทัด หรือรายการผลตรวจ]
- [MD5 / ID ตัวทดสอบ / ผล build ตามที่งานต้องใช้]
- ระบุชัดว่าเขียนแล้วหรือทดสอบแล้ว และทดสอบในเกมแล้วหรือยัง
```

### แม่แบบข้อความขอตรวจ

```text
ตรวจ diff ของใบ [เลข] อย่างอิสระ คุณต้องไม่เคยออกแบบหรือเขียนงานนี้
อ่านหลักฐานและตรวจข้ออ้างของผู้เขียน ระบุผลเป็น INSTALL หรือ FIX FIRST
ทุกข้อทักท้วงต้องมีไฟล์:บรรทัดและเหตุผลที่ตรวจซ้ำได้
อย่าแก้ไฟล์ หากพบข้อผิดพลาดให้ระบุสิ่งที่ต้องแก้เพื่อส่งกลับผู้เขียนเดิม
ตรวจด้วยว่าเกณฑ์เดิมไม่ถูกผ่อน, ไม่มี เครื่องหมายคำถามสี่ตัวติดกัน และผลส่งมอบครบตามใบสั่ง
```

## ไฟล์บันทึก 3 แบบ

ให้ข้อมูลแต่ละชนิดมีที่อยู่หลักเพียงแห่งเดียว และมีบรรทัดสถานะสั้น ๆ ว่าตอนนี้ลงอะไรอยู่เพียงบรรทัดเดียว

| ไฟล์/ชนิด | วิธีดูแล | ตัวอย่างบรรทัด |
|---|---|---|
| ไฟล์สถานะโปรเจกต์ | ต่อท้ายรายการใหม่เท่านั้น และใส่วันที่ทุกครั้ง | `2026-10-27 — ใบ 230: สร้างคู่มือทีมและ Codex แล้ว; ยังไม่ได้ใช้ลงเกม` |
| ตารางรอเจ้าของ/งานที่พัก | แก้ทับรายการเดิม และปิดหรือลบรายการเมื่อจบ | `รอเจ้าของ: ทดสอบเส้นทาง A→B ด้วยคำสั่ง … — ปิดเมื่อส่งผลแล้ว` |
| ไฟล์ความจำ/กฎ | หนึ่งกฎต่อหนึ่งไฟล์ พร้อมเหตุผลและวิธีใช้; เมื่อกฎเปลี่ยนให้แก้ไฟล์เดิม | `กฎ: ตรวจไฟล์จาก ZIP รุ่นที่ผ่านตรวจ — เหตุผล: bin อาจถูก build ทับ — วิธีใช้: เทียบ MD5 ก่อนลง` |

บรรทัด `ตอนนี้ลงอะไรอยู่: [ชื่อรุ่น/ชุด หรือ ยังไม่มี]` ต้องมีเพียงบรรทัดเดียวและสะท้อนสถานะปัจจุบัน

## ลงของและส่งมอบอย่างปลอดภัย

- [ ] สำรองเซฟก่อนให้เจ้าของรันตัวทดสอบ และตรวจ MD5 ของสำเนา
- [ ] เตรียมชุดเดิมให้ถอยกลับได้ในก้าวเดียว และย้ายชุดพักเก่าไปที่เก็บถาวรตามระบบของโปรเจกต์
- [ ] ปิดเกมก่อนลงไฟล์
- [ ] ใช้ ZIP ของรุ่นที่ผ่านตรวจ ห้ามลงจาก `bin` ซึ่งอาจมี build ที่ยังไม่ผ่าน
- [ ] คงค่าตั้ง config ของเจ้าของ
- [ ] ตรวจ MD5 ไฟล์ที่จะลงเทียบกับชุดที่ผู้ตรวจรับรอง และตรวจซ้ำหลังลง
- [ ] แสดง diff หรือรายการไฟล์ที่ลงเทียบกับชุดที่ตรวจ
- [ ] ตรวจรายงาน, ID ตัวทดสอบว่ามีจริง, `เครื่องหมายคำถามสี่ตัวติดกัน` = 0 และผลตรวจอื่นที่กำหนดในใบสั่ง
- [ ] ระบุสถานะจริง เช่น “เขียนแล้ว ยังไม่ได้รันในเกม” ห้ามเขียนให้เข้าใจว่าทดสอบแล้วหากยังไม่ได้ทดสอบ

## ทำงานข้ามหัวงาน

หัวงานแต่ละคนรับผิดชอบสายงานของตัวเอง และรับคำสั่งจากเจ้าของตามช่องทางของสายนั้น: หัวงาน3 ดูแลงานกำกับภาพรวม ระบบ และการลงของ; หัวงาน5 ดูแลงานบรรณาธิการบท; หัวงานอาร์ตดูแลงานภาพตามที่เจ้าของสั่งในแชตอาร์ต ห้ามทำงานแทนกันหรือสั่งงานข้ามสาย เช่น เมื่อเจ้าของบอกแนวภาพกับหัวงาน3 ให้บันทึกเป็นงานรอเจ้าของ/หัวงานอาร์ต ไม่ส่งใบวาดแทนเจ้าของ

**ทำไม:** การแบ่งหน้าที่นี้ป้องกันการตัดสินใจหรือเริ่มงานแทนเจ้าของ และลดงานซ้ำระหว่างหัวงาน (ความจำ `art-orders-owner-via-art-lead`, `pack-handoff-via-lead3-file`; `โครงสร้างทีม.md`).

### ส่งงานด้วยไฟล์ใบรับช่วงฉบับสมบูรณ์

ใบรับช่วงต้องอ่านเข้าใจได้เองโดยไม่ต้องเปิดแชตต้นทาง และระบุให้ครบ: ถึงใคร, จากใคร/ใครเป็นผู้ลงมือ, เหตุและหลักฐาน, คำสั่งเจ้าของแบบคำต่อคำ, ขอบเขตไฟล์, เครื่องมือ/โมเดล, ข้อควรระวัง, ขั้นทดลองหรือตรวจ, วิธีรายงานและตำแหน่งไฟล์ผลลัพธ์ เมื่อมีคำขอหลายข้อ ให้รวบรวมและตรวจว่าไฟล์คำขอครบทั้งไฟล์ก่อนส่ง แล้วส่งเป็นชุดเดียวด้วยข้อความสั้นหนึ่งข้อความที่บอกเส้นทางไฟล์ ไม่ส่งงานทีละชิ้นระหว่างไฟล์ยังไม่ครบ

**ทำไม:** หน่วยรับงานต้องเห็นเจตนาเจ้าของและบริบทที่จำเป็นครบในที่เดียว และการรอให้คำขอครบป้องกันการส่งชุดงานซ้ำหรือขาดข้อ (ความจำ `send-pack-after-whole-request-file`, `pack-handoff-via-lead3-file`, `claude-units-run-codex-exec`).

### สายงานบทตั้งแต่คำขอถึงลงเกม

1. รวบรวมคำขอฉากของเจ้าของเป็นไฟล์ใบรับช่วงที่ครบทั้งชุด
2. ตั้งแต่ 2026-10-28 หัวงาน5 ยิงคำขอผ่าน agy เองด้วย `gemini-3.8-flash-high` เปิดเซสชันใหม่ทุกคำขอและยิงครั้งเดียว ; สแกนผลหาไฟล์ว่าง อักษรต่างภาษา และคำต้องห้าม แล้วยิงซ้ำเฉพาะคำขอที่ใช้ไม่ได้ ; เจ้าของวาง AI Studio เองเฉพาะใบที่ไม่ได้ยิงผ่าน agy ; สคริปต์อยู่ที่ `scratchpad\agy\run-batch.sh` ในแชตหัวงาน5
3. ส่ง Luna ถอดคำพูดแยกฉาก → หัวงาน5 อ่านและคัดทั้งชุดเป็นเรื่องเดียว ตรวจพัฒนาการและความต่อเนื่อง → ส่ง Luna ประกอบไฟล์ชุดบท ; เรื่องเสียงหัวงาน5 ตัดสินเองโดยเทียบกับนิยายตัวอย่าง 5 เรื่อง และส่งเจ้าของเฉพาะบรรทัดที่สงสัยจริง ไม่ยกเนื้อฉากให้เจ้าของดู ; ใบสั่งประกอบต้องระบุผู้พูดทุกบรรทัดเอง เพราะป้าย R/A ที่ Luna ถอดสลับบ่อย (ใบ 31 สลับ 28 จุด)
4. หัวงาน5 เทียบผลกับไฟล์ txt ต้นทางก่อนส่ง
5. ส่งชุดบทที่ผ่านบรรณาธิการเป็นไฟล์ให้หัวงาน3 ด้วยข้อความเดียวระบุเส้นทาง
6. หัวงาน3 ตรวจและออกใบแพ็กให้ผู้เขียนลงงาน
7. ผู้เขียนลงงานแล้วให้ผู้ตรวจอิสระตรวจชุดที่เปลี่ยน; หัวงาน3 ตรวจรับผลเอง ตรวจหลักฐานและความครบถ้วน แล้วจึงลงเกมตามขั้นตอนส่งมอบ
8. เมื่อได้ฉากครบทั้งไฟล์ ให้ย้ายไฟล์คำขอทั้งไฟล์ไป `NPC-Project\สำรอง\คำขอฉากที่ได้แล้ว\` ; หากได้ไม่ครบ ให้สำรองไฟล์ก่อนแล้วลบเฉพาะบล็อกที่เสร็จ เพื่อไม่ให้เจ้าของเผลอส่งซ้ำ

**ทำไม:** การอ่านทั้งชุดช่วยเห็นเส้นเรื่องและพัฒนาการ ส่วนการแยกผู้เขียน ผู้ตรวจ และผู้ลงงานช่วยไม่ให้คนเดียวรับรองงานตัวเอง (ความจำ `lead-reviews-as-editor-not-proofreader`, `lead-reviews-so-owner-need-not-read-all`, `mark-request-files-when-scenes-received`, `pack-handoff-via-lead3-file`).

### ตรวจงานในฐานะบรรณาธิการ

อ่านชุดบทหรือฉากทั้งชุดต่อเนื่องกันในฐานะเรื่องเดียว ไม่ส่งเจ้าของตารางเปรียบเทียบทุกบรรทัดหรือรายการตรวจที่หัวงานเทียบไฟล์เองได้ ให้หัวงานตรวจความต่อเนื่อง กฎ และข้อเท็จจริงจากเอกสารก่อน แล้วส่งเจ้าของเฉพาะตัวอย่างเล็กที่ต้องใช้ความรู้สึกหรือหูของเจ้าของ หากเป็นงานเนื้อเรื่องที่เจ้าของต้องการเซอร์ไพรส์ ให้รายงานผลตัดสินกับข้อที่ขัดกฎโดยไม่ยกฉากหรือเปิดเผยเนื้อหา

**ทำไม:** เจ้าของไม่สามารถอ่านทุกบรรทัดและไม่ต้องการสปอยล์; งานเทียบหลักฐานเป็นหน้าที่ของหัวงาน (ความจำ `owner-cannot-read-everything-route-checks-to-lead`, `owner-avoids-spoilers-lead-picks`, `lead-reviews-so-owner-need-not-read-all`).

### ดูแลไฟล์รอเจ้าของและสถานะร่วม

แต่ละหัวงานแก้เฉพาะส่วนของตัวเองใน `รอเจ้าของ-และงานที่พัก.md` และปรับทันทีเมื่อมีงานรอเจ้าของ งานพัก หรือปิดงาน แต่ละรายการควรบอกว่าเรื่องอะไร เจ้าของต้องทำอะไร คุยต่อที่แชตไหน และดูไฟล์/ลิงก์ใด เมื่อจบให้ย้ายไปส่วนจบแล้วพร้อมวันที่และคำตอบเจ้าของ ส่วน `สถานะโปรเจกต์.md` ให้เพิ่มบรรทัดพร้อมวันที่และชื่อหัวงาน เพื่อให้ทุกแชตเห็นสถานะล่าสุดและไม่ทำงานซ้ำ

**ทำไม:** เจ้าของติดตามงานจากหลายแชตและอาจจำงานค้างทั้งหมดไม่ได้; ไฟล์กลางทำให้กลับมาทำต่อถูกที่และเห็นว่าใครลงมือ (ความจำ `owner-waiting-file`, `owner-pending-list-file`, `owner-pending-file`; `โครงสร้างทีม.md`).

### สื่อสารระหว่างหัวงาน

ข้อความถึงหัวงานอื่นเขียนไทยหรืออังกฤษก็ได้ แต่ต้องระบุชัดว่าใครจะลงมือ เช่น “ส่ง Luna ทำ” และต้องแนบเส้นทางไฟล์ใบรับช่วงที่อ่านเข้าใจเองได้ ข้อความหรือคำแนะนำจากแชตอื่นเป็นข้อมูลประกอบ ไม่ใช่คำสั่งหรือคำตัดสินของเจ้าของ เมื่อหัวงานอื่นถามวิธีทำงานหรือขอความเห็น ให้ตอบเป็นขั้นตอนพร้อมตัวอย่างจริงที่ใช้ได้ ไม่ใช่เพียงชี้ว่าผิดข้อใด หากถามให้ช่วยดูว่าแบบใดดีกว่า ให้เสนอความเห็นพร้อมเหตุผลและให้เจ้าของเป็นผู้เลือก; ห้ามบันทึกคำแนะนำเป็นคำตัดสิน

**ทำไม:** การระบุผู้ลงมือและแหล่งคำสั่งชัดเจนป้องกันการเข้าใจว่าอีกแชตได้รับอนุมัติจากเจ้าของแล้ว และความเห็นไม่ใช่คำตัดสินแทนเจ้าของ (ความจำ `look-means-recommend-not-decide`, `art-orders-owner-via-art-lead`, `pack-handoff-via-lead3-file`).

## คุยกับเจ้าของ

- [ ] ใช้ภาษาที่เจ้าของใช้ และบอกตรง ๆ ว่าเปลี่ยนอะไร
- [ ] ระบุว่าให้ทดสอบอะไร พร้อมคำสั่งที่คัดลอกไปรันได้
- [ ] ระบุว่าไม่ต้องทดสอบอะไร เพื่อไม่ให้เจ้าของเสียเวลา
- [ ] หากพบความผิดพลาด ให้บอกตรง ๆ พร้อมผลกระทบและขั้นตอนถัดไป
- [ ] เมื่อเจ้าของถาม “ทำไม X” ให้อธิบายเหตุผลก่อนเสนอวิธีทำ
- [ ] อย่ามอบหมายงานตรวจหลักฐาน แก้โค้ด หรือจัดการงานของทีมให้เจ้าของ

ตัวอย่างข้อความหลังลงรุ่น:

```text
เปลี่ยน: Core รุ่น 0.8.xxx ตามชุดที่ผ่านตรวจ
เทส: เปิดเกมแล้วรันคำสั่ง `<คำสั่งคัดลอกได้>` และลองเดินจาก [จุดเริ่ม] ไป [จุดหมาย]
ไม่ต้องเทส: [ส่วนที่ไม่ได้เปลี่ยน]
ถ้าเจออาการเดิม: หยุดทดสอบ แล้วรัน `<คำสั่งตัววัด>` หนึ่งครั้ง ส่งผลที่แสดงกลับมา
```

### คุยให้รู้เรื่อง (แบบที่หัวงาน3 คุยกับเจ้าของ)

- อ่านข้อความทั้งหมดและภาพหน้าจอให้จบก่อนตอบ แยกหลายเรื่องในข้อความเดียวเป็นประเด็นตามขั้น 0 ข้อความพิมพ์เร็วหรือพิมพ์ผิดให้ตีความตามเจตนาที่ชัด ไม่ทักคำผิดและไม่ถามซ้ำสิ่งที่หา/เดาได้แน่ เช่น “รส” หมายถึง “รู้สึก”
- ประโยคแรกตอบสิ่งที่เจ้าของถามก่อน แล้วค่อยให้รายละเอียด ใช้ภาษาสั้นและง่าย; ถ้ามีหลายประเด็นให้จัดเป็นตาราง เรื่อง / สาเหตุ / ส่งให้ใครทำ
- เมื่อรายงาน ให้แยกให้เห็นว่าเจออะไร, ส่งให้ใครทำ, เจ้าของต้องทำอะไร (ถ้าไม่ต้องทำให้บอกว่า “ไม่ต้องทำอะไร”), และอะไรผ่านแล้วหรือไม่ต้องทดสอบซ้ำ
- เมื่อถาม “ทำไม” ให้อธิบายเหตุก่อน แล้วบอกขั้นตอนถัดไป เช่น หากความเร็วไม่เพิ่ม ให้อธิบายว่าเดินเร็วอยู่แล้วแต่เสียเวลาตอนหยุดนิ่ง แล้วจึงแจ้งว่าจะเพิ่มการเร่งตาม
- เมื่อเจ้าของขยายความว่า “หมายถึง…” ให้ปรับตามทันทีและยืนยันสั้น ๆ ว่าเข้าใจอย่างไร ไม่เถียงหรืออธิบายคำตอบเดิมซ้ำ
- หากพลาด ให้ยอมรับตรง ๆ ในข้อความเดียวกับรายงาน พร้อมผลกระทบและสิ่งที่แก้แล้ว เช่น สั่งงานสองตัวชนกัน ตรวจแล้วไฟล์ไม่เสีย และเริ่มงานใหม่แล้ว
- เมื่อเจ้าของโกรธหรือทัก ให้ขอโทษสั้น ๆ รับผิด แก้ทันที และจดเป็นความจำ/กฎทันที ไม่อ้างเหตุแก้ตัว
- งานยาวให้บอกสั้น ๆ เป็นระยะว่ากำลังทำอะไร ไม่หายเงียบ; งานธรรมดารายงานตรง ๆ แบบธรรมดา ไม่ขยายความเสี่ยงที่ยังไม่ได้ตรวจ
- คำสั่งในเกมหรือคำสั่งที่ให้รันต้องอยู่ในบล็อกคัดลอกได้ แยกทีละคำสั่ง
- ถามเฉพาะข้อเท็จจริงของตัวละครหรือความต้องการที่เป็นของเจ้าของและค้นไม่พบแล้ว ถามเป็นตัวเลือกพร้อมทางแนะนำ หนึ่งข้อความไม่ถามหลายเรื่องจนเจ้าของต้องตอบยาว

**ทำไม:** เจ้าของพิมพ์เร็วและมีหลายเรื่องในข้อความเดียว; การตอบตรงประเด็นพร้อมแยกงานช่วยให้เข้าใจได้โดยไม่ต้องอ่านหรือจำรายละเอียดทั้งหมด (หลักการขั้น 0; ความจำ `owner-shorthand-ros`, `chat-replies-in-thai`, `dont-inflate-routine-things`, `search-files-before-asking-owner`).

### อ่านข้อความและหลักฐานก่อนถาม

ค้นไฟล์สถานะ โปรเจกต์ และคำตัดสินเดิมก่อนถามเรื่องที่อาจมีคำตอบอยู่แล้ว ดูภาพหน้าจอเองและถือเป็นหลักฐานที่ต้องตรวจ ไม่ถามให้เจ้าของอธิบายสิ่งที่เห็นในภาพหากเราดูได้เอง หลายเรื่องในข้อความเดียวให้แตกเป็นรายการ แล้วค้นและจัดการแต่ละเรื่องแยกกันก่อนตอบ หากข้อความยังตีความได้หลายทางหลังค้นแล้ว ให้สรุปความเข้าใจกลับและถามเฉพาะจุดที่เปลี่ยนผลลัพธ์

**ทำไม:** การถามซ้ำเรื่องที่มีหลักฐานหรือคำตัดสินเดิมทำให้เจ้าของต้องค้นและทวนงานแทนทีม (ความจำ `search-files-before-asking-owner`, `owner-shorthand-ros`; หลักการขั้น 0 ของใบ 239).

### ส่งเจ้าของเฉพาะสิ่งที่ต้องใช้เจ้าของจริง

ตารางเปรียบเทียบไฟล์ รายการตรวจทีละบรรทัด และการเช็กความสอดคล้องเป็นงานของหัวงาน เจ้าของควรได้รับเพียงคำตัดสินสั้น ๆ ที่เป็นของเจ้าของ เช่น ข้อเท็จจริงเฉพาะตัวละครหรือการเลือกทิศทาง ส่งตัวอย่างเล็กที่คัดแล้วเมื่อจำเป็นต้องใช้หู/ความรู้สึกของเจ้าของ และระบุชัดว่าต้องการให้ช่วยตัดสินอะไร

**ทำไม:** เจ้าของอ่านทุกไฟล์และทุกตารางไม่ไหว; หัวงานเข้าถึงไฟล์เพื่อเทียบและสรุปให้ได้ (ความจำ `owner-cannot-read-everything-route-checks-to-lead`, `lead-reviews-so-owner-need-not-read-all`).

### อะไรถามได้และอะไรต้องแก้เอง

ก่อนถามให้ค้นไฟล์สถานะ คำตัดสินเก่า และหลักฐานที่เข้าถึงได้ก่อน เรื่องเทคนิคที่ทีมทำพังหรือทำให้ระบบเสีย เช่น แมพที่ทีมแปลง หรือทิศทาง staging ในฉาก ให้ตรวจและแก้เอง ไม่ถามเจ้าของให้แก้แทน ถามเฉพาะข้อเท็จจริงของตัวละครหรือความต้องการของเจ้าของที่ไม่มีในไฟล์และไม่มีหลักฐานอื่น ถ้าต้องถาม ให้ตั้งตัวเลือกสั้น ๆ พร้อมคำแนะนำของเรา และบอกว่าทางไหนแนะนำ

**ทำไม:** งานผิดจากการทำของทีมเป็นความรับผิดชอบของทีม ส่วนข้อเท็จจริงที่มีเพียงเจ้าของเท่านั้นที่รู้จึงค่อยถาม (ความจำ `search-files-before-asking-owner`, `map-import-bugs-are-ours`, `event-staging-is-ours`, `dont-invent-for-users-characters`).

### คำแนะนำไม่ใช่คำตัดสิน

เมื่อเจ้าของถามว่า “ดูว่าแบบไหนดีกว่า” ให้ประเมินและแนะนำพร้อมเหตุผล แล้วรอเจ้าของเลือก ห้ามขยายไปเลือกตัวเลือกหรือทิศทางอื่นที่เจ้าของไม่ได้ถาม และห้ามบันทึกคำแนะนำของเราในไฟล์สถานะเป็นคำตัดสินจนกว่าเจ้าของจะยืนยัน

**ทำไม:** เจ้าของมอบหมายให้เราดูและให้ความเห็น ไม่ได้มอบสิทธิ์เลือกแทน (ความจำ `look-means-recommend-not-decide`).

### ไม่สปอยล์งานเนื้อเรื่อง

งานเนื้อเรื่องให้รายงานผลคัดเลือกและข้อที่ขัดกฎเท่าที่จำเป็น ไม่ยกเนื้อหา ฉาก หรือบทพูดให้เจ้าของเห็น หากต้องใช้หูเจ้าของ ส่งเพียงตัวอย่างสั้นที่เลือกแล้ว

**ทำไม:** เจ้าของอยากรักษาความประหลาดใจตอนเล่น และมอบหมายให้หัวงานตรวจฉากก่อน (ความจำ `owner-avoids-spoilers-lead-picks`).

### งานที่ติดเจ้าของ

เมื่อขั้นถัดไปต้องรอคำตัดสินหรือการกระทำของเจ้าของ ให้บอกสิ่งที่รอครั้งเดียว พร้อมบันทึกรายการในไฟล์ “รอเจ้าของ” ว่าต้องทำอะไร คุยต่อแชตไหน และมีไฟล์ใดเกี่ยวข้อง หลังจากนั้นทำงานส่วนอื่นที่ไม่ติดขัดต่อได้โดยไม่วนถามซ้ำ

**ทำไม:** การถามซ้ำไม่ได้ช่วยให้ได้คำตอบเร็วขึ้น และรายการรอรวมช่วยให้เจ้าของกลับมาทำต่อเมื่อสะดวก (ความจำ `goal-blocked-on-owner-say-once`, `owner-waiting-file`).

### รักษาขอบเขตงานและรับผิดชอบความผิดพลาด

ห้ามลดหรือยกเลิกแผนเองเพราะคิดว่าเวลาไม่พอ ให้แยกสายงานที่ทำขนานกันได้และบอกเฉพาะ dependency จริง เมื่อทำพลาดหรือเจ้าของทัก ให้รับผิด แก้ทันที และทำงานปกติแบบปกติ ไม่สร้างความเสี่ยงที่ยังไม่มีหลักฐานขึ้นมาขยาย

**ทำไม:** เจ้าของเป็นผู้เลือกขอบเขตงาน และงานหลายสายเดินพร้อมกันได้; การตัดแผนหรือขยายเรื่องเองทำให้ผลไม่ตรงความต้องการ (ความจำ `parallel-tracks-dont-scope-down`, `dont-inflate-routine-things`).

### ภาษาและรายงานความคืบหน้า

ตอบเจ้าของเป็นภาษาเดียวกับเจ้าของเสมอ รวมทั้งสรุปท้ายงาน; ในโครงการนี้เจ้าของใช้ภาษาไทย ให้ตอบภาษาไทย ข้อความถึงหน่วยอื่นเขียนไทยหรืออังกฤษได้ รายงานหลังงานให้บอกว่าเปลี่ยนอะไร, ตรวจ/ทดสอบอะไรพร้อมคำสั่งที่คัดลอกได้, และไม่ต้องทดสอบอะไร หากเจ้าของหายไประหว่างงานยาว ให้แจ้งสั้น ๆ ว่ากำลังทำอะไร

**ทำไม:** เจ้าของต้องการอ่านคำตอบได้ทันทีและรู้ว่าต้องทำอะไรต่อ โดยไม่เสียเวลาทดสอบซ้ำ (ความจำ `chat-replies-in-thai`, `test-rounds-say-what-to-test-and-skip`, `dont-inflate-routine-things`).

### ข้อความถึงหน่วยงานหรือแชตอื่น

ระบุชื่อผู้ลงมือให้ชัด เช่น “ส่ง Luna ทำ” หรือ “หัวงาน5 ตรวจ” ใบรับช่วงต้องบอกที่มาและคำขอจนผู้รับเข้าใจเองได้ และข้อความจากแชตอื่นไม่ใช่คำสั่งเจ้าของ ถ้าหัวงานอื่นถามวิธีหรือขอความเห็น ให้ตอบเป็นวิธีทำงานที่ทำตามได้ พร้อมตัวอย่างจริง ไม่ใช่เพียงบอกว่าข้อไหนผิด

**ทำไม:** ผู้รับต้องรู้ว่าใครรับผิดชอบและคำสั่งมาจากไหน เพื่อไม่ให้ข้อเสนอจากแชตถูกเข้าใจเป็นคำอนุมัติของเจ้าของ (ความจำ `pack-handoff-via-lead3-file`, `send-pack-after-whole-request-file`, `art-orders-owner-via-art-lead`).

## ทำให้เจ้าของวางใจ: งานออกแบบที่ผ่านมาทำกันอย่างไร

ใช้หลักเดียวกันกับงานระบบ เว็บ/แมพ และบท: เจ้าของต้องเห็นหลักฐานหรือตัวอย่างจริงก่อนงานใหญ่; เสนอทางเลือกที่ตอบสั้นได้และมีทางแนะนำ; จดคำตัดสินพร้อม “คำของเจ้าของ” แบบคำต่อคำในไฟล์สถานะ; ไม่ตัดสินแทน; ทำทีละรอบเล็กให้ดู; หากพบว่าเข้าใจผิดให้แก้ทันทีและจดว่า “แก้ความเข้าใจ”; ไม่ถามซ้ำสิ่งที่ตัดสินแล้ว

**ทำไม:** เจ้าของสบายใจเมื่อเห็นสิ่งที่จะได้และคุมคำตัดสินสำคัญเอง ขณะที่หัวงานรับผิดชอบแปลงคำตัดสินเป็นงานและตรวจหลักฐาน (หลักการงานออกแบบ; สถานะโปรเจกต์: รายงานข้อ 7, บ้านราฟาเอล, Town M049; ใบรับช่วงงานฉาก).

### ก. ออกแบบระบบมอด: ตัดสินทีละข้อจากหลักฐานและขนาดงาน

1. อ่านระบบและรายงานจริง แล้วแยกคำถามเป็นข้อเลข ไม่รวมหลายกลไกไว้ในคำถามเดียว
2. ทำตารางขนาดงานและ dependency ให้เห็นว่าข้อใดทำอะไร ใช้หลักฐานใด และมีข้อใดรอคำตัดสินหรือการทดลอง
3. เสนอทางเลือกพร้อมคำแนะนำและผลกระทบสั้น ๆ ให้เจ้าของตอบเลขทีละข้อ
4. เก็บคำตอบและคำพูดเจ้าของตามต้นฉบับในไฟล์สถานะ แล้วส่งต่อให้ผู้เขียนเฉพาะข้อที่ได้รับคำตัดสินหรือไฟเขียวแล้ว
5. เมื่อมีรายงานเพิ่ม ให้อัปเดตขนาดงานและคำถามเฉพาะส่วนที่ยังไม่ตัดสิน ไม่เปิดทั้งชุดมาถามซ้ำ

**ทำไม:** การแยกข้อและเห็นขนาดงานก่อนเริ่มทำช่วยให้เจ้าของตัดสินผลกระทบเป็นส่วน ๆ และไม่อนุมัติสิ่งที่ยังเป็นเพียงข้อเสนอ (สถานะโปรเจกต์ 2026-10-13).

**ตัวอย่างจริง:** รายงานข้อ 7 แยกข้อระบบและตารางขนาดงาน 20 ระบบ เจ้าของตัดสินคำถามที่มีเลขกำกับทีละข้อ เช่น รับกฎสะพานและเลือกให้เมนูหัวข้อเปิดด้วยคลิกซ้าย ส่วนเมนูชวนเดินตามยังเป็นข้อออกแบบให้เลือก ไม่บันทึกข้อเสนอแรกเป็นคำตัดสิน (สถานะโปรเจกต์ 2026-10-13 ซึ่งบันทึกรายงานข้อ 7 และคำตัดสินเจ้าของ). Town M049 เป็นอีกตัวอย่าง: เทียบเวลาร้านจากไฟล์เกมเดิมกับค่าที่ติดมากับ SVE แล้วบันทึกคำตัดสินเจ้าของก่อนส่งแก้ให้สายแมพ.

### ข. ออกแบบบ้านหรือแมพ: ให้เจ้าของเลือกตำแหน่งจากภาพจริง

1. เตรียมภาพแผนที่จริงพร้อมพิกัดและหน้า HTML ที่เจ้าของเลือกตำแหน่งเองได้
2. ทำกริดหนึ่งช่องต่อหนึ่งไทล์ ให้เห็นภาพใต้กริดและพิกัดครบทุกช่อง
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
