HoneyKung/metorobot/Project/images/body_face_coordination.png

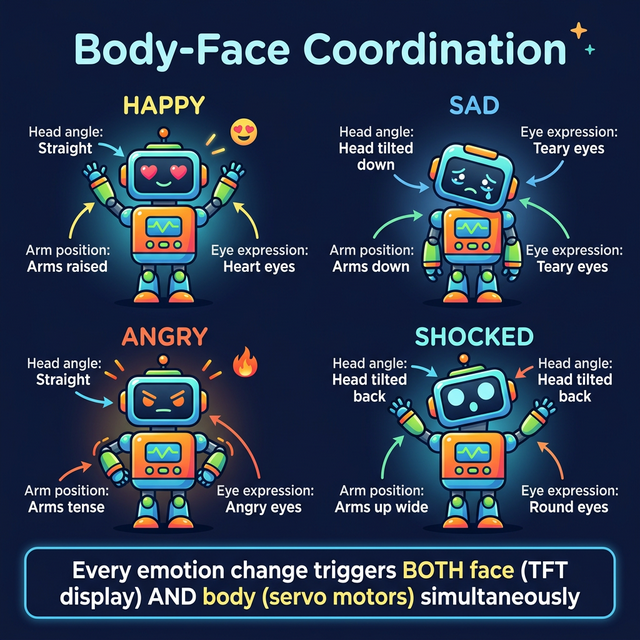
Project/images/body_face_coordination.png
