HoneyKung/metorobot/Project/images/ema_smoothing.png

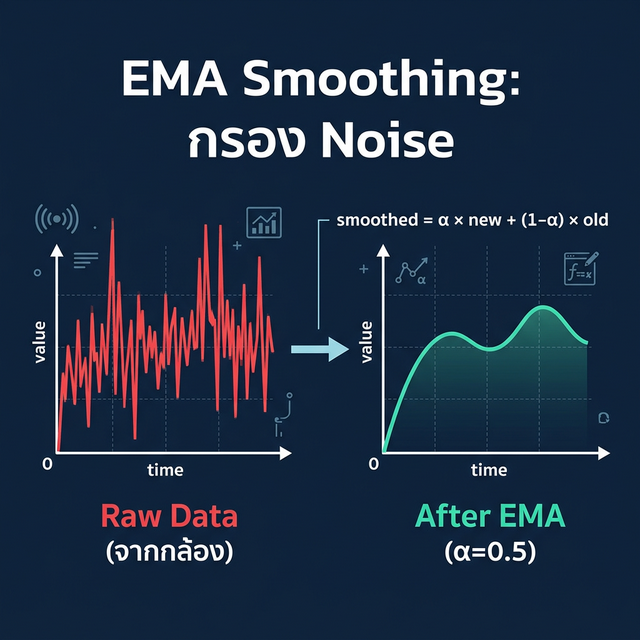
Project/images/ema_smoothing.png
