HoneyKung/metorobot/Project/images/emotion_state_machine.png

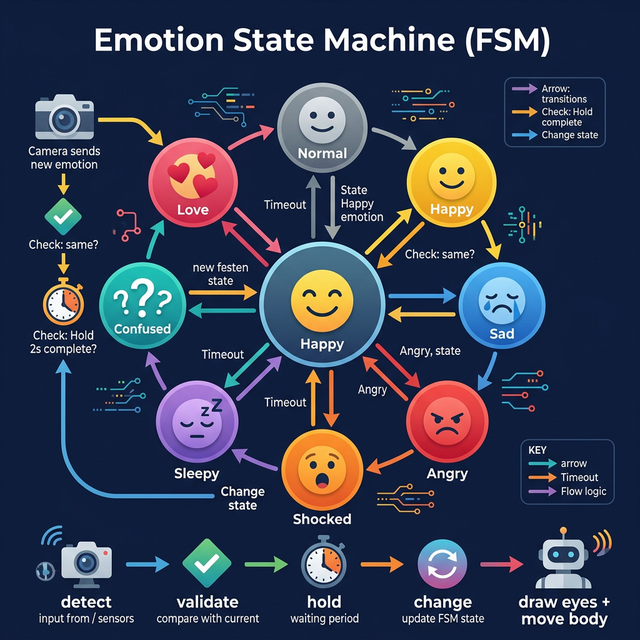
Project/images/emotion_state_machine.png
