HoneyKung/metorobot/Project/images/esp_dl_pipeline.png

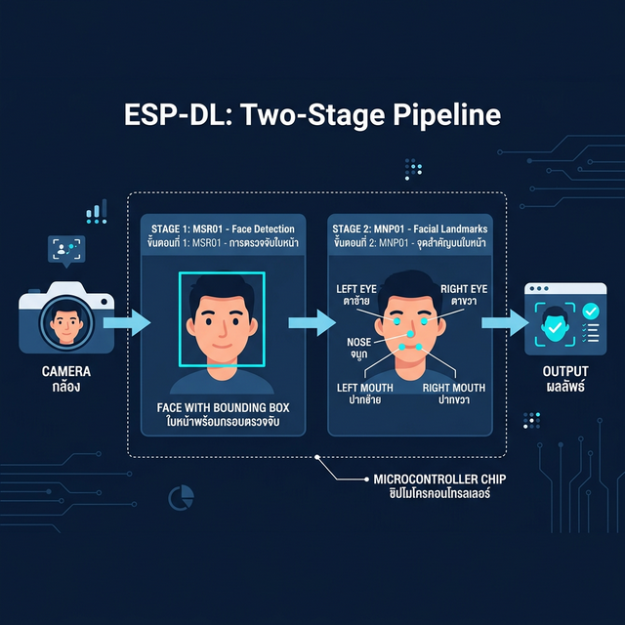
Project/images/esp_dl_pipeline.png
