HoneyKung/metorobot/Project/images/hysteresis_diagram.png

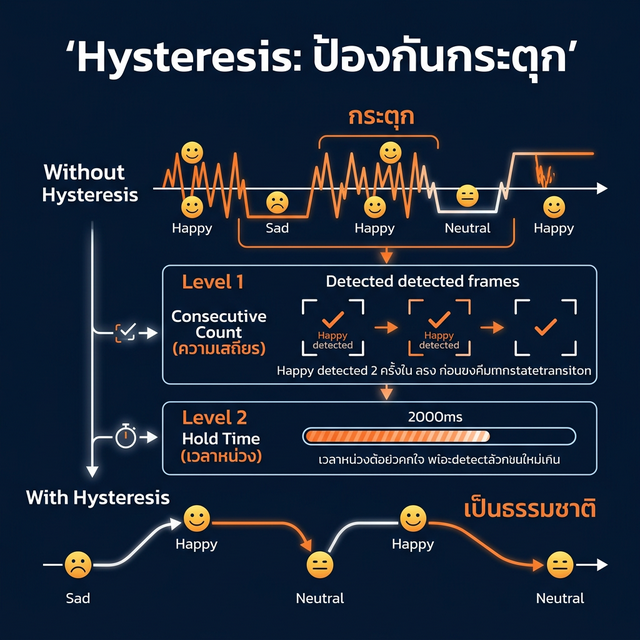
Project/images/hysteresis_diagram.png
