HoneyKung/metorobot/Project/images/system_architecture.png

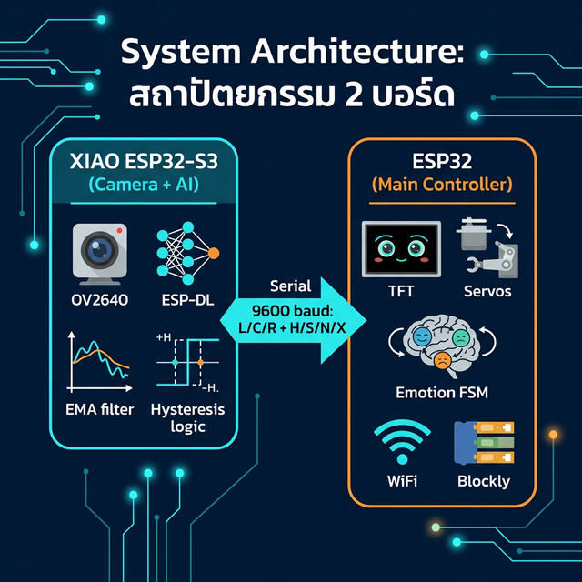
Project/images/system_architecture.png
