HoneyKung/metorobot/Robo/Part Robot/งานโค้ด_2026-11/ภาพ_ทวิน3D/03_หัวหันพยัก.png

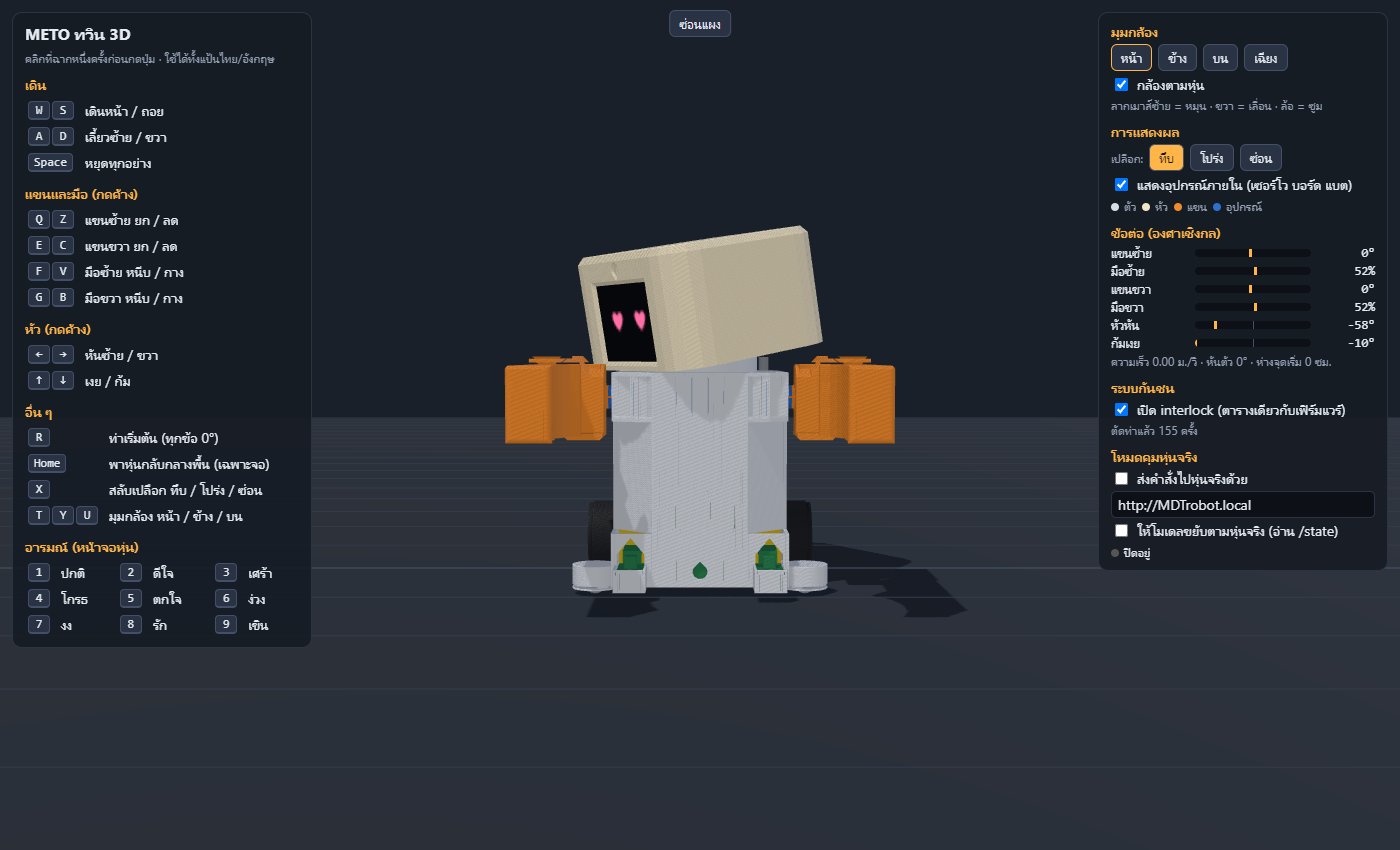
Robo/Part Robot/งานโค้ด_2026-11/ภาพ_ทวิน3D/03_หัวหันพยัก.png
