HoneyKung/metorobot/Robo/Part Robot/งานโค้ด_2026-11/ภาพ_ทวิน3D/05_ซ่อนเปลือก_มุมบน.png

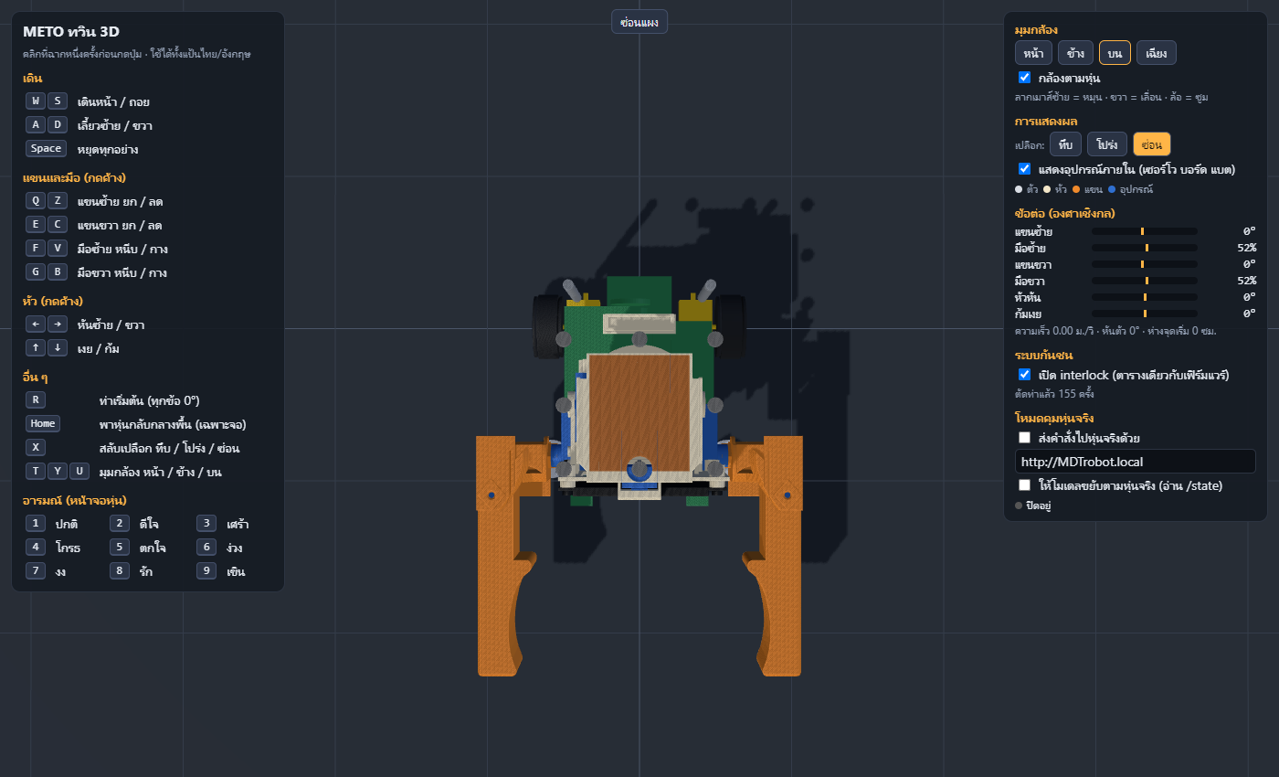
Robo/Part Robot/งานโค้ด_2026-11/ภาพ_ทวิน3D/05_ซ่อนเปลือก_มุมบน.png
