HoneyKung/metorobot/Robo/Part Robot/งานโค้ด_2026-11/ภาพ_เว็บบล็อก/08_Operator.png

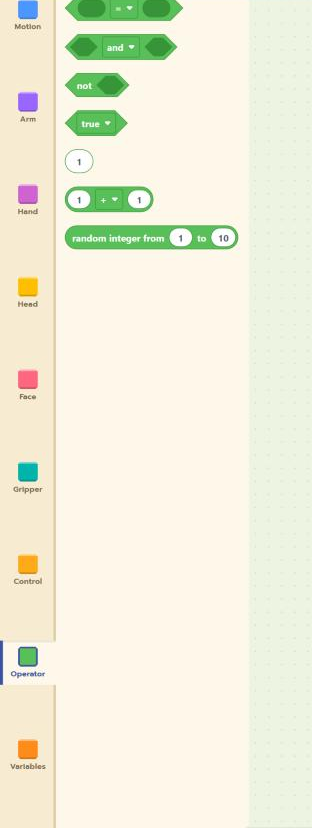
Robo/Part Robot/งานโค้ด_2026-11/ภาพ_เว็บบล็อก/08_Operator.png
