HoneyKung/metorobot/Robo/Part Robot/งานโค้ด_2026-11/ภาพ_เว็บบล็อก/09_Variables.png

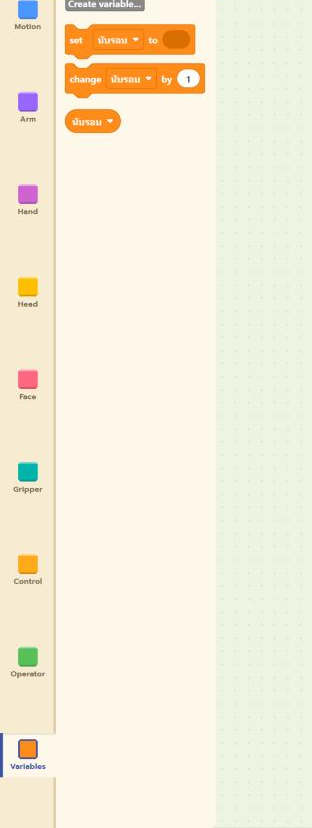
Robo/Part Robot/งานโค้ด_2026-11/ภาพ_เว็บบล็อก/09_Variables.png
