HoneyKung/metorobot/Robo/Part Robot/งานโค้ด_2026-11/ภาพ_เว็บบล็อก/10_DigitalTwin_ก้มเงย_แขน_มือ.png

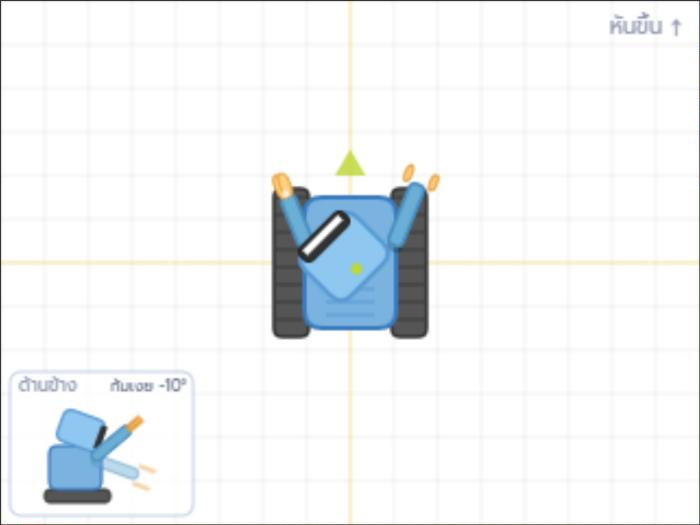
Robo/Part Robot/งานโค้ด_2026-11/ภาพ_เว็บบล็อก/10_DigitalTwin_ก้มเงย_แขน_มือ.png
