HoneyKung/metorobot/Robo/Part Robot/งานโค้ด_2026-11/ภาพ_เว็บบล็อก/11_รันโปรแกรมบล็อกใหม่.jpg

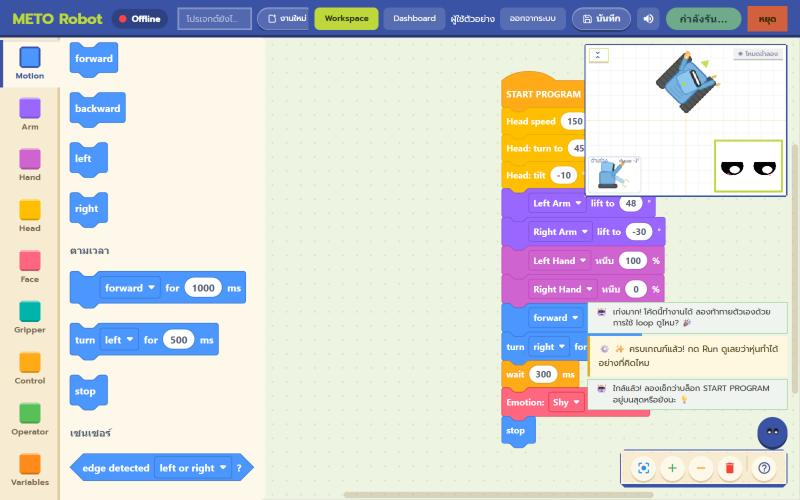
Robo/Part Robot/งานโค้ด_2026-11/ภาพ_เว็บบล็อก/11_รันโปรแกรมบล็อกใหม่.jpg
