HoneyKung/metorobot/Robo/Part Robot/ภาพเจ้าของ/51_จอจริง_หลัง_แดงV1.1.jpg

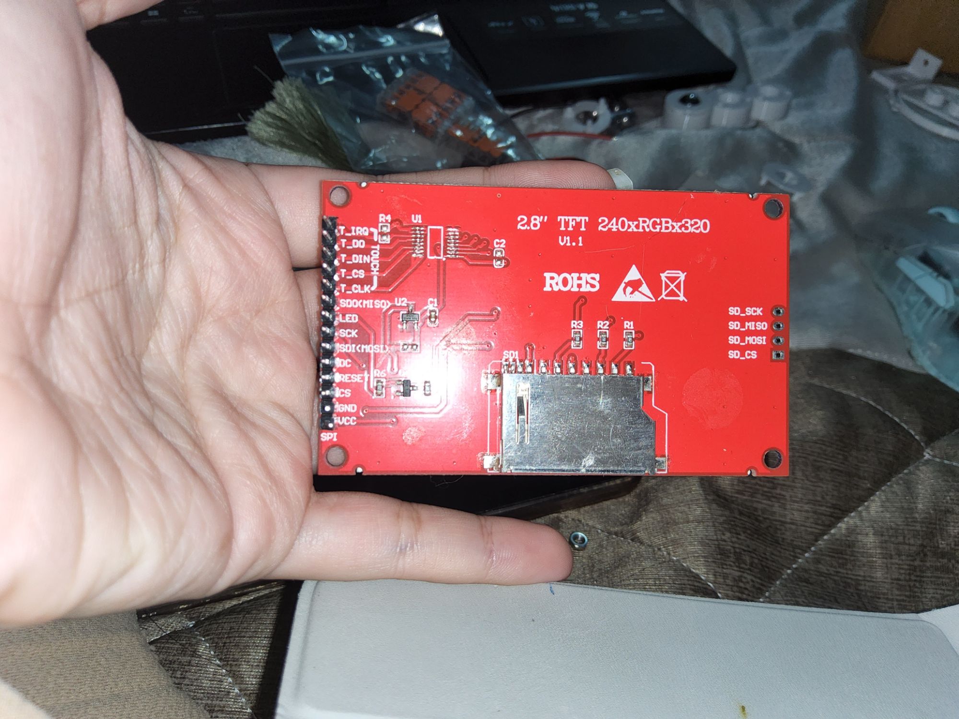
Robo/Part Robot/ภาพเจ้าของ/51_จอจริง_หลัง_แดงV1.1.jpg
