HoneyKung/metorobot/Robo/Part Robot/ภาพเจ้าของ/52_XIAO_กล้องจริง_1.jpg

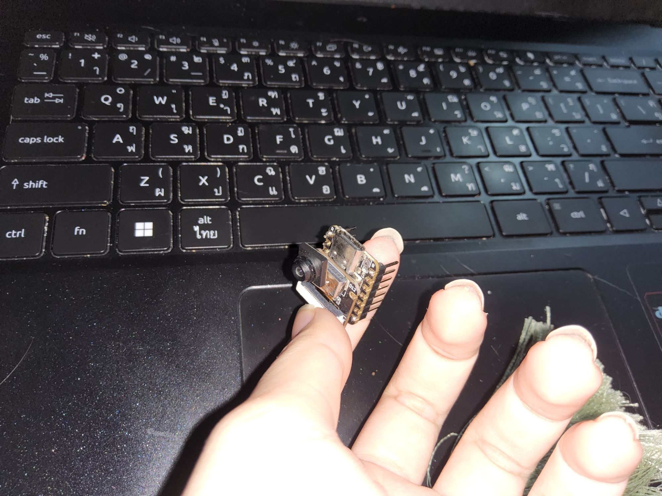
Robo/Part Robot/ภาพเจ้าของ/52_XIAO_กล้องจริง_1.jpg
