HoneyKung/metorobot/Robo/Part Robot/ภาพเจ้าของ/53_XIAO_กล้องจริง_2.jpg

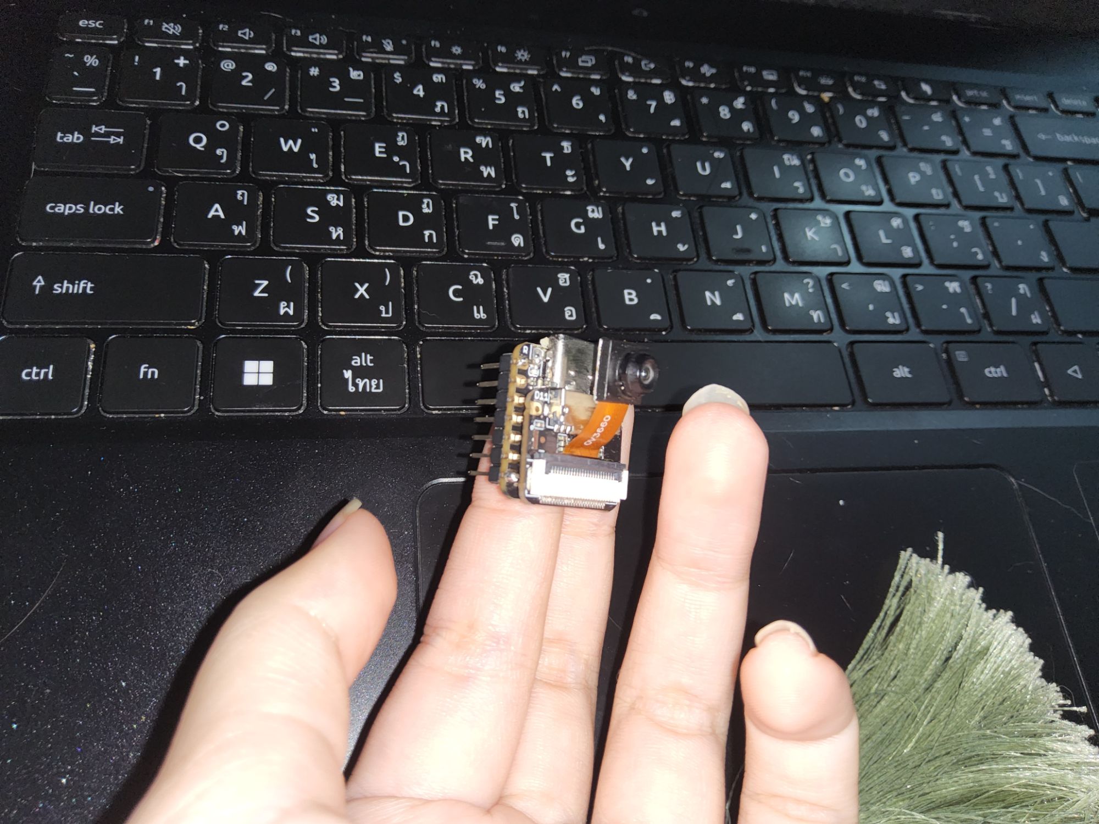
Robo/Part Robot/ภาพเจ้าของ/53_XIAO_กล้องจริง_2.jpg
