HoneyKung/metorobot/Robo/Part Robot/ภาพเจ้าของ/54_XIAO_กล้องจริง_3.jpg

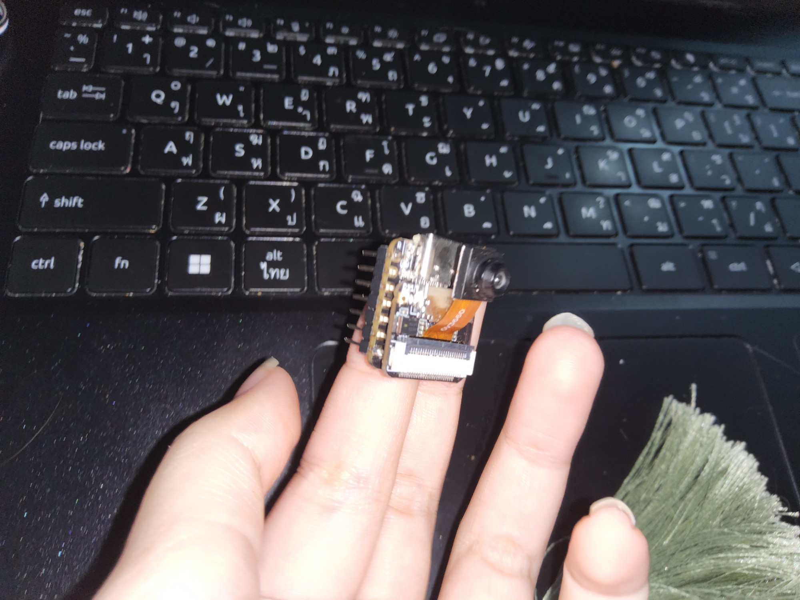
Robo/Part Robot/ภาพเจ้าของ/54_XIAO_กล้องจริง_3.jpg
