HoneyKung/metorobot/Robo/Part Robot/ภาพเจ้าของ/60_xiao_dock_สไลเซอร์.png

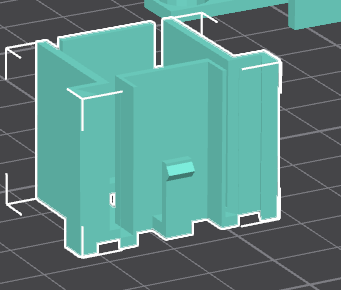
Robo/Part Robot/ภาพเจ้าของ/60_xiao_dock_สไลเซอร์.png
