HoneyKung/metorobot/Robo/Part Robot/ภาพเจ้าของ/61_ตัวจับจอ_ช่องกล้อง.png

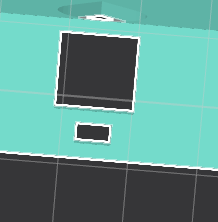
Robo/Part Robot/ภาพเจ้าของ/61_ตัวจับจอ_ช่องกล้อง.png
