HoneyKung/metorobot/Robo/Part Robot/ภาพเจ้าของ/62_ชั้น2_สไลเซอร์.png

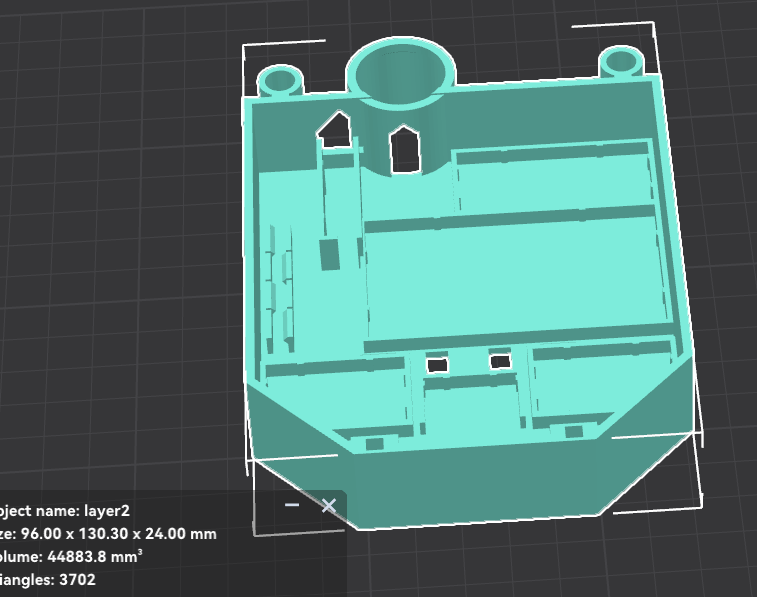
Robo/Part Robot/ภาพเจ้าของ/62_ชั้น2_สไลเซอร์.png
