HoneyKung/metorobot/Robo/Part Robot/ภาพเจ้าของ/63_XIAO_แนบหลังจอ_1.jpg

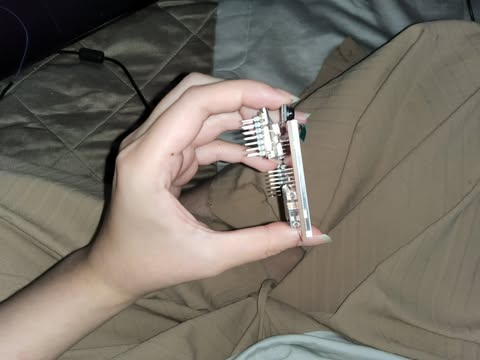
Robo/Part Robot/ภาพเจ้าของ/63_XIAO_แนบหลังจอ_1.jpg
