HoneyKung/metorobot/Robo/Part Robot/ภาพเจ้าของ/64_XIAO_แนบหลังจอ_2.jpg

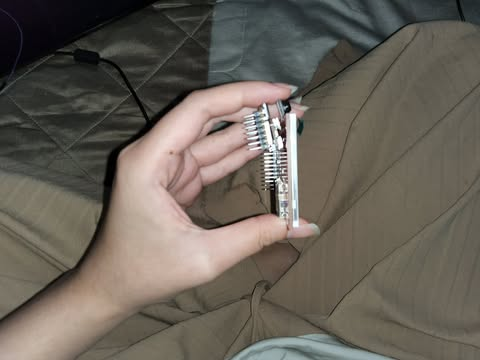
Robo/Part Robot/ภาพเจ้าของ/64_XIAO_แนบหลังจอ_2.jpg
