HoneyKung/metorobot/Robo/Part Robot/ภาพเจ้าของ/65_ชิ้นที่พิมพ์มา_รูกล้อง+หมุด.jpg

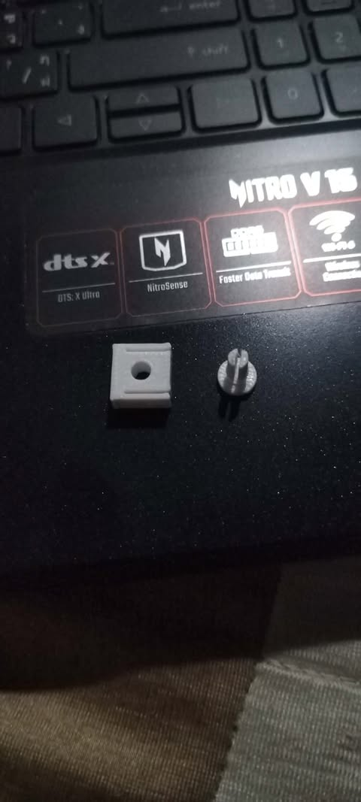
Robo/Part Robot/ภาพเจ้าของ/65_ชิ้นที่พิมพ์มา_รูกล้อง+หมุด.jpg
