HoneyKung/metorobot/Robo/Part Robot/ภาพเจ้าของ/68_ชั้น4_พื้นรอง996นูน.png

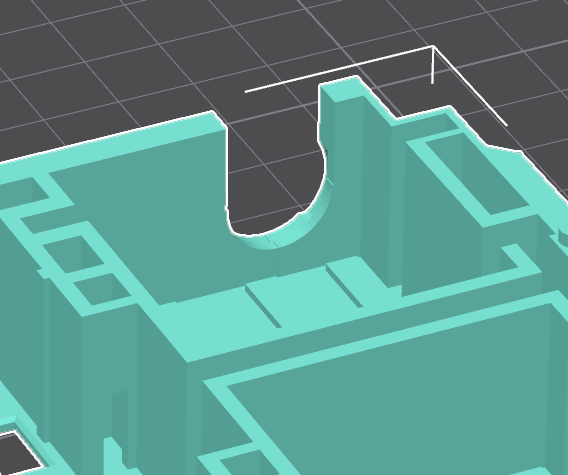
Robo/Part Robot/ภาพเจ้าของ/68_ชั้น4_พื้นรอง996นูน.png
