HoneyKung/metorobot/Robo/Part Robot/ภาพเจ้าของ/69_ชั้น2_รูสวิตช์ไม่มีท่อ.png

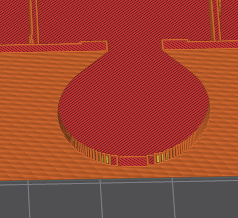
Robo/Part Robot/ภาพเจ้าของ/69_ชั้น2_รูสวิตช์ไม่มีท่อ.png
