HoneyKung/metorobot/Robo/Part Robot/ภาพเจ้าของ/77_เส้นตกใจการ์ตูน_ตัวอย่าง.png

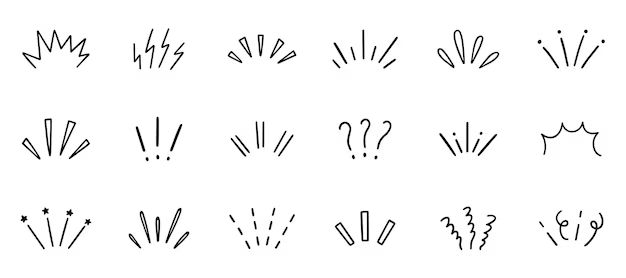
Robo/Part Robot/ภาพเจ้าของ/77_เส้นตกใจการ์ตูน_ตัวอย่าง.png
