HoneyKung/metorobot/Robo/Part Robot/ภาพเจ้าของ/79_หน้าตกใจ_เจ้าของวาด.png

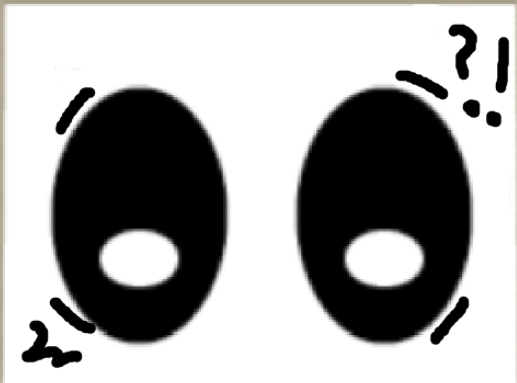
Robo/Part Robot/ภาพเจ้าของ/79_หน้าตกใจ_เจ้าของวาด.png
