HoneyKung/metorobot/Robo/Part Robot/ภาพเจ้าของ/83_ตำแหน่งลูกล้อที่ต้องการ.png

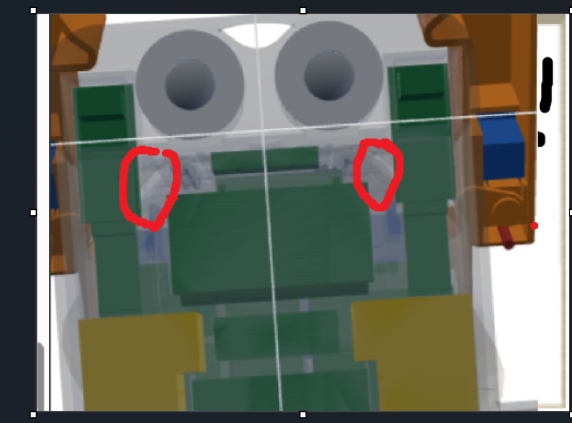
Robo/Part Robot/ภาพเจ้าของ/83_ตำแหน่งลูกล้อที่ต้องการ.png
