HoneyKung/metorobot/Robo/Part Robot/ภาพเจ้าของ/MPR121_V12_ขนาด.png

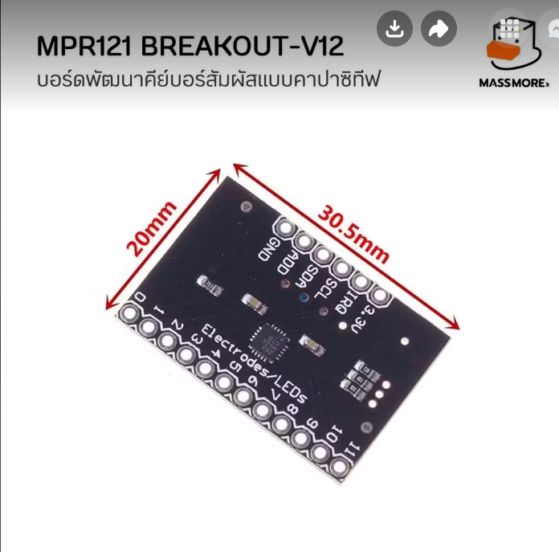
Robo/Part Robot/ภาพเจ้าของ/MPR121_V12_ขนาด.png
