HoneyKung/metorobot/Robo/Part Robot/ภาพเจ้าของ/XIAO_ESP32S3_Sense_ตัวจริง.png

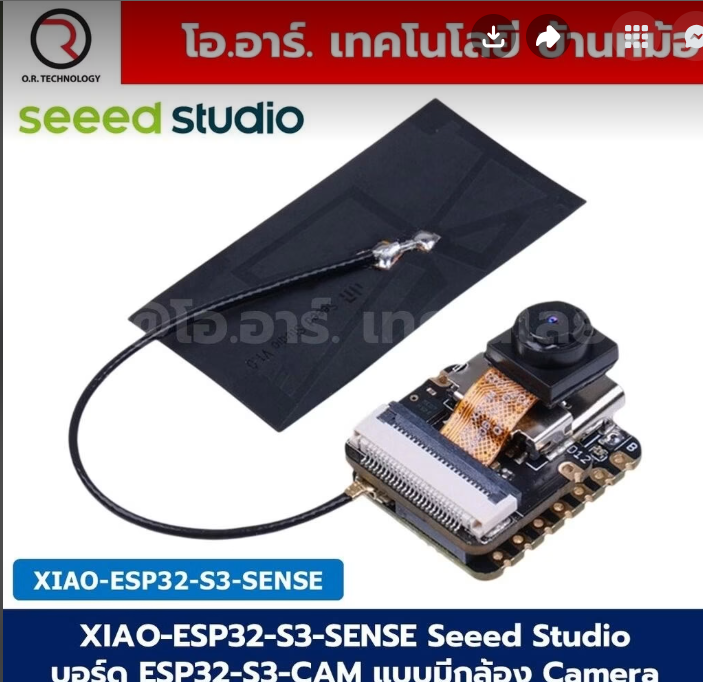
Robo/Part Robot/ภาพเจ้าของ/XIAO_ESP32S3_Sense_ตัวจริง.png
