HoneyKung/metorobot/Robo/Part Robot/ภาพเจ้าของ/ภาพที่14_ออกแบบดวงตา9แบบ_จากรายงาน.png

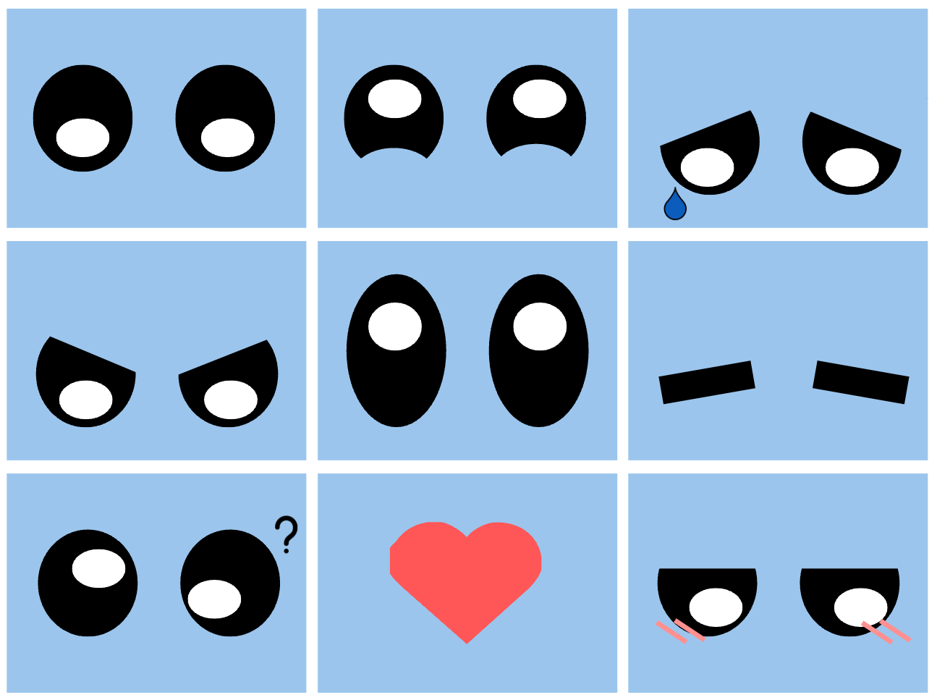
Robo/Part Robot/ภาพเจ้าของ/ภาพที่14_ออกแบบดวงตา9แบบ_จากรายงาน.png
