HoneyKung/metorobot/Robo/Part Robot/ภาพเจ้าของ/หัว_คอ_tinkercad_2026-11-03.png

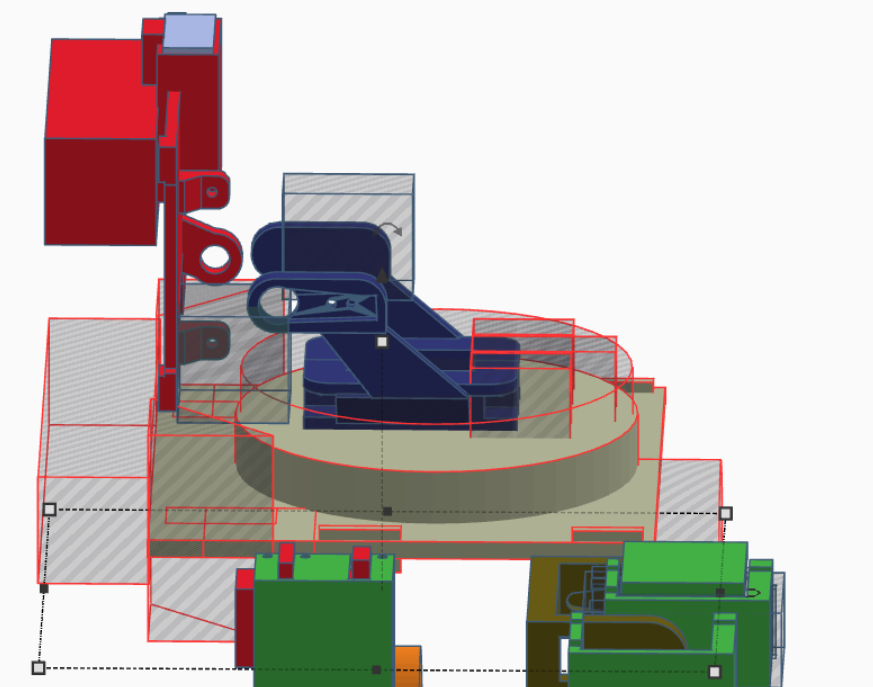
Robo/Part Robot/ภาพเจ้าของ/หัว_คอ_tinkercad_2026-11-03.png
