HoneyKung/metorobot/Robo/Part Robot/ภาพเจ้าของ/อุปกรณ์จริง_2026-11-04_43.jpg

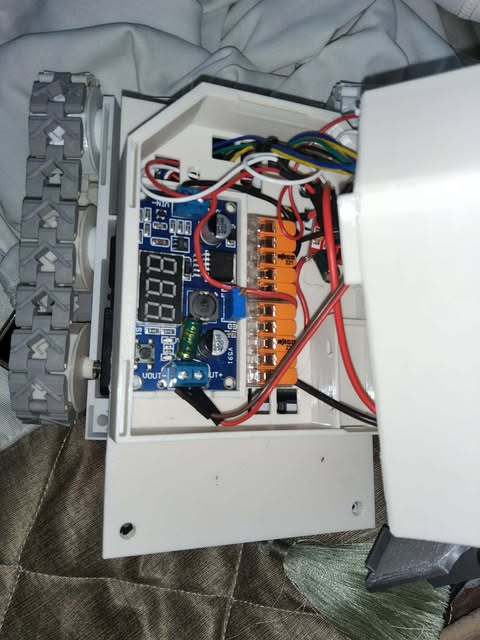
Robo/Part Robot/ภาพเจ้าของ/อุปกรณ์จริง_2026-11-04_43.jpg
