HoneyKung/metorobot/slide-shots/01-workspace-program.png

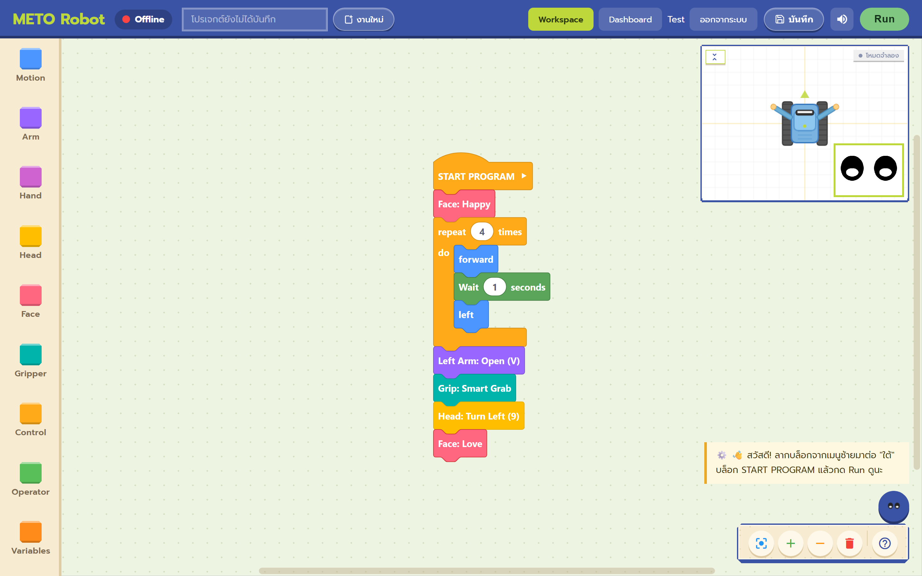
slide-shots/01-workspace-program.png
