HoneyKung/metorobot/slide-shots/02-palette-face.png

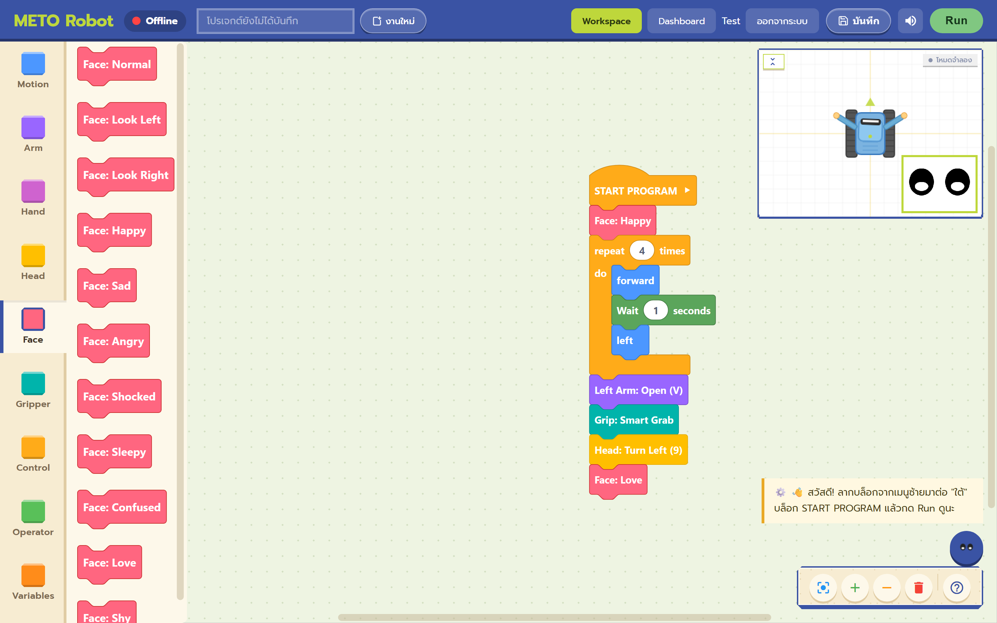
slide-shots/02-palette-face.png
