HoneyKung/metorobot/slide-shots/03-sim-stage.png

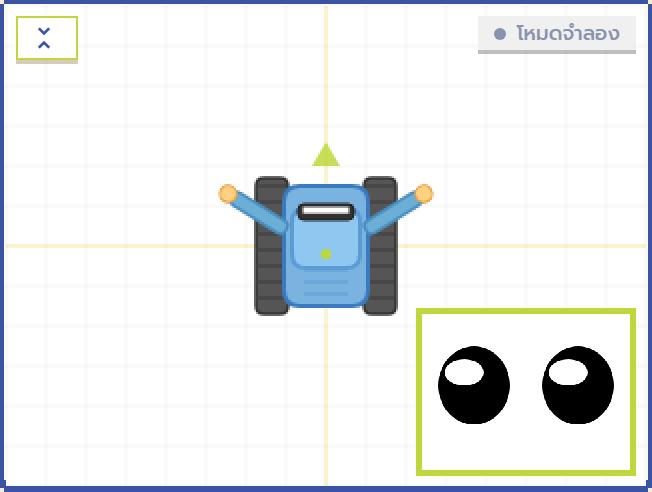
slide-shots/03-sim-stage.png
