HoneyKung/metorobot/slide-shots/04-sim-face.png

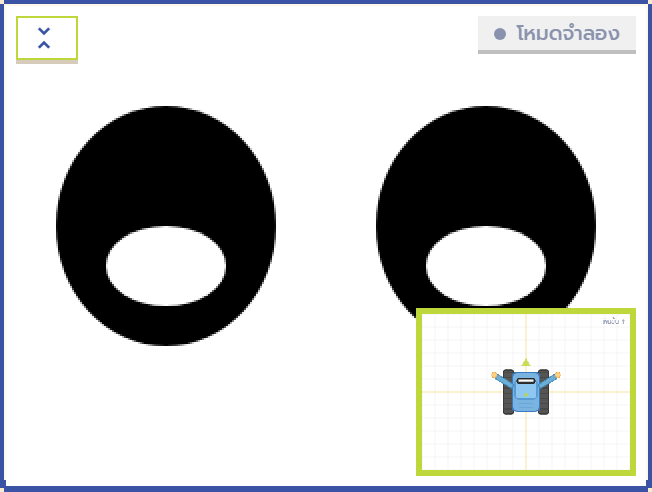
slide-shots/04-sim-face.png
