HoneyKung/metorobot/slide-shots/07-login-modal.png

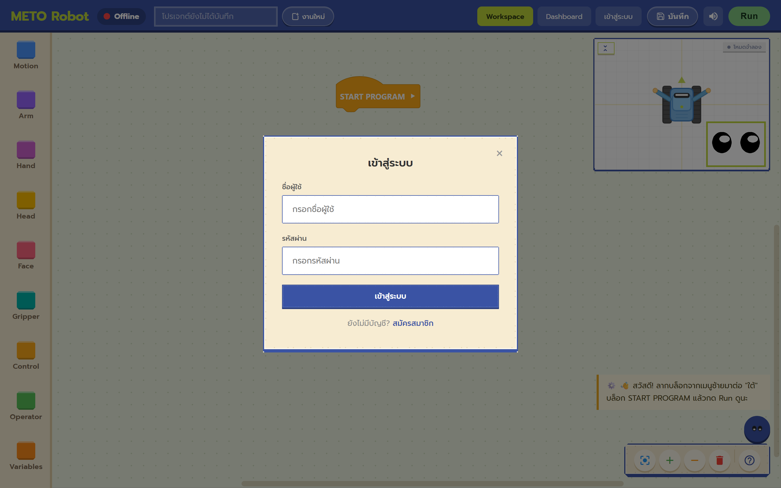
slide-shots/07-login-modal.png
