HoneyKung/metorobot/slide-shots/07b-register-modal.png

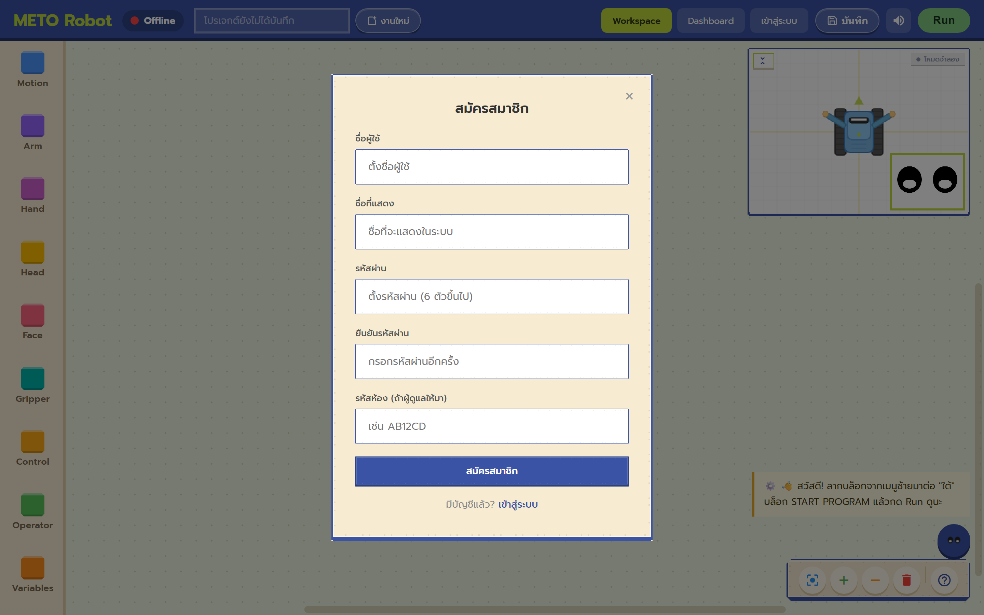
slide-shots/07b-register-modal.png
