HoneyKung/metorobot/slide-shots/09-dashboard-hub.png

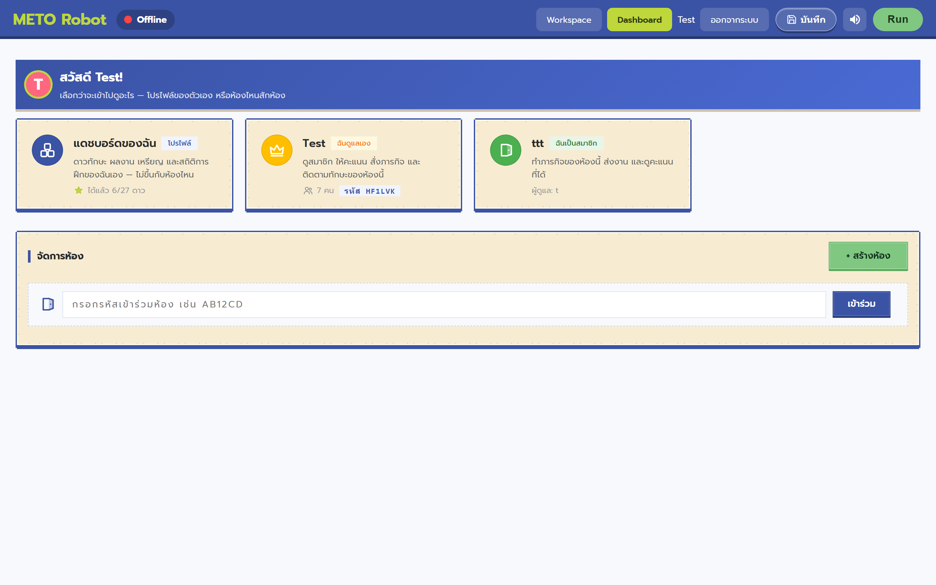
slide-shots/09-dashboard-hub.png
