HoneyKung/metorobot/slide-shots/10-player-map.png

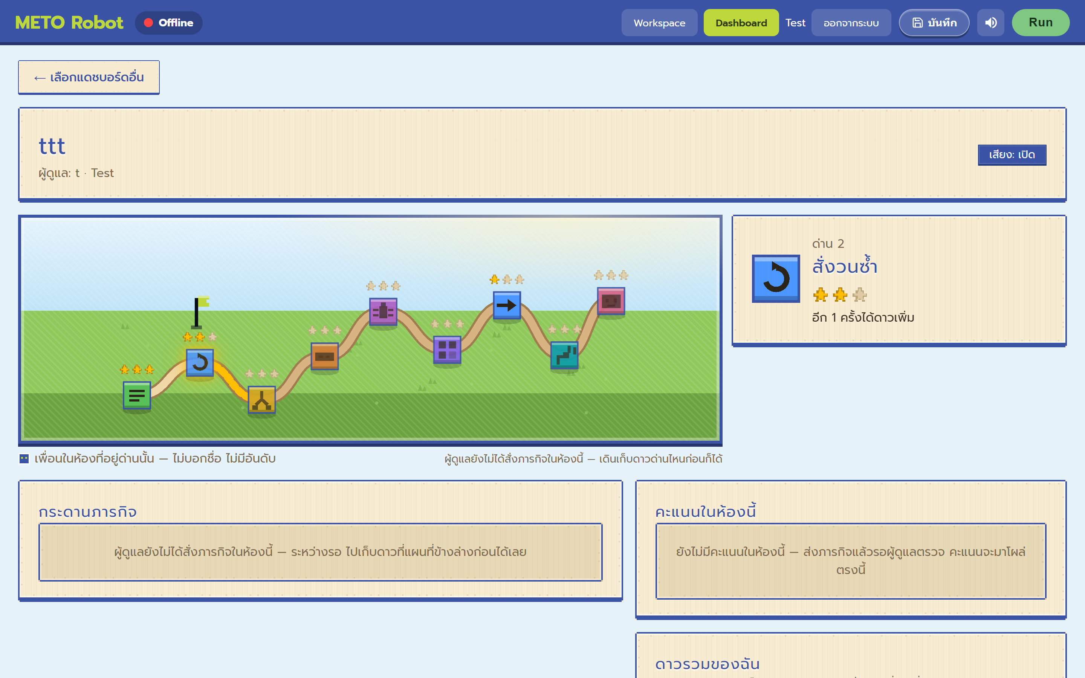
slide-shots/10-player-map.png
