HoneyKung/metorobot/slide-shots/11-player-stars.png

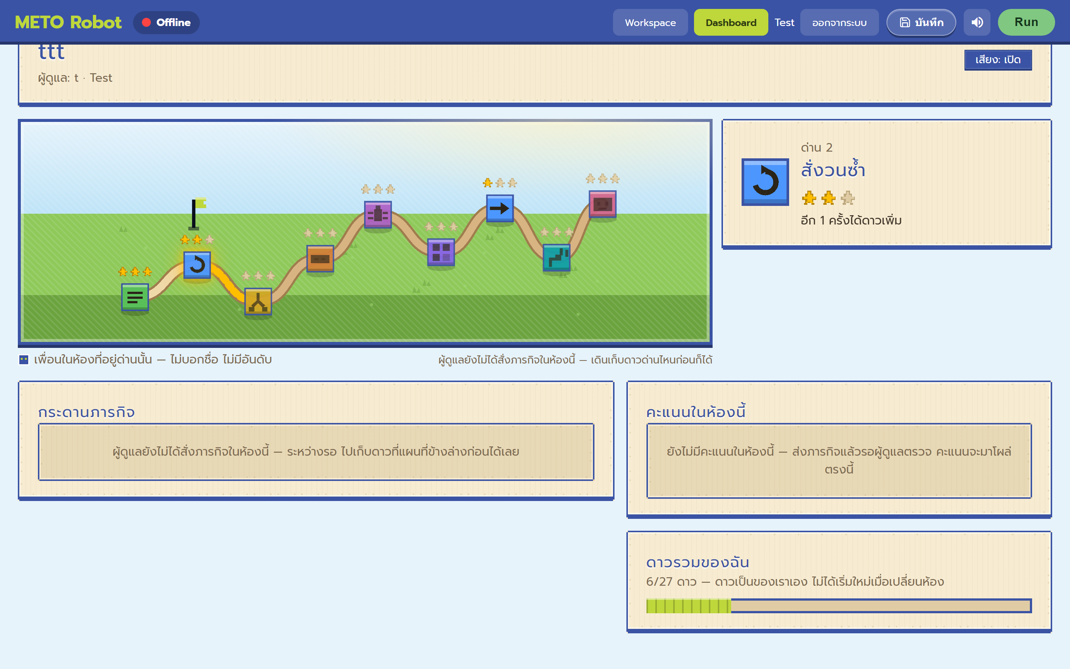
slide-shots/11-player-stars.png
