HoneyKung/metorobot/slide-shots/12-face-picker.png

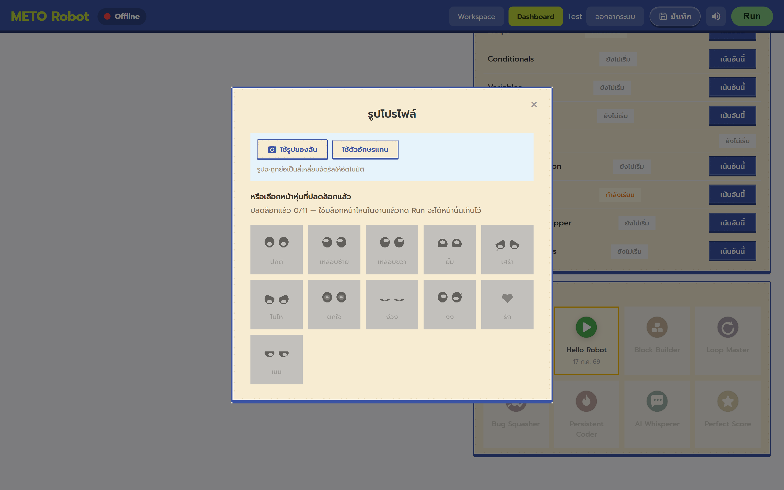
slide-shots/12-face-picker.png
