HoneyKung/metorobot/slide-shots/13-teacher-room-top.png

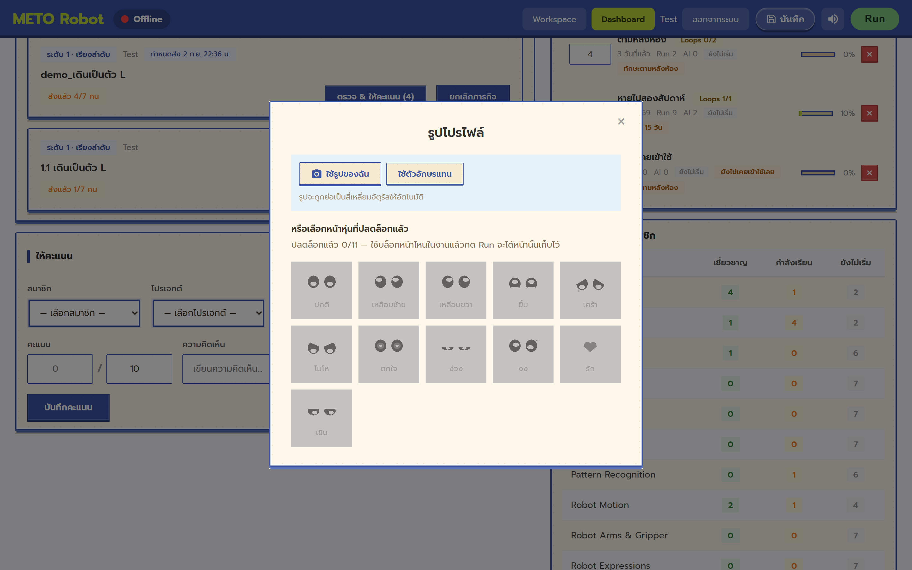
slide-shots/13-teacher-room-top.png
