HoneyKung/metorobot/slide-shots/14-teacher-roster.png

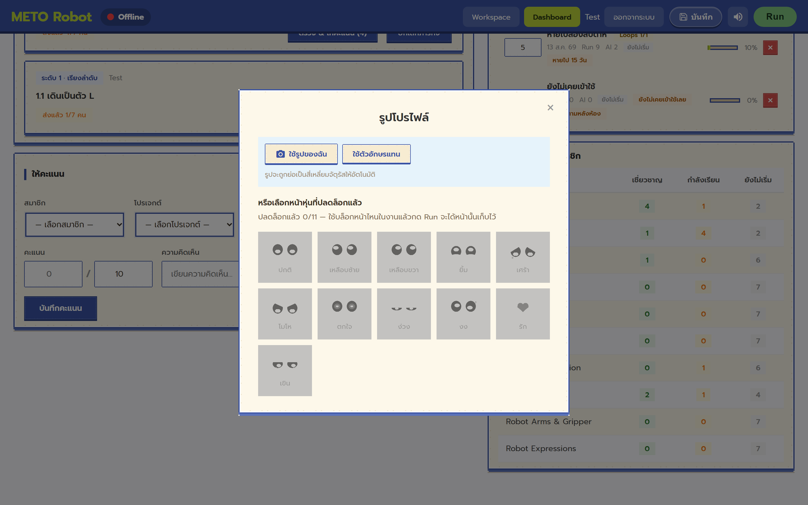
slide-shots/14-teacher-roster.png
