HoneyKung/metorobot/slide-shots/15-teacher-assign-form.png

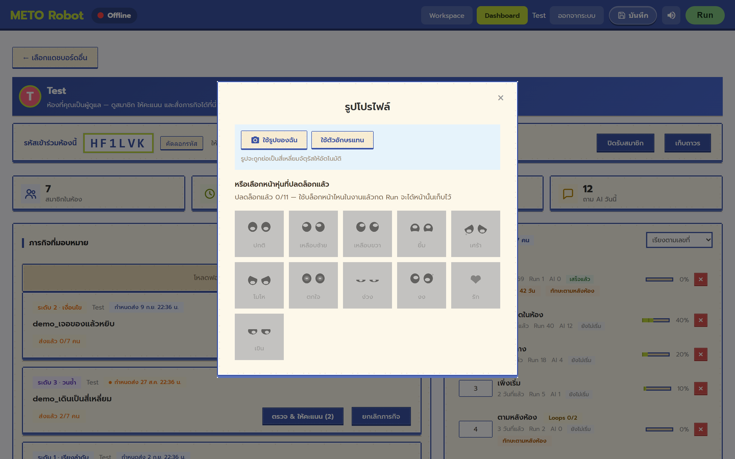
slide-shots/15-teacher-assign-form.png
