HoneyKung/metorobot/slide-shots/17-student-detail.png

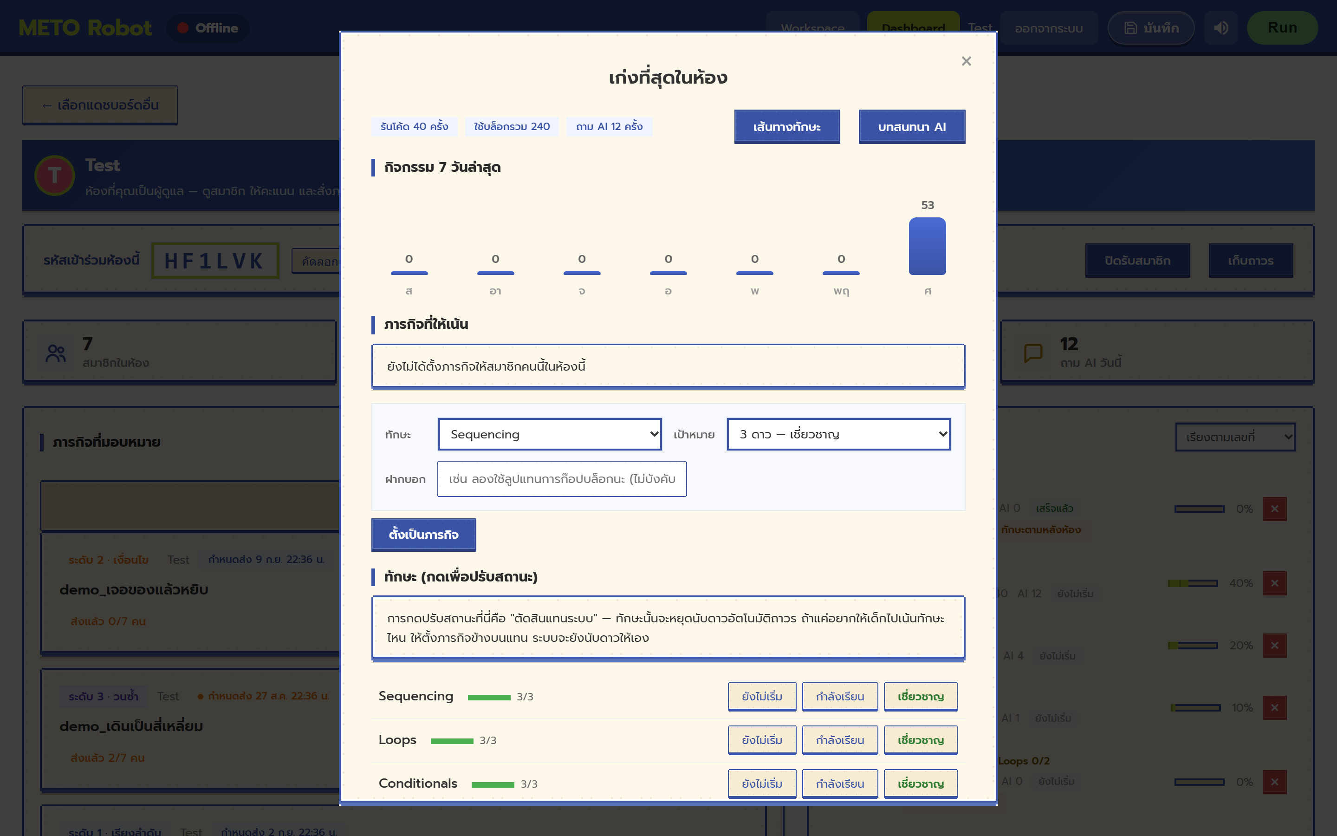
slide-shots/17-student-detail.png
