HoneyKung/metorobot/slide-shots/18-my-dashboard-top.png

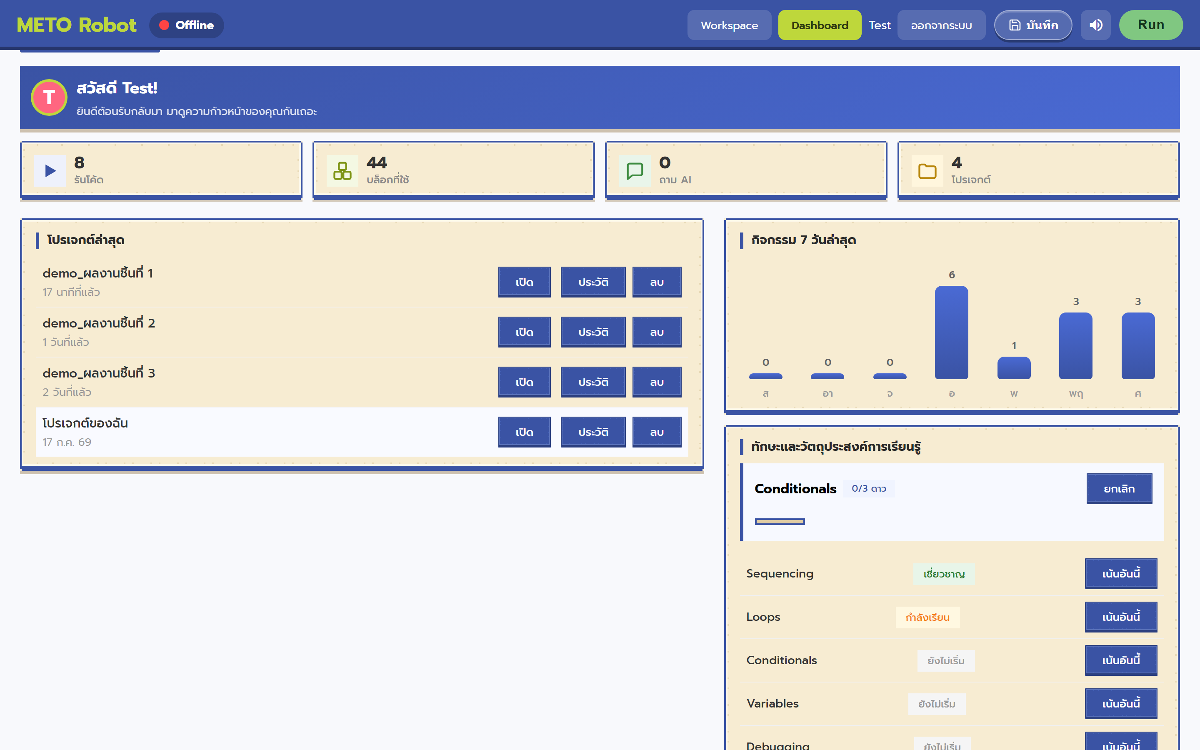
slide-shots/18-my-dashboard-top.png
