HoneyKung/metorobot/slide-shots/19-my-dashboard-more.png

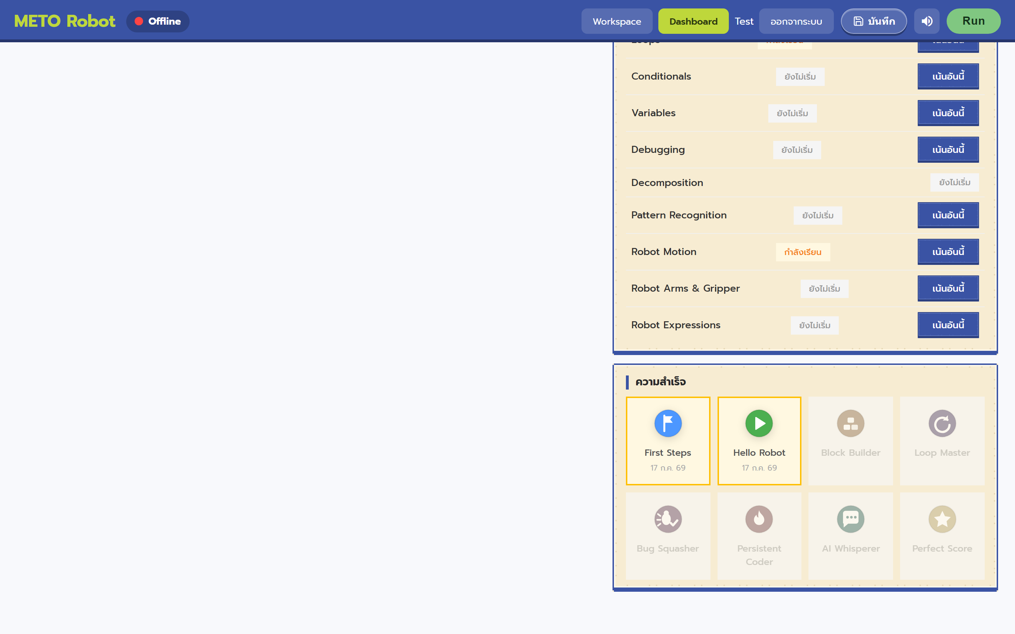
slide-shots/19-my-dashboard-more.png
