HoneyKung/metorobot/slide-shots/20-create-classroom.png

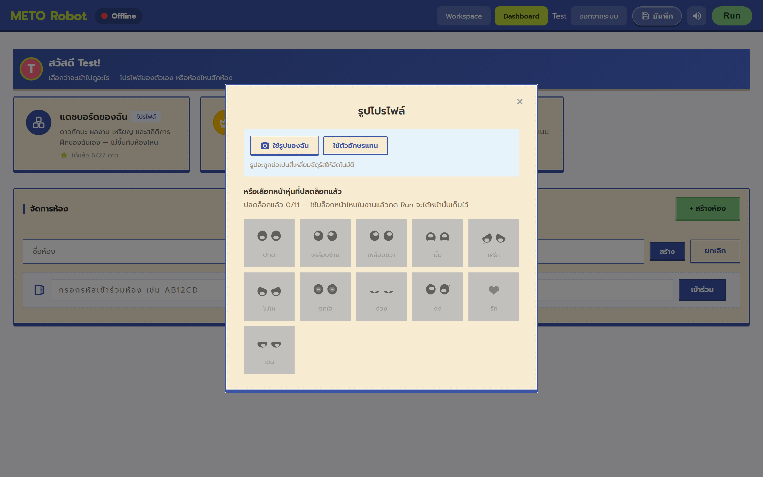
slide-shots/20-create-classroom.png
