HoneyKung/metorobot/static/sprites/back/ArmLeft/back_ArmLeft_Close_Center.png

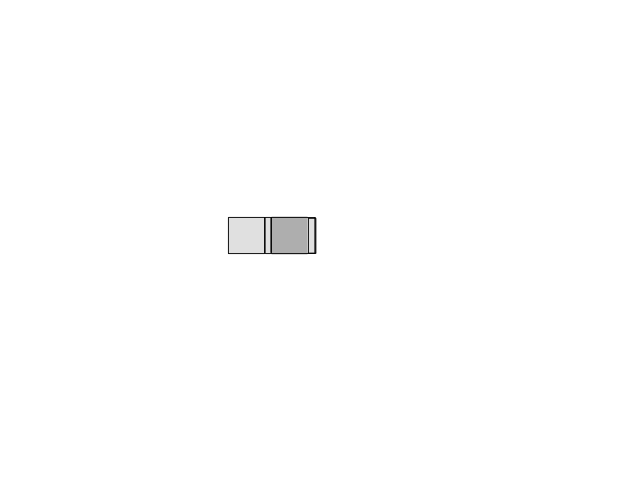
static/sprites/back/ArmLeft/back_ArmLeft_Close_Center.png
