HoneyKung/metorobot/static/sprites/back/ArmLeft/back_ArmLeft_Open_Down.png

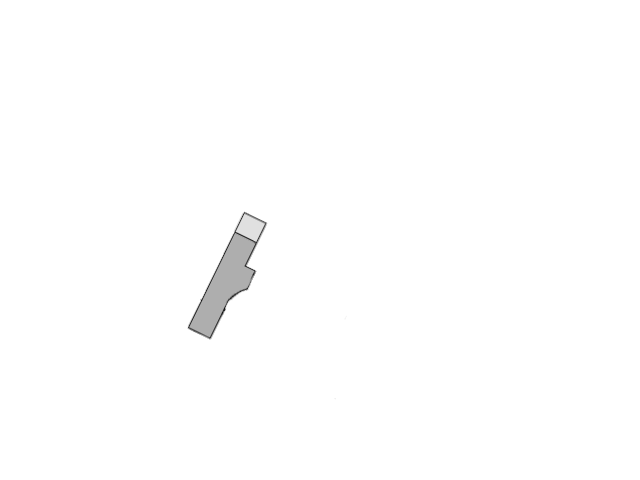
static/sprites/back/ArmLeft/back_ArmLeft_Open_Down.png
