HoneyKung/metorobot/static/sprites/back/ArmLeft/back_ArmLeft_Open_Up.png

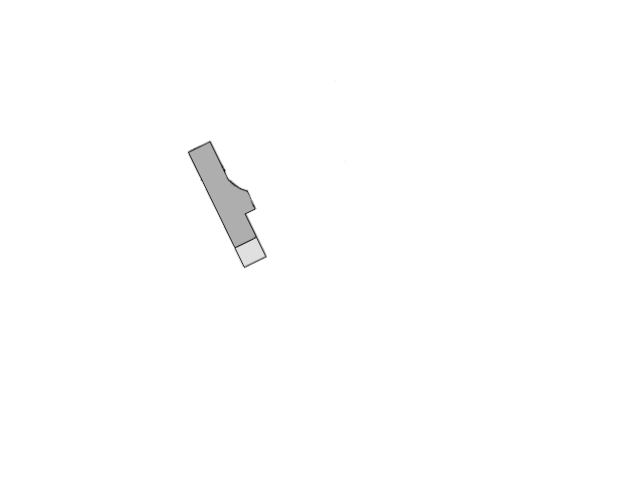
static/sprites/back/ArmLeft/back_ArmLeft_Open_Up.png
