HoneyKung/metorobot/static/sprites/back/ArmRight/back_ArmRight_Close_Center.png

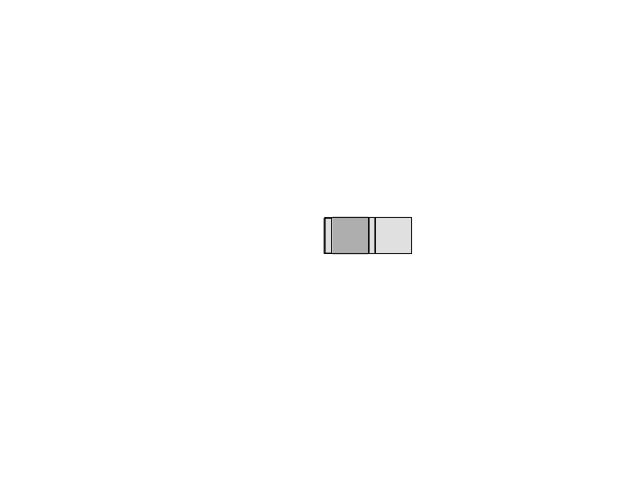
static/sprites/back/ArmRight/back_ArmRight_Close_Center.png
