HoneyKung/metorobot/static/sprites/back/Base/back_Base.png

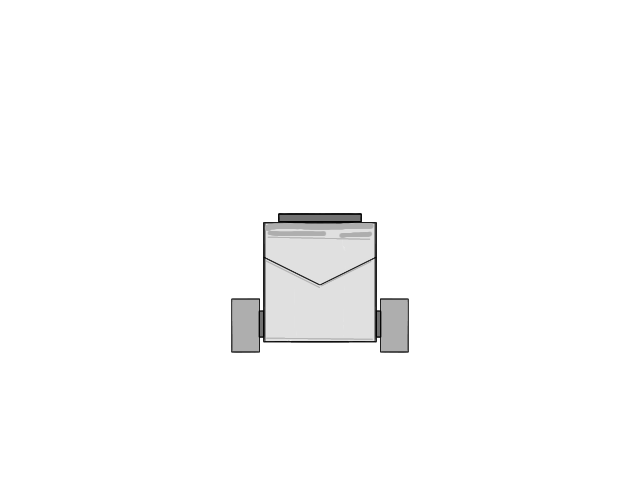
static/sprites/back/Base/back_Base.png
