HoneyKung/metorobot/static/sprites/back/Head/back_Head.png

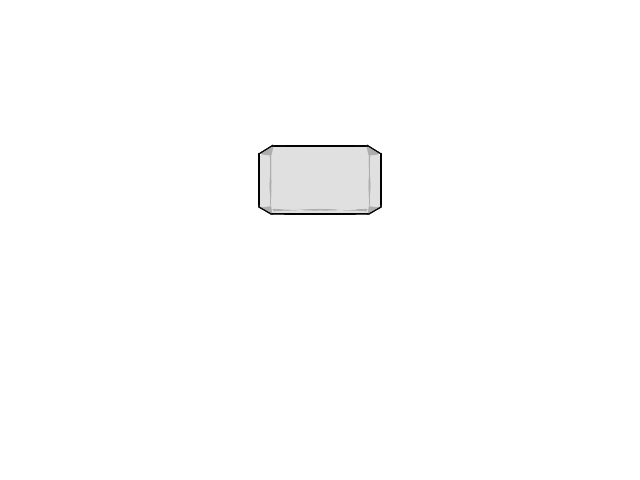
static/sprites/back/Head/back_Head.png
