HoneyKung/metorobot/tools/meto-api-writer/usage-log.csv

date | brief | model | cost_usd | input_tokens | output_tokens
2026-11-02T07:30:27+07:00 | C:\Users\Acer\AppData\Local\Temp\claude\G--My-Drive-METTO-Code-RoboBlock\904dfa07-0ccb-402b-ab7a-728620bc60de\scratchpad\opus_asm\brief_opus03_assembly.md | claude-opus-5-5 | 7.20042160 | 50 | 136308
2026-11-02T20:24:46+07:00 | C:\Users\Acer\AppData\Local\Temp\claude\G--My-Drive-METTO-Code-RoboBlock\e69ff40e-5853-49cd-b79a-5fb19b92285d\scratchpad\opus_asm2\brief_opus04_draft2.md | claude-opus-5-5 | 4.03171680 | 4 | 2855
2026-11-02T20:40:49+07:00 | C:\Users\Acer\AppData\Local\Temp\claude\G--My-Drive-METTO-Code-RoboBlock\e69ff40e-5853-49cd-b79a-5fb19b92285d\scratchpad\opus_arm\brief_opus05_arm.md | claude-opus-5-5 | 4.82259420 | 54 | 118324
2026-11-02T21:36:01+07:00 | C:\Users\Acer\AppData\Local\Temp\claude\G--My-Drive-METTO-Code-RoboBlock\e69ff40e-5853-49cd-b79a-5fb19b92285d\scratchpad\opus_arm\brief_opus06_arm_thin.md | claude-opus-5-5 | 2.35625600 | 48 | 48677
2026-11-02T22:02:08+07:00 | C:\Users\Acer\AppData\Local\Temp\claude\G--My-Drive-METTO-Code-RoboBlock\e69ff40e-5853-49cd-b79a-5fb19b92285d\scratchpad\opus_arm\brief_opus07_arm_paddle.md | claude-opus-5-5 | 2.77670900 | 48 | 76148
2026-11-02T22:09:00+07:00 | C:\Users\Acer\AppData\Local\Temp\claude\G--My-Drive-METTO-Code-RoboBlock\e69ff40e-5853-49cd-b79a-5fb19b92285d\scratchpad\opus_arm\brief_opus08_fix.md | claude-opus-5-5 | 0.77386520 | 20 | 25304
2026-11-02T23:44:35+07:00 | C:\Users\Acer\AppData\Local\Temp\claude\G--My-Drive-METTO-Code-RoboBlock\e69ff40e-5853-49cd-b79a-5fb19b92285d\scratchpad\opus_arm\brief_opus10_fix.md | claude-opus-5-5 | 1.21591160 | 58 | 32014
2026-11-03T02:40:58+07:00 | C:\Users\Acer\AppData\Local\Temp\claude\G--My-Drive-METTO-Code-RoboBlock\e69ff40e-5853-49cd-b79a-5fb19b92285d\scratchpad\opus_arm\brief_opus12.md | claude-opus-5-5 | 4.79460040 | 48 | 136354
2026-11-03T03:51:01+07:00 | C:\Users\Acer\AppData\Local\Temp\claude\G--My-Drive-METTO-Code-RoboBlock\e69ff40e-5853-49cd-b79a-5fb19b92285d\scratchpad\opus_arm\brief_opus13.md | claude-opus-5-5 | 5.38766400 | 56 | 147145
2026-11-03T05:05:37+07:00 | C:\Users\Acer\AppData\Local\Temp\claude\G--My-Drive-METTO-Code-RoboBlock\e69ff40e-5853-49cd-b79a-5fb19b92285d\scratchpad\opus_arm\brief_opus14.md | claude-opus-5-5 | 4.39310680 | 52 | 97762
2026-11-03T05:12:41+07:00 | C:\Users\Acer\AppData\Local\Temp\claude\G--My-Drive-METTO-Code-RoboBlock\e69ff40e-5853-49cd-b79a-5fb19b92285d\scratchpad\opus_neck\brief_opus15_neck.md | claude-opus-5-5 | 3.86844380 | 44 | 101204
