HoneyKung/metorobot/static/twin3d/models/layer3.stl

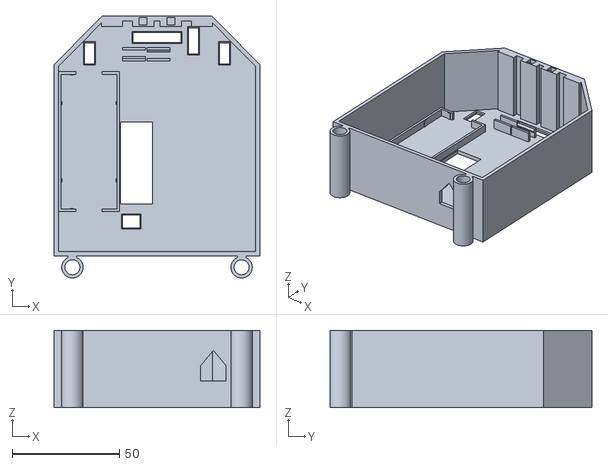
[picture p79: CAD file, 2026-11-09]
static/twin3d/models/layer3.stl
96.0 x 122.3 x 36.0
