HoneyKung/metorobot/static/twin3d/models/devices.stl

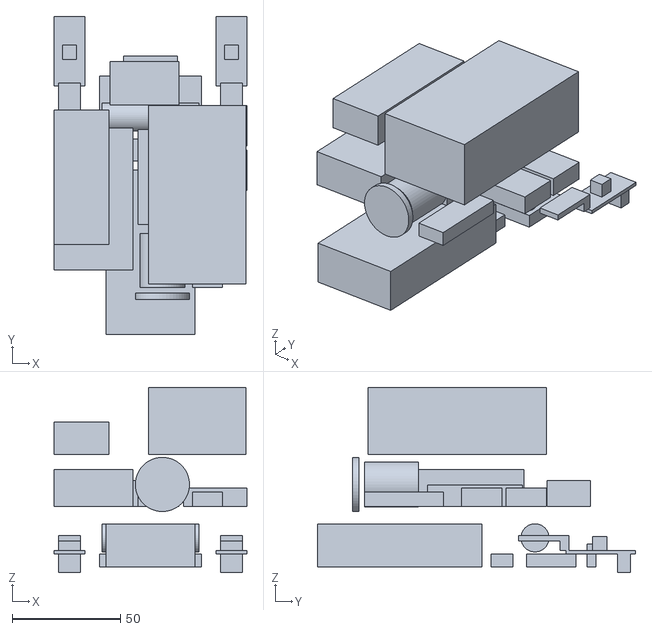
[picture p80: CAD file, 2026-11-09]
static/twin3d/models/devices.stl
88.9 x 146.8 x 85.6
