HoneyKung/metorobot/static/twin3d/models/hat_straw.stl

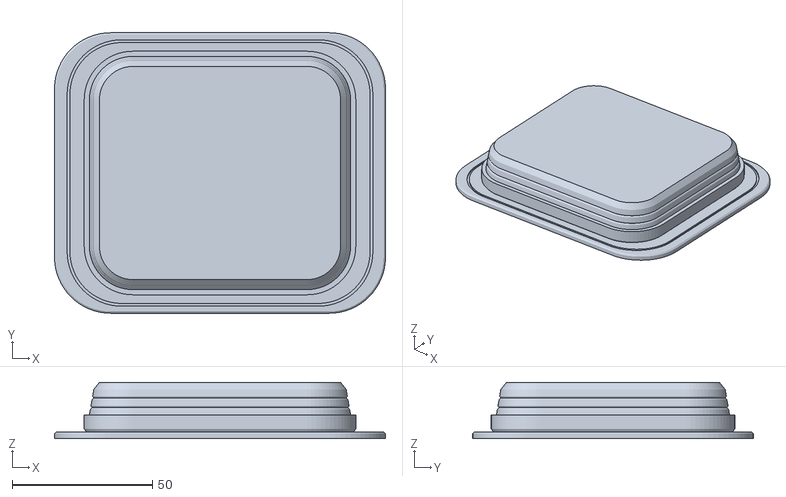
[picture p81: CAD file, 2026-11-09]
static/twin3d/models/hat_straw.stl
118.0 x 100.0 x 20.0
