HoneyKung/metorobot/static/twin3d/models/wheel_R.stl

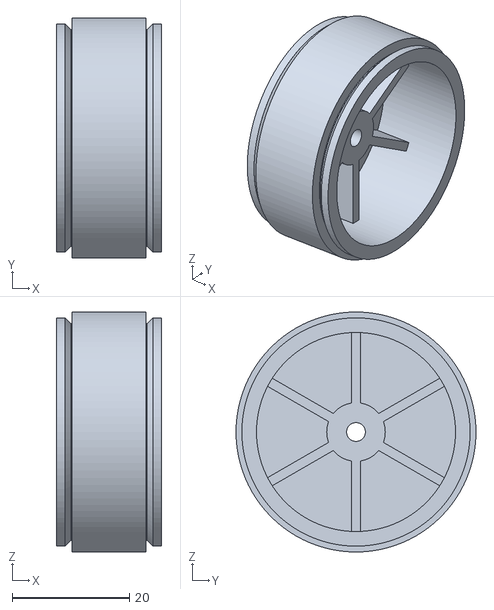
[picture p82: CAD file, 2026-11-09]
static/twin3d/models/wheel_R.stl
18.0 x 41.0 x 41.0
