HoneyKung/metorobot/static/twin3d/models/v9_front_lo.stl

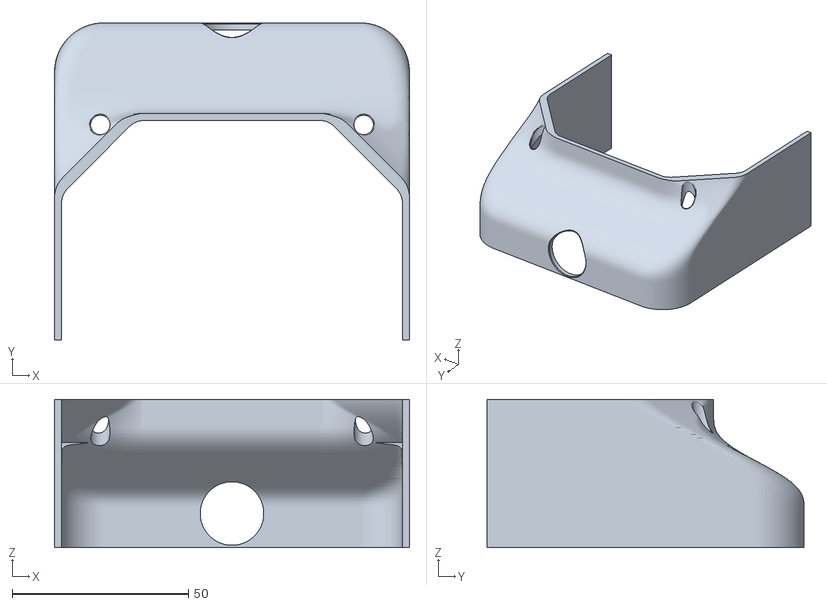
[picture p83: CAD file, 2026-11-09]
static/twin3d/models/v9_front_lo.stl
100.7 x 90.0 x 42.0
