HoneyKung/metorobot/static/twin3d/models/arm_cable.stl

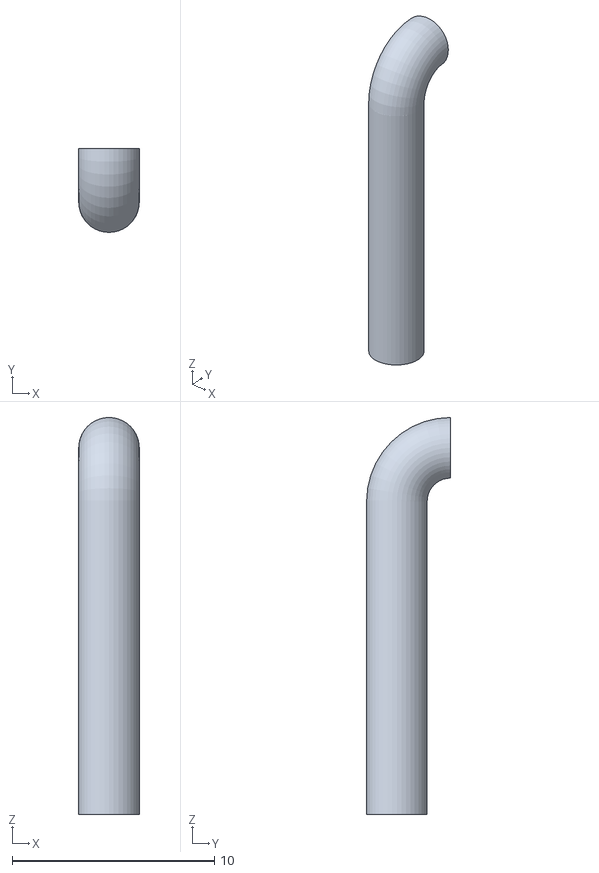
[picture p84: CAD file, 2026-11-09]
static/twin3d/models/arm_cable.stl
3.00 x 4.15 x 19.7
