HoneyKung/metorobot/static/twin3d/models/h_shell.stl

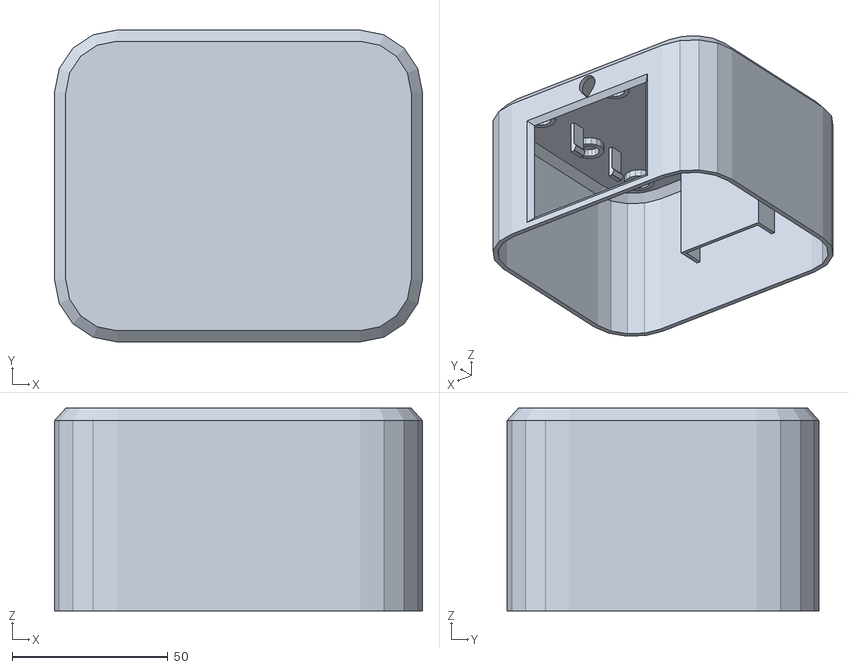
[picture p85: CAD file, 2026-11-09]
static/twin3d/models/h_shell.stl
118.0 x 100.0 x 65.0
