HoneyKung/metorobot/static/twin3d/models/arm_pin.stl

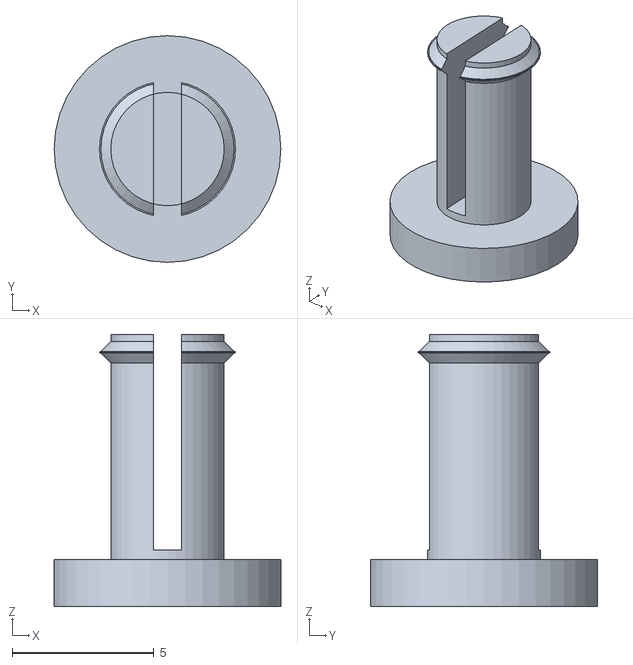
[picture p86: CAD file, 2026-11-09]
static/twin3d/models/arm_pin.stl
8.00 x 8.00 x 9.60
