HoneyKung/metorobot/static/twin3d/models/b_rings.stl

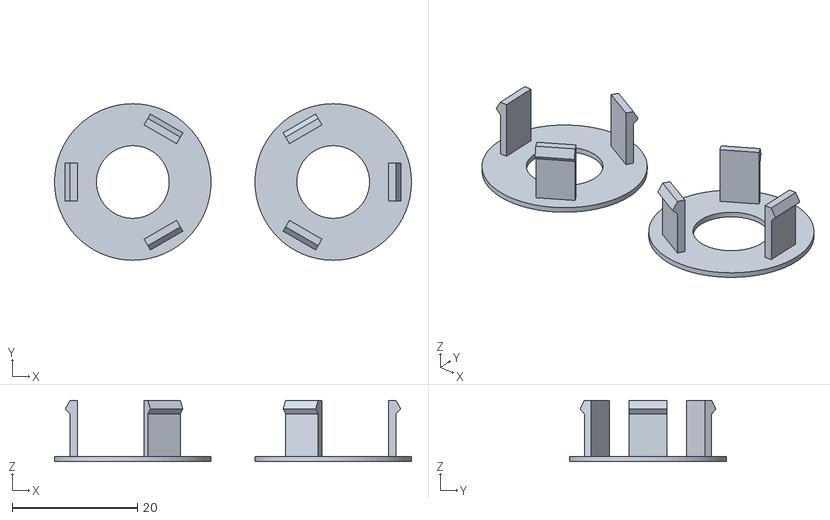
[picture p87: CAD file, 2026-11-09]
static/twin3d/models/b_rings.stl
57.0 x 25.0 x 9.80
