HoneyKung/metorobot/static/twin3d/models/v9_post_cap_L.stl

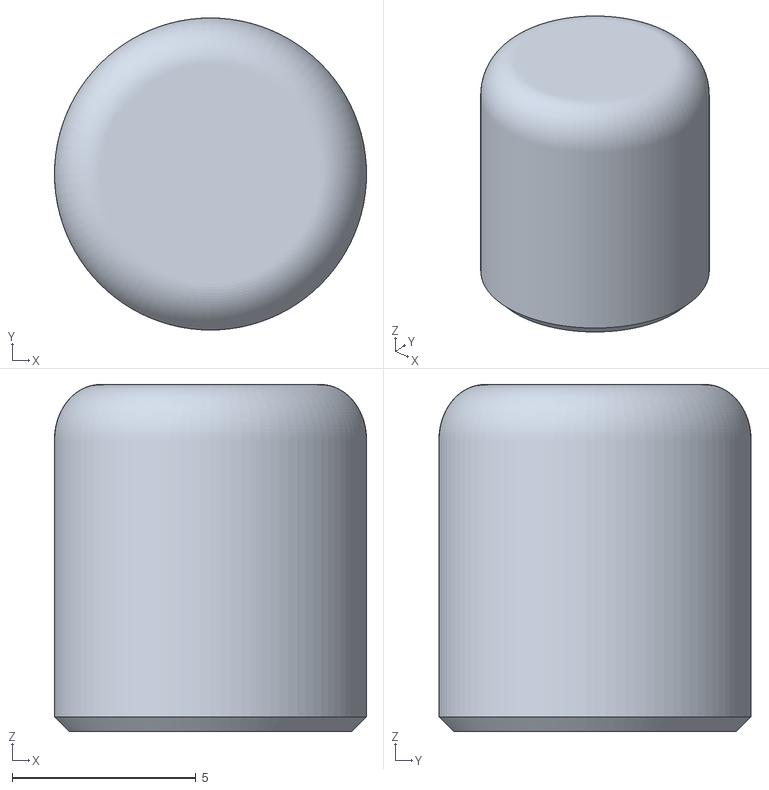
[picture p88: CAD file, 2026-11-09]
static/twin3d/models/v9_post_cap_L.stl
8.50 x 8.50 x 9.45
