HoneyKung/metorobot/static/twin3d/models/h_mpr.stl

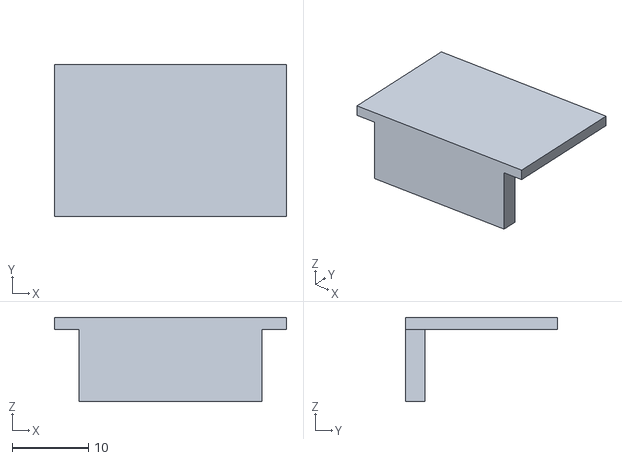
[picture p89: CAD file, 2026-11-09]
static/twin3d/models/h_mpr.stl
30.5 x 20.0 x 11.1
