HoneyKung/metorobot/static/twin3d/models/h_base.stl

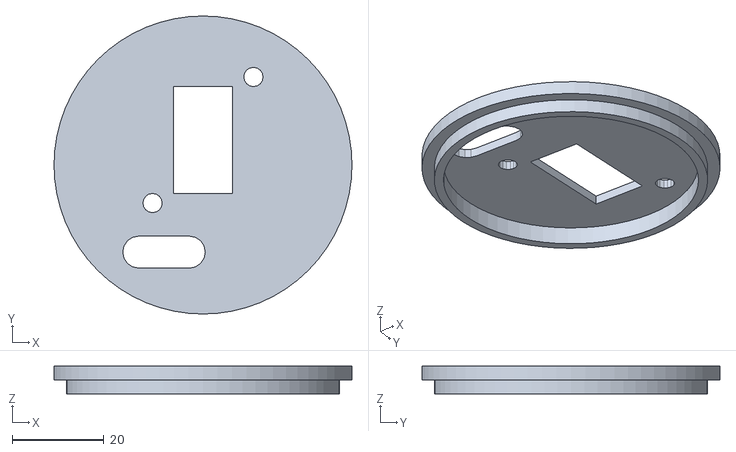
[picture p90: CAD file, 2026-11-09]
static/twin3d/models/h_base.stl
65.0 x 65.0 x 6.00
