HoneyKung/metorobot/static/twin3d/models/h_xiao_dock.stl

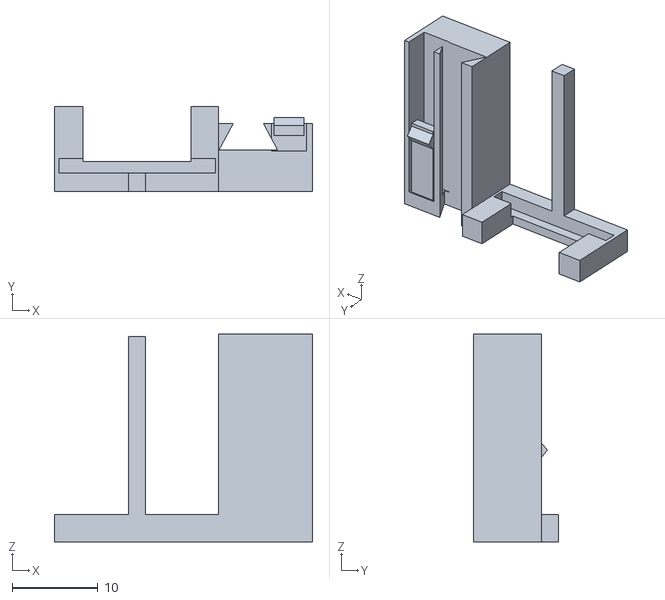
[picture p91: CAD file, 2026-11-09]
static/twin3d/models/h_xiao_dock.stl
30.1 x 9.95 x 24.2
