HoneyKung/metorobot/static/twin3d/models/b_clips.stl

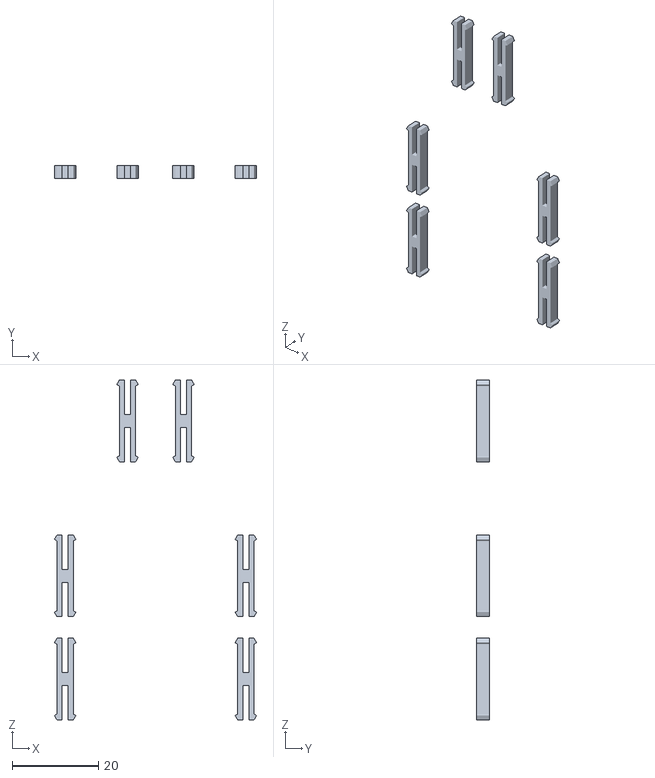
[picture p92: CAD file, 2026-11-09]
static/twin3d/models/b_clips.stl
47.0 x 3.00 x 79.0
