HoneyKung/metorobot/static/twin3d/models/v9_door_R.stl

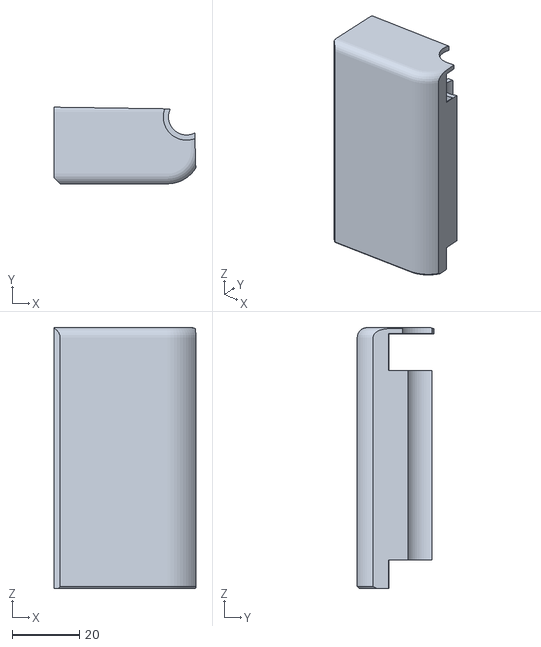
[picture p93: CAD file, 2026-11-09]
static/twin3d/models/v9_door_R.stl
42.0 x 22.7 x 77.4
