HoneyKung/metorobot/static/twin3d/models/neck.stl

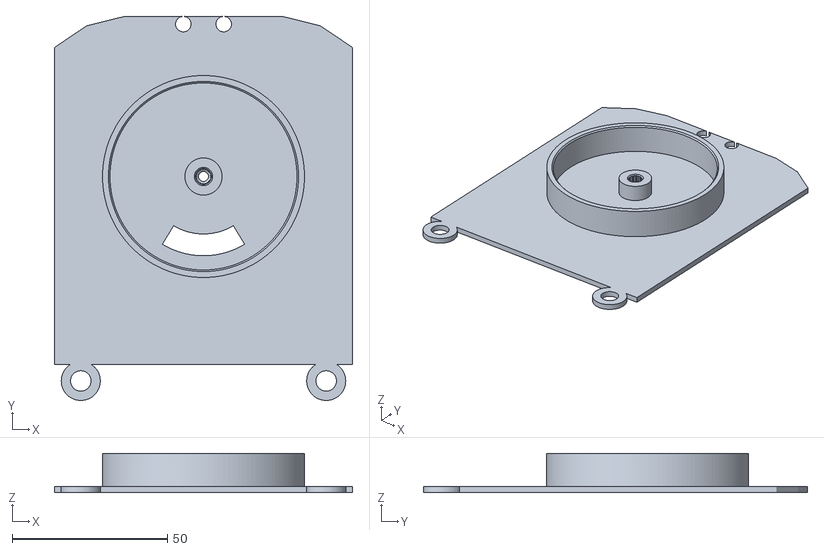
[picture p94: CAD file, 2026-11-09]
static/twin3d/models/neck.stl
96.0 x 123.6 x 12.7
