HoneyKung/metorobot/static/twin3d/models/layer4.stl

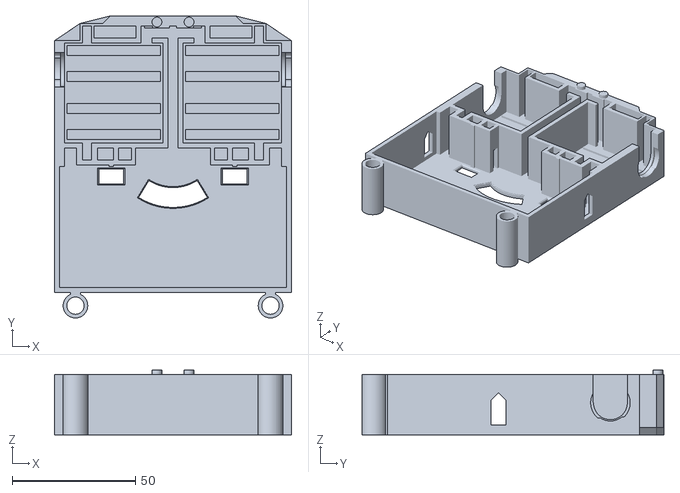
[picture p95: CAD file, 2026-11-09]
static/twin3d/models/layer4.stl
96.0 x 122.3 x 26.2
