HoneyKung/metorobot/static/twin3d/models/h_display_spacers.stl

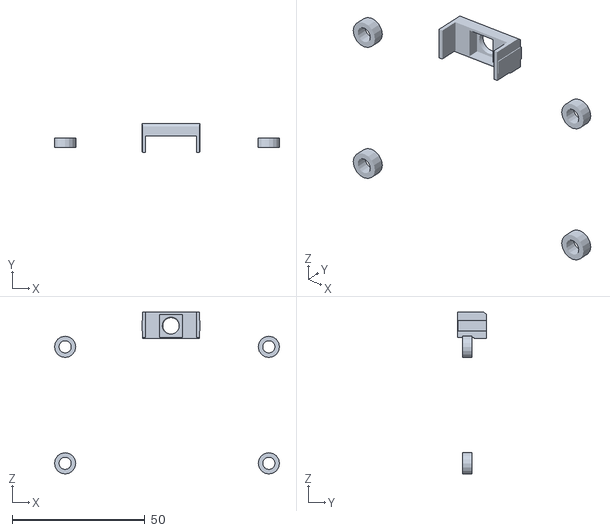
[picture p96: CAD file, 2026-11-09]
static/twin3d/models/h_display_spacers.stl
84.6 x 11.0 x 60.9
