HoneyKung/metorobot/static/twin3d/models/h_tilt_leg_p.stl

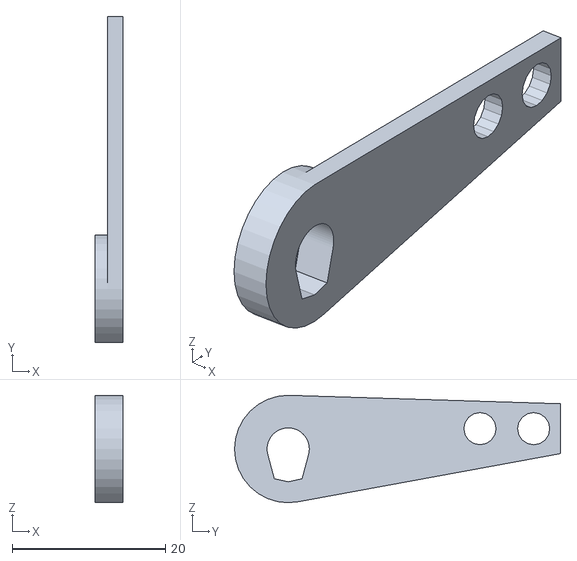
[picture p97: CAD file, 2026-11-09]
static/twin3d/models/h_tilt_leg_p.stl
3.60 x 42.5 x 14.0
