HoneyKung/metorobot/static/twin3d/models/b_tt.stl

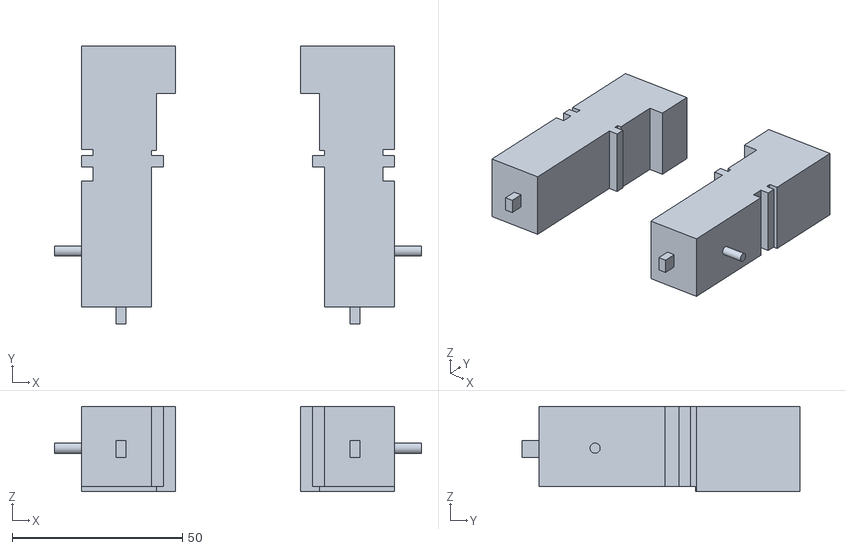
[picture p98: CAD file, 2026-11-09]
static/twin3d/models/b_tt.stl
107.8 x 81.7 x 25.0
