HoneyKung/metorobot/static/twin3d/models/v9_front_hi.stl

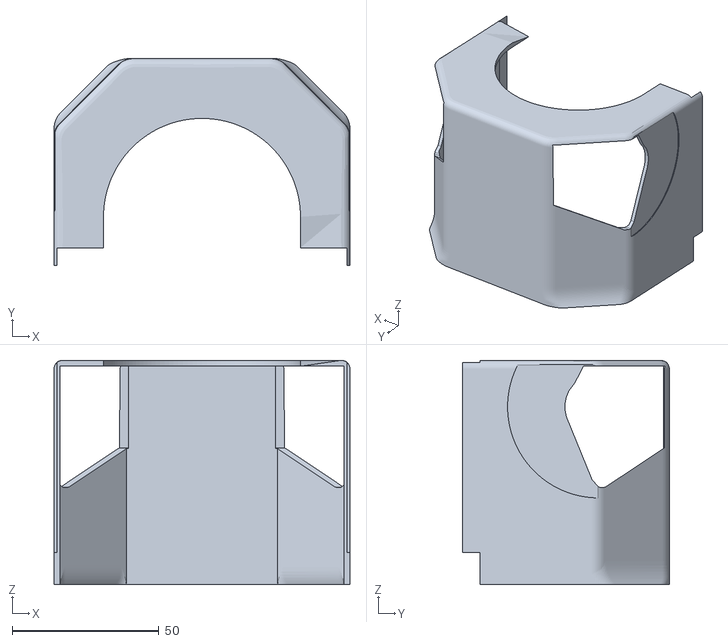
[picture p99: CAD file, 2026-11-09]
static/twin3d/models/v9_front_hi.stl
100.7 x 70.3 x 76.3
