HoneyKung/metorobot/static/twin3d/models/h_weight_cap.stl

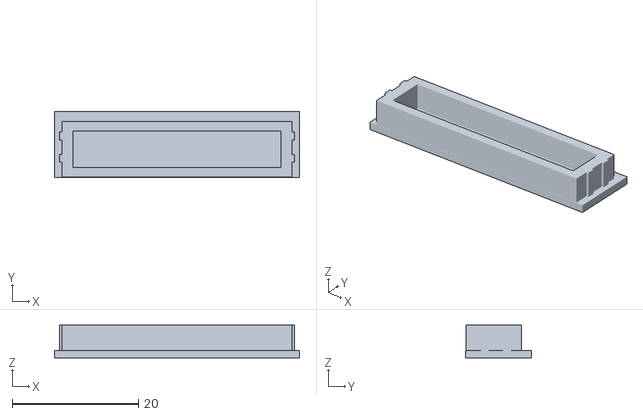
[picture p100: CAD file, 2026-11-09]
static/twin3d/models/h_weight_cap.stl
38.8 x 10.4 x 5.20
