HoneyKung/metorobot/static/twin3d/models/h_copper.stl

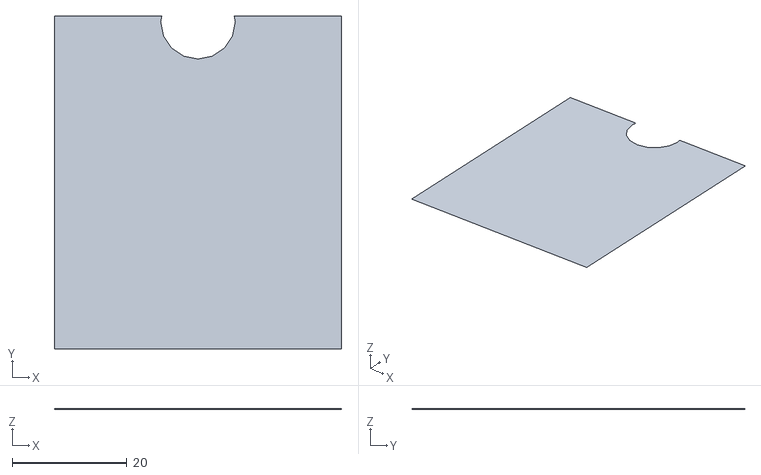
[picture p101: CAD file, 2026-11-09]
static/twin3d/models/h_copper.stl
50.0 x 58.0 x 0.1
