HoneyKung/metorobot/static/twin3d/models/h_display_holder.stl

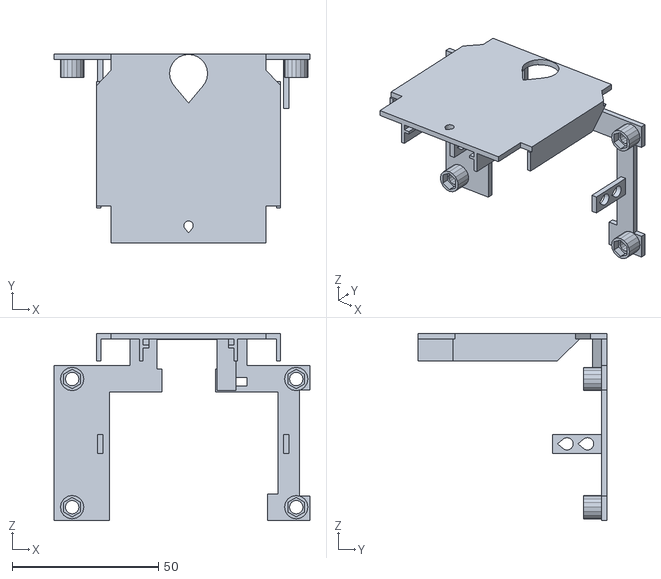
[picture p102: CAD file, 2026-11-09]
static/twin3d/models/h_display_holder.stl
87.5 x 64.7 x 64.0
