HoneyKung/metorobot/static/twin3d/models/b_cover.stl

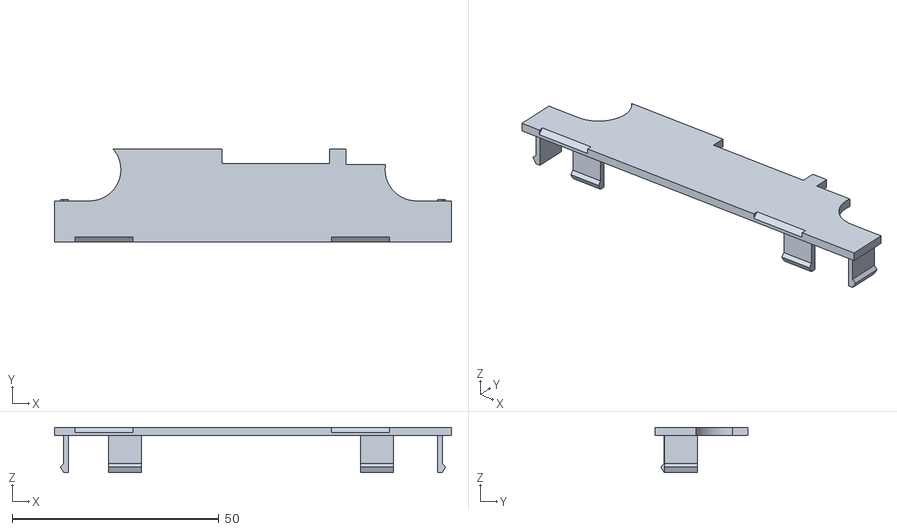
[picture p103: CAD file, 2026-11-09]
static/twin3d/models/b_cover.stl
96.0 x 22.5 x 10.9
