HoneyKung/metorobot/static/twin3d/models/v9_back_hi.stl

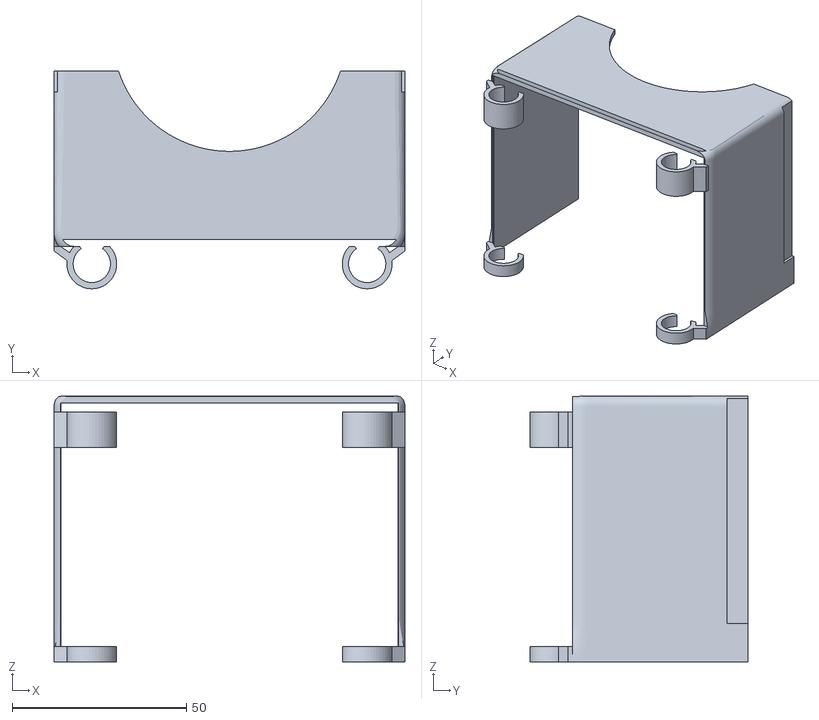
[picture p104: CAD file, 2026-11-09]
static/twin3d/models/v9_back_hi.stl
100.7 x 62.4 x 76.3
