HoneyKung/metorobot/static/twin3d/models/h_scr_leg.stl

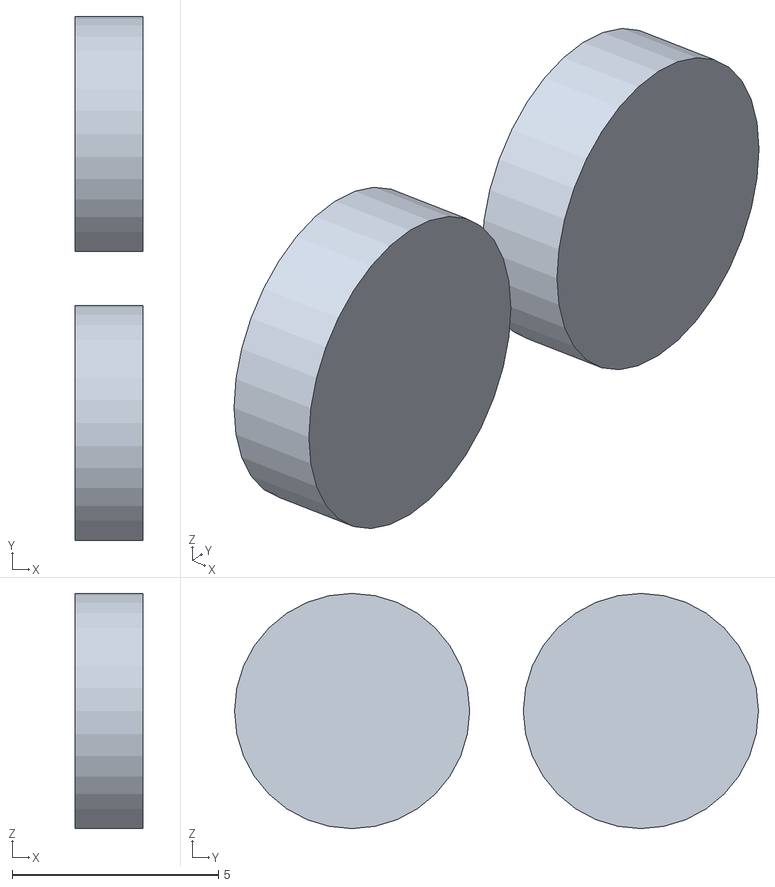
[picture p105: CAD file, 2026-11-09]
static/twin3d/models/h_scr_leg.stl
1.65 x 12.7 x 5.70
