HoneyKung/metorobot/static/twin3d/models/mg996.stl

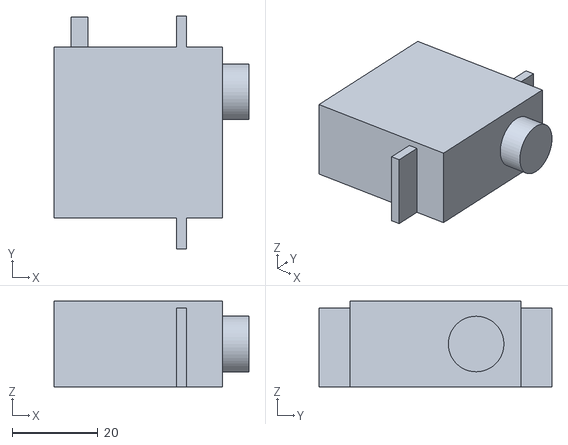
[picture p106: CAD file, 2026-11-09]
static/twin3d/models/mg996.stl
45.6 x 54.4 x 20.0
