HoneyKung/metorobot/static/twin3d/models/h_yaw_servo.stl

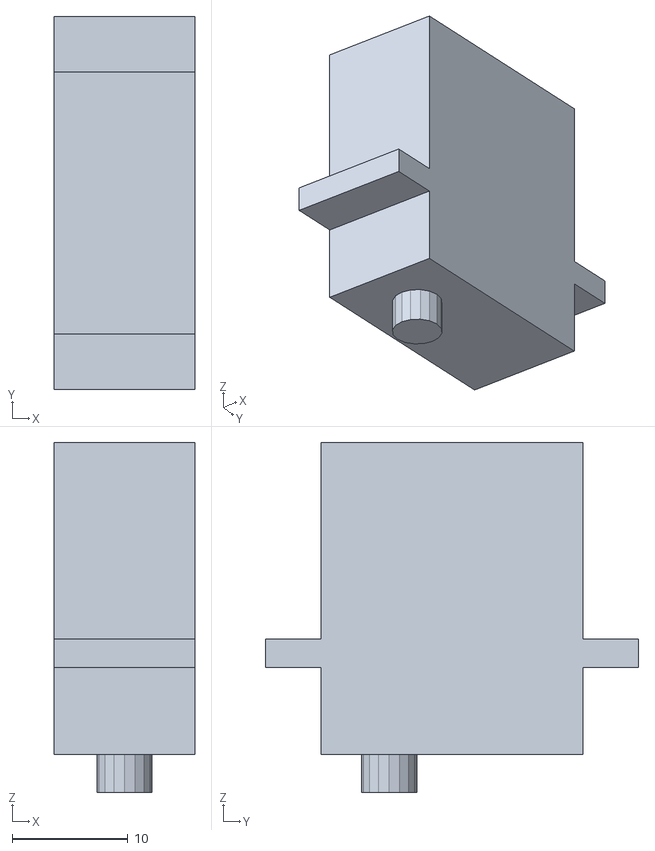
[picture p107: CAD file, 2026-11-09]
static/twin3d/models/h_yaw_servo.stl
12.2 x 32.3 x 30.3
