HoneyKung/metorobot/static/twin3d/models/layer1.stl

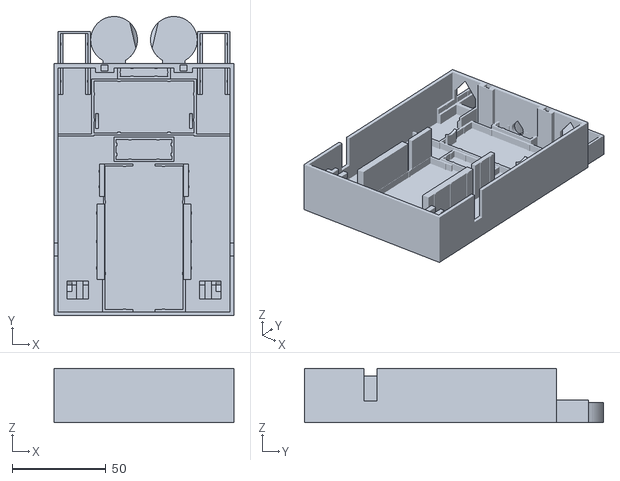
[picture p108: CAD file, 2026-11-09]
static/twin3d/models/layer1.stl
96.0 x 159.8 x 29.0
