HoneyKung/metorobot/static/twin3d/models/hat_ant.stl

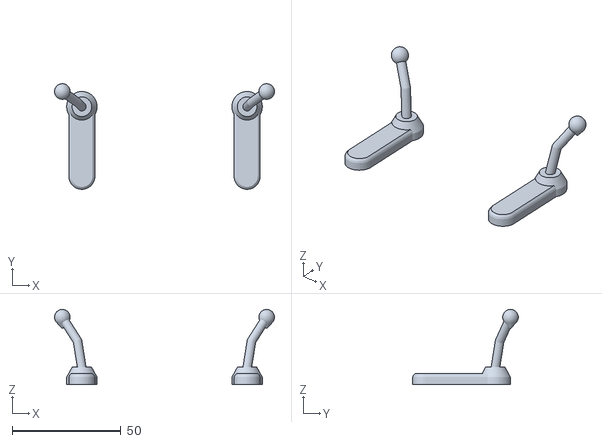
[picture p109: CAD file, 2026-11-09]
static/twin3d/models/hat_ant.stl
101.2 x 48.6 x 34.6
