HoneyKung/metorobot/static/twin3d/models/h_camera.stl

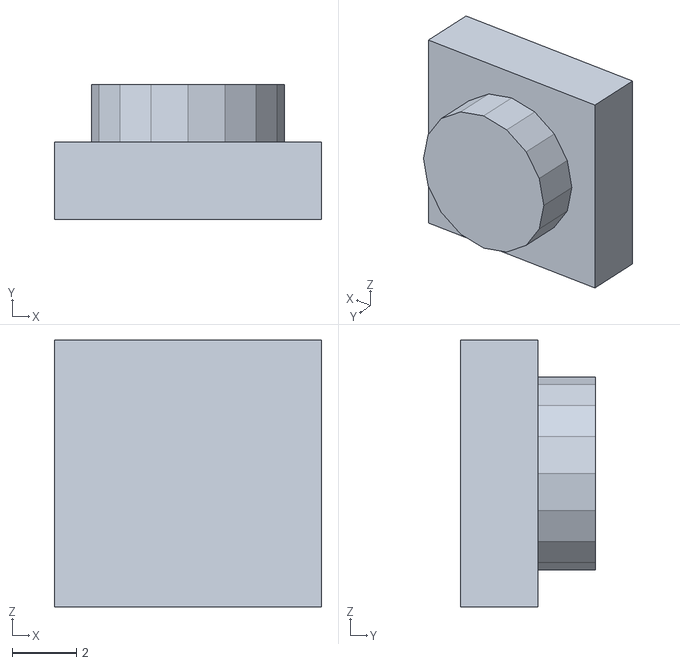
[picture p110: CAD file, 2026-11-09]
static/twin3d/models/h_camera.stl
8.30 x 4.19 x 8.30
