HoneyKung/metorobot/static/twin3d/models/arm_ubracket.stl

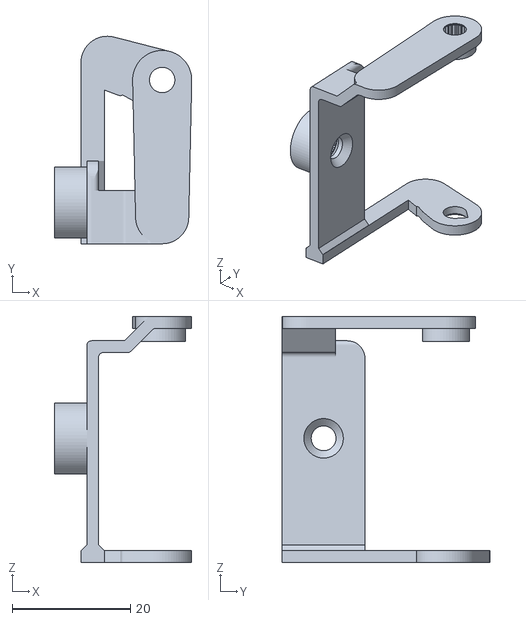
[picture p111: CAD file, 2026-11-09]
static/twin3d/models/arm_ubracket.stl
23.2 x 35.1 x 41.6
