HoneyKung/metorobot/static/twin3d/models/hat_cat.stl

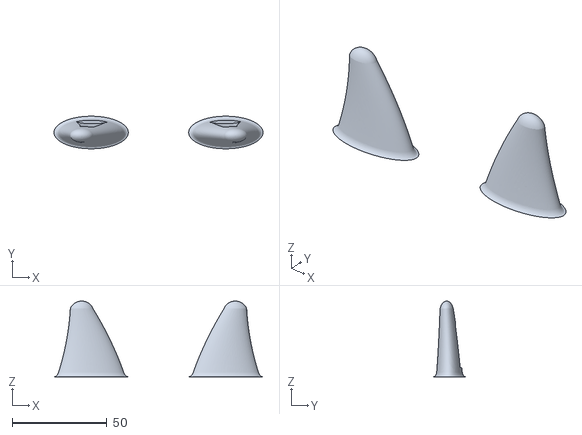
[picture p112: CAD file, 2026-11-09]
static/twin3d/models/hat_cat.stl
110.2 x 17.2 x 40.0
