HoneyKung/metorobot/static/twin3d/models/b_balls.stl

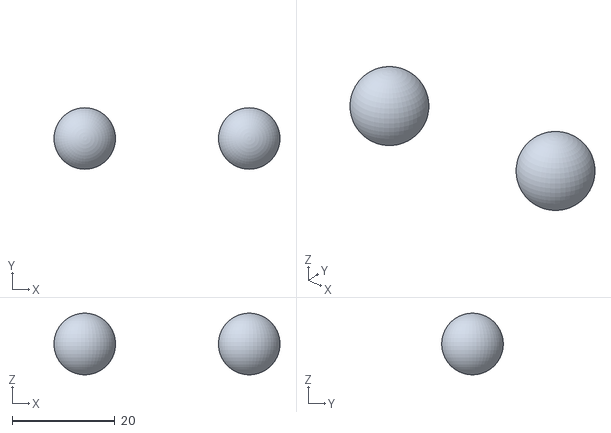
[picture p113: CAD file, 2026-11-09]
static/twin3d/models/b_balls.stl
44.0 x 12.0 x 12.0
