HoneyKung/metorobot/static/twin3d/models/hat_bear.stl

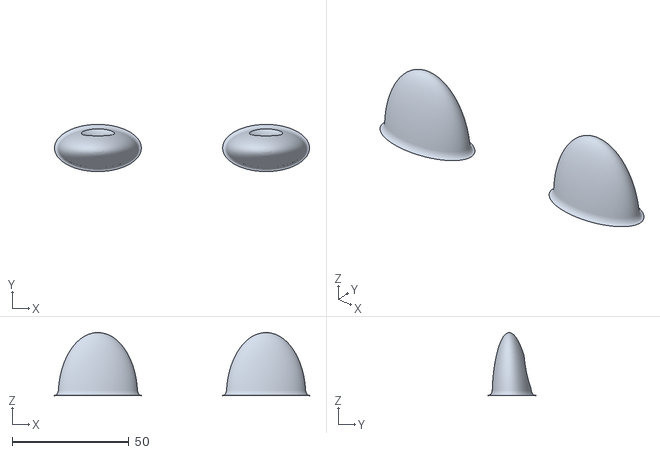
[picture p114: CAD file, 2026-11-09]
static/twin3d/models/hat_bear.stl
109.2 x 20.2 x 27.0
