HoneyKung/metorobot/static/twin3d/models/v9_door_L.stl

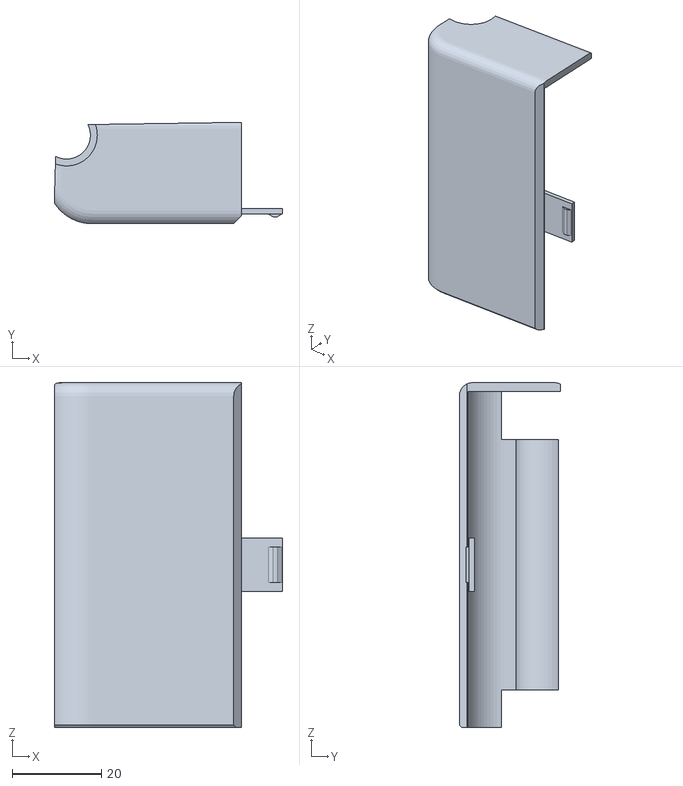
[picture p115: CAD file, 2026-11-09]
static/twin3d/models/v9_door_L.stl
51.3 x 22.7 x 77.4
