HoneyKung/metorobot/static/twin3d/models/h_display.stl

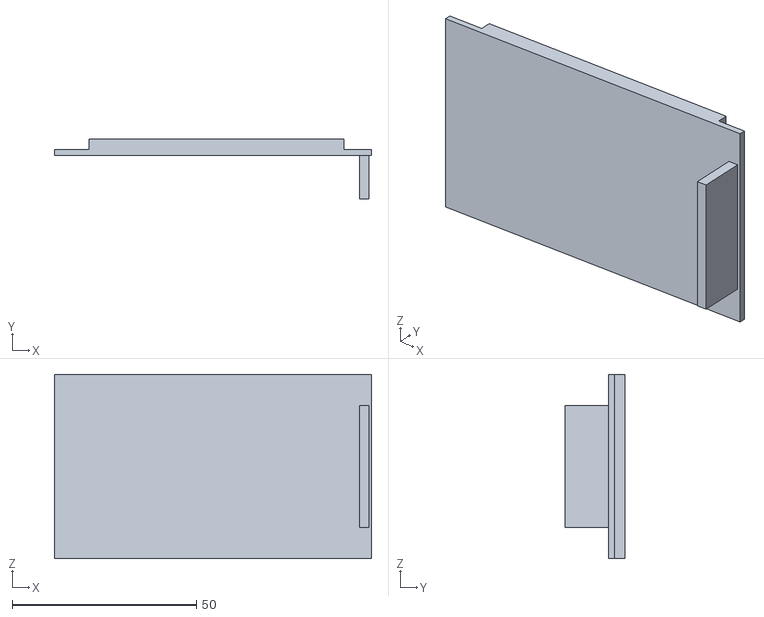
[picture p116: CAD file, 2026-11-09]
static/twin3d/models/h_display.stl
86.0 x 16.3 x 50.0
