HoneyKung/metorobot/static/twin3d/models/h_scr_disp.stl

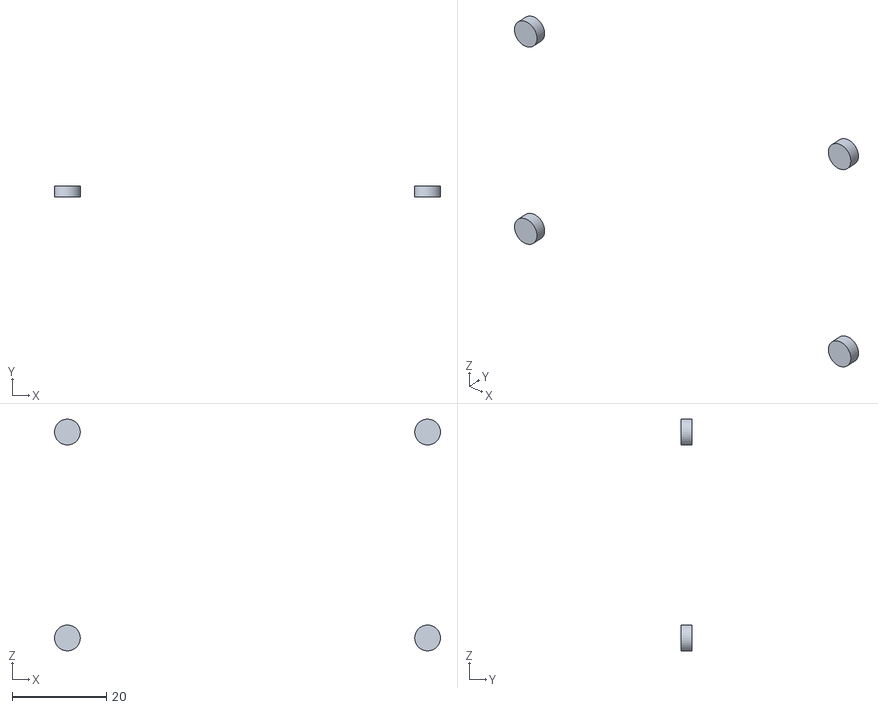
[picture p117: CAD file, 2026-11-09]
static/twin3d/models/h_scr_disp.stl
82.1 x 2.40 x 49.3
