HoneyKung/metorobot/static/twin3d/models/v9_back_lo.stl

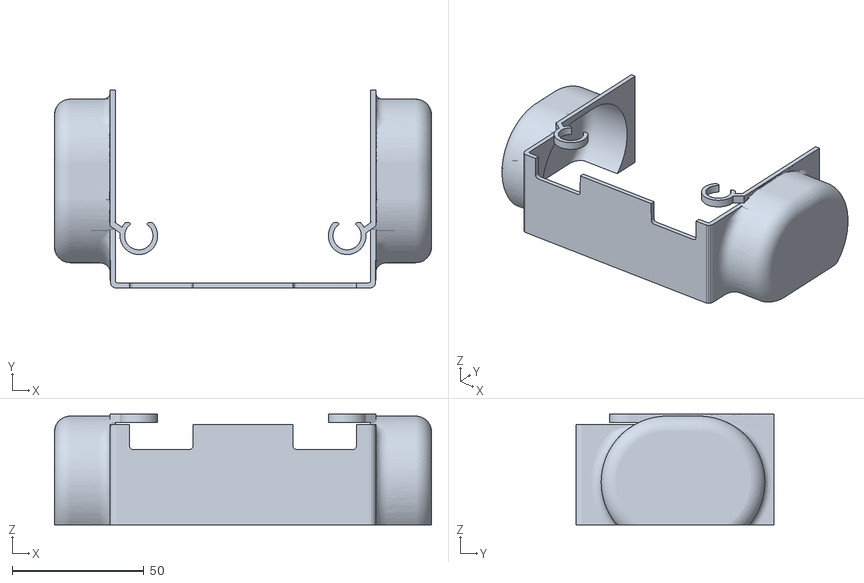
[picture p118: CAD file, 2026-11-09]
static/twin3d/models/v9_back_lo.stl
143.0 x 75.1 x 42.0
