HoneyKung/metorobot/static/twin3d/models/arm_mg90.stl

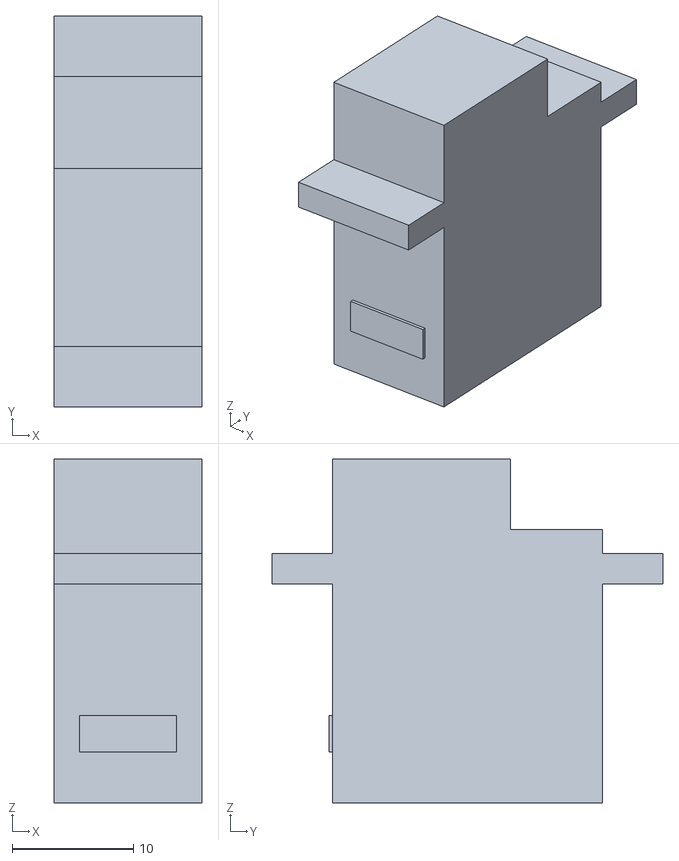
[picture p119: CAD file, 2026-11-09]
static/twin3d/models/arm_mg90.stl
12.2 x 32.3 x 28.4
