HoneyKung/metorobot/static/twin3d/models/arm_arm.stl

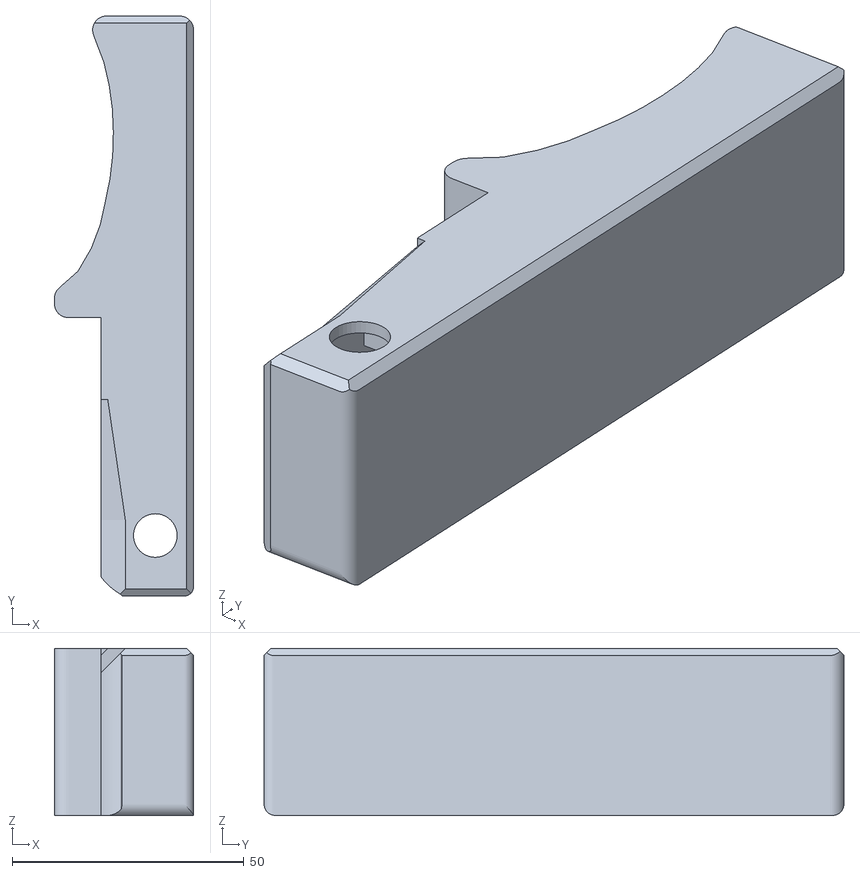
[picture p120: CAD file, 2026-11-09]
static/twin3d/models/arm_arm.stl
30.0 x 125.0 x 36.0
