HoneyKung/metorobot/static/twin3d/models/layer2.stl

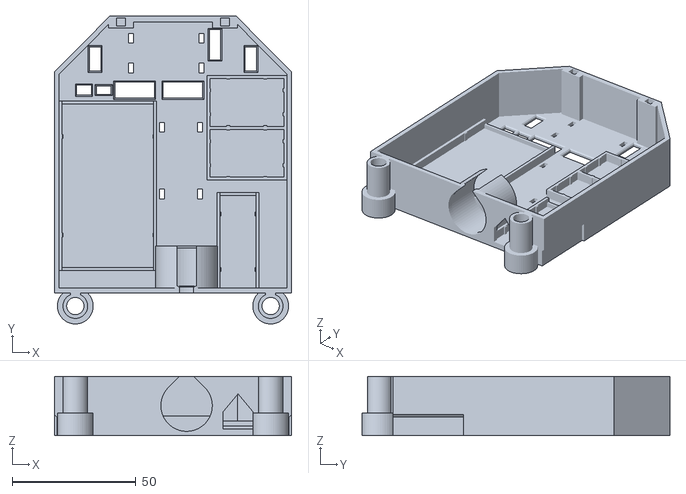
[picture p121: CAD file, 2026-11-09]
static/twin3d/models/layer2.stl
96.0 x 124.6 x 24.0
