HoneyKung/metorobot/static/twin3d/models/h_tilt_mount.stl

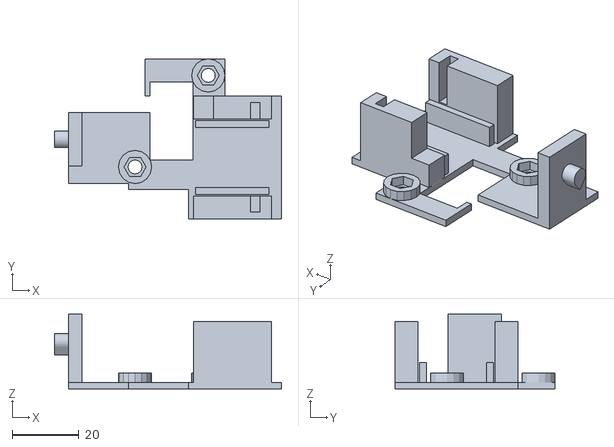
[picture p122: CAD file, 2026-11-09]
static/twin3d/models/h_tilt_mount.stl
68.2 x 48.2 x 22.5
