HoneyKung/metorobot/static/twin3d/models/h_xiao.stl

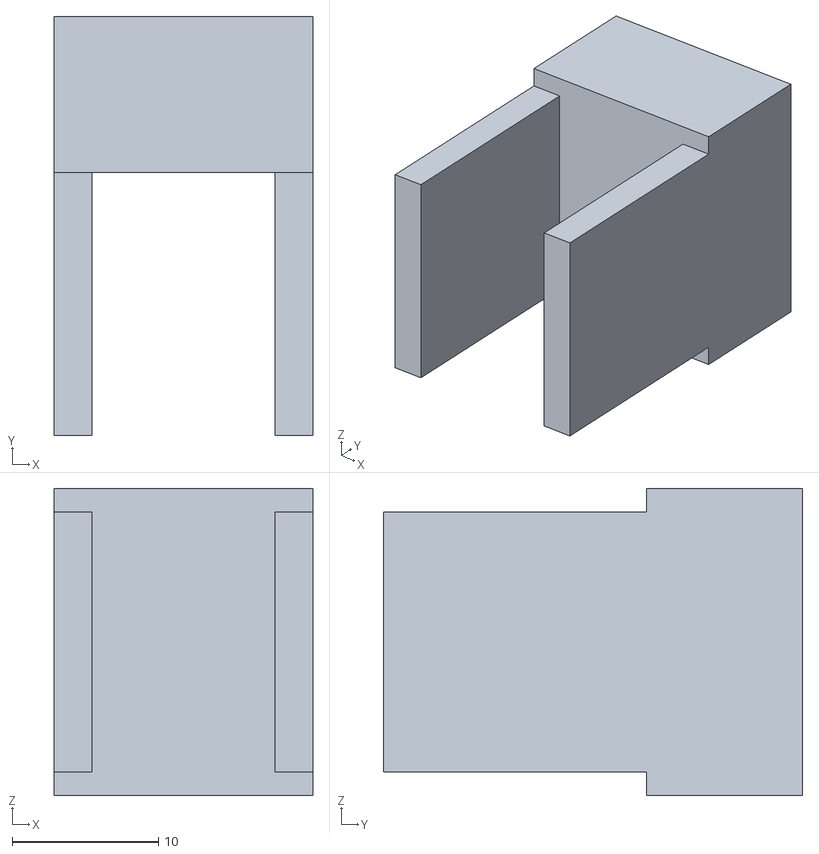
[picture p123: CAD file, 2026-11-09]
static/twin3d/models/h_xiao.stl
17.7 x 28.7 x 21.0
