HoneyKung/metorobot/static/twin3d/models/arm_plug.stl

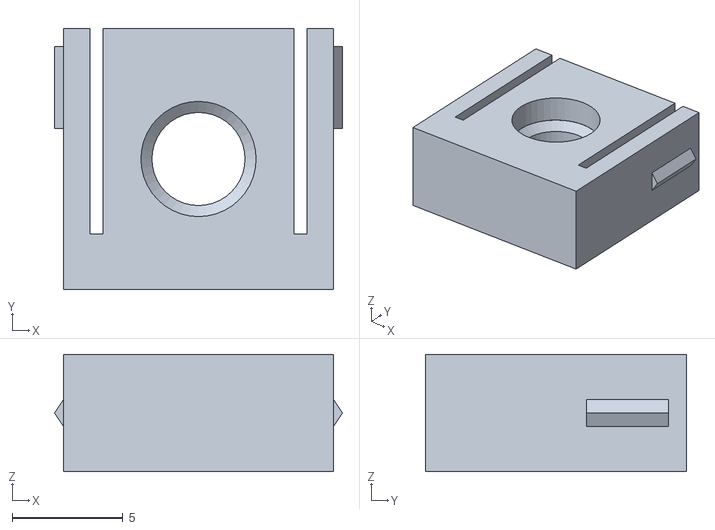
[picture p124: CAD file, 2026-11-09]
static/twin3d/models/arm_plug.stl
13.0 x 11.8 x 5.30
