HoneyKung/metorobot/static/twin3d/models/h_magnets.stl

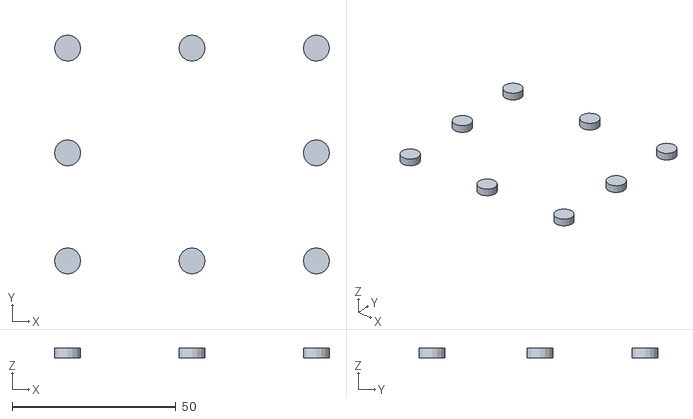
[picture p125: CAD file, 2026-11-09]
static/twin3d/models/h_magnets.stl
84.0 x 73.0 x 3.00
