HoneyKung/metorobot/static/twin3d/models/b_rods.stl

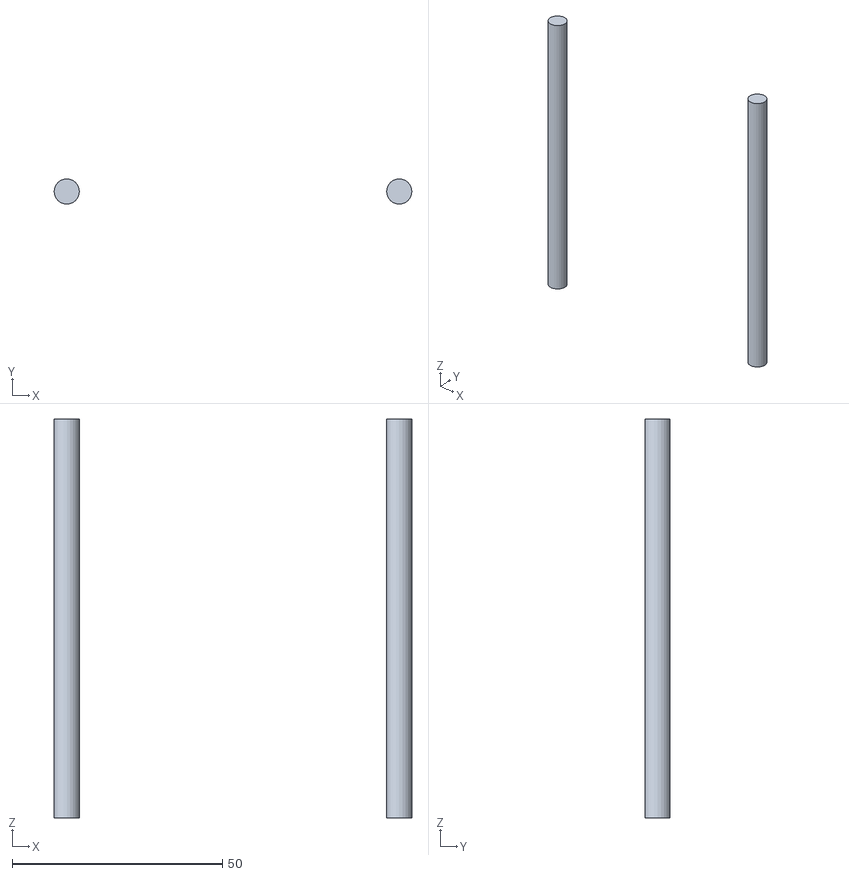
[picture p126: CAD file, 2026-11-09]
static/twin3d/models/b_rods.stl
85.0 x 6.00 x 94.8
