HoneyKung/metorobot/static/twin3d/models/h_sg_clamp.stl

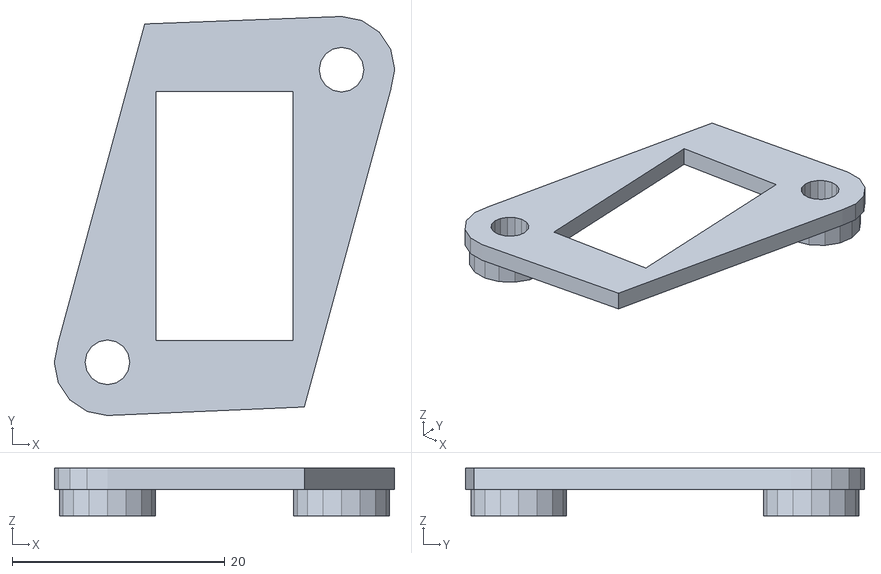
[picture p127: CAD file, 2026-11-09]
static/twin3d/models/h_sg_clamp.stl
32.0 x 37.5 x 4.50
