HoneyKung/metorobot/ภาพโครงหุ่น_9พย/07_arm.scad

color([0.35, 0.62, 0.85]) import("C:/Users/Acer/.gemini/antigravity-cli/brain/439861cf-048a-417c-86a7-bd8760da3416/scratch/stl_stage/arm_L_r3.stl");
color([0.35, 0.62, 0.85]) import("C:/Users/Acer/.gemini/antigravity-cli/brain/439861cf-048a-417c-86a7-bd8760da3416/scratch/stl_stage/arm_R_r3.stl");
color([0.92, 0.52, 0.18]) translate([-55, 15, 0]) import("C:/Users/Acer/.gemini/antigravity-cli/brain/439861cf-048a-417c-86a7-bd8760da3416/scratch/stl_stage/ubracket_L_r3.stl");
color([0.92, 0.52, 0.18]) translate([55, 15, 0]) import("C:/Users/Acer/.gemini/antigravity-cli/brain/439861cf-048a-417c-86a7-bd8760da3416/scratch/stl_stage/ubracket_R_r3.stl");
color([0.32, 0.72, 0.48]) translate([-20, -40, 0]) import("C:/Users/Acer/.gemini/antigravity-cli/brain/439861cf-048a-417c-86a7-bd8760da3416/scratch/stl_stage/plug_r3.stl");
color([0.32, 0.72, 0.48]) translate([20, -40, 0]) import("C:/Users/Acer/.gemini/antigravity-cli/brain/439861cf-048a-417c-86a7-bd8760da3416/scratch/stl_stage/plug_r3.stl");
color([0.82, 0.35, 0.42]) translate([-20, -65, 0]) import("C:/Users/Acer/.gemini/antigravity-cli/brain/439861cf-048a-417c-86a7-bd8760da3416/scratch/stl_stage/pin_r3.stl");
color([0.82, 0.35, 0.42]) translate([20, -65, 0]) import("C:/Users/Acer/.gemini/antigravity-cli/brain/439861cf-048a-417c-86a7-bd8760da3416/scratch/stl_stage/pin_r3.stl");
color([0.65, 0.55, 0.82]) translate([0, -90, 0]) import("C:/Users/Acer/.gemini/antigravity-cli/brain/439861cf-048a-417c-86a7-bd8760da3416/scratch/stl_stage/washer_m3.stl");
