HoneyKung/metorobot/ภาพโครงหุ่น_9พย/01_layer1.scad

color([0.28, 0.52, 0.78]) import("C:/Users/Acer/.gemini/antigravity-cli/brain/439861cf-048a-417c-86a7-bd8760da3416/scratch/stl_stage/layer1.stl");
color([0.92, 0.55, 0.18]) translate([0, -28, 0]) import("C:/Users/Acer/.gemini/antigravity-cli/brain/439861cf-048a-417c-86a7-bd8760da3416/scratch/stl_stage/battery_cover.stl");
color([0.25, 0.72, 0.45]) translate([0, 45, 0]) import("C:/Users/Acer/.gemini/antigravity-cli/brain/439861cf-048a-417c-86a7-bd8760da3416/scratch/stl_stage/caster_ring.stl");
