HoneyKung/metorobot/ภาพโครงหุ่น_9พย/02_layer2.scad

color([0.32, 0.62, 0.48]) import("C:/Users/Acer/.gemini/antigravity-cli/brain/439861cf-048a-417c-86a7-bd8760da3416/scratch/stl_stage/layer2.stl");
color([0.90, 0.52, 0.20]) translate([65, -60, 0]) import("C:/Users/Acer/.gemini/antigravity-cli/brain/439861cf-048a-417c-86a7-bd8760da3416/scratch/stl_stage/clip_loose.stl");
