HoneyKung/metorobot/ภาพโครงหุ่น_9พย/05_neck.scad

color([0.38, 0.64, 0.72]) import("C:/Users/Acer/.gemini/antigravity-cli/brain/439861cf-048a-417c-86a7-bd8760da3416/scratch/stl_stage/neck.stl");
color([0.85, 0.55, 0.20]) translate([65, -100, 0]) import("C:/Users/Acer/.gemini/antigravity-cli/brain/439861cf-048a-417c-86a7-bd8760da3416/scratch/stl_stage/m6_rod_R.stl");
color([0.85, 0.55, 0.20]) translate([65, -88, 0]) import("C:/Users/Acer/.gemini/antigravity-cli/brain/439861cf-048a-417c-86a7-bd8760da3416/scratch/stl_stage/m6_rod_L.stl");
color([0.75, 0.32, 0.32]) translate([65, -70, 0]) import("C:/Users/Acer/.gemini/antigravity-cli/brain/439861cf-048a-417c-86a7-bd8760da3416/scratch/stl_stage/m6_capnut_R.stl");
color([0.75, 0.32, 0.32]) translate([82, -70, 0]) import("C:/Users/Acer/.gemini/antigravity-cli/brain/439861cf-048a-417c-86a7-bd8760da3416/scratch/stl_stage/m6_capnut_L.stl");
