HoneyKung/metorobot/(list of files, cad)

Other CAD files:
static/twin3d/models/h_tilt_servo.stl
static/twin3d/models/h_tilt_leg_s.stl
static/twin3d/models/wheel_L.stl
static/twin3d/models/v9_post_cap_R.stl
ภาพโครงหุ่น_9พย/03_layer3.scad
ภาพโครงหุ่น_9พย/04_layer4.scad
