HoneyKung/metorobot/tank_track_robot_guide.md

# 🛡️ คู่มือออกแบบล้อตีนตะขาบ (Tank Track) สำหรับหุ่นยนต์

## 1. คำค้นหาใน MakerWorld

### คำค้นหาหลัก (ภาษาอังกฤษ)
| คำค้น | จะเจออะไร |
|---|---|
| `tracked robot chassis` | แชสซีหุ่นยนต์ตีนตะขาบแบบสมบูรณ์ |
| `tank track robot` | หุ่นยนต์แบบรถถัง |
| `caterpillar track` | ตีนตะขาบแยกชิ้น |
| `mini tank chassis` | แชสซีรถถังขนาดเล็ก |
| `SMARS robot` | **แนะนำมาก** — โปรเจค open-source โมดูลาร์ รองรับตีนตะขาบ |
| `tracked vehicle ESP32` / `Arduino tank` | ตีนตะขาบที่ออกแบบมาสำหรับบอร์ด ESP32/Arduino |
| `expandable tracked vehicle` | แชสซีตีนตะขาบที่ปรับขนาดได้ |
| `tank tread links` | ข้อตีนตะขาบแยกชิ้นสำหรับพิมพ์เอง |
| `robot track sprocket` | เฟืองขับตีนตะขาบ |

### โมเดลยอดนิยมที่ควรลอง
- **SMARS (Screwless Modular Assemblable Robotic System)** — เล็ก, ต่อง่าย, ไม่ต้องใช้สกรู
- **Minisumo ESP32 tracked vehicle** — ออกแบบเฉพาะสำหรับ ESP32
- **Tracked Robot BINO3D** — มีทั้งเวอร์ชัน toy และ robotic kit
- **Expandable Tracked Vehicle** — ปรับขนาดได้ตามต้องการ

### คำค้นเสริม (สำหรับอะไหล่เฉพาะ)
- `ball caster 3D print` — ล้อลูกกลิ้งรองฐาน (ถ้าต้องการ)
- `TT motor mount` — ฐานยึดมอเตอร์ TT (กล่องเหลือง)
- `idler wheel tank` — ล้อไม่มีกำลัง (ล้อตาม) สำหรับตีนตะขาบ

---

## 2. ระบบเฟืองล้อตีนตะขาบ (Track Gear System)

### องค์ประกอบหลัก

```
  ┌─────── IDLER WHEEL (ล้อตาม) ───────┐
  │           ปรับตึงสายพาน              │
  │                                      │
  │  ┌─────────────────────────────┐     │
  │  │    TRACK LINKS (ข้อตีนตะขาบ) │     │
  │  │    ═══════════════════════   │     │
  │  └─────────────────────────────┘     │
  │                                      │
  └─────── DRIVE SPROCKET ──────────────┘
             (เฟืองขับ - ต่อมอเตอร์)
```

### ส่วนประกอบสำคัญ 3 ส่วน

#### 2.1 Drive Sprocket (เฟืองขับ)
- ต่อตรงกับมอเตอร์ (หรือผ่าน gearbox)
- **จำนวนฟันแนะนำ**: 8-12 ฟัน สำหรับหุ่นขนาดเล็ก
- **สำคัญ**: Pitch (ระยะห่างระหว่างฟัน) ต้องตรงกับ pitch ของข้อตีนตะขาบ!

#### 2.2 Idler Wheel (ล้อตาม/ล้อรอง)
- ไม่ต่อมอเตอร์ — หมุนตามตีนตะขาบ
- **ต้องปรับตำแหน่งได้** (เลื่อนหน้า-หลัง) เพื่อตั้งความตึงสายพาน
- ถ้าตึงไป → มอเตอร์ทำงานหนัก / ถ้าหย่อนไป → ตีนตะขาบหลุด

#### 2.3 Track Links (ข้อตีนตะขาบ)
- **แบบ Modular Links**: พิมพ์แต่ละข้อแยก แล้วต่อด้วยหมุด/ลวด/ฟิลาเมนต์
- **แบบ Flexible Print**: ใช้ TPU พิมพ์เป็นสายยาวต่อเนื่อง
- ควรมี **ขอบกันหลุด (Flanges)** ทั้งบนล้อและบนตีนตะขาบ

### สูตรอัตราทดเฟือง (Gear Ratio)

```
Gear Ratio = จำนวนฟันเฟืองที่ถูกขับ (Driven) / จำนวนฟันเฟืองขับ (Driver)
```

| อัตราทด | ผลลัพธ์ | เหมาะกับ |
|---|---|---|
| 1:1 | ความเร็วสูง, แรงบิดต่ำ | หุ่นเบา พื้นเรียบ |
| 5:1 | สมดุล | งานทั่วไป |
| 10:1 | ความเร็วต่ำ, แรงบิดสูง | หุ่นหนัก / ปีนทางชัน |

> [!TIP]
> ถ้าใช้มอเตอร์ที่มี gearbox ในตัว (เช่น TT motor = ~1:48) ต้องคูณอัตราทดรวม: Gearbox ratio × Sprocket ratio

---

## 3. อัตราส่วนการออกแบบสำหรับสเปคของคุณ

### สเปคหุ่นยนต์

| พารามิเตอร์ | ค่า |
|---|---|
| ฐาน | ~10 × 10 cm |
| ความสูง | ~25-30 cm |
| น้ำหนัก | ~500-1000 g |
| เซนเซอร์ | IR × 2 (หน้าซ้าย-ขวา) |
| รูปทรง | ทรงกระบอกแนวตั้ง |

### ปัญหาหลัก: จุดศูนย์ถ่วงสูง (High Center of Gravity)

> [!WARNING]
> หุ่นทรงกระบอกสูง 25-30 cm บนฐาน 10 cm มี **อัตราส่วน สูง:กว้าง = 2.5-3:1** ซึ่ง **สูงมาก** — เสี่ยงล้มง่ายระหว่างเคลื่อนที่

### แนวทางแก้ไข

#### 3.1 ขยายฐานตีนตะขาบ
```
┌──────────────────────────────┐
│                              │
│   ┌──────────────────────┐   │
│   │   ตัวหุ่น ∅10cm      │   │
│   └──────────────────────┘   │
│                              │
│   ← 12-15 cm →              │  ← ความกว้างฐานตีนตะขาบ (กว้างกว่าตัวหุ่น)
│   ← 12-15 cm ยาว →          │  ← ความยาวตีนตะขาบ
│                              │
└──────────────────────────────┘
```

- **ความกว้างรวมตีนตะขาบ**: 12-15 cm (กว้างกว่าเส้นผ่านศูนย์กลางตัวหุ่น 20-50%)
- **ความยาวตีนตะขาบ**: 12-15 cm (เพิ่มพื้นที่สัมผัสพื้น)
- **ตีนตะขาบแต่ละข้าง กว้าง**: 2-3 cm

#### 3.2 ขนาด Sprocket & Wheel แนะนำ

| ชิ้นส่วน | ขนาดแนะนำ | หมายเหตุ |
|---|---|---|
| Drive Sprocket (เฟืองขับ) | ∅ 30-40 mm | วางหลัง, ต่อ TT motor |
| Idler Wheel (ล้อตาม) | ∅ 25-35 mm | วางหน้า, ปรับตึงได้ |
| Track Link (ข้อตีนตะขาบ) | กว้าง 20-30 mm | ยิ่งกว้างยิ่งเสถียร |
| Pitch (ระยะห่าง) | 5-8 mm | ต้องตรงกับฟันเฟือง |

#### 3.3 มอเตอร์แนะนำ

| มอเตอร์ | อัตราทด | แรงบิด | เหมาะกับ |
|---|---|---|---|
| TT Motor (กล่องเหลือง) | 1:48 | ~0.8 kg·cm | หุ่น ≤ 500g |
| TT Motor (กล่องน้ำเงิน) | 1:120 | ~1.5 kg·cm | หุ่น 500-800g |
| N20 Gear Motor | 1:100-1:298 | ~1.5-3 kg·cm | หุ่น 800-1000g ✅ |
| GA12-N20 Metal Gear | 1:150+ | ~2.5+ kg·cm | หุ่นหนัก + ปีนทางชัน |

> [!IMPORTANT]
> สำหรับน้ำหนัก 500-1000g + หุ่นสูง → **แนะนำ N20 Gear Motor (1:100 ขึ้นไป)** จะให้แรงบิดเพียงพอสำหรับ skid steering (การเลี้ยวโดยหมุนข้างเดียว ซึ่งใช้แรงบิดสูงมาก)

#### 3.4 ว่างกลางหรือใส่ Ball Caster?

สำหรับตีนตะขาบ **ไม่จำเป็นต้องใส่ ball caster ตรงกลาง** เพราะ:
- ตีนตะขาบสัมผัสพื้นตลอดความยาว → มีจุดรองรับเพียงพอ
- Ball caster จะเพิ่มแรงเสียดทาน ทำให้ skid steering หมุนยาก

**แต่** ถ้าอยากเพิ่มความมั่นคง:
- ทำเป็น **support rib** (ซี่ค้ำ) ระหว่างตีนตะขาบ 2 ข้าง แทน
- หรือใช้ **cross brace** เชื่อมด้านหน้า-หลัง

---

## 4. การติดตั้ง IR Sensor

### ตำแหน่งแนะนำ

```
           ด้านหน้าหุ่น (Top View)
    ┌─────────────────────────────┐
    │                             │
    │  IR_L ◄─── 45° ───► IR_R   │   ← ติด IR 2 ตัว มุม 45° ออกด้าน
    │        ╲           ╱        │
    │         ╲    ○    ╱         │   ← ตัวหุ่นทรงกระบอก
    │          ╲       ╱          │
    │           ╲     ╱           │
    │            ╲   ╱            │
    │         TRACK  TRACK        │
    └─────────────────────────────┘
```

### การออกแบบ Bracket
- พิมพ์ **bracket ยื่นออกด้านหน้า** ต่ำกว่าฐานตัวหุ่นเล็กน้อย
- ทำมุมลง ~15-30° เพื่อให้ IR เล็งพื้น (ถ้าใช้ตรวจจับเส้น/สิ่งกีดขวาง)
- **ระยะห่างระหว่าง IR 2 ตัว**: ≈ 6-8 cm (ห่างจากกัน 60-80% ของความกว้างฐาน)
- ใช้รูสกรู M2 หรือ M3 สำหรับยึด IR module

> [!TIP]
> ออกแบบ bracket ให้ปรับมุมได้ (ใส่ slot แทน hole) จะ calibrate ได้ง่ายกว่ามาก

---

## 5. การเลือกวัสดุ: PETG vs PLA

### สรุปเปรียบเทียบ

| คุณสมบัติ | PLA | PETG | TPU |
|---|---|---|---|
| **ความทนทาน** | ต่ำ (เปราะ) | ปานกลาง-สูง | สูงมาก |
| **ความยืดหยุ่น** | แข็ง | ยืดหยุ่นเล็กน้อย | ยืดหยุ่นสูง |
| **ความง่ายในการพิมพ์** | ง่ายมาก | ปานกลาง | ยาก |
| **ทนความร้อน** | ต่ำ (~60°C) | ดี (~80°C) | ดีมาก |
| **เหมาะกับ** | โครงสร้าง/ต้นแบบ | ชิ้นส่วนกลไก | ตีนตะขาบ/ยาง |

### 🎯 คำแนะนำสำหรับโปรเจคนี้

#### ใช้ PLA สำหรับ:
- ✅ **โครงสร้างหลัก (Chassis frame)** — ไม่ต้องรับแรงซ้ำๆ
- ✅ **Drive Sprocket / Idler Wheel** — ถ้า Infill ≥ 60% จะแข็งแรงเพียงพอ
- ✅ **IR Sensor bracket**
- ✅ **ฝาครอบ / ชิ้นส่วนตกแต่ง**

#### ใช้ PETG สำหรับ:
- ✅ **Track Links (ข้อตีนตะขาบ)** — ต้องรับแรงดัดซ้ำๆ ตอนวนรอบ sprocket
- ✅ **จุดยึดมอเตอร์ (motor mount)** — รับแรงสั่นสะเทือน
- ✅ **ชิ้นส่วนที่รับแรงกระแทก**

> [!IMPORTANT]
> **ข้อตีนตะขาบ (Track Links) ไม่ควรใช้ PLA!**  
> PLA เปราะ → ข้อต่อจะหักเมื่อพับรอบ sprocket ซ้ำๆ หลายร้อยรอบ  
> ถ้ามี PETG ให้ใช้ PETG สำหรับข้อตีนตะขาบ  
> ถ้าไม่มี PETG → ใช้ PLA ได้ **แต่** ต้องทำ Infill 80%+ และ Wall 4+ ชั้น แล้วเตรียมพิมพ์อะไหล่สำรอง

### การตั้งค่าพิมพ์แนะนำ

| Setting | PLA (โครงสร้าง) | PETG (ตีนตะขาบ) |
|---|---|---|
| Layer Height | 0.2 mm | 0.2 mm |
| Infill | 40-60% | 60-80% |
| Wall Loops | 3-4 | 4-5 |
| Top/Bottom Layers | 4-5 | 5-6 |
| Nozzle Temp | 200-215°C | 230-245°C |
| Bed Temp | 60°C | 70-80°C |
| Speed | 50-60 mm/s | 40-50 mm/s |
| Clearance (ช่องว่างชิ้นส่วนเคลื่อนที่) | 0.3 mm | 0.3-0.5 mm |

> [!TIP]
> **ถ้าใช้ PLA ทั้งหมด** (ไม่มี PETG): สามารถทำได้สำหรับ prototype แรก แต่ให้พิมพ์ **ข้อตีนตะขาบสำรอง 10-20 ชิ้น** เผื่อหัก และหลีกเลี่ยงการเร่งความเร็วมอเตอร์แบบฉับพลัน

---

## 6. สรุป Design Spec แนะนำ

```
╔══════════════════════════════════════════╗
║    ROBOT TANK TRACK — DESIGN SUMMARY     ║
╠══════════════════════════════════════════╣
║                                          ║
║  ตัวหุ่น: ทรงกระบอก ∅10cm × สูง 25-30cm ║
║  น้ำหนักรวม: 500-1000g                  ║
║                                          ║
║  ฐานตีนตะขาบ:                            ║
║  ├─ กว้างรวม: 13-15 cm                   ║
║  ├─ ยาว: 12-15 cm                        ║
║  ├─ ตีนตะขาบกว้างข้าง: 2-3 cm            ║
║  └─ ช่องว่างกลาง: ≈ 7.5 cm              ║
║                                          ║
║  มอเตอร์: N20 × 2 (อัตราทด 1:100+)      ║
║  Motor Driver: L298N หรือ TB6612         ║
║                                          ║
║  วัสดุ:                                  ║
║  ├─ โครงสร้าง: PLA (Infill 50%+)         ║
║  └─ ตีนตะขาบ: PETG (Infill 70%+)        ║
║                                          ║
║  เซนเซอร์: IR × 2 (หน้าซ้าย-ขวา)        ║
║  ├─ ระยะห่าง: 6-8 cm                    ║
║  └─ มุมลง: 15-30°                        ║
║                                          ║
╚══════════════════════════════════════════╝
```

---

## 7. ขั้นตอนการทำงาน

1. **ค้นหาโมเดลใน MakerWorld** ด้วยคำค้นข้างต้น — เลือกที่ขนาดใกล้เคียง 10cm
2. **ดาวน์โหลดและปรับขนาด** ใน slicer ถ้าจำเป็น
3. **พิมพ์ prototype ด้วย PLA ก่อน** — ทดสอบ fit กับมอเตอร์และเซนเซอร์
4. **พิมพ์ข้อตีนตะขาบจริงด้วย PETG** — เมื่อมั่นใจในขนาดแล้ว
5. **ประกอบและทดสอบ** — ปรับความตึงตีนตะขาบ, calibrate IR
6. **เสริมจุดอ่อน** — ติด support rib หรือ cross brace ถ้าจำเป็น
