HoneyKung/metorobot/Project/presentation_guide.md

# คู่มือนำเสนอ — 3 นาที 5 สไลด์

---

## 🎤 สคริปต์พูดแต่ละสไลด์

### สไลด์ 1: บทนำ (40 วินาที)

> สวัสดีครับ/ค่ะ วันนี้จะมานำเสนอโครงงานเรื่อง **"การพัฒนาระบบประมวลผลและตอบสนองอารมณ์แบบพลวัตบนอุปกรณ์ Edge สำหรับหุ่นยนต์ปฏิสัมพันธ์"**
>
> ปัจจุบันตลาดหุ่นยนต์เพื่อการศึกษาเติบโตสูงมาก แต่หุ่นยนต์ส่วนใหญ่ยังตอบสนองผู้ใช้แบบแข็งทื่อ ขาดอารมณ์ ขาดความรู้สึก ทำให้เด็กเบื่อ — และถ้าจะใช้ AI ก็ต้องส่งข้อมูลไป Cloud ซึ่งช้าและมีปัญหาด้านความเป็นส่วนตัว
>
> เป้าหมายของเราคือพัฒนา "สมอง" บนชิป ESP32-S3 ให้หุ่นยนต์รับรู้อารมณ์และตอบสนองได้แบบ Real-time จบในตัวเครื่องเลยครับ

---

### สไลด์ 2: Research Gap (30 วินาที)

> จากการศึกษางานวิจัยที่เกี่ยวข้อง เราพบช่องว่าง 3 ข้อ:
>
> **ข้อ 1 Methodology Gap** — ระบบส่วนใหญ่ใช้ 1-to-1 mapping คือจับได้อารมณ์อะไรก็เปลี่ยนทันที ทำให้หน้าจอหุ่นยนต์กระตุก ดูไม่เป็นธรรมชาติ
>
> **ข้อ 2 Application Gap** — เทคนิคที่ทำให้ลื่นไหลมีอยู่แล้ว เช่น EMA Smoothing แต่ยังถูกทดสอบบนคอมพิวเตอร์สเปกสูง ยังไม่มีใครนำมาลงบนบอร์ดเล็กๆ อย่าง ESP32
>
> **ข้อ 3 Comparative Gap** — ยังไม่มีงานที่เปรียบเทียบระหว่างวิธีพลวัตกับวิธีเดิมบน Edge AI

---

### สไลด์ 3: Core Technology ⭐ (30 วินาที)

> เทคโนโลยีหลักของเรามี 4 ส่วน:
>
> **ESP-DL** — ใช้โมเดล MSR01 หาหน้า แล้ว MNP01 หา 5 จุดสำคัญบนใบหน้า ทั้งหมดรันบนชิปเลย ไม่ต้องพึ่ง Cloud
>
> **EMA Smoothing + Adaptive Baseline** — กรอง noise จากกล้อง แล้วปรับค่าอ้างอิงอัตโนมัติตามโครงหน้าแต่ละคน
>
> **Hysteresis 2 ชั้น** — ป้องกันอารมณ์กระตุก ต้องเห็นอารมณ์ใหม่ 2 เฟรมติดต่อกัน แล้วค้างอย่างน้อย 2 วินาที ก่อนเปลี่ยน
>
> **Idle Behaviors** — หุ่นยนต์กระพริบตา เหลือบมอง หันหัว อัตโนมัติ ทำให้ดูมีชีวิตแม้ไม่โต้ตอบ

---

### สไลด์ 4: Comparison Table (30 วินาที)

> จากตาราง เราศึกษา Paper Q1 จำนวน 5 เรื่อง พบว่า:
>
> งานของ **Goulart** ใช้ Facial Landmark เหมือนเรา แต่ประมวลผลบน PC
> งานของ **Ribeiro** ใช้หลักแอนิเมชันสวยงาม แต่ทำบนหุ่นสเปกสูง
>
> **งานของเรา** จึงนำเทคนิคจากทั้ง 2 งานมารวมกัน แล้วเพิ่ม Hysteresis และ State Machine เพื่อให้ทำงานได้บนบอร์ดเล็กจริงๆ ครับ

---

### สไลด์ 5: Proposed Workflow & Status (50 วินาที)

> กระบวนการทำงานคือ: กล้องจับภาพ → ESP-DL ตรวจจับใบหน้า → กรองด้วย EMA → ตัดสินอารมณ์ผ่าน Hysteresis → แสดงผลหน้าจอ TFT + ขยับ Servo พร้อมกัน
>
> สิ่งที่ทำเสร็จแล้ว: ออกแบบสถาปัตยกรรมระบบครบ ทดสอบ AI บนบอร์ดเบื้องต้นสำเร็จ
>
> ขั้นต่อไป: ประกอบโครงสร้าง 3D Print และทดสอบกับฮาร์ดแวร์จริง
>
> ขอบคุณครับ/ค่ะ

---

## 📊 อธิบาย Section 2.1: ทฤษฎีและเทคโนโลยีที่ใช้ (พร้อมภาพ)

### 2.1.1 ESP-DL: โมเดลตรวจจับใบหน้าบน Edge

ESP-DL Two-Stage Pipeline

**ESP-DL** คือไลบรารี Deep Learning สำหรับ ESP32 จาก Espressif — ออกแบบมาให้รัน Neural Network บนชิปโดยตรง ไม่ต้องพึ่ง Cloud

| โมเดล | หน้าที่ | Output |
|---|---|---|
| **MSR01** | ตรวจจับใบหน้า → Bounding Box | มีหน้ามั้ย? อยู่ตรงไหน? |
| **MNP01** | หา 5 Keypoints | ตาซ้าย, ตาขวา, จมูก, ปากซ้าย, ปากขวา |

🔗 **อ้างอิง:** [ESP-DL GitHub — Espressif Systems](https://github.com/espressif/esp-dl)

---

### 2.1.2 EMA Smoothing (กรอง Noise)

EMA Smoothing

**สมการ:** `smoothed = α × new + (1-α) × old` โดย α = 0.5

ค่า Ratio จาก 5 Keypoints (ความกว้างปาก, ระยะจมูก-ปาก) จะผ่าน EMA ก่อน → **กรอง noise จากกล้อง** ทำให้ค่าไม่กระตุก

---

### 2.1.3 Adaptive Baseline (ปรับค่าอ้างอิงอัตโนมัติ)

**ปัญหา:** คนแต่ละคนมีโครงหน้าต่างกัน แสงเปลี่ยน ระยะห่างเปลี่ยน → ค่า "ปกติ" ของแต่ละคนไม่เท่ากัน

**วิธีแก้:** 
1. **เริ่มต้น:** เก็บค่า 10 เฟรมแรก → คำนวณ Baseline เฉลี่ย
2. **ระหว่างใช้:** ปรับ Baseline ช้ามาก (rate = 0.003/เฟรม) → ชดเชยแสงที่เปลี่ยนไป

---

### 2.1.4 Hysteresis (ป้องกันอารมณ์กระตุก)

Hysteresis

**2 ชั้นป้องกัน:**
- **ชั้น 1 — Consecutive Count:** ต้องเห็นอารมณ์ใหม่ **2 เฟรมติด** ก่อนเปลี่ยน (ป้องกัน noise ชั่วคราว)
- **ชั้น 2 — Hold Time:** หลังเปลี่ยนแล้ว ต้อง **ค้างอย่างน้อย 500ms** (กล้อง) + **2000ms** (ตัวหลัก) ก่อนเปลี่ยนอีก

**ผลลัพธ์:** ไม่กระตุก ดูเป็นธรรมชาติ!

---

### 2.1.5 Emotion State Machine (FSM)

Emotion FSM

**FSM** ควบคุมการเปลี่ยนอารมณ์ 8 สถานะ: Normal, Happy, Sad, Angry, Shocked, Sleepy, Confused, Love

```
กล้องส่งอารมณ์ → เหมือนเดิม? → ครบ Hold? → เปลี่ยน → วาดตา + ขยับร่างกาย
```

---

### 2.1.6 Body-Face Coordination

Body-Face Coordination

ทุกครั้งที่เปลี่ยนอารมณ์ → **ตา (TFT) + ร่างกาย (Servo) ขยับพร้อมกัน:**

| อารมณ์ | หัว | แขน |
|---|-----|---|
| Happy 😊 | ตรง 90° | ยกขึ้น |
| Sad 😢 | ก้ม 80° | ตก |
| Shocked 😲 | เงย 95° | ยกสูง + แบมือ |

---

### 2.1.7 Idle Behaviors (พฤติกรรมมีชีวิต)

หุ่นทำอัตโนมัติแม้ไม่โต้ตอบ:

| Behavior | ทุกๆ | ทำอะไร |
|---|---|---|
| 😑 Blink | 2.5-5.5 วิ | กระพริบตา |
| 👀 Glance | 8-20 วิ | เหลือบมอง |
| 😮‍💨 Sigh | 25-45 วิ | ถอนหายใจ |
| 🔄 Head Look | 10-25 วิ | หันหัวซ้าย-ขวา |

---

### 2.3 สถาปัตยกรรม 2 บอร์ด

System Architecture

---

## 📚 อธิบาย Section 2.2: งานวิจัย 5 เรื่อง (พร้อมลิงก์)

### Paper 1: Belpaeme et al. (2018) — หุ่นยนต์เพื่อการศึกษา

🔗 **ลิงก์:** [DOI: 10.1126/scirobotics.aat5954](https://doi.org/10.1126/scirobotics.aat5954)

| รายการ | รายละเอียด |
|---|---|
| **วารสาร** | Science Robotics **(Q1)** |
| **Input** | Review งานวิจัย 101 เรื่อง |
| **Method** | Systematic Review + Meta-analysis |
| **Result** | หุ่นยนต์ที่แสดงอารมณ์ + เข้าอกเข้าใจ → เพิ่มแรงจูงใจผู้เรียน |
| **Limitation** | เป็นงาน review ไม่ได้สร้างระบบจริง |
| **เราเติมเต็ม** | ✅ เราสร้างระบบจริงบน ESP32 |

---

### Paper 2: Spezialetti et al. (2020) — Emotion Recognition สำหรับ HRI

🔗 **ลิงก์:** [DOI: 10.3389/frobt.2020.532279](https://doi.org/10.3389/frobt.2020.532279)

| รายการ | รายละเอียด |
|---|---|
| **วารสาร** | Frontiers in Robotics and AI **(Q1)** |
| **Input** | Survey งานด้าน emotion recognition |
| **Method** | Classification of approaches (facial, physiological, multimodal) |
| **Result** | Facial expression เป็นวิธีที่ใช้มากที่สุดและได้ผลดี |
| **Limitation** | ส่วนใหญ่ทดสอบบน PC/Cloud ยังไม่มีบน Edge ทรัพยากรต่ำ |
| **เราเติมเต็ม** | ✅ เราทำบน ESP32-S3 (Edge AI) |

---

### Paper 3: Goulart et al. (2019) — Facial Landmark → อนุมานอารมณ์

🔗 **ลิงก์:** [DOI: 10.3390/s19132844](https://doi.org/10.3390/s19132844)

| รายการ | รายละเอียด |
|---|---|
| **วารสาร** | Sensors — MDPI **(Q1)** |
| **Input** | ภาพ Visual + Thermal จากกล้อง |
| **Method** | Facial Landmark Detection → คำนวณ Ratio → จำแนกอารมณ์ |
| **Result** | ตรวจจับอารมณ์ในปฏิสัมพันธ์เด็ก-หุ่นยนต์ได้ ความแม่นยำสูง |
| **Limitation** | ใช้ PC ประมวลผล + ใช้ 1-to-1 mapping → กระตุก |
| **เราเติมเต็ม** | ✅ เราใช้วิธีเดียวกันแต่รันบนชิป + เพิ่ม EMA + Hysteresis |

> 💡 **งานนี้คล้ายเรามากที่สุด** — ใช้ Landmark คำนวณ Ratio เหมือนกันเลย แต่เราเพิ่ม smoothing + hysteresis + ทำบนบอร์ดเล็ก

---

### Paper 4: Ribeiro & Paiva (2021) — หลักแอนิเมชันสำหรับหุ่นยนต์

🔗 **ลิงก์:** [DOI: 10.1145/2157689.2157814](https://doi.org/10.1145/2157689.2157814)

| รายการ | รายละเอียด |
|---|---|
| **วารสาร** | ACM/IEEE HRI **(Q1 Conference)** |
| **Input** | หลักแอนิเมชัน 12 ข้อของ Disney + หุ่นยนต์จริง |
| **Method** | ประยุกต์ Easing, Anticipation, Follow-through กับหุ่นยนต์ |
| **Result** | หุ่นยนต์ถูกประเมินว่า "มีชีวิต" มากกว่าอย่างมีนัยสำคัญ |
| **Limitation** | ทดสอบบนหุ่นสเปกสูง (PC ควบคุม) ยังไม่มีบนบอร์ดเล็ก |
| **เราเติมเต็ม** | ✅ เรานำหลัก Idle Behaviors + Body-Face มาใช้บน ESP32 |

> 💡 **จุดเชื่อมงานเรา:** Idle Behaviors (กระพริบ, เหลือบมอง, หันหัว) + Body-Face Coordination มาจากแนวคิดงานนี้

---

### Paper 5: Bennett & Šabanović (2014) — Minimal Facial Features

🔗 **ลิงก์:** [DOI: 10.1007/s12369-014-0237-z](https://doi.org/10.1007/s12369-014-0237-z)

| รายการ | รายละเอียด |
|---|---|
| **วารสาร** | Int. J. Social Robotics — Springer **(Q1)** |
| **Input** | Action Units (AU) จาก FACS + หุ่นยนต์ใบหน้าเรียบง่าย |
| **Method** | วิเคราะห์ว่าต้องการ feature ขั้นต่ำกี่ตัวเพื่อแสดงอารมณ์ |
| **Result** | คุณสมบัติน้อยๆ (ตา + ปาก) ก็เพียงพอให้คนจดจำอารมณ์ได้ |
| **Limitation** | ทดสอบแค่การรับรู้ ไม่ได้ทดสอบ real-time หรือ smooth transition |
| **เราเติมเต็ม** | ✅ เราใช้แค่ตาบน TFT 2 ดวง + FSM ให้เปลี่ยนอย่างราบรื่น |

> 💡 **จุดเชื่อมงานเรา:** ยืนยันว่าหุ่นยนต์แค่วาดตา 2 ดวง ก็แสดงอารมณ์ได้เพียงพอ — ไม่ต้องมีปากหรือคิ้ว

---

## 🗺️ แผนที่ความเชื่อมโยง: งานวิจัย 5 เรื่อง → งานของเรา

```
  Paper 1 (Belpaeme)           Paper 2 (Spezialetti)
  หุ่นยนต์ + อารมณ์ = ดี       Facial = วิธีที่ดีที่สุด
         \                       /
          \                     /
           ▼                   ▼
  ┌────────────────────────────────────┐
  │        งานวิจัยของเรา              │
  │  Facial Landmark (จาก Paper 3)     │
  │  + Animation Principles (Paper 4)  │
  │  + Minimal Features (Paper 5)      │
  │  ────────────────────────────       │
  │  เพิ่ม: EMA + Hysteresis + FSM     │
  │  รันบน: ESP32-S3 (Edge AI)         │
  └────────────────────────────────────┘
           ▲                   ▲
          /                     \
         /                       \
  Paper 3 (Goulart)          Paper 4 (Ribeiro)
  Landmark → Ratio            Animation → มีชีวิต
  (บน PC)                     (บนหุ่นสเปกสูง)
  
                Paper 5 (Bennett)
                ตา+ปาก = พอแล้ว
```
