HoneyKung/metorobot/slide-shots/06-tutorial-auto.png

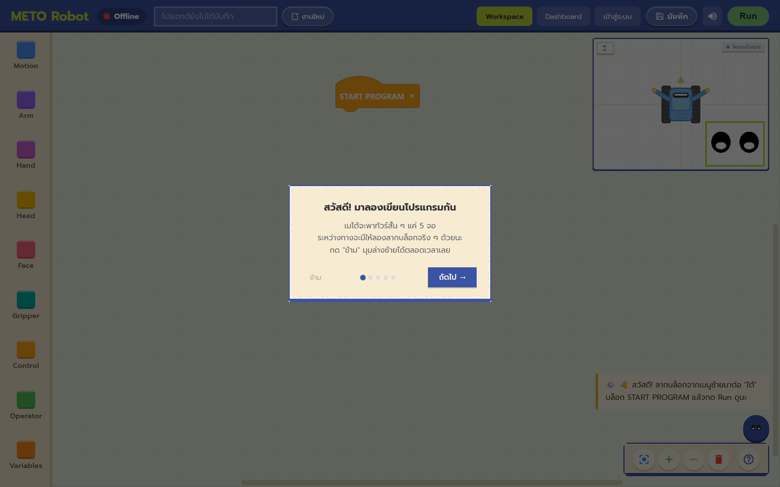
slide-shots/06-tutorial-auto.png
