HoneyKung/metorobot/tools/meto_vision/test_out/out_bus.jpg

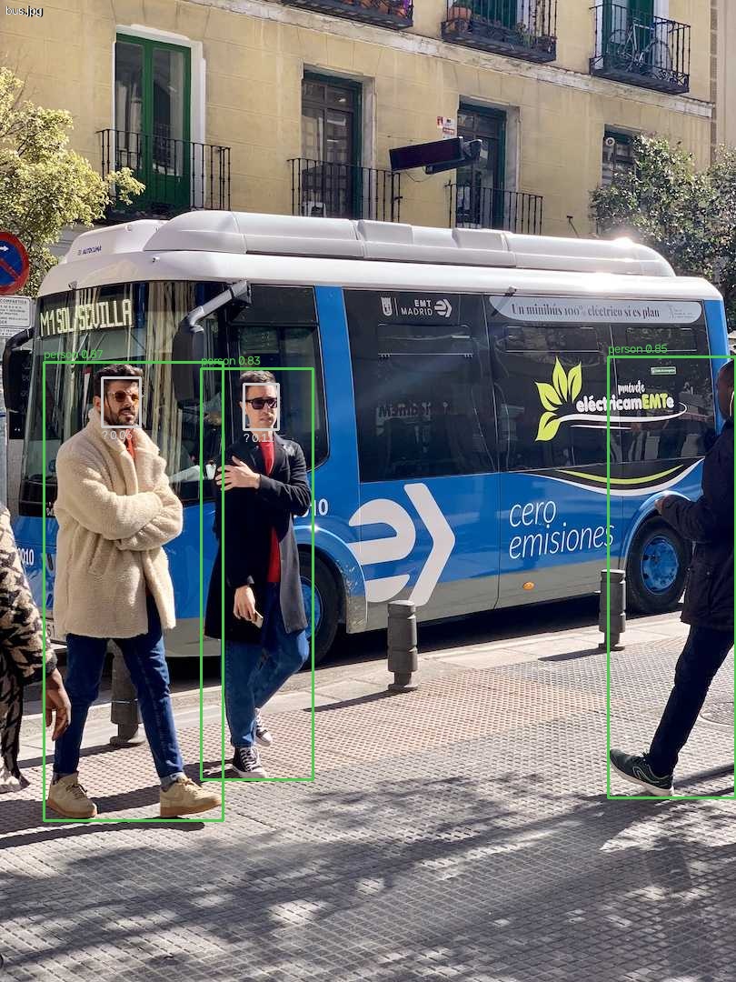
tools/meto_vision/test_out/out_bus.jpg
