HoneyKung/metorobot/tools/meto_vision/test_out/out_coco_bedroom_bottle_632.jpg

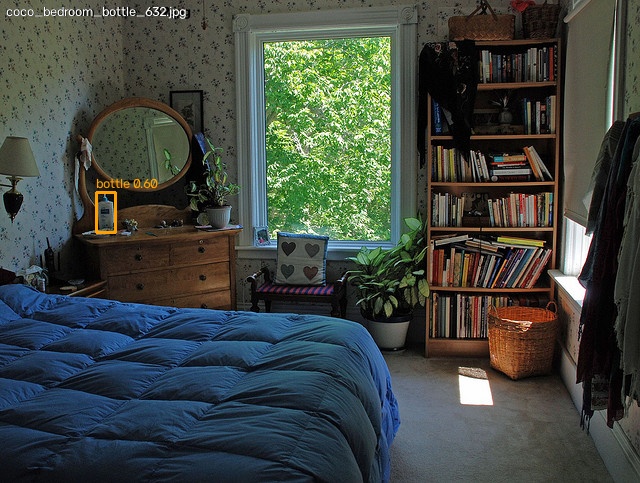
tools/meto_vision/test_out/out_coco_bedroom_bottle_632.jpg
