HoneyKung/metorobot/tools/meto_vision/test_out/out_coco_bottle_5193.jpg

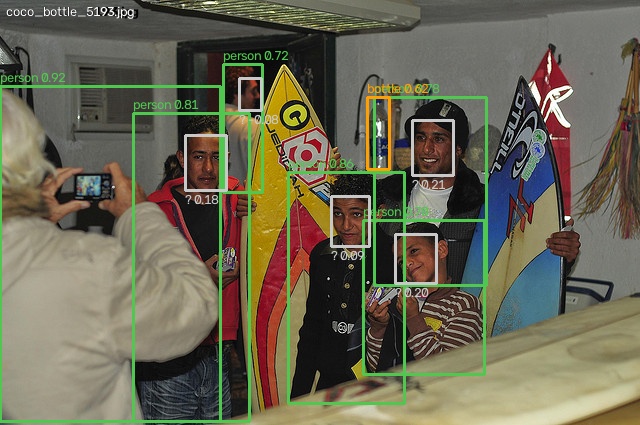
tools/meto_vision/test_out/out_coco_bottle_5193.jpg
