HoneyKung/metorobot/tools/meto_vision/test_out/out_coco_cups_2431.jpg

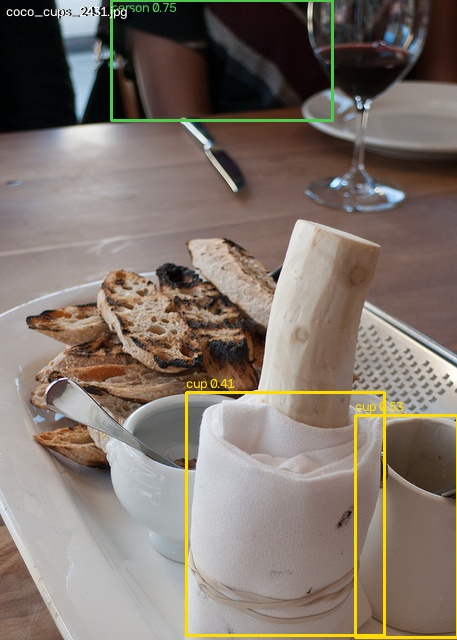
tools/meto_vision/test_out/out_coco_cups_2431.jpg
