HoneyKung/metorobot/tools/meto_vision/test_out/out_zidane.jpg

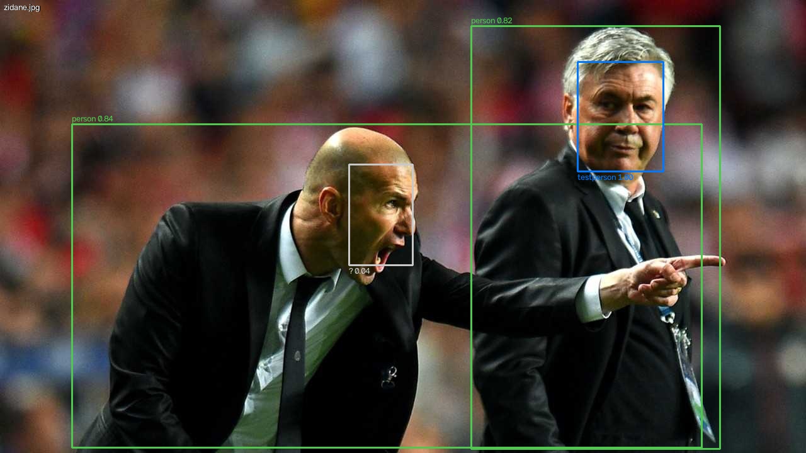
tools/meto_vision/test_out/out_zidane.jpg
