HoneyKung/metorobot/tools/meto_vision/test_out/out_zidane_flip_small.jpg

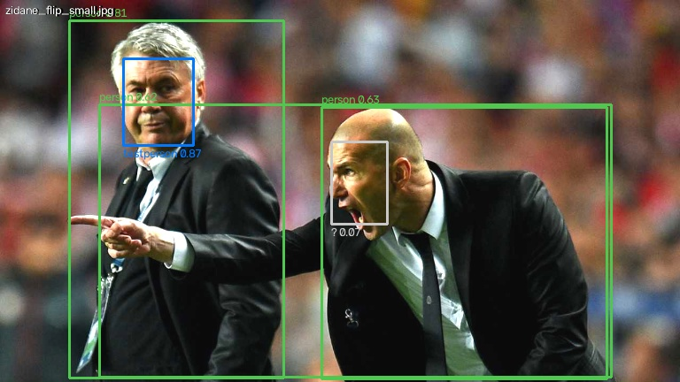
tools/meto_vision/test_out/out_zidane_flip_small.jpg
