HoneyKung/metorobot/ใบสั่งงาน/ใบ02_รอบแก้1_FIX-FIRST.md

# ใบ 02 รอบแก้ 1 — ผลตรวจหัวงาน: FIX FIRST (เฉพาะ mg996r_snap_pocket)

อ่านใบ 02 เดิม (`ใบ02_กรอบทดสอบ_PCA9685_VL53L0X_MG996R_Luna.md`) อีกครั้ง โดยเฉพาะ "สรุปการวาง MG996R (บังคับ)" แล้วแก้เฉพาะชิ้น MG996R ใน `ผล/meto_fit_tests.scad` และ export `ผล/mg996r_snap_pocket.stl` ใหม่ · ชิ้นอื่นผ่าน ห้ามแตะ · อัปเดต `ผล/รายงานใบ02.md` ส่วน MG996R และตารางผลตรวจ

## ข้อ 1 — ใช้แกนผิดตัว (สำคัญที่สุด)
รายงานบอกแกนเพลา "วิ่งตาม Y, ศูนย์ X=0, ทะลุผนังหน้า Y=-18 ถึง -37" — **นั่นไม่ใช่แกน MG996R** เป็นช่องกลางตัว (คอ/อุปกรณ์อื่น)
หัวงานตัดหน้าตัด `layer4_original.stl` (ray-crossing, กริด 2 mm) พบ:
- ช่องเซอร์โวแขน 2 ช่อง ซ้าย/ขวา: ภายในประมาณ X −44..−4 และ +4..+44, Y ประมาณ 14..56 (ผนังขวางที่ Y≈14 และหน้าที่ Y≈56–64)
- **ผนังนอกด้านข้าง X=±46/48 มีรูทะลุ** ที่ z=−70 ช่วง Y≈38–50 และ z=−62 ผนังบางลงช่วง Y≈22–34 → นี่คือแนวแกน MG996R ที่ "วางนอน แกนออกข้าง ยื่นทะลุกำแพง หน้าฝั่งแกนนาบกำแพงพอดี" ตามคำเจ้าของ
**ต้องทำ:** วัดใหม่ละเอียด (กริด ≤0.5 mm หลายระดับ z) หา (ก) ขนาดช่องภายในจริง (ข) ตำแหน่ง/ขนาด/รูปร่างรูแกนในผนังข้าง และระดับ z ของศูนย์แกน (ค) บ่า/ร่องที่รับหูยึดเซอร์โว (Y≈6–14 มีผนังขวางและช่องเล็กๆ ตรวจว่าเกี่ยวกับหูหรือไม่) แล้วสร้างกรอบทดสอบช่องเดียว (ฝั่งซ้าย) ที่คัดลอกช่อง + รูแกนในผนังข้าง + ส่วนรับหู ให้ตรง โดยแกนทะลุผนังข้าง ไม่ใช่ผนังหน้า · ตัด collar Y−18..−37 เดิมทิ้ง
**ห้ามมีครีบบนผนังฝั่งแกน** (ผนังข้างที่มีรู)

## ข้อ 2 — ขอเกี่ยวทำงานไม่ได้และขวางการใส่
`mg_snap_arm()` ใช้ hull ระหว่างก้อนโคนกับก้อนปลายที่ติดผิวผนังด้านใน → ขาเป็นเนื้อเดียวกับผนังตลอดความยาว **งอไม่ได้** และยื่นเข้าช่อง 1.6 + ปาก 0.7 = 2.3 mm ต่อข้าง ที่ z 15–19.4 จากพื้น ซึ่ง **ต่ำกว่าผิวบนเซอร์โว (~19.7)** → เซอร์โวกดลงไม่ได้
**ต้องทำ:**
- ขาเป็นคานยื่นในระนาบ XY ติดผนังเฉพาะที่โคน มีร่องหลบด้านหลังขา (≥0.6 mm, ทะลุแนวตั้งตลอดความสูงขา) ให้ขางอออกได้
- ผิวขาด้านในเสมอผิวผนังด้านใน ไม่ยื่นเข้าช่อง เฉพาะปากยื่นเข้า 0.7 มีมุมนำเข้าด้านบน ≥45°
- ใต้ปาก (ระนาบที่เกี่ยว) อยู่สูงกว่าผิวบนตัวเซอร์โวที่วางในช่อง (คำนวณจากพื้นช่องเดิม + ความหนาเซอร์โว 19.7 + 0.1) และยอดปากไม่เกินขอบบนช่องเดิม (ห้ามเพิ่มความสูง) · ถ้าที่ว่างเหนือผิวเซอร์โวไม่พอให้ปากหนา ≥0.6 mm ให้รายงาน "ไม่พอ" พร้อมตัวเลข อย่าฝืน
- วางขอเกี่ยวบนผนังที่ไม่ใช่ฝั่งแกน และไม่ชนสายเซอร์โว (สายออกด้านไหนให้ดูจากช่องเดิมว่ามีร่องสาย ถ้าไม่แน่ใจให้บอก)

## ส่งมอบ
- export STL ใหม่, ตรวจ watertight/bounds
- เพิ่มหัวข้อ "รอบแก้ 1" ในรายงาน: ตัวเลขช่อง/รูแกน/z ศูนย์แกนที่วัดใหม่ พร้อมวิธีวัด, ตำแหน่งขอเกี่ยว และระยะใต้ปากเทียบผิวบนเซอร์โว
- คำตอบสุดท้าย 5 บรรทัด · ระบุ "ยังไม่ได้พิมพ์ทดสอบ"
