HoneyKung/metorobot/ใบสั่งงาน/ใบ02_รอบแก้2_FIX-FIRST.md

# ใบ 02 รอบแก้ 2 — FIX FIRST (MG996R) · เปลี่ยนวิธี: ตัดจากชั้น 4 เดิมตรง ๆ

## ผลตรวจรอบแก้ 1 (หัวงานตัดหน้าตัด STL ใหม่เอง)
ผ่าน: ร่องแกนตัวยูบนผนังข้าง, ขอเกี่ยวมีร่องหลบ/ช่องปลาย งอได้, ใต้ปากอยู่พื้น+19.8
ไม่ผ่าน: ในกรอบใหม่ แถบ Y 0–6 (ฝั่งตรงข้ามช่องสาย) เป็นเนื้อตันตลอดความสูง และช่องภายในเริ่ม Y≈7 ยาว ~40 → **ไม่มีที่ให้หูยึดเซอร์โว** ทั้งที่ชั้นเดิมมีโซนหู Y≈6–14 (ผนังขวางที่ Y≈6 และ Y≈14 มีบ่า/ช่องเว้น) · การสร้างช่องใหม่จากตัวเลขทำให้รายละเอียดหล่นซ้ำ

## วิธีใหม่ (บังคับ)
ช่องนี้เจ้าของยืนยันว่าใส่ได้พอดีเป๊ะ จึง **ห้ามสร้างช่องใหม่จากตัวเลข** ให้ใช้เรขาคณิตจริง:
1. ใน OpenSCAD `import("../อ่านก่อน/layer4_original.stl")` แล้ว `intersection()` กับกล่องที่ครอบช่องเซอร์โวซ้ายทั้งช่อง รวมผนังข้างที่มีร่องแกน, โซนหู Y≈6–14 ทั้งหมด, ผนังหลัง+ช่องสาย และพื้นใต้ช่อง (เลือกกล่องให้ได้ชิ้นที่ตั้งบนเตียงได้ และไม่ตัดผ่านกลางรายละเอียดของช่อง)
2. ถ้าพื้นชั้นเดิมไม่ปิดใต้ช่อง ให้เติมแผ่นพื้นบาง 1.2 mm ใต้ชิ้นที่ตัด (ห้ามเติมเนื้อเข้าในช่อง)
3. เติมขอเกี่ยวตามแบบรอบแก้ 1 (ขาแนวนอน ร่องหลบ 0.6 ช่องปลาย 0.6 ปาก 0.7 ใต้ปากพื้นช่อง+19.8) บนผนังฝั่งตรงข้ามแกนเท่านั้น: ตัดผนังเดิมตรงตำแหน่งขาออกด้วย `difference()` แล้วใส่ขา · ถ้าผนังเดิมบางจนทำขาไม่ได้ ให้รายงาน อย่าย้ายผนัง
4. ครีบบีบ: **ไม่ใส่** ในชิ้นนี้ (ช่องเดิมแน่นพอดีอยู่แล้ว ใส่แล้วจะแน่นเกิน)
5. ย้ายชิ้นให้พื้นอยู่ Z=0, export `ผล/mg996r_snap_pocket.stl` ทับ, เก็บ `.scad` ส่วนนี้ใน `meto_fit_tests.scad` (part = "mg996r")
6. ตรวจ: watertight, bounds, และเทียบหน้าตัดชิ้นใหม่กับชั้นเดิมที่ z เดียวกันอย่างน้อย 3 ระดับ (นับจุดกริด 0.5 mm ที่ต่างกัน นอกจากบริเวณขอเกี่ยว/พื้นเติมต้องเป็น 0) ใส่ผลในรายงาน

## ส่งมอบ
- STL ใหม่, รายงานหัวข้อ "รอบแก้ 2" (กล่องตัด, ผลเทียบหน้าตัด, ตำแหน่งขอเกี่ยว)
- คำตอบสุดท้าย 5 บรรทัด · "ยังไม่ได้พิมพ์ทดสอบ"
