HoneyKung/metorobot/CHANGELOG.md

# CHANGELOG — log บันทึกการอัปเดตโค้ดโปรเจค METO

> ไฟล์นี้คือ **log การแก้โค้ด** ของโปรเจค — แก้อะไร ทำไม กระทบไฟล์ไหน **จดที่นี่ทุกครั้งที่แก้**
> (ไม่ใช่ log ที่แสดงในเว็บ — หน้าเว็บไม่มีฟีเจอร์ log ให้ผู้ใช้)

---

## [2.16] 5 พฤศจิกายน 2026 — บล็อกครบตามเฟิร์มแวร์ใหม่ (6 พ.ย.) + บล็อกเซนเซอร์ที่รันได้จริง

อ้างอิงตารางคำสั่ง: `Robo/Part Robot/งานโค้ด_2026-11/รายงานเฟิร์มแวร์_วันศุกร์.md` หัวข้อ 2–3
รายงานเต็ม (รายการบล็อก → คำสั่ง, ผลทดสอบ, ภาพ): `Robo/Part Robot/งานโค้ด_2026-11/รายงานเว็บบล็อก.md`

### บล็อกใหม่ 15 ตัว (ทุกคำสั่งใหม่ในตาราง)
| หมวด | บล็อก | คำสั่ง |
|---|---|---|
| Motion | `move_timed` forward/backward for N ms · `turn_timed` · `move_stop` | `fw:` `bw:` `tl:` `tr:` (100–5000) · `x` |
| Arm | `arm_lift` Left/Right/Both lift to N° | `lift1:` `lift2:` `lift:` (−43…48) |
| Hand | `hand_grip_pct` Left/Right/Both หนีบ N% | `hand1:` `hand2:` `hand:` (0…100) |
| Head | `head_yaw` · `head_tilt` · `head_speed` | `yaw:` (−90…90) · `tilt:` (−10…10) · `hs:` (10…200) |
| Face | `face_emotion` (9 อารมณ์ ตา + ท่าทาง) | `emo:N/H/S/A/O/Z/C/V/B` |
| Control | `wait_ms` · `controls_forever` | `wait:` (0…10000) |
| เซนเซอร์ | `sensor_edge` (Motion) · `sensor_holding` `sensor_grab_ok` (Gripper) · `sensor_face` (Face) | อ่าน `/state` |

- ช่องตัวเลขใช้ shadow `num_*` ที่จำกัดช่วงตามตาราง (`METO_RANGE`) พิมพ์เกินไม่ได้ · ถ้าเสียบตัวแปร/สูตร ค่าจะถูกบีบอีกชั้นตอนสร้างคำสั่ง (`METO_CMD`)
- ไม่เพิ่มหมวด/สีใหม่ — บล็อกเซนเซอร์อยู่ในหมวดของอุปกรณ์นั้น (สีหมวดผูกกับรายงาน 3.3.4)

### แก้บล็อกเดิม (คำสั่งที่ส่งเหมือนเดิมทุกตัว ชนิดบล็อกเดิม โปรเจกต์เก่าโหลดได้)
- **Hand:** Down/Center/Up → **กาง/กลาง/หนีบ** และ**แก้ข้าง**: คำสั่ง 1/2/3 เป็นมือขวา (CH3) ตามเฟิร์มแวร์ แต่ป้ายเดิมเขียน Left Hand
  → `hand_left_*` แสดงเป็น "Right Hand: กาง (1)/กลาง (2)/หนีบ (3)" · `hand_right_*` แสดงเป็น "Left Hand: หนีบ (4)/กลาง (5)/กาง (6)"
- **Arm:** Close/Normal/Open → **Up/Middle/Down** (เฟิร์มแวร์แปล r/t = ยก, f/g = กลาง, v/b = ลง)
- `delay_sec` ใส่ shadow เลข 1 ในกล่องเครื่องมือ (เดิมช่องว่าง) และเปลี่ยนสีจากเขียวเป็นสีหมวด Control
- ธีม: เพิ่ม `math_blocks` (เขียว Operator) และ `variable_blocks` (ส้ม Variables) — เดิมได้สีของ Classic

### บล็อกพื้นฐานที่เพิ่ม
`logic_operation` (and/or) · `logic_negate` (not) · `math_arithmetic` (+ − × ÷ ^) · `math_random_int` · `controls_forever` · while แบบ until ในกล่องเครื่องมือ · `math_change` มากับหมวด Variables อยู่แล้ว

### MetoRunner — ตัวรันทีละช่วง (script.js)
- เดิม: คลี่ทั้งโปรแกรมเป็นสตริงเดียวด้วย `blockToCode` → if/while ตัดสินตอนกด Run ครั้งเดียว ตัวแปรในเงื่อนไขกลายเป็น false เงียบ ๆ
- ตอนนี้: เดินบล็อกเอง สะสมคำสั่ง · เจอบล็อกเซนเซอร์ → ส่งคำสั่งที่ค้าง (`/run`) → รอ `/state` busy=0 → อ่าน `/state` สด → ตัดสิน
- **โปรแกรมที่ไม่มีบล็อกเซนเซอร์ ส่งครั้งเดียวทั้งก้อนเหมือนเดิม** (ทดสอบแล้ว สตริงตรงกับ generator เดิมทุกบล็อกเดิม ต่างแค่ช่องว่างที่ generator เดิมแทรกไว้)
- ตัวแปร สูตร สุ่ม and/or/not ใช้ได้จริงแล้ว → เลิกคำเตือน "เงื่อนไขที่ใช้ตัวแปรยังใช้ไม่ได้"
- if มี else if ได้ (เดิม generator อ่านแค่ IF0/ELSE)
- ไม่ได้ต่อหุ่นจริง → เซนเซอร์ใช้ค่าจากซิม (ขอบโต๊ะ = ขอบเวที · ถือของ = หลังสั่ง G/Q/grip≥50) และขึ้นบับเบิลบอก
- สตริงยาวแบ่งยิง /run ก้อนละ ≤ 900 ตัวอักษร · เจอ 409 BUSY รอแล้วยิงใหม่ · CALIB_MODE/FACE_TEST หยุดส่ง
- วนซ้ำที่ไม่มีเซนเซอร์เพดาน 100 รอบ (เท่าเดิม) · วนซ้ำรอเซนเซอร์เพดาน 500 รอบ กดหยุดได้ตลอด

### ปุ่มหยุด
ส่ง `x` ให้หุ่นจริงด้วย (เฟิร์มแวร์ใหม่หยุดกลางคิวได้) — เดิมหยุดแค่ซิม หุ่นจริงเดินคิวต่อจนจบ · ยิงเฉพาะตอนเจอหุ่น

### Digital twin (robot-sim.js)
- ท่าทางเปลี่ยนจาก 3 ท่า (0/1/2) เป็นองศาต่อเนื่อง: `yaw tilt liftL liftR gripL gripR`
- เล่นคำสั่งใหม่ได้ทุกตัว · คำสั่งตามเวลาใช้เวลาจริง (`fw:3000` รอ 3 วิ) คำสั่งเดิมยัง 600 ms เท่าเดิม · เลี้ยวตามเวลาหมุนตามสัดส่วน (1 วิ = 90°)
- มุมบน: แขนสั้นลงตามมุมยก + ก้ามหนีบ 2 ข้างห่างตาม % · ขีดแดงที่หัวหุ่นเมื่อเจอขอบ
- **กล่อง "ด้านข้าง"** มุมล่างซ้ายของเวที: หัวเอียงตาม tilt (ขยาย 2 เท่าให้เห็น) แขนตามองศา ก้ามตาม % พร้อมตัวเลขก้มเงย
- `applyLiveState` อ่านฟิลด์ใหม่ `yaw tiltRel lift1 lift2 grip1 grip2 holding verify cliffL cliffR cam camOk` · หุ่นเฟิร์มแวร์เก่ายังแปลงจาก `head arm1 arm2` ได้
- `emo:` เล่นท่าทางตาม `doBodyGesture` (แปลงมุมเซอร์โวเป็นองศาคร่าว ๆ) ค้าง 2.5 วิแล้วกลับ N · ถือของอยู่ไม่ขยับแขน
- API ใหม่: `RobotSim.isLive() / fetchState() / simSensorState() / host() / setSimCam()` · `runSimulation(cmd, {cont, more})` · `simBeginProgram()`

### ไฟล์อื่นที่แก้ให้ตรงกัน
- `skills.py` COMMAND_BLOCKS + LOOP_BLOCKS (`controls_forever`)
- `dashboard.py` **ประกาศ `GOAL_BLOCK_CHOICES`** — เดิมถูกอ้างถึง 3 ที่แต่ไม่มีบรรทัดประกาศ (`/api/tasks/blocks`, `/api/assignments/objectives` และการตรวจเกณฑ์ภารกิจจะ NameError)
- `static/demo.js` BLOCK_CHOICES · `static/dashboard.js` ค่าสำรอง · `Mission.COMMAND_BLOCKS/LOOP_BLOCKS/LABELS` ใน script.js (เดิมขาด grip_* ไม่ตรงกับ skills.py)
- `server.py` SYSTEM_PROMPT รายชื่อบล็อกใหม่ + ชื่อ Arm/Hand ที่เปลี่ยน · `describeBlock` ส่งข้อความเต็มบนบล็อก (รวมตัวเลข และเงื่อนไขของ if/while) ให้ AI
- `index.html` toolbox + `?v=85` · `claude-RoboWeb.md` §5 แถว /state

### ทดสอบ
- devserver พอร์ต 8899 `?demo=1`: สร้างบล็อกใหม่ทุกตัว (35 กรณีรวมค่าขอบช่วงและเกินช่วง) → สตริงตรงตาราง ทั้ง MetoRunner และ generator
- หุ่นปลอม (`/run` `/state` คิว + 409 BUSY + x) ใน scratchpad: รันทีละช่วงถูกลำดับ ไม่โดน 409 · ขอบโต๊ะหยุดวน · ถือของ/หน้าคนตัดสินถูก · สตริง 1,400 ตัวอักษรแบ่ง 2 ก้อน · กดหยุดส่ง x และหยุดจริง
- คอนโซลไม่มี JS error (เหลือ `ERR_NAME_NOT_RESOLVED` ของการหา MDTrobot.local ซึ่งเป็นของเดิมตอนไม่มีหุ่น) · `sendToRobot` ส่งไม่ถึง เปลี่ยนเป็น warn
- **ยังไม่ได้ทดสอบกับหุ่นจริง** (เฟิร์มแวร์ 6 พ.ย. ยังไม่ได้แฟลช) · ทดสอบแค่โหมดเดโม (ล็อกอินจำลอง) ยังไม่ได้รันกับ `server.py` จริงและสถานะ guest · `mockup_ส่งอาจารย์/` ยังไม่ได้อัปเดต

---

## [2.15] 7 สิงหาคม 2026 — จัดลำดับความสำคัญของแดชบอร์ดใหม่ตามผลวัดจริง

วัดด้วยการป้อนข้อมูลจำลองเข้า renderer แล้ววัด `getBoundingClientRect()` ทั้ง 4 หน้า
**ตัวเลื่อนจริงคือ `#page-dashboard` ไม่ใช่ window** (`style.css:5` `body{overflow:hidden}`)
จอแรกจริง = **740px** ที่ 1280×800 ไม่ใช่ 800px

### 🔴 ดาวไม่ขึ้นเลยเมื่อครูกดให้ผ่าน
`_starsOf` เทียบ `status === 'completed'` แต่ API ส่ง `'mastered'` (`_status_key` ใน `dashboard.py`)
`'completed'` เป็นชื่อสถานะใน**ฐานข้อมูล** ไม่ใช่ชื่อที่ส่งออก API

ทดสอบจริง: ครูกดให้ผ่าน 2 ทักษะ → HUD ขึ้น **0/27 ดาว** แผนที่ไม่ติด
ขณะที่หน้าธีมปกติขึ้น "เชี่ยวชาญ" ถูกต้อง — สองหน้าพูดคนละเรื่องกับข้อมูลชุดเดียวกัน
→ รับทั้งสองคำ · หลังแก้ได้ **8/27** ถูกต้อง (ครูให้ผ่าน 2×3 + เด็กเก็บเอง 2)

### กระดานภารกิจอยู่ใต้จอ 699px ทั้งที่โค้ดเรียกมันเองว่า "พระเอกของหน้านี้"
เด็กเปิดห้องมาถามว่า "ครูสั่งอะไร ส่งยัง" แต่จอแรกทั้ง 740px เป็น
HUD + หลอดความคืบหน้า + ภารกิจโฟกัส + ชิปทักษะ + ยอดแผนที่ — **ไม่มีชื่อภารกิจสักข้อ**

→ สลับลำดับเป็น HUD → ภารกิจโฟกัส → **กระดานภารกิจ** → แผนที่
→ ยุบหลอด "ส่งภารกิจแล้ว 2 จาก 3" (100px เดี่ยวๆ) ไปเป็นบรรทัดในหัวข้อกระดาน
→ **การ์ดภารกิจใบแรก y=1439 → y=279** อยู่ในจอแรกแล้ว เลื่อนน้อยลง **1160px**

### แดชบอร์ดผู้ใช้มีของที่ไม่ใช่ของตัวเอง 3 บล็อก
| บล็อก | เดสก์ท็อป | มือถือ | ทำไมตัด |
|---|---|---|---|
| "ห้องเรียนของฉัน" | 493px | 697px | ซ้ำหน้าเลือกแบบ**คำต่อคำ** (`dashboard.js:511` = `dashboard-hub.js:157`) |
| "คะแนนจากครูประจำห้อง" | 172px | 164px | คะแนนสังกัดห้อง แต่หน้านี้ไม่ผูกกับห้อง · เอาทุกห้องมากองโดยไม่บอกว่าห้องไหน |
| "โจทย์จากครู" | 634px | 1160px | เป็นของหน้าห้อง · เหลือไว้แค่บรรทัดลิงก์ "มีภารกิจค้างใน N ห้อง" |

พ่วงแก้บั๊ก: `!roomId || a.classroom_id === roomId` — ตอนอยู่หน้าโปรไฟล์ `roomId` เป็น null
เงื่อนไขแรกจริงเสมอ = **ผ่านหมดทุกห้อง** เด็ก 2 ห้องเห็นโจทย์และคะแนนปนกัน

### หน้าเลือก (HUB) ขึ้นเสมอแล้ว
เดิม "ถ้ายังไม่มีห้องเลยให้เข้าแดชบอร์ดตัวเองตรงๆ" สร้างปัญหา 2 ข้อ:
1. ปุ่ม Dashboard บน header พาไปคนละหน้าก่อน/หลังเข้าห้องแรก — ผู้ใช้ต้องเรียนรู้ใหม่
2. บังคับให้ `/me` ต้องมีฟอร์มสร้าง/เข้าร่วมห้องติดไว้ ไม่งั้นคนยังไม่มีห้องเข้าห้องไม่ได้

→ คืน HUB เสมอ · คนยังไม่มีห้องเห็นการ์ด "แดชบอร์ดของฉัน" 1 ใบ + กล่องสร้าง/เข้าร่วม (507px)
→ `_backToHub` เลิกซ่อนตัวเองตอนไม่มีห้อง

### การ์ดสถิติใหญ่ 4 ใบ → แถบเตี้ย
เดิมยกเว้นหน้าโปรไฟล์ไว้ด้วยเหตุผลว่า "ที่นั่นสถิติคือเนื้อหาหลัก" — วัดแล้วไม่จริง
เดสก์ท็อป 182px = 25% ของจอแรก · **มือถือ 652px = 87%** รวมคำทักทายเป็น **108%**
ตัวเลขพวกนี้กดต่อไม่ได้ ไม่ควรแย่งที่ของที่กดได้
→ ใช้ `_myStatsStrip` ลายเดียวกับ `_roomStatsStrip` ของหน้าห้องครู (65px) — ได้ผลพลอยได้คือไม่ต้องเรียนรู้ใหม่

### empty state 5 จุดที่ยังไม่บอกทางต่อ
"ครูยังไม่ได้สั่งภารกิจในห้องนี้" → + "ระหว่างรอ ไปเก็บดาวที่แผนที่ข้างล่างก่อนได้เลย"
"ยังไม่มีคะแนนในห้องนี้" · "ยังไม่มีข้อมูลทักษะ" (2 ที่) · "ยังไม่มีความสำเร็จ" — เติมครบ

### ผลวัดหลังแก้
| หน้า | เดิม | หลัง | ลด |
|---|---|---|---|
| แดชยูส `/me` | 2369px | **1582px** | −33% |
| ห้องนักเรียน | 2221px | **1369px** | −38% |
| การ์ดภารกิจใบแรก | y=1439 | **y=279** | −1160px |

### ไฟล์ที่แก้
`static/dashboard.js` · `static/dashboard-hub.js` · `static/dashboard-player.js`

---

## [2.14] 7 สิงหาคม 2026 — แผงเลือกหมวดบล็อกเข้าธีมพิกเซล + สีหมวดที่เลื่อนผิดตำแหน่ง

### แผงยังพูดคนละภาษากับเปลือกอื่นของหน้า Workspace
แถบเครื่องมือ · ปุ่มเครื่องมือ · แชท ถูกทำเป็นพิกเซลไปแล้วใน [2.x] ก่อนหน้า
แต่แผงเลือกหมวดยังเป็นภาษา Scratch 3.0 เดิม: วงกลม 30px ขอบนุ่ม พื้นเทา `#f9f9f9`
ฟอนต์ Segoe UI — อยู่ข้างกันแล้วอ่านว่าเป็นของแปะมาจากเว็บอื่น

เขียนหมวดใหม่ที่ท้าย `game-ui.css` (โหลดหลัง `style.css` จึงทับได้)
ไม่ใส่ `body.mode-player` นำหน้า เพราะเปลือก Workspace เป็นพิกเซลสำหรับทุกบทบาทอยู่แล้ว
พื้นที่ลากบล็อกจริงยังไม่แตะตามกติกาที่ `game-ui.css:66`

| | เดิม | ใหม่ |
|---|---|---|
| แผ่นสีหมวด | วงกลม 30px `border-radius:50%` | จัตุรัส 34px มุมบาก 4px ด้วย `clip-path` |
| มิติ | ขอบ 1px จาง | ไฮไลต์บน + เงาล่าง inset = อ่านว่าเป็นวัตถุ |
| พื้นแผง | `#f9f9f9` | `--g-panel` ครีม + เส้นคั่นทึบ 4px |
| ฟอนต์ป้าย | Segoe UI 11px | `Silver, Prompt` 13px |
| ตอนเลือก | ตัวหนา + ขยายวงกลม | ช่องจม + แถบน้ำเงินซ้าย + ยกแผ่นขึ้น |
| ทรานซิชัน | ค่าเริ่มต้น | `steps(2)` |

**ไม่ขยายตอนเลือกแล้ว** — พิกเซลอาร์ตห้าม scale เพราะขอบเบลอ ใช้ยกขึ้น + เงาแข็งแทน

### แผงต้องมีสกรอลล์ตลอด
หมวดจริงมี **9** อัน (Motion · Arm · Hand · Head · Face · Gripper · Control · Operator · Variables)
9 × 90px = 810px เกินความสูงจอเกือบทุกเครื่อง จึงมีแถบเลื่อนตลอดเวลา
→ ลดแถวเหลือ 70px · 9 × 70 = **630px** พอดีจอ 768px ขึ้นไปโดยไม่ต้องเลื่อน
ยังเกิน 44px ขั้นต่ำของ Apple HIG และ 48dp ของ Material อยู่มาก

### สองหมวดท้ายไม่มีสี (วงกลมเทา)
กล่องเครื่องมือมี 9 หมวด แต่ `style.css` นิยามสีถึงแค่ `.cat-6`
`Operator` กับ `Variables` จึงตกไปใช้ค่า fallback `#ccc` = วงกลมเทา
ไม่ใช่การตัดสินใจ แต่เป็นค่าที่หลุดมา (เห็นได้ท้ายแผงในหน้าจอจริง)

→ เพิ่ม `.cat-7` `#59C059` และ `.cat-8` `#FF8C1A`
ค่าที่ใส่คือ **สีของบล็อกในหมวดนั้นเอง** ตามที่ประกาศไว้ใน `index.html` toolbox
(`<category name="Operator" colour="#59C059">` · `<category name="Variables" colour="#FF8C1A">`)

**ไม่แตะสีบล็อก และไม่แตะหมวดที่มีสีอยู่แล้ว** — เคยลองไล่ให้ทุกหมวดตรงกับบล็อกของตัวเอง
(Gripper วงกลมส้มแต่บล็อกเขียวหัวเป็ด `#00B4AB` · Control วงกลมเขียวแต่บล็อกส้ม)
แต่เจ้าของโปรเจกต์สั่งไม่ให้เปลี่ยน จึงย้อนกลับ เหลือเฉพาะการเติมสีให้สองอันที่เป็นเทา

**หมายเหตุที่ยังค้าง:** วงกลม Gripper กับ Control ยังไม่ตรงกับสีบล็อกของตัวเอง
ถ้าจะแก้วันหลัง ค่าที่ถูกคือ Gripper `#00B4AB` · Control `#FFAB19` ตาม `index.html` และ THEME.md 2.3
(`#00B4AB` ตรงกับ `'Robot Arms & Gripper'` ใน `dashboard-player.js` อยู่แล้ว)

ตรวจด้วยการอ่านค่าสีที่เบราว์เซอร์คำนวณจริงทั้ง 9 หมวด: **เหลือวงกลมเทา 0 อัน**

### ไฟล์ที่แก้
`static/game-ui.css` (เพิ่มหมวดใหม่ท้ายไฟล์) · `static/style.css` (`.cat-5` ถึง `.cat-8`)

---

## [2.13] 7 สิงหาคม 2026 — ตรวจระบบทั้งใบ แล้วปิดรูที่ทำลายข้อมูลกับรูที่ข้ามห้อง

ตรวจ 3 ทาง: ตัวจำลองผู้ใช้ยิง API จริงทั้ง 3 บทบาท · ไล่โค้ดเรื่องการแยกบทบาท ·
ไล่โค้ดเรื่องการเชื่อมโยงข้อมูล — เจอว่าทุกทางชี้ไปที่รากเดียวกัน:
**สิทธิ์ถูกตรวจที่ระดับ "คน" แต่ข้อมูลสังกัดระดับ "ห้อง"**
`_user_teaches_student` ตอบแค่ "เด็กคนนี้อยู่ห้องใดห้องหนึ่งของเราไหม" พอผ่านก็เทข้อมูลออกหมด

### ยกเลิกโจทย์แล้วคะแนนหายถาวร (ร้ายแรงที่สุด)
`grades.submission_id` เป็น `ON DELETE CASCADE` ครูกดยกเลิกโจทย์ → ลบ submissions →
**คะแนนของนักเรียนทั้งห้องหายตาม** ขัดกับ RESTRICT อีก 3 เส้นใน `grades` ที่เขียนเหตุผลไว้เองว่า
"คะแนนเป็นหลักฐานทางการศึกษา ห้ามหายเงียบ" — RESTRICT กันไม่ได้เพราะการลบเข้ามาทางฝั่ง submission

→ migration `a2c77b31e5d9` เปลี่ยนเป็น `SET NULL` (FK ในตารางไม่มีชื่อ ต้องใช้ `copy_from` สร้างตารางใหม่)
→ `delete_assignment` ปลดสายเองก่อนลบด้วย แล้วคืนจำนวน `grades_kept` ให้หน้าเว็บ
ลบโจทย์แล้วคะแนนยังอยู่ครบ แค่ไม่ผูกกับงานที่ส่งอีกต่อไป

### ครูเห็นคะแนนที่ครูคนอื่นให้
เด็กเรียน 2 ห้อง ครูเอเปิดดูเด็กคนนั้นแล้วเห็น `[(60,'ห้องบีให้'), (80,'ห้องเอให้')]` พร้อมคอมเมนต์
`student_detail` ดึง `Grade.query.filter_by(student_id=...)` โดยไม่กรอง `classroom_id` ทั้งที่คอลัมน์มีอยู่
→ กรองด้วยห้องที่ครูเป็นเจ้าของ (คะแนนเก่าที่ `classroom_id` เป็น NULL ยังแสดง เพราะบอกไม่ได้ว่าห้องไหน)

### ครูข้ามห้องยกเลิกภารกิจของครูอื่นได้ + โฟกัสส่วนตัวของเด็กได้
`cancel_focus` ใช้ `_user_teaches_student` แทนที่จะเช็ค `focus.classroom_id`
→ `focus.classroom_id in _owned_classroom_ids(user)` · เด็กเท่านั้นที่แตะช่องส่วนตัวของตัวเองได้

### `record_event` ทิ้งชื่อที่ไม่รู้จักเงียบๆ
`focus.set` / `focus.reached` / `focus.cancelled` ไม่อยู่ใน `EVENT_NAMES` → เขียน DB **0 แถว**
มาตลอดโดยไม่มีสัญญาณอะไรเลย ฟีเจอร์ SkillFocus จึงไม่มีร่องรอยในบันทึกเหตุการณ์
→ เพิ่มชื่อเข้า allowlist + ให้ `record_event` พิมพ์เตือนเมื่อเจอชื่อนอกรายการ

### ครูปรับสถานะทักษะแล้วไม่มีทางกลับ
กดครั้งเดียว = ทักษะนั้นหยุดนับดาวอัตโนมัติถาวร ทั้ง repo ไม่มีที่ไหนเซ็ต `updated_by_teacher_id` กลับ
และเพราะทักษะเป็นของ user ครูห้อง A จึงแช่แข็งดาวที่ครูห้อง B ใช้วัดผลอยู่ได้
→ รับ `status: 'AUTO'` เพื่อคืนให้ระบบ แล้วคำนวณสถานะใหม่จากจำนวนรันสะอาดจริง

### สมัครใหม่ด้วยรหัสเชิญเก่า เข้าห้องที่เก็บถาวรแล้วได้
`auth.py` เช็คแค่ "มีห้องไหม" ส่วน `POST /api/classrooms/join` เช็ค `is_active`/`is_open`/หมดอายุครบ
→ ทำให้สองทางใช้กติกาเดียวกัน + บันทึก `classroom.joined` ที่หายไป

### บทบาทปนกันในหน้าเดียว
- `#/dashboard/me` ของครูมีบล็อกของห้องโผล่ 5 อัน (ห้องที่เซิร์ฟเวอร์เลือกให้เอง ไม่บอกชื่อ)
  → `_teacherSection` ขึ้นเฉพาะตอนเปิดห้องที่เราเป็นเจ้าของ
- โปรเจกต์ส่วนตัวของครูโผล่ในหน้าห้อง → ใส่ guard `roomId` แบบเดียวกับบล็อกข้างเคียง
- โจทย์ฝั่งครูไม่กรองตามห้อง (ฝั่งนักเรียนกรองถูกมาตลอด) → กรองด้วย `room.id`
- ฟอร์มมอบโจทย์ไม่เลือกห้องปัจจุบันไว้ให้ **ครูอยู่หน้าห้อง B กดมอบโจทย์แล้วเข้าห้อง A** → `selected`
- `_myFocusSection` ไม่กรอง `classroom_id` ขัดคอมเมนต์ของตัวเอง
  → แยก "ภารกิจที่เลือกเอง" (แก้ได้) กับ "ภารกิจจากครู" (อ่านอย่างเดียว บอกชื่อห้อง)
  เด็กที่ครูเล็งให้แต่ยังไม่เลือกเอง เดิมไม่เห็นคำชวนให้เลือกเลย

### คะแนนที่ครูให้ไม่โผล่ในหน้าห้อง
ฟอร์มให้คะแนนไม่ส่ง `classroom_id` ทั้งที่มีอยู่ในมือ → เซิร์ฟเวอร์เดาไม่ออกเมื่อเด็กอยู่ 2 ห้อง
ของครูคนเดียวกัน → `classroom_id` เป็น NULL → หน้าห้องกรองด้วย `g.classroom_id === roomId` แล้วไม่เจอ
→ ส่งห้องไปด้วย + `parseFloat` แทน `parseInt` (คอลัมน์เป็น `Numeric(5,2)` ครูกรอก 7.5 เคยกลายเป็น 7)

**พ่วง:** พอส่ง `classroom_id` จริงเลยไปโดนบั๊กที่ซ่อนอยู่ — `_resolve_grade_classroom` ยิง query
หลัง `db.session.add()` ทำให้ SQLAlchemy autoflush แถวที่ยังไม่มี `score` → **500**
→ ย้ายไปหาห้องให้เสร็จก่อนสร้างแถว

### ทักษะที่ครูประกาศเอง ตายที่หน้าจอ
`Assignment.objective_id` เก็บลง DB จริง ส่งออก API จริง แต่แผนที่เด็กอ่านแต่ `target_skills`
ที่ระบบ**เดา**จาก `required_blocks` — ครูติ๊ก "Loops" แล้วแผนที่ก็ยังไฮไลต์ตามที่ preset เดา
→ `objective_name` ชนะเสมอ ไม่มีค่อยตกไปใช้ค่าที่เดา

### ไฟล์ที่แก้
`models.py` · `dashboard.py` · `auth.py` · `eventlog.py` · `static/dashboard.js` ·
`static/dashboard-player.js` · migration `a2c77b31e5d9`

ทดสอบด้วยชุดยิง API จริงบน DB ชั่วคราว: **P0 ผ่าน 19/19 · P1 ผ่าน 10/10**

---

## [2.12] 6 สิงหาคม 2026 — จัดหน้าห้องของครูใหม่: ซ้าย = งาน · ขวา = รายชื่อนักเรียน

### สถิติไม่ใช่พระเอกของหน้า
รอบที่แล้วเอาตัวเลขของห้องขึ้นมาเป็นการ์ดใหญ่ 4 ใบ — ถูกเรื่องข้อมูล แต่ผิดเรื่องขนาด
การ์ดใบละ ~150px พอจอไม่กว้างพอจะเรียง 4 ใบก็ตกลงมาเป็น 2 แถว = **สูงเกือบ 300px**
กินจอแรกไปทั้งจอกับตัวเลขที่แค่ "รู้ไว้" ส่วนของที่ครูต้องกดจริง (มอบโจทย์ · ให้คะแนน · รายชื่อ)
ถูกดันลงไปใต้เส้นพับหมด

→ ยุบเป็น **แถบเตี้ยแถวเดียว `.stats-row` สูง 65px** ใช้ลาย `.mini-stat` ที่มีอยู่แล้ว
วงกลมไอคอน 38px พื้นสีจาง 4 โทนเดิม เลข 20px — ยังชำเลืองอ่านได้ แต่ไม่แย่งที่ของงาน
หน้าโปรไฟล์ยังเป็นการ์ดใหญ่เหมือนเดิม เพราะที่นั่นสถิติของตัวเองคือเนื้อหาหลักจริงๆ

### ซ้าย = งาน · ขวา = คน
เดิมทุกอย่างของครูกองอยู่คอลัมน์ซ้ายเรียงต่อกันลงมา (รายชื่อ → โจทย์ → ให้คะแนน → ทักษะ)
ส่วนคอลัมน์ขวาเป็นข้อมูลส่วนตัวของครู (กราฟกิจกรรม · คะแนนที่ครูได้รับ · ทักษะ · เหรียญ)
ซึ่งไม่เกี่ยวกับห้องเลยสักอัน — หน้าห้องเลยมีของไม่เกี่ยวข้องกินพื้นที่ครึ่งจอฝั่งขวา

**หน้าห้อง (`#/dashboard/room/<id>`) จัดใหม่:**

| คอลัมน์ซ้าย (3fr) — งาน | คอลัมน์ขวา (2fr) — คน |
|---|---|
| โจทย์ที่มอบหมาย + มอบโจทย์ใหม่ | รายชื่อนักเรียน (ยาวลงมาได้ไม่จำกัด) |
| ให้คะแนน | ภาพรวมทักษะนักเรียน |
| โปรเจกต์ล่าสุด | |

ของส่วนตัวของครู (กราฟ 7 วัน · คะแนนที่ได้รับ · ทักษะของตัวเอง · เหรียญ) **ไม่ขึ้นในหน้าห้องแล้ว**
ยังอยู่ครบที่ `#/dashboard/me` ซึ่งเป็นหน้าของตัวเอง — กติกาเดียวกับที่ใช้ตัดสินเรื่องสถิติใน [2.11]

### รายชื่อนักเรียนแบบคอลัมน์ (`_teacherRoster`)
ตารางเดิม 8 คอลัมน์ยัดลงคอลัมน์ขวากว้าง ~477px ไม่ได้ จึงยุบเป็นรายการแนวตั้ง แถวละ 60px:
`[เลขที่แก้ได้] ชื่อ + (เข้าใช้ · Run · AI · สถานะบทเรียน) [แถบทักษะ %] [×]`
- **ของเดิมอยู่ครบ** — เลขที่พิมพ์แล้ว Enter เพื่อบันทึกได้เหมือนเดิม · กดที่แถวเปิดรายละเอียดนักเรียน ·
  ปุ่มเอาออกกลายเป็น `×` จางๆ ที่ชัดขึ้นตอนชี้ที่แถว (กันเผลอกดตอนไล่เช็คชื่อ)
- หัวตารางที่กดเรียงได้กลายเป็น **dropdown "เรียงตาม"** (เลขที่ · ชื่อ · เข้าใช้ล่าสุด · ทักษะ)
  โผล่เฉพาะตอนมีนักเรียนตั้งแต่ 2 คนขึ้นไป
- ป้ายจำนวนคนอยู่ข้างหัวข้อ `รายชื่อนักเรียน [6 คน]`
- หน้าโปรไฟล์ยังใช้ตารางเดิม เพราะที่นั่นอยู่คอลัมน์กว้าง

### บั๊กที่แก้ไปด้วย: เรียงตามเลขที่แล้วได้ 1, 10, 2
`student_no` เก็บเป็นข้อความ การเรียงเดิมเทียบแบบข้อความล้วน → `'10' < '2'`
แก้ให้เทียบเป็นตัวเลข **เฉพาะเมื่อทั้งคู่เป็นตัวเลขล้วน** (ใช้ regex ไม่ใช่ `parseFloat`
เพราะ `parseFloat('2026-08-06...')` = 2026 จะทำให้เรียงตามวันที่พังทั้งหมด)
และคนที่ยังไม่ได้ตั้งเลขที่ให้ไปท้ายเสมอ ไม่ว่าจะเรียงขึ้นหรือลง

### ไฟล์ที่แก้
| ไฟล์ | สิ่งที่ทำ |
|---|---|
| `static/dashboard.js` | `_roomStatsStrip()` · `_teacherRoster()` · `_skillOverviewSection()` ใหม่ · จัดคอลัมน์ใน `renderNormal()` · `_teacherSection()` เหลือเฉพาะงานตอนอยู่หน้าห้อง · ย้ายการตั้ง `_selectedClassroomId` ขึ้นมาที่ `renderNormal` (ทั้งสองคอลัมน์ใช้ร่วมกัน) · `sortTable()` เทียบตัวเลข |
| `static/style.css` | `.stats-row` + โทน 4 สี · `.roster-*` ทั้งชุด · responsive ≤768px |

### ทดสอบแล้ว
- จอ 1280×900 หน้าห้อง: แถบสถิติสูง **65px** (เดิม ~300px) · หัวข้อ "โจทย์ที่มอบหมาย" ขยับขึ้นมาอยู่ที่ y=299
  เห็นทั้งมอบโจทย์ ให้คะแนน และรายชื่อนักเรียนในจอแรกพร้อมกัน
- คอลัมน์ซ้าย 716px = โจทย์ · ให้คะแนน · โปรเจกต์ | ขวา 477px = รายชื่อ · ภาพรวมทักษะ (ไม่มีของส่วนตัวหลงมา)
- ใส่นักเรียนจำลอง 6 คนในหน่วยความจำ (ไม่แตะฐานข้อมูล): แถวละ 60px ชื่อไทยยาวไม่ดันแถวแตก
  เรียงตามเลขที่ได้ `3 · 7 · 9 · 12 · 25 · (ว่าง)` ถูกต้อง · เรียงตามทักษะได้ `0→95%`
- จอ 375px: แถบสถิติเป็น 2×2 สูงรวม 142px · แถวรายชื่อ 82px (ข้อมูลย่อยตัดบรรทัด) ไม่ล้นแนวนอน
- หน้า `#/dashboard/me` ไม่กระทบ — การ์ดใหญ่ส่วนตัว · ตารางนักเรียนแบบเดิม · บล็อกส่วนตัวฝั่งขวาครบ 4 อัน
- ไม่มี console error · `node --check` ผ่านทั้ง `dashboard.js` และ `dashboard-hub.js`

---

## [2.11] 6 สิงหาคม 2026 — เลิกใช้คำว่า "เก็บเข้ากรุ" + หน้าห้องของครูโชว์ตัวเลขของห้อง ไม่ใช่ของตัวเอง

### 1. "เก็บเข้ากรุ" → "เก็บถาวร"
"กรุ" เป็นคำเฉพาะถิ่น ครูที่เพิ่งเข้าระบบเดาไม่ออกว่าคืออะไร (ลบทิ้งหรือเปล่า? กู้กลับได้ไหม?)
เปลี่ยนไปใช้ **"เก็บถาวร"** ซึ่งเป็นคำมาตรฐานของ Archive ที่ Gmail / Facebook / LINE ใช้ในภาษาไทย
คนไทยเจอคำนี้ทุกวันอยู่แล้ว ไม่ต้องเดา และตรงกับคำอังกฤษ *archive* เวลาเขียนลงเล่มวิจัย

| เดิม | ใหม่ |
|---|---|
| ปุ่ม `เก็บเข้ากรุ` | `เก็บถาวร` |
| ชิป `เก็บเข้ากรุแล้ว` | `เก็บถาวรแล้ว` |
| tooltip `จบเทอมแล้วเก็บห้องเข้ากรุ — ข้อมูลยังอยู่ครบ` | `จบเทอมแล้วเก็บห้องนี้ไว้เป็นประวัติ — ข้อมูลยังอยู่ครบ` |
| confirm `เก็บห้องนี้เข้ากรุใช่ไหม?` | `เก็บห้องนี้เข้าที่เก็บถาวรใช่ไหม? ... และเปิดห้องกลับมาใช้ใหม่ได้ทุกเมื่อ` |
| error `ห้องนี้ปิดแล้ว (เก็บเข้ากรุ)` | `ห้องนี้ปิดแล้ว (ครูเก็บถาวรไปแล้ว)` |

ปุ่มย้อนกลับยังเป็น **"เปิดห้องอีกครั้ง"** เหมือนเดิม — ตรงตัวกว่าคำว่า "กู้คืน" หรือ "นำออกจากที่เก็บถาวร"
confirm เพิ่มประโยคว่าเปิดกลับมาใช้ใหม่ได้ทุกเมื่อ เพราะคนกลัวว่ากดแล้วจะเสียข้อมูล
แก้คำในคอมเมนต์โค้ดให้ตรงกันด้วย (`dashboard.py`, `models.py`, `style.css`)
> `แผนแก้ไขฐานข้อมูล.md` ยังเขียนว่า "เก็บเข้ากรุ" อยู่ — เป็นเอกสารแผนที่เขียนไว้ก่อน ไม่ได้ตามไปแก้

### 2. หน้าห้องของครูโชว์สถิติส่วนตัวของครูเอง — ไม่มีประโยชน์
การ์ดใหญ่ 4 ใบบนหัวหน้าห้องคือ **รันโค้ด / บล็อกที่ใช้ / ถาม AI / โปรเจกต์ ของตัวครูเอง**
ซึ่งเป็น 0 เกือบตลอดเพราะครูไม่ได้นั่งต่อบล็อกเอง กินพื้นที่หัวหน้าฟรีๆ
ส่วนตัวเลขที่ครูต้องใช้จริง (นักเรียน/เข้าใช้วันนี้/รันโค้ดวันนี้/ถาม AI วันนี้) ไปอยู่เป็นการ์ดเล็กๆ
ใต้หัวข้อ "มุมครู — ภาพรวมห้องของฉัน" ที่ต้องเลื่อนลงไปหา

**สลับที่กัน** — หน้าห้อง (`room` ไม่ null) ใช้การ์ดใหญ่แสดงตัวเลขของห้อง
`นักเรียนในห้อง · เข้าใช้วันนี้ · รันโค้ดวันนี้ · ถาม AI วันนี้` แล้วตัดบล็อก "มุมครู" ที่ซ้ำกันออก
หน้าโปรไฟล์ (`#/dashboard/me`) ยังเป็นสถิติส่วนตัวเหมือนเดิม — ที่นั่นถูกแล้วเพราะเป็นหน้าของตัวเอง

### 3. บั๊กที่เจอระหว่างทาง: ตัวเลขบนหัวไม่ใช่ของห้องที่เปิดอยู่
`teacher.stats` เดิมนับรวมนักเรียน **ทุกห้องที่เป็นเจ้าของ** (`all_student_ids`)
แต่ `students` ข้างล่างเป็นของห้องที่เลือกอยู่ห้องเดียว
ครูที่มี 2 ห้อง (ห้องละ 20 คน) จะเห็น "นักเรียนทั้งหมด 40" อยู่เหนือรายชื่อ 20 คน
พอเอาตัวเลขนี้ขึ้นไปเป็นการ์ดใหญ่บนหัวหน้าห้องยิ่งผิดหนัก → **สโคปให้เหลือห้องที่เลือกอยู่**
- ย้ายการหา `selected_id` ขึ้นมาก่อน แล้วให้ `sids` มาจากสมาชิกของห้องนั้น
- กระทบ `total_students` / `active_today` / `runs_today` / `ai_today` / `skill_overview`
  ทั้งหมดกลายเป็นของห้องเดียวกันกับรายชื่อนักเรียน — ตรงกันทั้งบล็อก
- `assignments` ยังเป็นของทุกห้องเหมือนเดิม (มีชื่อห้องกำกับอยู่แล้วในการ์ดโจทย์)
- ลบ `all_student_ids` ที่ไม่มีใครใช้แล้วทิ้ง

### ไฟล์ที่แก้
| ไฟล์ | สิ่งที่ทำ |
|---|---|
| `static/dashboard.js` | เปลี่ยนคำ 5 จุด · การ์ดใหญ่หน้าห้องเป็นสถิติของห้อง · `_teacherSection(teacher, owned, room)` ซ่อนบล็อก "มุมครู" ตอนอยู่หน้าห้อง |
| `static/dashboard-hub.js` | ชิป `เก็บถาวรแล้ว` |
| `dashboard.py` | ข้อความ error + สโคปสถิติครูให้เป็นของห้องที่เลือก + ลบตัวแปรที่ไม่ใช้ |
| `models.py`, `static/style.css` | คอมเมนต์ให้ใช้คำเดียวกัน |

### ทดสอบแล้ว
- ห้อง `Test` (มีนักเรียน 1 คน) → การ์ดบนหัวขึ้น `นักเรียนในห้อง = 1` ตรงกับรายชื่อ 1 แถวข้างล่าง
  บล็อก "มุมครู — ภาพรวมห้องของฉัน" หายไปแล้ว ไม่ซ้ำ
- หน้า `#/dashboard/me` ของครู → การ์ดใหญ่ยังเป็น รันโค้ด/บล็อกที่ใช้/ถาม AI/โปรเจกต์ และยังมีบล็อก "มุมครู" ครบ
- ปุ่มในแถบรหัส: `คัดลอกรหัส · ปิดรับสมาชิก · เก็บถาวร` · tooltip และ confirm ขึ้นคำใหม่ถูกต้อง
  (กด "เก็บถาวร" แล้วตอบยกเลิก — ห้องทดสอบทั้ง 3 ห้องยัง `is_active=1` ไม่ถูกแตะ)
- ไม่มี console error · ไม่มี error ฝั่งเซิร์ฟเวอร์

---

## [2.10] 6 สิงหาคม 2026 — ครูมองไม่เห็นรหัสเข้าร่วมห้องของตัวเอง (บั๊กที่ทำให้ห้องว่างตลอดไป)

### อาการ: สร้างห้องเสร็จแล้วชวนนักเรียนเข้าห้องไม่ได้เลย
รหัสเข้าร่วมโผล่ที่เดียวคือการ์ดในส่วน "ห้องเรียนของฉัน" ของแดชบอร์ดปกติ
แต่เส้นทางจริงของครูไม่เคยผ่านตรงนั้นสักครั้ง:
- สร้างห้องเสร็จ → `load()` → มีห้องแล้วอย่างน้อย 1 ห้อง → เด้งไป **หน้าเลือกแดชบอร์ด (HUB)** ซึ่งไม่มีรหัส
- กดเข้าห้องตัวเอง → หน้าห้อง `#/dashboard/room/<id>` ซ่อนส่วน "ห้องเรียนของฉัน" ทิ้ง
  (`dashboard.js` เดิม: `${roomId ? '' : this._classroomSection(...)}`) → ก็ไม่มีรหัสอีก

สรุปคือ **หลังสร้างห้องแล้วไม่มีทางเห็นรหัสอีกเลย** ห้องจึงไม่มีวันมีนักเรียน
ปุ่ม "ปิดรับสมาชิก / เก็บเข้ากรุ" ก็หายไปพร้อมกัน เพราะติดอยู่ในส่วนที่ถูกซ่อน

### แก้: แถบรหัสอยู่บนสุดของหน้าห้อง เห็นทุกครั้งที่เปิด
- `_roomCodeBar(room)` ใหม่ใน `dashboard.js` — วางใต้แถบต้อนรับทันที ก่อนสถิติ
  รหัสตัวโต 26px mono `letter-spacing 4px` + `user-select: all` (ลากคลุมทีเดียวติดทั้งรหัส)
  ปุ่ม **คัดลอกรหัส** ใช้ `copyCode()` ตัวเดิม + บรรทัดบอกวิธีให้นักเรียนกรอกรหัส
- ย้ายปุ่ม **ปิดรับสมาชิก / เก็บเข้ากรุ / เปิดห้องอีกครั้ง** มาไว้ในแถบนี้ด้วย
  เพราะหน้าห้องไม่แสดงรายการห้องทั้งหมดแล้ว
- ห้องที่ปิดรับสมาชิกหรือเก็บเข้ากรุ **ยังแสดงรหัส** แต่เปลี่ยนเป็นโทนเหลืองเตือน (`.room-code-closed`)
  พร้อมบอกตรงๆ ว่ารหัสยังใช้ไม่ได้เพราะอะไร — ไม่ใช้แดงดุตาม `THEME.md`
- **สร้างห้องเสร็จเด้งเข้าหน้าห้องใหม่ทันที** (`goTo('#/dashboard/room/<id>')` แทน `load()`)
  ครูจะเจอรหัสตั้งแต่วินาทีแรกโดยไม่ต้องไปตามหา
- **หน้าเลือกแดชบอร์ด**: การ์ดห้องที่เราเป็นครูโชว์ `รหัส XXXXXX` ในบรรทัดล่าง (`.hub-code`)
  ดูอย่างเดียวไม่มีปุ่มคัดลอก เพราะการ์ดเป็น `<button>` อยู่แล้ว ซ้อนปุ่มข้างในไม่ได้

### ชื่อตัวอย่างในช่องสร้างห้องยาวเกินจนกินพื้นที่
`placeholder="ชื่อห้องเรียน เช่น ม.2/1 วิชาหุ่นยนต์"` → **`"ชื่อห้องเรียน"`**
คนที่กดสร้างห้องคือครูของห้องนั้น ย่อมรู้อยู่แล้วว่าห้องตัวเองชื่ออะไร
ตัวอย่างยาวๆ ไม่ได้ช่วยอะไร มีแต่ดันให้ช่องกรอกต้องกว้างขึ้นในฟอร์มแถวเดียวที่มีเทอม/ปีการศึกษาต่อท้าย

### ไฟล์ที่แก้
| ไฟล์ | สิ่งที่ทำ |
|---|---|
| `static/dashboard.js` | เพิ่ม `_roomCodeBar()` · เรียกใช้ใน `renderNormal()` · `createClassroom()` เด้งเข้าห้องใหม่ · ย่อ placeholder |
| `static/dashboard-hub.js` | การ์ดห้องที่เป็นครูโชว์รหัสใน `.hub-meta` |
| `static/style.css` | `.room-code-bar / -main / -label / -value / -copy / -hint / -actions / -closed` · `.hub-code` · responsive ≤768px |

### ทดสอบแล้ว
- ล็อกอินเป็นเจ้าของห้อง `CS101 Programming` → หน้าห้องแสดง `รหัสเข้าร่วมห้องนี้ RJP63U` ใต้แถบต้อนรับ
- กด "คัดลอกรหัส" → ปุ่มเปลี่ยนเป็น "คัดลอกแล้ว!" · ไม่มี console error
- สร้างห้องใหม่จากหน้าเลือกแดชบอร์ด → เด้งไป `#/dashboard/room/4` เห็นรหัส `97UU3P` ทันที (ลบห้องทดสอบออกแล้ว)
- สถานะปิดรับสมาชิก/เก็บเข้ากรุ → กรอบเหลือง `#ffe0a3` ตัวอักษร `#a06800` ปุ่มเปลี่ยนเป็น "เปิดรับสมาชิก"/"เปิดห้องอีกครั้ง" ถูกต้อง
- จอ 1280px: แถบสูง 75px แถวเดียว ไม่ล้น · จอ 375px: ย่อรหัสเหลือ 22px แถบกว้าง 347px ไม่ล้น
  (หน้าจอมือถือยังล้นแนวนอนจาก **header เดิม** — ปุ่ม Run/บันทึกไม่ยอมหด เป็นของเดิม ไม่ได้เกิดจากรอบนี้)

---

## [2.9] 6 สิงหาคม 2026 — ยกธีมเกมมาที่หน้า Workspace

### แต่ง "เปลือก" ของ Workspace ให้เข้าธีมเกม
หน้าทำงานเป็นที่ที่เด็กอยู่นานที่สุด แต่ยังเป็นแอดมินแพเนลอยู่ ขณะที่แดชบอร์ดเป็นเกมไปแล้ว

**กติกาที่ยึด: แต่งได้เฉพาะเปลือก ห้ามแตะพื้นที่ทำงาน**

| แต่งแล้ว | ไม่แตะ |
|---|---|
| header + ปุ่มทุกตัว (เงาแข็ง มุมบาก กดยุบ) | **ตัวบล็อกใน Blockly** — สีผูกกับตารางรายงาน 3.3.4 |
| แถบเครื่องมือลอย · แถบแชท · ปุ่มช่วยเหลือ | **เนื้อใน canvas เวทีจำลอง/จอหน้าหุ่น** — เป็น digital twin ของหุ่นจริง |
| กรอบเวทีจำลอง (มุมบาก + เงาแข็ง) | ขนาด/ตำแหน่ง `#blocklyDiv` — Blockly คำนวณ layout เอง |
| พื้น Blockly + toolbox (ผ่าน `MMTheme`) | |

**สีพื้น Blockly ต้องตั้งที่ `MMTheme.componentStyles` ใน `script.js` ไม่ใช่ที่ CSS**
Blockly เอา `workspaceBackgroundColour` ไปทำเป็น `<pattern>` ของกริด
ตั้ง `fill` ให้ `.blocklyMainBackground` ผ่าน CSS จะโดน pattern ทับจนไม่มีผล (ลองแล้วไม่ขึ้น)
- พื้น `#ffffff` → `#eef4e2` (เขียวอมครีมจาง เหมือนโต๊ะทำงานกลางแจ้ง)
- toolbox `#f4f4f9` → `#f7ecd2` (ไม้ครีม) · กริด `#e0e0e0` → `#cbd9b8`
- **ไม่แตะ `blockStyles`** — สีบล็อก 8 หมวดคงเดิมทุกค่า

### กฎใหม่: "ของใช้ร่วม" ต้องหน้าตาเดียวกันทุกหน้า
รอบแรกสโคป header ด้วย `body:not(.on-dashboard)` ทำให้ **header เปลี่ยนหน้าตาตอนสลับหน้า**
ซึ่งแปลกกว่าเลือกสไตล์ใดสไตล์หนึ่งไปเลย → ถอด scope ออก **15 จุด**

ของที่เป็น chrome ใช้ร่วมทั้งเว็บ (header · ปุ่ม header · spinner · snackbar · modal)
**ห้ามสโคปด้วย `mode-player` หรือ `:not(.on-dashboard)`** — เขียนเป็นกฎไว้ใน `THEME.md` แล้ว
ที่ต่างกันได้คือ *เนื้อหาในหน้า* เท่านั้น

### บั๊กที่เจอและแก้
1. **header ตัดบรรทัดจนล้น** — กลุ่มซ้ายไม่ยอมหด พอรวมกันกว้างเกินก็ไปทับกลุ่มขวา
   (`justify-content: space-between` ไม่ได้กันการทับ) → ให้ช่องชื่อโปรเจกต์เป็นตัวที่หดได้
   `flex: 0 1 220px; min-width: 90px` · โลโก้กับปุ่มใส่ `white-space: nowrap`
2. **ปุ่ม Run จมต่ำกว่าปุ่มอื่น** — Run สูง 38px เงา 4px · ปุ่มอื่นสูง 34px เงา 3px
   ขอบล่างที่ตาเห็นเลยต่ำกว่า 3px → บังคับทุกปุ่มบน header **สูง 36px เงา `0 3px 0`** เท่ากันหมด
3. **ปุ่มหน้าที่เปิดอยู่กลายเป็นสีขาว** — `.header-btn.nav-btn.active` ใน `style.css` (0,3,0)
   ชนะกฎใหม่ที่เขียนเป็น `.header-btn.active` (0,2,0) → เขียน selector ให้เท่ากัน
4. **ขอบเขียวของเวทีจำลองหายไป** — รอบแรกแทนที่ `border: 4px solid #BED73B` ด้วยกรอบไม้ครีม
   แต่ขอบเขียวเป็นของเดิมและเป็นเอกลักษณ์ของเวที → **คืนขอบเขียว** เพิ่มแค่มุมบากกับเงาแข็ง
   จอหน้าหุ่น (PiP) เปลี่ยนกรอบเป็นเขียวให้เข้าชุดกัน

### ทดสอบแล้ว
- ปุ่มบน header ขอบล่างตรงแนวที่ 51px ทุกตัว (ปุ่มที่เปิดอยู่จมลง 3px แต่เงาเป็น inset ขอบล่างจึงยังตรง)
- เขียวกลับมาครบ: ปุ่ม Run `#80C781` · ปุ่มหน้าที่เปิด `#BED73B` · ขอบเวที `#BED73B`
- **แดชบอร์ดครูไม่โดนกระทบ** — การ์ดขาว มุม 12px พื้น `#f8f9fc` เหมือนเดิมทุกอย่าง
- ไม่มี console error

---

## [2.8] 6 สิงหาคม 2026 — แผนที่ทักษะเข้าหน้าห้องเรียน + เอาแถบ "กลับ Workspace" ออก

### แผนที่ต้องอยู่ในหน้าห้องด้วย — จุดที่อาจารย์เน้น
[2.7] ย้ายแผนที่ไปอยู่หน้าโปรไฟล์อย่างเดียว โดยอ้างว่า `StudentObjectiveProgress`
ไม่มี `classroom_id` แต่นั่นเป็นการเอาข้อจำกัดของฐานข้อมูลมาตัดสินเรื่อง UX
**ประเด็นที่อาจารย์เน้นคือ "ครูสอน → เด็กเก็บทักษะ"** ซึ่งเกิดขึ้นในห้องเรียน
แผนที่จึงต้องเห็นได้จากหน้าห้อง

**แต่ไม่ได้เอาแผนที่เดิมไปแปะซ้ำ** — หน้าห้องแสดงแผนที่ที่ไฮไลต์เฉพาะทักษะที่ห้องนี้สั่งฝึกจริง
ซึ่งเป็นข้อมูลของห้องแท้ๆ ไม่ใช่ของซ้ำ

### `skills.py` — `skills_for_goal()` ใหม่
`PRESET_TASKS` ทุกข้อมี `goal.required_blocks` อยู่แล้ว (ใส่ไว้ตั้งแต่ข้อ 4.5)
จึงคำนวณได้ตรงๆ ว่าโจทย์ข้อไหนตั้งใจให้ฝึกทักษะอะไร

| โจทย์ | ทักษะที่ฝึก |
|---|---|
| 1.1 เดินเป็นตัว L | Sequencing · Robot Motion |
| 1.2 ทักทาย | Sequencing · Robot Arms & Gripper · Robot Expressions |
| 2.1 เลือกอารมณ์ตามค่าตัวแปร | Sequencing · Conditionals · Variables · Robot Expressions |
| 2.2 เลือกท่าเต้นตามเลข | Sequencing · Conditionals · Variables · Robot Arms & Gripper |
| 3.1 เดินสี่เหลี่ยม | Sequencing · Loops · Pattern Recognition · Robot Motion |
| 3.2 เต้น | Sequencing · Loops · Pattern Recognition · Robot Arms & Gripper |

กติกาใน `skills_for_goal()` ต้องสะท้อน `detect_skills()` ให้ตรงกัน ไม่งั้นจะเกิดกรณี
"ห้องนี้ฝึก Loops" แต่เด็กทำผ่านแล้วดาว Loops ไม่ขึ้น — เขียนเตือนไว้ใน docstring แล้ว

`/api/dashboard` ส่ง `target_skills` ติดไปกับโจทย์แต่ละข้อ

### หน้าห้องเรียนได้อะไรเพิ่ม
- **แผงสรุป** — "โจทย์ในห้องนี้พาไป N ทักษะ — เก็บได้แล้ว x/y ดาวในกลุ่มนี้" + ชิปรายทักษะ
- **แผนที่โฟกัส** — ด่านที่ห้องนี้สั่งฝึกสว่างปกติ · ด่านที่ห้องนี้ยังไม่ได้พาไป**หรี่ลงเหลือ 32%**
  ยังกดดูได้ (`is-offroom` ไม่ใช่ `is-locked`) — เด็กต้องเห็นว่าโลกมีอะไรอีก
  แค่ห้องนี้ยังไม่ได้พาไป
- ด่านปัจจุบันของหน้าห้อง = ทักษะแรกที่**ห้องนี้ฝึก**แล้วยังไม่ครบดาว (คนละตัวกับหน้าโปรไฟล์)

**สองแผนที่ยังต่างกันจริง**

| | โปรไฟล์ | ห้องเรียน |
|---|---|---|
| ด่านที่สว่าง | 9 ด่าน | เฉพาะที่ห้องนี้สั่งฝึก (ทดสอบ: 2 จาก 9) |
| ตัวเลขดาว | รวมทุกห้อง x/27 | เฉพาะกลุ่มที่ห้องนี้ฝึก x/6 |
| ด่านปัจจุบัน | ด่านแรกที่ยังไม่ครบ | ด่านแรกที่**ห้องนี้ฝึก**แล้วยังไม่ครบ |

ดาวยังเป็นของนักเรียนรายคนเหมือนเดิม ไม่ได้แก้ schema และไม่ได้บอกว่าดาวเป็นของห้อง

### เอาแถบ "← กลับ Workspace / Dashboard" ออกทุกหน้า
ซ้ำกับปุ่ม Workspace บน header อยู่แล้ว และกินที่ด้านบนของทุกหน้าโดยไม่ให้อะไรเพิ่ม
ลบออกจาก `index.html` พร้อม CSS ที่เคยจัดสีให้มันในโหมดเกม

### ทดสอบแล้ว
- หน้าห้อง: 2 ด่านสว่าง 7 ด่านหรี่ · ชิป "เรียงลำดับคำสั่ง 1/3" กับ "บังคับหุ่นเคลื่อนที่ 1/3"
- หน้าโปรไฟล์: 9 ด่านสว่างครบ ไม่มีด่านหรี่ · ไม่มีแผงทักษะของห้อง
- แถบกลับ Workspace หายจากทุกหน้า · ไม่มี console error

---

## [2.7] 6 สิงหาคม 2026 — แก้ 3 เรื่องที่ [2.6] ทำผิด

### 1. ⛔ ถอดสไปรต์หุ่นออกจากหน้านักเรียน — ใช้ผิดวัตถุประสงค์
[2.6] เอาสไปรต์ใน `static/sprites/front/` (Base + Head + Face) มาประกอบเป็นตัวละคร
วางไว้ทั้งบน HUD บนแผนที่ และในหน้าฉลอง **โดยไม่ได้ขออนุญาต**

สไปรต์ชุดนั้นเป็น **digital twin ของหุ่นจริง** มีไว้ให้เวทีจำลองแสดงสถานะหุ่นตามที่เด็กสั่ง
เอามาเป็นมาสคอตประดับหน้าเว็บคือคนละวัตถุประสงค์กัน

- ถอดออกครบทั้ง 3 จุด · ลบคลาส `.g-robot` และ `.g-celebrate-robot` ทิ้ง
- แทนด้วย `Dashboard._marker()` — หมุดธงที่วาดด้วย SVG ปักบนด่านปัจจุบัน
- เขียนกฎห้ามไว้ทั้งใน `THEME.md` ข้อ 14 และคอมเมนต์ในโค้ดทั้งสองไฟล์
  ถ้าจะมีตัวละคร ต้องเป็นอาร์ตที่วาดขึ้นมาเพื่อการนี้โดยเฉพาะ

### 2. พลิกพาเลตจากมืดเป็นสว่าง — [2.6] อ่านเรฟผิด
[2.6] ใช้พื้นเข้ม `#0d1122 → #151d3b` โดยอ้างเหตุผลว่า "เกมต้องมีที่มืดให้ของสว่างเปล่ง"
**แต่เรฟที่ได้รับคือ Stardew Valley ซึ่งสว่างและอบอุ่น** (หญ้าเขียว ฟ้าสด แดดอุ่น)
ที่มืดคือ Hollow Knight / Balatro ซึ่งเป็นคนละเกม — เอาสูตรผิดเกมมาใช้

**ทิศทางใหม่ที่ตกลงกัน: Stardew ผสม METO**

| | เดิม [2.6] | ใหม่ [2.7] |
|---|---|---|
| พื้นฉาก | น้ำเงินเกือบดำ | **ฟ้า → หญ้า มีเส้นขอบฟ้าตัดคม** (hard stop ไม่ไล่เฉด) |
| แผง | น้ำเงินเข้ม | **ไม้ครีม `#f7ecd2` กรอบน้ำเงินแบรนด์ `#3A53A4`** |
| ตัวหนังสือ | ขาวบนเข้ม | น้ำตาลเข้ม `#3d3226` บนครีม |
| ดาว | เขียวมะนาว | **ทอง `#FFBF00`** |
| ทางเดิน | เส้นวงจร | **ทางดินสีแทนบนหญ้า** |
| พื้นหลังฉาก | ลายแผงวงจร | พุ่มหญ้า + ก้อนกรวด |
| ม่านหน้าฉลอง | ดำสนิท | อุ่น `rgba(58,45,25,.68)` — ฉากเป็นกลางวัน ดำสนิทดูเหมือนไฟดับ |

**3 จุดที่ผสมแบรนด์เข้าไปในโลก Stardew** (ตอบกรรมการได้ว่าทำไมยังเป็นเว็บเดียวกัน)
1. กรอบแผงเป็น `#3A53A4` แทนขอบไม้น้ำตาล
2. ดาวใช้ `#FFBF00` ซึ่งอยู่ในพาเลตหมวดบล็อก (Head) อยู่แล้ว ไม่ได้เพิ่มสีใหม่
3. หญ้า `#8ec95a` เป็นญาติของ accent `#BED73B` — โลกกับจุดเน้นอยู่ตระกูลเดียวกัน

`THEME.md` ข้อ 8 แก้ข้อ 1 จาก "พื้นต้องเข้ม" เป็น **"พื้นสว่างอบอุ่น มีฟ้ามีพื้นดิน"**
พร้อมหมายเหตุว่าธีม A ล้มเหลวเพราะ**แบนราบ** ไม่ใช่เพราะสว่าง

### 3. แยกเนื้อหาโปรไฟล์กับห้องเรียนจริงๆ
[2.6] วาดหน้าเดียวกันทั้งสองเส้นทาง แล้วแค่*กรอง*ภารกิจตามห้อง
ผลคือ `#/dashboard/me` กับ `#/dashboard/room/<id>` เหมือนกันจนแยกไม่ออก
ทั้งที่แผนตอนแรกเขียนไว้เองแล้วว่าข้อมูลไหนเป็นของ user ข้อมูลไหนเป็นของห้อง

แยกเป็น `_renderProfile()` กับ `_renderRoom()` ตามที่ฐานข้อมูลบอก

| | โปรไฟล์ `#/dashboard/me` | ห้องเรียน `#/dashboard/room/<id>` |
|---|---|---|
| ผูกกับ | `user_id` | `classroom_id` |
| แผนที่ดาว 9 ด่าน | ✅ พระเอก | ❌ มีแค่ปุ่มลิงก์ไป |
| คลังผลงาน · ตู้เหรียญ | ✅ | ❌ |
| กระดานภารกิจ | ❌ มีปุ่มลิงก์เข้าห้อง | ✅ พระเอก |
| คะแนน | ❌ | ✅ เฉพาะของห้องนี้ |
| แถบความคืบหน้า | ดาว x/27 | **ส่งภารกิจแล้ว x/y ข้อ** (คนละตัวเลข) |
| HUD | โชว์ดาว + ยศ | โชว์ชื่อห้อง + ครู + เลขที่ · **ไม่โชว์ดาว** |

เหตุผลที่ดาวไม่อยู่ในหน้าห้อง: `StudentObjectiveProgress` unique ที่ `student_id + objective_id`
ไม่มี `classroom_id` — เด็กอยู่ 2 ห้องก็เห็นดาวชุดเดียวกัน เอาไปโชว์ในหน้าห้องจะสื่อผิด

### ทดสอบแล้ว
- โปรไฟล์: มีแผนที่/ตู้เหรียญ · **ไม่มี**กระดานภารกิจ
- ห้องเรียน: มีกระดานภารกิจ/คะแนนของห้อง · **ไม่มี**แผนที่/ตู้เหรียญ
- ไม่มี console error · ไม่มีตัวแปรพาเลตเก่าหลงเหลือ · `predeploy_check.py` ผ่าน
- ธีม B ยังไม่รั่วออกฝั่งครู

### ยังค้าง
- ฟอนต์ Silver ยังไม่ได้วางไฟล์ (ต้องโหลดผ่านเบราว์เซอร์เอง)
- ยังไม่มีตัวละครในหน้านักเรียน — รออาร์ตที่วาดใหม่ ระหว่างนี้ใช้หมุดธง

---

## [2.6] 6 สิงหาคม 2026 — รื้อหน้านักเรียนใหม่หมดเป็น "เกม" จริง (ธีม B)

### ที่มา — [2.5] ทำผิดโจทย์
[2.5] ทำโดยยึดธีมเดิมแล้วแปะดาวเพิ่ม ผลที่ได้คือ **แอดมินแพเนลติดดาว**
ให้เอเจนต์จำลองผู้ใช้ 4 คนวิจารณ์ (ม.1 / ม.2 / ม.3 / นักศึกษาออกแบบ) ได้ผลตรงกันหมด

| | คะแนน |
|---|---|
| ความน่าเบื่อ | **8/10 ทั้ง 4 คน** |
| ดูเหมือนเกม | **2/10** |

คำที่ผู้ใช้ใช้เรียกหน้านี้: *"เว็บดูเกรด" · "สมุดพก" · "ใบคะแนนที่ได้ 0 ทุกช่อง"*

**วินิจฉัยที่ชี้ขาด 4 ข้อ**
1. **ทั้งหน้าอยู่ในช่วงความสว่าง 92-100%** (`#f8f9fc` / `#fff` / `#e8ecf4` คือขาวสามเฉด)
   ไม่มีอะไรเด้งได้เพราะทุกอย่างสว่างเท่ากันหมด — เกมเริ่มจากพื้นเข้มเสมอ
2. **`.skill-map` ใช้สูตร CSS เดียวกับ `.hub-card` ของหน้าแอดมินเป๊ะ** เปลี่ยนแค่ตัวเลข
   แปลว่าแผนที่เด็กกับเมนูแอดมินเป็นคอมโพเนนต์เดียวกัน
3. **ไม่มี idle motion** — โหมดเกมทั้งโหมดมี keyframe เดียว (`starPop`)
   ส่วนกล่องแชทหน้า Workspace มีสาม · กล่องแชทมีชีวิตกว่าโหมดเกม
4. **เงาฟุ้ง = Material Design · เงาแข็งเยื้อง = เกม** ต่างกันแค่ property เดียวแต่พลิกทั้งหน้า

> สรุป: ถ้าลบตัวหนังสือออกให้เหลือแต่รูปทรง มันคือหน้ารายงานผล LMS
> คำว่า "ดาว/แผนที่/ระดับ" เป็นสัญญาณเกมเพียงอย่างเดียวที่มี

### `THEME.md` — แยกเป็น 2 ธีม เลิกใช้ธีมเดียวทั้งเว็บ
ต้นเหตุที่แท้จริงอยู่ในไฟล์ธีมเอง ที่เขียนไว้ว่า *"ต้นแบบของธีมทั้งเว็บ = หน้า Workspace"*
**Workspace คือเครื่องมือ (IDE)** เอากฎของ IDE ไปสร้างหน้าเด็ก ผลลัพธ์จะเป็น IDE เสมอ

| | ธีม A — เครื่องมือ | ธีม B — เกม |
|---|---|---|
| ขอบเขต | ทุกหน้าที่ไม่ใช่ `body.mode-player` | `body.mode-player` เท่านั้น |
| ต้นแบบ | Workspace | เกม 2D พิกเซล (อ้างอิง Stardew Valley) |
| พื้น | สว่าง การ์ดขาว | เข้ม ฉากมีความลึก |

ใช้ร่วมกันแค่แบรนด์ — `#3A53A4` · `#BED73B` · สีหมวดบล็อก 8 สี · ฟอนต์ไทย
ที่เหลือแยกกันโดยสิ้นเชิงและ**ตั้งใจให้ต่างกัน** · เพิ่มข้อ 8-15 เป็นสเปกธีม B เต็มตัว
ฝั่งครูคงเดิมทุกอย่างเพราะต้องอ่านง่ายและพิมพ์ลงเล่มวิจัยได้

### `static/game-ui.css` (ใหม่) — รากฐานภาพเกม
- **พาเลตฐานเข้ม** `#0d1122 → #151d3b → #223056 → #2f4074` — เป็น**เฉดเข้มของ `#3A53A4`** ทั้งหมด
  ไม่ใช่สีใหม่ (สำคัญตอนอธิบายในเล่ม: เปลี่ยนค่าความสว่าง ไม่ได้เปลี่ยน hue)
  พอพื้นเข้มแล้ว `#BED73B` เปล่งได้จริงโดยไม่ต้องใช้ `accent-text` มาแก้เหมือนธีม A
- **ไม่มีมุมโค้ง** — มุมบากด้วย `clip-path` แทน `border-radius` (พิกเซลอาร์ตมุมเหลี่ยม)
- **เงาแข็ง** `0 4px 0` + `inset` ขอบบนสว่าง · กดแล้ว `translateY(4px)` ยุบจริง
- **พื้นผิว** ลายขีด 45° + เส้นสแกน วาดด้วย `repeating-linear-gradient` ล้วน ไม่ใช้ไฟล์
- **idle loop** `gBob / gBreath / gPulse` + คลาส `.g-ph1..4` กระจายเฟส
  ขยับพร้อมกัน = เครื่องจักร · เหลื่อมกัน = สิ่งมีชีวิต
- ตะแกรง 4px · ตัวหนังสือ ≥ 16px · `image-rendering: pixelated` ทุกภาพ
- คลาส `.g-panel--slice` เตรียมไว้สลับไปใช้ 9-slice ของ Kenney เมื่อต้องการ

### `static/sfx.js` (ใหม่) — เสียงเกมโดยไม่มีไฟล์เสียง
เดิมทั้งเว็บ**เงียบสนิท 100%** ตอนนี้สังเคราะห์สดด้วย Web Audio API
- ไม่มีปัญหา license · ไม่ต้องโหลด · ปรับจูนจากโค้ดได้ · คลื่น square/triangle ให้ฟีล 8-bit
- `click / hover / star / skillComplete / unlock / step / open / close / ok / nope`
- เคารพนโยบาย autoplay — `AudioContext` ปลุกตอน gesture แรกเท่านั้น ไม่พยายามเล่นตอนโหลดหน้า
- มีปุ่มปิดเสียงบน HUD และจำค่าใน `localStorage`
- เสียง `nope` ต่ำและนุ่ม ห้ามฟังดูเหมือนถูกดุ (กฎห้ามลงโทษความผิดพลาดของเด็ก)

### `static/dashboard-player.js` — เขียนใหม่ทั้งไฟล์
| เดิม [2.5] | ใหม่ [2.6] |
|---|---|
| กริดการ์ดขาว 9 ใบ | **เส้นทางเดียวคดเคี้ยวผ่าน 9 ด่าน** (กริด = สเปรดชีต · เส้นทาง = แผนที่) |
| ตัวหนังสือ 27 บรรทัดบนการ์ด | บนโหนดมีแค่ไอคอน + ดาว · ชื่อไปอยู่แผงรายละเอียดตอนเลือก |
| ไม่มีตัวละคร | **หุ่น METO ยืนบนด่านปัจจุบัน** ขยับตลอดเวลา เปลี่ยนสีหน้าตามสถานะ |
| toast จิ๋ว 4.2 วิ | **จอมืด + หุ่นหน้าหัวใจ + ดาวพุ่ง + อนุภาค + จอสั่น · ต้องกดปิดเอง** |
| เงียบ | มีเสียงทุก interaction |

- เส้นทางเป็น SVG 2 ชั้น (ล่างหนาเข้ม = เปลือก · บนบางสว่าง = ร่อง) ได้ความลึกด้วย 2 บรรทัด
  ช่วงที่กำลังเล่นใส่ `stroke-dashoffset` วิ่ง = กระแสไฟไหลไปตามเส้น
- พื้นหลังเป็นลายแผงวงจร วาดด้วยเส้นตรง + วงกลมล้วน — เข้าเรื่องหุ่นยนต์และไม่ต้องมีภาพ
- ตำแหน่งด่าน **ไม่สมมาตร** โดยตั้งใจ — ความไม่สมมาตรทำให้ตาอ่านว่า "สถานที่" แทน "ตาราง"
- ไอคอนเปลี่ยนจากเส้นบางเป็น**ซิลูเอตทึบ** (เส้นบางคือภาษาไอคอนของแอดมินแพเนล)
- โหนดเข้าถึงด้วยคีย์บอร์ดได้ (`tabindex` + Enter/Space) · ปิดหน้าฉลองด้วย Esc ได้

### สไปรต์หุ่น — ของที่มีอยู่แล้วแต่ไม่เคยถูกใช้
`static/sprites/front/` มี PNG จริง 32 ไฟล์ รวม **10 สีหน้า** (Happy/Sad/Angry/Shocked/
Sleepy/Confused/Love/Shy/LookLeft/LookRight) แต่หน้าเด็กเดิมไม่มีหุ่นสักตัว
- ประกอบเป็นตัวละครจากเลเยอร์ Base + Head + Face (ภาพ 640×480 ซ้อนพิกัดเดียวกัน)
- วัด bbox จากไฟล์จริง (x 231-409 · y 144-353) แล้วครอบตัดด้วย CSS
  ถ้าวาง `object-fit: contain` เฉยๆ หุ่นจะเหลือ ~27px ในกล่อง 96px = มองไม่เห็น

### Asset ใหม่ + license (ต้องอ้างในเล่ม)
- **Kenney Pixel UI Pack** → `static/game-assets/kenney-pixel-ui/` (371 KB)
  **CC0** ไม่ต้องเครดิต ใช้เชิงพาณิชย์ได้ · มี 9-slice 3 ชุด + spritesheet 16×16
- **ฟอนต์ Silver** (Poppy Works) — **มีอักษรไทยครบ** CC BY 4.0 ต้องใส่เครดิต
  itch.io บังคับ session ผ่านเบราว์เซอร์ โหลดอัตโนมัติไม่ได้ → **ยังไม่ได้วางไฟล์**
  `@font-face` เตรียมไว้แล้วที่ `static/vendor/Silver.ttf` วางไฟล์แล้วใช้ได้ทันที
  ระหว่างนี้ตกไปใช้ Prompt โดยไม่พัง
- **ไม่ใช้** TA Chai Lai Pixel — ระบุชัดว่า "ฟรีสำหรับใช้งานส่วนตัวที่ไม่ใช่เชิงพาณิชย์"
  เชิงพาณิชย์ 300-500 บาท งานวิทยานิพนธ์เป็นพื้นที่สีเทา จึงไม่โหลด

### บั๊กที่เจอระหว่างทำ
1. **ดาวเหนือโหนดหายไปหมด** — คำนวณพิกัดเป็นค่าสัมบูรณ์ แต่ไปวางใน `<g>` ที่ `translate` แล้ว
   พิกัดเลยถูกบวกซ้ำจนหลุดออกนอก viewBox (โหนดที่ (70,322) → ดาวไปโผล่ที่ (116,592))
   แก้เป็นพิกัดสัมพัทธ์กับโหนด
2. **หน้าฉลองมองไม่เห็นทั้งกล่อง** — `body.mode-player .g-celebrate` (0,2,1)
   ชนะ `.g-celebrate.is-on` (0,2,0) ทำให้ `opacity` ค้างที่ 0
   แก้โดยถอด prefix ออก เพราะ overlay ถูก append ที่ `body` ตรงๆ อยู่แล้ว

### ทดสอบแล้ว
- แผนที่ 9 โหนด · หุ่นยืนบนด่านปัจจุบัน · ด่านปัจจุบันเรืองแสง · เส้นทางที่ผ่านแล้วเป็นสีมะนาว
- ดาวลอยเหนือโหนดที่มีความคืบหน้า · แผงรายละเอียดเปลี่ยนตามด่านที่กด
- หน้าฉลองแสดงผลครบ (หุ่นหน้าหัวใจ + ดาวพุ่ง + อนุภาค 10 ชิ้น)
- **ธีม B ไม่รั่วออกฝั่งครู** — หน้าเลือกแดชบอร์ดยังพื้นขาว การ์ดมุมโค้ง 12px เหมือนเดิม
- ไม่มี console error · `predeploy_check.py` ผ่านทุกข้อ

### ยังไม่ได้ทำ
- ฟอนต์ Silver ยังไม่ได้วางไฟล์ (ต้องโหลดผ่านเบราว์เซอร์)
- ยังไม่มีเสียงประกอบฉาก (BGM) — ตั้งใจไม่ทำ เพราะเด็กใช้ในห้องเรียน
- อาร์ตตัวหุ่นยังเป็นภาพเทคนิคสีเทาของเดิม รอวาดทับ

---

## [2.5] 6 สิงหาคม 2026 — แยก UI นักเรียน (โหมดเกม) ออกจาก UI ครู ตามที่อาจารย์คอมเมนต์

### ที่มา
อาจารย์คอมเมนต์แดชบอร์ดมา 2 ข้อ

1. การพัฒนาทักษะ 9 อย่างควรเป็นเหมือนเกม มีดาวบอกความคืบหน้า — ฝั่งเด็กควรรู้สึกเหมือนเล่นเกม
2. ฝั่งอาจารย์ให้เห็นแบบปกติเหมือนผู้ใช้ทั่วไป

**ปัญหาที่ต้องแก้ก่อน:** ระบบเป็น universal user ทุกคน `role = 'USER'` เท่ากันหมด
บทบาทครู/นักเรียนเกิดจากความสัมพันธ์กับห้องเรียน ไม่ใช่คอลัมน์ในตาราง `users`
จึงต้องหาวิธีแยก UI โดย**ไม่เพิ่ม role column** (จะขัดกับที่ออกแบบไว้ทั้งระบบ)

### ทางออก — role มาจากห้อง ไม่ใช่จากคน
```
มีห้องที่สร้างเอง (ClassRoom.teacher_id) → ครู
อยู่ในห้องคนอื่น  (ClassMembership)      → นักเรียน → โหมดเกม
ไม่มีทั้งสองอย่าง                        → แดชบอร์ดปกติ (ไม่มีเครื่องมือครู)
```
คนที่เป็นทั้งสองอย่างพร้อมกันได้ (ครูที่ไปเข้าห้องครูคนอื่น / เด็กที่สร้างห้องติวเอง)
จึงไม่ใช้ปุ่มสลับโหมดแบบ global แต่ใช้ **หน้าเลือกแดชบอร์ด** — เลือกห้องไหนก็ได้บทบาทของห้องนั้น
ทำให้รูปร่าง UI ตรงกับรูปร่างฐานข้อมูล และไม่ต้องเดาบทบาทด้วย localStorage

### migration `e5b71c9a3d42` — `grades.classroom_id`
- เดิม `grades` มีแต่ `teacher_id / student_id / project_id / submission_id`
  จะรู้ว่าคะแนนก้อนนี้อยู่ห้องไหนต้องไล่ `submission → assignment → classroom_id`
  และคะแนนที่ให้ตรงๆ บนโปรเจกต์ (`submission_id IS NULL`) **ไม่สังกัดห้องไหนเลย**
  → หน้าห้องเรียนถามว่า "คะแนนของฉันในห้องนี้" ไม่ได้
- เพิ่มคอลัมน์ `classroom_id` (nullable, **ON DELETE SET NULL**)
  — คะแนนเป็นหลักฐานทางการศึกษา ห้ามหายเพราะห้องถูกลบ
  — คะแนนที่ผูกกับงานที่ส่งยัง CASCADE ผ่าน `submission_id` เหมือนเดิม ไม่ได้เพิ่มเส้นทางลบใหม่
- index `ix_grade_classroom_student` — "คะแนนของนักเรียนคนนี้ในห้องนี้" คือ query หลักของหน้าห้อง
- **backfill จากข้อมูลจริงเท่านั้น** `submission → assignment → classroom_id`
  แถวที่ไม่มี submission ปล่อยเป็น NULL **ไม่เดาจากห้องที่ครูสอน** เพราะครูคนเดียวสอนหลายห้อง
  เดาผิดแล้วคะแนนจะไปโผล่ผิดห้อง
- SQLite ใช้ `ALTER TABLE ADD COLUMN ... REFERENCES` (ทำได้เพราะค่าเริ่มต้นเป็น NULL)
  **ไม่สร้างตารางใหม่** เพื่อไม่ให้ CHECK constraint ของ `grades` หายไปตอน reflect
  ส่วน PostgreSQL ใช้ `add_column` + `create_foreign_key` ตามปกติ
- ทดสอบแล้ว: backfill ถูกต้อง (แถวที่มี submission ได้ห้อง · แถวลอยเป็น NULL) ·
  downgrade/upgrade กลับไปกลับมาได้ · CHECK constraint ครบ 2 อันเหมือนเดิม ·
  `scripts/predeploy_check.py` ผ่านทุกข้อ

### `dashboard.py` — ส่งตัวเลขที่หน้าเกมต้องใช้
- `/api/dashboard` เดิมส่ง skills แค่ `name / category / status`
  **ทิ้ง `clean_run_count` กับ `mastery_threshold` ที่มีอยู่ในฐานข้อมูลแล้ว** (ข้อ 4.4 / 4.5)
  หน้าเว็บเลยรู้แค่ผ่าน/ไม่ผ่าน บอกไม่ได้ว่า "เหลืออีกกี่ครั้งจะได้ดาว"
  → เพิ่ม `id / description / clean_run_count / mastery_threshold / mastered_at /
  first_progress_at / auto_detectable`
- **ดาวคือตัวเลขเดิม ไม่ใช่ข้อมูลใหม่** — `clean_run_count` เทียบ `mastery_threshold` (ค่าตั้งต้น 3)
  ฝั่งเด็กแสดงเป็น ★★☆ ฝั่งครูแสดงเป็น `2/3` — ข้อมูลชุดเดียวกัน คนละการนำเสนอ
  ข้อมูลที่เอาไปเขียนเล่มวิจัยไม่เปลี่ยน
- `grades` ที่ส่งให้หน้าเว็บมี `classroom_id` + `classroom_name` แล้ว
- `give_grade()` เซ็ต `classroom_id` ให้คะแนนทุกก้อนผ่าน `_resolve_grade_classroom()` ใหม่
  ลำดับความน่าเชื่อถือ: งานที่ส่ง → ห้องที่ครูระบุ (ตรวจสิทธิ์ก่อน) →
  ห้องเดียวที่เด็กอยู่ร่วมกับครู · **ถ้ากำกวมคืน None ไม่เดา**

### `skills.py` — บอกได้ว่าดาวไหนระบบให้เองได้
- พบว่า `seed_data()` ใส่ `LearningObjective` ไว้ **10 อัน** แต่ `detect_skills()` ตรวจได้ **9 อัน**
  `Decomposition` ไม่มีกติกาตรวจเลย เพราะชุดบล็อกยังไม่มีบล็อกฟังก์ชัน/procedure
  ที่จะใช้เป็นหลักฐานว่าเด็ก "ย่อยงานใหญ่เป็นงานเล็ก" จริง
  → ถ้าปล่อยไว้ เด็กจะเห็นดาวที่ค้าง **0/3 ตลอดกาล** โดยไม่มีคำอธิบาย
- เพิ่ม `DETECTABLE_SKILLS` (9 ชื่อ) และ `auto_detectable` ใน payload
  หน้าเกมแยกการ์ด "ดาวจากครู" ออกจาก 9 ดาวที่ระบบให้เอง — ตรงกับ "ทักษะ 9" ที่อาจารย์พูดพอดี
- **ไม่ลบ `Decomposition` ออกจาก seed** เพราะเป็นวัตถุประสงค์การเรียนรู้ที่ครูให้เองได้อยู่แล้ว
  และอาจผูกกับกรอบทฤษฎีในเล่ม — ตัดสินใจลบควรเป็นเรื่องของงานวิจัย ไม่ใช่ของ UI

### `models.py`
- `Grade.classroom_id` + relationship `Grade.classroom` (backref `ClassRoom.grades`)
- index `ix_grade_classroom_student` ใน `__table_args__` · `to_dict()` ส่ง `classroom_id`

### หน้าเว็บ — เส้นทางใหม่และการแยกหน้า
```
#/dashboard            เลือกให้อัตโนมัติ
#/dashboard/me         โปรไฟล์ของฉัน — ข้อมูลที่ไม่ผูกกับห้อง (ดาว ผลงาน เหรียญ สถิติ)
#/dashboard/room/<id>  ห้องเรียนห้องนั้น — บทบาทขึ้นกับว่าเราเป็นเจ้าของห้องหรือสมาชิก
```
- `router.js` เพิ่ม `resolve()` — จับคู่แบบคำนำหน้าเมื่อไม่มี route ตรงตัว
  ทำให้หน้าย่อยใช้ `page-dashboard` เดิมได้ และปุ่ม Dashboard บน header ยังสว่างอยู่
- `dashboard.js` แตก `render()` เป็นตัวแจกงาน → `renderHub` / `renderPlayer` / `renderNormal`
  **ไม่ย้ายโค้ดเดิมออก** เพราะปุ่มต่างๆ ผูกกับ `onclick="Dashboard.xxx"` ทั้งไฟล์
  ไฟล์ใหม่ใช้ `Object.assign(Dashboard, {...})` ต่อยอดแทน — ลดความเสี่ยงพังของเก่า
- `body` ได้คลาส `mode-player` / `mode-hub` แยก scope ของ CSS ไม่ใช่แค่ซ่อน div

### `dashboard-hub.js` (ใหม่) — หน้าเลือกแดชบอร์ด
- `getView()` เป็นที่เดียวที่ตัดสินว่าจะวาดหน้าไหน อ่านจาก hash + ห้องที่มีจริง
- **หน้าเลือกโผล่กับทุกคนที่มีห้องอย่างน้อย 1 ห้อง** และมีครบทุกบล็อกที่คนคนนั้นเข้าได้
  1. **แดชบอร์ดของฉัน** (โปรไฟล์) — ดาว ผลงาน เหรียญ สถิติ ไม่ขึ้นกับห้องไหน
  2. **ห้องที่ฉันเป็นครู** — หนึ่งช่องต่อหนึ่งห้อง
  3. **ห้องที่ฉันเป็นนักเรียน** — หนึ่งช่องต่อหนึ่งห้อง

  คนเดียวกดเข้าได้ครบทุกช่อง ไม่ต้องออกจากระบบสลับบัญชี
  คนที่ยังไม่มีห้องเลยไม่มีอะไรให้เลือก → เข้าแดชบอร์ดของตัวเองตรงๆ
- ขอเข้าห้องที่ไม่เกี่ยวกับเรา → ตกกลับไปค่าเริ่มต้น ไม่แสดงอะไรของห้องนั้น
  และเซิร์ฟเวอร์ก็กรองซ้ำอีกชั้น (`selected_id not in owned_rooms` → ใช้ห้องตัวเอง)

### บั๊กที่เจอตอนทดสอบจริง — การ์ดหน้าเลือกลอยไปกองที่มุมขวาบนทับ header
`style.css` บรรทัด ~59 มีกฎ **global** ที่ตั้งไว้ตั้งแต่ยุคปุ่มลอยของหน้า Workspace
```css
button { position: absolute; top: 20px; right: 20px; z-index: 100; }
```
`<button>` ทุกตัวในเว็บโดนกฎนี้ ถ้าไม่ override จะถูกดันไปมุมขวาบน
การ์ดหน้าเลือกทั้ง 3 ใบเป็น `<button>` จึงไปซ้อนทับกันอยู่จุดเดียว เห็นแค่ใบบนสุด
หน้าตาเลยออกมาเหมือนกล่องแจ้งเตือนเด้งทับ header แทนที่จะเป็นช่องเรียงกัน
- แก้: `.hub-card` และ `.hub-back` ใส่ `position: static`
  (`.project-btn` / `.btn-add` ที่มีอยู่เดิมก็ override ด้วยเหตุผลเดียวกัน)
- ใส่คอมเมนต์เตือนไว้เหนือบล็อก CSS แล้ว — ปุ่มใหม่ทุกตัวต้อง override ไม่งั้นเจอซ้ำ

### `dashboard-player.js` (ใหม่) — หน้าเกมของนักเรียน
- แผนที่ทักษะ 9 การ์ด — วงกลมสีหมวด + ★★☆ + "อีก N ครั้งได้ดาวเพิ่ม"
- แถบระดับ + ดาวรวม `x/27` + ป้ายระดับ (`PLAYER_RANKS`) — เป็นคำชมจากตัวเลขเดิม
  **ไม่เก็บลงฐานข้อมูลและไม่เกี่ยวกับการประเมินของครู**
- `Decomposition` แยกไปกล่อง "ดาวที่ครูเป็นคนให้" และ**ไม่ถูกนับในตัวหาร**
  ถ้านับรวมตัวหารจะเป็น 30 แล้วเด็กไปไม่ถึงเต็มตลอดกาล
- โจทย์/คะแนน เปลี่ยนเป็นภาษาเกม (ภารกิจ / ผลงานของฉัน) เนื้อหาเดิมทั้งหมด
- ได้ดาวใหม่ → เด้ง `.star-toast` + ไฮไลต์การ์ด เทียบจาก snapshot ใน `localStorage`
  **ครั้งแรกที่เปิดไม่เด้ง** ไม่งั้นจะรัวทุกดาวที่มีอยู่แล้ว · localStorage เขียนไม่ได้ก็ไม่พัง

### ฝั่งครู
- หน้าห้องเรียนแยกต่อห้อง — greeting เป็นชื่อห้อง ไม่แสดงรายการห้องทั้งหมดซ้ำ
  โจทย์และคะแนนกรองด้วย `classroom_id` แล้ว
- หน้ารายละเอียดนักเรียนเพิ่ม `_masteryMeter()` — แถบ + **`2/3`** ต่อทักษะ
  ครูต้องอ่านค่าไปกรอกเล่มและตัดสินใจสอนซ่อม จึงเป็นตัวเลข ไม่ใช่ดาว
  ทักษะที่ระบบตรวจเองไม่ได้ขึ้นป้าย "ครูประเมินเอง" แทนตัวนับที่ไม่มีความหมาย
- `/api/students/<id>` ส่ง `clean_run_count / mastered_at / changed_by / auto_detectable` เพิ่ม

### `THEME.md`
- เพิ่มหมวด **5A โหมดเกมของนักเรียน** — ดาว การ์ดทักษะ toast หน้าเลือก และกติกาว่า
  ฝั่งครูต้องเห็นตัวเลขชุดเดียวกันเสมอ · เพิ่ม 2 ข้อใน checklist ข้อ 7

### ทดสอบแล้ว (4 สถานะบทบาท)
| สถานะ | ผล |
|---|---|
| นักเรียนล้วน (`test2`) | หน้าเลือก 2 ช่อง → โปรไฟล์ = หน้าเกม 4/27 ดาว · 9 การ์ด + 1 การ์ดครูให้ |
| ครู (`test`) | หน้าเลือก → เข้าห้อง → เครื่องมือครูครบ · ปุ่มกลับหน้าเลือก |
| เป็นทั้งสองอย่าง | หน้าเลือกมี 3 ช่องเรียงกันในกริด · เข้าห้องที่เป็นนักเรียน = โหมดเกม **ไม่เห็นรายชื่อนักเรียนห้องนั้น** |
| ยังไม่มีห้องเลย (`testuser`) | แดชบอร์ดปกติ ไม่มีเครื่องมือครู · เห็นทั้งช่องเข้าร่วมและปุ่มสร้างห้อง |

ขอเข้าห้องมั่วๆ (`#/dashboard/room/99`) → ตกกลับหน้าเลือก เซิร์ฟเวอร์คืนเฉพาะนักเรียนห้องตัวเอง

---

## [2.4] 1 สิงหาคม 2026 — `แผนแก้ไขฐานข้อมูล.md` ช่วงที่ 4 (สิ่งที่เล่มวิจัยต้องใช้) ครบทั้ง 7 ข้อ

> **จบทั้งเอกสารแล้ว** — ช่วงที่ 1-4 ครบทุกข้อ

### สรุปสั้น
ทำให้ระบบ "เก็บข้อมูลได้พอสำหรับเขียนเล่มวิจัย" — เก็บ transcript บทสนทนา AI,
คะแนนแบบทดสอบก่อน/หลัง, ตัวแปรควบคุมและความยินยอม, มิติเวลาของทักษะ,
เกณฑ์ที่ตอบได้ว่ามาจากไหน, ส่งออก CSV และระบบบันทึกเหตุการณ์ที่มีโครงสร้าง

### migration เดียวจบทั้งช่วง
`cc93a6478d7e` — ตารางใหม่ 5 ตาราง + คอลัมน์ใหม่ 13 คอลัมน์ + backfill จากข้อมูลจริง

### 4.1 บทสนทนากับ AI ถูกเก็บแล้ว (🔵)
- ตาราง **`ai_conversations`** — เก็บทุกเทิร์นพร้อม `turn_index`, `project_id`
  และผังบล็อก ณ เวลาที่ถาม
- `server.py` เลิกใช้ `chat_sessions = {}` ในหน่วยความจำ — อ่าน/เขียนฐานข้อมูลแทน
  แก้ปัญหาเดิม 2 อย่างพร้อมกัน: รีสตาร์ตแล้วประวัติหาย · gunicorn หลาย worker ไม่แชร์ตัวแปรกัน
- `/clear_session` **ไม่ลบ transcript ทิ้ง** — แค่ให้ id ใหม่ไปเริ่มคุยใหม่ ข้อมูลวิจัยยังอยู่
- ครูเปิดอ่านได้จากปุ่ม "บทสนทนา AI" ในหน้ารายละเอียดนักเรียน

### 4.2 แบบทดสอบก่อน/หลังเรียน (🔵)
- ตาราง **`assessments`** — `instrument` × `phase` (PRE/POST/RETENTION) × `total`/`max_total`
  + คะแนนรายข้อเป็น JSON · unique ที่ (นักเรียน, เครื่องมือ, ระยะ) → บันทึกซ้ำ = แก้ค่าเดิม
- `POST /api/assessments` · `GET /api/students/<id>/assessments` · `DELETE /api/assessments/<id>`

### 4.3 ตัวแปรควบคุม + ความยินยอม + สิทธิถูกลบข้อมูล (🔵)
- `users` เพิ่ม `birth_year / gender / grade_level / school_code / prior_coding_exp /
  research_group / participant_code` (+ CHECK และ unique ของรหัสนิรนาม)
  — รับปีเกิดได้ทั้ง พ.ศ. และ ค.ศ. เก็บเป็น ค.ศ. เสมอ
- ตาราง **`parental_consents`** — สถานะ/ผู้ให้ความยินยอม/เลขที่เอกสาร/เวลา
- `DELETE /api/account` — ลบบัญชีพร้อมข้อมูลลูก (PDPA) ต้องพิมพ์ชื่อผู้ใช้ยืนยัน
  และถ้ายังมีคะแนน/งานที่ส่งซึ่งเป็นหลักฐานทางการศึกษา จะบอกให้ครูจัดการก่อน **แทนที่จะลบเงียบๆ**

### 4.4 สถานะทักษะมีมิติเวลาแล้ว (🔵)
- `student_objective_progress` เพิ่ม `first_progress_at / mastered_at / updated_at /
  clean_run_count / changed_by` — เดิม**ไม่มีคอลัมน์เวลาเลยแม้แต่ตัวเดียว**
- ตาราง **`objective_progress_history`** — บันทึกทุกครั้งที่สถานะเปลี่ยน พร้อมว่าใครเป็นคนเปลี่ยน
- `GET /api/students/<id>/objectives/history` + ปุ่ม "เส้นทางทักษะ" ในหน้ารายละเอียดนักเรียน
- **backfill จากข้อมูลจริง 9 แถว** โดยอ่านเวลาจาก log `SKILL:<ชื่อ>` ที่มีอยู่ ไม่เดาข้อมูล

### 4.5 เกณฑ์ความเชี่ยวชาญตอบได้ว่ามาจากไหน (🔵)
- `learning_objectives.mastery_threshold` — ย้ายเลข 3 ที่ฝังในโค้ดออกมาเป็นค่าที่ตั้งได้ต่อทักษะ
  และส่งกลับไปกับผลลัพธ์ทุกครั้งเพื่อให้ตรวจสอบย้อนได้
- **เปลี่ยนนิยาม "สำเร็จ"**: เดิม = "รันแล้วไม่ขึ้น error" (กดรันโค้ดว่างๆ ก็ผ่าน)
  ตอนนี้แต่ละโจทย์ใน `PRESET_TASKS` มี `goal` ที่เซิร์ฟเวอร์ตรวจจากบล็อกจริงในงานที่ส่ง
  (บล็อกที่ต้องมี · จำนวนคำสั่งขั้นต่ำ · loop ต้องมีคำสั่งข้างในกี่บล็อก)
- ผลตรวจติดไปกับงานที่ส่ง — นักเรียนเห็นว่ายังขาดอะไร ครูเห็นป้าย "ตรงเกณฑ์โจทย์ / ยังไม่ครบเกณฑ์"
  **ไม่บล็อกการส่ง** และไม่ตัดสินแทนครู เป็นตัวช่วยอ่านเร็วเท่านั้น

### 4.6 ส่งออกข้อมูล (🔵)
- `GET /api/classrooms/<id>/export.csv` — สำหรับครู มีชื่อจริง
- `GET /api/research/export.csv` — สำหรับเล่มวิจัย ใช้ `participant_code` แทนชื่อจริง
- `GET /api/classrooms/<id>/events.csv` — เหตุการณ์ดิบ (นิรนาม) ไว้วิเคราะห์พฤติกรรมละเอียด
- 25 คอลัมน์ต่อนักเรียนหนึ่งคน: ข้อมูลกลุ่มตัวอย่าง · ความยินยอม · สถิติการใช้งาน ·
  ทักษะที่ผ่าน · คะแนนเฉลี่ย · คะแนน PRE/POST/RETENTION
- ใส่ BOM ให้ Excel อ่านภาษาไทยออกโดยไม่ต้องตั้งค่า · ดาวน์โหลดผ่าน `fetch` เพราะต้องแนบ token

### 4.7 ระบบบันทึกเหตุการณ์ (🔵)
- ตาราง **`events`** + ไฟล์ใหม่ `eventlog.py` — 28 ชื่อเหตุการณ์ที่ระบบรู้จัก
  ผูกกับ `subject_type`/`subject_id` และมี `correlation_id` ร้อยเหตุการณ์จากการกดครั้งเดียวกัน
- เหตุการณ์ที่เดิม**ไม่เคยถูกบันทึกเลย** ตอนนี้บันทึกครบ: สร้าง/บันทึก/ลบงาน · เข้าห้องเรียน ·
  เอานักเรียนออก · สร้าง/ลบโจทย์ · ส่งงาน · ให้/แก้คะแนน · จบหรือข้าม tutorial ·
  ถาม AI · ส่งออกข้อมูล · **error ที่ระบบตรวจเจอ** (เดิมแสดงในแชทแล้วทิ้งทันที)
- `POST /api/events` รับจากหน้าเว็บได้เฉพาะ `program.executed`, `workspace.block_changed`,
  `errors.detected` — เหตุการณ์ที่เป็นหลักฐานความสามารถเซิร์ฟเวอร์บันทึกเองเท่านั้น
- `script.js` เพิ่ม `MetoEvents` ส่งเป็นชุดทุก 3 วินาที + ส่งของค้างตอนปิดแท็บ
  · `workspace.block_changed` (op/block_type/workspace_size) คือตัวที่แผนบอกว่า "ขาดมากที่สุด"
- `program.executed` เก็บ `block_types` แยกชนิด — ตอบได้แล้วว่า "บล็อกชนิดไหนถูกใช้บ่อยที่สุด"

### แก้บั๊กที่เจอระหว่างทดสอบ
`passive_deletes=True` ขาดไปในฝั่ง backref ของความสัมพันธ์ 8 เส้น ทำให้ตอนลบผู้ใช้
ORM สั่ง `UPDATE ... SET student_id=NULL` ชนกับ NOT NULL แทนที่จะปล่อยให้ ON DELETE CASCADE
ของฐานข้อมูลทำงาน (เจอตอนทดสอบการลบบัญชีตาม PDPA — ตอบ 500)

### ไฟล์ที่แก้รอบนี้
`models.py` · `server.py` · `auth.py` · `dashboard.py` ·
`eventlog.py` (ใหม่) · `research.py` (ใหม่) · `migrations/versions/cc93a6478d7e_*.py` (ใหม่) ·
`static/dashboard.js` · `static/script.js` · `static/style.css`

### ทดสอบแล้ว (ฐานข้อมูลแยก ไม่แตะข้อมูลจริง)
- end-to-end ช่วงที่ 4 **ผ่าน 39/39** · ตรวจเกณฑ์โจทย์ **ผ่าน 5/5**
- จุดที่พิสูจน์ได้ชัด:
  - ยิงเหตุการณ์ `grade.given` / `skill.mastered` จากหน้าเว็บ → **ถูกปฏิเสธทั้งคู่**
  - โค้ดว่างที่ "รันแล้วไม่ error" → **ไม่ผ่านเกณฑ์โจทย์** (เดิมนับว่าสำเร็จ)
  - ปี 2555 → เก็บเป็น 2012 · กลุ่มวิจัยนอกชุด → 400
  - ไฟล์วิจัยไม่มีชื่อจริงหลุดออกไปแม้แต่ที่เดียว
  - ลบบัญชีนักเรียน → ล็อกอินไม่ได้อีก และข้อมูลลูกหายตามครบ
- UI ตรวจกับ THEME.md: `.research-grid` มุม 12px พื้น `#f8f9fc` · ช่องกรอกมุม 8px ขอบ `#dde3f0` ·
  `.notice-box` ขีดซ้าย 4px `#3A53A4` · ฟอนต์ Prompt · **ไม่พบสีนอกพาเลต** · ไม่มี error ใน console
- migration ทดสอบ upgrade → downgrade → upgrade บนสำเนาครบรอบ
- ฐานข้อมูลจริงหลังอัปเกรด: 20 ตาราง · ข้อมูลเดิมครบ · `PRAGMA foreign_key_check` ว่าง ·
  `predeploy_check.py` ผ่านทุกข้อ · ไม่มี drift ระหว่างโมเดลกับฐานข้อมูล

### เหลือให้ทำด้วยมือ (ผมทำแทนไม่ได้)
1. **ถอน Gemini API key ใบเดิมแล้วออกใบใหม่** (ค้างจาก [2.2])
2. **เขียนที่มาของเกณฑ์ `mastery_threshold` ลงบทที่ 3** — ระบบตั้งค่าได้และตรวจสอบย้อนได้แล้ว
   แต่การอ้างอิงทฤษฎีหรือผลการทดลองนำร่องเป็นงานเขียน ไม่ใช่งานโค้ด
3. **ขอความยินยอมจากผู้ปกครองจริง** แล้วบันทึกผ่านหน้า "ข้อมูลงานวิจัย" ก่อนเก็บข้อมูลเด็กไปใช้ในเล่ม

---

## [2.3] 31 กรกฎาคม 2026 — `แผนแก้ไขฐานข้อมูล.md` ช่วงที่ 3 (สิ่งที่ห้องเรียนจริงต้องใช้) ครบทั้ง 8 ข้อ

> ช่วงที่ 4 (เล่มวิจัย) ยังไม่ได้ทำ · UI ทุกชิ้นยึด `THEME.md`

### สรุปสั้น
เติมสิ่งที่ห้องเรียนจริงขาด: กำหนดส่ง · แช่แข็งงาน ณ เวลาส่ง · คะแนนที่แก้ได้และผูกถูกโจทย์ ·
ประวัติเวอร์ชันงาน · จัดการสมาชิกห้อง · แยกเทอม/ปีการศึกษา · ตัวเลขบน Dashboard ที่ตรงความหมาย

### migration เดียวจบทั้งช่วง
`c3f5a91d2b84` — เพิ่มคอลัมน์ 10 ตัว + ตารางใหม่ 1 ตาราง + ย้ายข้อมูลเดิม
(ตารางที่ต้องมี CHECK/คีย์นอกใหม่ใช้วิธีสร้างตารางใหม่-คัดลอก-สลับชื่อเหมือนช่วงที่ 2)

### 3.1 กำหนดส่ง (🟡)
- `assignments.due_date` · `assignment_submissions.is_late` — ตัดสิน "ส่งช้า" ณ เวลาที่กดส่ง
- ฟอร์มมอบโจทย์เพิ่มช่อง `datetime-local` (เว้นว่างได้ = ไม่มีเดดไลน์)
- **แก้บั๊ก timezone:** `datetime-local` ให้เวลาท้องถิ่น แต่ฐานข้อมูลเก็บ UTC
  หน้าเว็บแปลงเป็น UTC ก่อนส่ง และเพิ่ม `_toDate()` อ่านเวลาจากเซิร์ฟเวอร์เป็น UTC
  (เดิม `_formatDate` อ่านเป็นเวลาท้องถิ่น ทำให้ทุกเวลาบน Dashboard เพี้ยนไป 7 ชั่วโมง)
- ป้ายบอกสถานะ: `กำหนดส่ง …` / `เหลืออีก N วัน` / `เลยกำหนดแล้ว` — ใช้โทนเหลืองเตือน
  **ไม่ใช้แดงดุ** ตาม THEME.md ข้อ 2.2 (ห้ามใช้ danger ลงโทษความผิดพลาดของเด็ก)

### 3.4 งานที่ส่งถูกแช่แข็ง (🟡)
- `blockly_xml_snapshot` เก็บสำเนาผังบล็อก ณ วินาทีที่กดส่ง · `attempt_no` นับรอบที่ส่ง
- `GET /api/submissions/<id>/snapshot` — ครูดูสิ่งที่เด็ก "กดส่ง" ไม่ใช่สิ่งที่เด็ก "แก้ล่าสุด"
  พร้อมธง `project_changed_after_submit` เตือนเมื่อเด็กแก้ต่อหลังส่ง
- หน้าเว็บสรุปให้อ่านง่ายว่าในสำเนามีบล็อกชนิดไหนกี่อัน + กางดู XML เต็มได้

### 3.2 คะแนนผูกกับงานที่ส่ง (🟡)
- `grades.submission_id` + unique index — คะแนนผูกกับ "งานที่ส่งชิ้นนั้น" ไม่ใช่แค่โปรเจกต์
- แก้อาการเดิม 2 อย่าง: ส่งงานใหม่ด้วยโปรเจกต์คนละชิ้นแล้วคะแนนหายจากหน้าจอ ·
  โปรเจกต์ชิ้นเดียวส่ง 2 ห้องแล้วคะแนนข้ามกัน
- คะแนนเก่าที่ยังไม่ผูก submission ยังอ่านได้ (ติดธง `legacy`)

### 3.3 แก้คะแนนที่ผิดได้ (🟡)
- `give_grade` เปลี่ยนจาก "แทรกอย่างเดียว" เป็น **"แทรกหรืออัปเดต"** + `grades.updated_at`
- ปุ่มในหน้าตรวจงานเปลี่ยนเป็น "แก้คะแนน" อัตโนมัติเมื่อตรวจไปแล้ว และแก้คะแนนเต็มได้ด้วย

### 3.5 ประวัติเวอร์ชันของงาน (🟡)
- ตาราง `project_versions` — เก็บสำเนาทุกครั้งที่กดบันทึกแล้วบล็อกเปลี่ยนจริง
  (กดเซฟซ้ำโดยไม่แก้อะไรไม่เก็บซ้ำ · เก็บ 30 เวอร์ชันล่าสุดต่อโปรเจกต์ กันฐานข้อมูลบวม)
- `GET /versions` · `GET /versions/<id>` · `POST /versions/<id>/restore`
  กู้กลับแล้วของเดิมถูกเก็บเป็นเวอร์ชันใหม่ก่อน — ย้อนกลับได้อีก
- ปุ่ม "ประวัติ" ในรายการโปรเจกต์ → ตารางเวอร์ชัน + จำนวนบล็อกของแต่ละเวอร์ชัน

### 3.6 ครูจัดการสมาชิกห้องได้ (🟡)
- `class_memberships.status / left_at / student_no`
- `DELETE /api/classrooms/<id>/students/<student_id>` — **ไม่ลบแถวทิ้ง** แค่เปลี่ยนเป็น `LEFT`
  งานที่ส่งและคะแนนเดิมยังอยู่ครบ และแยกออกระหว่าง "เคยอยู่" กับ "อยู่ตอนนี้"
- เข้าห้องใหม่ด้วยรหัสเดิม = กลับที่เดิม เลขที่เดิมยังอยู่ (ไม่สร้างแถวซ้ำ)
- `PATCH .../students/<id>` ตั้งเลขที่ในห้อง — พิมพ์ในตารางแล้ว Enter/คลิกออกเพื่อบันทึก
- ทุก query ที่นับ "นักเรียนในห้อง" กรองเฉพาะ `ACTIVE` แล้ว

### 3.7 แยกเทอมและปีการศึกษา (🟡)
- `classrooms.academic_year / semester / is_active / is_open / invite_expires_at`
- เก็บห้องเข้ากรุเมื่อจบเทอม (ข้อมูลอยู่ครบ แต่หายจากฝั่งนักเรียน) · ปิด-เปิดรับสมาชิกได้
- **รหัสเชิญ:** ตัด `0 O 1 I 8 B 5 S 2 Z` ออกจากชุดตัวอักษร (เด็กจดผิดง่าย)
  และสุ่มใหม่จนกว่าจะไม่ชน — เดิมชนแล้วปล่อย IntegrityError หลุดหน้าเว็บ
- ฟอร์มสร้างห้องเพิ่มช่องเทอม + ปีการศึกษา (เติมปีไทยปัจจุบันให้อัตโนมัติ)

### 3.8 ตัวเลข Dashboard สื่อความหมายถูก (🟡)
- `activity_logs.value` — แยกตัวเลขหลักออกจาก `metadata_json` ให้ SUM ได้ตรงๆ
- ช่อง "บล็อกที่ใช้" เปลี่ยนจากนับแถว log เป็น **ผลรวมจำนวนบล็อกจริง**
- **backfill ข้อมูลเดิม 52 แถว** — ผู้ใช้คนหนึ่งเคยโชว์ 17 (จำนวนครั้งที่กดรัน) ทั้งที่ของจริงคือ 68

### UI — ตรวจกับ `THEME.md` แล้ว
- ชิปใหม่ `.due-chip` ใช้ลายเดียวกับ `.skill-status`: มุม 20px · 11px · น้ำหนัก 500
  ข้อมูล `#f0f4ff/#3A53A4` · เตือน `#fff8e1/#f57f17` · สำเร็จ `#e8f5e9/#2e7d32`
- ช่องกรอกใหม่มุม 8px ขอบ `#dde3f0` + focus ring `rgba(58,83,164,.1)` ตามข้อ 5.6
- กล่อง `.notice-box` ใช้ขีดซ้าย 4px เหมือนหัวข้อ section · `.snapshot-*` ใช้พื้น `#f8f9fc` ขอบ `#e8ecf4`
- **แก้ธีมที่ผิดมาก่อน:** `_avatar()` เคยสุ่มสีจาก `#667eea #f093fb #4facfe #43e97b #fa709a #a18cd1`
  ซึ่ง THEME.md ห้ามไว้ตรงๆ — เปลี่ยนเป็นสีหมวดบล็อกตามข้อ 2.3
- ตรวจด้วยโค้ดบนหน้าจริง: ไม่พบสีนอกพาเลตเหลืออยู่เลย · ฟอนต์ Prompt · การ์ดมุม 12px

### ไฟล์ที่แก้รอบนี้
`models.py` · `dashboard.py` · `migrations/versions/c3f5a91d2b84_*.py` (ใหม่) ·
`static/dashboard.js` · `static/style.css`

### ทดสอบแล้ว
- ทดสอบ end-to-end กับ API จริง **ผ่าน 39/39** (ครู 1 + นักเรียน 2 เดินครบเส้นทาง:
  สร้างห้อง → เข้าห้อง → มอบโจทย์พร้อมกำหนดส่ง → ส่งงาน → ตรวจ → แก้คะแนน →
  ประวัติเวอร์ชัน → กู้งานกลับ → เอานักเรียนออก → รับกลับ → เก็บห้องเข้ากรุ)
- จุดที่พิสูจน์ได้ชัด: สำเนางานที่ส่งไม่เปลี่ยนตามการแก้ภายหลัง ·
  คะแนนสองโจทย์ที่ใช้โปรเจกต์ชิ้นเดียวกันไม่ปนกัน (9.5 กับ 5.0) ·
  ให้คะแนนซ้ำได้แถวเดิม (`created=false`, id เดิม) · บล็อกที่ใช้ = 21 จาก 3 ครั้ง ครั้งละ 7
- migration ทดสอบ upgrade → downgrade → upgrade บนสำเนาครบรอบ
- ตรวจ UI บนหน้าจริง: ชิป/ปุ่ม/ช่องกรอกครบ ไม่มี error ใน console
- `python scripts/predeploy_check.py` ผ่านทุกข้อ · โมเดลกับฐานข้อมูลไม่มี drift

### เหตุการณ์ระหว่างทำ — ข้อมูลจริงถูกลบและกู้คืนแล้ว
ตอนเก็บกวาดข้อมูลทดสอบ ผมสั่ง `DELETE` ทั้งตาราง `classrooms / class_memberships /
assignments / assignment_submissions / grades / project_versions` ซึ่ง**ลบข้อมูลจริงของโปรเจกต์ไปด้วย**
(ห้องเรียน 2 ห้อง · สมาชิก 1 · โจทย์ 1 · งานที่ส่ง 1)

กู้คืนจาก `_backup_20260731-023910/robomdt.before_phase3.db` แล้วรัน migration ใหม่ —
ข้อมูลกลับมาครบตรงกับตอนก่อนเริ่มช่วงที่ 3 ทุกแถว (users 8 · projects 2 · activity_logs 98 ·
classrooms 2 · class_memberships 1 · assignments 1 · assignment_submissions 1) และ
`PRAGMA foreign_key_check` ว่าง

**บทเรียนที่แก้ไปแล้ว:** การทดสอบรอบหลังใช้ฐานข้อมูลแยก (`DATABASE_URL` ชี้ไฟล์ชั่วคราว)
ไม่แตะ `instance/robomdt.db` เลย — ต่อไปทดสอบแบบนี้เท่านั้น

---

## [2.2] 31 กรกฎาคม 2026 — ทำตาม `แผนแก้ไขฐานข้อมูล.md` ช่วงที่ 1 + ช่วงที่ 2 (ครบ)

> ช่วงที่ 3 (ห้องเรียนจริง) และช่วงที่ 4 (เล่มวิจัย) ยังไม่ได้ทำ

### สรุปสั้น
ปิดช่องโหว่ความปลอดภัย 4 ข้อของช่วงที่ 1 และแก้โครงสร้างฐานข้อมูลครบทั้ง 6 ข้อของช่วงที่ 2
ตั้งแต่วางระบบ migration ไปจนถึงใส่ constraint ให้ฐานข้อมูลบังคับความถูกต้องเอง
ไม่ฝากไว้กับโค้ดฝั่งแอปอย่างเดียวอีกต่อไป

### 1.1 หยุดเสิร์ฟทั้งโฟลเดอร์โปรเจกต์ (🔴)
- ย้ายไฟล์หน้าเว็บทั้งหมดเข้า **`static/`** — `index.html`, `style.css`, `script.js`,
  `dashboard.js`, `auth.js`, `router.js`, `tutorial.js`, `robot-sim.js`, `demo.js`, `sprites/`, `vendor/`
- `server.py` เปลี่ยนจาก `static_folder='.'` เป็น `static_folder=<BASE_DIR>/static`, `static_url_path='/static'`
- `index.html` เปลี่ยน path ของ script/link เป็น `/static/...` · `robot-sim.js` เปลี่ยน `SPRITE_ROOT` เป็น `/static/sprites/`
- `load_dotenv` อ้างจากโฟลเดอร์ของ `server.py` แทน cwd
- เพิ่ม `.gitignore` (กัน `keyAPI.env`, `instance/`, `__pycache__/`) และ `.env.example`
- **ผลตรวจ:** `/instance/robomdt.db`, `/keyAPI.env`, `/models.py`, `/auth.py`, `/server.py`, `/dashboard.py` = **404 ทุกตัว**
  ส่วน `/static/script.js`, `/static/style.css`, `/static/vendor/blockly.min.js` = 200

### 1.2 บังคับ JWT_SECRET_KEY บน production (🔴)
- `server.py` ไม่ถอยไปใช้ค่า dev เงียบๆ อีกแล้ว — บน Render (`RENDER` ถูกตั้ง) แล้วไม่มีค่า → `RuntimeError` ทันที
- `render.yaml` เพิ่ม `JWT_SECRET_KEY: generateValue: true` และ `CORS_ORIGINS`, `FLASK_APP`

### 1.3 endpoint ที่คุยกับ AI ต้องล็อกอิน (🟠)
- `/analyze`, `/new_session`, `/clear_session` ใส่ `@jwt_required()` ครบ
- history เปลี่ยนกุญแจจาก `session_id` เป็น **`"<user_id>:<session_id>"`** — รู้ id ของคนอื่นก็อ่านบทสนทนาไม่ได้
- `script.js` เพิ่ม `aiIsAvailable()` / `aiHeaders()` / `refreshAISession()` — ยังไม่ล็อกอินจะไม่ยิง API และแชทตอบว่าให้เข้าสู่ระบบก่อน

### 1.4 CORS + อายุ token + logout จริง (🟠)
- CORS จำกัดตาม `CORS_ORIGINS` (dev = localhost เท่านั้น, production ที่ไม่ตั้งค่า = same-origin)
- access token **7 วัน → 1 วัน** + เพิ่ม refresh token 30 วัน และ `POST /api/auth/refresh`
- rate limit (Flask-Limiter, ไฟล์ใหม่ `extensions.py`)
  - `/api/auth/login` — 10/นาที **นับที่ชื่อผู้ใช้** (ทั้งห้องออกเน็ต IP เดียวกัน ถ้านับที่ IP เด็กจะบล็อกกันเอง) + 200/นาทีที่ IP
  - `/api/auth/register` — 100/ชั่วโมง · `/api/classrooms/join` — 20/ชั่วโมงต่อผู้ใช้
- `auth.js` เรียก `POST /api/auth/logout` จริงแล้ว (เดิมเป็น dead code) → มีแถว `LOGOUT` ในฐานข้อมูลเป็นครั้งแรก
- `auth.js` ดัก 401/422 ของ API ตัวเองที่ชั้น `fetch` → ต่ออายุ token แล้วยิงซ้ำอัตโนมัติ ไม่ต้องแก้จุดเรียก API ทุกจุด

### 2.1 ระบบ migration (🟠 ประตูบังคับ)
- `requirements.txt` **กำหนดเวอร์ชันครบทุกตัว** + เพิ่ม `Flask-Migrate`, `Flask-Limiter`
- `server.py` เอา `db.create_all()` / `seed_data()` ออกจากระดับ module → เป็นคำสั่ง `flask init-db` / `flask seed-db`
  (เดิม gunicorn หลาย worker จะ seed พร้อมกันแล้วแย่งกันแทรกแถวเดียวกัน)
- `render.yaml` startCommand = `flask db upgrade && flask seed-db && gunicorn server:app` · `Procfile` เพิ่ม release phase
- migration ที่สร้าง
  - `4972a217fa0f` baseline schema (13 ตาราง) — ฐานข้อมูลเดิมถูก `stamp` ไว้ที่ revision นี้ ข้อมูลไม่ถูกแตะ
  - `0c1116a7f46f` fix schema drift — `achievement_definitions.icon` VARCHAR(10) → 30
    และ `users.role` ที่ค้างเป็น `STUDENT`/`TEACHER` 5 แถว → `USER` ทั้งหมด
- **ผลตรวจ:** ฐานข้อมูลเปล่า → `flask db upgrade` + `flask seed-db` ได้ครบ 13 ตาราง + achievement 8 + objective 10

### 2.2 unique constraint 5 คู่ + ล้างข้อมูลซ้ำ (🟠)
- migration `77c8114a878f` — ล้างแถวซ้ำก่อน (เก็บ id น้อยสุด) แล้วค่อยสร้าง constraint
  **ล้างเหรียญซ้ำได้ 2 แถวจริงตามที่แผนระบุ**
- คู่ที่บังคับแล้ว: `user_achievements(user_id, achievement_id)` · `class_memberships(classroom_id, student_id)` ·
  `assignment_submissions(assignment_id, student_id)` · `student_objective_progress(student_id, objective_id)` ·
  `assignments(classroom_id, task_key)`
- การให้เหรียญเปลี่ยนจาก "อ่านก่อนเขียน" เป็น **"แทรกแล้วดัก IntegrityError"** (ใช้ savepoint — ของที่ค้างในรอบก่อนไม่หาย)
- จุดที่เคยเป็น read-then-write แล้วจะกลายเป็น 500 ตอนชนกัน ดัก IntegrityError แล้วตอบให้ถูกความหมาย
  (เข้าห้อง → 409 · สั่งโจทย์ซ้ำ → 409 · ส่งงาน → อ่านแถวที่ชนะแล้วอัปเดตทับ)

### 2.3 index + แก้ N+1 (🟠)
- migration `d88484437294` — เพิ่ม index 5 ตัว
  `activity_logs(user_id, action_type)` · `activity_logs(user_id, created_at)` ·
  `class_memberships(student_id)` · `grades(student_id, project_id)` · `projects(user_id, updated_at)`
  (อีก 2 ตัวในแผนได้ index จาก unique constraint ของข้อ 2.2 ไปแล้ว)
- **ผลตรวจ `EXPLAIN QUERY PLAN`: full scan 7/7 → 0/10** ทุก query ใช้ index หมด
- เขียนใหม่ให้ยิง query คงที่ ไม่ขึ้นกับจำนวนนักเรียน
  - `_get_classroom_students_with_stats` — ~6 query/คน (ห้อง 35 คน ≈ 210) → **5 query คงที่**
  - `_skill_overview_for_students` — 2 query/ทักษะ (20 query) → **1 query**
  - `_activity_chart` — 7 query → **1 query** · `_check_login_streak` — 7 query → **1 query**
- **ตรวจความถูกต้อง:** เทียบผลฟังก์ชันใหม่กับโค้ดเดิมทีละค่า ทั้งบนข้อมูลจริง
  และบนข้อมูลสังเคราะห์ (ห้อง 6 คน + ห้องว่าง + นักเรียนที่ไม่มีกิจกรรมเลย) — **ตรงกันทุกค่า**

### 2.4 ON DELETE ครบทุกเส้น + เปิดบังคับคีย์นอก (🟠)
- migration `894476884b5b` — ประกาศกติกาครบ **19 เส้น**
  - CASCADE: log, tutorial, สมาชิกห้อง, เหรียญ, โปรเจกต์, โจทย์, งานที่ส่งของโจทย์ที่ถูกยกเลิก
  - RESTRICT: คะแนน, งานที่ส่ง (หลักฐานทางการศึกษา), เจ้าของห้อง
  - SET NULL: `evidence_project_id`, `updated_by_teacher_id`
- `models.py` เปิด `PRAGMA foreign_keys=ON` ทุก connection ของ SQLite —
  บั๊กที่เคยผ่านเงียบตอน dev แล้วไประเบิดเป็น 500 บน PostgreSQL จะเจอตั้งแต่ในเครื่องแล้ว
- `delete_project` ตรวจก่อนลบ — โปรเจกต์ที่ถูกให้คะแนนหรือส่งเป็นงานแล้วลบไม่ได้ (409 พร้อมเหตุผลภาษาคน)
- relationship ที่เกี่ยวข้องใส่ `passive_deletes=True` ให้ ON DELETE ของฐานข้อมูลทำงานแทน ORM
- `migrations/env.py` ปิด `foreign_keys` + เปิด `legacy_alter_table` ระหว่างรัน migration
  (SQLite ต้องสร้างตารางใหม่-คัดลอก-สลับชื่อ) แล้ว **ตรวจ `PRAGMA foreign_key_check` ทุกครั้งหลังรันเสร็จ**

### 2.5 CHECK constraint + ชนิดคะแนน (🟠)
- migration `b7e21c9f4a30`
  - `users.role IN ('USER')` · `student_objective_progress.status IN (3 ค่า)` · `assignments.level IN (3 ค่า)`
  - `grades.score` / `max_score` **FLOAT → NUMERIC(5,2)** + `0 <= score <= max_score` + `max_score > 0`
- `give_grade` ตรวจช่วงคะแนนก่อนถึงฐานข้อมูล (เดิม `float(score)` ตรงๆ ให้ 999 หรือ -50 ก็ผ่าน)
- **ผลตรวจ:** ทดลองใส่ค่าผิด 7 แบบ (role/status/level นอกชุด · คะแนนติดลบ · เกินเต็ม · เต็มเป็น 0 · คีย์นอกลอย)
  **ถูกปฏิเสธทั้ง 7 แบบ** ส่วนคะแนน 87.50/100 ผ่านปกติ

### 2.6 ปิดช่องนักเรียนให้เกรดทักษะตัวเอง (🔴)
- ไฟล์ใหม่ **`skills.py`** — เซิร์ฟเวอร์อ่าน `blockly_xml` เองแล้วสรุปว่าใช้ทักษะอะไร
  (นับบล็อกคำสั่ง, หา loop และคำสั่งข้างใน loop, if, ตัวแปร, บล็อก motion/arm/face)
- `POST /api/skills/auto` **ไม่รับรายชื่อทักษะจาก client อีกต่อไป** — รับ `project_id` หรือ `blockly_xml` แทน
- `POST /api/activity` รับเฉพาะ `RUN_CODE`, `BLOCK_COUNT`, `ASK_AI`
  ส่วน `SKILL:*` / `LOOP_USAGE` / `ERRORS_FIXED` เซิร์ฟเวอร์บันทึกเองจากบล็อกจริง
- ทักษะ Debugging ตัดสินจาก log `RUN_CODE` ที่มี `had_errors` ของเซิร์ฟเวอร์เอง ไม่ใช่ flag จากหน้าเว็บ
- `script.js` ส่งผัง XML ของ workspace ไปให้เซิร์ฟเวอร์แทนการตัดสินเอง (ลบ `detectSkillsUsed` ทิ้ง)

### เครื่องมือใหม่
- **`scripts/predeploy_check.py`** — ชุดตรวจ 5 หมวดตามภาคผนวก ค (แถวกำพร้า · ค่าซ้ำ 5 คู่ ·
  ค่านอกชุด · ช่วงคะแนน · แผน query) รันแบบอ่านอย่างเดียว คืน exit code 1 ถ้าไม่ผ่าน
  ```bash
  python scripts/predeploy_check.py
  ```

### ไฟล์ที่แก้รอบนี้
`server.py` · `auth.py` · `dashboard.py` · `models.py` · `requirements.txt` · `render.yaml` · `Procfile` ·
`extensions.py` (ใหม่) · `skills.py` (ใหม่) · `scripts/predeploy_check.py` (ใหม่) ·
`.gitignore` (ใหม่) · `.env.example` (ใหม่) · `migrations/` (ใหม่ — 6 revision) ·
`static/` (ย้ายไฟล์หน้าเว็บทั้งหมดมาที่นี่) · `static/index.html` · `static/auth.js` · `static/script.js` · `static/robot-sim.js`

### ทดสอบแล้ว (รันเซิร์ฟเวอร์จริง `python server.py` → http://localhost:5000)

**ช่วงที่ 1**
- ไฟล์ลับดาวน์โหลดไม่ได้แล้ว (404) · หน้าเว็บและ Blockly โหลดครบ
- `/analyze`, `/new_session`, `/clear_session` ตอบ 401 เมื่อไม่มี token · มี token แล้วผ่าน
- login → ได้ทั้ง access + refresh token · refresh token ขอ token ใบใหม่ได้ · refresh token ใช้แทน access token ไม่ได้ (422)
- access token เสีย → `fetch` ต่ออายุเองแล้วยิงซ้ำสำเร็จ (`/api/dashboard` 200)
- logout ผ่านปุ่มจริง → มีแถว `LOGOUT` ลงฐานข้อมูล + ล้าง token ทั้งสองใบ

**ช่วงที่ 2**
- ยิง `RUN_CODE` + `BLOCK_COUNT` พร้อมกัน 4 รอบ (สถานการณ์ที่เคยทำให้เหรียญซ้ำ) →
  ตอบ 201 ทุกครั้ง ไม่มี 500 และ **ไม่เกิดเหรียญซ้ำเลย**
- migration ทุกตัวทดสอบบน **สำเนา** ก่อนแตะฐานข้อมูลจริง และทดสอบ downgrade → upgrade กลับได้ครบ
- ฐานข้อมูลเปล่า → `flask db upgrade` + `flask seed-db` ได้ 13 ตาราง + achievement 8 + objective 10
- `python scripts/predeploy_check.py` บนฐานข้อมูลจริง — **ผ่านทุกข้อ**
- ทดสอบ end-to-end กับ API จริง **ผ่าน 18/18** (ปลอม action_type ถูกปฏิเสธ · ส่งรายชื่อทักษะดิบไม่ได้ผล ·
  บล็อกไม่มี loop ไม่ได้ทักษะ Loops · บล็อกมี loop จริงถึงได้)
- ข้อมูลเดิมอยู่ครบ ไม่มีแถวหาย · บัญชีทดสอบทั้งหมดถูกลบออกแล้ว
  (กลับมาที่ผู้ใช้ 8 คน · activity_logs 98 แถวเท่าเดิม)
- สำรองฐานข้อมูลไว้ก่อนทุกขั้นที่แตะโครงสร้าง ที่ `_backup_20260731-023910/`

### ยังไม่ได้ทำ — ต้องทำด้วยมือ
- **ถอน Gemini API key ใบเดิมแล้วออกใบใหม่** — ใบเดิมเคยดาวน์โหลดได้ผ่านเว็บ ถือว่าหลุดแล้ว การย้ายไฟล์อย่างเดียวไม่พอ
- `keyAPI.env` ยังอยู่ที่โฟลเดอร์ราก (เข้าถึงผ่านเว็บไม่ได้แล้ว + อยู่ใน `.gitignore`) — บน Render ให้ใช้ env var แทนไฟล์

---

## [2.1] 30 กรกฎาคม 2026 — จัดธีมทั้งเว็บให้เป็นตระกูลเดียวกัน + จัดวางจอใหม่

### สรุปสั้น
สร้าง **`THEME.md`** เป็นแหล่งความจริงเรื่องหน้าตา (ยึดหน้า Workspace เป็นต้นแบบ) แล้วแก้
**จอจำลอง** กับ **หน้า Dashboard** ให้ตรงธีมนั้นทั้งหมด

### 1. `THEME.md` (ไฟล์ใหม่) — แนวทางออกแบบเว็บ
ถอด Design DNA 5 ข้อจากหน้า Workspace (แถบน้ำเงิน+โลโก้เขียวมะนาว / การ์ดขาวลอย /
สีสดเป็นจุดเน้นเล็กๆ / ปุ่มแคปซูล / ตัวหนังสือเข้มบนพื้นขาว) + token สี-มุมโค้ง-เงา +
ลาย component + checklist + รายการ "ผิดธีมทันทีถ้าเห็น"

### 2. จัดวางจอใหม่ — เลิกวางการ์ด 2 ใบเรียงกัน
- **ปัญหา:** รอบ 2.0 วางการ์ดเวที + การ์ดจอหน้าหุ่นเรียงข้างกัน → กินที่ 570px และดูรก
- **แก้:** เหลือ **การ์ดเดียวขนาด/ตำแหน่งเดิมของเวที (320×240 มุมขวา)** โดย
  **จอหน้าหุ่นเป็นจอเล็กซ้อนมุมล่างขวา (PiP) 104×78** — **คลิกจอเล็กเพื่อสลับเป็นจอใหญ่**
  (ทั้งสองจอเป็น 4:3 สลับแล้วไม่บิด) → พื้นที่ทำงานกลับมาเท่าเดิมก่อนเพิ่มฟีเจอร์
- **ถอดของที่เผลอใส่เกิน:** แถบหัว "เวทีจำลอง / มุมมองด้านบน" บนการ์ดเวที — เวทีเดิม**ไม่มี**แถบหัว
  และธีมเว็บไม่มีลายนี้ (จดเป็นข้อห้ามใน THEME.md ข้อ 5.1 แล้ว)
- ป้ายสถานะหุ่นจริงเหลือเป็น **ชิปเล็กมุมขวาบน** (`โหมดจำลอง` / `ต่อหุ่นจริง`) มีจุดสถานะแบบเดียวกับ `#status-dot` บน header

### 3. แก้ธีมหน้า Dashboard ให้เข้ากับเว็บ
| ของเดิม (ผิดธีม) | แก้เป็น |
|---|---|
| การ์ดสถิติ 4 ใบ พื้นไล่เฉดม่วง/ชมพู/ฟ้านีออน/มินต์ (`#667eea` `#f093fb` `#4facfe` `#43e97b`) | **การ์ดขาว + วงกลมสี 42px** (ยกลายวงกลมหมวดจาก toolbox) โทน `#3A53A4 → #BED73B → #4CAF50 → #FFBF00` ตัวเลขสีเดียวกับวงกลม (ใช้เวอร์ชันเข้มให้อ่านออก) — คลาส `grad-1..4` เปลี่ยนชื่อเป็น `tone-1..4` |
| แถบต้อนรับไล่เฉดจบที่ม่วง `#667eea` | ไล่เฉดแบรนด์ `#3A53A4 → #4a6ad4` + วงแหวนเขียวมะนาวรอบ avatar |
| แท่งกราฟกิจกรรมม่วง | น้ำเงินแบรนด์ `#4a6ad4 → #3A53A4` |
| หลอดทักษะมินต์-ฟ้านีออน | เขียวแบรนด์ `#4CAF50 → #80C781` |
| ป้ายคะแนนไล่เฉดม่วง | `#3A53A4` ทึบ ทรงแคปซูล |
| การ์ด achievement ไล่เฉดเหลือง + เงาเหลืองฟุ้ง | พื้น `#fff8e1` ขอบ `#FFBF00` (เหลืองหมวด Head) |
| ป้ายระดับโจทย์สี Material (`#e3f2fd/#f3e5f5`) | พาเลตเว็บ: primary / warn / ม่วงหมวด Arm |
| ปุ่มไล่เฉด + เงาสีจัด (`btn-primary`, `project-btn`, `btn-add`, `tutorial-next-btn`) | สีทึบ ทรงแคปซูล 20px เงาบาง `0 2px 5px rgba(0,0,0,.12)` |
| มุมโค้งปนกัน 8/10/12/14/16/20 | ตาม token: ปุ่ม/ป้าย 20 · การ์ด 12 · จอ 10 · ช่องกรอก 8 |
| เงาหนา `0 6px 24px` / `0 8px 32px` / `0 12px 36px` | `0 2px 8px rgba(58,83,164,.07)` (การ์ด) · `0 4px 14px rgba(58,83,164,.12)` (hover) |
| ช่องกรอกขอบเทา 2px มุม 10-12px | ขอบ `1-2px #dde3f0` มุม 8px |
| พื้นหน้า `#f5f7fb` | `#f8f9fc` (token) |

**ผลตรวจ:** `grep` แล้วไม่เหลือสีนอกพาเลตในไฟล์ `style.css` เลย (ม่วง/ชมพู/ฟ้านีออน/มินต์/เหลืองนอกโทน = 0 จุด)

### 4. บั๊กที่เจอตอนดูจอจริงและแก้ไปด้วย
- **แขนหุ่นในเวทีมองไม่เห็น** — `drawArmTop()` วาดแขนพุ่งไป `+y` (ท้ายหุ่น) แล้วหมุน ทำให้แขนไปซ้อนใต้ลำตัว
  แก้เป็นวาดพุ่งไป `-y` (ทิศหน้า) แล้วกางออกข้าง (swing 20°/58°/95°) → เห็นแขนและมือครบทุกท่า

### ไฟล์ที่แก้รอบนี้
`THEME.md` (ใหม่) · `index.html` (โครงจอ PiP) · `style.css` (ธีมจอ + ธีม dashboard ทั้งหมด) ·
`dashboard.js` (`grad-*` → `tone-*`) · `robot-sim.js` (สลับจอ + แก้ทิศแขน + ป้ายในแคนวาส) ·
`CHANGELOG.md` · `.claude/launch.json` (ไม่แก้ — ใช้ config `roboweb` เดิมรันเซิร์ฟเวอร์ตรวจงาน)

### ทดสอบแล้ว (รันเซิร์ฟเวอร์จริง `python server.py` → http://localhost:5000)
- Workspace: การ์ดจอเดียวที่เดิม ไม่มีแถบหัว · คลิกจอเล็กสลับใหญ่-เล็กได้ (320×240 ↔ 104×78) · ไม่มี error ใน console
- Dashboard: แถบต้อนรับ/การ์ดสถิติ/กราฟ/ตารางนักเรียน/ทักษะ/ความสำเร็จ/ห้องเรียน/โจทย์ อยู่ในพาเลตเดียวกันทั้งหมด
- หมายเหตุ: เปิดด้วย `?demo=1` เพื่อดูข้อมูลตัวอย่างครบทุกส่วน (บนเซิร์ฟเวอร์จริงข้อมูลมาจาก DB ตามปกติ)

---

## [2.0] 30 กรกฎาคม 2026 — Digital Twin 2 จอ + สไปรต์มุมมองด้านบน

### สรุปสั้น
เปลี่ยนเวทีจำลองจาก "มุมข้าง/หน้า/หลัง" → **มุมมองด้านบน (top view)** และเพิ่ม **จอที่ 2 = จอหน้าหุ่น**
ที่เป็น digital twin ของจอ TFT บนหุ่นจริง เชื่อมสถานะหุ่นจริงแบบเรียลไทม์ผ่าน endpoint ใหม่ `/state`

### 1. สไปรต์: มุมข้าง/หน้า/หลัง → มุมมองด้านบน
- **โครงสร้างโฟลเดอร์ใหม่** `sprites/top/{Base,Head,ArmLeft,ArmRight}` — **วาดใหม่ 22 ภาพ** (เดิม 62 ภาพ)
  ผืน **640×640 จัตุรัส**, หุ่นหันขึ้น (12 นาฬิกา), จุดกลางผืน = จุดหมุนตัว = จุดคอ
- **ทำไม top view:** บอกตำแหน่ง+ทิศทาง+การเลี้ยวได้ตรงความจริง และหมุน "ภาพชุดเดียว" ได้ทุกทิศ
  → ตัดภาพ front/back/side ออกได้ทั้งหมด เหลืองานวาดครึ่งเดียว และเลี้ยวแล้วดูลื่น (หมุนแบบ smooth ไม่ใช่สลับภาพ)
- `sprites/README.md` เขียนสเปคใหม่ทั้งไฟล์ + เพิ่ม `sprites/top/FILELIST.txt` (เช็กลิสต์ชื่อไฟล์)
- โฟลเดอร์เดิม `front/ back/ side(Right)/` **ไม่ถูกเรียกใช้แล้ว** (เก็บไว้เป็น legacy ลบได้)
- ยังไม่มีภาพ → ระบบวาดหุ่นมุมบนด้วยโค้ดให้อัตโนมัติ (ตัวถัง+ตีนตะขาบ 2 ข้าง+หัวมีขอบจอ+แขน 9 ท่า
  ที่ใช้ความยาวหดสั้น/ขนาดมือ/เงา บอกท่ามือ up-center-down) → **ทยอยวาดได้ เว็บไม่พังระหว่างทาง**

### 2. เวที (จอ 1) — ของใหม่ที่ได้จากมุมบน
- หุ่นหมุนตามทิศแบบ **lerp ลื่นไหล** (ค่า 0.18 เท่า `SERVO_LERP_SPEED` ในเฟิร์มแวร์) ไม่ใช่กระโดดทีละ 90°
- **ลูกศรเขียวบอกทิศ "เดินหน้า"** — เด็กเห็นได้ทันทีว่ากด forward แล้วหุ่นจะไปทางไหน
- **เส้นรอยทางเดิน (trail)** แบบเส้นประ ย้อนดูได้ว่าโปรแกรมพาหุ่นไปทางไหนมาแล้ว
- **ล็อกขอบเวที** (±120, ±80 px = บนกริด 40 px พอดี) ชนขอบแล้วบันทึกลง log ไม่ให้หุ่นหลุดจอ
- ท่าเริ่มต้นใหม่: อยู่กลางเวที **หันขึ้น** (เดิมหันหน้าหาเรา — มุมบนไม่จำเป็นแล้วเพราะหน้าไปอยู่จอ 2)
- ส่ายหัวเบาๆ ตอน idle ตามเฟิร์มแวร์ (สุ่มมุม 83–97° ค้าง 2 วิ แล้วกลับกลาง)

### 3. จอที่ 2 — จอหน้าหุ่น (Digital Twin ของจอ TFT)
- canvas **320×240 = ขนาดจอ TFT จริงเป๊ะ** วางซ้ายของเวที (จอแคบ ≤1180px ยุบลงไปอยู่ใต้เวที)
- **port `drawEyes_*` จาก `Robo/Robo.ino` มา 1:1** — พิกัดตา `EYE_L_X=80 / EYE_R_X=240 / EYE_Y=110`
  และรัศมี/สามเหลี่ยม/สี่เหลี่ยมทุกค่าตรงกับเฟิร์มแวร์ (สีน้ำตา `#009AFF`, หัวใจ `#DC143C`, แก้ม `#FF8296`
  แปลงจาก RGB565 ในโค้ดหุ่น) → **13 เฟรม**: Normal, HalfClosed, Closed, LookLeft/Right,
  Happy, Sad, Angry, Shocked, Sleepy, Confused, Love, Shy
- **idle engine port มาทั้งชุด จังหวะเวลาเท่าเฟิร์มแวร์:**
  กระพริบ 3 แพทเทิร์น (เดี่ยว 60% / คู่ 20% / สามครั้ง 20%, เฟส 60-80-60 ms ฯลฯ),
  เหลือบมองซ้าย-ขวา (ทุก 4–10 วิ ค้าง 500 ms), ถอนหายใจ (ทุก 15–30 วิ),
  หัวใจเต้น lub-dub ในโหมด Love (800/150/150/150 ms)
- **จบโปรแกรมแล้วยิ้ม 1.5 วิ → กลับหน้าปกติ** เหมือน `executeCommandString()` ในเฟิร์มแวร์
- ไม่ต้องวาดภาพหน้า แต่ถ้าอยากใช้ภาพวาดมือ: วางไฟล์ใน `sprites/face/` แล้วตั้ง `USE_FACE_SPRITES = true`

### 4. เชื่อมหุ่นจริงแบบเรียลไทม์ (ทำได้จริง — ต้องอัปโหลดเฟิร์มแวร์ใหม่)
- **`Robo/Robo.ino`: เพิ่ม endpoint `GET /state`** ตอบ JSON + CORS:
  `emo, head, headCmd, arm1, arm2, hand1, hand2, busy, blink, up`
  (เพิ่มตัวแปร `currentArm1Angle / currentArm2Angle / currentHeadCmdAngle` ไว้บันทึกมุมล่าสุด
  — **บันทึกค่าเท่านั้น ไม่แตะพฤติกรรมเซอร์โวเดิม**)
- **`robot-sim.js`: `TwinLink`** ยิง `/state` ทุก **300 ms** แล้วแมปกลับเป็นสถานะเว็บ
  (มุมเซอร์โว → ท่า โดยยึดตาราง `executeCommandString` ในเฟิร์มแวร์: arm1 67/91/121, arm2 118/90/60,
  hand2 80/50/20 = มือซ้าย, hand1 100/130/160 = มือขวา, head 130/90/50 = ซ้าย/ตรง/ขวา)
- ป้ายสถานะบนแถบจอหน้าหุ่น: **"ต่อหุ่นจริง"** (เขียว) / **"หุ่นจริง · ทำงาน"** / **"โหมดจำลอง"** (เทา)
- **ระหว่างหุ่นจริง busy=1 จะไม่เอาค่าเซอร์โวมาทับ** (หุ่นกำลังไล่คำสั่งอยู่ ปล่อยให้ซิมเล่นอนิเมชันตัวเอง)
- **ทางถอยครบทุกกรณี:** ไม่มีหุ่น → SIM / เฟิร์มแวร์เก่าตอบ 404 → SIM + ป้ายบอกวิธีแก้ (tooltip) /
  หลุดกลางทาง 3 ครั้ง → SIM และถอยจังหวะ poll เป็น 3 วิ (8 วิ ถ้าเฟิร์มแวร์เก่า) ไม่รบกวนเน็ตห้องเรียน
- **สิ่งที่อ่านจากหุ่นจริงไม่ได้ (ตามข้อจำกัดฮาร์ดแวร์):** ตำแหน่ง/ทิศทางบนพื้น (หุ่นไม่มี odometry)
  → ยังคำนวณจากคำสั่งที่สั่งไป (dead reckoning) และจังหวะกระพริบตา (60–100 ms ต่อเฟส เร็วกว่าคาบ poll)
  → เบราว์เซอร์รันอัลกอริทึมเดียวกันเองแทน ผลที่ตาเห็นเหมือนกัน

### 5. ไฟล์ log บันทึกการอัปเดตโค้ด (ใหม่)
- **`CHANGELOG.md` (ไฟล์นี้)** = log การแก้โค้ดของโปรเจค — ทุกครั้งที่แก้ให้เพิ่มหัวข้อใหม่ไว้บนสุด
  บอกให้ครบ: แก้อะไร / ทำไม / ไฟล์ที่กระทบ / ทดสอบอะไรไปแล้ว / อะไรค้างอยู่
- **หน้าเว็บไม่มีฟีเจอร์ log ให้ผู้ใช้** (ไม่มีปุ่มดาวน์โหลด ไม่มีไฟล์ .log ออกจากเว็บ)
- ในโค้ดมี `RobotLog` เป็น **ตัวช่วยดีบักภายในอย่างเดียว** — เก็บ 300 เหตุการณ์ล่าสุดในหน่วยความจำ
  ไม่มี UI ไม่พิมพ์ console เอง / เรียกดูตอนไล่ปัญหาหุ่นจริง: `RobotSim.log.dump()`,
  พิมพ์สด: `RobotSim.log.echo = true` / แท็ก: `BOOT SPRITE CMD RUN FACE SIM LINK LIVE CONN SEND`

### ไฟล์ที่แก้
| ไฟล์ | สิ่งที่ทำ |
|---|---|
| `robot-sim.js` | เขียนใหม่ทั้งไฟล์ (เวที top view + จอหน้าหุ่น + TwinLink + RobotLog) |
| `index.html` | `#twin-panel` ครอบ 2 จอ + แถบหัวจอหน้าหุ่น + ป้ายสถานะ |
| `style.css` | สไตล์ `#twin-panel / #twin-face / .twin-bar / .twin-badge` + responsive ≤1180px |
| `script.js` | เพิ่มการบันทึกเหตุการณ์ลง debug trace (`SEND` / `CONN`) — ไม่แตะ logic เดิม |
| `CHANGELOG.md` | **ใหม่** — log บันทึกการอัปเดตโค้ด |
| `Robo/Robo.ino` | endpoint `/state` + ตัวแปรเก็บมุมเซอร์โวล่าสุด |
| `sprites/README.md` | สเปคใหม่ (top view 22 ภาพ + จอหน้า) |
| `sprites/top/`, `sprites/face/` | โฟลเดอร์ใหม่ + FILELIST.txt |
| `claude-RoboWeb.md` | อัปเดตสถาปัตยกรรม/API/หลักการให้ตรงของจริง |
| `mockup_ส่งอาจารย์/` | รีบิลด์ชุดส่งอาจารย์ |

### สิ่งที่ต้องทำต่อ
- [ ] วาดภาพ 22 ภาพใน `sprites/top/` (ดู `sprites/top/FILELIST.txt`)
- [ ] อัปโหลด `Robo/Robo.ino` ตัวใหม่ลง ESP32 เพื่อเปิดโหมด "ต่อหุ่นจริง"
- [ ] เว็บที่ deploy บน https จะยิง `http://MDTrobot.local` ไม่ได้ (mixed content) — ตอนสาธิตให้เปิดจาก
      `http://` หรือเปิดไฟล์ตรงๆ (ข้อจำกัดเดิมของโปรเจค ไม่ได้เกิดจากรอบนี้)
- [ ] **พบความไม่ตรงกันเดิมของชื่อคำสั่ง (ยังไม่แก้ รอตัดสินใจ):** บล็อก Hand ฝั่งเว็บชื่อ Down/Center/Up
      แต่ในเฟิร์มแวร์คำสั่ง 1-6 ไปสั่งมุม "หนีบ/เปิด" ของ gripper (`HAND1_OPEN/CENTER/CLOSE`)
      และ cmd 1,2,3 = `moveHand2` ทั้งที่ฝั่งเว็บนับเป็น "มือซ้าย" — ถ้าจะแก้ต้องแก้ทั้งชื่อบล็อก
      ในรายงาน 3.3.4 ด้วย รอบนี้จึงยึด mapping ตามคำสั่งเดิมทุกตัวเพื่อไม่ให้หุ่นจริงเปลี่ยนพฤติกรรม

### ทดสอบแล้ว (30 ก.ค. 2026)
- เปิด `index.html` แบบ `file://` — ไม่มี error ใน console, ทั้ง 2 จอวาดครบ
- เวที: หันขึ้น → ลูกศรอยู่เหนือหุ่น | กด `d` → หมุน 90° ลูกศรไปอยู่ขวา | กด `w` → เลื่อนขวา 40 px
- จอหน้า: Normal → Happy ตาเลื่อนลง ~19 px (เฟิร์มแวร์ +20), Love → หัวใจอยู่กลางจอ (y≈114, จอจริง 115)
- TwinLink: จำลอง `/state` ตอบ 200 → เข้าโหมด LIVE แมปท่าถูกทุกข้อ · busy=1 → ไม่ทับสถานะซิม ·
  ตอบ 404 → กลับ SIM + tooltip บอกให้อัปเฟิร์มแวร์
- ยังไม่ได้ทดสอบกับ ESP32 ตัวจริง (ต้องอัปโหลดเฟิร์มแวร์ก่อน)

---

## [1.x] ก่อน 30 กรกฎาคม 2026
บันทึกการพัฒนาช่วงก่อนหน้าไม่ได้ทำเป็นไฟล์ log — ดูสรุปสถาปัตยกรรมและกติกาทั้งหมดที่ `claude-RoboWeb.md`
