HoneyKung/metorobot/RoboPCA9685/meto_emotes.h

// =====================================================================
// meto_emotes.h — ท่าทางทั้งหมดของหุ่น (#496 #501 #516, 8 พ.ย.)
// คาแรกเตอร์: หุ่นขี้อายนิด ๆ — ทุกอารมณ์ยังชัด แต่มีหลบตา/หันหนีนิด/ยกแขนมาใกล้หน้า/หน้าเขินแวบ ๆ
// =====================================================================
// แต่ละแถว = 1 จังหวะ: ทุกแกนในแถวเริ่มขยับพร้อมกัน (หัว + แขนยก + แขนกาง/หนีบ ทั้งสองข้าง) + เปลี่ยนหน้า (ถ้ามี)
//   ไม่รอให้แกนไหนถึงเป้าก่อน · ms = เวลาจากจังหวะนี้ถึงจังหวะถัดไป (0 = จังหวะสุดท้าย)
// หน่วย: yaw หันหัว ° (+ = ซ้ายของหุ่น) · tilt ก้มเงย ° (+ = เงย)
//        liftL/liftR ยกแขน ° (+ = ยกขึ้น, 0 = แนวนอน) · handL/handR แขนกาง/หนีบ % (0 = กางออกสุด, 100 = หนีบเข้าสุด)
//   EK = ไม่แตะแกนนี้ · ER = คืนท่าพัก R (แขนยก = REST_LIFT แขนลง · แขนกาง/หนีบ = กลาง)
//   face (ไม่ใส่ = คงหน้าเดิม): อารมณ์ N H S A O Z C V B · 'L' เหลือบซ้าย · 'R' เหลือบขวา · '-' หลับตา (กระพริบ) · 'h' ตาปรือ
// ข้อจำกัดจากตาราง interlock (หัวตำแหน่งปัจจุบัน): หันตรง ยกแขนได้ ~21° (เงย 8° ได้ ~27°)
//   หัน ±10° ยกได้ ~5° · ±20° ~11° · ±30° ~41° · ก้ม ≤ −6° ได้เฉพาะหันตรง (แขน ≤ ~10°) หรือหัน ≥ 30° (แขน ≤ ~7°)
// ทุกเป้าผ่าน axTrySet (ลิมิตกลาง + interlock เดียวกับคำสั่งอื่น) · กำลังหนีบของอยู่ = ไม่ขยับแขน (หัว+หน้าเท่านั้น)
// ตัวจำลอง (static/twin3d/emotes.js) สร้างจากไฟล์นี้ด้วย tools/gen_emotes_js.py — แก้ท่าที่นี่ที่เดียว
// =====================================================================
#pragma once
#define EK (-128)
#define ER (-127)
#define REST_LIFT (-30)     // ท่าพัก R: แขนลง (เจ้าของ #516 — เดิมผมตั้งแขนกลาง 0 ผิด)
struct EmoKey { int8_t yaw, tilt, liftL, liftR, handL, handR; uint16_t ms; char face; };

// ---------- อารมณ์ (ละ 3 แบบ สุ่มไม่ซ้ำแบบเดิมติดกัน) ----------
// H1 ดีใจ: ยกแขนโบกสลับ หัวส่าย แล้วเขินนิดตอนจบ
const EmoKey EMO_H1[] = {
  {  0,  8, 20, 20, ER, ER, 380 }, { 10,  8, 26, 14, ER, ER, 330 }, {-10,  8, 14, 26, ER, ER, 330 },
  { 10,  8, 26, 14, ER, ER, 330 }, { 12,  4, 10, 10, 60, 60, 500, 'B' }, {  0,  0, ER, ER, ER, ER, 0, 'H' },
};
// H2 ดีใจ: ชูแขนกาง กระโดดดีใจ แล้วหุบแขนมาใกล้หน้าแบบอาย ๆ
const EmoKey EMO_H2[] = {
  {  0,  8, 24, 24,  0,  0, 400 }, {  0,  4, 10, 10,  0,  0, 260 }, {  0,  8, 24, 24,  0,  0, 260 },
  {  0,  4, 15, 15, 65, 65, 450, 'B' }, {  0,  2, 15, 15, 65, 65, 350, '-' }, {  0,  0, ER, ER, ER, ER, 0, 'H' },
};
// H3 ดีใจ: ปรบมือเบา ๆ 2 ที หันหลบยิ้มเขิน
const EmoKey EMO_H3[] = {
  {  0,  6, 15, 15, 70, 70, 300 }, {  0,  6, 15, 15, 25, 25, 250 }, {  0,  6, 15, 15, 70, 70, 250 },
  {  0,  6, 15, 15, 25, 25, 250 }, { 30,  4, 15, 15, 70, 70, 600, 'B' }, {  0,  0, ER, ER, ER, ER, 0, 'H' },
};
// S1 เศร้า: หันหลบ แขนห้อย ก้มต่ำ
const EmoKey EMO_S1[] = {
  { 30,  0,-30,-30, ER, ER, 700 }, { 32,-10,-35,-35, ER, ER,1400 }, { 30,-10,-35,-35, ER, ER, 0 },
};
// S2 เศร้า: ถอนหายใจ (หลับตา) แขนตก ก้มหน้าตรง
const EmoKey EMO_S2[] = {
  {  0,  0,-30,-30, ER, ER, 500, '-' }, {  0, -6,-35,-35, ER, ER, 900, 'S' }, {  0, -3,-35,-35, ER, ER, 500 },
  {  0, -6,-40,-40, ER, ER, 0 },
};
// S3 เศร้า: หันหนี หุบแขนกอดตัว ก้ม แอบเหลือบมอง
const EmoKey EMO_S3[] = {
  {-30,  0,-20,-20, 60, 60, 700 }, {-32, -8,-25,-25, 70, 70,1000 }, {-30, -8,-25,-25, 70, 70, 600, 'R' },
  {-30, -8,-25,-25, 70, 70, 0, 'S' },
};
// A1 งอน: หันหนี แขนหุบ กระทืบแขนสองที (แอบเหลือบกลับมาดู)
const EmoKey EMO_A1[] = {
  {-30,  3, 12, 12, 40, 40, 260 }, {-30,  3,-10,-10, 40, 40, 230 }, {-32,  3, 14, 14, 40, 40, 230 },
  {-30,  3,-10,-10, 40, 40, 500 }, {-30,  0,-20,-20, 40, 40, 500, 'L' }, {-30,  0,-20,-20, 40, 40, 0, 'A' },
};
// A2 งอน: สะบัดหน้าซ้ายไปขวา แล้วหันหนีค้าง
const EmoKey EMO_A2[] = {
  { 30,  4,  5,  5, 40, 40, 420 }, {-30,  4,  5,  5, 40, 40, 600 }, {-32,  2,-10,-10, 40, 40, 700 },
  {-30,  0,-20,-20, 40, 40, 0 },
};
// A3 โกรธ: หันหนี หุบแขนเหมือนกอดอก กระแทกแขนหนึ่งที
const EmoKey EMO_A3[] = {
  {-25,  0,-10,-10, 90, 90, 500 }, {-25,  0,  8,  8, 90, 90, 300 }, {-25,  0,-10,-10, 90, 90, 400 },
  {-28,  0,-10,-10, 90, 90, 0 },
};
// O1 ตกใจ: เงยพรวด แขนดีดขึ้นกางออก แล้วหุบมาปิดหน้านิด
const EmoKey EMO_O1[] = {
  {  0, 10, 30, 30,  0,  0, 550 }, {  0,  8, 22, 22, 60, 60, 500 }, {  0,  6, 15, 15, 60, 60, 0 },
};
// O2 ตกใจ: สะดุ้งสองจังหวะ
const EmoKey EMO_O2[] = {
  {  0, 10, 20, 20,  0,  0, 200 }, {  0,  6,  8,  8, 30, 30, 260 }, {  0, 10, 22, 22,  0,  0, 260 },
  {  0,  4,  0,  0, ER, ER, 0 },
};
// O3 ตกใจ: หันขวับไปซ้าย แขนดีดขึ้น แล้วหันกลับมาเหลือบมอง
const EmoKey EMO_O3[] = {
  { 30,  6,  0,  0,  0,  0, 300 }, { 30,  6, 30, 30,  0,  0, 600 }, { 25,  4, 10, 10, ER, ER, 400, 'R' },
  { 25,  4, 10, 10, ER, ER, 0, 'O' },
};
// Z1 ง่วง: แขนห้อยก่อน หัวค่อย ๆ ตก สัปหงกหนึ่งที
const EmoKey EMO_Z1[] = {
  {  0,  0,-30,-30, ER, ER, 600, 'h' }, {  0, -6,-35,-35, ER, ER, 900, 'Z' }, {  0, -2,-35,-35, ER, ER, 600, 'h' },
  {  0, -6,-35,-35, ER, ER, 0, 'Z' },
};
// Z2 ง่วง: หาว (เงย ยืดแขน) แล้วฟุบ
const EmoKey EMO_Z2[] = {
  {  0, 10, 20, 20,  0,  0, 900, '-' }, {  0,  8, 24, 24,  0,  0, 700 }, {  0,  0,-20,-20, ER, ER, 700, 'h' },
  {  0, -6,-35,-35, ER, ER, 0, 'Z' },
};
// Z3 ง่วง: สัปหงกถี่ ๆ สามที
const EmoKey EMO_Z3[] = {
  {  0,  0,-30,-30, ER, ER, 500 }, {  0, -6,-35,-35, ER, ER, 500 }, {  0, -1,-35,-35, ER, ER, 350, 'h' },
  {  0, -6,-35,-35, ER, ER, 500, 'Z' }, {  0, -1,-35,-35, ER, ER, 350, 'h' }, {  0, -6,-35,-35, ER, ER, 0, 'Z' },
};
// C1 งง: หันเอียง แขนขวาเกาหัวสองที แล้วหันอีกทาง
const EmoKey EMO_C1[] = {
  { 30,  6,  0, 35, ER, 40, 650 }, { 30,  6,  0, 26, ER, 40, 260 }, { 30,  6,  0, 35, ER, 40, 260 },
  { 30,  6,  0, 26, ER, 40, 300 }, {-30,  4,-10,  8, ER, ER, 800, 'L' }, { 20,  4, ER, ER, ER, ER, 0, 'C' },
};
// C2 งง: เอียงคอสลับซ้าย–ขวาช้า ๆ ตาเหลือบตาม
const EmoKey EMO_C2[] = {
  { 30,  4, ER, ER, ER, ER, 650, 'L' }, {-30,  4, ER, ER, ER, ER, 750, 'R' }, { 30,  4, ER, ER, ER, ER, 650, 'C' },
  {  0,  2, ER, ER, ER, ER, 0 },
};
// C3 งง: ยักไหล่สองที แล้วเกาแก้มเขิน ๆ
const EmoKey EMO_C3[] = {
  {  0,  4, 18, 18, 20, 20, 300 }, {  0,  4,  0,  0, ER, ER, 300 }, {  0,  4, 18, 18, 20, 20, 300 },
  { 10,  2,  0, 10, ER, 60, 500, 'B' }, {  0,  0, ER, ER, ER, ER, 0, 'C' },
};
// V1 รัก: ยกแขนกางรับ แล้วหุบกอด โยกหัว
const EmoKey EMO_V1[] = {
  {  0,  6, 22, 22,  0,  0, 520 }, { 10,  6, 22, 22, 30, 30, 480 }, {-10,  6, 22, 22, 30, 30, 480 },
  { 10,  6, 22, 22, 30, 30, 480 }, {  0,  4, 16, 16, ER, ER, 0 },
};
// V2 รัก: ประกบแขนเข้าหากันตรงหน้า โยกหัว แล้วเขิน
const EmoKey EMO_V2[] = {
  {  0,  6, 20, 20, 80, 80, 600 }, {  8,  6, 20, 20, 80, 80, 420 }, { -8,  6, 20, 20, 80, 80, 420 },
  { 25,  4, 15, 15, 80, 80, 600, 'B' }, {  0,  4, 12, 12, ER, ER, 0, 'V' },
};
// V3 รัก: ส่ายตัวมีความสุข แขนกึ่งหุบ
const EmoKey EMO_V3[] = {
  { 10,  6, 15, 15, 40, 40, 450 }, {-10,  6, 15, 15, 40, 40, 450 }, { 10,  6, 15, 15, 40, 40, 450 },
  {-10,  6, 15, 15, 40, 40, 450 }, {  0,  2, ER, ER, ER, ER, 0 },
};
// B1 เขิน: หันหลบก่อน แล้วยกแขนหุบบังหน้า
const EmoKey EMO_B1[] = {
  { 30,  4,  0,  0, ER, ER, 450 }, { 30,  4, 25, 25, 55, 55, 650 }, { 32,  2, 28, 28, 55, 55, 800, '-' },
  { 30,  4, 25, 25, 55, 55, 0, 'B' },
};
// B2 เขิน: ก้มหน้าตรง หุบแขนเข้าหากัน
const EmoKey EMO_B2[] = {
  {  0,  0,-10,-10, 60, 60, 500 }, {  0, -6,-10,-10, 70, 70, 900 }, {  0, -4,-10,-10, 70, 70, 0 },
};
// B3 เขิน: หันหลบแล้วแอบหันกลับมามองนิด ๆ
const EmoKey EMO_B3[] = {
  { 30,  4,  0,  0, ER, ER, 600 }, { 30,  4, 20, 20, 60, 60, 500 }, { 10,  4,  5,  5, 60, 60, 450, 'R' },
  { 30,  4, 20, 20, 60, 60, 0, 'B' },
};
// N ปกติ = ท่าพัก R (แขนลง หัวตรง แขนกาง/หนีบกลาง)
const EmoKey EMO_N[] = {
  {  0,  0, ER, ER, ER, ER, 0 },
};

// ---------- แตะทองแดงบนหัว: แตะครั้งเดียวสุ่ม 1 ใน 5 ท่า · จบที่ท่าพัก ----------
// T1 เอียงซ้ายดุ๊กดิ๊ก แล้วก้มคลอเคลีย (เขิน)
const EmoKey TOUCH_1[] = {
  { 28,  2, ER, ER, ER, ER, 380 }, { 22,  2, ER, ER, ER, ER, 200 }, { 30,  2, ER, ER, ER, ER, 200 },
  { 22,  2, ER, ER, ER, ER, 200 }, { 30, -4, ER, ER, ER, ER, 520, 'B' }, {  0,  0, ER, ER, ER, ER, 0, 'H' },
};
// T2 เอียงขวาดุ๊กดิ๊ก แล้วก้มคลอเคลีย (เขิน)
const EmoKey TOUCH_2[] = {
  {-28,  2, ER, ER, ER, ER, 380 }, {-22,  2, ER, ER, ER, ER, 200 }, {-30,  2, ER, ER, ER, ER, 200 },
  {-22,  2, ER, ER, ER, ER, 200 }, {-30, -4, ER, ER, ER, ER, 520, 'B' }, {  0,  0, ER, ER, ER, ER, 0, 'H' },
};
// T3 พยักขึ้นลงดีใจ (หลับตายิ้มตอนก้ม)
const EmoKey TOUCH_3[] = {
  {  0,  8, ER, ER, ER, ER, 250 }, {  0, -4, ER, ER, ER, ER, 250, '-' }, {  0,  8, ER, ER, ER, ER, 250, 'H' },
  {  0, -4, ER, ER, ER, ER, 250, '-' }, {  0,  6, ER, ER, ER, ER, 250, 'H' }, {  0,  0, ER, ER, ER, ER, 0 },
};
// T4 เงยแล้วส่ายหัวดุ๊กดิ๊ก
const EmoKey TOUCH_4[] = {
  {  0,  6, ER, ER, ER, ER, 250 }, { 12,  6, ER, ER, ER, ER, 230 }, {-12,  6, ER, ER, ER, ER, 230 },
  { 12,  6, ER, ER, ER, ER, 230 }, {-12,  6, ER, ER, ER, ER, 230 }, {  0,  0, ER, ER, ER, ER, 0 },
};
// T5 แขนดุ๊กดิ๊กสลับ หัวเอียงตาม แล้วยกแขนมาปิดหน้าเขิน
const EmoKey TOUCH_5[] = {
  {  0,  6, 12, 12, ER, ER, 250 }, { 10,  6, 18,  6, ER, ER, 250 }, {-10,  6,  6, 18, ER, ER, 250 },
  { 10,  6, 18,  6, ER, ER, 250 }, {  0,  4, 15, 15, 65, 65, 500, 'B' }, {  0,  0, ER, ER, ER, ER, 0, 'H' },
};
// แตะสองที: ส่ายหัวแรง ๆ ดีใจมาก
const EmoKey TOUCH_DBL[] = {
  {  0,  8, ER, ER, ER, ER, 220 }, { 16,  8, ER, ER, ER, ER, 200 }, {-16,  8, ER, ER, ER, ER, 200 },
  { 16,  8, ER, ER, ER, ER, 200 }, {-16,  8, ER, ER, ER, ER, 200 }, { 16,  8, ER, ER, ER, ER, 200 },
  {-16,  8, ER, ER, ER, ER, 200 }, {  0,  0, ER, ER, ER, ER, 0 },
};

// ---------- ไอเดิล: ว่างนานจะเล่นสุ่ม 1 ท่า · เหมือนคนจริง (กระพริบ เหลือบ หาว ขยับมือเล่น) · ไม่หมุนล้อ · จบที่ท่าพัก R ----------
// กันโดนของข้างตัว (#519): หุ่นไม่มีเซนเซอร์ข้าง → ไอเดิลขยับแขนได้แค่ "หุบเข้าหาตัว" (แขนกาง/หนีบ ≥ 50% ไม่กางออก)
//   และยกแขนแค่ −30…−10 (อยู่หน้าตัว) · ถ้า VL เห็นของตรงหน้าใกล้กว่า 25 ซม. ใช้ชุด 'j' ขยับแค่หัว+หน้า
// I1 มองซ้าย–ขวา ตาเหลือบนำหัว กระพริบระหว่างทาง (หัว)
const EmoKey IDLE_1[] = {
  {  0,  0, ER, ER, ER, ER, 400, 'L' }, { 35,  2, ER, ER, ER, ER, 900 }, { 35,  2, ER, ER, ER, ER, 150, '-' },
  { 35,  2, ER, ER, ER, ER, 500, 'N' }, {  0,  0, ER, ER, ER, ER, 300, 'R' }, {-35,  2, ER, ER, ER, ER,1000 },
  {-35,  2, ER, ER, ER, ER, 150, '-' }, {  0,  0, ER, ER, ER, ER, 0, 'N' },
};
// I2 บิดขี้เกียจเบา ๆ หาว ตาปรือ (แขนยกแค่ −10 หุบเข้า)
const EmoKey IDLE_2[] = {
  {  0,  8,-10,-10, 60, 60, 900, '-' }, {  0,  8,-10,-10, 70, 70, 800, 'Z' }, {  0,  0, ER, ER, ER, ER, 600, 'h' },
  {  0,  0, ER, ER, ER, ER, 150, '-' }, {  0,  0, ER, ER, ER, ER, 0, 'N' },
};
// I3 ก้มดูพื้นตรงหน้า แล้วเหลือบขึ้นมาแบบอาย ๆ (หัว)
const EmoKey IDLE_3[] = {
  {  0,  0, ER, ER, ER, ER, 300 }, {  0, -6, ER, ER, ER, ER,1100 }, {  0, -6, ER, ER, ER, ER, 150, '-' },
  { 10,  2, ER, ER, ER, ER, 600, 'B' }, {  0,  0, ER, ER, ER, ER, 0, 'N' },
};
// I4 ขยับมือเล่นสลับ (หุบเข้าอย่างเดียว) ตามองมือ
const EmoKey IDLE_4[] = {
  { 15, -2, ER, ER, 55, 80, 500, 'R' }, {-15, -2, ER, ER, 80, 55, 500, 'L' }, { 15, -2, ER, ER, 55, 80, 500, 'R' },
  {  0,  0, ER, ER, ER, ER, 150, '-' }, {  0,  0, ER, ER, ER, ER, 0, 'N' },
};
// I5 เอียงคอสงสัย มองอะไรบางอย่าง แล้วกระพริบ (หัว)
const EmoKey IDLE_5[] = {
  { 30,  6, ER, ER, ER, ER, 900, 'L' }, { 30,  6, ER, ER, ER, ER, 600, 'C' }, { 30,  6, ER, ER, ER, ER, 150, '-' },
  {  0,  0, ER, ER, ER, ER, 0, 'N' },
};
// I6 ถอนหายใจเบา ๆ (หลับตา ก้มนิด ตาปรือ) (หัว)
const EmoKey IDLE_6[] = {
  {  0,  2, ER, ER, ER, ER, 500, '-' }, {  0, -4, ER, ER, ER, ER, 900, 'h' }, {  0,  0, ER, ER, ER, ER, 400, '-' },
  {  0,  0, ER, ER, ER, ER, 0, 'N' },
};
// I7 เงยมองฟ้า เหลือบซ้ายขวา (หัว)
const EmoKey IDLE_7[] = {
  {  0, 10, ER, ER, ER, ER, 700, 'L' }, {  8, 10, ER, ER, ER, ER, 700, 'R' }, { -8, 10, ER, ER, ER, ER, 700, 'L' },
  {  0, 10, ER, ER, ER, ER, 150, '-' }, {  0,  0, ER, ER, ER, ER, 0, 'N' },
};
// I8 โยกหัวเบา ๆ เหมือนฮัมเพลง (หัว)
const EmoKey IDLE_8[] = {
  {  8,  4, ER, ER, ER, ER, 600, 'H' }, { -8,  4, ER, ER, ER, ER, 600 }, {  8,  4, ER, ER, ER, ER, 600 },
  { -8,  4, ER, ER, ER, ER, 600, '-' }, {  0,  0, ER, ER, ER, ER, 0, 'N' },
};
// I9 กอดตัวเองเขิน ๆ (หุบแขนเข้า หันนิด)
const EmoKey IDLE_9[] = {
  { 15,  0, ER, ER, 75, 75, 900, 'B' }, { 15,  2, ER, ER, 75, 75, 600, '-' }, {  0,  0, ER, ER, ER, ER, 0, 'N' },
};
// I10 สัปหงก แล้วสะดุ้งตื่น (หัว)
const EmoKey IDLE_10[] = {
  {  0, -2, ER, ER, ER, ER, 700, 'h' }, {  0, -6, ER, ER, ER, ER, 900, 'Z' }, {  0,  4, ER, ER, ER, ER, 300, 'O' },
  {  0,  0, ER, ER, ER, ER, 300, '-' }, {  0,  0, ER, ER, ER, ER, 0, 'N' },
};

// ---------- ไอเดิลเพิ่ม (#526): นอนหลับ / เหม่อ — หัว+หน้าเท่านั้น ----------
// I11 ฟุบหลับ: ก้มตรง หลับตานาน ตาปรือ แล้วตื่นกระพริบ
const EmoKey IDLE_11[] = {
  {  0, -2, ER, ER, ER, ER, 600, 'h' }, {  0, -6, ER, ER, ER, ER,3000, 'Z' }, {  0, -3, ER, ER, ER, ER, 700, 'h' },
  {  0,  0, ER, ER, ER, ER, 150, '-' }, {  0,  0, ER, ER, ER, ER, 0, 'N' },
};
// I12 หลับคอพับข้าง แล้วสะดุ้งตื่น
const EmoKey IDLE_12[] = {
  { 30, -2, ER, ER, ER, ER, 700, 'h' }, { 32, -8, ER, ER, ER, ER,2800, 'Z' }, { 25,  4, ER, ER, ER, ER, 350, 'O' },
  {  0,  0, ER, ER, ER, ER, 300, '-' }, {  0,  0, ER, ER, ER, ER, 0, 'N' },
};
// I13 เหม่อไปทางซ้าย นิ่งนาน แล้วกระพริบกลับ
const EmoKey IDLE_13[] = {
  { 40,  4, ER, ER, ER, ER,2600, 'L' }, { 40,  4, ER, ER, ER, ER, 150, '-' }, { 40,  4, ER, ER, ER, ER, 600, 'L' },
  {  0,  0, ER, ER, ER, ER, 0, 'N' },
};
// I14 เหม่อมองขวาบน ตาปรือ
const EmoKey IDLE_14[] = {
  {-35,  8, ER, ER, ER, ER,2400, 'R' }, {-35,  8, ER, ER, ER, ER, 900, 'h' }, {-35,  8, ER, ER, ER, ER, 150, '-' },
  {  0,  0, ER, ER, ER, ER, 0, 'N' },
};
// I15 เหม่อมองไกลตรงหน้า แล้วถอนหายใจ
const EmoKey IDLE_15[] = {
  {  0,  6, ER, ER, ER, ER,2600, 'h' }, {  0,  2, ER, ER, ER, ER, 500, '-' }, {  0,  0, ER, ER, ER, ER, 0, 'N' },
};

// ---------- ท่าตามเหตุการณ์ (ละ 3 แบบ) ----------
// ยกของสำเร็จ — หน้า + หัวเท่านั้น (ไม่แตะแขน กำลังถือของ)
const EmoKey LIFTOK_1[] = {   // พยักดีใจ
  {  0,  6, EK, EK, EK, EK, 250, 'H' }, {  0,  0, EK, EK, EK, EK, 250 }, {  0,  6, EK, EK, EK, EK, 250 },
  {  0,  0, EK, EK, EK, EK, 0 },
};
const EmoKey LIFTOK_2[] = {   // ก้มมองของในมือ แล้วเขินที่ทำได้
  {  0, -4, EK, EK, EK, EK, 500, 'H' }, { 20,  2, EK, EK, EK, EK, 600, 'B' }, {  0,  0, EK, EK, EK, EK, 0, 'H' },
};
const EmoKey LIFTOK_3[] = {   // หัวใจแวบ แล้วส่ายหัวดีใจ
  {  0,  6, EK, EK, EK, EK, 600, 'V' }, { 10,  6, EK, EK, EK, EK, 220, 'H' }, {-10,  6, EK, EK, EK, EK, 220 },
  {  0,  0, EK, EK, EK, EK, 0 },
};
// เจอขอบตก (ล้อถอยหยุดเองแล้ว)
const EmoKey CLIFF_1[] = {    // ตกใจ เงยผงะ แขนดีดขึ้นนิด
  {  0, 10, 15, 15,  0,  0, 450, 'O' }, {  0,  6,  0,  0, ER, ER, 700 }, {  0,  0, ER, ER, ER, ER, 0 },
};
const EmoKey CLIFF_2[] = {    // ตกใจ แล้วกลัว เอาแขนมาปิดหน้า
  {  0,  8, 10, 10, 65, 65, 500, 'O' }, { 25,  4, 15, 15, 70, 70, 800, 'S' }, {  0,  0, ER, ER, ER, ER, 0 },
};
const EmoKey CLIFF_3[] = {    // ตกใจ ก้มมองขอบ แล้วงง
  {  0, 10, ER, ER, ER, ER, 400, 'O' }, {  0, -6, ER, ER, ER, ER, 800 }, {  0,  0, ER, ER, ER, ER, 0, 'C' },
};
// รันโค้ดจบครบ — หน้า + หัวเท่านั้น (ห้ามขยับแขน: ของอาจวางอยู่บนแขน)
const EmoKey DONE_1[] = {     // พยักดีใจสองที
  {  0,  6, EK, EK, EK, EK, 300, 'H' }, {  0,  0, EK, EK, EK, EK, 300 }, {  0,  6, EK, EK, EK, EK, 300 },
  {  0,  0, EK, EK, EK, EK, 0 },
};
const EmoKey DONE_2[] = {     // ส่ายหัวดีใจ แล้วเขิน
  { 12,  6, EK, EK, EK, EK, 250, 'H' }, {-12,  6, EK, EK, EK, EK, 250 }, { 12,  6, EK, EK, EK, EK, 250 },
  { 25,  2, EK, EK, EK, EK, 500, 'B' }, {  0,  0, EK, EK, EK, EK, 0, 'H' },
};
const EmoKey DONE_3[] = {     // หัวใจ แล้วพยักขอบคุณ
  {  0,  6, EK, EK, EK, EK, 700, 'V' }, {  0, -4, EK, EK, EK, EK, 350, 'H' }, {  0,  0, EK, EK, EK, EK, 0 },
};
// เจอคำสั่งที่ไม่รู้จัก (บัคทั่วไป) — งงแล้วทำต่อ (หัวเท่านั้น)
const EmoKey BUG_1[] = {      // ส่ายหัวงง
  { 20,  4, EK, EK, EK, EK, 420, 'C' }, {-20,  4, EK, EK, EK, EK, 420 }, {  0,  0, EK, EK, EK, EK, 0 },
};
const EmoKey BUG_2[] = {      // เอียงคอค้าง สงสัย
  { 30,  6, EK, EK, EK, EK, 700, 'C' }, {  0,  0, EK, EK, EK, EK, 0 },
};
const EmoKey BUG_3[] = {      // เหลือบซ้ายขวา แล้วงง
  {  0,  0, EK, EK, EK, EK, 300, 'L' }, {  0,  0, EK, EK, EK, EK, 300, 'R' }, {  0,  4, EK, EK, EK, EK, 0, 'C' },
};
// จะหนีบแต่ไม่เจอของ — หัวเท่านั้น (แขนอาจลดต่ำอยู่)
const EmoKey NOOBJ_1[] = {    // หันมองซ้ายขวาหา
  { 30,  0, EK, EK, EK, EK, 500, 'C' }, {-30,  0, EK, EK, EK, EK, 700 }, {  0,  0, EK, EK, EK, EK, 0 },
};
const EmoKey NOOBJ_2[] = {    // ก้มมองพื้นตรงหน้า งง
  {  0, -6, EK, EK, EK, EK, 800, 'C' }, {  0,  2, EK, EK, EK, EK, 0 },
};
const EmoKey NOOBJ_3[] = {    // เศร้านิด หันหลบ
  { 30, -2, EK, EK, EK, EK, 800, 'S' }, {  0,  0, EK, EK, EK, EK, 0, 'C' },
};

// ---------- เขินตอนสบตา (กล้องติดตาม #530 "หันมองตามแล้วซึน ๆ เขิน") ----------
// ⚠️ ชุด 's' ต่างจากชุดอื่น: yaw/tilt เป็นมุม "เทียบทิศหน้าคน" ตอนเริ่มเขิน ไม่ใช่มุมสัมบูรณ์ (0,0 = กลับมามองคน)
//   ตัวเล่นกลับทิศ yaw ให้หันหลบไปทางด้านหน้าตัวหุ่น (คนอยู่ซ้าย → หลบขวา) และสลับหน้า 'L'/'R' ตาม
//   ทิศในตารางเขียนแบบ "หลบไปทาง + (ซ้ายหุ่น)" → แอบเหลือบกลับหาคน = 'R'
//   จบ: ไม่ใส่หน้า — ตัวเล่นวาดหน้าอารมณ์ปัจจุบันคืนเอง · ถือของอยู่ = ไม่ขยับแขน (หัว+หน้าเท่านั้น)
// SHY_1 หันหลบ หน้าแดง แล้วแอบเหลือบกลับมามอง แล้วหลบอีกที
const EmoKey SHY_1[] = {
  { 25, -3, ER, ER, ER, ER, 500, 'B' }, { 28, -4, ER, ER, ER, ER, 900 }, { 12, -2, ER, ER, ER, ER, 600, 'R' },
  { 25, -3, ER, ER, ER, ER, 700, 'B' }, {  0,  0, ER, ER, ER, ER, 0 },
};
// SHY_2 หันหลบ หุบแขนขึ้นมาใกล้หน้า หลับตาเขิน แอบมอง (ตอนแอบลดแขนลงนิด ให้หัวหันกลับได้ตาม interlock)
const EmoKey SHY_2[] = {
  { 25, -2,  0,  0, 55, 55, 450, 'B' }, { 28, -4, 15, 15, 65, 65, 900, '-' }, { 28, -4, 15, 15, 65, 65, 300, 'B' },
  { 12, -2,  3,  3, 65, 65, 600, 'R' }, { 25, -3, 12, 12, 65, 65, 600, 'B' }, {  0,  0, ER, ER, ER, ER, 0 },
};
// SHY_3 ก้มหน้าหลบตา หันนิดเดียว แล้วเงยแอบมอง ก้มอีกที
const EmoKey SHY_3[] = {
  {  8, -6, ER, ER, ER, ER, 600, 'B' }, { 10, -8, ER, ER, ER, ER, 900, '-' }, { 10, -6, ER, ER, ER, ER, 400, 'B' },
  {  4, -2, ER, ER, ER, ER, 600, 'R' }, { 14, -6, ER, ER, ER, ER, 600, 'B' }, {  0,  0, ER, ER, ER, ER, 0 },
};

// ---------- ตารางสุ่ม ----------
struct EmoSet { char code; const EmoKey* v[15]; uint8_t n[15]; uint8_t count; };
#define EMN(a) (uint8_t)(sizeof(a) / sizeof(a[0]))
const EmoSet EMO_SETS[] = {
  { 'H', { EMO_H1, EMO_H2, EMO_H3 }, { EMN(EMO_H1), EMN(EMO_H2), EMN(EMO_H3) }, 3 },
  { 'S', { EMO_S1, EMO_S2, EMO_S3 }, { EMN(EMO_S1), EMN(EMO_S2), EMN(EMO_S3) }, 3 },
  { 'A', { EMO_A1, EMO_A2, EMO_A3 }, { EMN(EMO_A1), EMN(EMO_A2), EMN(EMO_A3) }, 3 },
  { 'O', { EMO_O1, EMO_O2, EMO_O3 }, { EMN(EMO_O1), EMN(EMO_O2), EMN(EMO_O3) }, 3 },
  { 'Z', { EMO_Z1, EMO_Z2, EMO_Z3 }, { EMN(EMO_Z1), EMN(EMO_Z2), EMN(EMO_Z3) }, 3 },
  { 'C', { EMO_C1, EMO_C2, EMO_C3 }, { EMN(EMO_C1), EMN(EMO_C2), EMN(EMO_C3) }, 3 },
  { 'V', { EMO_V1, EMO_V2, EMO_V3 }, { EMN(EMO_V1), EMN(EMO_V2), EMN(EMO_V3) }, 3 },
  { 'B', { EMO_B1, EMO_B2, EMO_B3 }, { EMN(EMO_B1), EMN(EMO_B2), EMN(EMO_B3) }, 3 },
  { 'N', { EMO_N }, { EMN(EMO_N) }, 1 },
  { 't', { TOUCH_1, TOUCH_2, TOUCH_3, TOUCH_4, TOUCH_5 }, { EMN(TOUCH_1), EMN(TOUCH_2), EMN(TOUCH_3), EMN(TOUCH_4), EMN(TOUCH_5) }, 5 },
  { 'i', { IDLE_1, IDLE_2, IDLE_3, IDLE_4, IDLE_5, IDLE_6, IDLE_7, IDLE_8, IDLE_9, IDLE_10, IDLE_11, IDLE_12, IDLE_13, IDLE_14, IDLE_15 },
         { EMN(IDLE_1), EMN(IDLE_2), EMN(IDLE_3), EMN(IDLE_4), EMN(IDLE_5), EMN(IDLE_6), EMN(IDLE_7), EMN(IDLE_8), EMN(IDLE_9), EMN(IDLE_10),
           EMN(IDLE_11), EMN(IDLE_12), EMN(IDLE_13), EMN(IDLE_14), EMN(IDLE_15) }, 15 },
  { 'j', { IDLE_1, IDLE_3, IDLE_5, IDLE_6, IDLE_7, IDLE_8, IDLE_10, IDLE_11, IDLE_12, IDLE_13, IDLE_14, IDLE_15 },     // มีของตรงหน้า: หัว+หน้าเท่านั้น
         { EMN(IDLE_1), EMN(IDLE_3), EMN(IDLE_5), EMN(IDLE_6), EMN(IDLE_7), EMN(IDLE_8), EMN(IDLE_10), EMN(IDLE_11), EMN(IDLE_12), EMN(IDLE_13), EMN(IDLE_14), EMN(IDLE_15) }, 12 },
  { 'l', { LIFTOK_1, LIFTOK_2, LIFTOK_3 }, { EMN(LIFTOK_1), EMN(LIFTOK_2), EMN(LIFTOK_3) }, 3 },
  { 'c', { CLIFF_1, CLIFF_2, CLIFF_3 }, { EMN(CLIFF_1), EMN(CLIFF_2), EMN(CLIFF_3) }, 3 },
  { 'd', { DONE_1, DONE_2, DONE_3 }, { EMN(DONE_1), EMN(DONE_2), EMN(DONE_3) }, 3 },
  { 'b', { BUG_1, BUG_2, BUG_3 }, { EMN(BUG_1), EMN(BUG_2), EMN(BUG_3) }, 3 },
  { 'n', { NOOBJ_1, NOOBJ_2, NOOBJ_3 }, { EMN(NOOBJ_1), EMN(NOOBJ_2), EMN(NOOBJ_3) }, 3 },
  { 's', { SHY_1, SHY_2, SHY_3 }, { EMN(SHY_1), EMN(SHY_2), EMN(SHY_3) }, 3 },   // มุมเทียบหน้าคน (ดูข้างบน)
};
